autonomous-ai/spaceship/README.md

# spaceship

Design files for Spaceship, the next version of FocusPod, the sound-insulated office pod from Autonomous ([autonomous.ai/focus-pod](https://www.autonomous.ai/focus-pod)). Inside the team it's called "Indoor Pod". Spaceship is a working name.

| Path | What's there |
|---|---|
| `docs/engineering-guideline.md` | The hardware team's engineering guideline for all versions (Vietnamese) |
| `sources/v1/` | v1 as received: STEP assembly, materials BOM, drawings |
| `v2/` | v2 work, starting from `v2/00-Control/v2-build-plan.pdf` |

Agents: start with [AGENTS.md](AGENTS.md).
