autonomous-ai/spaceship/tools/drawgen/README.md

# drawgen: part drawings from STEP, outside Fusion (D-112, D-113)

`drawgen` makes the manufacturing drawing of a simple part straight from that part's STEP on main: aluminium tube
cut parts and frames of them, and flat plates. It never opens Fusion or its queue.
Fusion keeps the general arrangement, the assemblies (the Air Engineer's `assembly.py` takes those on), the door,
the glass, the decor, and any part drawgen refuses. Bent sheet comes from drawgen when its team's entry marks it
`bent` (the Lead's ruling, 2026-11-01: Fusion the fallback).

## Run it

```
tools/drawgen/run.sh generate --sample          # the sample the PM reviewed first (#202), into v2/02-Drawings/<team>/
tools/drawgen/run.sh generate 211101 111101     # registered parts (each team's tools/drawgen/teams/<team>.py)
tools/drawgen/run.sh check v2/02-Drawings/wall/211101_P01_WALL-PANEL-FRAME-SIDE-LOWER-LH_DWG.pdf
tools/drawgen/run.sh stale                      # generated drawings whose STEP, parts list or register changed
```

`run.sh` makes drawgen's own Python environment on first use, in a per-user cache (`DRAWGEN_VENV` moves it):
OCC 7.8 through `cadquery-ocp` and PyMuPDF, pinned in `requirements.txt`. Nothing is installed system-wide.
Tests: `<venv>/bin/python tools/drawgen/tests/test_drawgen.py` (prints `N of N passed`).

## What it reads

- The part's STEP: its own file (`v2/03-Manufacturing/<team>/PN_REV_NAME_STEP.step`), or the team assembly STEP
  that holds it. Fusion writes cm and says so (D-13); OCC reads it in mm and every drawing checks one box against
  the repo's own reader (`tools/checks/stepfile.py`). A part file in its own system (BASE's tubes) is drawn where
  it sits in the pod: the placement comes from the team assembly STEP, checked hole for hole, and the sheet says
  so.
- The team parts list row: name, Vietnamese name, material, finish, process, tolerance, mass, cut list.
- The feature rationale registers (`v2/02-Drawings/<team>/FEATURE-RATIONALE*.md`, both layouts in use): each
  hole's register ID, function and mating parts, in the hole tables.
- Each team's entries in `teams/<team>.py` (D-139: every part drawing comes from drawgen; each team keeps its
  own entries): the choices a STEP can't give (datums, extra notes, the tolerance note). See `teams/README.md`.

## What a drawing has (guideline 3.2, 3.3, 6; D-113)

- Exact projections with hidden-line removal (OCC `HLRBRep_Algo`, never the polygonal one): lines stay lines and
  circles stay circles, written as Bezier quarter arcs on their true centre and radius. Hidden lines that would
  print on top of a visible line are left out (ISO 128 practice); the rest are dashed.
- First-angle layout: the view from above below the principal view, from below above it, from the left on its
  right, from the right on its left; a view too long to sit beside goes under the others as a lettered view with
  a reference arrow.
- A view of every drilled face. A face nothing shows (inside a frame bay) gets a section in front of it, unless
  its holes are the far-wall twins of holes a view shows: then the removed section through the pair shows them.
- Holes square to a face that no principal view looks at straight: a lettered view square to that face (ISO
  128-30, "VIEW D"), with an arrow in a view that shows the face edge on, its own origin and its own hole table.
  It keeps the principal view's up where it can. A through hole that leaves its part at an angle is drawn from
  the face it is square to.
- Blind holes: their depth (of the full diameter) and, when the model has it, the drill point's angle.
- Countersinks (D-143): a cone on a hole's axis at its open end, widening out of the material, is called out with
  its hole, `Ø5.5, CSK Ø10.4 x 90°` (the outer diameter at the face and the included angle); the hole is drilled
  from that face. A hole countersunk from both sides is refused for now. In bent sheet mode a countersink is called
  out the same way (the DXF cuts the bore), and any other cone is refused, never taken for a corner relief's end.
  The read-back finds each countersink in the STEP itself (a cone with two circles on a hole's axis, the smaller the
  hole's: its outer diameter, and its angle from the circles' radii and spacing) and checks the printed callout,
  both ways.
- Holes through two walls of one member: a removed section through their axis, hatched per ISO 128-50 (filled
  solid under 1.6 mm on paper), each wall's hole sized across its gap.
- One hole table per face: tags H01... on the views, `X (mm)` and `Y (mm)` from that view's origin (O1, O2...,
  the one 3D origin seen in each view), +X right and +Y up, size, depth, the register's feature and fits. The view
  titles give each view's mapping to the pod axes.
- Datums: WALL frames sit on a spigot hole and slot (R-J13), so A is the seat face, B the round hole, C the slot,
  and every hole position is from B (R-J6). Other parts name their datum faces in their team's entry.
- Mitred ends: the angle from square and the true length along each face, in a view that shows the cut in profile
  (edge on, the member's axis across the view); when no planned view does, the plan adds the one that does
  (FRONT's #320: 8 tubes whose only view saw their mitres face on). A cut no plain view shows in profile (a
  compound cut) is refused. A member turned about its own axis is drawn square to its faces.
- An open-ended slot (BASE's D-129 end plates): sized from the edge it opens on, in the view of its face: the
  mouth at the edge, the taper's length, the width, the round end's radius and its centre from the edge. The end
  of a long part gets its own lettered view at its own scale, with its origin at the member's bottom left corner.
- A notch through one wall at a member's end (BASE's stud-head notches): its width, its place across from the
  nearer side face and its length from the end, in the view that looks at that wall (enlarged in a detail when
  small). Notches alike at the two ends are sized once, and the detail says the other end is the same.
- A chamfer with equal legs between a square end and a side face, or along a tube's outer corner the whole length
  (CEILING's seam member): "1 x 45°" on a leader, in the view that shows its true angle (looking along its edge, or
  a removed section across its member), else where it shows as a band it faces (CEILING's back member's end bevel,
  seen from below). A view is planned for a bevel no other view shows. A welded end plate (a square face just inside an end) needs no size: the material line gives it.
- Frames: member balloons, the cut list from the parts list, stile positions, the D-115 joint note.
- Bent and folded sheet (an entry marked `bent`; the Lead's ruling, 2026-11-01): the folded part's views from its
  STEP; a section across each run of bends with each flange's outside length (windowed to one end of a long run, the
  other end the same); the flat pattern drawn from the team's DXF (CUT outline thick, BEND centre lines thin chain
  tagged B1..., MARK bend-zone edges thin) with its overall size; and a bend table: each bend line's place in the
  flat, its direction (UP: toward the viewer of the flat as drawn), angle, inside radius and bend allowance. The folds
  come from the model's own section; the DXF's bend lines must sit where the model's flanges put them at one K-factor
  (solved from the DXF's flat size, and stated); every model hole must sit on a DXF circle of its size where it
  unfolds to, and every DXF circle on a model hole, on one run of bends or two (a tray: across each run from its own
  flange, along it from the base both share). Where no hole pins which way up the DXF is drawn, every reading the
  bend lines allow must fold the same part, so the DXF must be symmetric that way, or the part is refused (Reviewer 6
  on #335). Cut-outs that aren't round holes (rectangles, sharp or with round corners, and slots, through one
  flange) are in the hole tables (centre X and Y, length x width along X or Y, corner radius) with their centre lines,
  and each one's edge, unfolded, must be the same shape as one of the DXF's, point for point both ways and counted
  (WALL's 511202: its power unit's 304 x 268 and the 80 x 11 corner slot); any other shape is refused. The folds are
  read from a section through the middle, or the nearest one clear of holes and cut-outs, and the profile section is
  cut there. A model that folds sharp takes its inside radius from the entry. Anything else is refused with the reason
  (INTERIOR's 811201: a hole the DXF cuts in a bend zone). A V-grooved and
  folded panel (ACP; its entry says `vgroove` with the groove) has no K-factor: its outer skin runs round each fold
  unstretched, so the flat develops along the outer face, each leg to its fold's outside arc plus the arc, the fold
  line at the arc's middle (the model's outside radius, WALL's 2 mm by the maker's guide). A V-groove fold the model
  leaves sharp is refused (the outer skin always bends round a radius, D-161), and an entry that states the outside
  radius has every fold checked against it; its folds table gives each fold's outside radius and the groove.
- Scale: the largest ISO scale at which the views fit beside the hole tables; for a long part the table column
  gets narrower (its text wraps more) before the scale drops, as long as the tables still end above the title block.
  Where the removed sections or the flat pattern would then run off the sheet, the next smaller scale.
- Labels: every line is drawn first (views, cutting planes, dimensions), then hole callouts, view titles, tags,
  origin names and datum symbols each go where they touch no line and no other text.
- Title block: UNITS: mm, the first-angle symbol, part number, name (English and Vietnamese), revision of the
  part's STEP (or of its parts list when it lives in an assembly STEP), DRAFT, material, finish, mass, scale,
  sheet; the tolerance note is the project's (joints register, parts lists), never a blanket ISO 2768. CREATED BY
  and the PDF's author are "Autonomous", never a person (the owner's rule; the read-back checks both). The PDF's
  Creator is `drawgen`, the program; its catalog key `/DrawgenData` lists every source with its
  hash, the views and the tagged features.

## What it refuses (the part stays with Fusion)

A cylinder that is neither a hole, a slot, a keyhole nor an open-ended slot (a bend, a fillet, a round), a cone
that isn't a blind hole's drill point (a countersink), any other curved face, holes on an angled face that the part
itself hides, a part that fits no ISO scale on its sheet. On a straight member, any flat face that is not its
profile, an end, a mitre or compound end cut, a slot's own sides, a notch, an even chamfer or a welded end plate's
inner face (a step, a pocket, a window in a wall, an uneven chamfer): drawgen would draw it without a size, so it
names the faces and refuses the part. A straight member whose section isn't a solid convex outline or a
rectangular tube (an angle, a channel, a custom extrusion, a tube with a corner cut that isn't an even 45° bevel of
5 or less): drawgen would size only its outside, so it refuses it as a profile (D-139 keeps a profile's dimensioned section with Fusion until the
profile reading lands). An extrusion's open section is judged as a profile, not as a fold. Parts that need no drawing (D-125 plain strips, D-128 felt and fill pieces on their DXFs) are listed in
their team's file with the reason, and `generate` says so instead of drawing them. It also never overwrites a PDF it didn't
make: a Fusion drawing stays.

## Checks

`readback.py` reads a drawing back against its STEP (and a bent part's DXF), independently of how it was drawn: every hole the repo's own
STEP reader finds is in a table, each row's X and Y equal the hole's projected centre within 0.05 mm, each tagged
hole is drawn as a true circle at its place within 0.05 mm; every end cut of every member (a flat face at an
angle to the member's axis, 6 mm or more across the way it slopes) is found in the STEP by that reader, and its
angle from square must be printed by the cut in some drawn view; each open slot's round end, notch and chamfer is found
in the STEP by that reader and the sizes printed for it match what it measures there within 0.05 mm (a notch said
to be the same as the drawn one measures the same); the text has what the mechanical check reads, the
Creator is drawgen, and no text touches another text or a part outline and no line runs through a text (read from
the PDF's own text and paths); for a bent part, every bend row is on one of the DXF's BEND lines (read again, without
OCC), each run's bend lines sit where its outside flange lengths, angles, inside radius and the printed K-factor put
them within 0.05 mm, its flat is as long as the DXF's, every STEP hole unfolds (by the sheet's record of how each
flange unfolds, each flange checked against a face of the STEP) onto a DXF circle of its size within 0.05 mm and
every DXF circle onto a STEP hole; every cut-out of the STEP (found from its own faces through the sheet that close
into a void) unfolds onto one of the DXF's cut shapes point for point both ways, with its table row's centre and
size as the STEP has them; and the flat's size, the K-factor and every bend tag are printed. `generate` runs it on every drawing it writes. The mechanical check's drawing rule (C05) and
the release checklist count the drawings by their file names, like any other drawing.
