autonomous-ai/spaceship/tools/checks/README.md

# Mechanical checks

Checks that catch mechanical issues in the v2 design before manufacturing. They run on main after every merge; each finding goes into the register (`v2/04-Checks/findings.md`) with an owner group and a status, and is posted to that group with the file and the fix. **Severe findings block the owner's merge until they're fixed** (PM rule).

```sh
python3 tools/checks/run_checks.py                         # check this checkout, print findings
python3 tools/checks/run_checks.py --root <tree> --rev <sha> --update   # check a tree, update the register
python3 -m pytest tools/checks/tests -q                    # offline tests
python3 tools/checks/register.py set F-004 ACCEPTED --note "D-60: ..."  # change a status by hand
```

Standard library only, plus PyMuPDF (or `pdftotext`) to read drawing PDFs. Nothing here edits another group's files. Exit code 1 when a severe finding is open in the run.

## After every merge to main

```sh
python3 tools/checks/run_checks.py --ref origin/main --update                        # offline checks, register
python3 tools/checks/run_fusion_checks.py --ref origin/main --model skeleton --update  # exact, through the lock
python3 tools/checks/run_fusion_checks.py --ref origin/main --update                   # the assembled design, once it exists
```

Each run checks exactly that revision in a clean export (deleted afterwards), updates `v2/04-Checks/findings.md`, and closes what it no longer finds, with the revision as evidence. New findings go to their owner groups with the file and the fix. Open PRs get the same runs on their head before they merge (`--ref origin/<branch>`, without `--update`).

## The checks

| Code | Check | How | Runs |
|---|---|---|---|
| C01 | Clash and minimum gaps | Offline: the pod's outer shell must be closed, checked exactly 1 mm inside the back, sides and roof: each body's box grows by just over half the decided 2.26 mm seam, so seams close and any wider opening is a finding. Each face is checked once all its parts are on main (a side face needs its two panels, its decor block and its side band; names match with spaces or the file names' hyphens); a strip no wider than the seam along a face's own edge is the seam to the next face's part, which that face reports if it's missing. Exact interference with an allow-list of intended contacts goes through Fusion (below). | offline and Fusion |
| C02 | Tolerance stack-ups | Gap rules between named bodies (`v2/04-Checks/config/gap-rules.csv`, the same file the Fusion check reads), and worst-case stacks per joint (`v2/04-Checks/stacks/`). RSS is shown for information only (guideline §6.3). A stack with a missing tolerance stays OPEN and is listed, not failed. | offline |
| C03 | Fastener and tool access | Every bolt reachable with the one hand tool from the side the assembly order uses: a tool envelope along each bolt axis must miss every part already in place at that step. | Fusion |
| C04 | Weight, doorway, pallet | Every shipping piece 20 kg or less except glass (D-03); the pod against the cap in `config/policy.csv` (460 kg, D-131, provisional until the wall sample's recount); passes a 914 × 2032 doorway (PLAN Target 2; the 810 mm door of REQ-ASM-06, PROPOSED, is a note); fits its pallet, 48 × 40 in or the standard long 48 × 96 in, at most 1679 mm tall above a 150 mm deck (REQ-SHP-01, REQ-SHP-03). Masses and the pod total from the layout study's newest decided list (`parts-decided-P04.csv`), plus only the owners' weight changes that list doesn't hold yet (`config/mass-adjustments.csv`, column `applies_to`); sizes for the doorway and pallets from the B1 list until a sized P04 list exists. | offline |
| C05 | Drawing completeness | Every part we make has a drawing, every assembly an assembly drawing, same revision as its CAD and STEP; units, material, finish and tolerances stated; holes tagged, in a hole table or called out, counted against the STEP's hole axes. D-89: a number listed in a tabulated drawing counts as drawn (the drawing says TABULATED and lists the numbers of its own family and kind; a note or an assembly drawing's parts list doesn't count); a plain knife-cut felt or fill rectangle needs no drawing when its row in a cut list or a parts list (any .csv under `v2/03-Manufacturing` or `v2/02-Drawings`; PM ruling 2026-11-01, read the same way as the release checklist) gives its part number, size, material and tolerance; other soft goods (foam, gaskets, seals, tape) need a DXF of their outline, or for a plain strip or rectangle the same row with the thickness too (D-89 part 3); a piece with pockets, notches or holes (in its STEP: hole axes, or more than a block's 6 faces; or named in its row) keeps its drawing. A reserved space (`config/reserved-spaces.csv`: a body that only holds space for a part another team designs later, like the air spaces 351402 to 351405 in FRONT's DR block, which AIR designs under its own numbers) gets no drawing finding, no seam rules and no parts-list row checks (no mass, not counted); it's listed open under its designer until it's designed. D-97: a missing drawing is severe whatever the screen state (a model that passes everything else still merges, D-91). D-125 (extends D-89): a plain straight-cut strip or sheet with no features needs no drawing when a parts-list row gives its material and grade (a grade on HOLD counts as stated; the part stays HOLD until it is named), thickness, width and length as in its STEP, finish, and a tolerance covering both cut sizes (one general tolerance such as ISO 2768-m or '±0.5 on cut sizes', or one for the length and one for the width; 'width as supplied' for a bought strip; the thickness takes the sheet's own tolerance), and names no hole, slot, notch, pocket or cut-out; its STEP must show one shape, a rectangular block (six flat faces in three square pairs, no holes, no bends) at most 25 mm and half its width thick. D-128 (extends D-89 part 3): a felt or fill piece cut from sheet or roll, with through-openings or edge notches only, needs no drawing when its DXF gives the full outline with every opening (the same number of closed shapes as the STEP's sheet face, the outline the STEP's size, only CUT and MARK layers, placed blocks only) and a parts-list row gives material, density or grade, thickness (the STEP's), tolerance and part number; a pocket or other depth feature keeps the drawing. D-113: a part tools/drawgen draws (its specs.py registry) keeps a missing drawing severe even under D-84's locked-screen mode. A part's holes come from its own STEP when it has one, so an older copy in an assembly can't add holes. The PM's drawing traps, read back from each drawing PDF (ELECTRICAL's `pdf_traps.py`): text under 2.5 mm capital height (title-block labels under 1.8) and a first-angle symbol without 4 corners are major; hidden lines (counted by view) and a dimension value printed twice are minor; a drawing that keeps hidden lines on purpose is listed in `config/hidden-lines-allow.csv` with its views and reason. D-93: ELECTRICAL's wiring diagram draws 710000. D-112: a part drawing made from STEP by `tools/drawgen` counts by the same name, revision and content rules; its PDF names drawgen in the Creator field, and a finding on it goes to the Drawing Generator, who fixes the generator and regenerates it. D-113, on generated drawings: where the part's STEP has holes through two walls of one body, the drawing labels a section (SECTION A-A, or A-A) or the opposite view (VIEW B, VIEW FROM); a part with bends stays in Fusion. A part's holes are counted over all its bodies (a frame's members), each shape once, so copies of one part under one number count once. D-89 part 4 (flat metal sheet and flat ACP only, D-99 and D-100: glass keeps its drawing): a flat part cut from sheet needs no drawing on its own DXF and a row whose process names laser, waterjet or router and no bend, fold, groove, lap, machining, drilling, tapping, welding or bonding, with material, thickness, finish and ISO 2768 (read exactly as the release checklist reads it, with its test cases); the DXF may hold lines only on the CUT and MARK layers (any other layer, such as BEND, a pocket, an engraving or a half-lap, keeps the drawing; block records on layer 0 are not lines); the check adds what only the files show: the STEP shows no bends, pockets, blind holes or countersinks, and the DXF holds every hole of the STEP. | offline |
| C06 | BOM completeness | Every parts-list row complete (number, English and Vietnamese name, material, quantity, mass, status, source); hardware names as the joints register gives them, in the CAD and the lists (D-99); what a decision cancelled is gone and what one added is there (`config/cancelled-items.csv`: D-131's cleats, D-132's floor parts and threshold; `config/required-items.csv`: D-132's base seal lip in BASE's folder), read from the teams' lists and the CAD's part names; the base keys 111211 to 111214 are the Joints Engineer's (D-95); numbers valid, unique and not reserved (D-28); bought items with maker and SKU or HOLD; every CAD product in a parts list and every made part in the CAD. D-120 (build plan rule 2, BP-04): every part is its own component with its own number, never a loose body; a component holding several bodies is a finding (major): copies of one part become one component placed several times, different pieces (a frame's members under D-115, a fill's bay pieces) each their own component, the part an assembly of them. Left out, as ruled: ELECTRICAL's route components (D-92), HOLD spaces, reserved spaces and ENVELOPE bodies (D-104). A part copied into another team's STEP must be the part its own STEP holds (the file named after its number): the same hole layout, whichever way the copy is turned (hole centres about their centroid, every quarter turn tried, hole sizes within 0.15 mm), and the same sizes (a round part's length at each outer radius both models have; a box part's three sides); a different layout is severe, different sizes major. | offline |
| C07 | Fastener schedule | Every screw, bolt, nut, washer and rivnut with size, length, grade, finish, torque, quantity, maker, SKU and CAD locations, written to `v2/04-Checks/fastener-schedule.csv`. Thread engagement and bottoming are measured along each bolt in Fusion. | offline + Fusion |
| C08 | Hole-to-hole alignment | Coaxial holes in different parts must share one nominal axis; the clearance budget for bolt plus tolerances is stack ST-03. Bolt patterns across STEP files: a joint hole (rivnut thread, M6 clearance or rivnut hole) whose partner file has joint holes on the same joint plane nearby, but none on its axis, is a pattern that doesn't match. A clearance hole and a rivnut in two parts of one file, on one axis (FRONT's DR access panel into DR's own back-ring rivnuts), are matched there and aren't paired with the next file's bolt line. | offline |
| C09 | Edge distance and sheet metal | Hole centre to free edge at least 2 hole diameters (under 1.5 is severe). D-135: every bay of a wall panel frame under the ACP skin (the frame's outline less its members, in its own plane) is 275 mm clear or less across its short span (WALL's span table: 274.8 mm gives 1.99 mm under a 100 N push; the limit is 2 mm). A free edge is where the part ends: read from the faces across each edge of the face the hole goes through, so it holds whichever way the part is turned in the pod. A tube's corner, a channel's wall, a bend or a chamfer on the way to the next wall is not a free edge; a sheet's edge, a tube's end and a flat bar's long edges are. Hole spacing at least 2 diameters; bend inner radius and hole-to-bend distance from `v2/04-Checks/config/sheet-rules.csv` (assumptions until the factory's coupons). An edge distance the PM accepted for one hole of one part is in `v2/04-Checks/config/edge-exceptions.csv` with its ruling, and holds only as ruled: at most the listed number of parallel edges under 2 diameters, each at least the listed distance (the BASE glide doubler: ends at 2 diameters, the two long sides 18 mm). | offline |
| C10 | Mixed metals | No bare steel against aluminium (contacts from the assembled CAD); fasteners must state a material and finish. | offline + Fusion contacts |
| C11 | Material grade and finish | Every part and bought item states a material grade and a finish. | offline |

## Inputs it looks for

- STEP files under `v2/03-Manufacturing/` (not `proof/`). `skeleton/` is checked as its own model. Other STEP files whose top product is an assembly (xx0000 to xx0999) and whose bodies all sit inside the pod box are combined into the assembled model in pod coordinates; every STEP also gets the per-part checks.
- Parts lists: CSV files under `v2/03-Manufacturing/`, `v2/04-BOM/`, `v2/02-Drawings/` or `v2/01-CAD-Native/` with a part-number column and a quantity column. Recognised headers: `part_number`, `name`, `name_vi`, `material`, `grade`, `finish`, `qty`, `mass_kg`, `status`, `source`, `rev`, `maker`, `sku`, `size`, `length_mm`, `torque_nm` (common variants work too). Fasteners need `size`, `length_mm`, `grade`, `finish`, `torque_nm`, `maker` and `sku`.
- Drawings: `PARTNO_REV_NAME_DWG.pdf` under `v2/02-Drawings/` (conventions §7).
- The part lists: `v2/05-Engineering/layout-study/out/parts-decided-P04.csv` (masses, the pod total) and `parts-option-B1-final-stack.csv` (sizes and pallets).

## The STEP reader

`stepfile.py` reads Fusion's AP214 STEP without a CAD kernel: the declared unit (Fusion writes cm, D-13), products and their use counts, every solid placed in the top assembly's coordinates, and per solid its planes, holes (cylinders with the material outside that add up to a full turn), bends (a concave and a convex coaxial cylinder one thickness apart) and box. Limits: boxes come from vertices; only planes and cylinders are classified; a faceted body's box hides gaps inside it. The Fusion check is exact where these limits matter.

## Fusion part (C01 exact, C02 true distances, C03, C07 engagement, C10 contacts)

```sh
python3 tools/checks/run_fusion_checks.py --model skeleton --rev <sha> --update   # skeleton STEP
python3 tools/checks/run_fusion_checks.py --rev <sha> --update                    # assembly STEPs in pod coordinates
python3 tools/checks/run_fusion_checks.py --from-json result.json --update         # convert a saved run, no Fusion
```

Fusion runs only through `tools/fusion/run_script.py`, which takes the machine-wide lock and waits its turn (PM rule: never call the Fusion MCP tools directly). `fusion/whole_pod_check.py` makes its own new document, imports the STEP files, and:

- intersects every pair of bodies whose boxes overlap; an overlap over 0.1 mm3 that isn't in `v2/04-Checks/config/clash-allow.csv` is a severe clash (D-104: a hardware stand-in, a bought number whose name carries ENVELOPE, may overlap the part it clamps in its own assembly file until the maker's model goes in) (guideline §10: a 1 mm3 threshold can hide small clashes, so the gap rules add minimum clearances);
- measures the gap rules as true minimum distances;
- walks each bolt or screw from its head to 30 mm past its tip: what surrounds the shank (clamped parts, the nut, rivnut or insert), what sits on the axis with no hole (a collision; past the tip, the tip clearance), engagement in the thread, at least one thread past a through nut, tip clearance at least 1 mm;
- sweeps the tool envelope (`v2/04-Checks/config/tools.csv`: the decided 5 mm hex key, ruling R-J2, the short arm on the bolt axis through the access hole, then the long arm and the hand turned 90 degrees toward the room through the fill pocket's open face) out from each bolt head; any body in place when the bolt is tightened (all but the lining cassettes, which go on last) that it hits blocks the tool;
- lists bodies that touch, for the mixed-metal check;

then writes JSON and closes its document without saving. Its findings carry the scope `<model>/fusion`, so an offline run never closes them and the reverse.

Live run, 2026-10-31, skeleton P03 on main c9ae2a4 (Fusion 2706.1.17, through the lock): 32 bodies; one clash, BAND-R x DR 14393.5 mm3, the same as the skeleton's own record (14394); seam and kick-strip gaps 0.0 mm and the linings 4.0 mm off the frames, as the offline check measures. No bolts are modelled yet, so C03 and C07 had nothing to walk.

## Findings

`register.py` keeps `v2/04-Checks/findings.json` and renders `findings.md`. A finding keeps its F-number for life. A run on main adds new findings, reopens ones that come back, and closes an automatic finding when the check that made it ran on that revision (and model) and no longer finds it, with the revision as evidence. Findings written by hand close by hand.
