autonomous-ai/spaceship/v2/00-Control/requirements.md

# Requirements: Spaceship (FocusPod v2)

| Doc code | Revision | Status | Date | Owner |
|---|---|---|---|---|
| V2-CTL-001 | P01 | DRAFT | 2026-10-31 | Control pack |

Everything the v2 prototype design must meet, each item with a number where one exists, a status and a source. Status values are defined in `conventions.md` §9. **DECIDED** means the PM has ruled; the ruling is in `decision-log.md` (D-nn). **PROPOSED** means our working answer until the PM rules on it. Open points link to `issue-register.csv` (ISS-nnn).

**Sources**

| Key | Document |
|---|---|
| PLAN | `v2/PLAN.md`, approved by the product owner on 2026-10-31 |
| BP | `v2/00-Control/v2-build-plan.pdf`, the v2 build plan from the indoor pod lead engineer (page or section given) |
| GL | `docs/engineering-guideline.md` (hardware engineering lead) |
| MS | `v2/research/market-study.md` |
| V1 | `sources/v1/` (STEP, BOM, drawings) |
| PO-1031 | Product owner's updates passed on by the Lead in the Swarm chat on 2026-10-31: the working name Spaceship; hooks for a later voice cockpit kit; reuse of Autonomous's in-house modules (the Desk Pro AI sensor hub, and Lamp electronics); a 12 V DC bus; cockpit hooks of 12 V 5 A; the default decor colour |
| DL | `v2/00-Control/decision-log.md`: the PM's decisions D-01…D-171 of 2026-10-31 and 2026-11-01. The current headline is D-27 with D-37, D-49 to D-53, D-59 to D-88 and D-131 to D-137: a 4+4 laminated front with no floor and no step at the door (D-132), walls and ceiling on one 84 mm stack on welded galvanized steel frames (D-131), US 120 V mains on UL-listed parts (D-133), 409.0 kg as shipped on the merged count (still aluminium frames and the floor; D-131 adds about 40 to 65 kg and D-132 takes off about 21, assumption), under a cap of 460 kg as shipped, provisional until the sample panel's recount (D-131) (live count with AIR's parts from CAD (PR #91) and D-130's intake boot and gaskets (PR #254), after FRONT's decor blocks (PR #105), WALL's B1 and B2 back panels and their cassettes (PR #205), D-121's and D-124's fan boxes (PR #199) and D-117's frame cleats (PR #195); D-116's thinner casings are withdrawn (D-121)), about 19.3 dB calculated (about 24 dB at best), and fresh air driven by CO2 and heat through an air column and soffit inside the pod: about 33 l/s for one person, 53 l/s for two and a 65 l/s boost, which also holds 4 K with the voice kit on its 40 W average (D-88), on one 24 V Class 2 feed (D-168). |
| HW | `v2/05-Engineering/acoustics-air/report.md`, merged in PR #11 (https://github.com/autonomous-ai/spaceship/pull/11, 39c5c3e): the wall and ceiling stack, the air design, the weight and the calculated sound |
| SEL | `v2/05-Engineering/hardware/selection.md`, merged in PR #11 (39c5c3e): the bought parts, their data, the HOLDs and the sample tests |
| SKL | `v2/01-CAD-Native/skeleton/BUILD-RECORD.md`: skeleton P04, merged in PR #24 (0cb764f; P03 in PRs #15 to #17), with the geometry measured from v1 and the PM's skeleton rulings |
| LAY | `v2/05-Engineering/layout-study/report.md`, merged in PR #10 (c6abf92): part weights, pallets and assembly |
| HW-26 | The air path recheck for D-60 in `acoustics-air/report.md` sections 7b to 7i and `calc.py`, merged in PRs #26 and #30 (fe5a787, d73ae2b), on skeleton P04: the sizes, noise and weight behind D-61 and D-62 |
| JNT | `v2/05-Engineering/joints/joints-register.md`, PR #23 (open): joints, fasteners, seam stacks and the hole rule (D-63 to D-65) |
| FRT | The FRONT door unit and fixed glass models, PRs #27 and #28 (open): masses, the edge gap and the channels (D-68) |
| GTM | The go-to-market research of 2026-10-31, kept out of this public repo; only its US-rules flags are used here (ISS-082 to ISS-084) |
| CALC | Calculations in section H of this file |

## A. Scope and the hard rule

| ID | Requirement | Target | Status | Source | How we prove it |
|---|---|---|---|---|---|
| REQ-SCP-01 | Indoor only: an air-conditioned room with a flat, level floor. No weather, UV, snow, wind or uneven ground. Size the structure for indoor loads: people leaning on it, shipping, and assembling it more than once. | indoor use only | confirmed | PLAN "Same look, lighter bones" | Load cases in the joint register |
| REQ-SCP-02 | v2 is designed for US use: US 120 V mains and US parts (D-133, D-134). Certification work (the UL 962 listing, fire test reports, the sprinkler and smoke strategy, emission certificates, glazing marks) comes later and is not prototype scope (D-134). Its old line, that the plan's Vietnamese 220 V parts were fine for the prototype, stays withdrawn (D-133, D-134). | US 120 V mains parts; no certification work on the prototype | DECIDED (D-14, D-133, D-134) | PLAN "Later, not in the v2 prototype"; DL D-14, D-133, D-134 | — |
| REQ-SCP-03 | The floor stays empty: no table and no loose furniture (D-06, ISS-006). The work wall carries a fixed 1000 mm ledge in 1.5 mm folded aluminium and a screen mount (D-70, D-85). | 0 loose furniture items | DECIDED (D-06, D-70, D-85) | PLAN "Removed"; DL D-06, D-70, D-85 | BOM |
| REQ-SCP-04 | The one-cable dock, room mic and agent status light are not built in. Hooks for a later voice cockpit kit are reserved (section F). | — | confirmed; DECIDED (hooks, D-11) | PLAN "Left out of v2"; PO-1031; DL D-11 | — |
| REQ-LOOK-01 | **The look stays exactly the same**: the faceted front, overall size, proportions, colours and glass layout. Every saving is invisible from outside. The decor blocks keep v1's depth, 205 mm as measured from v1's drawings and STEP (D-49). | same as v1 and the BP pictures | DECIDED (D-01, D-49); source (205 mm, SKL) | PLAN Goal; BP p1; AGENTS.md; DL D-01, D-49; SKL | v2 GA elevations laid over the v1 STEP outlines (X and Y match, `conventions.md` §4); renders compared with v1 and the result logged by the PM |
| REQ-LOOK-02 | Overall size W × D × H. H is measured from the room floor to the top of the roof skin (D-21). | 2500 × 1700 × 2400 mm | DECIDED (size D-01, datum D-21) | BP p1; PLAN Goal; DL D-01, D-21 | GA-001 |
| REQ-LOOK-03 | Colours: walls, roof **and decor blocks** in ACP Dark Yellow EV3038 (plan VT01, D-12); felt Dark Gray (plan VT03-PET, D-79); smoked gray glass as in v1, with the laminate's tint matched on the sample (D-27); the base band and the door's kick strip in the same dark finish (D-40): black anodised, matte, 20 µm (AA20, EN ISO 7599) (D-67), with the intake under the right block a flush black mesh in the band's outline (D-62). The soffit's underside, which shows through the top 68 to 114 mm of the glass for a standing viewer 1 to 2 m away, is in the top band's dark tone (D-61). The v1 CAD renders and the plan's pictures draw the decor black (ISS-031). | as stated | source (walls, felt); DECIDED (decor D-12, glass D-27, base band D-40, D-62, D-67; soffit D-61; felt D-79) | BP material list and section VI; V1 BOM DL/DR/DT, GL-01; DL D-12, D-27, D-40, D-61, D-62, D-67, D-79 | Colour codes on the drawings, physical samples |
| REQ-LOOK-04 | Front layout as in v1: one hinged door plus one fixed panel in the same plane. The door is a trapezoid, 1175.6 wide at the bottom and 892.9 at the top, 2011.1 tall, with a slanted leading edge. The fixed panel has 5 sides (box 1014.3 × 2017.1). Material: **4+4 laminate of toughened, heat-soaked panes (8.76 mm), frameless as in v1** (D-27, D-46). Acrylic is only an optional experiment on the factory sample (ISS-043). The fixed panel's free edge runs parallel to the door's edge at a 4 mm gap, in the skeleton too (D-74), with a 180° magnetic seal pair on the two edges and no closing load on the glass (D-83), and the fixed panel sits 11.5 mm deep in hidden, sealed U-channels in DR, DT and the base band (D-68), kept over U brackets, which leave gaps that need a sealant bead (D-138). | v1 outline | source (outline); DECIDED (material, D-27, D-46, D-82; edge gap, seal and channels, D-68, D-74, D-83, D-138) | V1 STEP "Door", "Wall Glass"; DL D-27, D-46, D-68, D-74, D-82, D-83, D-138; FRT | FRONT drawing checked against the v1 STEP; factory sample |
| REQ-LOOK-05 | Seams follow the build plan's intent: 2 sheets per side wall and 4 on the back, with crisp, aligned reveals. The faceted front and the overall form are what can't change (ISS-044). | 2 per side wall, 4 at the back | DECIDED (D-23) | DL D-23; BP II–IV | GA elevations |

## B. Priority 1: light

| ID | Requirement | Target | Status | Source | How we prove it |
|---|---|---|---|---|---|
| REQ-LGT-01 | Mass of the installed pod: everything that ships, without the packaging. The build is a 4+4 laminated front, both panes (D-27, D-82); walls and ceiling on the 84 mm stack (D-66) with welded galvanized steel frames of the same outside sections (D-131; the merged count still has 6063-T6 aluminium, D-79), 40 × 40 corner tubes (D-63) and the 24 kg/m³ fill by default (D-81); the 0.5 mm lining tray with 12 mm lips (D-37, D-69) on clips only, no rails (D-81); the air column and soffit inside the pod (D-60, D-61); and no floor (D-132; the merged count still has the 9 mm floor on its 3 mm foam, D-72, D-76). The layout study's live count is 422.8 kg as shipped: 2.8 kg over the cap and 12.8 kg over the target, with the adopted savings (clip-only fixing, the 24 kg/m³ fill and the 1.5 mm base band, the last two waiting on T02 and BASE's check) and allowances for the light shelf and the ledge (calculation, LAY, PR #42). The voice kit's 4.0 kg reserve sits outside the cap, because the kit ships later (426.8 kg with it; D-81, D-11). D-85 adopts five more savings: budgets for the light shelf and ledge, 1.0 mm inner studs in the wall panels, 2 studs in the back panels, a hollow kick strip, and poplar-core floor ply if BASE's tests pass. They bring it to 412.2 kg as shipped, 7.8 kg under the cap and 2.2 kg over the target, with the ceiling's cross members kept at 1.2 mm (calculation, LAY, PR #50). Re-run on the updated skeleton P04 with D-86's glide load blocks (+0.4 kg) and D-87's joined air pieces, it was 412.5 kg (calculation, LAY, PR #61); ELECTRICAL's P01 parts at 4.94 kg against their 3.05 kg allowance brought it to 415.4 kg (calculation, LAY, PR #66), and with the LED strip counted once it was 415.2 kg (calculation, LAY, PR #68); with BASE's sample and FRONT's fixed glass read from their merged parts lists (PRs #124, #126), it was 412.9 kg (PRs #124, #126); with the joints' made hardware and BASE's follow-ups read from their merged lists (PR #141), it was 413.4 kg; with WALL's four side panels and their cassettes read from their merged lists (PR #154), it was 412.7 kg; with CEILING's panels and cassettes (PR #158), 412.3 kg; with ELECTRICAL's and INTERIOR's parts read from their merged lists (PRs #161, #164), it was 412.6 kg; with a 2.4 kg allowance for D-115's frame cleats (PR #180), it was 415.0 kg; with D-116's fixings recount and 32 kg/m³ cartridge layers (PR #185), it was 411.4 kg; with the fan boxes' linings at 32 kg/m³ too (CEILING confirmed the grade, PR #188), it was 411.0 kg; with D-117's frame cleats at 1.2 kg with their glue in place of D-115's 2.4 kg allowance (PR #195), it was 409.8 kg; with D-121's and D-124's fan boxes, 3 mm casings with the linings only where they fit (PR #199), it was 408.9 kg; with WALL's B1 and B2 back panels and their cassettes from CAD (PR #205), it was 407.6 kg; with FRONT's decor blocks from CAD (DL 12.30, DT 7.84 and DR 18.32 kg, 3.4 kg over the study's estimates, less about 1.0 kg counted twice before, PR #105), it was 410.0 kg; with AIR's parts from CAD (PR #91) 408.5 kg; with D-130's intake boot and gaskets (+0.5 kg, PR #254), the live count is 409.0 kg as shipped: 11.0 kg under the cap and 1.0 kg under the target (calculation, LAY). D-116's 1.8 mm cartridge casings are withdrawn (D-121). The 3+3 fixed pane is ruled out (D-82). D-131's welded steel frames add about 40 to 65 kg and D-132's no floor takes off about 21 kg (assumption: the PM's estimates); the live count stays as merged until the sample panel's recount. The cap is 460 kg as shipped, provisional until that recount (D-131; it was 420, D-37); D-81's 410 kg target was set for the aluminium build. The wall sample settles it: a real cassette weighed with its clips and bond lines, and T02 confirming the lighter fill (D-54, ISS-080). PLAN.md's 300 kg is the light build without the sound package (ISS-063). | ≤ 460 kg as shipped (cap, provisional until the sample panel's recount, D-131; was 420); 409.0 kg as shipped (live count as merged, PR #254) | DECIDED (cap, D-131, provisional; reserve outside the cap and savings, D-81, D-85; 4+4 fixed pane, D-82); assumption (the PM's estimates: D-131's +40 to +65 kg, D-132's -21 kg); calculation (409.0 kg, LAY live count with the merged team lists, AIR's parts from CAD and D-130's boot and gaskets, PRs #91 and #254) | DL D-27, D-37, D-54, D-63, D-66, D-69, D-72, D-76, D-79, D-81, D-82, D-85, D-115, D-116, D-131, D-132; LAY (live count, PRs #42, #61, #66 and #68; savings, PR #50); DL D-86, D-87; PLAN Target 1 | The wall sample's weights and T02, the layout study's live count, the master BOM (`v2/04-BOM/`), then the prototype on a scale |
| REQ-LGT-02 | Every part weighs 20 kg or less, except the glass, that is, the two front panels (D-27). A "part" is each piece handled on its own during delivery and assembly (definition PROPOSED, ISS-047). | ≤ 20 kg each | DECIDED (number, D-03); PROPOSED (definition) | PLAN Target 1; DL D-03 | Weight per part in the master BOM |
| REQ-LGT-03 | Each front glass panel has a 2-person handling method in the assembly guide. In 4+4 laminated glass the door is about 43.3 kg and the fixed panel about 28.0 kg (C5, ISS-023); the FRONT models, with the door glass running 25 mm into the kick strip and the fixed panel 11.5 mm into its channels, give 43.9 and 28.6 kg (FRT). The door ships as one unit of about 50.2 kg, with its kick strip, drop seal, hinges and pull fitted in the factory (D-68), and two people carry it with 2 suction lifters (LAY). | method defined | assumption (method); calculation (mass, C5, LAY, FRT) | PLAN Target 1; V1 STEP; DL D-27, D-56, D-68; LAY; FRT | Assembly guide, timed trial |
| REQ-LGT-04 | Mass per m² of floor: 409.0 kg as shipped over 4.25 m² (live count, PR #254). v1 is about 113 kg/m² at 480 kg; rated pods this size run 99–136. | about 96 kg/m² | calculation (C6) | DL D-37, D-81, D-85; LAY; PLAN Target 1; MS | — |
| REQ-LGT-05 | v1 baseline, for comparison only: PLAN.md now gives about 480 kg from v1's BOM; the product page says 431 kg; the first market study said about 550 kg (ISS-030). | to confirm | source (conflict) | PLAN Target 1; MS | Reconciled v1 weight model, or a v1 on a scale |

## C. Priority 2: easy to assemble

| ID | Requirement | Target | Status | Source | How we prove it |
|---|---|---|---|---|---|
| REQ-ASM-01 | Two people assemble the pod in about 126 minutes, the honest target with film peeling inside the clock (D-87), and never more than 4 hours; about 1 hour stays the aim and 1 person-hour the stretch (PLAN scorecard). The guide's first count was about 168 minutes (PR #52); with D-87 it counts about 127 (PR #59). The clock starts with the pallets unwrapped on site and stops with the pod closed, powered and the fans running (start and stop PROPOSED). | about 126 min for 2 (≈ 4.2 person-hours), ≤ 4 h; aim 1 h; stretch 1 person-hour | confirmed (4 h limit, 1 h aim); DECIDED (126 min target, D-87); calculation (168 min, PR #52; 127 min with D-87, PR #59); PROPOSED (start and stop) | PLAN Target 2; DL D-87; the assembly guide (`v2/02-Drawings/30-Assembly-Instructions/`) | Step list with fastener count, then a timed trial on the prototype |
| REQ-ASM-02 | One bolt on site: M6 × 16 socket head to ISO 4762, captive, with an ISO 7093 washer under the head wherever it clamps on aluminium (D-63). | M6 × 16 only | confirmed (one M6 size); DECIDED (ISO 4762 M6 × 16, D-63) | PLAN Target 2; BP rule 6; DL D-63; JNT | Fastener list from the assembly sequence |
| REQ-ASM-03 | Captive M6 socket-head bolts join every seam and corner (they stay in their part and can't get lost), replacing D-08's tool-free seam clips (D-63), and one 5 mm hex key fits every one of them. Handling aids (suction lifters, spirit level, knife) don't count as tools (ISS-047, ISS-064). | 1 tool, a 5 mm hex key | DECIDED (captive bolts, D-08, D-63; one key, D-63); PROPOSED (definition) | PLAN Target 2; DL D-08, D-63; JNT | Tool list in the assembly guide |
| REQ-ASM-04 | Joints find their own place: every site joint has a locating feature (hook, pin, rebate or slot) that holds the part before the bolt goes in. No measuring on site. Panels locate on Ø8 × 8 spigots in a Ø8.5 hole or an 8.5 × 14 slot, and the Ø7.0 bolt holes sit within Ø0.4 of the spigot hole (D-64); the ceiling closes by assembly order (D-64, D-65). Every bolt pattern between teams comes from one skeleton rule; wall to band: end bolts 220 mm in, 4 evenly spaced, spigots 100 mm in from each end (D-75). | 100 % of site joints | confirmed; DECIDED (spigots, hole rule, closing order and bolt patterns, D-64, D-65, D-75) | PLAN Target 2; DL D-64, D-65, D-75; JNT | Joint register, timed trial |
| REQ-ASM-05 | No glue, no welding, no wet work and nothing to stick on site: the frames' welds are made in the factory (D-131), and the felt arrives pre-fitted (REQ-ASM-11). There is no floor foam any more (D-132; it arrived bonded under the floor panels, D-87). | none on site | confirmed (PLAN); DECIDED (pre-fitted felt, D-08; factory welds, D-131; no floor, D-132) | PLAN Target 2; DL D-08, D-87, D-131, D-132 | Assembly guide |
| REQ-ASM-06 | Every part fits through a doorway and into a normal lift. PLAN.md Target 2 says a 914 × 2032 mm (36 × 80 in) doorway; its scorecard says an 81 cm door. The check rule uses the narrower door (PROPOSED, ISS-048): sort the part's sizes a ≤ b ≤ c; it passes if a ≤ 810 and b ≤ 2032. | 810 × 2032 mm check | confirmed (PLAN); calculation (C1); PROPOSED (rule) | PLAN Target 2 and scorecard | Check against the part list |
| REQ-ASM-07 | No heavy lifting overhead: every roof part is light enough for two people to place from inside the pod. | ≤ 20 kg per roof part | source | MS "What we learned"; PLAN Target 1 | Assembly sequence |
| REQ-ASM-08 | Every part is labelled with its part number and position code. | 100 % of parts | source | MS "What we learned"; GL §4.2 | Labels in the packing plan |
| REQ-ASM-09 | Assembling it more than once doesn't wear out the joints: no lost fit after repeated take-down and rebuild. | ≥ 5 cycles | assumption (count) | PLAN "Same look, lighter bones" | Joint sample test |
| REQ-ASM-10 | Factory-made subassemblies: each wall and ceiling panel arrives as a complete outer panel (skin, frame, fill, gaskets, captive bolts or connectors, cable pass-throughs) plus its lining cassette (steel tray with the felt on it) as a separate part. Cassettes hang on captive mechanical clips with a rated load; ceiling cassettes also get a safety catch; hook-and-loop is only for lining up (D-47). Every cassette tray has 12 mm lips that hold the felt (D-69), and the cassettes hang on the clips alone, with no rails (D-81). The exhaust fan box arrives fitted in the soffit, the intake riser joined to the supply fan box, and the harness factory-tested (D-87). On site the parts are only joined. | 100 % of panels | DECIDED (D-08, D-47, D-69, D-81, D-87); source (cassette as a separate part, HW) | DL D-08, D-47, D-69, D-81, D-87; HW | Packing list, timed trial |
| REQ-ASM-11 | Pre-fitted felt: the PET felt (plan VT03-PET) is fitted on the lining cassette's face at the factory, not stuck on after assembly as the build plan says (BP-07). Felt and cassette edges at panel joints are detailed so the joint still seals (ISS-064). | 0 felt work on site | DECIDED (D-08) | DL D-08, D-17; BP rule 5 | Panel drawings |
| REQ-MOV-01 | Moving it inside the office: castors, or a quick unbolt of the light panels. | under study | source | PLAN scorecard "Moving it inside the office" | Layout study |

## D. Priority 3: easy to ship

| ID | Requirement | Target | Status | Source | How we prove it |
|---|---|---|---|---|---|
| REQ-SHP-01 | Ships on standard 48 × 40 in LTL pallets, loaded height (pallet included) about 6 ft or less. | 1219 × 1016 mm, ≤ 1829 mm | DECIDED (D-04); calculation (conversion, C1) | PLAN Target 3; DL D-04 | Pallet layout from the CAD |
| REQ-SHP-02 | Long parts (door, fixed panel, side decor blocks) go on **one** standard long pallet, such as 48 × 96 in. The decor blocks are not split. Never a custom size. | 1 long pallet, 1219 × 2438 mm | DECIDED (D-04); calculation (C1) | PLAN Target 3; DL D-04 | Pallet layout |
| REQ-SHP-03 | A panel standing upright on a 48 × 40 pallet can be about 1200 wide and 1700 tall: 1829 minus a pallet deck of about 150 mm leaves about 1680. | ≈ 1200 × 1680 mm | source (PLAN); assumption (deck 150 mm) | PLAN "Design for the pallet" | Measure the real pallet |
| REQ-SHP-04 | Every pallet has a layout with loaded height, weight and freight density in lb/ft³. The LTL class follows from density; state the density, don't guess the class. | per pallet | source | PLAN Milestone 1 | Layout study output |

## E. Guardrails and other requirements

### Fresh air (a full requirement)

| ID | Requirement | Target | Status | Source | How we prove it |
|---|---|---|---|---|---|
| REQ-AIR-01 | CO2 inside, 2 people, all day, door closed, at steady state, even in an office whose own air is at 600 ppm. | ≤ 800 ppm | DECIDED (D-43) | PLAN Target 4 (on main); DL D-43 | Calculation (C2), then a CO2 log on the prototype |
| REQ-AIR-02 | Fresh-air flow, set by CO2 and heat (D-44, D-50): never below 26 l/s while someone is inside. At the mixing effectiveness of 0.8, holding 800 ppm in a 600 ppm office takes about 33 l/s for one person and about 65 l/s for two (C2), so two people often run near the boost (D-52). 53 l/s is the normal flow for two (D-33). The boost reaches 65 l/s at 30 dB(A) or less (D-52): with D-130's sealed intake boot and gaskets, 25.2 dB(A) at 53 l/s and 29.6 dB(A) at 65 l/s, and held at 30 dB(A) or less the boost reaches 66.2 l/s (calculation, the air report, PR #254; the Air Engineer's first figures for D-130, 25.0 and 29.5 with 66.7 l/s; with DR as built and no boot, 33.3 and 37.8; the report's 25.1 and 29.6, PR #199, came before DR's cavity; D-61, D-62, D-121, D-124, D-130): 0.4 dB(A) under the limit, a risk until the fan sample measures it (ISS-090) and runs whenever 800 ppm or the 4 K limit can't be held (D-50). Two people put about 249 W into the air, so 53 l/s holds 3.9 K (calculation, PR #72); with the voice kit fitted on its 40 W average, 4 K takes 62 l/s at 28.5 dB(A), inside the boost (D-88, C4; PR #115). | ≥ 26 l/s while occupied; ≈ 33 l/s for one; 53 l/s for two; boost 65 l/s | DECIDED (D-33, D-44, D-50, D-52); calculation (C2, C3; HW; HW-26) | PLAN Target 4; DL D-33, D-43, D-44, D-50, D-52, D-61, D-62; HW; HW-26 | Fan curve against system pressure, then a flow check |
| REQ-AIR-03 | Fans start by themselves when someone is inside. CO2 and heat control the air (D-44, D-50): CO2 at 800 ppm or less, and the inside at most 4 K over the room, read by a temperature sensor at the supply fan inlet against the hub's sensor inside. The control boosts whenever it can't hold either limit, and people can also boost by hand (D-33). With the voice kit fitted, the boost holds 4 K at 30 dB(A) or less (D-88). The CO2 reading is shown inside. Control and readings come from Autonomous's in-house **Desk Pro AI sensor hub** (CO2, presence, air quality, sound level), see REQ-ELE-02. | self-starting, CO2- and heat-driven, boost by either or by hand, reading shown | DECIDED (D-09, D-33, D-44, D-50, D-88) | PLAN Target 4; DL D-09, D-33, D-44, D-50, D-88; PO-1031 | Control scheme, prototype check |
| REQ-AIR-04 | Fans are wired in, with no plug. The CO2 control overrides any user turn-down to hold 800 ppm and never goes below 26 l/s while someone is inside (D-44, ISS-038). The four fans run on the 12 V DC bus (D-51); none runs on mains. | wired in, on 12 V | DECIDED (D-10, D-44, D-51) | PLAN Target 4; DL D-10, D-44, D-51 | Wiring diagram |
| REQ-AIR-05 | Fan noise inside, through silenced vents, published: 26 dB(A) or less at 53 l/s and 30 dB(A) or less at the boost, which reaches 65 l/s (D-52). With D-130's sealed intake boot from the mesh to the riser's foot and gaskets on DR's inner and access panel edges and round each cartridge's inlet end, it calculates at 25.2 dB(A) at 53 l/s and 29.6 at 65 l/s, the boost held at 30 dB(A) or less reaching 66.2 l/s: 0.4 dB(A) under the limit, a risk until the fan sample measures it (calculation, the air report, PR #254; ISS-090); the Air Engineer's first figures for D-130 were 25.0 and 29.5 with 66.7 l/s. With DR as built and no boot it came to 33.3 and 37.8, and the cartridges' open slide-out gaps cost about 5 dB more; gaskets alone reach only 36.2 (D-130). On AIR's build before DR's cavity, the air report gave 25.1 and 29.6 with 66.3 l/s, and with 2 mm casings it would be 30.1 at 65 l/s and 64.8 l/s (PR #199). PR #115's 25.2 and 29.6, with 66.2 l/s, had lined every wall of the fan boxes, and gave about 15 dB(A) for one person at 33 l/s; the sized layout on skeleton P04 gave 25.3 and 29.7 (D-61, D-62). The calculation includes the fans' own casing sound; the fans' octave data is on HOLD for the fan-sample test (ISS-077). Measured at seated ear height in the middle of the pod with the door closed (point PROPOSED). | ≤ 26 dB(A) at 53 l/s; ≤ 30 dB(A) at 65 l/s | DECIDED (D-52, D-61, D-62); calculation (25.2 and 29.6 dB(A), boost 66.2 l/s, with D-130's boot and gaskets, the air report, PR #254, ISS-090); assumption (method) | DL D-52, D-61, D-62; the air report (PRs #115, #199); HW-26 §7d; PLAN Target 4 | Noise estimate, the fan-sample test, then a measurement on the prototype |
| REQ-AIR-06 | Low-heat lights, all on 24 V (D-168): a slim light shelf along the tops of the side and back walls, within 0.4 kg/m with its LED strip and brackets (D-85), lights the felt ceiling, and the scenes include a 'call' scene that lights the face evenly from the screen side; no front face light (D-70, replacing D-20). Total lighting power budget so the pod stays within 4 K of the room (D-50) at the 53 l/s normal flow (C4). | ≤ 30 W | DECIDED (lights, D-70, D-85, D-168; 4 K, D-50); PROPOSED (30 W budget, assumption) | DL D-50, D-70, D-85, D-168; PLAN Target 4; MS | Fitting data |
| REQ-AIR-07 | The air path runs inside the pod (D-60, as sized by D-61). Room air comes in through a flush black mesh in the base band piece under the right decor block DR, 80% free, 0.028 m², with a closing plate at Y −645 between that space and the pod (D-62); it rises through DR's sealed underside and a 1 mm steel intake riser to the supply fan pair high in DR, then runs down the 217 × 360 × 2105 mm felt-covered air column (on skeleton P04) in the front-right inside corner, through its cartridge, to a 100 mm kick grille at the column's foot. The exhaust enters a grille at the far end of the felt-covered soffit above the door head (360 mm deep, 220 mm tall, Z 2120 to 2340, 2120 mm headroom), runs along the soffit's cartridge to the exhaust fan box at its right end, and leaves through a roof slot just behind DR (Y −620 to −326). One cartridge part serves both paths: 173 × 314 × 1750 mm, two 80 mm passages between three 50 mm absorbent layers in a 2 mm aluminium casing, and it may split in two with a sealed slip joint (D-59). Four 12 V fans, two per path, on two balanced signals: one path in, one out (BP rule 7). The intake and the exhaust are about 2.3 m apart, at least 1 m (D-58). Everything is serviced from inside, the supply fans through DR's removable inner face (D-59). The CAD fit of the column, soffit, riser, fans and mesh band, and the recirculation check (the inlet within 0.5 K of the room at boost), are on HOLD (ISS-078). No roof box, and no air path in the top block DT. | 1 path in, 1 out, inside the pod; intake ≥ 1 m below the exhaust | DECIDED (D-58 to D-62); calculation (HW-26) | DL D-58 to D-62; HW-26 §7e; SEL; BP rule 7 | Air design; CAD fit and recirculation check (ISS-078) |

### Electrical and in-house modules

| ID | Requirement | Target | Status | Source | How we prove it |
|---|---|---|---|---|---|
| REQ-ELE-01 | A **12 V DC bus** feeds the fans and the sensors; the lights and the voice kit run on **24 V** Class 2 supplies (D-168). Mains, US 120 V, 60 Hz on the prototype too (D-133), goes **only to the user outlets** (the socket in plan VT07): tamper-resistant NEMA 5-15R sockets on UL-listed parts, a 120 V cord and inlet, and mains wiring sized for 15 A; Uten, the pick for Vietnam, is dropped. The DC supplies, 12 V and 24 V, have 100-240 V input and a UL Class 2 listing, so nothing on the DC side changes. In Vietnam the prototype is tested through a 220-to-110 V step-down transformer (D-133). The four fans run on 12 V (D-51), so D-29's mains-fan exception no longer applies. | 12 V DC (fans, hub) and 24 V DC (lights, kit); mains, US 120 V 60 Hz, to the outlets only | DECIDED (D-10, D-51, D-133, D-168) | DL D-10, D-51, D-133, D-168; PO-1031 | Wiring diagram, load table |
| REQ-ELE-02 | Reuse Autonomous's in-house modules. The **Desk Pro AI sensor hub** (CO2, presence, air quality, sound level) runs the air control and gives the readings. The **Lamp electronics** (mic array, speakers, computer) are the base of the later voice cockpit. Their supply, size, mounting and data details come from internal documents, still to collect (ISS-060). | 2 modules | DECIDED (reuse, D-09, D-11); unverified (module data) | DL D-09, D-11; PO-1031 | Module datasheets on file |
| REQ-ELE-03 | DC load budget, to size the DC supplies: voice cockpit 60 W at peak on its one 24 V feed (REQ-VCK-04, D-168; 40 W on average, D-88) + lights ≤ 30 W at 24 V (REQ-AIR-06, D-168) + four 12 V fans, about 30 W in all (D-51; the maker's power figure wasn't found, SEL) + sensor hub about 5 W, giving about 125 W. Three Class 2 supplies, 216 W in all (D-168): the kit's 96 W CLG-100-24, the lights' 60 W LPV-60-24, and a 60 W 12 V supply for the fans and the hub; D-136's 4th supply goes. | ≈ 125 W load; 3 supplies, 216 W (96 + 60 + 60) | calculation (C8); assumption (fan and hub watts) | DL D-10, D-11, D-51, D-88, D-136, D-168; SEL; PO-1031 | Load table with real fan and hub data (fan-sample test, ISS-077) |
| REQ-ELE-04 | The sensor hub reads the occupied zone: CO2 and temperature at breathing height, presence with a view of the seat, sound level inside. It sits in the air column's 180 × 180 zone, well above the supply grille and away from the exhaust grille (D-70). A second temperature sensor at the supply fan inlet reads the room for the 4 K limit (D-50); that it reads the room, not recirculated exhaust, is an assumption until the fan sample's check (D-58, ISS-078). | hub in the column zone; inlet sensor | DECIDED (hub in the column, D-70; inlet sensor, D-50); PROPOSED (sensor heights, assumption); assumption (the inlet reads the room, until ISS-078) | PO-1031; DL D-50, D-58, D-70 | Placement on the ELECTRICAL drawing, prototype readings, the recirculation check |
| REQ-ELE-05 | Design rule: cables in the cassette gap clip only to the cassette, never across the gap to the frame, so the floating lining stays floating. | 0 bridges | DECIDED (D-26) | DL D-26 | Wiring drawing, joint register |

### Build of the walls, ceiling, floor and door

| ID | Requirement | Target | Status | Source | How we prove it |
|---|---|---|---|---|---|
| REQ-BLD-01 | Wall build, from outside: the outer panel, 46 mm: ACP 3 mm on a 3 mm bond line of Sikaflex-252 (D-137; Sika's lab check on our tube is a HOLD, and the wall sample's T09 tests it) to a welded galvanized steel 20 × 40 box-tube frame with members about 300 mm apart (D-131, D-135), in the Joints Engineer's steel: certified yield 280 MPa or more (for example S280GD+Z to EN 10346 or SGC400 to JIS G3302), pre-galvanized with a Z100 coating (100 g/m² of zinc on both faces together, for indoor use), zinc-rich paint on the welds and no hot-dip after welding; 1.2 mm for the side panels' rails and front stiles (the PM's ruling), 1.0 mm for the other perimeters, the 40 × 40s and any member with a bolt, spigot, rivnut or stud, and 0.8 mm for the studs; each corner mitred with a 2 mm plate (J-FRAME-01) (it was aluminium with 1.2 mm perimeters and 1.0 mm inner studs, at 400 mm centres, and the back panels had 2 studs at 393, D-85); the ACP skin flexes 2 mm or less under a 100 N push at a bay's centre, edges taken as simply supported, which the 300 spacing gives for about +0.8 kg of steel per panel (D-135; calculation, WALL; the wall sample's T14); with 40 × 40 corner edge tubes (D-63) and 40 mm PET fill at 24 kg/m³ by default, which the wall sample's T02 confirms next to 32 kg/m³ (D-54, D-81). The frames' corners and T joints are welded in the factory, with no cleats (D-131, replacing D-79's 6063-T6 and D-117's cleats). Then a 4 mm gap and a floating lining cassette: a 0.5 mm galvanised steel tray with 34 mm returns and 12 mm lips that hold the felt, no ribs (D-69), hung on clips only, with no rails (D-81), a 25 mm air gap and 9 mm PET felt on its face (the tray stays 0.5 mm, D-37). 84 mm in all (D-66). The outer panel and the cassette ship as separate parts. The side walls are 1495 deep and start at the decor's back plate (D-49): in skeleton P04 the side panels are 1492.74 long and 1142.74 tall, and the back panels 1200.61 wide and 1118.61 tall, reaching the ceiling frame (D-66). Panels meet at 2.26 mm metal-stop seams, except the back wall's slotted centre seam, where a 5.5 mm closing gap leaves the frames 1198.99 wide under 1200.61 skins (D-64, D-65; skeleton PR #58). Rivnut torque is on HOLD until a spin-out test in the real tube (D-48, ISS-011). | 84 mm; skin flex ≤ 2 mm under 100 N at a bay's centre; about 12.6 kg/m² plus the lips with aluminium frames (steel's figure comes with the sample panel's recount, D-131) | DECIDED (D-16, D-17, D-37, D-48, D-49, D-54, D-63 to D-66, D-69, D-81, D-85, D-131, D-135, D-137); source (the Joints Engineer's check: the steel, its Z100 coating and its gauges); calculation (HW, aluminium frames; WALL, the 300 spacing) | DL D-16, D-17, D-37, D-48, D-49, D-54, D-55, D-63 to D-66, D-69, D-79, D-81, D-85, D-131, D-135, D-137; HW; SKL; JNT | Wall section on the WALL drawing; part weights; the wall sample's T14 |
| REQ-BLD-02 | Ceiling build: the wall stack, 84 mm (D-42, D-66): ACP 3 mm on a 3 mm bond line of Sikaflex-252 (D-137) to welded galvanized steel 20 × 40 box-tube frames with the same outside sections (D-131), in the Joints Engineer's steel: certified yield 280 MPa or more (for example S280GD+Z to EN 10346 or SGC400 to JIS G3302), pre-galvanized with a Z100 coating (100 g/m² of zinc on both faces together, for indoor use), zinc-rich paint on the welds and no hot-dip after welding; 1.0 mm for the perimeters, the 40 × 40s and any member with a bolt, spigot, rivnut or stud (cross member 1 too: it takes the soffit's hanger studs), and 0.8 mm for cross members 2 and 3; each corner mitred with a 2 mm plate (J-FRAME-01) (the cross members carry the cassette clips and safety catches, D-85; they were 20 × 40 × 1.2 aluminium 6063-T6, D-79), with 40 mm fill at 24 kg/m³ by default (D-54, D-81), plus the floating lining cassette (0.5 mm steel tray with 12 mm lips and 2 ribs, 25 mm air gap, 9 mm felt; D-69). The ceiling halves' frames span frame to frame between the side frames, 1200.61 wide each in skeleton P04 (D-55, D-66), and close by assembly order at a slotted centre seam (D-64, D-65). The soffit takes the front strip, so both ceiling cassettes stop at its back face and stay one part (D-69); the roof slot goes through the right outer ceiling panel only, so the two outer skins are two parts (D-61, D-69). The light and sensor cables run in the cassette's gap (D-41). Every part stays at 20 kg or less; the fill rides on its cassette if a panel would pass 20 kg (D-24). | 84 mm; 12.6 kg/m² with aluminium frames (steel's figure comes with the recount, D-131) | DECIDED (D-24, D-37, D-42, D-54, D-55, D-61, D-64 to D-66, D-69, D-81, D-85, D-131, D-137); source (the Joints Engineer's check: the steel, its Z100 coating and its gauges); calculation (HW, aluminium frames) | DL D-24, D-37, D-41, D-42, D-54, D-55, D-61, D-64 to D-66, D-69, D-79, D-81, D-85, D-131, D-137; HW; SKL | Ceiling section |
| REQ-BLD-03 | No plywood behind the ACP anywhere; plan VT02 is dropped. | no plywood | DECIDED (D-17) | DL D-17 | BOM |
| REQ-BLD-04 | No floor (D-132): people stand on the room floor, with no step at the door. The aluminium base band stays, 1.5 mm with a load block at each glide (D-86), and the base seal becomes a soft lip on the band's inner face that presses on the room floor across the glides' range, so v1's open shadow line under the band stays and the intake under DR stays clear (D-132). The two floor panels, their foam and the 13 mm threshold go (D-132, replacing the floor parts of D-72, D-76 and D-86). | no floor; no step | DECIDED (D-66, D-86, D-132) | DL D-18, D-66, D-72, D-76, D-85, D-86, D-132 | BASE drawing |
| REQ-BLD-05 | Door left-hinged, as in v1 (D-19), with the hinge pocket in the left decor block DL. The hinges must be rated for the 8.76 mm toughened, heat-soaked laminate, for the door unit of about 50.2 kg with a rating of at least 60 kg (D-68, replacing D-56's 47.5 kg) and for the 1176 mm width, and they hold the door at its closed position. There is no latch on the glass: the door keep is a 35 N magnetic catch in DT's underside at the top latch corner (D-83). The hardware is on HOLD until a rated set is named (ISS-002). D-30's dormakaba OFFICE 11.233 stays the candidate on HOLD, but its maker lists it for 8 and 10 mm toughened glass only (D-46, SEL). Häfele's 90° glass-to-wall hinges 926.88.090/091, which the owner's lead engineer suggested, are a second candidate for the factory's questions only: they are rated 35 to 45 kg a pair for doors up to about 915 mm wide, short of this door (D-138). | left-hinged; rated for the 8.76 mm laminate, ≥ 60 kg and 1176 mm; 35 N magnetic catch | DECIDED (D-19, D-46, D-56, D-68, D-83, D-138); source (OFFICE 11.233 listing, SEL; the Häfele hinges' rating, FRONT's check) | DL D-19, D-30, D-46, D-56, D-68, D-83, D-138; SEL; FRT | FRONT drawing; door sample |
| REQ-BLD-06 | Inside size: the 84 mm walls and ceiling (D-66) make it about 4 cm narrower and 2 cm shallower than v1 (2372 × 1480), and having no floor makes it about 9 cm taller than v1 (2223). Skeleton P04, updated in place in PR #58, gives 2332 between the side linings and 2304 from the 12 mm floor top to the ceiling cassette; with no floor (D-132) it is 12 mm taller, about 2316 from the room floor to the ceiling cassette (calculation: the cassette face at Z 2316). The air column and the soffit take the front-right corner and the strip above the door (D-60, D-61). | ≈ 2332 × 1457 × 2316 mm | calculation (SKL, PR #58, and D-132's 12 mm; depth: HW's 1460 less 3 mm) | SKL; HW; DL D-42, D-66, D-72, D-132; V1 BOM summary | GA-001 |
| REQ-BLD-07 | Felt: picked by its published absorption data down to 100 Hz, and the wall sample is measured down to 100 Hz (D-48). The factory's 9 mm PET felt is tried first if its data qualify; Autex Cube only if it falls short (D-31). Its emission certificate is on HOLD (ISS-075). | data and sample down to 100 Hz | DECIDED (D-31, D-48, D-56) | DL D-31, D-48, D-56; SEL | Wall sample result; certificate on file |
| REQ-BLD-08 | The door gets a hollow aluminium kick strip at the bottom, with the same outside as the solid one (D-85), black anodised like the base band (D-67), housing the drop seal. It fills the gap under the 2011 mm door and keeps v1's unbroken dark base band across the front (D-40). The door bottom sits at Z 105 (D-57), and the door glass runs 25 mm down into the strip (D-68). With no threshold, the door's drop seal closes on the room floor (D-132); the strip's running gap over the room floor follows FRONT's update (it kept 7 mm over the 13 mm threshold, Z 20 to 105, D-72, skeleton P04 since PR #58). | strip to Z 105; the drop seal on the room floor | DECIDED (D-40, D-57, D-66 to D-68, D-85, D-132); unverified (the gap over the room floor, pending FRONT's update) | DL D-40, D-57, D-66 to D-68, D-72, D-85, D-132; SKL; FRT | FRONT drawing, front elevation against v1 |

### Quiet (guardrail)

| ID | Requirement | Target | Status | Source | How we prove it |
|---|---|---|---|---|---|
| REQ-SND-01 | Speech level reduction D_S,A to ISO 23351-1. The decided build calculates at **about 19.3 dB (range 14.6–21.7)** with the only published data for a 9 mm felt, measured glued flat; about 24 dB is the best case if the felt on its 25 mm gap absorbs more (D-53). The wall sample, measured down to 100 Hz, decides, and no weight goes back in until it is measured (PLAN). For comparison, the calculation gives v1 about 15 dB as built, against its 30 dB claim (ISS-065). | ≈ 19.3 dB calculated (14.6–21.7); ≈ 24 dB best case | DECIDED (D-53); calculation (HW) | DL D-53; HW; PLAN Target 5; MS | Calculation, the wall sample down to 100 Hz, then the lab test with v1 in the same lab |
| REQ-SND-02 | Seals before mass: a gasket on every panel joint, a drop seal on the door, fill in the cavities, glass seated in sealed profiles, and a base seal: a soft lip on the band's inner face that presses on the room floor across the glides' range (D-132; it sat at the floor's edge, D-86). The joint gasket runs beside the washer line, never cut by a bolt or spigot (D-64), and the closing centre seams get a thicker gasket that seals over their range (D-65). | all 5 present | confirmed; DECIDED (gasket line, D-64, D-65; base seal, D-132) | PLAN "Quiet without the weight"; DL D-64, D-65, D-86, D-132 | Joint register, sound check |
| REQ-SND-03 | If the quiet target needs more mass, add only what it needs, show the kg per dB, and stay at or under the cap, 460 kg as shipped, provisional until the sample panel's recount (D-131; it was 420, D-37). No weight goes back in until the wall sample is measured (D-53). With D-85's savings the pod is 409.0 kg as shipped on the merged count (live count, PR #254; still aluminium frames and the floor), with the voice kit's reserve outside the cap, until the wall sample settles the fill and the felt (D-54, D-81, D-85). | ≤ 460 kg as shipped (provisional, D-131) | DECIDED (D-53, D-54, D-81, D-131) | DL D-35, D-37, D-53, D-54, D-81, D-131; PLAN Risk 3 | Sound check report; the wall sample's weights |

### Materials, later US rules, and doing it right

| ID | Requirement | Target | Status | Source | How we prove it |
|---|---|---|---|---|---|
| REQ-MAT-01 | Low-emission certified felt, boards and glue from the prototype on. The certificate type is chosen in the hardware selection; examples to check are CARB Phase 2 or TSCA Title VI for wood panels and GREENGUARD Gold for felt and adhesives. The factory felt's emission certificate is on HOLD (D-56, ISS-075). | certificate for each | confirmed (need); unverified (certificate names) | PLAN Target 6; MS; SEL | Supplier certificates |
| REQ-US-01 | Keep it possible: the roof can take a sprinkler head or open on an alarm (ISS-052). At about 45.7 sq ft (4.25 m², C1) the pod is over the usual 24 sq ft size below which pods go without sprinklers, so a US version needs a sprinkler strategy (HOLD, ISS-082). | zone reserved; strategy in the US rules phase | confirmed (zone); unverified (the exemption, ISS-082) | PLAN "Later"; GTM | Ceiling drawing; the code text in the US rules phase |
| REQ-US-02 | No step at the door (D-132): with no floor, people walk in on the room floor, so the US accessibility rule for thresholds (13 mm or less, with any part above 6 mm bevelled no steeper than 1:2) is met with no threshold at all; D-72's 13 mm threshold is gone. | no step | DECIDED (D-132) | DL D-18, D-72, D-132; PLAN "Later"; GTM | Door elevation |
| REQ-US-03 | Keep it possible: a wide door. The v1 door leaf is 1175.6 wide at the bottom; the clear width with the door open at 90° goes on the GA. | ≥ v1 | confirmed | PLAN "Later"; V1 STEP | GA-001 |
| REQ-US-04 | Keep it possible: a light door pull. The limit is set by the hardware selection; US rules (later) use about 22 N (5 lbf) for interior doors. | ≤ 22 N (to confirm) | confirmed (intent); unverified (number) | PLAN "Later" | Pull test on the prototype |
| REQ-US-05 | Keep it possible: UL 962 covers booths and pods with electrical parts, so the US product will likely need a UL 962 listing (HOLD, ISS-083), which comes later (D-134). The prototype already takes US 120 V, 60 Hz mains on UL-listed parts, with UL Class 2 supplies, 12 V and 24 V (D-133, D-168), so the listing path starts from US parts; the DC bus with mains only at the outlets (D-10) keeps the listed mains side small. | listing path known before the US version | unverified (scope and edition, ISS-083); decided (US mains parts, D-133) | GTM; DL D-10, D-14, D-133, D-134 | UL 962 check in the US rules phase |
| REQ-DOC-01 | Built to the guideline: native Fusion CAD with editable sketches and parameters; drawings in the order GA, then assemblies, then parts; one master BOM; joint and feature registers; a status on every number; a Reviewer runs the §13 checklist on every pull request. A model that passes every other check merges, whatever the screen state, and its missing drawings stay severe and open until drawn (D-91, D-97; this replaces D-84's major rating while the screen is locked). A part on a tabulated drawing (identical or mirrored shapes on one drawing that lists every number) counts as drawn, and a plain knife-cut felt or fill rectangle is drawn by its cut list when that gives its number, size, material and tolerance. Soft goods cut from sheet or roll (foam, gaskets, seals, tape) are drawn by a DXF of their outline or, as plain strips and rectangles, by a cut-list line with size, thickness, material, tolerance and number. A flat part cut from sheet (laser, waterjet or CNC router) with no bends and no machined features is drawn by its DXF, with the full outline and every hole, when its parts-list row gives material, thickness, finish, a general tolerance (ISO 2768-m) and any critical hole note, and its DXF draws only on the CUT and MARK layers (a line on any other layer, such as BEND, a pocket, an engraving or a half-lap, keeps the drawing); a flat ACP part counts too, and a routed-and-folded one keeps its drawing (D-100); folded, machined, welded or bonded parts and every assembly keep drawings (D-89). | all | confirmed; DECIDED (merge with drawings to follow, D-91, D-97; tabulated drawings and cut lists, D-89, D-99) | PLAN Target 7; GL §1, §9, §12; DL D-73, D-84, D-89, D-91, D-97, D-99 | Reviewer checklist |
| REQ-DOC-02 | Agents never order parts, contact suppliers or release anything for production. | — | confirmed | PLAN "How we build it"; AGENTS.md | — |
| REQ-DOC-03 | The repo is public: no supplier quotes, margins or personal data. | — | confirmed | AGENTS.md | Review |
| REQ-DOC-04 | Units in files: drawings and DXF in mm; STEP files may stay in cm when the file declares it. Check the unit and a known size after every import or export (ISS-066). | mm (drawings, DXF) | DECIDED (D-13) | DL D-13; GL §3.1 | Round-trip check in the CAD reports |

## F. Hooks for a later voice cockpit kit

The kit is **not** designed in v2. It will be built on the in-house Lamp electronics (mic array, speakers, computer), plus a screen and a status light. We only reserve what it needs, so it can be added later without cutting or rebuilding panels (ISS-051).

| ID | Requirement | Target | Status | Source | How we prove it |
|---|---|---|---|---|---|
| REQ-VCK-01 | Reserve hidden mounting points for the Lamp electronics (mic array, speakers, computer), a screen and a status light. They stay invisible from outside when no kit is fitted. | mounts for 5 items | DECIDED (D-11) | DL D-11; PO-1031 | WALL, CEILING and ELECTRICAL drawings |
| REQ-VCK-02 | Zones: the screen on the work wall, the right wall beside the air column, above its 1000 mm ledge, up to about 900 mm wide (D-70); the speakers and the computer behind a cover near it; the sensor hub in the air column's 180 × 180 zone (D-70); mic array and status light at the inside front edge of the ceiling or the soffit, facing the user. | as stated | DECIDED (screen wall and hub, D-70); PROPOSED (assumption: the other places and heights) | PO-1031; DL D-70 | Interfaces IF-15, IF-16 |
| REQ-VCK-03 | Cable path: a reserved route with a draw wire from the electrical zone in the back wall to each zone. It runs in the 25 mm gap inside the wall and ceiling lining cassettes, clipped to the cassettes only. Ceiling cables come in at the back-wall top corner and never cross the roof frame (D-41). Nothing is cut on site later. | 1 route per zone | DECIDED (path D-11, ceiling route D-41); PROPOSED (wall routes) | DL D-11, D-41; HW; PO-1031 | Route drawing |
| REQ-VCK-04 | Power: a reserved outlet for the kit with one fused 24 V Class 2 feed from its own Mean Well CLG-100-24 (96 W; 77 W at 80 %, D-168), in place of D-136's two 12 V feeds. The kit's peak stays 60 W and its average 40 W (D-88). It is counted in the load budget at its peak (REQ-ELE-03) and in the heat budget at its average: with the kit fitted, the fans boost to hold 4 K at 30 dB(A) or less: 62 l/s at 28.5 dB(A), inside the 65 l/s boost (C4, D-88; PR #115; the supply's loss goes into AIR's next run: one supply in place of D-136's two, about 4 W less, D-168). | 60 W peak on one 24 V Class 2 feed; ≤ 40 W average | DECIDED (D-11, D-88, D-168); calculation (C4) | DL D-11, D-88, D-136, D-168; PO-1031; AIR (PRs #66, #68, #72) | ELECTRICAL drawing, load and heat check |
| REQ-VCK-05 | Data: a reserved data link to the kit zone: Ethernet from the network socket (plan VT09), plus a spare data cable in the cable path. The cable type is set with the Lamp electronics. | 1 data link | DECIDED (link, D-11); PROPOSED (type) | DL D-11; PO-1031; BP VT09 | Route drawing |
| REQ-VCK-06 | The kit fixes with M6 into factory-fitted inserts on the lining cassette, never through the ACP skin: a hole through the outer leaf is a new sound leak (HW). | M6 | PROPOSED | PO-1031; PLAN Target 2; HW | Joint register |

## G. Every constraint in the v2 build plan

All lines come from `v2/00-Control/v2-build-plan.pdf`, translated. The last column says what v2 does with each. Changes are either DECIDED (`decision-log.md`) or PROPOSED, and every one is logged as an issue.

| ID | Build plan constraint | Value | Status | Source | v2 disposition |
|---|---|---|---|---|---|
| BP-01 | Overall size | 2500 W × 1700 D × 2400 H mm | source | BP p1 "Overral" | Kept (REQ-LOOK-02). The plan's own picture shows 2405 (ISS-013). |
| BP-02 | Goals: 1 light pod; 2 easy assembly by 2 people; 3 "cách ấm tốt", read as good sound insulation (ISS-008); 4 good ventilation; 5 easy to pack and ship | — | source | BP p1 "Goal" | Kept. Numbers come from PLAN (ISS-009). |
| BP-03 | Rule 1: build each part from 2D sketches | — | source | BP p1 Rule 1 | Kept (GL §4.4) |
| BP-04 | Rule 2: model parts as components, never as bare bodies | — | source | BP p1 Rule 2 | Kept |
| BP-05 | Rule 3: modelling order: floor frame, left wall, right wall, back wall, ceiling, decor frame (black), floor boards | — | source | BP p1 Rule 3 | Kept. With no floor (D-132) the first step is still BASE. |
| BP-06 | Rule 4: wall-to-wall joint, per the p2 section. Layers from outside: VT01 3, VT02 6, VT10 20, VT03 9 mm. The ceiling or back wall sits between the side walls with a 1 mm gap; the side walls' outer layers cover its edge; bolts join the frames. | 3 / 6 / 20 / 9 mm; 1 mm gap | source (picture dimensions) | BP p2 Rule 4 | Replaced by the final stack (REQ-BLD-01; D-16, D-17, D-66): ACP 3 on a 3 mm bond line, 20 × 40 aluminium with 40 mm PET, floating steel-and-felt cassette, 84 mm. Panels meet at a 2.26 mm metal-stop seam (D-64), not the plan's 1 mm gap; seals added (ISS-003); captive M6 × 16 socket-head bolts into rivnuts (D-63), with the torque on HOLD (ISS-011). |
| BP-07 | Rule 5: VT01 glued to VT02; VT02 screwed to the VT10 frame with steel screws; VT03 fixed with hook-and-loop last, after the pod is built | — | source | BP p2 Rule 5 | Changed: no plywood (D-17); the felt is pre-fitted on the lining cassette at the factory (D-08). ISS-015, ISS-016. |
| BP-08 | Rule 6: walls bolted to the floor frame with M6 | M6 | source | BP p2 Rule 6 | Changed: walls stand on the base band at the 2.26 mm stop and fix to it with captive M6 × 16 socket-head bolts into rivnuts in the band (D-63, D-64; thin floor DECIDED, D-05) |
| BP-09 | Rule 7: ventilation fans in the ceiling, one blowing in and one blowing out | 2 fans | source | BP p2 Rule 7 | Changed: four 12 V fans, two per path, inside the pod: the supply pair high in the right decor block and the exhaust pair at the soffit's right end (D-51, D-60, D-61); still one path in, one out (REQ-AIR-07) |
| BP-10 | Rule 8: VT07, VT08 and VT09 mounted on the back wall | — | source | BP p2 Rule 8 | Kept. VT08's role changes (ISS-038). |
| BP-11 | VT01: aluminium composite panel, Dark Yellow (EV3038) | 3 mm | source | BP p2 | Kept; spec gaps (ISS-035) |
| BP-12 | VT02: plywood | 6 mm | source | BP p2 | Dropped: no plywood behind the ACP (D-17) |
| BP-13 | VT03: polyester fibre acoustic panel, dark gray (seller link in the plan) | 9 mm | source | BP p2 | Kept: 9 mm felt on the lining cassette's face (D-17); spec gaps (ISS-035) |
| BP-14 | VT03 (second use of the code): steel box tube | 50 × 100 mm | source | BP p3 | Dropped: thin floor (D-05). Code clash ISS-007. |
| BP-15 | VT04: steel box tube | 30 × 60 mm | source | BP p3 | Dropped: thin floor (D-05) |
| BP-16 | VT05: steel plate | 3 mm | source | BP p3 | Use unknown (ISS-037) |
| BP-17 | VT06: ventilation fan Panasonic FV-15AUL1 (seller link in the plan) | — | source | BP p3 | Replaced by four 12 V fans (D-51), placed by D-60 and D-61: a mains fan clashes with the 12 V DC bus (REQ-ELE-01), and the FV-15AUL1's manual forbids ceiling mounting (SEL). The fans' octave test is on HOLD (ISS-077) |
| BP-18 | VT07: UTEN S300 one-way switch and 5-pin socket | — | source | BP p3 | The socket stays the only mains point inside (REQ-ELE-01), now a tamper-resistant NEMA 5-15R on UL-listed parts: Uten is dropped (D-133). What the switch switches is open (ISS-061). |
| BP-19 | VT08: UTEN S300 fan speed controller ("triết áp") | — | source | BP p3 | A mains knob can't drive 12 V DC fans; the sensor hub controls the fans and any manual trim is a 12 V input (ISS-038) |
| BP-20 | VT09: UTEN S300 single network socket | — | source | BP p3 | Kept as a network socket, which also feeds the voice cockpit data path (REQ-VCK-05); Uten is dropped (D-133), so it becomes a US part |
| BP-21 | VT10: steel box tube | 20 × 20 mm | source | BP p3 | Welded galvanized steel box tube again (D-131), with v2's outside sections: 20 × 40 for the walls and the ceiling (D-42, D-54), wall members about 300 apart (D-135), and 40 × 40 corner edge tubes (D-63); it was aluminium 6063-T6 (D-16, D-79, ISS-034). |
| BP-22 | VT11: bolt | M6 × 60 | source | BP p3 | Changed: M6 stays the one size, as an ISO 4762 M6 × 16 socket-head bolt, captive, with one 5 mm key (D-63, ISS-036) |
| BP-23 | VT12: leveling foot (seller link in the plan) | M10 | source | BP p3 | Dropped: thin floor (D-05) |
| BP-24 | Section I, floor frame: outer frame of 50×100 tube (VT03), 2 joists of 30×60 tube (VT04), outline per the top view, 6 M10 leveling feet (VT12) spaced evenly along the middle of the 50×100 tubes | 6 feet | source | BP p3 section I | Replaced by the thin floor (DECIDED, D-05) |
| BP-25 | Section II, left wall: build from outside VT01, VT02, VT10, VT03; split into 2 frames joined with M6×60; depth 1500, with the other 200 for the decor; its ACP covers the edges of the ceiling and back wall frames; only 2 ACP sheets show outside | 1500 + 200 | source | BP p4 section II | Kept: 2 sheets per side wall with aligned reveals (D-23). The 1500 and 200 are superseded: the side walls are 1495 deep and the decor blocks 205, as v1 measures (D-49). Depth chain on the GA (ISS-012); panel height (ISS-050). In skeleton P04 the side panels are 1492.74 long and 1142.74 tall (D-66). |
| BP-26 | Section III, right wall: same as the left wall; only 2 ACP sheets show outside | — | source | BP p4 section III | Kept, as BP-25 (D-23) |
| BP-27 | Section IV, back wall: same build; 4 frames joined with M6×60; 4 ACP sheets show outside | 4 frames | source | BP p4 section IV | Kept: 4 sheets on the back with aligned reveals (D-23); its frames span frame to frame between the side frames, 1200.61 per panel in skeleton P04, and its outer panels reach the ceiling frame (D-55, D-66); the centre seam is the closing seam (D-65) |
| BP-28 | Section V, ceiling: same build (the text says "back wall", ISS-032); 2 frames joined with M6×60; a fan on each half with a slot pattern below it | 2 frames | source | BP p4 section V | Changed: the wall stack on 20 × 40 welded galvanized steel frames, 84 mm (D-42, D-66, D-131), spanning frame to frame, 1200.61 per half (D-55, D-66); no fans in the ceiling halves: the exhaust runs through the soffit above the door to a roof slot in the right half, and the supply through the air column (D-60, D-61) |
| BP-29 | Section VI, decor frame: VT10 core frame inside, VT01 skin outside, the ACP grooved and folded to the faceted shape; 3 blocks (left, right, top), 200 deep, joined to the walls with V brackets and steel screws | 200 deep | source | BP p4–p5 section VI | Kept, except the depth: 205 mm as v1 measures, not 200 (D-49). The right block holds the intake riser and the supply fan pair, over the mesh band piece (D-61, D-62), and stands on the band at Z 110 (D-66). ISS-014, ISS-031, ISS-045, ISS-059. |
| BP-30 | Section VII, floor boards: 2 boards laid on the floor frame, screwed to its 2 joists | 2 boards | source | BP p5 section VII | Dropped: no floor (DECIDED, D-132), after the thin floor panels of D-05 and D-72 |

## H. Calculations

Each line names its inputs and their status. The layout study (`v2/05-Engineering/layout-study/`) and the sound and air check (`v2/05-Engineering/acoustics-air/`) replace these first estimates with their own scripts.

- **C1 Conversions (calculation).** 1 in = 25.4 mm exactly. 48 × 40 in = 1219.2 × 1016.0 mm. 48 × 96 in = 1219.2 × 2438.4 mm. 6 ft = 1828.8 mm. 36 × 80 in = 914.4 × 2032.0 mm. 4.25 m² = 45.7 sq ft (1 m² = 10.764 sq ft). Rounded to whole mm in the tables.
- **C2 CO2 at steady state (calculation).** Rise above the supply air: ΔC = n·G / (Q·ε). Inputs: n = 2 people; G = 0.0052 l/s of CO2 per seated adult (assumption, a typical value); supply air at 400 ppm, near outdoor level (assumption); mixing effectiveness ε = 1 (perfect mixing) or the PM's 0.8 (D-52). For CO2 ≤ 800 ppm, ΔC ≤ 400 ppm, so Q ≥ 2 × 0.0052 / 0.000400 = **26 l/s**. In a 600 ppm office (PLAN Target 4, D-43), ΔC ≤ 200 ppm, so Q ≥ 52 l/s with perfect mixing. That is why two people get 53 l/s. One person makes half the CO2, so 26 l/s holds 800 ppm for one person in a 600 ppm office with perfect mixing; that is the floor while someone is inside (D-44). At ε = 0.8 the same office needs 0.0052 / (0.000200 × 0.8) = **about 33 l/s** for one person and **65 l/s** for two, the boost (D-52); at the 26 l/s floor one person sits at about 850 ppm, so the CO2 control raises the flow (HW §7a). At the 53 l/s normal flow (D-33), ΔC = 0.0104 / 53 = 196 ppm, so CO2 ≈ **596 ppm** in a 400 ppm room, or **796 ppm** in a 600 ppm office (845 ppm at ε = 0.8). At the 65 l/s boost, ΔC = 160 ppm, so CO2 ≈ 760 ppm in a 600 ppm office (800 ppm at ε = 0.8). Office air is often above 400 ppm; the pod then sits higher by the same amount.
- **C3 Air change (calculation).** Inside about 2332 × 1457 × 2316 mm (REQ-BLD-06; no floor, D-132) = 7.87 m³, less about 0.35 m³ for the air column (217 × 360 × 2105) and the soffit (2332 × 360 × 220) (D-61), leaves 7.52 m³; v1 was 2372 × 1480 × 2223 mm = 7.80 m³ (V1 BOM summary). At the 53 l/s normal flow: 7.52 / 0.053 = 142 s, **about 2.4 minutes**. At the 65 l/s boost: 116 s, about 2 minutes.
- **C4 Heat (calculation).** Temperature rise ΔT = P / (ρ · c_p · Q), with ρ = 1.2 kg/m³ and c_p = 1005 J/(kg·K) (air at about 20 °C, source: standard values). Heat inputs, from the air report's model with ELECTRICAL's loads (PR #72, from ELECTRICAL's PR #64): 2 seated people at 75 W sensible each and 2 laptops at 30 W each (assumptions), the work scene's 22 W of lights (the shelf uplight dimmed and the down-light; the call light is off) and the supplies' losses 8.4 W (calculation, ELECTRICAL), the hub 3 W (assumption, ISS-060), and the two supply fans about 5.2 W at 53 l/s (cube law; the maker's figure is unverified), so P = 249 W (240 W before ELECTRICAL's loads; 257 W in PR #66 with the lights at full). At the 53 l/s normal flow: ΔT = 249 / (1.2 × 1005 × 0.053) = **3.9 K**, so 53 l/s holds D-50's 4 K limit; 4 K takes 51 l/s for two people and 29 l/s for one (the model, PR #72). One person at the 26 l/s floor reaches about 4.4 K and two people at 26 l/s about 7.8 K, one more reason they get 53 l/s (D-44). At the 65 l/s boost, two people sit at about 3.2 K. The voice kit at D-88's 40 W average with 8.2 W of supply loss gives 297 W at 53 l/s, 4.6 K; 4 K takes 62 l/s (28.5 dB(A) on AIR's build, PR #115), inside the 65 l/s boost, where the inside is 3.83 K over the room (PR #72). At its full 60 W the kit would have needed 69 l/s, over the boost (PR #66), hence D-88. So the flow above the CO2 minimum, and the boost, are what keep the pod cool, which matters because heat is the users' top complaint (MS).
- **C5 Glass mass (calculation).** Door area 2.080 m² and fixed glass area 1.344 m², from the v1 STEP outlines (polygon area). Glass density 2500 kg/m³ (assumption: typical soda-lime glass), so 25 kg/m² at 10 mm and 20 kg/m² at 8 mm. Door: 52.0 kg at 10 mm, **41.6 kg at 8 mm**. Fixed glass: 33.6 kg at 10 mm, **26.9 kg at 8 mm**. Both: 85.6 kg at 10 mm, 68.5 kg at 8 mm, so 8 mm saves 17.1 kg. The v1 BOM's rectangles (3.91 m²) overstate the area by 14 % (ISS-023). Decision D-27 makes the front 4+4 laminated glass (8.76 mm): 8 mm of glass at 20.0 kg/m² plus a 0.76 mm PVB interlayer at about 0.8 kg/m² (assumption: about 1070 kg/m³), so about 20.8 kg/m². That makes the door about **43.3 kg** and the fixed panel about **28.0 kg**. The FRONT models (FRT), with the door glass running 25 mm into the kick strip and the fixed glass 11.5 mm into its channels, give 43.9 kg and 28.6 kg, and the door unit about 50.2 kg (D-68).
- **C6 Mass per floor area (calculation).** Footprint 2.5 × 1.7 = 4.25 m². 409.0 / 4.25 = **96.2 kg/m²** as shipped, the live count with AIR's parts from CAD and D-130's boot and gaskets (PRs #91, #254); 408.5 kg gave 96.1 kg/m² (PR #91); 410.0 kg gave 96.5 kg/m² (PR #105); 407.6 kg gave 95.9 kg/m² (PR #205); 408.9 kg gave 96.2 kg/m² (PR #199); 409.8 kg gave 96.4 kg/m² (PR #195); 411.0 kg gave 96.7 kg/m² (PR #188); 411.4 kg gave 96.8 kg/m² (PR #185); 415.0 kg gave 97.6 kg/m² (PR #180); 412.6 kg gave 97.1 kg/m² (PRs #161, #164); 412.3 kg gave 97.0 kg/m² (PR #158); 412.7 kg gave 97.1 kg/m² (PR #154); 413.4 kg gave 97.3 kg/m² (PR #141); 412.9 kg gave 97.2 kg/m² (PRs #124, #126); 415.2 kg gave 97.7 kg/m² (PR #68); 412.5 kg before ELECTRICAL's parts gave 97.1 kg/m² (PR #61); D-85's first count, 412.2 kg, gave 97.0 kg/m²; the layout study's live count before them, 422.8 kg, gave 99.5 kg/m² (D-81); the P04 roll-up's 436.3 kg with the voice kit's reserve gave 102.7 kg/m². D-54's 427 kg gave 100.5 kg/m², and PR #11's 418 kg 98.4 kg/m². v1: 480 / 4.25 = 112.9 kg/m² (PLAN). The light build at 300 kg would be 70.6 kg/m².
- **C7 Step into the pod (calculation).** v1 floor top at Z(v1) = 115 mm (V1 STEP), plus 15 mm of feet, gives about 130 mm above the room floor. Thin floor (D-05): a 13 mm threshold, with the floor top at 12 mm (D-72). No floor (D-132): no step at all.
- **C8 DC load (calculation).** Voice cockpit 60 W at peak and 40 W on average (DECIDED, D-88), on one 24 V Class 2 feed from a 96 W CLG-100-24 (DECIDED, D-168): about 63 % at its peak, under the supply's 77 W at 80 %. Lights ≤ 30 W (REQ-AIR-06, assumption), at 24 V on a 60 W LPV-60-24 (D-168): 50 % or less. Four 12 V fans (D-51), about 30 W in all (assumption: the maker's power figure wasn't found, SEL; the fan-sample test sets it, ISS-077), and the sensor hub about 5 W (assumption until its datasheet arrives, ISS-060), on a 60 W 12 V supply: about 35 W (58 %). Total about 125 W on three Class 2 supplies, 216 W in all (D-168; D-136's 4th supply goes). Every load is also heat inside the pod (C4).
