autonomous-ai/spaceship/v2/00-Control/decision-log.md

# Decision log: Spaceship (FocusPod v2)

| Doc code | Revision | Status | Date | Owner |
|---|---|---|---|---|
| V2-CTL-008 | P01 | Live log | 2026-10-31 | The PM (the Swarm Lead) |

The PM makes product and design decisions and records each one here, with its reason (`AGENTS.md`). Nothing waits for outside approval. The guideline's engineering rules still apply, but this log replaces its approval steps. There are no human hardware leads on this project (D-32): issues close on the PM's logged decision plus evidence, and the factory's wall-and-door sample is the physical check.

A decision here is **DECIDED**. Everything else in the control pack marked PROPOSED is a working answer until the PM rules on it. To change a decision, add a new row that says which one it replaces; don't change an old row's decision. Its notes on other files' status, and factual slips in its reason, may be corrected.

**Current headline (D-27, D-37, D-49 to D-53, D-59 to D-88, D-131 to D-137):** a 4+4 laminated front of toughened, heat-soaked panes, frameless as in v1, with no floor and no step at the door, so the drop seal closes on the room floor (D-132); walls and ceiling on one 84 mm stack (D-66) on welded galvanized steel frames with the same outside sections (D-131), joined by captive ISO 4762 M6 × 16 bolts with one 5 mm key at 2.26 mm metal-stop seams (D-63 to D-65); the pod at 409.0 kg as shipped on the merged count, which still has the aluminium frames and the floor; D-131's steel frames add about 40 to 65 kg and D-132's no floor takes off about 21 (assumption: the PM's estimates), under a cap of 460 kg as shipped, provisional until the sample panel's recount (D-131; it was 420), with the voice kit's 4.0 kg reserve outside the cap (calculation, the layout study's live count with AIR's parts from CAD (PR #91) and D-130's intake boot and gaskets (PR #254), after FRONT's decor blocks (PR #105), WALL's B1 and B2 back panels and their cassettes (PR #205), D-121's and D-124's fan boxes (PR #199) and D-117's frame cleats (PR #195); D-116's thinner casings are withdrawn (D-121)); about 19.3 dB calculated (range 14.6–21.7, about 24 dB at best), with the wall sample deciding (D-53); fresh air driven by CO2 and heat, holding 800 ppm in a 600 ppm office and at most 4 K over the room, never below 26 l/s while someone is inside (D-50, D-52), through a felt-covered air column and soffit inside the pod: 25.2 dB(A) at 53 l/s and 29.6 at the 65 l/s boost, the boost reaching 66.2 l/s at 30 dB(A), with D-130's sealed intake boot and gaskets (calculation, the air report, PR #254; DR as built without them, 33.3 and 37.8): 0.4 dB(A) under the 30 dB(A) limit, a risk until the fan sample measures it (ISS-090); the voice kit on 40 W on average and 60 W at peak, on one 24 V Class 2 feed, with the fans boosting to hold 4 K at 30 dB(A) or less (D-88, D-168); designed for US use, with the mains side US 120 V, 60 Hz on UL-listed parts, 12 V for the fans and the hub and 24 V for the lights and the kit (D-168), and certification work later (D-10, D-133, D-134); decor blocks 205 mm deep and side walls 1495 deep, as v1 measures (D-49).

The control pack wrote the reasons from the PM's messages of 2026-10-31 and from the sources named. The PM can reword them.

| ID | Date | Decision | Reason | What it affects |
|---|---|---|---|---|
| D-01 | 2026-10-31 | **The look stays unchanged**: the faceted front, size, proportions, colours and glass layout. Every saving is invisible. | The faceted front is the team's iconic design and the product people know (PLAN.md Goal; `AGENTS.md`). | REQ-LOOK-01…05; every outside part; ISS-013, ISS-031, ISS-044 |
| D-02 | 2026-10-31 | **300 kg stays the goal. The build lands at about 380 kg with about 22–23 dB speech reduction (ISO 23351-1 Class C), the best value. 400 kg is the hard cap.** The 22–23 dB is calculated, and the factory sample decides the real figure. | The calculated lightest wall that still reaches about 22–23 dB comes out near 380 kg. Holding 300 kg would give up too much quiet, and the cap stops the trade from creeping. For scale, the calculation gives v1 about 15 dB as built. | REQ-LGT-01, REQ-SND-01, REQ-SND-03; WALL, CEILING, FRONT; ISS-009, ISS-042, ISS-063, ISS-065. Its numbers are replaced by D-27. PLAN.md was synced with it on main (ba0aefe). |
| D-03 | 2026-10-31 | **Every part weighs 20 kg or less, except the glass.** | One person can carry each piece through a normal door and up stairs, with no pallet jack (PLAN.md Target 1 and scorecard). | REQ-LGT-02; panel split; ISS-047 |
| D-04 | 2026-10-31 | **Ship on 48 × 40 in pallets plus one standard long pallet. The decor blocks are not split.** | Standard LTL pallets only. The long items (door, fixed panel, side decor blocks about 2300) ride one long pallet. Not splitting the decor keeps the faceted look free of extra seams and joints. | REQ-SHP-01, REQ-SHP-02; PACKAGING; ISS-057; layout study |
| D-05 | 2026-10-31 | **Thin floor**: panels about 2 cm thick on the room floor, walls fixed around them, base band kept as trim. Replaces the build plan's raised steel floor. | About 50 kg lighter. The step drops from about 13 cm to about 2 cm and there's about 10 cm more headroom. It still closes the bottom of the box for sound (PLAN.md; open-questions.md Q4). | BASE; BP-08, BP-24, BP-30; plan VT03-ST, VT04 and VT12 dropped; ISS-040, ISS-050, ISS-053, ISS-054 Its about 2 cm floor is replaced by D-72: 9 mm panels on a 3 mm mat, floor top at Z 12. |
| D-06 | 2026-10-31 | **No table.** The pod ships empty. | Customers furnish it however they like (PLAN.md). | INTERIOR; ISS-006 D-70 adds a ledge on the work wall; D-06 stands for the floor. |
| D-07 | 2026-10-31 | **Smoked acrylic front (door and fixed panel), with laminated glass as the fallback. The factory sample decides.** | The front is the heaviest single item and the weak spot for sound. Pick the most dB per kg. Acrylic is far lighter with the same smoked look; laminated glass is quieter if acrylic fails the sample. | FRONT 360000; REQ-LOOK-04; hinge rating; ISS-002, ISS-043 |
| D-08 | 2026-10-31 | **Tool-free connectors, captive bolts, factory-made subassemblies and pre-fitted felt.** | Two people in about an hour with one tool means almost nothing gets built on site. Captive bolts can't get lost. Felt fitted at the factory removes the slowest site step. | REQ-ASM-03, REQ-ASM-05, REQ-ASM-10, REQ-ASM-11; BP-07; LINING; ISS-015, ISS-047, ISS-064 Its tool-free seam clips are replaced by D-63's captive bolts at every seam and corner. |
| D-09 | 2026-10-31 | **Fresh air at 70 l/s**, with a CO2-driven fan that starts by itself, **25 dB(A) or less** inside, using the in-house Desk Pro AI sensor hub. | Heat and stale air are the users' top complaint. 70 l/s keeps CO2 near 550 ppm and the pod within about 3 K of the room. The in-house hub already measures CO2 and presence. Nobody publishes fan noise, so a quiet published figure is a first (PLAN.md scorecard). | REQ-AIR-01…07, REQ-ELE-02, REQ-ELE-04; AIR, ELECTRICAL; ISS-038, ISS-039, ISS-046 |
| D-10 | 2026-10-31 | **A 12 V DC bus feeds the fans, lights, sensors and voice kit. Mains goes to the user outlets only.** | Only low voltage runs through the panels and roof. A later 120 V US version changes only the supply, inlet and outlets. | REQ-ELE-01, REQ-ELE-03, REQ-AIR-04, REQ-AIR-06; plan VT06, VT07, VT08; ISS-039, ISS-061, ISS-062 D-133 brings the US 120 V, 60 Hz mains side forward to the prototype; the 12 V side doesn't change. |
| D-11 | 2026-10-31 | **Reserve hooks for the voice cockpit**, built later on the in-house Lamp electronics (mic array, speakers, computer), plus a screen and a status light: 12 V 5 A, data, mounts and a cable path. | Spaceship should feel like a cockpit you run by voice. The kit can bolt in later without a redesign (PLAN.md opening). | REQ-VCK-01…06; ELECTRICAL, WALL, CEILING, FRONT DT; IF-15, IF-16; ISS-051, ISS-060. D-136 replaces its 12 V 5 A with two separate 12 V Class 2 feeds capped at 48 W each. D-168 replaces those with one 24 V Class 2 feed. |
| D-12 | 2026-10-31 | **Decor in Dark Yellow** (ACP EV3038). | It matches the plan's material list (VT01) and v1's product photos. The black in the CAD renders and the plan's pictures isn't the product. | REQ-LOOK-03; FRONT decor; ISS-031 |
| D-13 | 2026-10-31 | **STEP files may stay in cm when the file declares it. Drawings and DXF are in mm.** | A STEP file carries its unit and readers convert it, while the shop works from drawings and DXF, which must be in mm (guideline §3.1). Check the unit and a known size after every import or export. | `conventions.md` §2; Phase 0 STEP export; ISS-066 (closed: `AGENTS.md` carries the exception since ba0aefe) |
| D-14 | 2026-10-31 | **US rules come later, but aren't designed out.** | The prototype focuses on structure. The roof, threshold, door width and door pull keep the US path open (PLAN.md). | REQ-SCP-02, REQ-US-01…04; ISS-052, ISS-053 D-72 brings the threshold rule forward. D-133 brings the US mains side forward too: US 120 V, 60 Hz on UL-listed parts. D-134 refines it: v2 is designed for US use (US 120 V mains and US parts, D-133), and certification work comes later. |
| D-15 | 2026-10-31 | **The working name is Spaceship.** Folder names don't change. | The pod looks like a spaceship, and inside it should feel like a cockpit (PLAN.md opening). | All new v2 text |
| D-16 | 2026-10-31 | **Aluminium frames, on the final stack**: 20 × 40 aluminium tube at 400 mm centres for the walls, 20 × 100 for the ceiling. The decor core frames are aluminium too, sized by the door-load check (ISS-045). | Aluminium is lighter than the plan's steel (PLAN.md: about 40 kg). The final stack is the quietest build inside the 400 kg cap: walls 81 mm at 13.1 kg/m², ceiling 141 mm at 17.4 kg/m², pod about 385 kg at 24.2 dB calculated (Hardware Engineer's sound and air check). | BP-21; plan VT10; WALL, CEILING, FRONT; REQ-BLD-01, REQ-BLD-02; ISS-034, ISS-041, ISS-045 Corner edge tubes are 40 × 40 (D-63). |
| D-17 | 2026-10-31 | **No plywood behind the ACP.** The sound mass goes in the floating steel-and-felt lining cassette: a 0.5 mm galvanised steel tray with 25 mm returns, a 25 mm air gap and 9 mm PET felt on its face. | The floating cassette gives more dB per kg than plywood bonded to the skin. It never touches the frame through a screw, and the steel is formaldehyde-free and fire class A1 (Hardware Engineer's sound and air check). | BP-07, BP-12; plan VT02 dropped; WALL, CEILING, LINING; REQ-BLD-01, REQ-BLD-03; ISS-015, ISS-016, ISS-042, ISS-058 |
| D-18 | 2026-10-31 | **Thin floor inside the aluminium base band, with a 20 mm threshold at the door.** | It keeps v1's base band look outside, and gives a low, fixed step at the door. | BASE; REQ-BLD-04, REQ-US-02; ISS-040, ISS-053 Its 20 mm threshold is replaced by D-72's 13 mm. |
| D-19 | 2026-10-31 | **The door is left-hinged, as in v1.** The hinge pocket sits in the left decor block (DL). | The fixed panel and the wide faceted right block sit on the right, so the hinges can only go on the left without changing the look (open-questions.md Q3). | FRONT 360000, DL; REQ-BLD-05; ISS-045, ISS-055 |
| D-20 | 2026-10-31 | **Lights: one dimmable, low-heat LED ceiling light plus a soft front face light for video calls, all on 12 V.** The Hardware Engineer picks the parts. | Heat is the users' top complaint and video calls need light on the face (market study). 12 V follows D-10. | ELECTRICAL, CEILING, FRONT DT; REQ-AIR-06; ISS-004, ISS-061 Replaced by D-70. |
| D-21 | 2026-10-31 | **Height datum: 2400 mm from the room floor to the top of the roof skin.** | The build plan's 2400, measured from a datum every file can use once the thin floor removes the feet. | REQ-LOOK-02; `conventions.md` section 4; GA-001; ISS-013 |
| D-22 | 2026-10-31 | **The part-number scheme in `conventions.md` section 6**: 6 digits, FF NNNN. | It keeps the shape of the team's existing numbers, and every assembly family has its own block. | All part numbers, the master BOM, file names |
| D-23 | 2026-10-31 | **Seams follow the build plan's intent: 2 sheets per side wall and 4 on the back, with crisp, aligned reveals.** The faceted front and the overall form are what can't change. | Seams on the plain walls are a detail; the iconic parts are the faceted front and the overall form. Aligned reveals make the seams look intended. | WALL; REQ-LOOK-05; ISS-044 |
| D-24 | 2026-10-31 | **The ceiling fill rides on its ceiling cassette**, so each ceiling half's outer panel stays at 20 kg or less. | Following the PM's ruling in the layout study. With the fill in it, a ceiling half's outer panel would weigh about 21 kg, over D-03's 20 kg rule (ISS-067). | CEILING, LINING; REQ-BLD-02, REQ-LGT-02; ISS-067 |
| D-25 | 2026-10-31 | **If the acrylic front fails its sample, the cap becomes 420 kg, for the laminated front only**, and the next round looks for weight offsets. The acrylic build stays at 400 kg or less. | The laminated fallback takes the pod to about 416 kg (ISS-068). A small, named exception is better than a thinner, louder ceiling. This changes D-02's cap for that case only. | REQ-LGT-01, REQ-SND-03; FRONT; ISS-068 |
| D-26 | 2026-10-31 | **Design rule: cables in the cassette gap clip only to the cassette, never across the gap to the frame.** | A cable fixed to both the cassette and the frame bridges the floating lining and leaks sound (ISS-069). | ELECTRICAL, LINING; REQ-ELE-05, REQ-VCK-03; IF-10; ISS-069 |
| D-27 | 2026-10-31 | **Front: 4+4 laminated glass, frameless as in v1. It replaces D-07's acrylic baseline; acrylic stays only as an optional experiment on the factory sample. The pod lands at about 400 kg and 23.8 dB (calculated range 21.3–26.3), on the 400 kg cap. These replace D-02's numbers (about 380 kg, 22–23 dB), and D-25's 420 kg exception is no longer needed.** To fit the glass under the cap, the ceiling moves to 40 mm frames (53 mm thick, 12.8 kg/m²) with separate silencer boxes, replacing D-16's 20 × 100 ceiling. Two conditions apply: the outside must not change, and every part stays at 20 kg or less. The Hardware Engineer says where the silencer boxes sit. | Acrylic needs an aluminium stile on its hinge edge, which adds an opaque band about 80 mm wide down the door and breaks the look rule (D-01). Laminated glass also removes the creep, scratch, fire-class and flatness risks. The thinner ceiling frees the weight for the glass (sound and air check in PR #11: quietest build under 400 kg with the laminated front). | REQ-LOOK-03, REQ-LOOK-04, REQ-LGT-01, REQ-LGT-03, REQ-LGT-04, REQ-SND-01, REQ-SND-03, REQ-BLD-02, REQ-BLD-06; FRONT 360000, CEILING, AIR; ISS-009, ISS-042, ISS-043, ISS-063, ISS-068, ISS-070, ISS-071. Replaces D-02's numbers, D-07, D-16's ceiling and D-25. |
| D-28 | 2026-10-31 | **Part-number bands apply to new v2 numbers only. Never reuse a number from the guideline's examples or the earlier V5 attempt: 110006, 110002, 120001, 211000, 210001, 210003, 210005, 350011, 830001, 830005.** The check script enforces the list. | The old numbers don't follow v2's bands (110006 and 350011 are parts, 830001 is a bought item), and reusing one would point to two different items (Reviewer finding). This changes D-22: v2 doesn't carry those old numbers over. | `conventions.md` section 6; master BOM; `check_control_pack.py` |
| D-29 | 2026-10-31 | **The fans sit inside the hollow front decor blocks**, with slots on the blocks' top faces (above eye level, like v1's roof grilles), lined channels and silencer boxes. No roof box; a back bulkhead is the fallback only. **Fan choice:** a 12 V EC fan if one gives 70 l/s at the channel pressure at 25 dB(A) or less; otherwise a mains EC duct fan (TD-350 class) with 0–10 V speed control from the sensor hub, on the outlet circuit. Performance beats the 12 V rule here (an exception to D-10). A fan can be serviced or swapped through its decor block. | It keeps the roof clean and the look unchanged, the decor blocks have the room, and fresh air at low noise comes first (ruled in the hardware group). | AIR, FRONT decor blocks, ELECTRICAL; BP-09; REQ-AIR-04, REQ-AIR-07, REQ-ELE-01, REQ-ELE-03; ISS-010, ISS-039, ISS-049. Fan choice and mains fallback replaced by D-51; D-58 moves the supply intake low, and the exhaust keeps the top slot. |
| D-30 | 2026-10-31 | **Door hinges: dormakaba OFFICE 11.233, with the 160 mm pocket inside the left decor block.** | Picked in the hardware selection for the door's weight (ruled in the hardware group). Its clamping range for 8.76 mm laminated glass goes on the factory's question list. | FRONT 360000, DL; REQ-BLD-05; ISS-002, ISS-045 |
| D-31 | 2026-10-31 | **Felt: test the factory's 9 mm PET felt in the wall sample first. Buy Autex Cube only if it falls short.** | Use what the factory has before buying in (ruled in the hardware group). | LINING; REQ-BLD-07; ISS-035 |
| D-32 | 2026-10-31 | **There are no human hardware leads on this project; the product owner confirmed it's all agents.** The PM decides and logs. The factory's wall-and-door sample is the physical check. Issues close on the PM's logged decision plus evidence, with nobody outside to wait on. | The calculation spread of about ±2.5 dB is exactly why the sample is built (ruled in the hardware group). | Every "who confirms" in `issue-register.csv`; `conventions.md` section 9; the v1 data questions |
| D-33 | 2026-10-31 | **Air: 53 l/s normal flow at 25 dB(A) or less inside (the published figure), and a 70 l/s boost at about 31 dB(A), started by the CO2 sensor or by hand. Splitter silencers sit inside the right and top decor blocks.** This replaces D-09's "70 l/s at 25 dB(A) or less". | 53 l/s holds the CO2 limit even in a 600 ppm office (about 796 ppm with 2 people, D-43), and the boost covers heat and crowded calls. The silencers fit inside the decor blocks without changing the outside. | REQ-AIR-02, REQ-AIR-03, REQ-AIR-05, REQ-AIR-07; AIR, FRONT DR and DT; ISS-070. PLAN.md carries these numbers since PR #13 (ISS-072, closed). Its 25 dB(A) is replaced by D-52 and its silencer place by D-51. |
| D-34 | 2026-10-31 | **Frames go to 20 × 40 × 1.2 aluminium and the PET fill to 25 kg/m³, if the rivnut grip and the fill's absorption check out. The pod is about 398–406 kg, carried as 400 ± 10 kg.** | It takes weight out of every panel while keeping the stack (sound and air check). The two conditions protect the M6 joints and the sound. | REQ-BLD-01, REQ-BLD-02, REQ-LGT-01; ISS-011, ISS-034. D-54: the frames stay 1.2 mm; the fill is 32 kg/m³ until the wall sample tests 25 kg/m³ next to it. D-79 names 6063-T6. The lighter grade is 24 kg/m³ (D-81). D-85: the wall panels' inner studs go to 1.0 mm; the perimeters and the ceiling's cross members stay 1.2 mm. |
| D-35 | 2026-10-31 | **The lining's inner steel tray goes to 0.4 mm.** It saves about 12.7 kg and puts the pod at about 403 kg, inside 400 ± 10 kg. If it costs more than 0.5 dB, it goes back to 0.5 mm with a 420 kg cap. | Weight comes off every lining cassette, and the revert rule protects the sound. | REQ-BLD-01, REQ-BLD-02, REQ-LGT-01, REQ-SND-03; LINING |
| D-36 | 2026-10-31 | **The silencers are separate parts that slide in through a felt-covered access panel inside the right and top decor blocks.** | They can be fitted and serviced from inside, and the outside doesn't change. | AIR, FRONT DR and DT; REQ-AIR-07; ISS-070. Replaced by D-51. |
| D-37 | 2026-10-31 | **The lining's inner steel tray stays at 0.5 mm, because 0.4 mm cost 1 dB.** Following D-35's rule, the cap is 420 kg; the pod is about 418 kg. | D-35 set the test: more than 0.5 dB lost means back to 0.5 mm with a 420 kg cap. The calculation showed 1 dB. | REQ-BLD-01, REQ-BLD-02, REQ-LGT-01, REQ-SND-03; LINING. Replaces D-35's 0.4 mm. Its 418 kg is replaced by D-54's estimate of about 427 kg; the 420 kg cap stands. D-131 raises the cap to 460 kg as shipped, provisional until the sample panel's recount. |
| D-38 | 2026-10-31 | **Splitter silencers: 37.5 mm linings in a cartridge 212 mm deep, holding 25 dB(A) or less at 53 l/s and about 31 dB(A) at 70 l/s.** | It meets D-33's noise figures inside the decor blocks. The absorption is interpolated, so the mock-up has to confirm it (ISS-073). | AIR, FRONT DR and DT; REQ-AIR-05, REQ-AIR-07; ISS-070, ISS-073. Replaced by D-51 and D-52. |
| D-39 | 2026-10-31 | **The decor block depth follows v1's geometry, 230–235 mm, not the build plan's 200 mm. The plan's 200 mm is superseded.** | It keeps the look exactly as v1 (D-01) and leaves room for the silencers. | FRONT DL, DR, DT; BP-25, BP-29; REQ-LOOK-01; `conventions.md` section 4 key planes; ISS-012. Replaced by D-49 (205 mm, measured from v1). |
| D-40 | 2026-10-31 | **The door gets an aluminium kick strip about 90 mm tall at the bottom, in the base band's dark finish, housing the drop seal, instead of taller glass.** | The thin floor leaves about 90 mm under the 2011 mm door. The kick strip fills it and keeps v1's unbroken dark base band across the front (D-01). | FRONT 360000; REQ-LOOK-03, REQ-BLD-08; the base band finish; ISS-003, ISS-022. 85 mm tall in the skeleton (D-57). Its finish is D-67's black anodising. |
| D-41 | 2026-10-31 | **Ceiling cables (light and sensors) run in the ceiling lining cassette's 25 mm gap, clipped to the cassette only (D-26). They come in at the back-wall top corner, and none cross the roof frame.** | It keeps the floating lining floating and needs no cable route through the roof frame. | ELECTRICAL, CEILING, LINING; REQ-VCK-03, REQ-ELE-05; IF-13; ISS-071 |
| D-42 | 2026-10-31 | **The ceiling uses the wall stack: 81 mm, with the floating cassette's 25 mm gap, at 12.6 kg/m² with D-34's frames and fill.** This replaces D-27's 53 mm ceiling now that the silencers sit in the decor blocks. With it, the current model gives 24.0 dB (21.5–26.5) at about 414 kg, or about 418 kg with Layout's clips. The inside is about 2301 mm tall, about 8 cm above v1's 2223, which corrects D-05's "about 10 cm". | It is the PM's decided build in the Hardware Engineer's report (PR #11), and it carries D-41's cable gap. | REQ-BLD-02, REQ-BLD-06, REQ-SND-01, REQ-LGT-01; CEILING; IF-13. Its 24.0 dB is replaced by D-53; its weight is replaced by D-54's estimate. Its 81 mm is replaced by D-66's 84 mm (the bond line counted). |
| D-43 | 2026-10-31 | **CO2 basis: 800 ppm or less with 2 people all day in an office whose own air is at 600 ppm.** So 53 l/s, the normal flow, is also the minimum while someone is inside. No manual control turns the fans below it, and the CO2 control overrides any turn-down to hold 800 ppm. | Offices often run well above outdoor air. Holding 800 ppm against 600 ppm room air needs about 52 l/s (calculation C2), which is why the normal flow is 53 l/s (D-33). The basis is in PLAN.md Target 4, merged by the PM in PR #13. | REQ-AIR-01, REQ-AIR-02, REQ-AIR-04; ISS-038 |
| D-44 | 2026-10-31 | **The CO2 sensor controls the air, against a design basis of 600 ppm office air. It holds 800 ppm or less and overrides any user turn-down. It never goes below 26 l/s while someone is inside, and it runs at boost whenever it can't hold 800.** One person stays quiet; two get the full 53 l/s. This replaces D-43's 53 l/s minimum; D-43's 600 ppm basis stands. | Most of the time a focus pod has one person in it. For one person, 26 l/s already holds 800 ppm in a 600 ppm office and is about 15 dB quieter. Two people need about 52 l/s (calculation C2). | REQ-AIR-02, REQ-AIR-03, REQ-AIR-04; C2; ISS-038, ISS-046. Heat added by D-50. |
| D-45 | 2026-10-31 | **Fan noise: 53 l/s at 25 dB(A) or less inside, and the boost at 30 dB(A) or less, aiming for 70 l/s.** This replaces the boost at about 31 dB(A) in D-33 and D-38. A 12 V fan is preferred if it meets both. | A ruling on PR #11; the numbers follow from the Hardware Engineer's fix. | REQ-AIR-02, REQ-AIR-05, REQ-AIR-07, REQ-ELE-01; ISS-039, ISS-073. Replaced by D-52. |
| D-46 | 2026-10-31 | **Door glass: 4+4 laminate of toughened, heat-soaked panes (8.76 mm). Hinges and lock must be rated for that glass, for 47.5 kg and for the 1176 mm width. The door hardware is on HOLD until a rated set is named.** This puts D-30's hinge choice on HOLD. | A ruling on PR #11: the hardware must be rated for the real glass and door, not assumed. | FRONT 360000; REQ-LOOK-04, REQ-BLD-05; ISS-002, ISS-045. The 47.5 kg is the whole door unit (D-56). Its 47.5 kg is replaced by D-68: a 50.2 kg door unit, with hardware rated for at least 60 kg. D-83 replaces the lock with a 35 N magnetic catch in DT. |
| D-47 | 2026-10-31 | **Lining cassettes hang on captive mechanical clips with a rated load. Ceiling cassettes also get a safety catch. Hook-and-loop is only for lining up.** | A ruling on PR #11: a cassette must stay put under load, and one over people's heads must not be able to drop. | LINING; REQ-ASM-10, REQ-ASM-11, BP-07; IF-10; ISS-015 |
| D-48 | 2026-10-31 | **The felt is picked by its published absorption data down to 100 Hz, and the wall sample is measured down to 100 Hz. Rivnut torque is on HOLD until a spin-out test in the real tube.** | A ruling on PR #11: low voices (125–250 Hz) limit a light pod, so the data must reach that low. A torque without a test in the real tube is a guess. | LINING, WALL; REQ-BLD-01, REQ-BLD-07; ISS-011, ISS-035 |
| D-49 | 2026-10-31 | **The decor blocks are 205 mm deep, as v1 measures: front face Y −850, back plate Y −645. The side walls are 1495 deep (Y −645 to +850): they start at the decor's back plate, meet it face to face and keep v1's side seam.** This replaces D-39's 230–235 mm; the build plan's 200 mm decor and 1500 mm wall stay superseded. | D-39 meant "as v1", and where v1's drawings and STEP disagree, the drawings win. v1's decor-frame drawing has core frames 191 mm deep (left) and 197 mm (right); with the ACP skin and back plate they make the shell in v1's STEP, front face Y −850 and back face Y −645: 205 mm (source). The 230–235 came from v1's BOM and doesn't match v1's geometry. v1's side wall is 1496 deep, Y −646 to 850 (source), so 1495 keeps its seam and removes skeleton P02's 5 mm overlap. PR #11's air design is sized to this section, 199 mm clear inside the two 3 mm faces. PM rulings on PR #16 (ruling 3) and PR #17 (pass C, ruling 1); skeleton P03 build record. | REQ-LOOK-01, BP-25, BP-29; FRONT DL, DR, DT; WALL; IF-07; `conventions.md` section 4 key planes; ISS-012, ISS-079; skeleton parameters `decor_d` 205 and `wall_depth` 1495. Replaces D-39. |
| D-50 | 2026-10-31 | **Heat drives the fans as well as CO2. The control holds the inside at most 4 K over the room, comparing a temperature sensor at the supply fan inlet with the one inside, and holds CO2 at 800 ppm or less against D-43's 600 ppm office air. It never goes below 26 l/s while someone is inside, and it runs at boost whenever it can't hold either limit.** This adds the 4 K limit to D-44; D-44's floor and override stand. | Heat is the users' top complaint (D-09). Staying within 4 K takes 27 l/s for one person, 48 l/s for two and 61 l/s for two with the voice-kit reserve (calculation, PR #11 report §7a), so the 26 l/s floor sits right at the heat limit, and CO2 alone could leave a warm pod running too slowly. The supply fan draws room air, so its inlet reads the room: an assumption until the fan sample shows the inlet within 0.5 K of the room at boost (D-58, ISS-078). PM ruling on PR #11. | REQ-AIR-02, REQ-AIR-03, REQ-AIR-06, REQ-ELE-04; C2, C4; AIR, ELECTRICAL; IF-14; ISS-038, ISS-046. Adds to D-44. |
| D-51 | 2026-10-31 | **Fans: four 12 V fans, two per path, in two boxed splitter cartridges side by side in the right decor block (DR). The supply grille sits low on DR's inner face and the exhaust grille high; the exhaust fans at the foot blow up a 150 mm steel riser to the slot on DR's top face, beside the supply slot. The fans run on the 12 V bus, driven by the sensor hub, so mains goes to the user outlets only.** This replaces the mains TD-500 fans of PR #11's earlier draft, D-29's fan choice and its mains fallback (the exception to D-10), D-33's and D-36's silencers in the right and top blocks, and D-38's 212 mm cartridge. D-29's fans in a decor block, with slots on its top face, stand. | The TD-500s (6 kg each) don't fit the 205 mm decor (D-49), and their casings radiate 44 dB(A), which put that design at 35.8 dB(A) at 53 l/s. D-10's 12 V check was argued at 42 Pa; the new paths need 12–17 Pa at 53 l/s with the riser, where a 12 V pair per path works. Four fans weigh about 1.2 kg against 12 kg for two TD-500s; the cartridges weigh 17.1 kg each with fill and the riser 9.6 kg, every part under 20 kg. The top block's face is too small for the flow. Each cartridge has two 40 mm passages between three 25 mm layers with published absorption data, in a 2 mm aluminium casing, 159 × 405 × 1800 mm, plus a 300 mm lined fan box (calculation and source, PR #11 report §7b and selection). PM rulings on PR #11 (12 V fans, exhaust high). | AIR, FRONT DR, ELECTRICAL; BP-09, BP-17, BP-28, BP-29; REQ-AIR-04, REQ-AIR-07, REQ-ELE-01, REQ-ELE-03; IF-11, IF-14; ISS-010, ISS-039, ISS-049, ISS-070, ISS-073. Replaces D-29's fan choice and mains fallback, D-33's and D-36's silencer place, and D-38. Its supply slot is replaced by D-58 and its service note by D-59. |
| D-52 | 2026-10-31 | **Fan noise inside: 26 dB(A) or less at 53 l/s (25.6 dB(A) calculated), and the boost at 30 dB(A) or less, which reaches 65 l/s (70 l/s would give 31.6 dB(A)).** This replaces D-45's 25 dB(A) at 53 l/s and its boost aim of 70 l/s. At the mixing effectiveness of 0.8 the PM set on PR #11, two people in a 600 ppm office need about 65 l/s to hold 800 ppm (845 ppm at 53 l/s), so two people often run near the boost; one person runs near 33 l/s. | The PM set 26 dB(A) when choosing exhaust high (D-51). The calculation includes the fans' own casing sound and the real 205 mm decor section (PR #11 report §7b). With 5.2 ml/s of CO2 per person (assumption) and 200 ppm of headroom, 0.0104 / (0.000200 × 0.8) = 65 l/s for two and 32.5 l/s for one (calculation C2; report §7a). | REQ-AIR-02, REQ-AIR-05; C2, C3, C4; AIR; ISS-046, ISS-073, ISS-077. Replaces D-45. |
| D-53 | 2026-10-31 | **Sound: the decided build calculates at about 19.3 dB (range 14.6–21.7) with the only published data for a 9 mm, 1.8 kg/m² felt, measured glued flat. About 24 dB is the best case, if the felt on its 25 mm gap absorbs as the earlier stand-in data suggest. The wall sample, measured down to 100 Hz, decides, and no weight goes back in until it's measured.** This replaces the 24.0 dB (21.5–26.5) in D-42 and the earlier headline. | D-48 asks for the felt's own published data, which replaces the Autex Cube 12 mm stand-in behind 24.0 dB. That data is for felt glued flat, which absorbs far less at 125–500 Hz than felt on a 25 mm gap, and nothing is published for a gap, so 19.3 is on the safe side. The low end also carries the 125–250 Hz risks: no finite-panel gain, and a 4 dB dip at each double wall's resonance. It's still quieter than v1 as built, about 15 dB (calculation, PR #11 report, results 3 and 4; PLAN.md since PR #18). | REQ-SND-01, REQ-SND-03, REQ-BLD-07; WALL, CEILING, LINING; ISS-063, ISS-065. Replaces D-42's 24.0 dB. |
| D-54 | 2026-10-31 | **Weight: the cap stays at 420 kg (D-37). The current estimate is about 427 kg, from the layout study's own parts list with the 32 kg/m³ fill and the fan cartridges, and it stays open against the cap (ISS-080). The wall sample settles it: weigh a real cassette with its clips, rails and bond lines, and test the 25 kg/m³ fill next to the 32 kg/m³; if the lighter fill matches on sound, the pod switches to it, saving 4.3 kg.** The frames stay 20 × 40 × 1.2, because the rivnut grip check passed, which settles D-34's frame condition; D-34's fill condition moves to the wall sample. | PR #11's 418 kg (calculation, report result 3) was added onto an older copy of the layout study's list; the study's own list, recounted by the Layout Engineer, comes to about 427 kg (calculation, not yet in a merged file). Only a real cassette shows what its clips, rails and bond lines weigh, and the 25 kg/m³ fill has no published absorption data, so the sample measures it (PR #11 report section 1; selection summary). PM ruling of 2026-10-31. | REQ-LGT-01, REQ-LGT-04, REQ-SND-03, REQ-BLD-01, REQ-BLD-02; C6; WALL, CEILING, LINING; ISS-034, ISS-063, ISS-080. Settles D-34's frame condition. Its 427 kg estimate is replaced by D-71's about 429 kg. D-81 makes 25 kg/m³ the default, with T02 confirming it. The lighter grade is 24 kg/m³, not 25 (D-81). |
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
