autonomous-ai/spaceship/v2/00-Control/release-checklist.md

# Release checklist: Spaceship (FocusPod v2)

| Doc code | Revision | Status | Date | Owner |
|---|---|---|---|---|
| V2-CTL-009 | P01 | DRAFT, written by `build_release_checklist.py` | 2026-11-01 | Control pack |

What stands between the design and a manufacturing release, part by part. Nothing here is released (guideline milestone 4, REQ-DOC-02). Re-run it whenever parts merge.
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
