autonomous-ai/spaceship/v2/01-CAD-Native/front/350001_P01_FRONT-DECOR-BLOCK-ASSY-DL-ISO_IMG.png

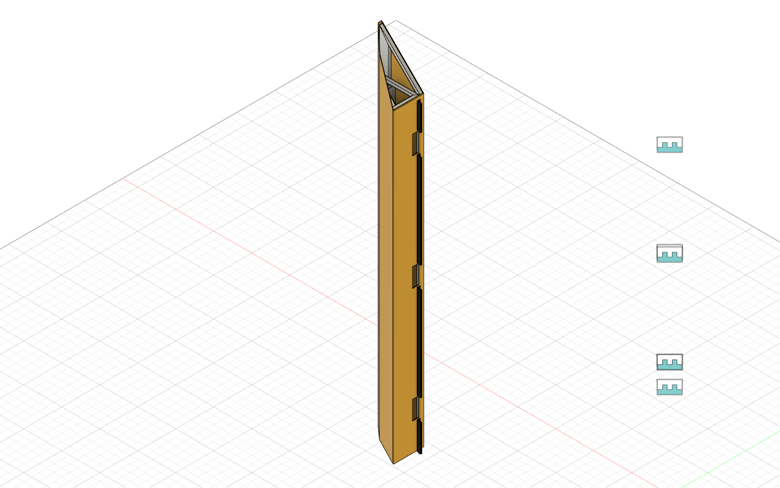
v2/01-CAD-Native/front/350001_P01_FRONT-DECOR-BLOCK-ASSY-DL-ISO_IMG.png
