autonomous-ai/spaceship/v2/01-CAD-Native/front/350002_P01_FRONT-DECOR-BLOCK-ASSY-DT-FRONT_IMG.png

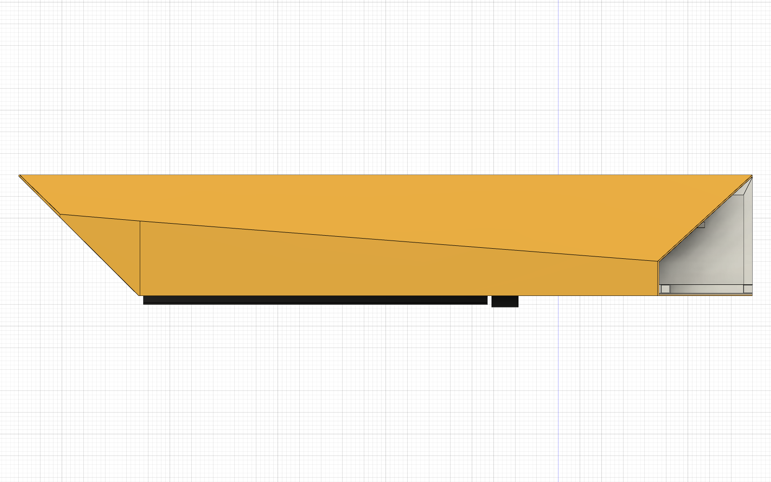
v2/01-CAD-Native/front/350002_P01_FRONT-DECOR-BLOCK-ASSY-DT-FRONT_IMG.png
