autonomous-ai/spaceship/v2/01-CAD-Native/front/350003_P01_FRONT-DECOR-BLOCK-ASSY-DR-FRONT_IMG.png

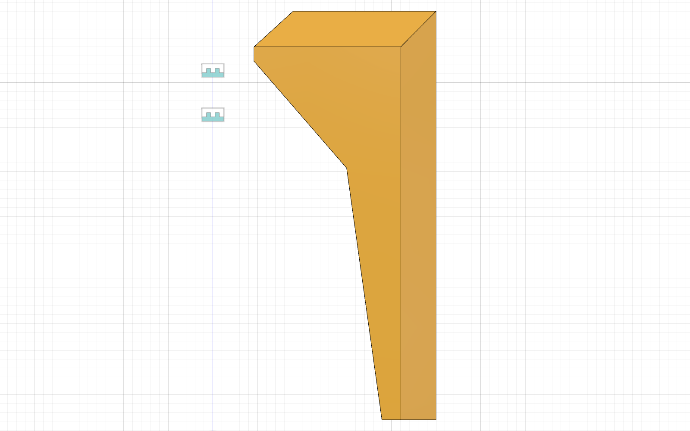
v2/01-CAD-Native/front/350003_P01_FRONT-DECOR-BLOCK-ASSY-DR-FRONT_IMG.png
