autonomous-ai/spaceship/v2/01-CAD-Native/front/360001_P01_FRONT-DOOR-UNIT-FRONT_IMG.png

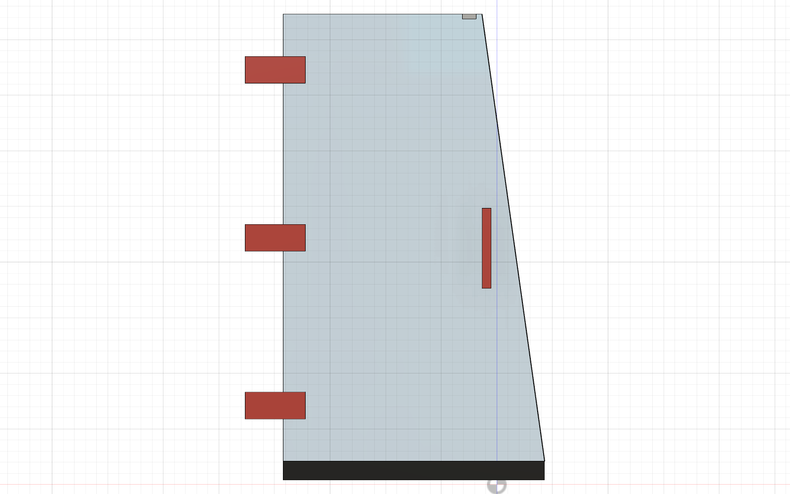
v2/01-CAD-Native/front/360001_P01_FRONT-DOOR-UNIT-FRONT_IMG.png
