autonomous-ai/spaceship/v2/01-CAD-Native/front/360002_P01_FRONT-FIXED-GLASS-UNIT-FRONT_IMG.png

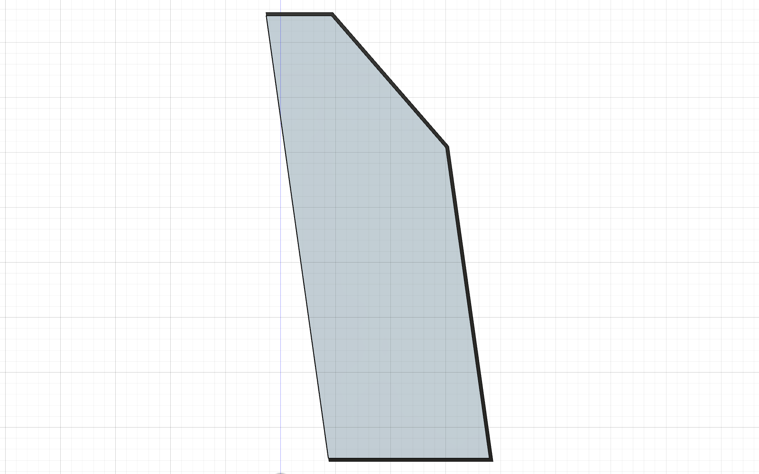
v2/01-CAD-Native/front/360002_P01_FRONT-FIXED-GLASS-UNIT-FRONT_IMG.png
