autonomous-ai/spaceship/v2/01-CAD-Native/skeleton/100000_P04_POD-SKELETON-BACK-TOP_IMG.png

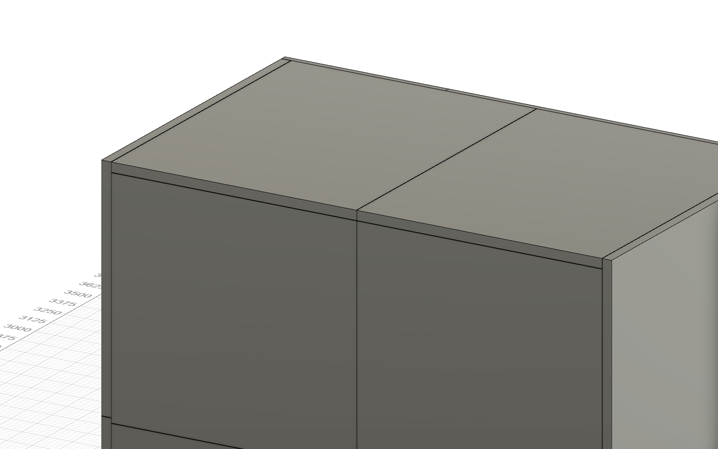
v2/01-CAD-Native/skeleton/100000_P04_POD-SKELETON-BACK-TOP_IMG.png
