autonomous-ai/spaceship/v2/02-Drawings/joints/111211_P01_BASE-CORNER-KEY-TABULATED_DWG-render.png

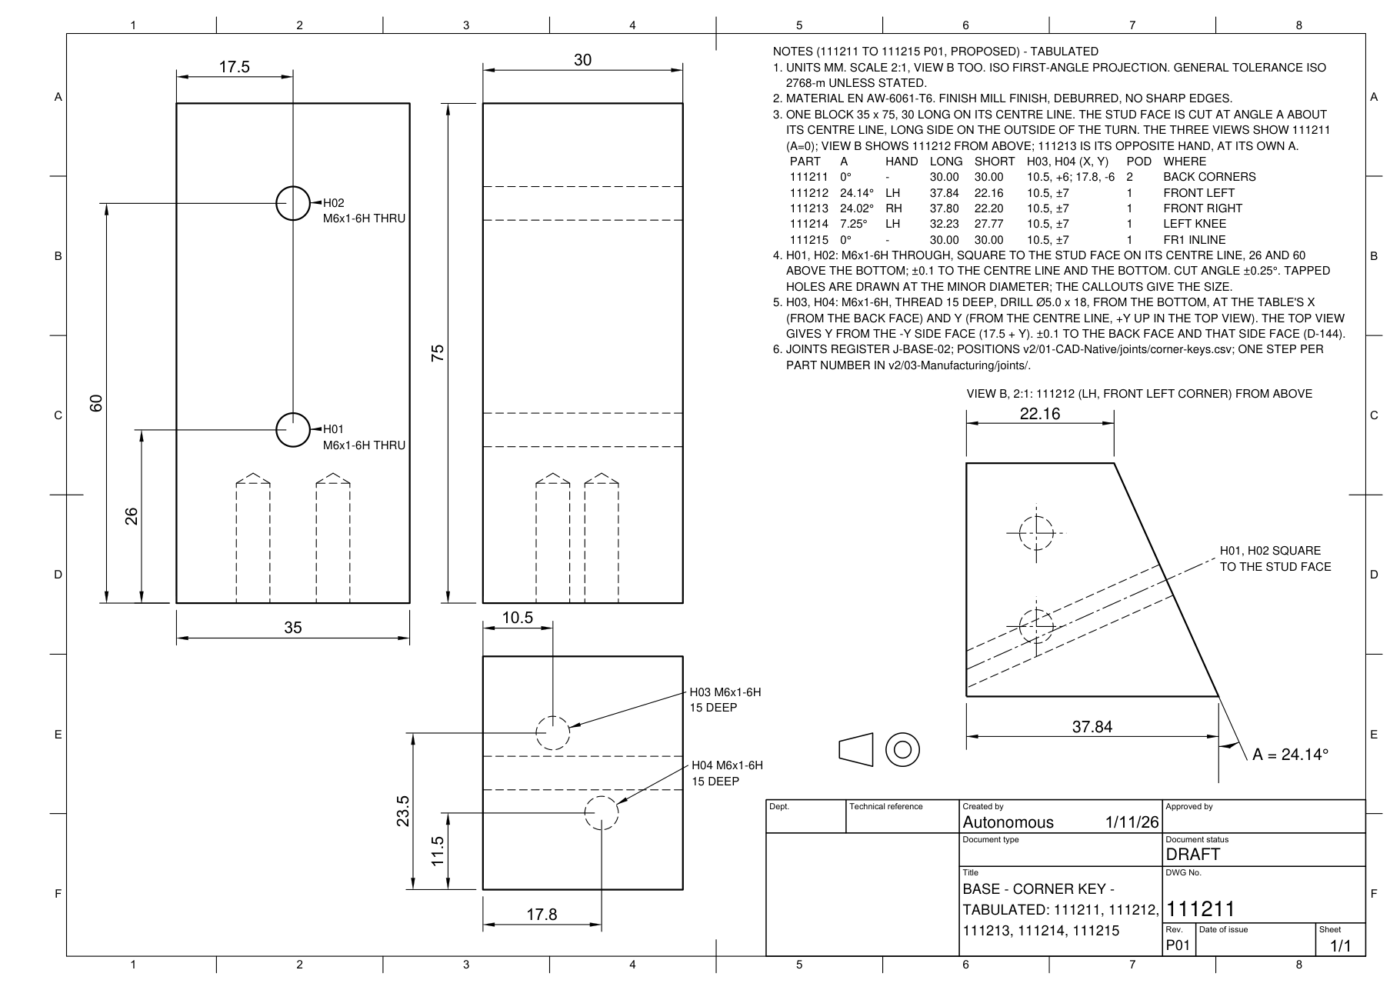
v2/02-Drawings/joints/111211_P01_BASE-CORNER-KEY-TABULATED_DWG-render.png
