autonomous-ai/spaceship/v2/02-Drawings/joints/831001_P01_HARDWARE-LOCATING-SPIGOT_DWG-render.png

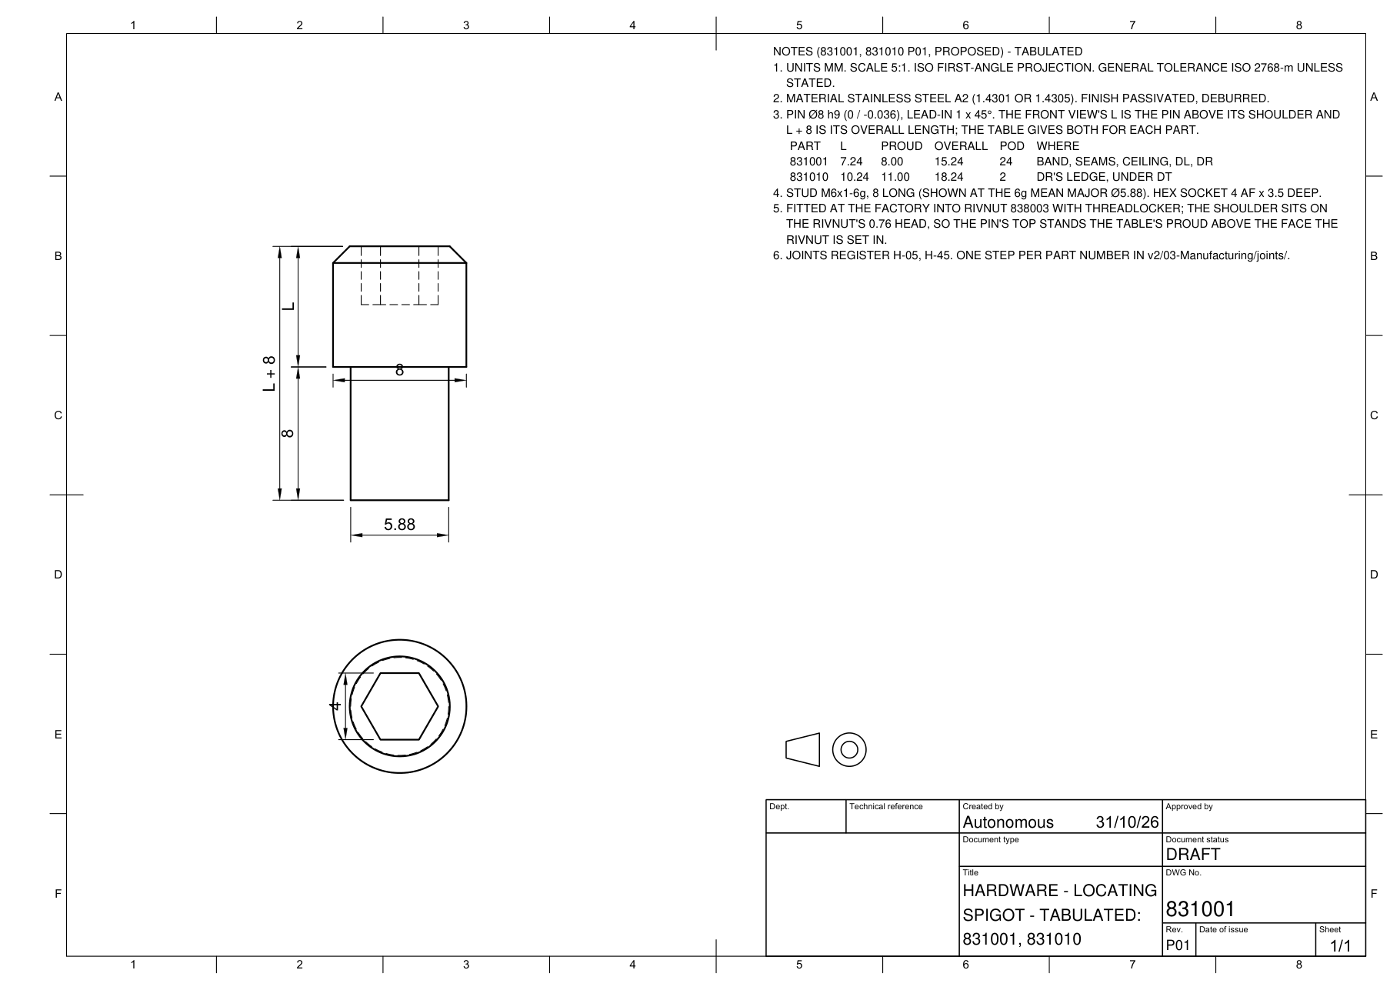
v2/02-Drawings/joints/831001_P01_HARDWARE-LOCATING-SPIGOT_DWG-render.png
