autonomous-ai/spaceship/v2/02-Drawings/proof/V2-SWL-00_P01_WALL-PANEL-ASSY-SIDE-LOWER-LH_DWG-render.png

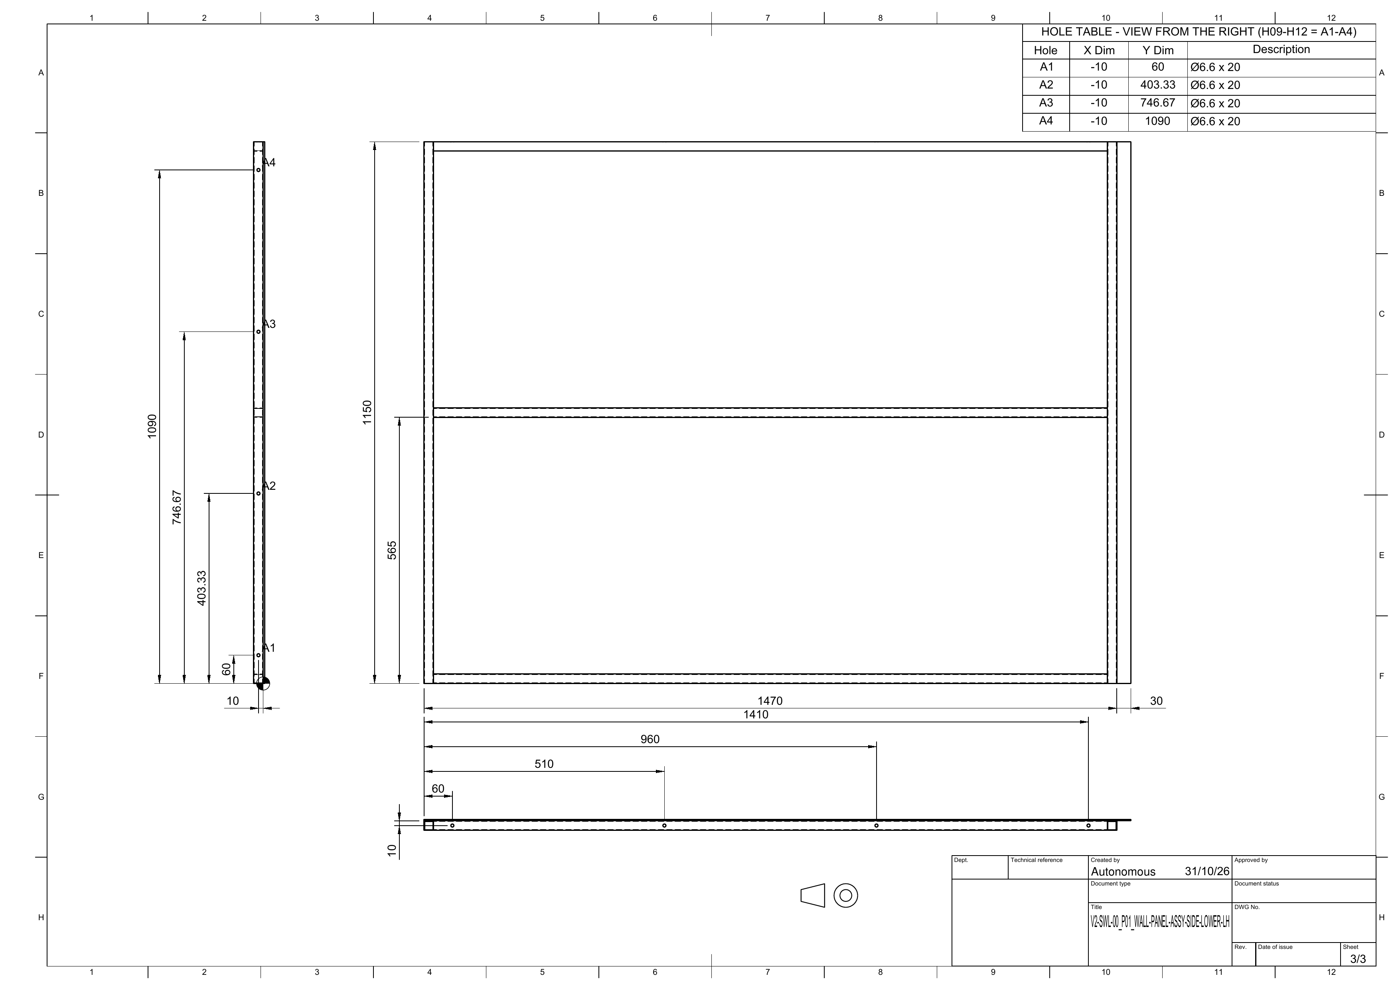
v2/02-Drawings/proof/V2-SWL-00_P01_WALL-PANEL-ASSY-SIDE-LOWER-LH_DWG-render.png
