autonomous-ai/spaceship/v2/04-BOM/BOM-CHECK.md

# Master BOM check: Spaceship (FocusPod v2)

| Doc code | Revision | Status | Date | Owner |
|---|---|---|---|---|
| V2-BOM-002 | P01 | DRAFT, written by `build_master_bom.py` | 2026-10-31 | Control pack |

Read from: this working tree.

**Result: OK.** 0 failure(s) on the five rules; 384 part lines (185 made, 199 bought, 151 on HOLD) and 52 sub-assembly lines from 20 parts list(s); 49 hardware items in the joints register (47 with a part number). Listed parts weigh 366.1 kg per pod (calculation: quantity x mass each; assemblies with no list count 0, so this is not the pod's weight).

## Files read

- `v2/03-Manufacturing/air/610000_P01_AIR-PARTS-LIST_BOM.csv` @ working tree
- `v2/03-Manufacturing/base/110000_P01_BASE_BOM.csv` @ working tree
- `v2/03-Manufacturing/ceiling/410000_P01_CEILING-PARTS-LIST_BOM.csv` @ working tree
- `v2/03-Manufacturing/ceiling/410000_P01_CEILING-TUBE-CUT-LIST_BOM.csv` @ working tree (skipped: a cut list (its rows are cut pieces of the parts in the parts lists))
- `v2/03-Manufacturing/electrical/710000_P01_ELECTRICAL-PARTS-LIST_BOM.csv` @ working tree
- `v2/03-Manufacturing/front/350001_P01_FRONT-DECOR-BLOCK-ASSY-DL_BOM.csv` @ working tree
- `v2/03-Manufacturing/front/350002_P01_FRONT-DECOR-BLOCK-ASSY-DT_BOM.csv` @ working tree
- `v2/03-Manufacturing/front/350003_P01_FRONT-DECOR-BLOCK-ASSY-DR_BOM.csv` @ working tree
- `v2/03-Manufacturing/front/351104_P01_FRONT-DECOR-FRAME-DL_BOM.csv` @ working tree
- `v2/03-Manufacturing/front/351204_P01_FRONT-DECOR-FRAME-DT_BOM.csv` @ working tree
- `v2/03-Manufacturing/front/351306_P01_FRONT-DECOR-FRAME-DR_BOM.csv` @ working tree
- `v2/03-Manufacturing/front/360001_P01_FRONT-DOOR-UNIT_BOM.csv` @ working tree
- `v2/03-Manufacturing/front/360002_P01_FRONT-FIXED-GLASS-UNIT_BOM.csv` @ working tree
- `v2/03-Manufacturing/interior/810000_P01_INTERIOR-PARTS-LIST_BOM.csv` @ working tree
- `v2/03-Manufacturing/wall/210101_P01_WALL-PANEL-ASSY-SIDE-LOWER-LH_BOM.csv` @ working tree
- `v2/03-Manufacturing/wall/210102_P01_WALL-PANEL-ASSY-SIDE-LOWER-RH_BOM.csv` @ working tree
- `v2/03-Manufacturing/wall/210103_P01_WALL-PANEL-ASSY-SIDE-UPPER-LH_BOM.csv` @ working tree
- `v2/03-Manufacturing/wall/210104_P01_WALL-PANEL-ASSY-SIDE-UPPER-RH_BOM.csv` @ working tree
- `v2/03-Manufacturing/wall/210201_P01_WALL-PANEL-ASSY-BACK-LOWER-B1_BOM.csv` @ working tree
- `v2/03-Manufacturing/wall/210202_P01_WALL-PANEL-ASSY-BACK-LOWER-B2_BOM.csv` @ working tree
- `v2/04-BOM/number-allocation.csv` @ working tree
- `v2/05-Engineering/joints/joints-register.md` @ working tree
- `v2/07-Packaging/910000_P01_PACKING-LIST_BOM.csv` @ working tree

## Failures

- none

## Missing or on HOLD, per team

**BASE**
- 118002 BASE - LEVELLING GLIDE - M10 - HOLD: HOLD (HOLD)
- 118003 BASE - TUBE END CAP - 100 X 40 - BLACK - HOLD: HOLD (HOLD)
- 838003: the list still names it 'HARDWARE - RIVET NUT - M6 - STEEL ZINC - SHEREX CAH2-610-4.2'; the joints register's H-03 now names it 'HARDWARE - RIVET NUT - M6 - STEEL ZINC - SHEREX CAL2-610-4.2', which the master BOM uses (D-99): change the list's name, and its material, finish and mass to match the register
- 838006: the list still names it 'HARDWARE - RIVET NUT - M10 - FOR THE LEVELLING GLIDE - HOLD'; the joints register's H-26 now names it 'HARDWARE - RIVET NUT - M10 - STEEL ZINC - SHEREX CAL2-1015-7.9', which the master BOM uses (D-99): change the list's name, and its material, finish and mass to match the register
- 838006 HARDWARE - RIVET NUT - M10 - STEEL ZINC - SHEREX CAL2-1015-7.9: HOLD (HOLD)
- 118001 BASE - BASE SEAL - LIP - ROOM FLOOR - HOLD: HOLD (HOLD)
- 118002 BASE - LEVELLING GLIDE - M10 - HOLD: HOLD (HOLD)
- 118003 BASE - TUBE END CAP - 100 X 40 - BLACK - HOLD: HOLD (HOLD)
- 838006 HARDWARE - RIVET NUT - M10 - STEEL ZINC - SHEREX CAL2-1015-7.9: HOLD (HOLD)
- 118001 BASE - BASE SEAL - LIP - ROOM FLOOR - HOLD: HOLD (HOLD)
- 118002 BASE - LEVELLING GLIDE - M10 - HOLD: HOLD (HOLD)
- 838006 HARDWARE - RIVET NUT - M10 - STEEL ZINC - SHEREX CAL2-1015-7.9: HOLD (HOLD)
- 118001 BASE - BASE SEAL - LIP - ROOM FLOOR - HOLD: HOLD (HOLD)
- 118002 BASE - LEVELLING GLIDE - M10 - HOLD: HOLD (HOLD)
- 118003 BASE - TUBE END CAP - 100 X 40 - BLACK - HOLD: HOLD (HOLD)
- 838006 HARDWARE - RIVET NUT - M10 - STEEL ZINC - SHEREX CAL2-1015-7.9: HOLD (HOLD)
- 838008 HARDWARE - RIVET NUT - M3 - COUNTERSUNK HEAD - HOLD: HOLD (HOLD)
- 118001 BASE - BASE SEAL - LIP - ROOM FLOOR - HOLD: HOLD (HOLD)

**WALL**
- 108002: the list still names it 'POD - ACP BOND SET - SIKATACK PANEL-50 WITH AKTIVATOR-205, PANEL PRIMER, FIXING TAPE'; the joints register's H-12 now names it 'POD - ACP BOND SET - SIKAFLEX-252 WITH AKTIVATOR-205, PRIMER-210, FIXING TAPE', which the master BOM uses (D-99): change the list's name, and its material, finish and mass to match the register
- 838003: the list still names it 'HARDWARE - RIVET NUT - M6 - SHEREX CAH3-610-4.2'; the joints register's H-03 now names it 'HARDWARE - RIVET NUT - M6 - STEEL ZINC - SHEREX CAL2-610-4.2', which the master BOM uses (D-99): change the list's name, and its material, finish and mass to match the register
- 838001 HARDWARE - SOCKET HEAD BOLT - M6 X 16 - ISO 4762 8.8 ZINC: HOLD (HOLD)
- 838004 HARDWARE - WASHER - M6 LARGE - ISO 7093-1 6.4 X 18 A2: HOLD (HOLD)
- 838005 HARDWARE - CAPTIVE RETAINER - M6 HEAD - GROMMET FOR 19 HOLE: HOLD (HOLD)
- 518001 LINING - CASSETTE CLIP: HOLD (HOLD)
- 848012 SEALS - CASSETTE EDGE SEAL - 10 X 2.0 TO 2.2 - VERY SOFT FOAM OR FIN: HOLD (HOLD)
- 838001 HARDWARE - SOCKET HEAD BOLT - M6 X 16 - ISO 4762 8.8 ZINC: HOLD (HOLD)
- 838004 HARDWARE - WASHER - M6 LARGE - ISO 7093-1 6.4 X 18 A2: HOLD (HOLD)
- 838005 HARDWARE - CAPTIVE RETAINER - M6 HEAD - GROMMET FOR 19 HOLE: HOLD (HOLD)
- 518001 LINING - CASSETTE CLIP: HOLD (HOLD)
- 848012 SEALS - CASSETTE EDGE SEAL - 10 X 2.0 TO 2.2 - VERY SOFT FOAM OR FIN: HOLD (HOLD)
- 838001 HARDWARE - SOCKET HEAD BOLT - M6 X 16 - ISO 4762 8.8 ZINC: HOLD (HOLD)
- 838004 HARDWARE - WASHER - M6 LARGE - ISO 7093-1 6.4 X 18 A2: HOLD (HOLD)
- 838005 HARDWARE - CAPTIVE RETAINER - M6 HEAD - GROMMET FOR 19 HOLE: HOLD (HOLD)
- 518001 LINING - CASSETTE CLIP: HOLD (HOLD)
- 838001 HARDWARE - SOCKET HEAD BOLT - M6 X 16 - ISO 4762 8.8 ZINC: HOLD (HOLD)
- 838004 HARDWARE - WASHER - M6 LARGE - ISO 7093-1 6.4 X 18 A2: HOLD (HOLD)
- 838005 HARDWARE - CAPTIVE RETAINER - M6 HEAD - GROMMET FOR 19 HOLE: HOLD (HOLD)
- 518001 LINING - CASSETTE CLIP: HOLD (HOLD)
- 838001 HARDWARE - SOCKET HEAD BOLT - M6 X 16 - ISO 4762 8.8 ZINC: HOLD (HOLD)
- 838004 HARDWARE - WASHER - M6 LARGE - ISO 7093-1 6.4 X 18 A2: HOLD (HOLD)
- 838005 HARDWARE - CAPTIVE RETAINER - M6 HEAD - GROMMET FOR 19 HOLE: HOLD (HOLD)
- 518001 LINING - CASSETTE CLIP: HOLD (HOLD)
- 848012 SEALS - CASSETTE EDGE SEAL - 10 X 2.0 TO 2.2 - VERY SOFT FOAM OR FIN: HOLD (HOLD)
- 838001 HARDWARE - SOCKET HEAD BOLT - M6 X 16 - ISO 4762 8.8 ZINC: HOLD (HOLD)
- 838002 HARDWARE - SOCKET HEAD BOLT - M6 X 25 - ISO 4762 8.8 ZINC: HOLD (HOLD)
- 838004 HARDWARE - WASHER - M6 LARGE - ISO 7093-1 6.4 X 18 A2: HOLD (HOLD)
- 838005 HARDWARE - CAPTIVE RETAINER - M6 HEAD - GROMMET FOR 19 HOLE: HOLD (HOLD)
- 848004 SEALS - CLOSING SEAM BULB SEAL - GAP 4 TO 7 - EPDM OR TPE: HOLD (HOLD)
- 518001 LINING - CASSETTE CLIP: HOLD (HOLD)
- 848012 SEALS - CASSETTE EDGE SEAL - 10 X 2.0 TO 2.2 - VERY SOFT FOAM OR FIN: HOLD (HOLD)

**FRONT**
- 351304 FRONT - DECOR INNER PANEL FELT - DR: HOLD (DRAFT; emission certificate HOLD)
- 848013 SEALS - ACCESS PANEL SEAL - 4.0 THICK - VERY SOFT FOAM PSA: HOLD (HOLD: product (HOLD-19))
- 361001 FRONT - DOOR LEAF - 4+4 LAMINATED: HOLD (DRAFT; product HOLD (ISS-074))
- 368001 FRONT - DROP SEAL - ATHMER SCHALL-EX GSA 1-1112: HOLD (source (product); bond to aluminium HOLD)
- 368101 FRONT - DOOR HINGE - HOLD: HOLD (HOLD (D-46, ISS-002))
- 368102 FRONT - DOOR STRIKE: HOLD (source (product); on the 8.76 laminate with a 1.2 mm shim: HOLD)
- 368006 FRONT - 180 MAGNETIC SEAL - HALF 2 OF 2 - HOLD: HOLD (HOLD: product for the 8.76 laminate and a 4 mm gap)
- 368103 FRONT - DOOR PULL PAIR - HOLD: HOLD (HOLD)
- 361003 FRONT - FIXED GLASS - 4+4 LAMINATED: HOLD (DRAFT; product HOLD (ISS-074))
- 368003 FRONT - 180 MAGNETIC SEAL - HALF 1 OF 2 - HOLD: HOLD (HOLD: product for the 8.76 laminate and a 4 mm gap)

**CEILING**
- 518001 LINING - CASSETTE CLIP: HOLD (HOLD)
- 518002: the list still names it 'LINING - CEILING SAFETY CATCH'; the joints register's H-11 now names it 'LINING - CEILING SAFETY CATCH - GRIPPLE LOOP NO.3', which the master BOM uses (D-99): change the list's name, and its material, finish and mass to match the register
- 518002 LINING - CEILING SAFETY CATCH - GRIPPLE LOOP NO.3: HOLD (HOLD)
- 838005 HARDWARE - CAPTIVE RETAINER - M6 HEAD - GROMMET FOR 19 HOLE: HOLD (HOLD)
- 838005 HARDWARE - CAPTIVE RETAINER - M6 HEAD - GROMMET FOR 19 HOLE: HOLD (HOLD)
- 848004 SEALS - CLOSING SEAM BULB SEAL - GAP 4 TO 7 - EPDM OR TPE: HOLD (HOLD)

**CEILING (builds AIR, D-80)**
- 618105 AIR - SOFFIT UNDERSIDE HINGE - HOLD: HOLD (HOLD)
- 618106 AIR - SOFFIT UNDERSIDE LATCH - HOLD: HOLD (HOLD)
- 618401 AIR - FAN - NOCTUA NF-A14 INDUSTRIALPPC-3000 PWM: HOLD (HOLD)
- 618401 AIR - FAN - NOCTUA NF-A14 INDUSTRIALPPC-3000 PWM: HOLD (HOLD)
- 618102 AIR - SUPPLY TRANSITION - HOLD: HOLD (HOLD)
- 618103 AIR - RISER TRANSITION - HOLD: HOLD (HOLD)
- 618402 AIR - FAN BOX PAD - SUPPLY - RUBBER 40 X 15 X 5 - HOLD: HOLD (HOLD)
- 618501 AIR - RISER BUFFER - RUBBER - M6 - HOLD: HOLD (HOLD)

**CEILING (builds INTERIOR, D-80)**
- 818101 INTERIOR - LEDGE BRACKET - HOLD: HOLD (HOLD)
- 818102 INTERIOR - SCREEN RAIL - HOLD: HOLD (HOLD)

**ELECTRICAL**
- 711001 ELECTRICAL - POWER UNIT - ENCLOSURE BODY: HOLD (DRAFT; HOLD features: the fixing to B2's frame (WALL, IF-12) and the earth stud hole (PEM data))
- 711002 ELECTRICAL - POWER UNIT - FRONT PLATE: HOLD (DRAFT; HOLD features: the GFCI receptacle's decorator opening and the two keystone openings, set by the picked parts' drawings (D-133))
- 718001 ELECTRICAL - 12 V SUPPLY - 60 W CLASS 2: HOLD (HOLD (bought part: no order, no supplier contact; guideline 4.3))
- 718081 ELECTRICAL - 24 V SUPPLY - 60 W CLASS 2: HOLD (HOLD (bought part: no order, no supplier contact; guideline 4.3))
- 718082 ELECTRICAL - 24 V SUPPLY - 96 W CLASS 2 - VOICE KIT: metal part with no finish (D-79: hidden tubes 6063-T6 mill finish plus the bond prep; visible aluminium black AA20, D-67)
- 718082 ELECTRICAL - 24 V SUPPLY - 96 W CLASS 2 - VOICE KIT: HOLD (HOLD (bought part: no order, no supplier contact; guideline 4.3))
- 718002 ELECTRICAL - LED CONTROLLER - 24 V PWM - DMX512 - ISOLATED INPUT: HOLD (HOLD (bought part: no order, no supplier contact; guideline 4.3))
- 718003 ELECTRICAL - CIRCUIT BREAKER - 1P 15 A C - UL 489: HOLD (HOLD (bought part: no order, no supplier contact; guideline 4.3))
- 718004 ELECTRICAL - APPLIANCE INLET - POWERCON TRUE1 TOP: HOLD (HOLD (bought part: no order, no supplier contact; guideline 4.3))
- 718005 ELECTRICAL - INLET SEALING CAP: HOLD (HOLD (bought part: no order, no supplier contact; guideline 4.3))
- 718006 ELECTRICAL - LAN FEED-THROUGH - ETHERCON: HOLD (HOLD (bought part: no order, no supplier contact; guideline 4.3))
- 718007 ELECTRICAL - RECEPTACLE - GFCI TR DUPLEX 15 A - NEMA 5-15R: HOLD (HOLD (bought part: no order, no supplier contact; guideline 4.3))
- 718010 ELECTRICAL - DIN RAIL - TS35 X 7.5 - 100 MM: HOLD (HOLD (bought part: no order, no supplier contact; guideline 4.3))
- 718011 ELECTRICAL - FUSE HOLDER - ATO BLADE - INLINE: HOLD (HOLD (bought part: no order, no supplier contact; guideline 4.3))
- 718012 ELECTRICAL - FUSE - ATO 5 A 32 V: HOLD (HOLD (bought part: no order, no supplier contact; guideline 4.3))
- 718013 ELECTRICAL - FUSE - ATO 5 A 32 V - LIGHTS: HOLD (HOLD (bought part: no order, no supplier contact; guideline 4.3))
- 718019 ELECTRICAL - SCREW - M4 X 8 - ISO 7045 A2 PAN HEAD: HOLD (HOLD (bought part: no order, no supplier contact; guideline 4.3))
- 718049 ELECTRICAL - SPACER - M4 X 2 MM - NYLON, BLACK: HOLD (HOLD (bought part: no order, no supplier contact; guideline 4.3))
- 718054 ELECTRICAL - SCREW - 6-32 X 1/2 - OVAL HEAD, BLACK: HOLD (HOLD (bought part: no order, no supplier contact; guideline 4.3))
- 718047 ELECTRICAL - CLINCH NUT - M4 - FOR 1.0 MM ALUMINIUM: HOLD (HOLD (bought part: no order, no supplier contact; guideline 4.3))
- 718014 ELECTRICAL - EARTH STUD - M5 SELF-CLINCHING: HOLD (HOLD (bought part: no order, no supplier contact; guideline 4.3))
- 718015 ELECTRICAL - BONDING WASHER - SERRATED M6 A2: HOLD (HOLD (bought part: no order, no supplier contact; guideline 4.3))
- 718016 ELECTRICAL - RING TERMINAL - INSULATED 16-14 AWG: HOLD (HOLD (bought part: no order, no supplier contact; guideline 4.3))
- 718017 ELECTRICAL - CONDUIT - FLEXIBLE NONMETALLIC 1/2 IN: HOLD (HOLD (bought part: no order, no supplier contact; guideline 4.3))
- 838001 HARDWARE - SOCKET HEAD BOLT - M6 X 16 - ISO 4762 8.8 ZINC: HOLD (HOLD (bought part: no order, no supplier contact; guideline 4.3))
- 838004 HARDWARE - WASHER - M6 LARGE - ISO 7093-1 6.4 X 18 A2: HOLD (HOLD (bought part: no order, no supplier contact; guideline 4.3))
- 838003: the list still names it 'HARDWARE - RIVET NUT - M6 - SHEREX CAH3-610-4.2'; the joints register's H-03 now names it 'HARDWARE - RIVET NUT - M6 - STEEL ZINC - SHEREX CAL2-610-4.2', which the master BOM uses (D-99): change the list's name, and its material, finish and mass to match the register
- 838003 HARDWARE - RIVET NUT - M6 - STEEL ZINC - SHEREX CAL2-610-4.2: HOLD (HOLD (bought part: no order, no supplier contact; guideline 4.3))
- 718020 ELECTRICAL - WIRE - UL 1015 14 AWG (BLACK, WHITE, GREEN): HOLD (HOLD (bought part: no order, no supplier contact; guideline 4.3))
- 718021 ELECTRICAL - WIRE - UL 1015 14 AWG (BLACK, WHITE): HOLD (HOLD (bought part: no order, no supplier contact; guideline 4.3))
- 718022 ELECTRICAL - WIRE - UL 1015 14 AWG GREEN: HOLD (HOLD (bought part: no order, no supplier contact; guideline 4.3))
- 718073 ELECTRICAL - CURRENT SENSE MODULE - 24 V 0-5 A: HOLD (HOLD (bought part: no order, no supplier contact; guideline 4.3))
- 718026 ELECTRICAL - CABLE - 4 X 20 AWG: HOLD (HOLD (bought part: no order, no supplier contact; guideline 4.3))
- 718027 ELECTRICAL - CABLE - 4 X 24 AWG SCREENED: HOLD (HOLD (bought part: no order, no supplier contact; guideline 4.3))
- 718051 ELECTRICAL - LED STRIP - 24 V 3.0 W/M - 3000 K - 8 MM: HOLD (HOLD (bought part: no order, no supplier contact; guideline 4.3))
- 718052 ELECTRICAL - CALL LIGHT PROFILE AND DIFFUSER - 0.9 M: HOLD (HOLD (bought part: no order, no supplier contact; guideline 4.3))
- 718044 ELECTRICAL - DRAW CORD - NYLON 3 MM: HOLD (HOLD (bought part: no order, no supplier contact; guideline 4.3))
- 718048 ELECTRICAL - SCREW - M4 X 12 - ISO 7045 A2 PAN HEAD, BLACK: HOLD (HOLD (bought part: no order, no supplier contact; guideline 4.3))
- 718060 ELECTRICAL - SENSOR HUB - DESK PRO AI (IN-HOUSE): HOLD (HOLD (in-house module: interface data ISS-060))
- 711005 ELECTRICAL - HUB ZONE COVER PLATE: HOLD (DRAFT; HOLD features: the hub window, button and knob holes (ISS-060) and the fixing holes (CEILING's column))
- 718061 ELECTRICAL - PUSH BUTTON - MOMENTARY - BOOST: HOLD (HOLD (bought part: no order, no supplier contact; guideline 4.3))
- 718062 ELECTRICAL - PUSH BUTTON - MOMENTARY - CALL: HOLD (HOLD (bought part: no order, no supplier contact; guideline 4.3))
- 718063 ELECTRICAL - LIGHT KNOB - POTENTIOMETER WITH KNOB: HOLD (HOLD (bought part: no order, no supplier contact; guideline 4.3))
- 718069 ELECTRICAL - PUSH BUTTON - MOMENTARY - SELF-TEST: HOLD (HOLD (bought part: no order, no supplier contact; guideline 4.3))
- 718064 ELECTRICAL - FUSE HOLDER - ATO BLADE - INLINE - COLUMN: HOLD (HOLD (bought part: no order, no supplier contact; guideline 4.3))
- 718065 ELECTRICAL - INLET TEMPERATURE SENSOR: HOLD (HOLD (bought part: no order, no supplier contact; guideline 4.3))
- 718066 ELECTRICAL - FUSE - ATO 2 A 32 V: HOLD (HOLD (bought part: no order, no supplier contact; guideline 4.3))
- 718067 ELECTRICAL - FUSE - ATO 1 A 32 V: HOLD (HOLD (bought part: no order, no supplier contact; guideline 4.3))
- 718068 ELECTRICAL - FAN Y-CABLE - 4-PIN PWM: HOLD (HOLD (bought part: no order, no supplier contact; guideline 4.3))
- 718070 ELECTRICAL - CORD CONNECTOR - POWERCON TRUE1 TOP: HOLD (HOLD (bought part: no order, no supplier contact; guideline 4.3))
- 718071 ELECTRICAL - CORD - SJT 14/3: HOLD (HOLD (bought part: no order, no supplier contact; guideline 4.3))
- 718072 ELECTRICAL - MAINS PLUG - NEMA 5-15P: HOLD (HOLD (bought part: no order, no supplier contact; guideline 4.3))
- 718023 ELECTRICAL - CABLE - 2 X 18 AWG - CLASS 2: HOLD (HOLD (bought part: no order, no supplier contact; guideline 4.3))
- 718024 ELECTRICAL - CABLE - 4 X 18 AWG - CLASS 2: HOLD (HOLD (bought part: no order, no supplier contact; guideline 4.3))
- 718055 ELECTRICAL - CABLE - 4 X 16 AWG - CLASS 2: HOLD (HOLD (bought part: no order, no supplier contact; guideline 4.3))
- 718029 ELECTRICAL - CABLE - 6 X 18 AWG - CLASS 2: HOLD (HOLD (bought part: no order, no supplier contact; guideline 4.3))
- 718025 ELECTRICAL - CABLE - 6 X 24 AWG SCREENED - CLASS 2: HOLD (HOLD (bought part: no order, no supplier contact; guideline 4.3))
- 718028 ELECTRICAL - CABLE - CAT6 U/UTP: HOLD (HOLD (bought part: no order, no supplier contact; guideline 4.3))
- 718030 ELECTRICAL - CONNECTOR - MINI-FIT JR RECEPTACLE 2 WAY V-0: HOLD (HOLD (bought part: no order, no supplier contact; guideline 4.3))
- 718031 ELECTRICAL - CONNECTOR - MINI-FIT JR PLUG 2 WAY V-0: HOLD (HOLD (bought part: no order, no supplier contact; guideline 4.3))
- 718045 ELECTRICAL - CONNECTOR - MINI-FIT JR RECEPTACLE 6 WAY V-0: HOLD (HOLD (bought part: no order, no supplier contact; guideline 4.3))
- 718046 ELECTRICAL - CONNECTOR - MINI-FIT JR PLUG 6 WAY V-0: HOLD (HOLD (bought part: no order, no supplier contact; guideline 4.3))
- 718032 ELECTRICAL - CONNECTOR - MINI-FIT JR RECEPTACLE 4 WAY V-0: HOLD (HOLD (bought part: no order, no supplier contact; guideline 4.3))
- 718033 ELECTRICAL - CONNECTOR - MINI-FIT JR PLUG 4 WAY V-0: HOLD (HOLD (bought part: no order, no supplier contact; guideline 4.3))
- 718034 ELECTRICAL - CONNECTOR - MINI-FIT JR RECEPTACLE 10 WAY V-0: HOLD (HOLD (bought part: no order, no supplier contact; guideline 4.3))
- 718035 ELECTRICAL - CONNECTOR - MINI-FIT JR PLUG 10 WAY V-0: HOLD (HOLD (bought part: no order, no supplier contact; guideline 4.3))
- 718036 ELECTRICAL - TERMINAL - MINI-FIT JR FEMALE 18-24 AWG TIN: HOLD (HOLD (bought part: no order, no supplier contact; guideline 4.3))
- 718037 ELECTRICAL - TERMINAL - MINI-FIT JR MALE 18-24 AWG TIN: HOLD (HOLD (bought part: no order, no supplier contact; guideline 4.3))
- 718038 ELECTRICAL - RJ45 PLUG - CAT6: HOLD (HOLD (bought part: no order, no supplier contact; guideline 4.3))
- 718039 ELECTRICAL - RJ45 INLINE COUPLER - CAT6: HOLD (HOLD (bought part: no order, no supplier contact; guideline 4.3))
- 718040 ELECTRICAL - RJ45 KEYSTONE JACK - CAT6 - WITH DUST CAP: HOLD (HOLD (bought part: no order, no supplier contact; guideline 4.3))
- 718056 ELECTRICAL - TERMINAL - MINI-FIT JR FEMALE 16 AWG TIN: HOLD (HOLD (bought part: no order, no supplier contact; guideline 4.3))
- 718057 ELECTRICAL - TERMINAL - MINI-FIT JR MALE 16 AWG TIN: HOLD (HOLD (bought part: no order, no supplier contact; guideline 4.3))
- 718041 ELECTRICAL - BUSHING - SHORTY 19.1 HOLE - NYLON: HOLD (HOLD (bought part: no order, no supplier contact; guideline 4.3))
- 718042 ELECTRICAL - EDGE PROTECTION STRIP - 0.5 MM SHEET: HOLD (HOLD (bought part: no order, no supplier contact; guideline 4.3))
- 718043 ELECTRICAL - CABLE CLIP - FOR 0.5 MM STEEL TRAY: HOLD (HOLD (bought part: no order, no supplier contact; guideline 4.3))
- 718050 ELECTRICAL - LED STRIP - 24 V 6.0 W/M - 3000 K - 8 MM: HOLD (HOLD (bought part: no order, no supplier contact; guideline 4.3))
- 718053 ELECTRICAL - LED STRIP FEED LEAD - LOOX5 8 MM: HOLD (HOLD (bought part: no order, no supplier contact; guideline 4.3))
- 718101 ELECTRICAL - LED PROFILE - LIGHT SHELF - SURFACE 23 X 12.5: HOLD (HOLD (bought part: no order, no supplier contact; guideline 4.3))
- 718102 ELECTRICAL - LED PROFILE COVER - SATIN - CLIP-IN: HOLD (HOLD (bought part: no order, no supplier contact; guideline 4.3))
- 718103 ELECTRICAL - LED PROFILE END CAP: HOLD (HOLD (bought part: no order, no supplier contact; guideline 4.3))
- 718104 ELECTRICAL - LED PROFILE MOUNTING CLIP: HOLD (HOLD (bought part: no order, no supplier contact; guideline 4.3))

**Packing and Assembly**
- no packaging items (family 91) listed yet; v2/07-Packaging/910000_P01_PACKING-LIST_BOM.csv names other teams' parts, which their own lists carry

**Joints register**
- H-50 HARDWARE - BLIND RIVET - CLOSED END - CLIP MALE - HOLD: no part number
- H-53 SEALS - DECOR SEAM TAPE - PRE-COMPRESSED FOAM - 8 X 1-4 - HOLD: no part number

## Reserved air spaces, not counted (D-105)

Rows typed reserved air space in another team's block: the part is AIR's and is counted once, in AIR's list.

- 350004 FRONT - AIR SUPPLY ASSY - DR in `v2/03-Manufacturing/front/350003_P01_FRONT-DECOR-BLOCK-ASSY-DR_BOM.csv` @ working tree
- 351402 FRONT - AIR INTAKE RISER - DR in `v2/03-Manufacturing/front/350003_P01_FRONT-DECOR-BLOCK-ASSY-DR_BOM.csv` @ working tree
- 351403 FRONT - AIR TRANSITION - LOWER - DR in `v2/03-Manufacturing/front/350003_P01_FRONT-DECOR-BLOCK-ASSY-DR_BOM.csv` @ working tree
- 351404 FRONT - SUPPLY FAN BOX - DR in `v2/03-Manufacturing/front/350003_P01_FRONT-DECOR-BLOCK-ASSY-DR_BOM.csv` @ working tree
- 351405 FRONT - AIR TRANSITION - UPPER - DR in `v2/03-Manufacturing/front/350003_P01_FRONT-DECOR-BLOCK-ASSY-DR_BOM.csv` @ working tree

## Numbers given out by the master BOM (D-120)

From `v2/04-BOM/number-allocation.csv`: 184 numbers, 85 not in a team's list yet, 76 in use, 23 cancelled. Each is for one part in its team's list; a team that finds two of them identical in form, fit and function uses the lower number for both and asks for the other to be cancelled. A cancelled number is never reused.

| Number | Name | Part of | Qty per pod | Status |
|---|---|---|---:|---|
| 412101 | CEILING - FRAME SIDE MEMBER - COMMON | 411101 411102 | 2 | in use |
| 412102 | CEILING - FRAME SEAM MEMBER - C1 | 411101 | 1 | in use |
| 412103 | CEILING - FRAME FRONT MEMBER - C1 | 411101 | 1 | in use |
| 412104 | CEILING - FRAME BACK MEMBER 40 X 40 - C1 | 411101 | 1 | in use |
| 412105 | CEILING - FRAME CROSS MEMBER 1 - COMMON | 411101 411102 | 2 | in use |
| 412001 | CEILING - FRAME CROSS MEMBER - PLAIN - COMMON | 411101 411102 | 4 | in use |
| 412201 | CEILING - FRAME SIDE MEMBER - C2 | 411102 | 1 | CANCELLED |
| 412202 | CEILING - FRAME SEAM MEMBER - C2 | 411102 | 1 | in use |
| 412203 | CEILING - FRAME FRONT MEMBER - C2 | 411102 | 1 | in use |
| 412204 | CEILING - FRAME BACK MEMBER 40 X 40 - C2 | 411102 | 1 | in use |
| 412205 | CEILING - FRAME CROSS MEMBER 1 - C2 | 411102 | 1 | CANCELLED |
| 212101 | WALL - FRAME RAIL BOTTOM - SIDE LOWER - LH | 211101 | 1 | ALLOCATED |
| 212102 | WALL - FRAME RAIL TOP - SIDE LOWER - LH | 211101 | 1 | ALLOCATED |
| 212103 | WALL - FRAME STILE FRONT - SIDE LOWER - LH | 211101 | 1 | ALLOCATED |
| 212104 | WALL - FRAME STILE BACK 40 X 40 - SIDE LOWER - LH | 211101 | 1 | ALLOCATED |
| 212105 | WALL - FRAME STILE MID - SIDE LOWER - LH | 211101 | 3 | ALLOCATED |
| 211511 | WALL - CAVITY FILL PIECE F01 344.9 X 1102.7 - SIDE LOWER - COMMON | 210101 210102 | 2 | CANCELLED |
| 211512 | WALL - CAVITY FILL PIECE F04 334.9 X 1102.7 - SIDE LOWER - COMMON | 210101 210102 | 2 | CANCELLED |
| 212201 | WALL - FRAME RAIL BOTTOM - SIDE LOWER - RH | 211102 | 1 | ALLOCATED |
| 212202 | WALL - FRAME RAIL TOP - SIDE LOWER - RH | 211102 | 1 | ALLOCATED |
| 212203 | WALL - FRAME STILE FRONT - SIDE LOWER - RH | 211102 | 1 | ALLOCATED |
| 212204 | WALL - FRAME STILE BACK 40 X 40 - SIDE LOWER - RH | 211102 | 1 | ALLOCATED |
| 212205 | WALL - FRAME STILE MID - SIDE LOWER - RH | 211102 | 3 | ALLOCATED |
| 211521 | WALL - CAVITY FILL PIECE 1102.7 X 344.9 - SIDE LOWER - RH | 210102 | 3 | CANCELLED |
| 211522 | WALL - CAVITY FILL PIECE 1102.7 X 334.9 - SIDE LOWER - RH | 210102 | 1 | CANCELLED |
| 212301 | WALL - FRAME RAIL BOTTOM - SIDE UPPER - LH | 211103 | 1 | ALLOCATED |
| 212302 | WALL - FRAME RAIL TOP 40 X 40 - SIDE UPPER - LH | 211103 | 1 | ALLOCATED |
| 212303 | WALL - FRAME STILE FRONT - SIDE UPPER - LH | 211103 | 1 | ALLOCATED |
| 212304 | WALL - FRAME STILE BACK 40 X 40 - SIDE UPPER - LH | 211103 | 1 | ALLOCATED |
| 212305 | WALL - FRAME STILE MID - SIDE UPPER - LH | 211103 | 3 | ALLOCATED |
| 211531 | WALL - CAVITY FILL PIECE F05 344.9 X 1082.7 - SIDE UPPER - COMMON | 210103 210104 | 2 | CANCELLED |
| 211532 | WALL - CAVITY FILL PIECE F08 334.9 X 1082.7 - SIDE UPPER - COMMON | 210103 210104 | 2 | CANCELLED |
| 212401 | WALL - FRAME RAIL BOTTOM - SIDE UPPER - RH | 211104 | 1 | ALLOCATED |
| 212402 | WALL - FRAME RAIL TOP 40 X 40 - SIDE UPPER - RH | 211104 | 1 | ALLOCATED |
| 212403 | WALL - FRAME STILE FRONT - SIDE UPPER - RH | 211104 | 1 | ALLOCATED |
| 212404 | WALL - FRAME STILE BACK 40 X 40 - SIDE UPPER - RH | 211104 | 1 | ALLOCATED |
| 212405 | WALL - FRAME STILE MID - SIDE UPPER - RH | 211104 | 3 | ALLOCATED |
| 211541 | WALL - CAVITY FILL PIECE 1082.7 X 344.9 - SIDE UPPER - RH | 210104 | 3 | CANCELLED |
| 211542 | WALL - CAVITY FILL PIECE 1082.7 X 334.9 - SIDE UPPER - RH | 210104 | 1 | CANCELLED |
| 212501 | WALL - FRAME RAIL BOTTOM - BACK LOWER - B1 | 211201 211203 | 2 | ALLOCATED |
| 212502 | WALL - FRAME RAIL TOP - BACK LOWER - B1 | 211201 | 1 | ALLOCATED |
| 212503 | WALL - FRAME STILE OUTER - BACK LOWER - B1 | 211201 211203 | 2 | ALLOCATED |
| 212504 | WALL - FRAME STILE CENTRE - BACK LOWER - B1 | 211201 211203 | 2 | ALLOCATED |
| 212505 | WALL - FRAME STILE MID - BACK LOWER - B1 | 211201 211203 | 4 | ALLOCATED |
| 211611 | WALL - CAVITY FILL PIECE F09 373 X 1078.6 - BACK LOWER - COMMON | 210201 210202 | 2 | CANCELLED |
| 212601 | WALL - FRAME RAIL BOTTOM - BACK LOWER - B2 | 211202 211204 | 2 | ALLOCATED |
| 212602 | WALL - FRAME RAIL TOP - BACK LOWER - B2 | 211202 | 1 | ALLOCATED |
| 212603 | WALL - FRAME STILE OUTER - BACK LOWER - B2 | 211202 211204 | 2 | ALLOCATED |
| 212604 | WALL - FRAME STILE CENTRE - BACK LOWER - B2 | 211202 211204 | 2 | ALLOCATED |
| 212605 | WALL - FRAME STILE MID - BACK LOWER - B2 | 211202 211204 | 4 | ALLOCATED |
| 211621 | WALL - CAVITY FILL PIECE F12 373 X 1078.6 - BACK LOWER - B2 | 210202 | 1 | CANCELLED |
| 211513 | WALL - CAVITY FILL PIECE F02 344.9 X 1102.7 - SIDE LOWER - COMMON | 210101 210102 | 2 | CANCELLED |
| 211514 | WALL - CAVITY FILL PIECE F03 344.9 X 1102.7 - SIDE LOWER - COMMON | 210101 210102 | 2 | CANCELLED |
| 211533 | WALL - CAVITY FILL PIECE F06 344.9 X 1082.7 - SIDE UPPER - COMMON | 210103 210104 | 2 | CANCELLED |
| 211534 | WALL - CAVITY FILL PIECE F07 344.9 X 1082.7 - SIDE UPPER - COMMON | 210103 210104 | 2 | CANCELLED |
| 211612 | WALL - CAVITY FILL PIECE F10 373 X 1078.6 - BACK LOWER - COMMON | 210201 210202 | 2 | CANCELLED |
| 211613 | WALL - CAVITY FILL PIECE F11 373 X 1078.6 - BACK LOWER - B1 | 210201 | 1 | CANCELLED |
| 211631 | WALL - CAVITY FILL PIECE F13 373 X 1078.6 - BACK UPPER - COMMON | 210203 210204 | 3 | CANCELLED |
| 211632 | WALL - CAVITY FILL PIECE F14 373 X 1078.6 - BACK UPPER - COMMON | 210203 210204 | 2 | CANCELLED |
| 211633 | WALL - CAVITY FILL PIECE F15 373 X 1078.6 - BACK UPPER - B3 | 210203 | 1 | CANCELLED |
| 718101 | ELECTRICAL - LED PROFILE - LIGHT SHELF - SURFACE 23 X 12.5 | 810201 | 1 | in use |
| 718102 | ELECTRICAL - LED PROFILE COVER - SATIN - CLIP-IN | 810201 | 1 | in use |
| 718103 | ELECTRICAL - LED PROFILE END CAP | 810201 | 2 | in use |
| 718104 | ELECTRICAL - LED PROFILE MOUNTING CLIP | 810201 |  | in use |
| 352301 | FRONT - DECOR FRAME DR - FRONT RING BOTTOM | 351306 | 1 | in use |
| 352302 | FRONT - DECOR FRAME DR - FRONT RING FACET SIDE | 351306 | 1 | in use |
| 352303 | FRONT - DECOR FRAME DR - FRONT RING TOP | 351306 | 1 | in use |
| 352304 | FRONT - DECOR FRAME DR - FRONT RING DT JOINT | 351306 | 1 | in use |
| 352305 | FRONT - DECOR FRAME DR - FRONT RING DIAGONAL | 351306 | 1 | in use |
| 352306 | FRONT - DECOR FRAME DR - FRONT RING GLASS EDGE | 351306 | 1 | in use |
| 352307 | FRONT - DECOR FRAME DR - BACK RING BOTTOM | 351306 | 1 | in use |
| 352308 | FRONT - DECOR FRAME DR - BACK RING BOLT LINE | 351306 | 1 | in use |
| 352309 | FRONT - DECOR FRAME DR - BACK RING TOP | 351306 | 1 | in use |
| 352310 | FRONT - DECOR FRAME DR - BACK RING DT JOINT | 351306 | 1 | in use |
| 352311 | FRONT - DECOR FRAME DR - BACK RING DT LEDGE | 351306 | 1 | in use |
| 352312 | FRONT - DECOR FRAME DR - BACK RING DIAGONAL | 351306 | 1 | in use |
| 352313 | FRONT - DECOR FRAME DR - BACK RING GLASS EDGE | 351306 | 1 | in use |
| 352314 | FRONT - DECOR FRAME DR - FRONT RING CROSS 724 | 351306 | 1 | in use |
| 352315 | FRONT - DECOR FRAME DR - FRONT RING FAN BOX SHELF | 351306 | 1 | in use |
| 352316 | FRONT - DECOR FRAME DR - BACK RING BAND | 351306 | 1 | in use |
| 352317 | FRONT - DECOR FRAME DR - FACET TUBE - 3 OFF | 351306 | 3 | in use |
| 352318 | FRONT - DECOR FRAME DR - FACET TUBE FAN BOX SHELF | 351306 | 1 | in use |
| 352319 | FRONT - DECOR FRAME DR - CHAMFER TUBE - 2 OFF | 351306 | 2 | in use |
| 352320 | FRONT - DECOR FRAME DR - DT JOINT TUBE SLANTED | 351306 | 1 | in use |
| 352321 | FRONT - DECOR FRAME DR - DT JOINT TUBE STRAIGHT | 351306 | 1 | CANCELLED |
| 352322 | FRONT - DECOR FRAME DR - FRONT RING CROSS OVER THE FAN BOX | 351306 | 1 | in use |
| 352201 | FRONT - DECOR FRAME DT - BACK RING BOTTOM | 351204 | 1 | in use |
| 352202 | FRONT - DECOR FRAME DT - BACK RING DR JOINT | 351204 | 1 | in use |
| 352203 | FRONT - DECOR FRAME DT - BACK RING TOP | 351204 | 1 | in use |
| 352204 | FRONT - DECOR FRAME DT - BACK RING SLOPE OVER DL | 351204 | 1 | in use |
| 352205 | FRONT - DECOR FRAME DT - BACK RING POST | 351204 | 1 | in use |
| 352206 | FRONT - DECOR FRAME DT - FRONT FACET TUBE | 351204 | 1 | in use |
| 352207 | FRONT - DECOR FRAME DT - CATCH AND STOP RAIL | 351204 | 1 | in use |
| 352208 | FRONT - DECOR FRAME DT - CHAMFER TUBE ALONG X | 351204 | 1 | in use |
| 352209 | FRONT - DECOR FRAME DT - UNDERSIDE CROSS TUBE LEFT | 351204 | 1 | in use |
| 352210 | FRONT - DECOR FRAME DT - UNDERSIDE CROSS TUBE OVER THE CATCH | 351204 | 1 | in use |
| 352211 | FRONT - DECOR FRAME DT - CHAMFER CROSS TUBE - 3 OFF | 351204 | 3 | in use |
| 352101 | FRONT - DECOR FRAME DL - BACK RING BOTTOM | 351104 | 1 | in use |
| 352102 | FRONT - DECOR FRAME DL - BACK RING DOOR SIDE | 351104 | 1 | in use |
| 352103 | FRONT - DECOR FRAME DL - BACK RING SLOPE UNDER DT | 351104 | 1 | in use |
| 352104 | FRONT - DECOR FRAME DL - BACK RING BOLT LINE | 351104 | 1 | in use |
| 352105 | FRONT - DECOR FRAME DL - RING DOOR SIDE - RINGS 1 TO 4 | 351104 | 4 | in use |
| 352106 | FRONT - DECOR FRAME DL - RING BACK - RINGS 1 TO 4 | 351104 | 4 | in use |
| 352107 | FRONT - DECOR FRAME DL - RING BOTTOM - OUTER FACET | 351104 | 1 | in use |
| 352108 | FRONT - DECOR FRAME DL - RING BOTTOM - FRONT FACET | 351104 | 1 | in use |
| 352109 | FRONT - DECOR FRAME DL - RING OUTER FACET - RINGS 2 TO 4 | 351104 | 3 | in use |
| 352110 | FRONT - DECOR FRAME DL - RING FRONT FACET - RINGS 2 TO 4 | 351104 | 3 | in use |
| 352111 | FRONT - DECOR FRAME DL - HINGE POST 1 | 351104 | 1 | in use |
| 352112 | FRONT - DECOR FRAME DL - DOOR-SIDE FRONT POST 1 | 351104 | 1 | in use |
| 352113 | FRONT - DECOR FRAME DL - HINGE POST 2 | 351104 | 1 | in use |
| 352114 | FRONT - DECOR FRAME DL - DOOR-SIDE FRONT POST 2 | 351104 | 1 | in use |
| 352115 | FRONT - DECOR FRAME DL - HINGE POST 3 | 351104 | 1 | in use |
| 352116 | FRONT - DECOR FRAME DL - DOOR-SIDE FRONT POST 3 | 351104 | 1 | in use |
| 351105 | FRONT - DOOR HINGE-SIDE STOP - DL - PIECE 1 | 350001 | 1 | in use |
| 351106 | FRONT - DOOR HINGE-SIDE STOP - DL - PIECE 2 AND 3 | 350001 | 2 | in use |
| 351107 | FRONT - DOOR HINGE-SIDE STOP - DL - PIECE 4 | 350001 | 1 | in use |
| 611403 | AIR - FAN BOX BULKHEAD - EXHAUST | 610402 | 1 | in use |
| 611404 | AIR - FAN BOX BULKHEAD - SUPPLY | 610401 | 1 | in use |
| 611405 | AIR - FAN BOX LINING - EXHAUST SIDE | 610402 | 2 | in use |
| 611406 | AIR - FAN BOX LINING - EXHAUST FAR END | 610402 | 1 | in use |
| 611407 | AIR - FAN BOX LINING - SUPPLY END | 610401 | 2 | in use |
| 611408 | AIR - FAN BOX LIP ANGLE - SUPPLY | 610401 | 1 | in use |
| 618402 | AIR - FAN BOX PAD - SUPPLY - RUBBER 40 X 15 X 5 - HOLD | 610401 | 2 | in use |
| 618501 | AIR - RISER BUFFER - RUBBER - M6 - HOLD | 610401 | 1 | in use |
| 611109 | AIR - COLUMN CORNER ANGLE - BACK | 610101 | 1 | in use |
| 611110 | AIR - COLUMN FILL - LEFT | 610101 | 1 | in use |
| 611111 | AIR - KICK GRILLE - LEFT | 610101 | 1 | in use |
| 611211 | AIR - SOFFIT FILL - FRONT | 610201 | 1 | in use |
| 611502 | AIR - INTAKE BOOT | 610401 | 1 | ALLOCATED |
| 611303 | AIR - CARTRIDGE INLET GASKET | 610301 | 2 | ALLOCATED |
| 212701 | WALL - FRAME RAIL TOP - BACK UPPER - B3 AND B4 | 211203 211204 | 2 | ALLOCATED |
| 351307 | FRONT - DECOR SEAM BAR - DR - REMOVABLE | 350003 | 1 | CANCELLED |
| 211515 | WALL - CAVITY FILL PIECE F01 240 X 1102.7 - SIDE LOWER - COMMON | 210101 210102 | 2 | ALLOCATED |
| 211516 | WALL - CAVITY FILL PIECE F02 230.9 X 1102.7 - SIDE LOWER - COMMON | 210101 210102 | 4 | ALLOCATED |
| 211517 | WALL - CAVITY FILL PIECE F03 205.5 X 1102.7 - SIDE LOWER - COMMON | 210101 210102 | 4 | ALLOCATED |
| 211518 | WALL - CAVITY FILL PIECE F04 214 X 1102.7 - SIDE LOWER - COMMON | 210101 210102 | 2 | ALLOCATED |
| 211535 | WALL - CAVITY FILL PIECE F05 240 X 1082.7 - SIDE UPPER - COMMON | 210103 210104 | 2 | ALLOCATED |
| 211536 | WALL - CAVITY FILL PIECE F06 230.9 X 1082.7 - SIDE UPPER - COMMON | 210103 210104 | 4 | ALLOCATED |
| 211537 | WALL - CAVITY FILL PIECE F07 205.5 X 1082.7 - SIDE UPPER - COMMON | 210103 210104 | 4 | ALLOCATED |
| 211538 | WALL - CAVITY FILL PIECE F08 214 X 1082.7 - SIDE UPPER - COMMON | 210103 210104 | 2 | ALLOCATED |
| 211614 | WALL - CAVITY FILL PIECE F09 274.7 X 1078.6 - BACK LOWER - B1 | 210201 | 1 | ALLOCATED |
| 211615 | WALL - CAVITY FILL PIECE F10 274.7 X 1078.6 - BACK LOWER - B1 | 210201 | 2 | ALLOCATED |
| 211616 | WALL - CAVITY FILL PIECE F11 274.7 X 1078.6 - BACK LOWER - B1 | 210201 | 1 | ALLOCATED |
| 211634 | WALL - CAVITY FILL PIECE F12 274.7 X 1078.6 - BACK UPPER - COMMON | 210203 210204 | 3 | ALLOCATED |
| 211635 | WALL - CAVITY FILL PIECE F13 274.7 X 1078.6 - BACK UPPER - COMMON | 210203 210204 | 4 | ALLOCATED |
| 211636 | WALL - CAVITY FILL PIECE F14 274.7 X 1078.6 - BACK UPPER - B3 | 210203 | 1 | ALLOCATED |
| 111215 | BASE - CORNER KEY - SQUARE - INLINE | 110000 | 1 | ALLOCATED |
| 111302 | BASE - SILL - FIXED GLASS - BENT PROFILE | 111301 | 1 | ALLOCATED |
| 111303 | BASE - SILL - FIXED GLASS - DOOR-END PLATE | 111301 | 1 | ALLOCATED |
| 111111 | BASE - TUBE END CAP - 97 X 37 X 2 - AL BLACK | 110101 110102 110106 | 3 | ALLOCATED |
| 111602 | BASE - LEVELLING GLIDE - M10 - D40 | 110101 110102 110103 110106 | 9 | ALLOCATED |
| 510203 | LINING - CASSETTE - BACK UPPER - B3 | 510000 | 1 | ALLOCATED |
| 510204 | LINING - CASSETTE - BACK UPPER - B4 | 510000 | 1 | ALLOCATED |
| 511203 | LINING - TRAY - BACK UPPER - B3 | 510203 | 1 | ALLOCATED |
| 511204 | LINING - TRAY - BACK UPPER - B4 | 510204 | 1 | ALLOCATED |
| 511403 | LINING - FELT - BACK UPPER - B3 | 510203 | 1 | ALLOCATED |
| 511404 | LINING - FELT - BACK UPPER - B4 | 510204 | 1 | ALLOCATED |
| 211701 | WALL - CASSETTE LEDGE - SIDE LOWER - COMMON | 210101 210102 | 2 | ALLOCATED |
| 211801 | WALL - CASSETTE LEDGE - BACK LOWER | 210201 210202 | 2 | ALLOCATED |
| 361004 | FRONT - DOOR STRIKE SHIM | 360001 | 1 | ALLOCATED |
| 412002 | CEILING - FRAME CLIP TAB | 411101 411102 | 12 | ALLOCATED |
| 513103 | LINING - CATCH EYE BRACKET - CEILING | 510301 | 4 | ALLOCATED |
| 611212 | AIR - SOFFIT UNDERSIDE HINGE - RIVETED PIN | 610201 | 4 | ALLOCATED |
| 611213 | AIR - SOFFIT CARTRIDGE STRAP | 610201 | 2 | ALLOCATED |
| 611214 | AIR - SOFFIT CARTRIDGE STRAP ANGLE | 610201 | 1 | ALLOCATED |
| 618403 | AIR - FAN BOX MOUNT - EXHAUST - HOLD | 610402 | 4 | ALLOCATED |
| 610403 | AIR - RISER TRANSITION | 610401 | 1 | ALLOCATED |
| 610404 | AIR - SUPPLY TRANSITION | 610401 | 1 | ALLOCATED |
| 611701 | AIR - RISER TRANSITION - LEFT WRAPPER | 610403 | 1 | ALLOCATED |
| 611702 | AIR - RISER TRANSITION - RIGHT WRAPPER | 610403 | 1 | ALLOCATED |
| 611703 | AIR - RISER TRANSITION - CHEEK | 610403 | 2 | ALLOCATED |
| 611801 | AIR - SUPPLY TRANSITION - SHELL | 610404 | 1 | ALLOCATED |
| 611802 | AIR - SUPPLY TRANSITION - FLOOR | 610404 | 1 | ALLOCATED |
| 611803 | AIR - SUPPLY TRANSITION - VANE - OVER THE BOX | 610404 | 3 | ALLOCATED |
| 611804 | AIR - SUPPLY TRANSITION - VANE - BESIDE THE BOX | 610404 | 2 | ALLOCATED |
| 611215 | AIR - SOFFIT LATCH BRACKET | 610201 | 4 | ALLOCATED |
| 611409 | AIR - FAN BOX MOUNT ANGLE | 610201 | 2 | ALLOCATED |
| 618107 | AIR - SOFFIT CARTRIDGE STRAP PAD - HOLD | 610201 | 2 | ALLOCATED |
| 611216 | AIR - SOFFIT FILL - RIGHT | 610201 | 1 | ALLOCATED |
| 611217 | AIR - SOFFIT FILL - OVER THE COLUMN | 610201 | 1 | ALLOCATED |
| 212606 | WALL - FRAME STUD BELOW THE POWER UNIT - BACK LOWER - B2 | 211202 | 1 | ALLOCATED |
| 212607 | WALL - FRAME STUB ABOVE THE POWER UNIT - BACK LOWER - B2 | 211202 | 1 | ALLOCATED |
| 212608 | WALL - FRAME CROSS MEMBER LOWER - BACK LOWER - B2 | 211202 | 1 | ALLOCATED |
| 212609 | WALL - FRAME CROSS MEMBER UPPER - BACK LOWER - B2 | 211202 | 1 | ALLOCATED |

## Rules

Fails: no part number; one number for two different items; no mass; a hardware item (any bought item except AIR 61, ELECTRICAL 71 and PACKAGING 91) with no joints-register row (D-63); a reserved old number (D-28); an allocated number that is badly formed, outside its band, allocated twice, used for a different item, or used after it was cancelled (D-120).
Listed as missing, without failing: no parts list yet, no quantity, make or buy not stated, a metal part with no finish (D-79, D-67), a made part with no process, a HOLD item, a register item with no part number.
