autonomous-ai/spaceship/v2/06-Samples/wall-door-sample/parts-list.md

# Parts list: materials and parts for the sample

| Doc code | Revision | Status | Date |
|---|---|---|---|
| V2-SMP-WD (proposed) | P01 | DRAFT | 2026-10-31 |

One row per material or part. Quantities are what the sample items need (gross, before the factory's cutting waste). The method behind each is in the row. Products are the ones the hardware selection picked (HW-SEL), with no prices and no supplier contact. Where nothing is picked, the row says HOLD and gives no part number. Part numbers for our own parts come from the master BOM in Milestone 2; none is assigned here (D-22, D-28).

The **Status** column gives the status of the numbers in that row (confirmed, source, calculation, assumption or unverified). **HOLD** points to [hold-list.md](hold-list.md).

## Wall panel S1 and cassettes S2, S3

| ID | Part · Vietnamese | For | Qty | Maker · product | Status | Source | HOLD |
|---|---|---|---|---|---|---|---|
| P01 | ACP 3 mm, Dark Yellow EV3038 · tấm ốp alu | S1 skin; S7 bond strips from the offcut | 1 sheet 1500 × 3000 (the skin is about 1495 × 1145 plus any return the skin drawing adds) | Nhôm Việt Dũng · Alcorest outdoor ACP, EV3038, 3 mm × 0.21 mm skins, PE core | source (product, sheet sizes); calculation (fit); confirmed (colour, D-12) | HW-SEL A1 | H16 |
| P02 | Galvanized steel tube 20 × 40 × 1.2, the side panels' rails and front stiles · thép hộp mạ kẽm 20 × 40 × 1.2 | S1 rails and front stile 4.2 m; S7 weld coupons 11.2 m | 15.4 m | Pre-galvanized structural steel tube, Z100, with a certified yield of 280 MPa or more (S280GD+Z to EN 10346, SGC400 to JIS G3302, or a grade with 3 tensile tests at 280 MPa or more), walls at least 95% of nominal, straight within 0.5 (joints register J-FRAME-01) | source (grade, zinc and walls: J-FRAME-01; 1.2 for the side panels' rails and front stiles, the PM's ruling there); calculation (S1: its 5.28 m perimeter less the 1.145 m back member, which is P02C; weld coupons: 7 corners of two 1.2 legs, 7 rails on a 40 × 40 and 7 T-joint rails, 400 mm each) | joints register J-FRAME-01; D-131 | H15 |
| P02F | Galvanized steel tube, DR's 0.8 mm panel-screw tube · thép hộp mạ kẽm 0.8 của khối phải | S7 T06 coupons in DR's tube 1.5 m | 1.5 m | As P02, in the section of DR's panel-screw members in FRONT's DR frame (a 20 mm face takes the rivnut) | calculation (5 × 0.3 m); source (a rivnut in 0.8 mm steel on DR's four panel-screw tubes, the PM's ruling in the joints register) | joints register H-34, J-FRAME-01; FRONT's cut list 351306 | H15 |
| P02C | Galvanized steel tube 40 × 40 × 1.0, S1's back member, the corner edge member · thép hộp mạ kẽm góc 40 × 40 × 1.0 | S1 back member 1.15 m; S7 weld coupons 11.2 m | 12.4 m | As P02 | confirmed (PM ruling: 40 × 40 corner edge tubes, joints register R-J3); source (1.0 for every 40 × 40, D-131, J-FRAME-01); calculation (S1's height, 1143; weld coupons: 14 legs under the 20 × 40 rails and 7 corners of two 40 × 40 legs, 400 mm each) | joints register 2.4, FR-06, J-FRAME-01 | H15 |
| P02A | Galvanized steel tube 20 × 40 × 1.0, the other perimeters and fixing members · thép hộp mạ kẽm 20 × 40 × 1.0 | S7 rivnut coupons 4.5 m and their wall squares 0.6 m, bond coupons 1.5 m and weld coupons 11.2 m; R2's perimeter and cross member 1, 6.7 m | 24.5 m | As P02 | source (1.0 for every other perimeter member and every member with a site joint, D-131, J-FRAME-01); calculation (15 × 0.3 m and 15 squares of 40 mm; 10 × 0.15 m; weld coupons: 7 corners of two 1.0 legs, 7 rails on a 40 × 40 and 7 T-joint rails, 400 mm each; R2: C1's 1207 × 1495 perimeter, 5.40 m, and one 1.207 m cross member) | joints register J-FRAME-01; D-131 | H15 |
| P02S | Galvanized steel tube 20 × 40 × 0.8, the studs · thép hộp mạ kẽm 20 × 40 × 0.8 (thanh đứng) | S1's 5 studs 5.8 m; S7 clip coupons 1.5 m, bond-coupon stubs 0.5 m and weld coupons 5.6 m; R2's cross members 2 and 3, 2.5 m | 15.9 m | As P02 | source (0.8 for the studs and the ceiling's cross members 2 and 3, D-131, J-FRAME-01); calculation (S1: 5 studs of 1.145 m, D-135; 10 × 0.15 m; 14 T-joint studs of 400 mm; R2: 2 × 1.207 m); assumption (5 stubs of 0.1 m) | joints register J-FRAME-01; D-131, D-135 | H15 |
| P03 | PET cavity fill 40 mm, 32 kg/m³ · bông PET | S1 bays 1.71 m²; S3 back strips 1.06 m² (PR #32); S5 fill behind the column's and soffit's faces 1.70 m² at 27–30 mm (27 at the column's left face on skeleton P04; D-60) | 2.77 m² at 40 mm and 1.70 m² at 27–30 mm | Pyrotek · Sorberpoly 2D polyester, 32 kg/m³ (40 mm is a custom thickness; 25 and 50 are standard) | confirmed (grade, D-54); source (product); calculation (S1 1495 × 1145; S3 PR #32's three strips, 1116.74 × 338.75, 338.75 and 274.75; S5 2 × (173 + 314) × 1750) | HW-SEL B and F2; LS; HW-AA section 7e | |
| P03L | PET cavity fill 40 mm, the lighter grade · bông PET loại nhẹ | S1 bays, for T02 | 1.71 m² at 40 mm | Pyrotek · Sorberpoly 2D, 24 kg/m³ (D-54 calls it 25; 24 is the grade Pyrotek lists) | source (grade); calculation (area) | HW-SEL B; D-54 | |
| P04 | Bond, ACP to galvanized steel · keo dán | S1; S7 bond coupons | per the bead and tape pattern (D10); the factory works the amount out from the maker's coverage data | Sika · Sikaflex-252, one-part polyurethane, after an abrasive pad and clean, Sika Aktivator-205 and Sika Primer-210 on both faces (D-137; Sika's pre-treatment chart, the bond spec's section 8), with SikaTack Panel Fixing Tape pieces as the 3 mm spacer (the bond spec's HOLD-B6) | source (product and route, D-137, the bond spec's section 8) | HW-SEL A9; D-137 | H12 |
| P05 | M6 rivet nut, steel, zinc plated · tán rút thép mạ kẽm (tán rive) | R1 base band, the base joint's nut side, 4; S7 rivnut coupons 15, and 5 in DR's tube; spares 5 | 29 | Sherex by PEM · CAH2-610-4.2, steel, zinc plated, grip 0.70–4.20, head Ø12.96 × 0.76 as the aluminium CAH3-610-4.2 it replaced (so the seams stay 2.26), hole 9.53 (+0.10), set with the maker's tool for it, through a stop washer (P07) | source (part: the joints register's H-03, re-specified to steel by D-131 and the Lead's review); unverified (the hole for the steel part, the joints register's HOLD-04); calculation (4 base bolts at the 220 mm rule, joints register J-BASE-01 and 2.9); assumption (coupon and spare counts) | HW-SEL A5; joints register H-03 and H-34 | H05 |
| P06 | M6 socket head bolt, ISO 4762 class 8.8, zinc · bulong M6 lục giác chìm | S1 base joint 4; T06 20 (5 of them in DR's tube); spares 6 | 30 × M6 × 16 | Standard part | confirmed (ISO 4762, PM ruling R-J2); calculation (length, joints register 2.2) | joints register H-01 | |
| P07 | Stop washer, aluminium, Ø10.5 × Ø20 × 1.5, clamped under each joint rivnut's head when the rivnut is set · long đen chặn | With each joint rivnut: R1 4; T06 coupons 15; spares 5 | 24 | Our part, punched from 1.5 mm 5000- or 6000-series aluminium sheet; number from the master BOM in Milestone 2 | calculation (the 2.26 mm seam gap = 1.5 + the rivnut's 0.76 head, joints register 2.8); assumption (±0.05) | joints register H-08 | |
| P25 | Washer under the bolt head, ISO 7093-1 large series, 6.4 × 18 × 1.6, A2 stainless · long đen to dưới đầu bulong | With each P06 30; and on the rivnut head as DR's panel stop on its 5 coupons, 5 | 35 | Standard part | confirmed (PM ruling: one under every socket head on aluminium, joints register R-J10); source (dimensions, ISO 7093-1 M6) | joints register H-09 | |
| P26 | Captive retainer for the M6 bolt: an elastomer grommet in the bolt's 19 mm access hole that grips the head · vòng giữ bulong | S1 base joint 4; spares 4 | 8 | None named | assumption (counts) | joints register H-02 | H13 |
| P27 | Zinc-rich paint, 2-component epoxy, for the weld touch-up · sơn giàu kẽm (sửa mối hàn) | S1's welds; S7's welded bond coupons | as the factory's procedure needs, about 40 µm dry | Not named: a 2-component zinc-rich epoxy as ISO 12944-5 defines it (joints register J-FRAME-01) | assumption (product and film, J-FRAME-01) | joints register J-FRAME-01; D-131 | |
| P28 | Mitre plates, 2.0 mm galvanized steel, as laser-cut blanks 40 across: 831007 (26.5 long, a 45° corner of two 20 × 40), 831008 (41.5 long, a 20 × 40 on a 40 × 40), 831009 (54.8 long, two 40 × 40) · tấm đệm góc vát thép 2.0 | S1: 2 of 831007 and 2 of 831008; S7 weld coupons: 14 of 831007, 14 of 831008 and 7 of 831009; spares 2 of each | 45 | Our parts: flat rectangles with square edges, laser-cut from 2.0 mm galvanized sheet of the frames' grade and shortened so their ends sit about 0.5 inside the frame's outer faces; the all-round weld fills the step and is ground flush (D-146; joints register H-40 to H-42, J-FRAME-01) | source (sizes, D-146 and the joints register's H-40 to H-42); calculation (S1's 2 front and 2 back corners; 7 coupons of each corner kind); assumption (spares) | joints register H-40 to H-42, J-FRAME-01; D-146 | |
| P08 | Galvanised steel sheet 0.5 mm · khay thép lót | S2 tray 1.79 m²; S3 tray blank 1.42 m² and 2 ribs 0.19 m²; S7 clip strips 0.15 m² | 3.55 m² | EN 10346 DX51D+Z, coating mass to confirm | source (material); calculation (S2: 1448 × 1145 face plus 25 mm returns; S3: PR #32's flat blank 1251.53 × 1136.52 and its 2 ribs, 0.370 kg each at 3.93 kg/m²; 10 strips of 300 × 50); unverified (supplier) | HW-SEL B; LS | |
| P09 | PET felt 9 mm, Dark Gray · tấm tiêu âm PET (plan VT03-PET) | S2 1.66 m²; S3 1.21 m² (PR #32's 1160 × 1045); S6 12 m²; R3 column and soffit faces 2.57 m² | 17.4 m² | The factory's 9 mm PET felt (D-31) | unverified (the felt's own data); calculation (faces); assumption (S6 at 12 m²) | HW-SEL A3; D-31; LS | H08 |
| P10 | Felt edge fixing to the tray returns · cố định mép tấm tiêu âm | S2, S3, R3 inner panel | per D05 and D06 | Not designed | assumption (the layout study allows 0.05 kg/m²) | LS felt_fix_kgm2 | H09 |
| P11 | Captive mechanical clip, rated · kẹp treo cassette | S2 4; S3 6; S7 10; spares 4 | 24 | None named. Candidate: Häfele KEKU EH suspension fitting (20 kg vertical, 8 kg horizontal per a distributor page; rating basis not stated) | source (counts per cassette); assumption (coupon and spare counts); unverified (candidate's rating) | HW-SEL A8; D-47; ISS-076 | H03 |
| P12 | Ceiling safety catch: steel wire lanyard with a rated working load, and its two end fixings · dây an toàn trần | S3 2; T08 spares 2 | 4 | None named | source (2 per ceiling cassette) | HW-SEL A8; D-47; ISS-076, ISS-079 | H04 |
| P13 | Hook-and-loop, only to line up · miếng dán Velcro | S2, S3 | per D05 and D06 | VELCRO® Brand PS14 hook 25 mm, or 3M Dual Lock SJ3560 | source (products; locating only, no load rating) | HW-SEL A8 | |
| P14 | Gasket 3.2 mm with PSA, 10–20 mm strip, round the cassette edges · gioăng mép cassette | S2 edge 5.19 m; S3 edge 4.42 m | 9.6 m | Rogers · PORON 4701-40 Soft, laminated with PSA by a converter | source (product); calculation (S2: 2 × (1448 + 1145); S3: 2 × (1163 + 1048), PR #32's tray outline) | HW-SEL D | H14 |
| P14J | Joint gasket 3.97 mm with PSA, 8 mm strip, beside the washer line on each joint's nut side · gioăng mối nối | R1's band top, the base joint's nut side, 1.49 m; S1's 40 × 40 back member face, the corner's nut side, 1.14 m | 2.64 m | Rogers · PORON 4701-40 Soft, laminated with PSA by a converter | source (product); calculation (1493 + 1143; squeezed 43% in the 2.26 mm gap, joints register 2.2 and FR-11) | joints register H-04 | H14 |

## Air sample S5

| ID | Part · Vietnamese | For | Qty | Maker · product | Status | Source | HOLD |
|---|---|---|---|---|---|---|---|
| P15 | 12 V fan · quạt thông gió 12 V | S5, two per path; 1 spare | 5 | Noctua · NF-A14 industrialPPC-3000 PWM, 12 V, 140 × 140 × 25 | source (product, size); assumption (0.3 kg each, weighed in T10) | HW-SEL F1; D-51, D-60 | H06 |
| P16 | Cartridge and fan box casings, aluminium sheet 2.0 mm · vỏ ống tiêu âm, hộp quạt | S5, 2 cartridges and 2 fan boxes | 4.7 m² | Alloy not set | source (2 mm, HW-SEL F2); calculation (per cartridge 2 × (173 + 314) × 1750 mm² plus end frames over 30% of each end, 1.74 m²; the fan boxes with the transition and roof sleeve 1.2 m²; HW-AA calc.py, PR #26); unverified (alloy) | HW-SEL F2; HW-AA calc.py | H07 |
| P17 | Cartridge and fan box linings, 50 mm, 32 kg/m³ · lớp tiêu âm ống | S5, three layers per cartridge plus the fan boxes | 2.8 m² at 50 mm | Pyrotek · Sorberpoly 2D, 50 mm (standard thickness), 32 kg/m³ | source (product, published ISO 354 data at 50 mm); calculation (2 × 3 × 169 × 1750 mm², plus 1.02 m² in the fan boxes) | HW-SEL B and F2; HW-AA calc.py | |
| P18 | Intake riser, galvanised steel sheet 1.0 mm · ống gió cấp đứng | S5 riser 139 × 155, widening to 250, 1740 long | 1.11 m² | Galvanised steel, grade as P08 | source (1 mm, HW-SEL F2); calculation (2 × (139 + 155) × 1340 + 2 × (250 + 155) × 400 mm²) | HW-SEL F2; HW-AA section 7e | H07 |
| P19 | Fan bulkhead and fan box parts · vách đỡ quạt | S5 | per D08 | Not designed | — | HW-SEL F1 | H07 |
| P20 | ACP 3 mm for the column's and soffit's faces · tấm ốp alu mặt trong | R3: the column's front and left faces and the soffit's underside and front face, 2.57 m² (D-60, skeleton P04) | 1 sheet 1500 × 3000 | As P01 | calculation (faces, HW-AA section 7e); source (sheet size) | HW-SEL A1; HW-AA section 7e | H07 |
| P21 | Heater for T05, adjustable, with a power reading · bộ gia nhiệt | R4 | 1, at least 320 W | Test equipment | calculation (314 W lifts 65 l/s by 4 K: 1.2 × 1005 × 0.065 × 4; air density and heat capacity as REQ C4) | T05; D-50; D-52 | |
| P22 | Bench 12 V supply and a PWM speed source for the fans · nguồn 12 V | S5 tests | 1 | Test equipment, set to the fan maker's PWM input | — | HW-SEL F3 (the sensor hub's PWM output is HOLD for the electrical scope) | |

## Door unit S4 (HOLD)

| ID | Part · Vietnamese | For | Qty | Maker · product | Status | Source | HOLD |
|---|---|---|---|---|---|---|---|
| P23 | Door unit parts · cửa kính và phụ kiện | S4 | 1 set | Glass: 4+4 grey laminate of toughened, heat-soaked panes, 8.76 mm, product not named. Hinges and lock: none rated for this door (dormakaba OFFICE 11.233 is listed for toughened 8/10 mm only; Häfele 926.88.090/091, a second candidate, is rated 35 to 45 kg a pair for doors up to about 915 mm wide, D-138). Drop seal: athmer Schall-Ex GSA 1-1112 black, cut from 1208 to 1176. Frame stop seal: athmer PS 1515 P Flex. Glass-to-glass seal: Bohle BO5281018, listed for 8–10 mm toughened glass (its fit on the 8.76 laminate is unverified). Pull: one of the HW-SEL C2 options, hole sizes on laminate not confirmed. Kick strip: aluminium, 85 mm tall, in the base band's dark finish. | source (seal products and ratings, HW-SEL C3, C4); confirmed (85 mm, D-57; glass build, D-46); unverified (180° seal on laminate) | HW-SEL C1 to C4; D-46; D-56; D-57; D-138 | H01, H02 |

## Rigs

| ID | Part · Vietnamese | For | Qty | Maker · product | Status | Source | HOLD |
|---|---|---|---|---|---|---|---|
| P24 | Base band piece, aluminium 100 × 40 × 2.0 · viền chân nhôm | R1 | 1.66 m (the side band piece's length) | Stock tube | calculation (LS B-BAND-SIDE 1660 = 1700 − 40); assumption (2.0 mm wall, LS t_al_base) | LS | H17 |
