autonomous-ai/spaceship/sources/v1/drawings/wood-parts.pdf

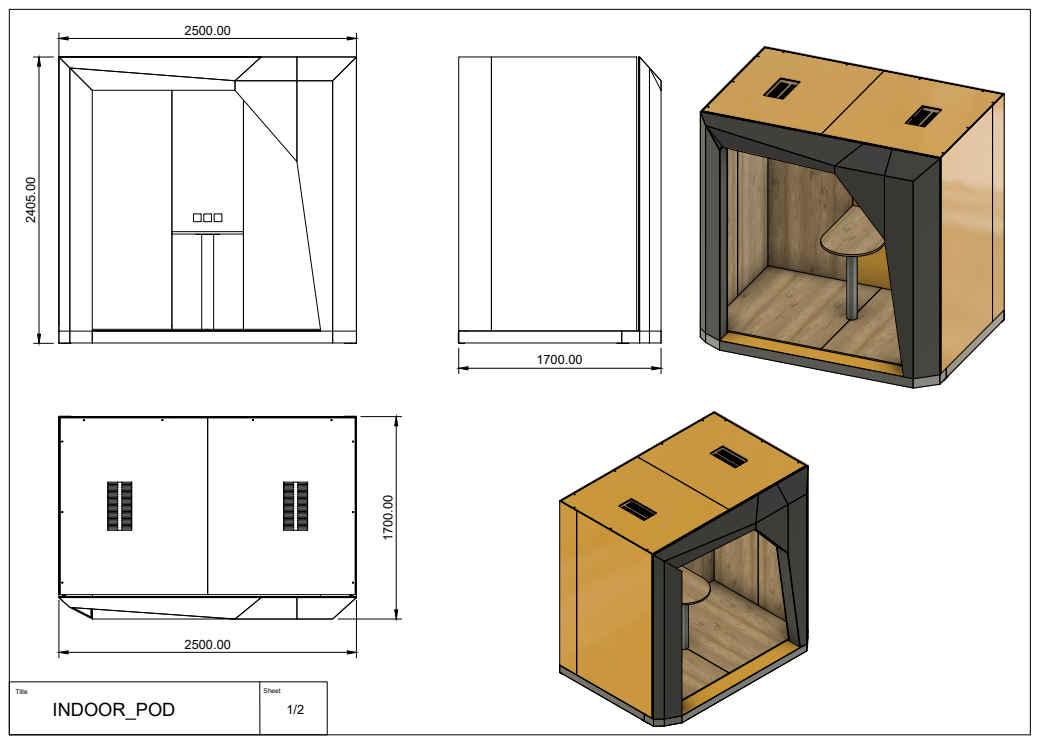
[picture p15: page 1]
Title; Sheet; INDOOR_POD

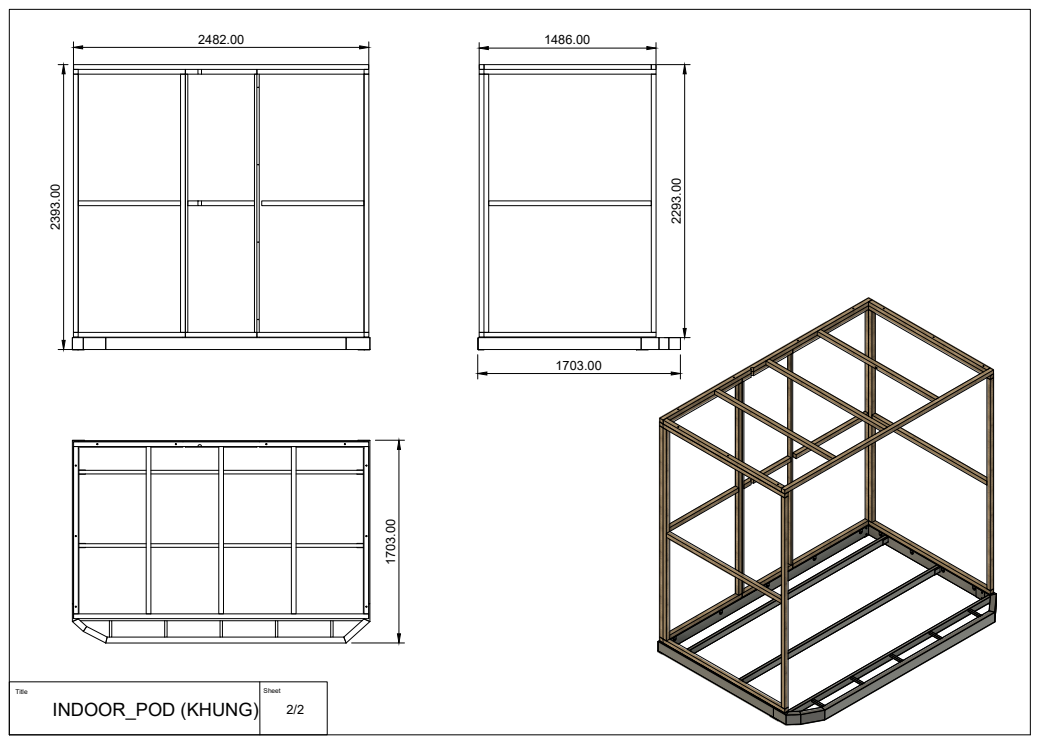
[picture p16: page 2]
Title; Sheet; INDOOR_POD (KHUNG)

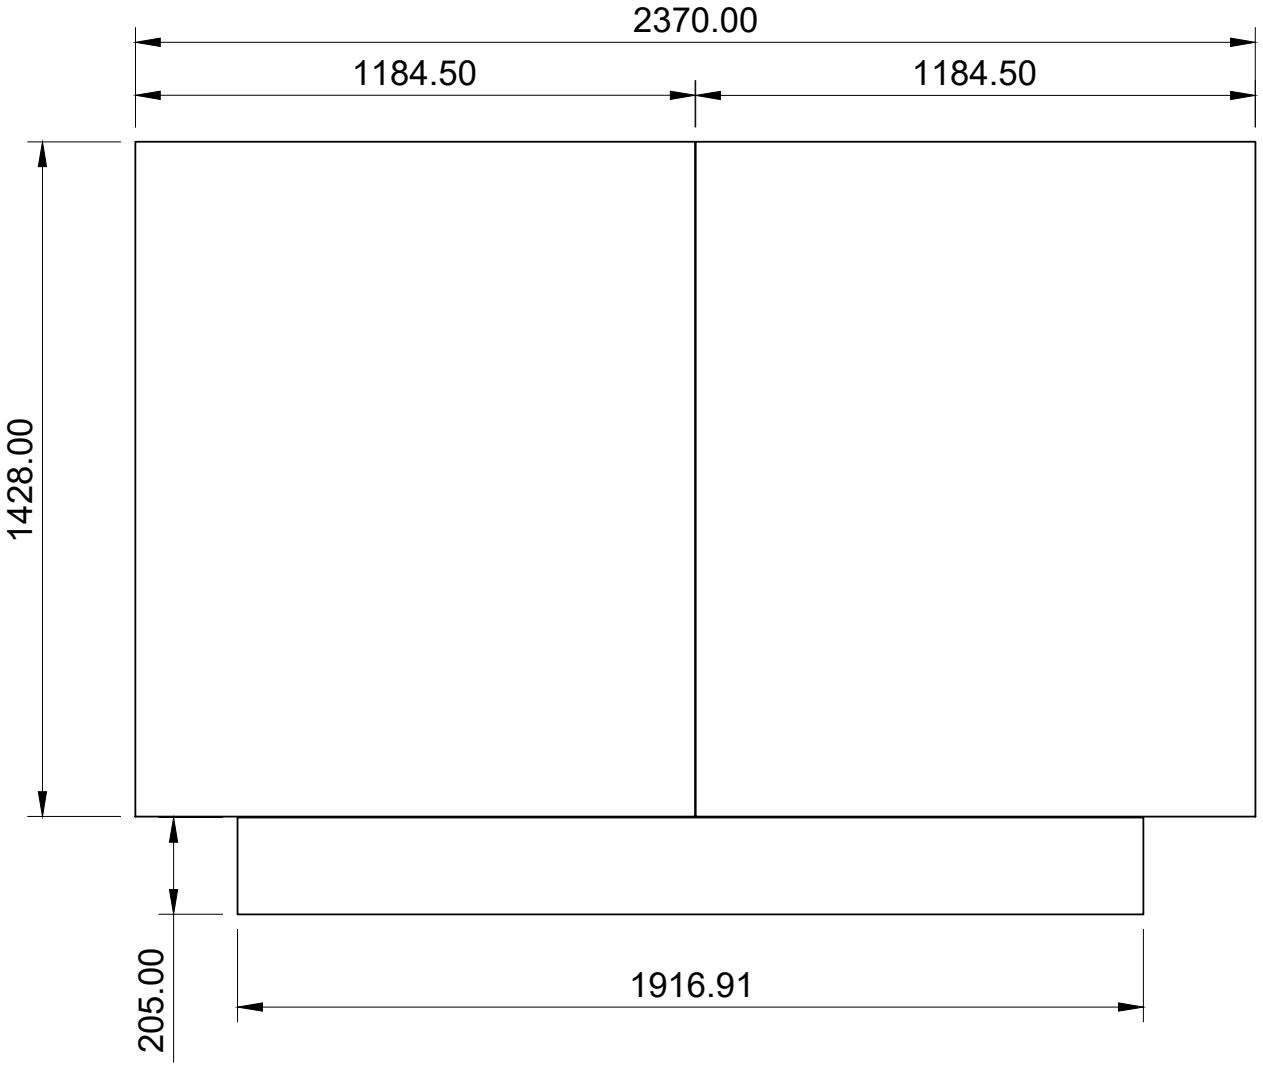
[picture p17: figure]

Title | Sheet
TẤM SÀN | 1/2

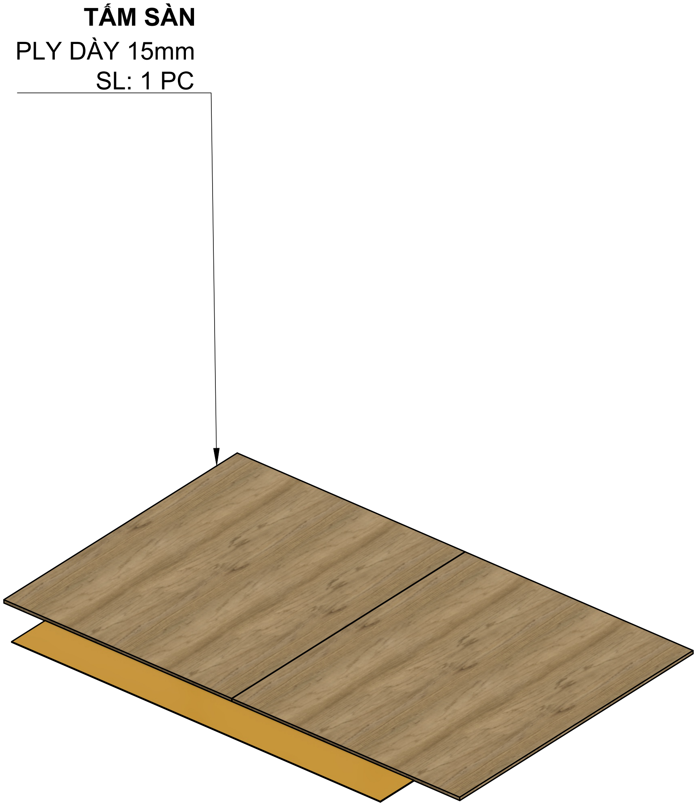
[picture p18: figure]
TẤM SÀN PLY DÀY 15mm SL: 1 PC

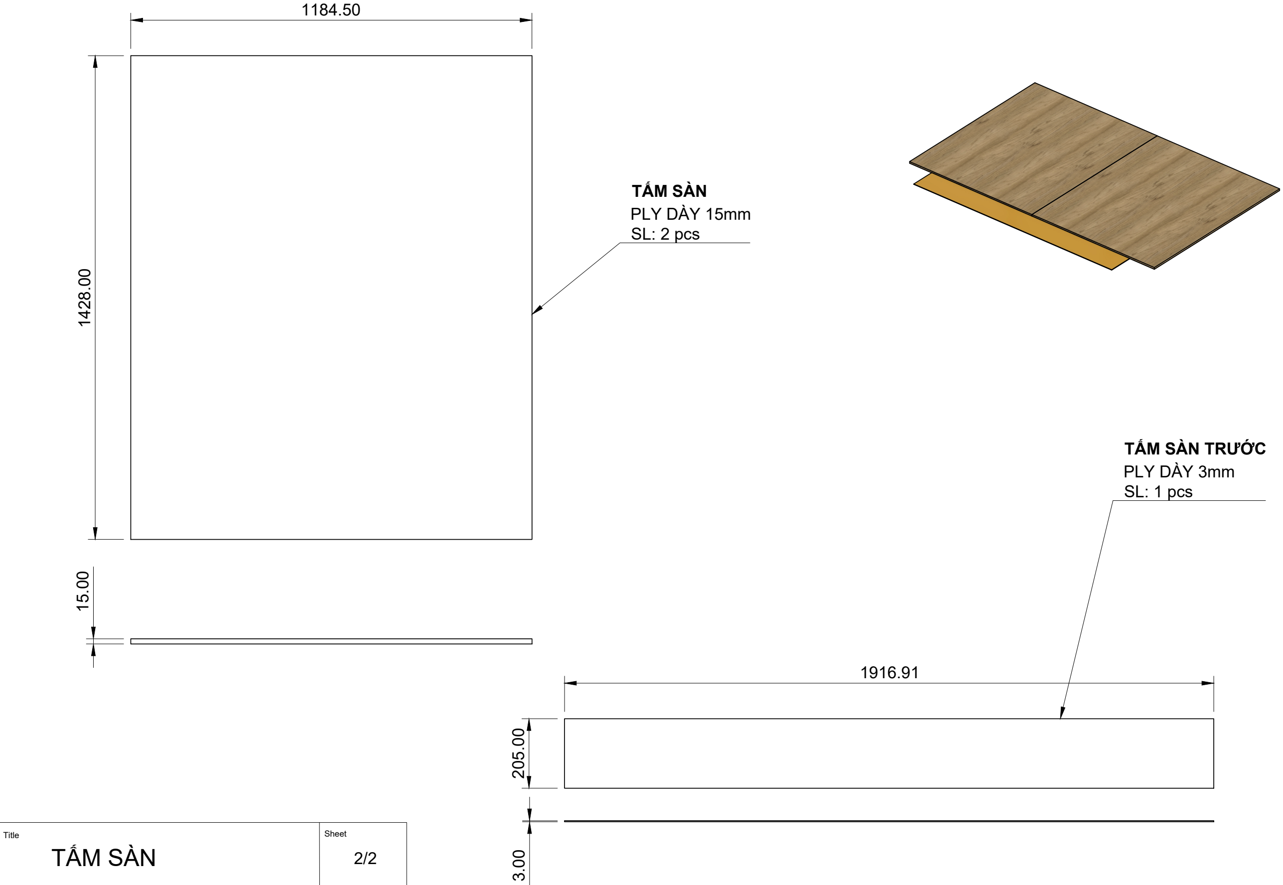
[picture p19: figure]
Title; Sheet; TẤM SÀN; TẤM SÀN PLY DÀY 15mm SL: 2 pcs 3.00; TẤM SÀN TRƯỚC PLY DÀY 3mm SL: 1 pcs

B

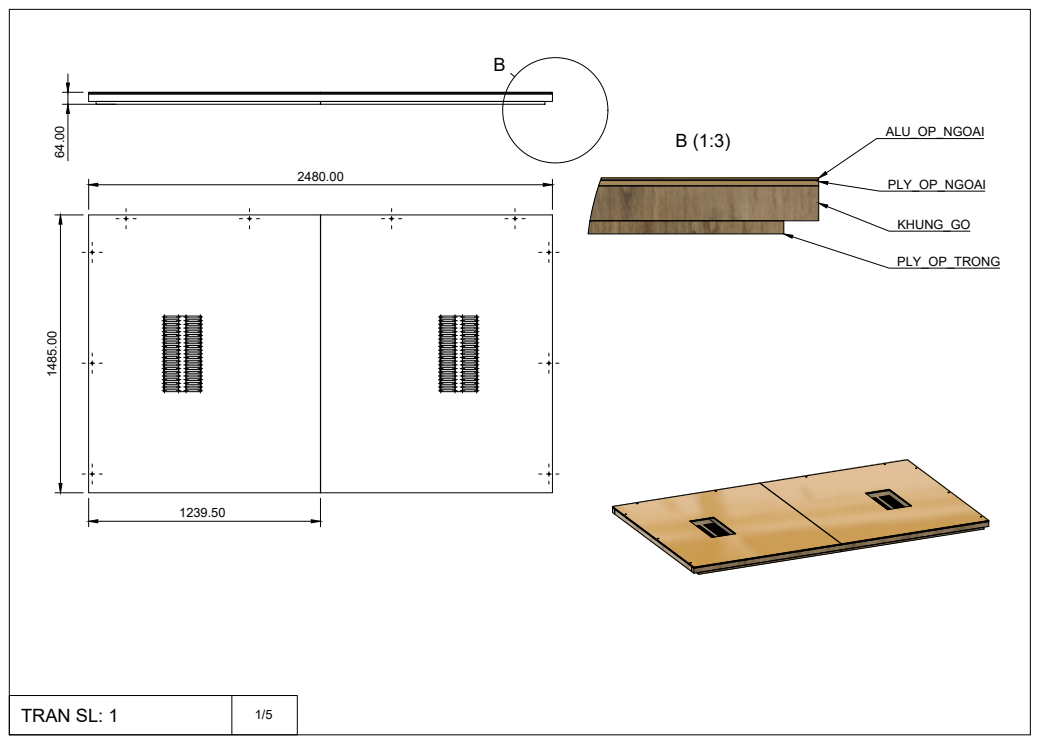
[picture p20: page 5]
TRAN SL: 1; ALU_OP_NGOAI; PLY_OP_NGOAI; KHUNG_GO; PLY_OP_TRONG ⁶⁴.00

202.00 404.00 540.50

# 1239.50 ¹⁴⁸⁵.00 20.00

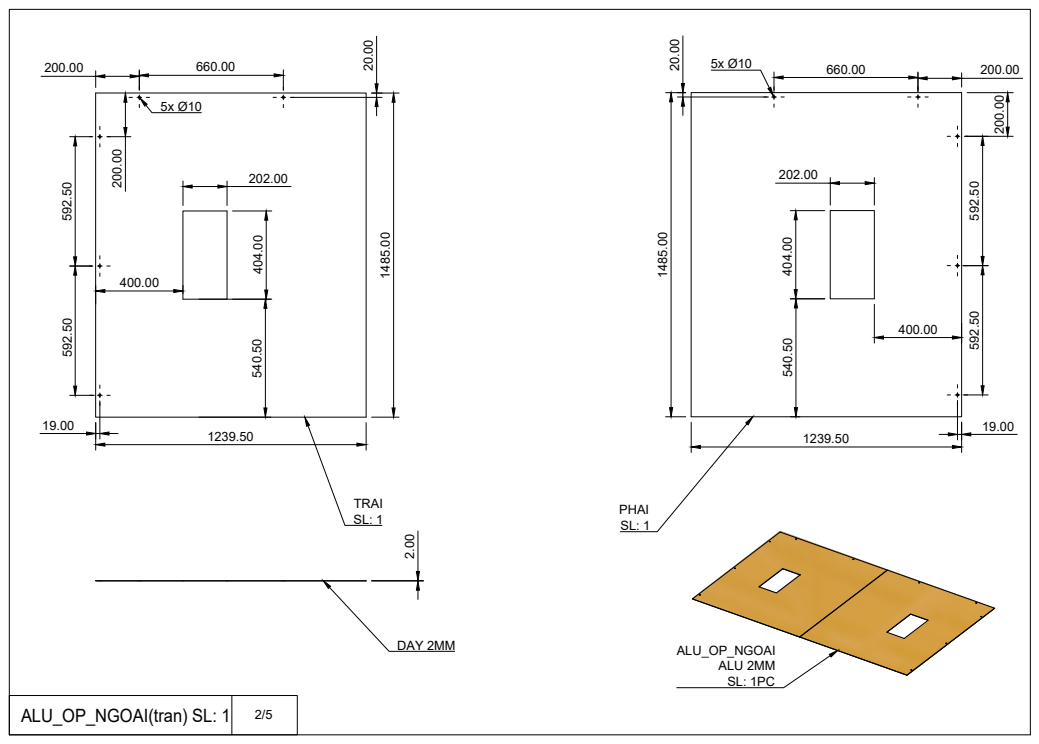
[picture p21: page 6]
ALU_OP_NGOAI(tran) SL: 1; ALU_OP_NGOAI ALU 2MM SL: 1PC; 400.00 ⁴⁰⁴.00; TRAI; PHAI; DAY 2MM

1239.50404.00
200.00200.00 592.50

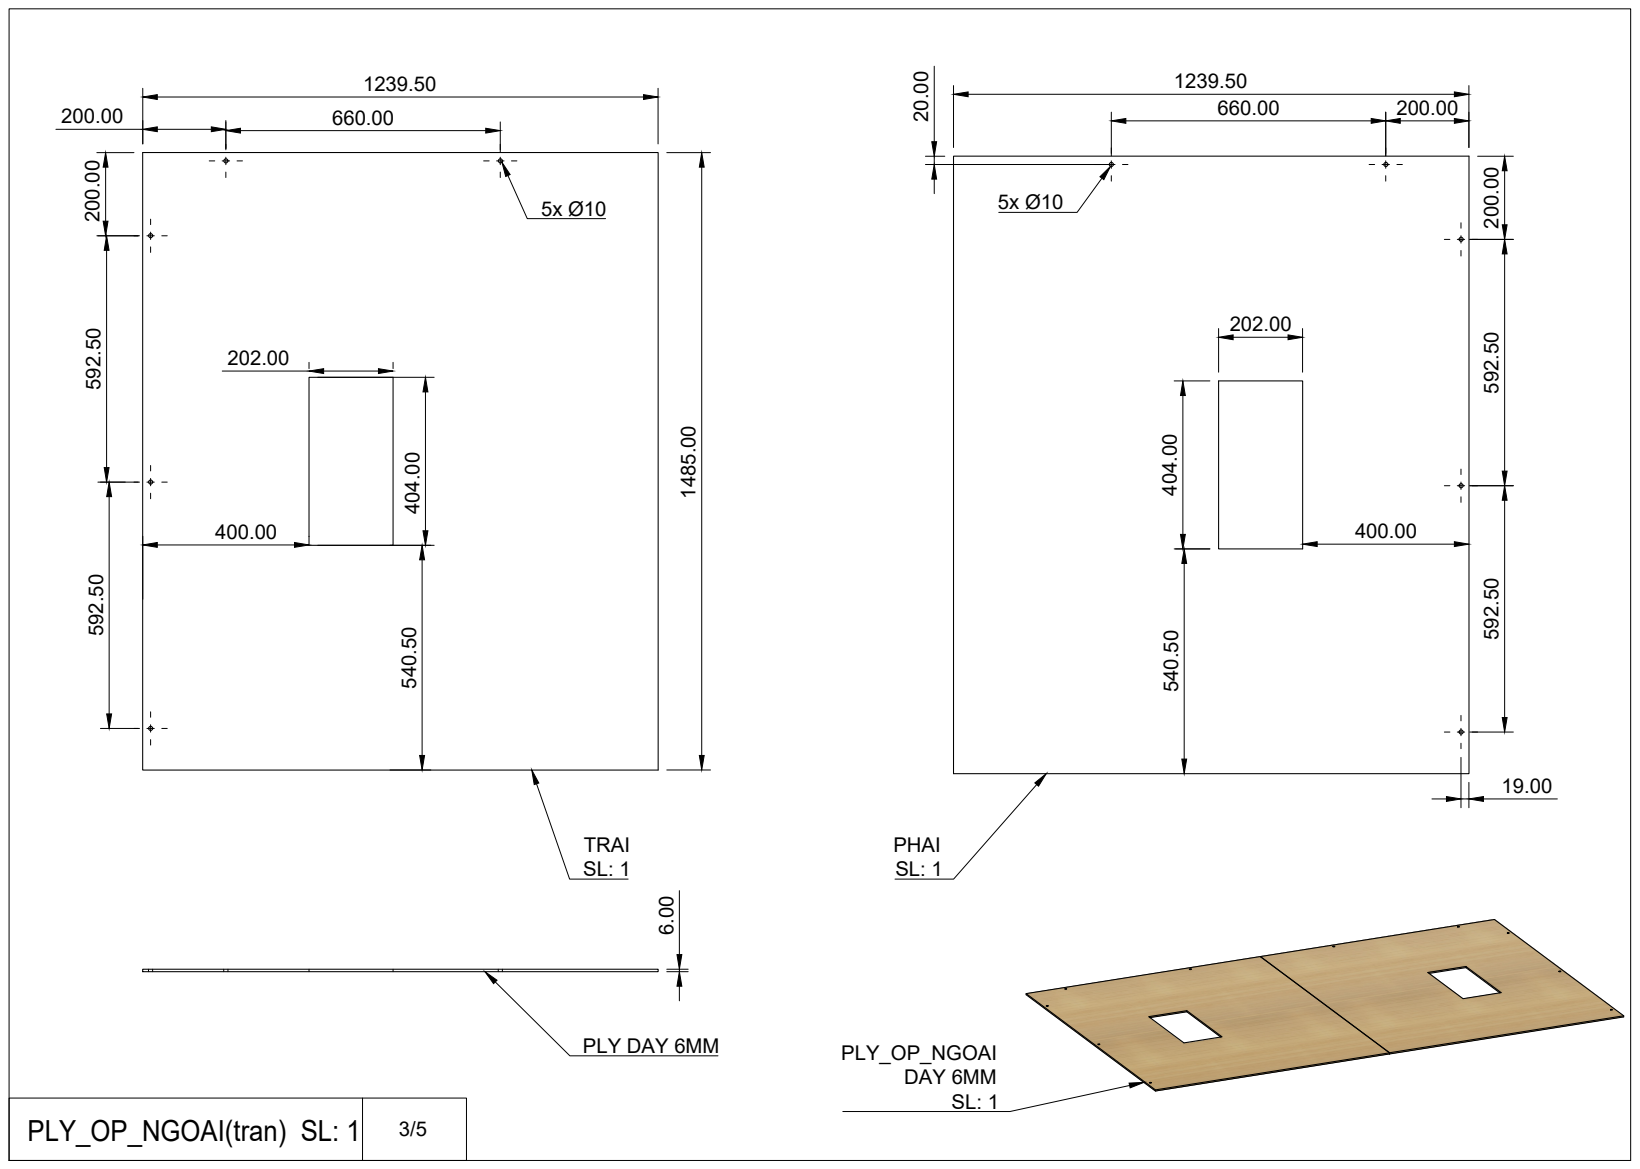
[picture p22: page 7]
PLY_OP_NGOAI(tran) SL: 1; PLY_OP_NGOAI DAY 6MM SL: 1; TRAI SL: 1; PHAI SL: 1 6.00; PLY DAY 6MM

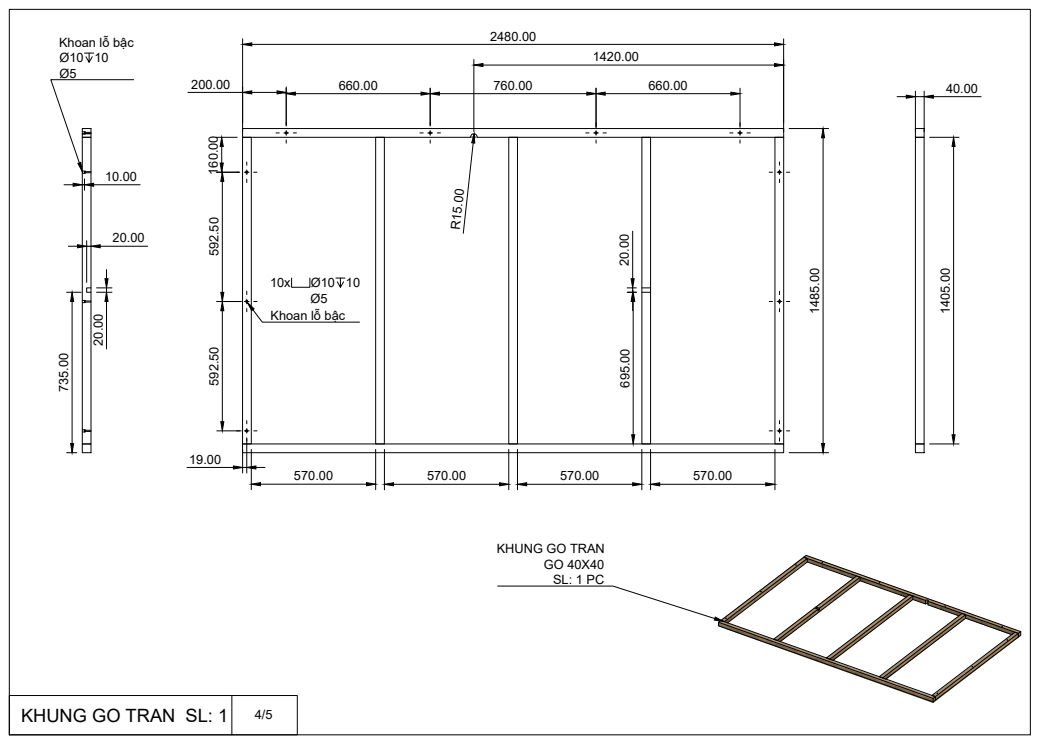
[picture p23: page 8]
KHUNG GO TRAN SL: 1; Khoan lỗ bậc Ø10 10 Ø5

Khoan lỗ bậc

KHUNG GO TRAN

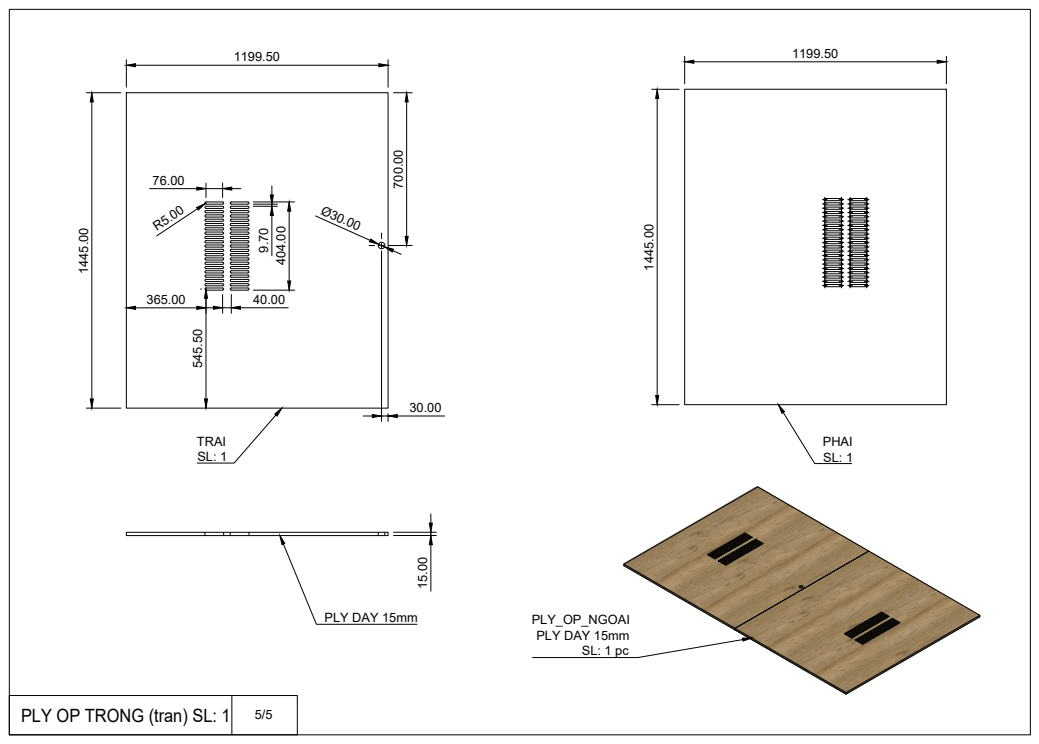
[picture p24: page 9]
PLY OP TRONG (tran) SL: 1; PLY DAY 15mm; TRAI SL: 1; PHAI SL: 1; PLY_OP_NGOAI PLY DAY 15mm SL: 1 pc

A (1:4) | A

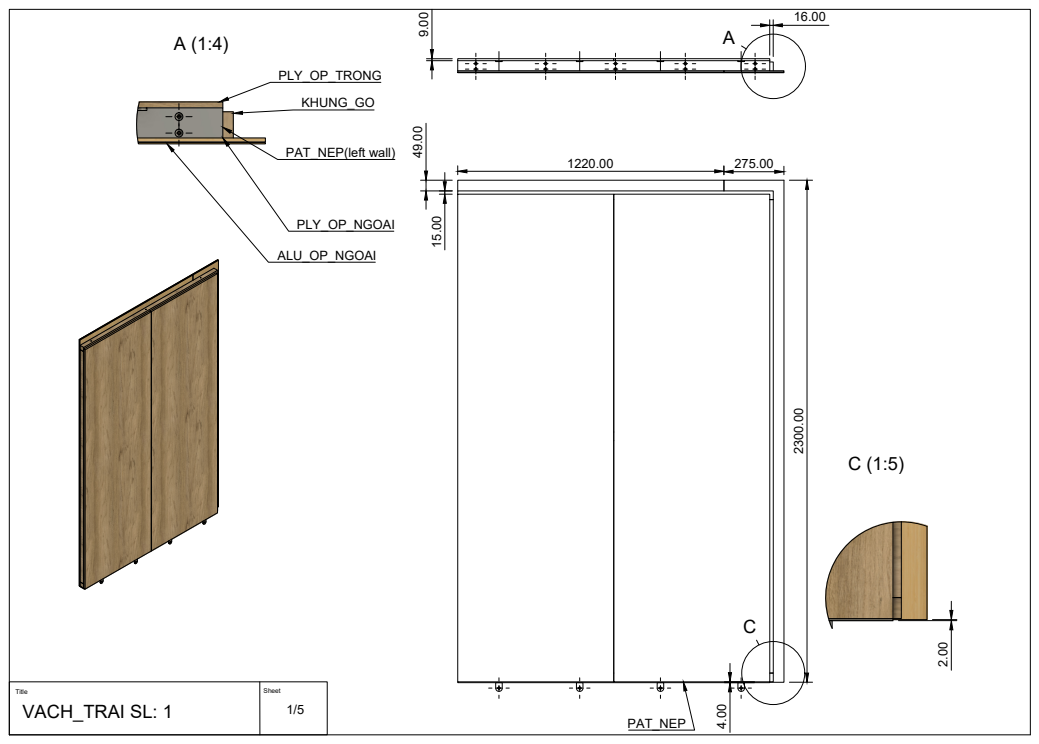
[picture p25: page 10]
Title; Sheet; VACH_TRAI SL: 1; PLY_OP_TRONG; KHUNG_GO; PAT_NEP(left wall); PLY_OP_NGOAI; ALU_OP_NGOAI; PAT_NEP

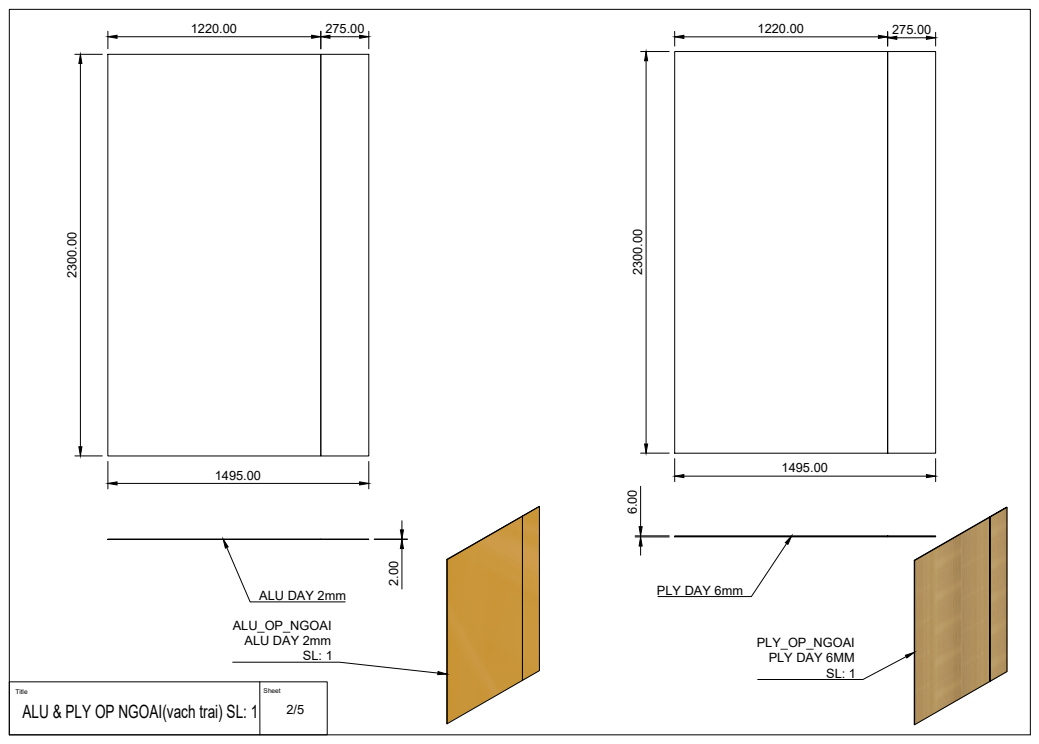
[picture p26: page 11]
Title; Sheet; ALU & PLY OP NGOAI(vach trai) SL: 1; ALU DAY 2mm; PLY DAY 6mm ⁶.00; ALU_OP_NGOAI ALU DAY 2mm SL: 1; PLY_OP_NGOAI PLY DAY 6MM SL: 1

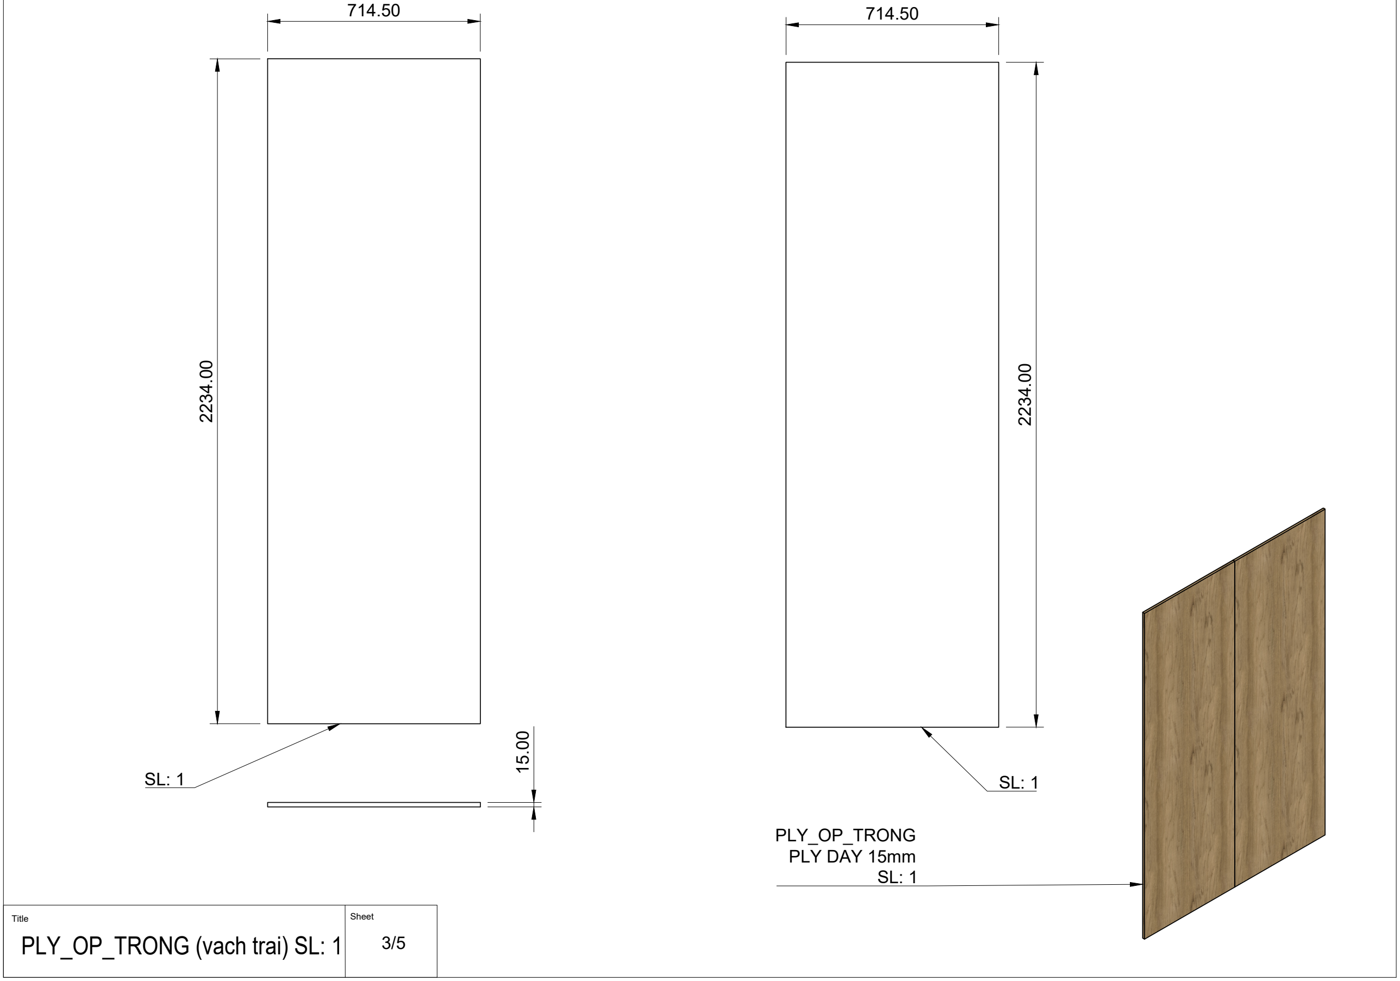
[picture p27: figure]
Title; Sheet; PLY_OP_TRONG (vach trai) SL: 1; PLY_OP_TRONG PLY DAY 15mm SL: 1

# 4x Ø5 ⁶⁵⁰.00 650.00 650.00 111.00 20.00

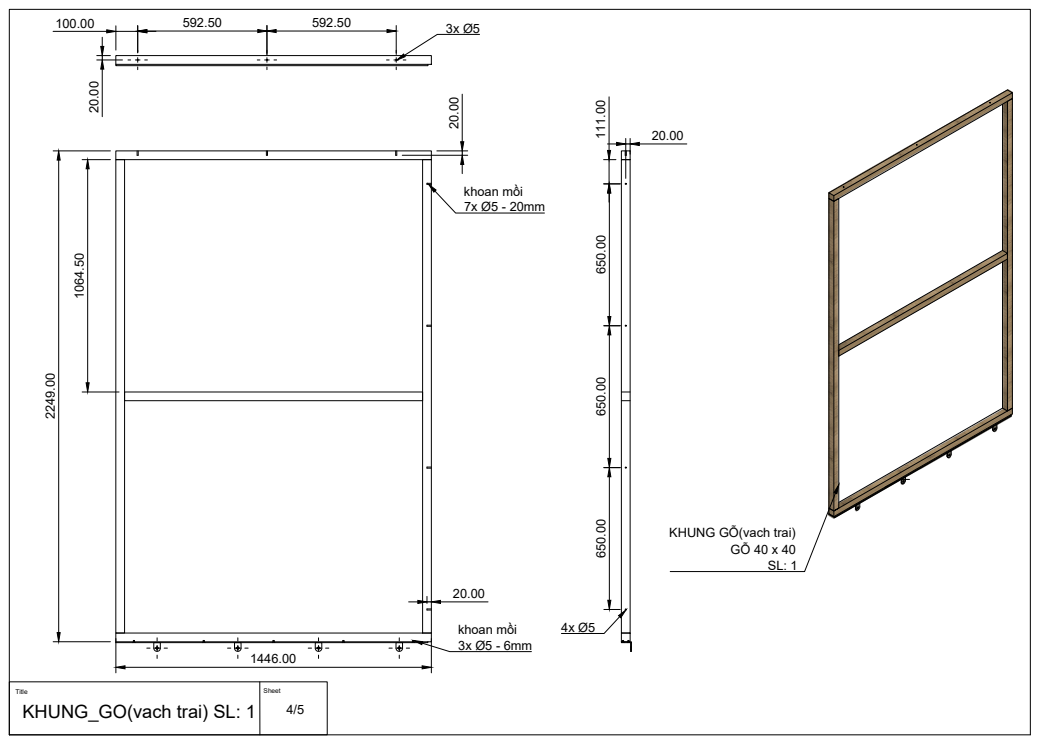
[picture p28: page 13]
Title; Sheet; KHUNG_GO(vach trai) SL: 1; 4/5 ¹⁰⁶⁴.50; 1446.00 ²²⁴⁹.00; khoan mồi 3x Ø5 - 6mm; khoan mồi 7x Ø5 - 20mm

KHUNG GỖ(vach trai)

B

B (1:2)

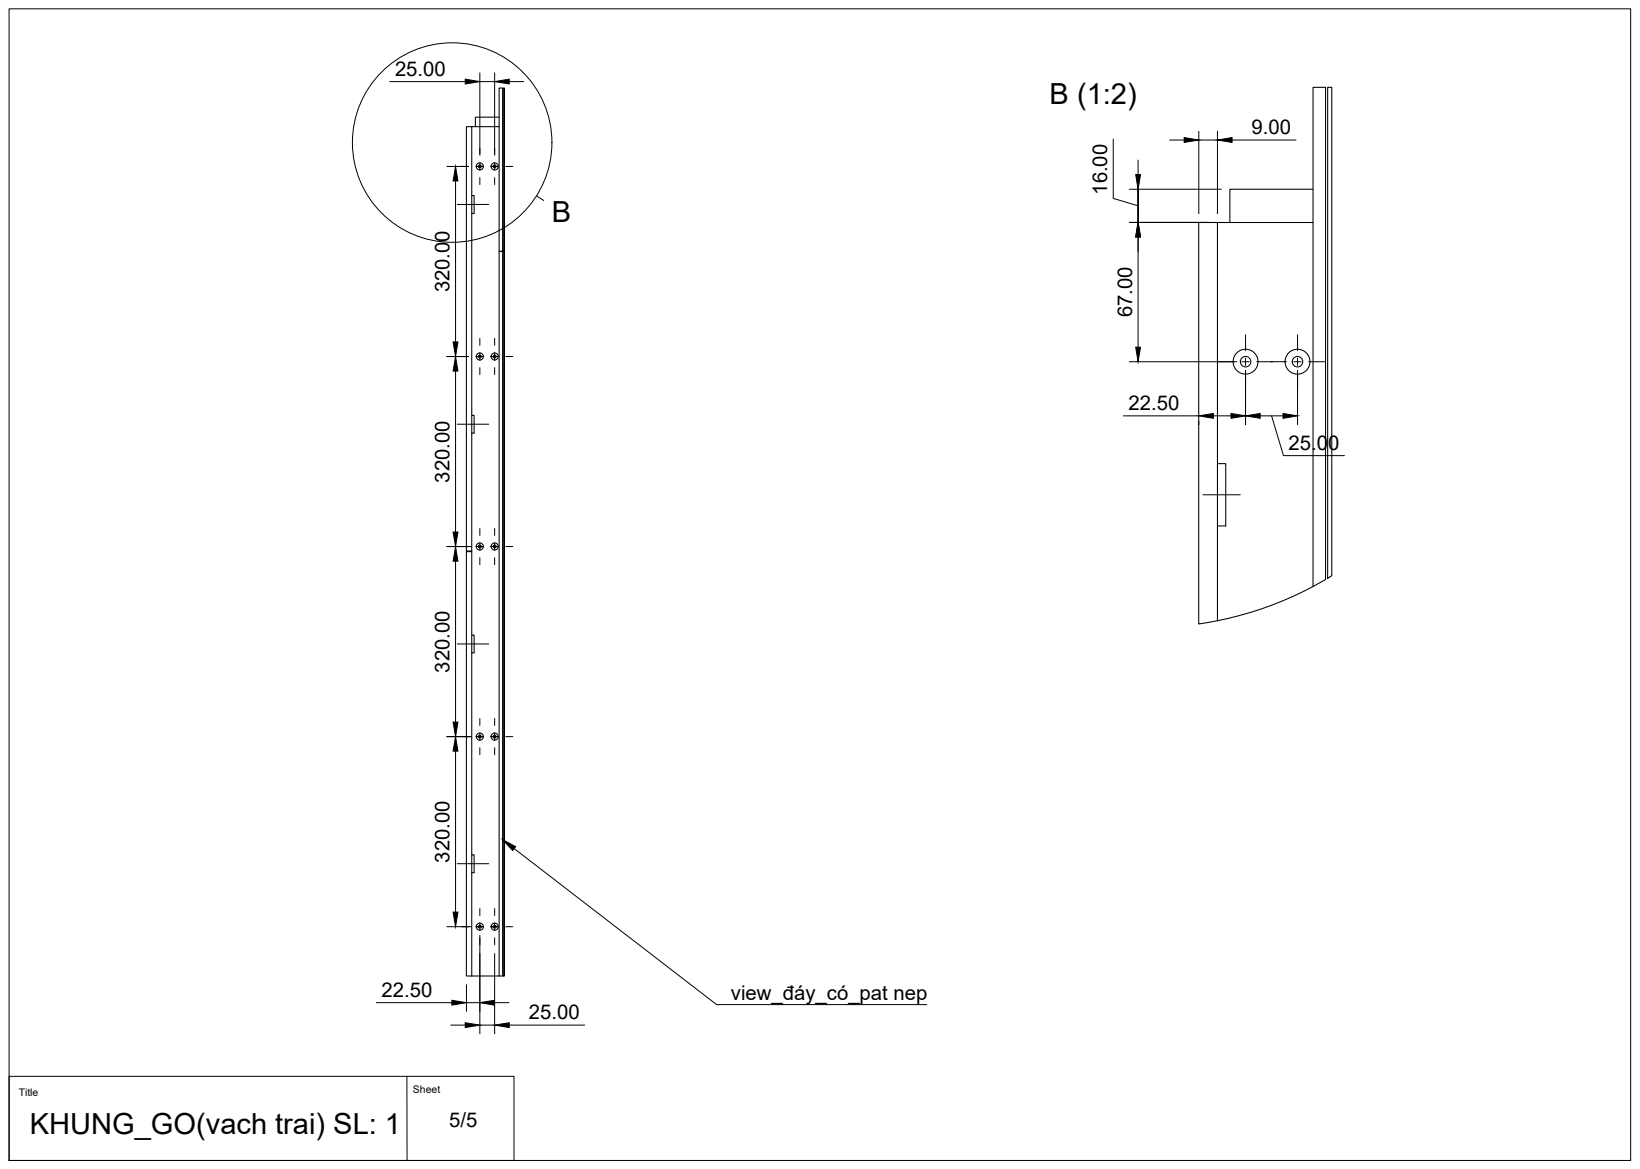
[picture p29: page 14]
Title; Sheet; KHUNG_GO(vach trai) SL: 1; view_đáy_có_pat nep ³²⁰.00 320.00 320.00 320.00

A

A (1:4)

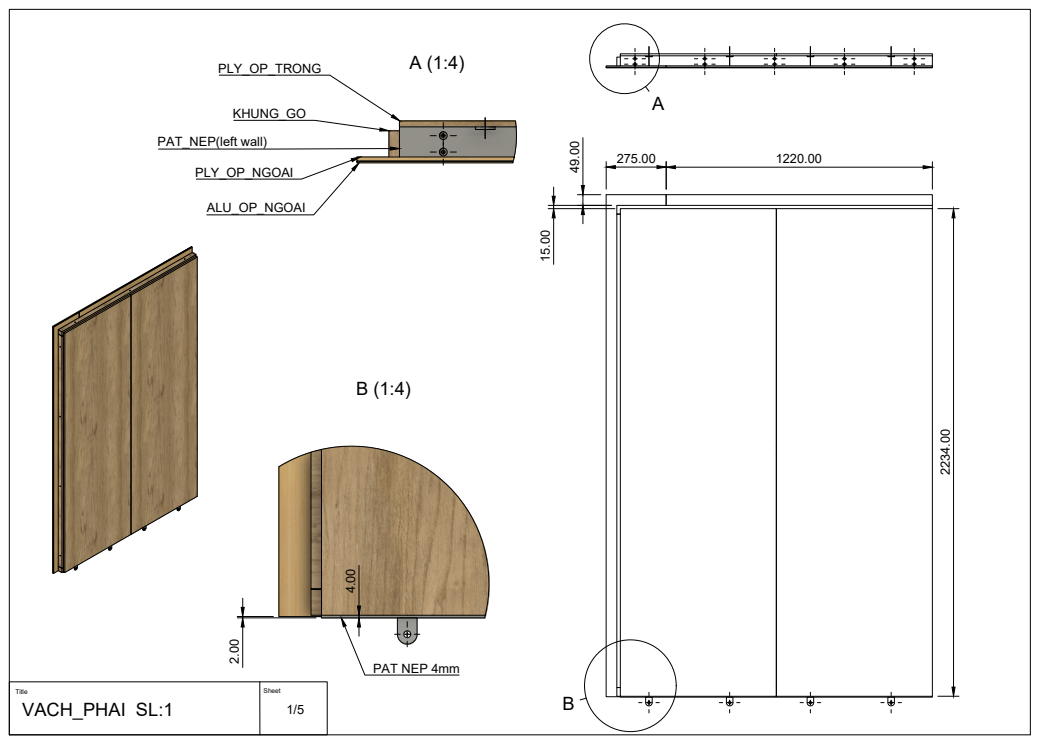
[picture p30: page 15]
Title; Sheet; VACH_PHAI SL:1; ALU_OP_NGOAI; PLY_OP_NGOAI; PAT_NEP(left wall); KHUNG_GO; PLY_OP_TRONG; PAT NEP 4mm ².00

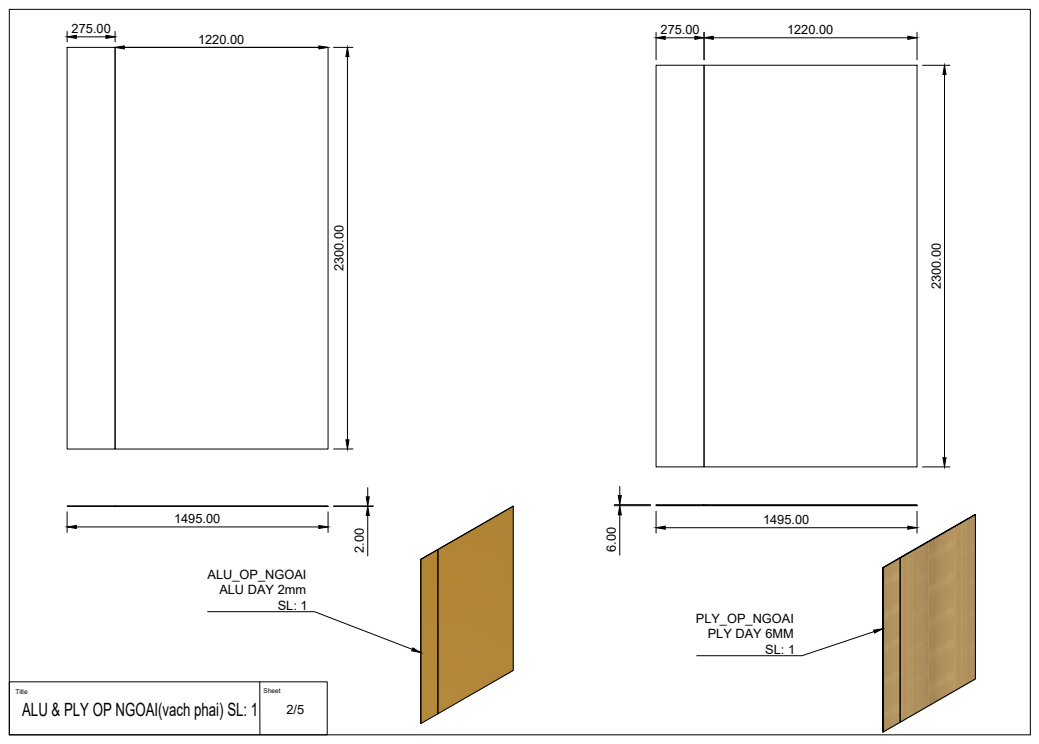
[picture p31: page 16]
Title; Sheet; ALU & PLY OP NGOAI(vach phai) SL: 1; ALU_OP_NGOAI ALU DAY 2mm SL: 1; PLY_OP_NGOAI PLY DAY 6MM SL: 1

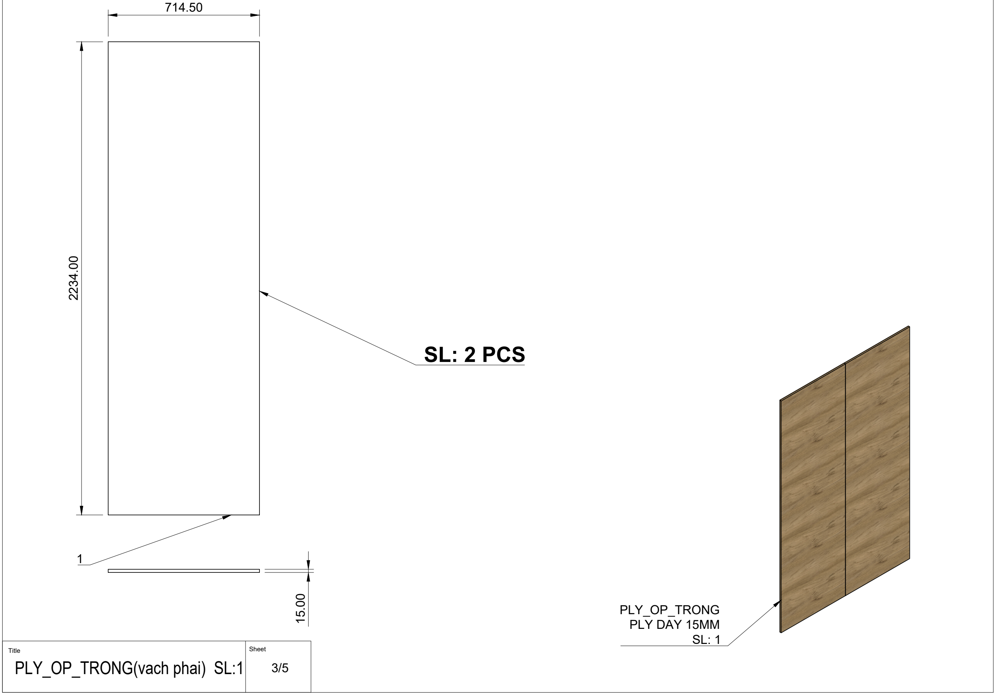
[picture p32: figure]
Title; Sheet; PLY_OP_TRONG(vach phai) SL:1; PLY_OP_TRONG; PLY DAY 15MM SL: 1; SL: 2 PCS

7x Ø5 650.00 650.00 650.00 111.00

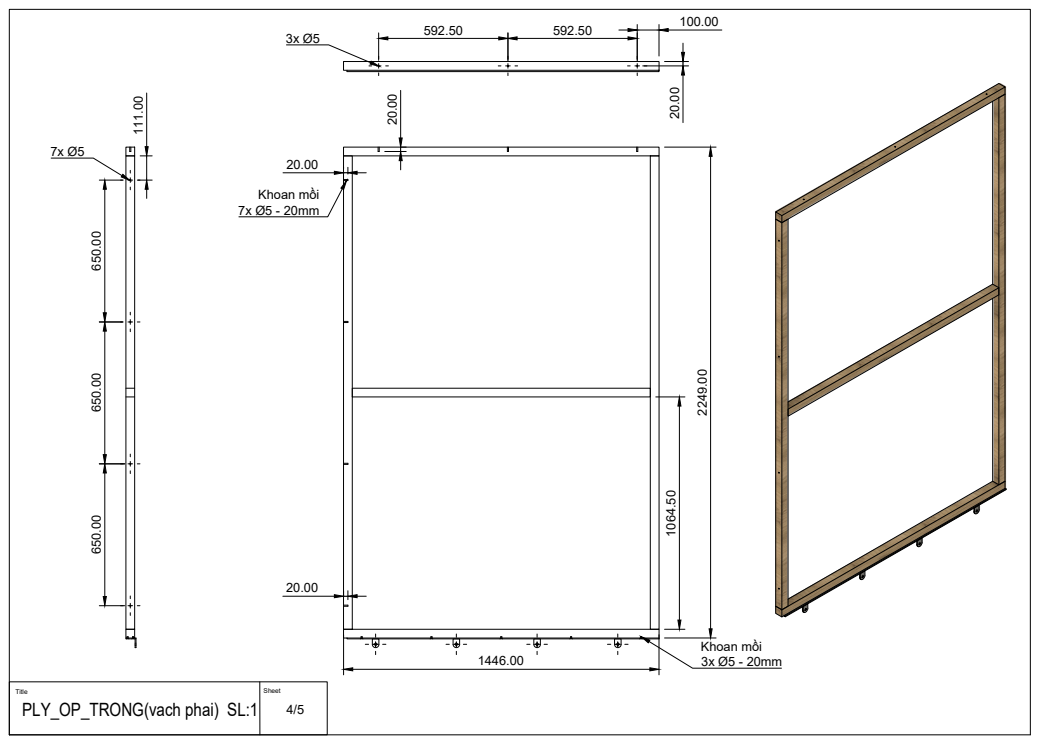
[picture p33: page 18]
Title; Sheet; PLY_OP_TRONG(vach phai) SL:1; Khoan mồi; Khoan mồi 3x Ø5 - 20mm

C

C (1:2)

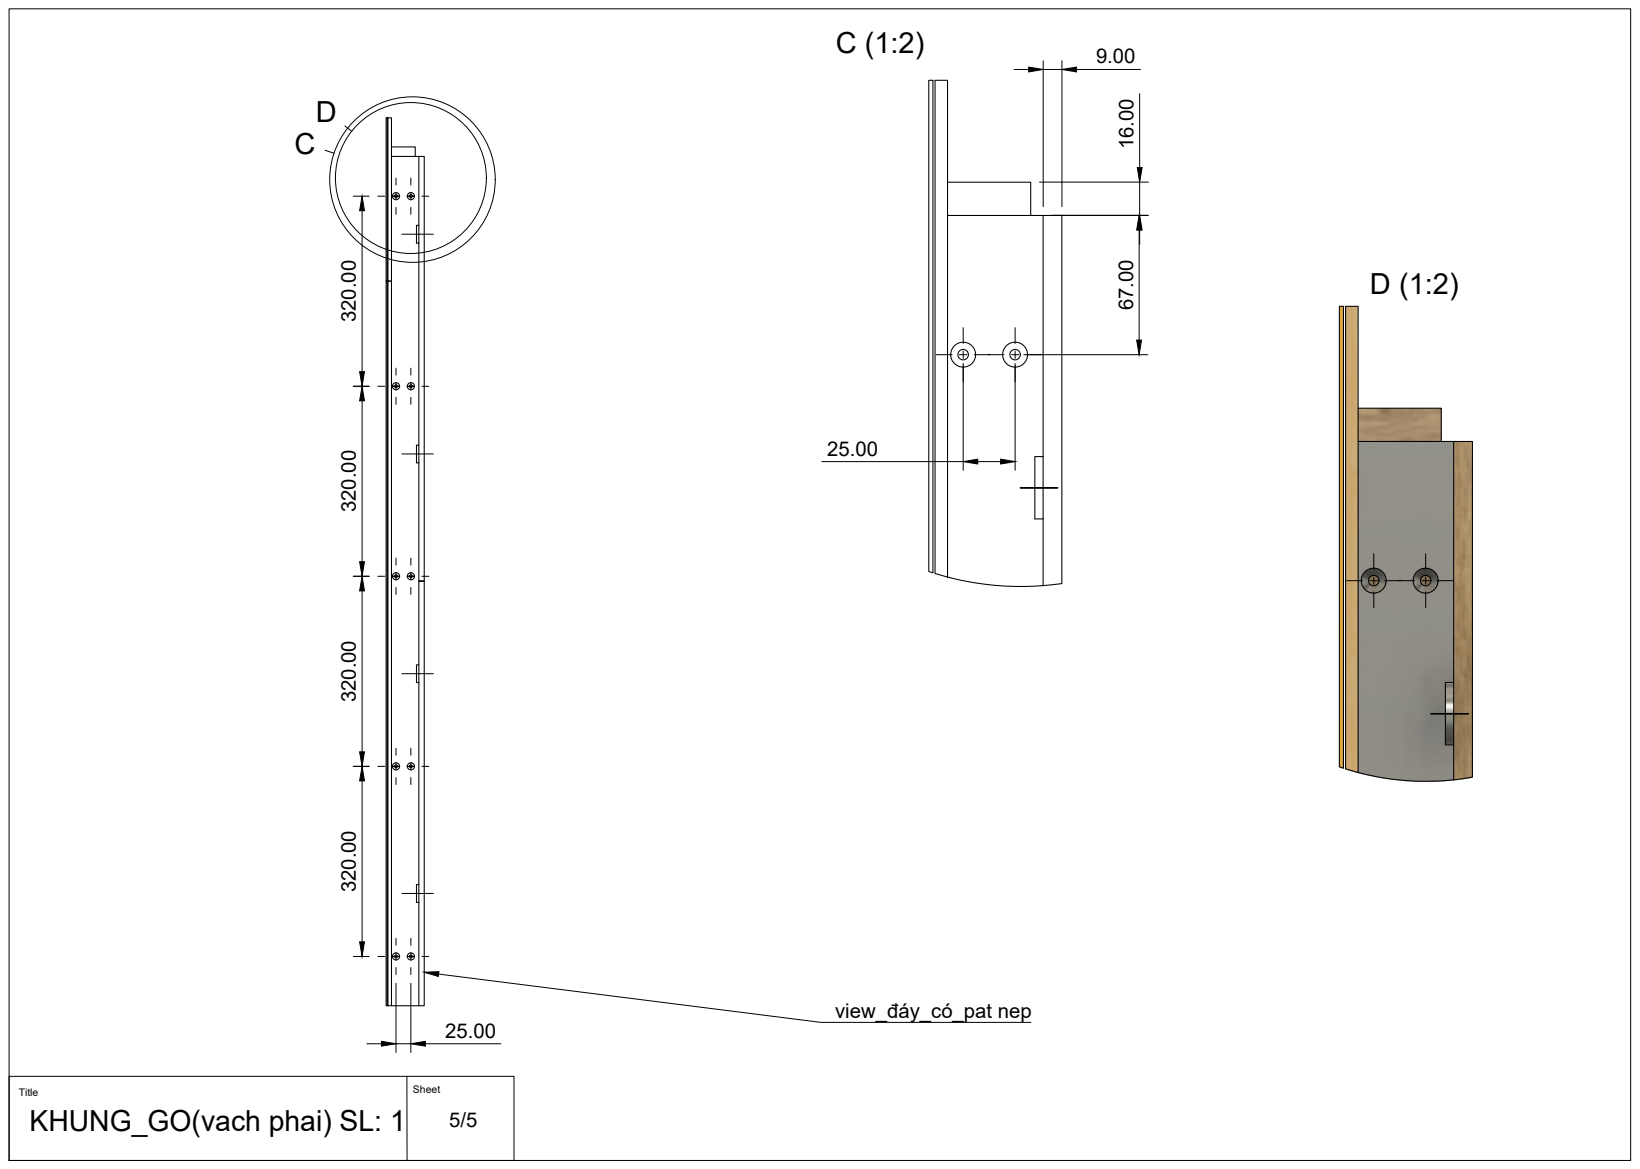
[picture p34: page 19]
Title; Sheet; KHUNG_GO(vach phai) SL: 1; view_đáy_có_pat nep ³²⁰.00 320.00 320.00 320.00

40.00 4.00

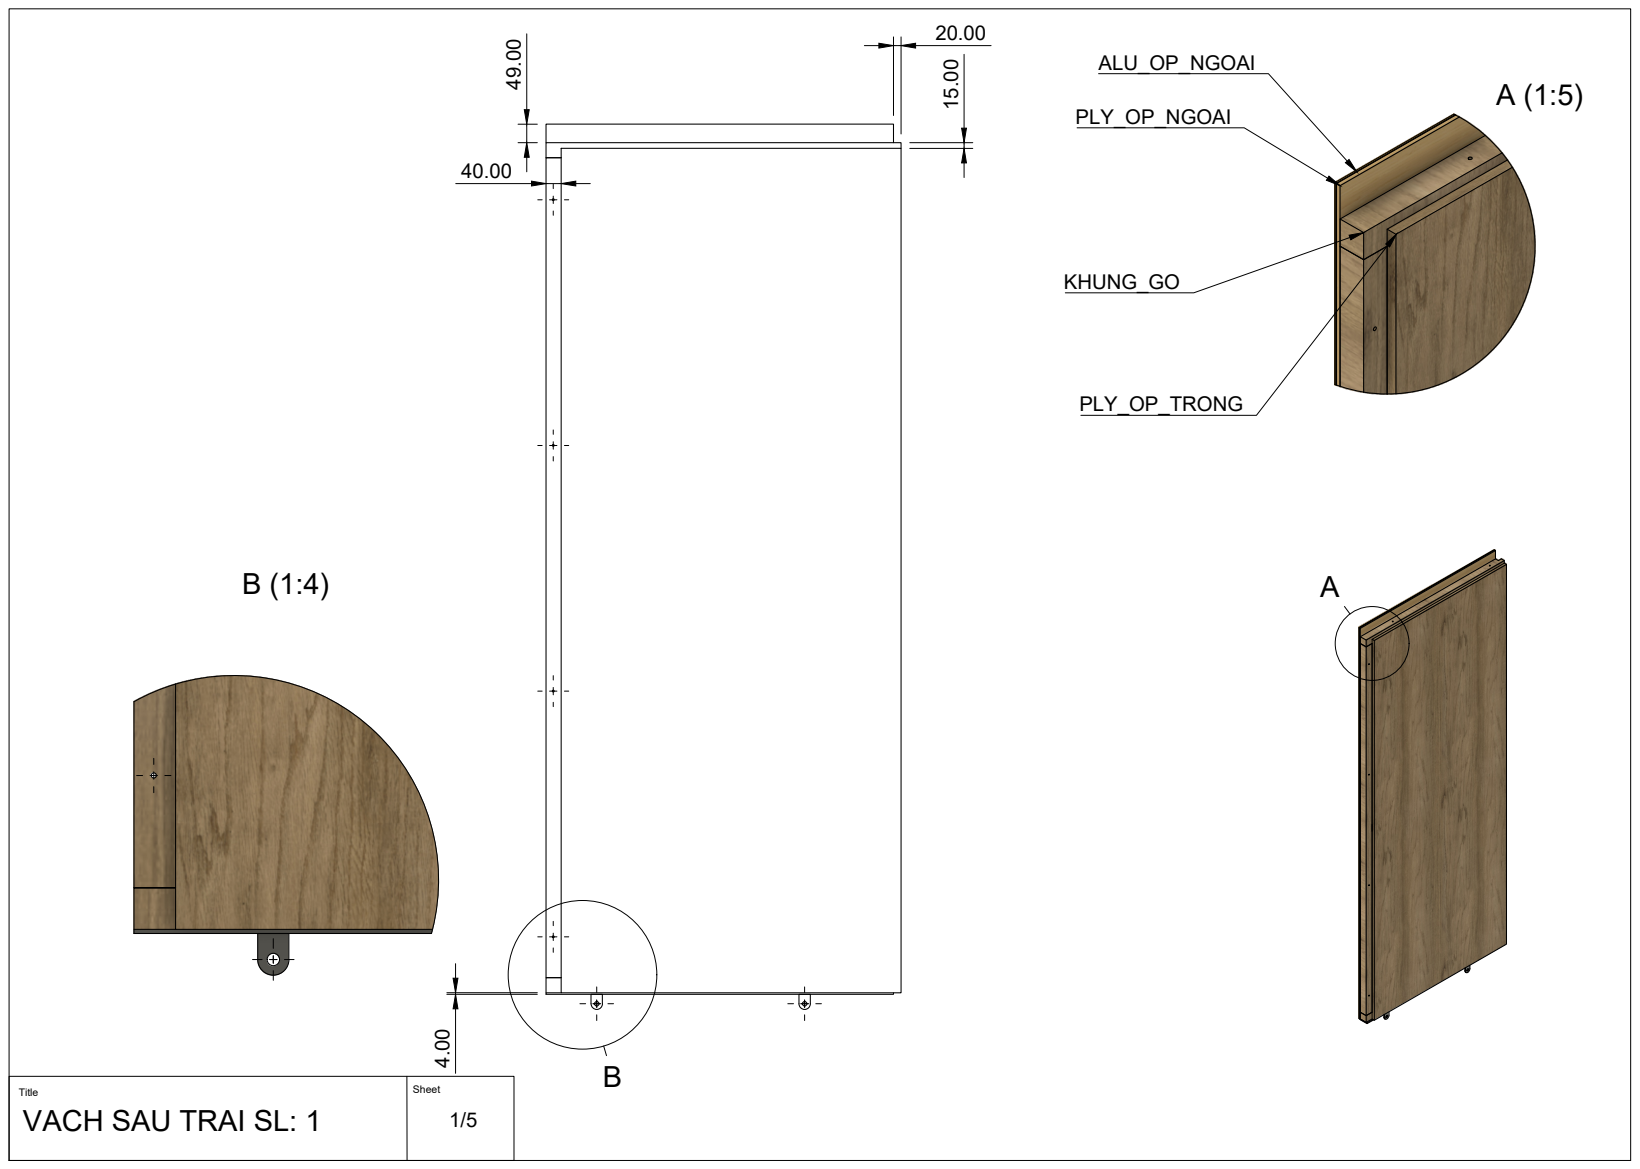
[picture p35: page 20]
Title; Sheet; VACH SAU TRAI SL: 1; A (1:5) PLY_OP_NGOAI; KHUNG_GO; PLY_OP_TRONG; ALU_OP_NGOAI

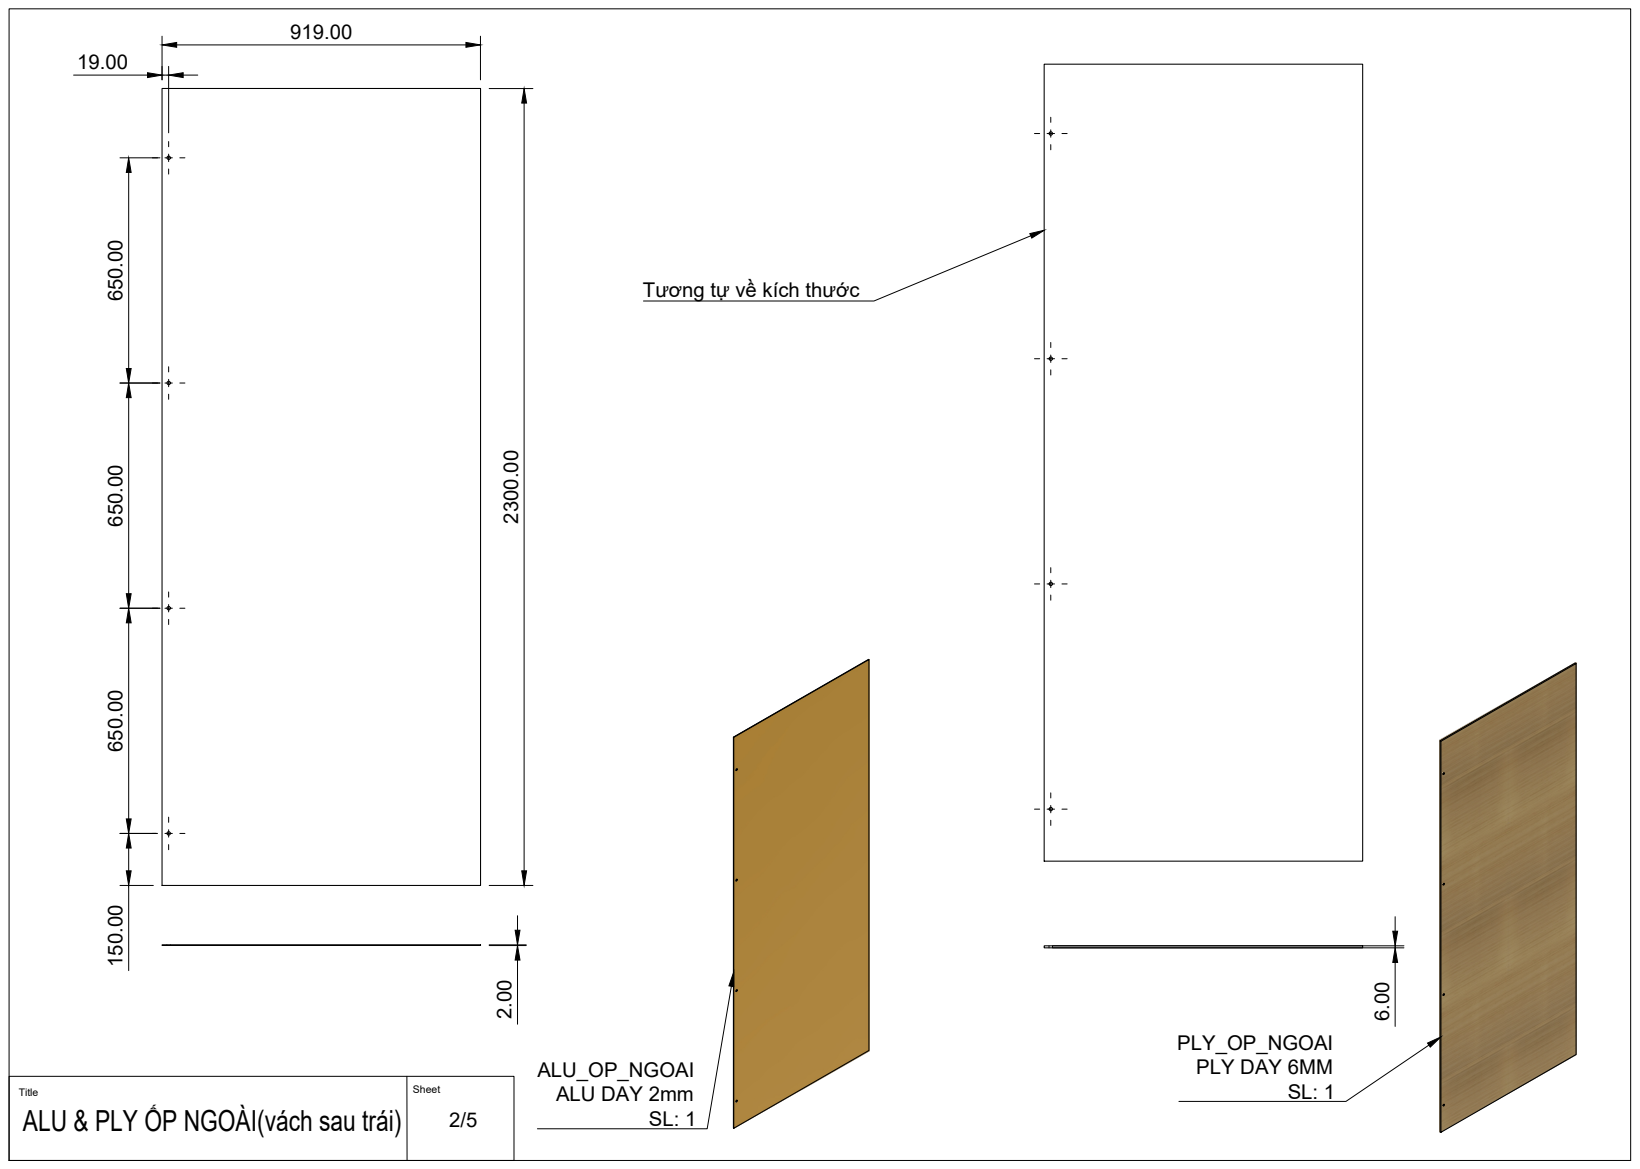
[picture p36: page 21]
Title; Sheet; ALU & PLY ỐP NGOÀI(vách sau trái); ALU_OP_NGOAI ALU DAY 2mm SL: 1; PLY_OP_NGOAI PLY DAY 6MM; SL: 1 ²³⁰⁰.00; Tương tự về kích thước 2.00

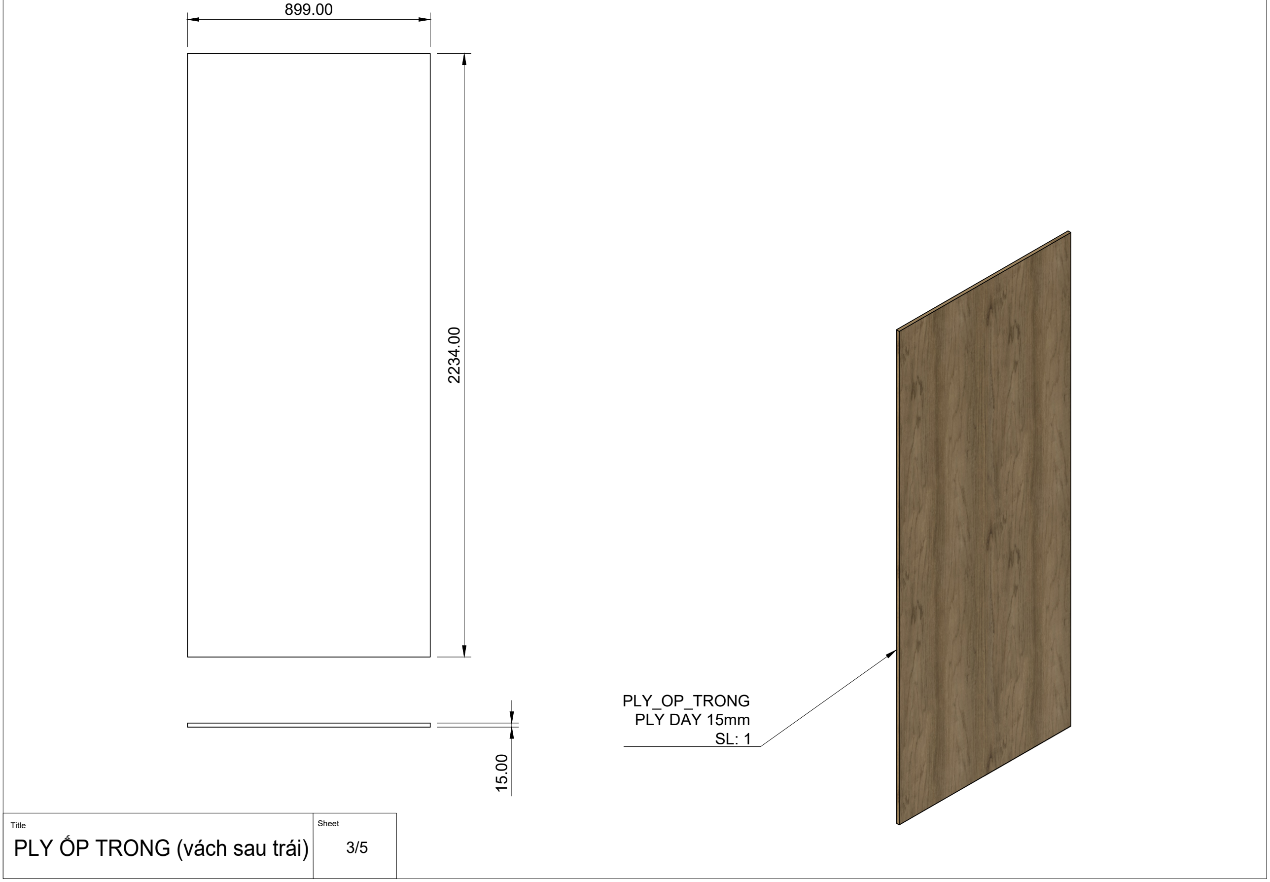
[picture p37: figure]
Title; Sheet; PLY_OP_TRONG PLY DAY 15mm SL: 1

PLY ỐP TRONG (vách sau trái) | 3/5 | 2234.00

20.00 20.00
200.00 | 660.00 21.00 | 20.00 | 1064.50

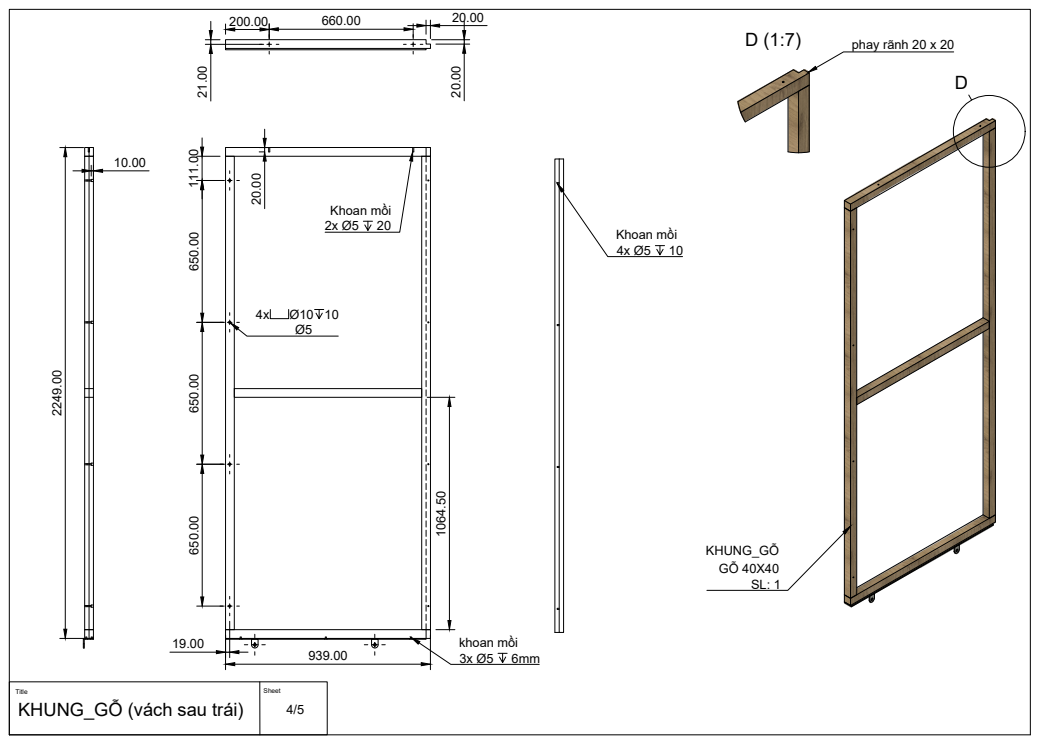
[picture p38: page 23]
Title; Sheet; KHUNG_GỖ (vách sau trái); KHUNG_GỖ GỖ 40X40 SL: 1; Khoan mồi; khoan mồi; phay rãnh 20 x 20 2249.00

C

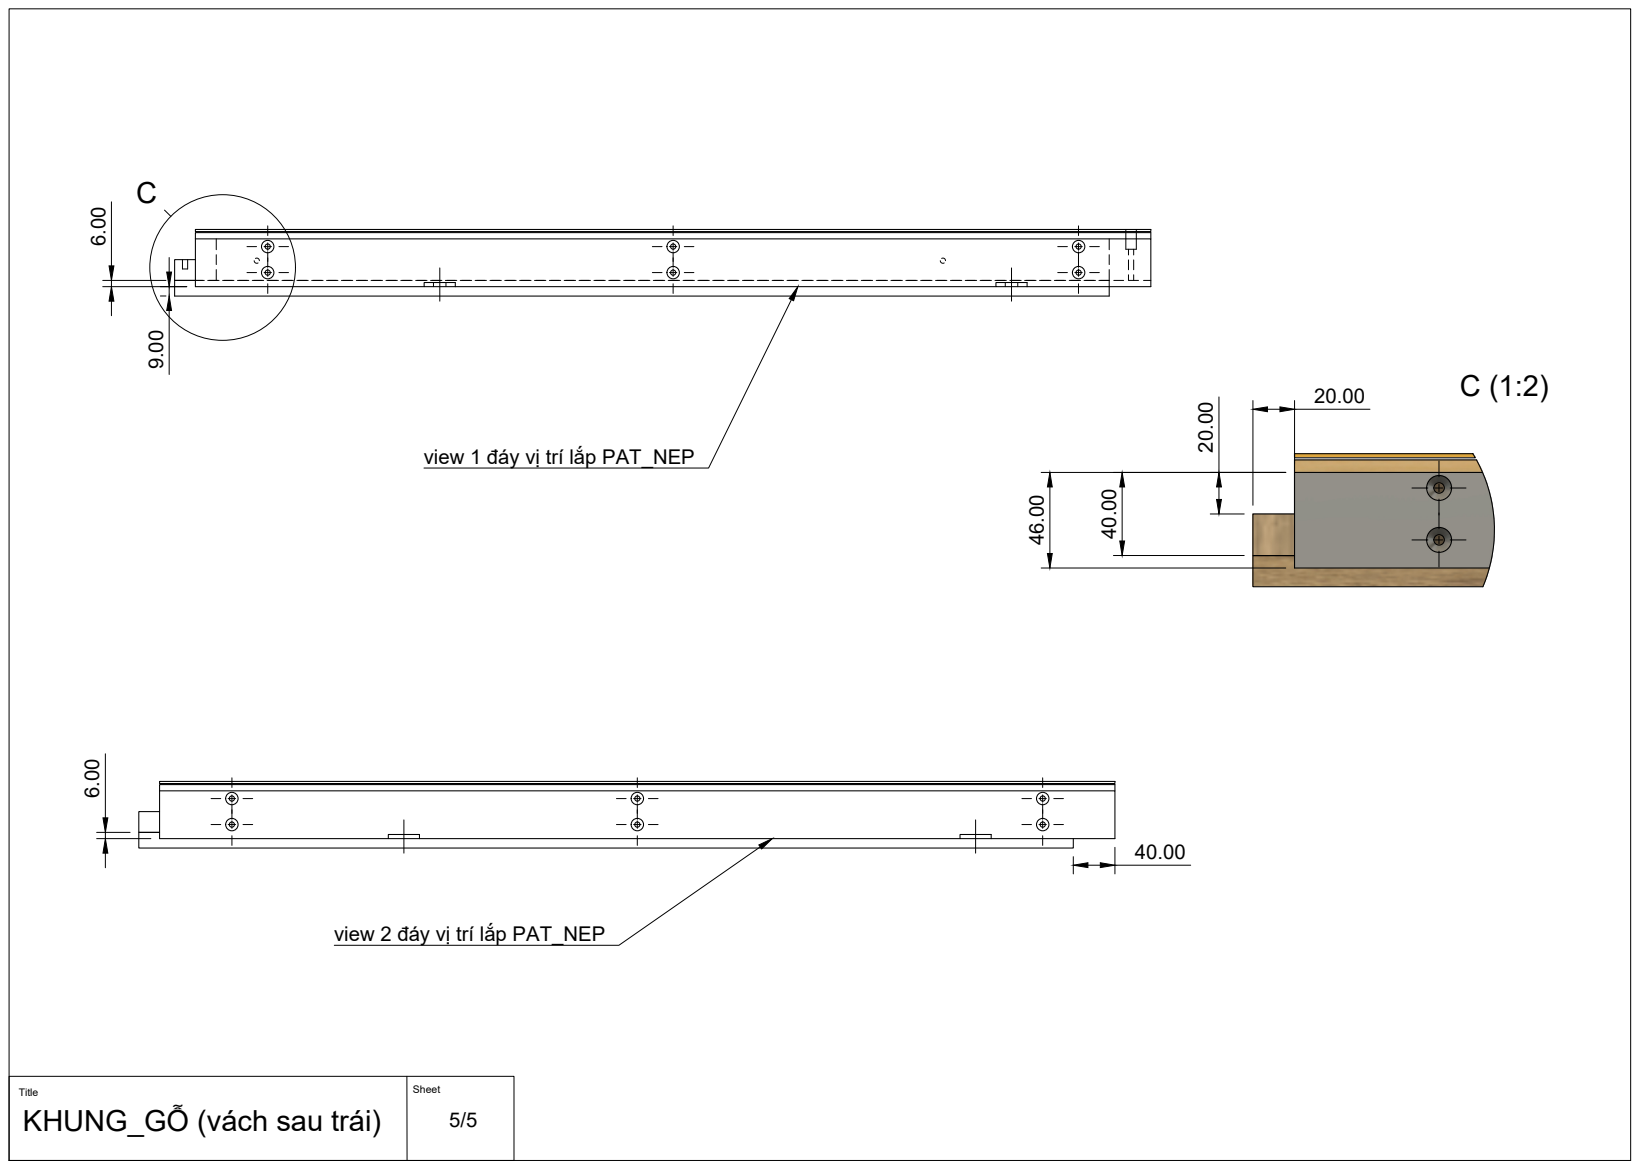
[picture p39: page 24]
Title; Sheet; KHUNG_GỖ (vách sau trái)

view 1 đáy vị trí lắp PAT_NEP

view 2 đáy vị trí lắp PAT_NEP

VACH SAU GIUA SL: 1 | 1/5 ⁴⁹.00 | 15.00
B

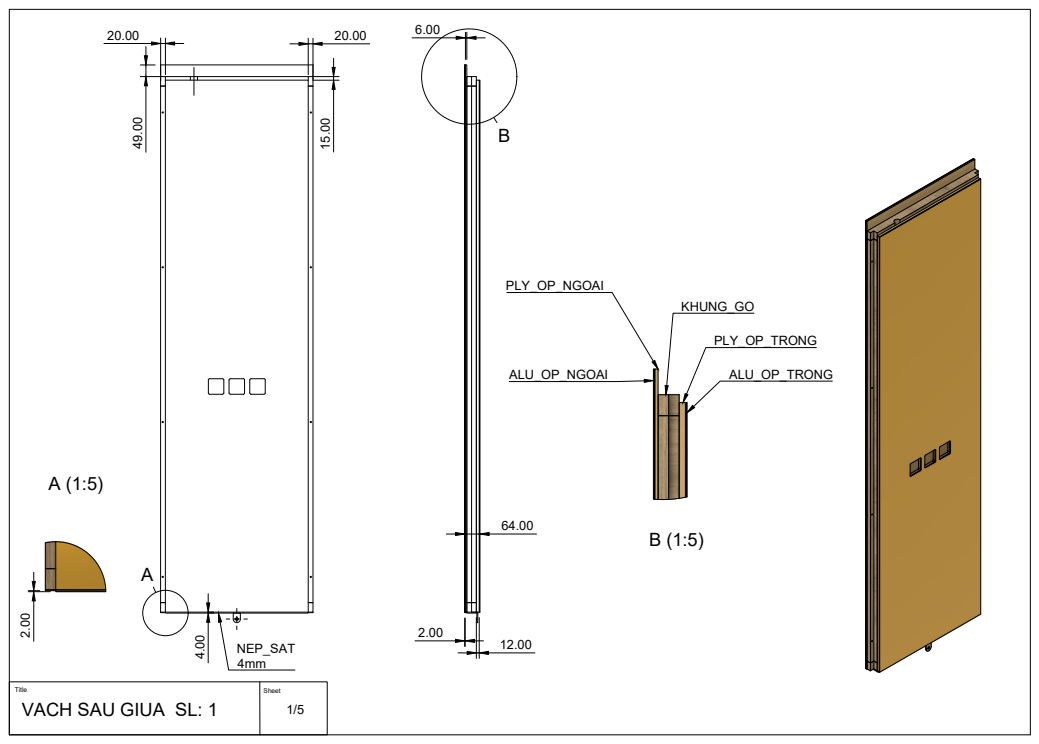
[picture p40: page 25]
Title; Sheet; NEP_SAT; PLY_OP_NGOAI; ALU_OP_NGOAI; KHUNG_GO; PLY_OP_TRONG; ALU_OP_TRONG

640.00 2300.00

# 8x Ø10 60.00 198.00 Ø27.00 Ø24.00

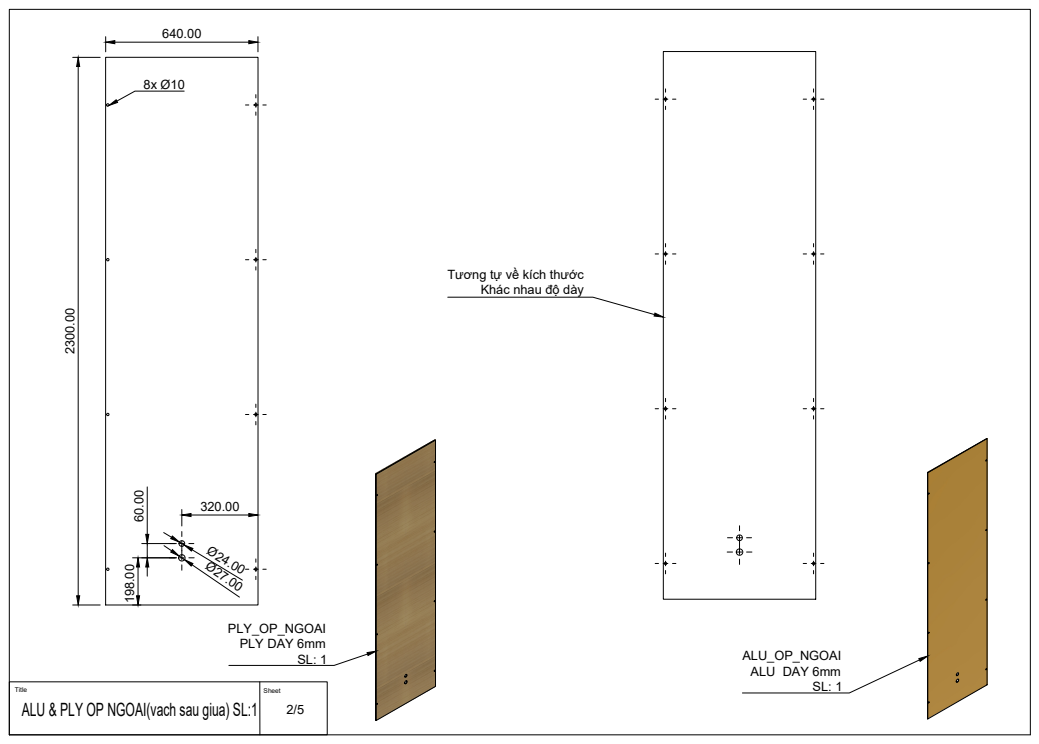
[picture p41: page 26]
Title; Sheet; ALU & PLY OP NGOAI(vach sau giua) SL:1; PLY_OP_NGOAI PLY DAY 6mm; ALU_OP_NGOAI; ALU DAY 6mm SL: 1

Tương tự về kích thước
Khác nhau độ dày

C

20.00 1064.50 2249.00

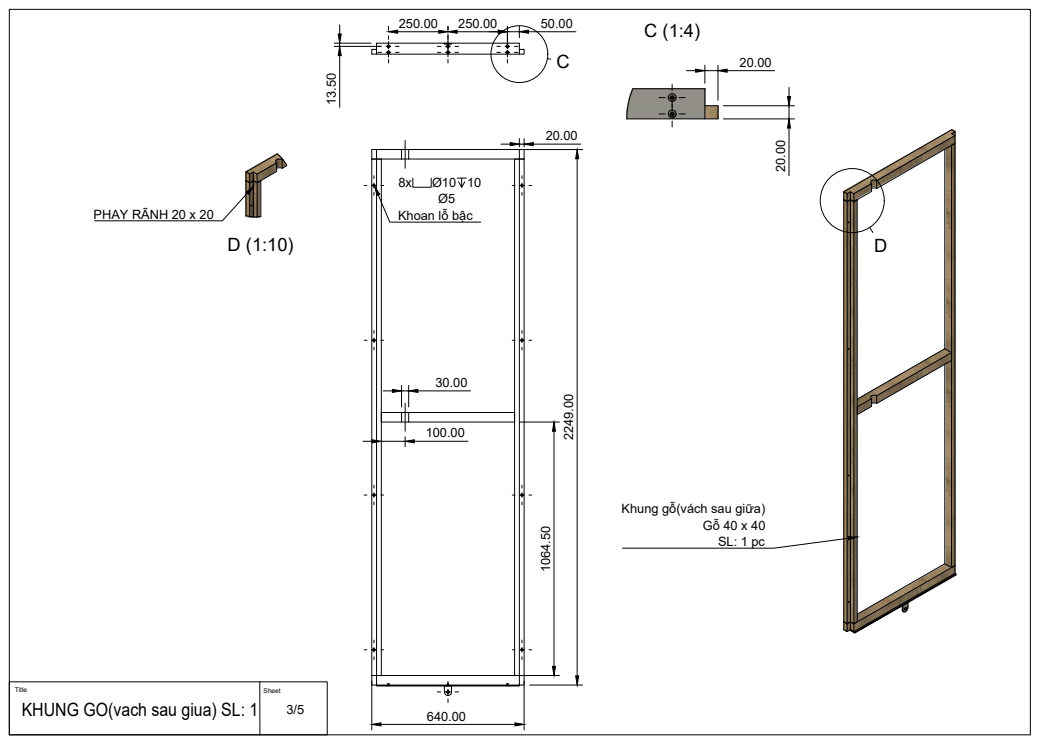
[picture p42: page 27]
Title; Sheet; KHUNG GO(vach sau giua) SL: 1; PHAY RÃNH 20 x 20

Khoan lỗ bậc

Khung gỗ(vách sau giữa)

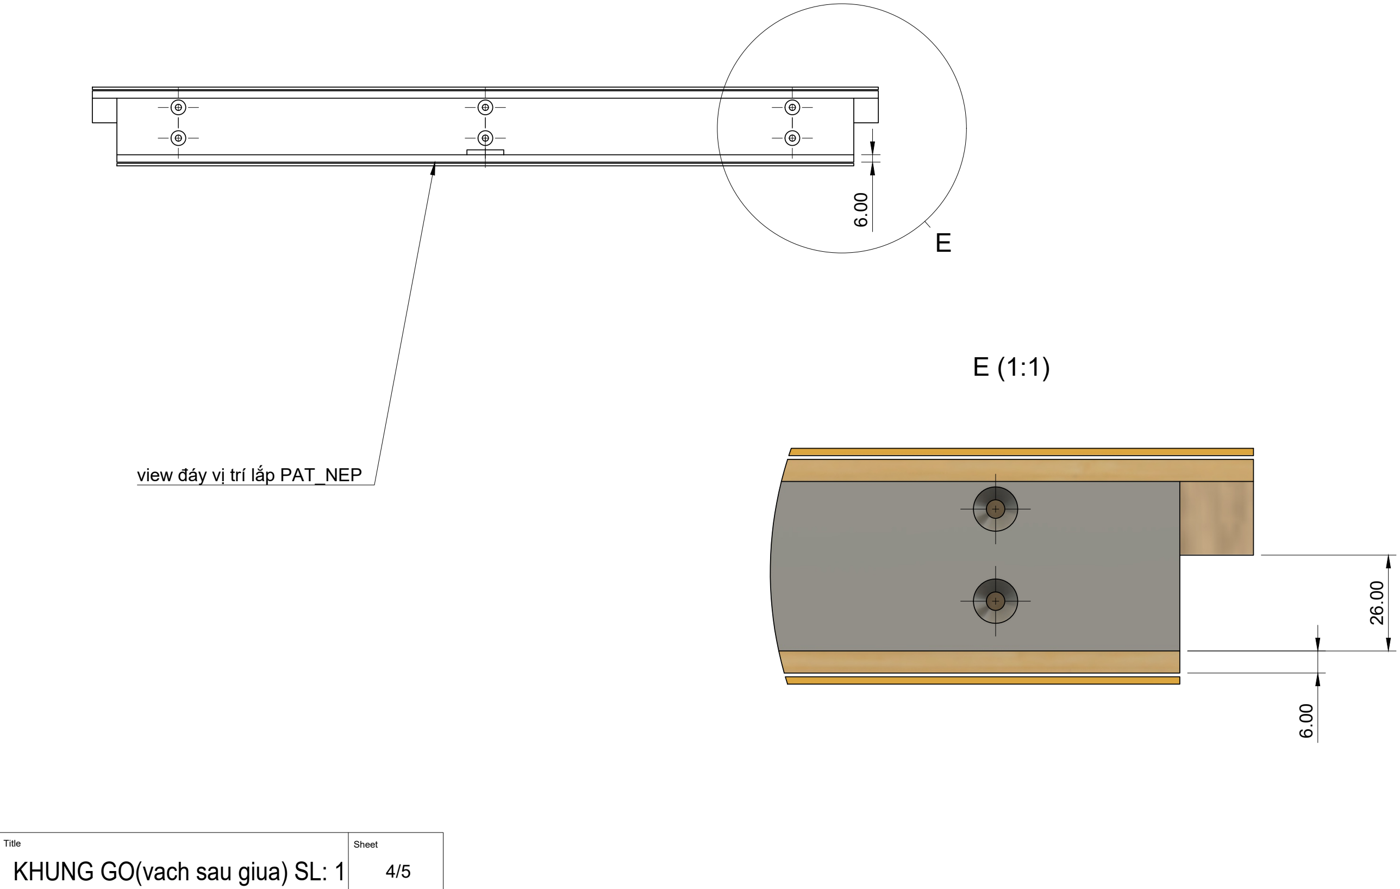
[picture p43: figure]
Title; Sheet; KHUNG GO(vach sau giua) SL: 1; view đáy vị trí lắp PAT_NEP
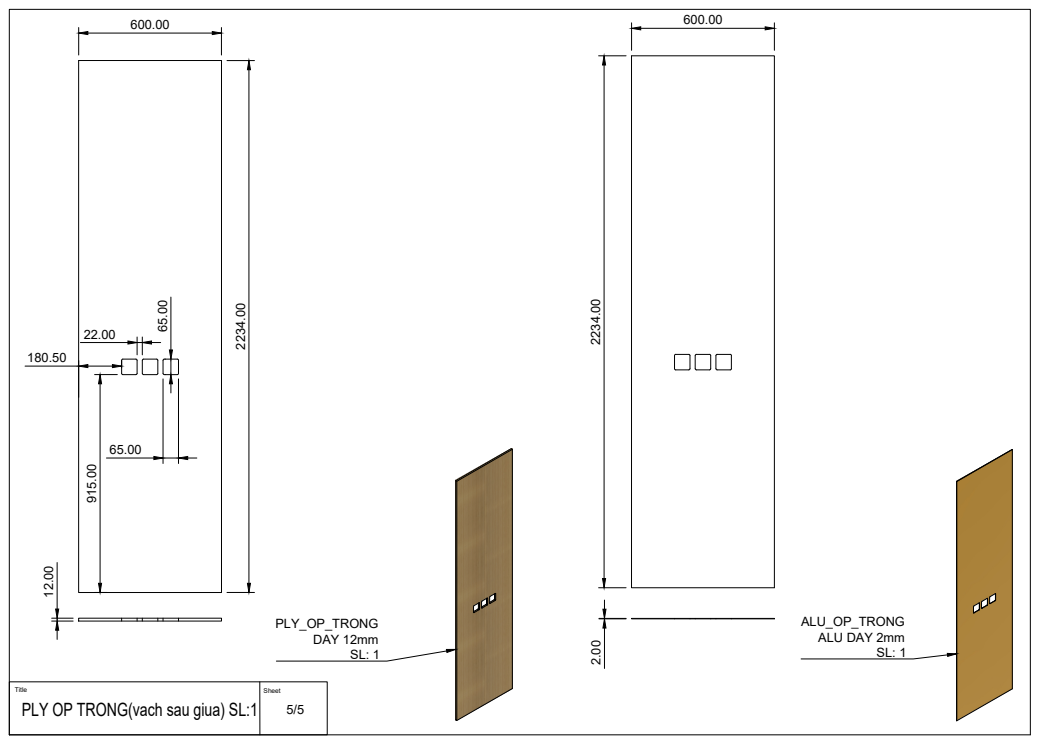
[picture p44: page 29]
Title; Sheet; PLY OP TRONG(vach sau giua) SL:1; 5/5 ²²³⁴.00; PLY_OP_TRONG DAY 12mm SL: 1; ALU_OP_TRONG ALU DAY 2mm SL: 1

VACH SAU PHAI SL: 1 | 1/5 | 15.00
A

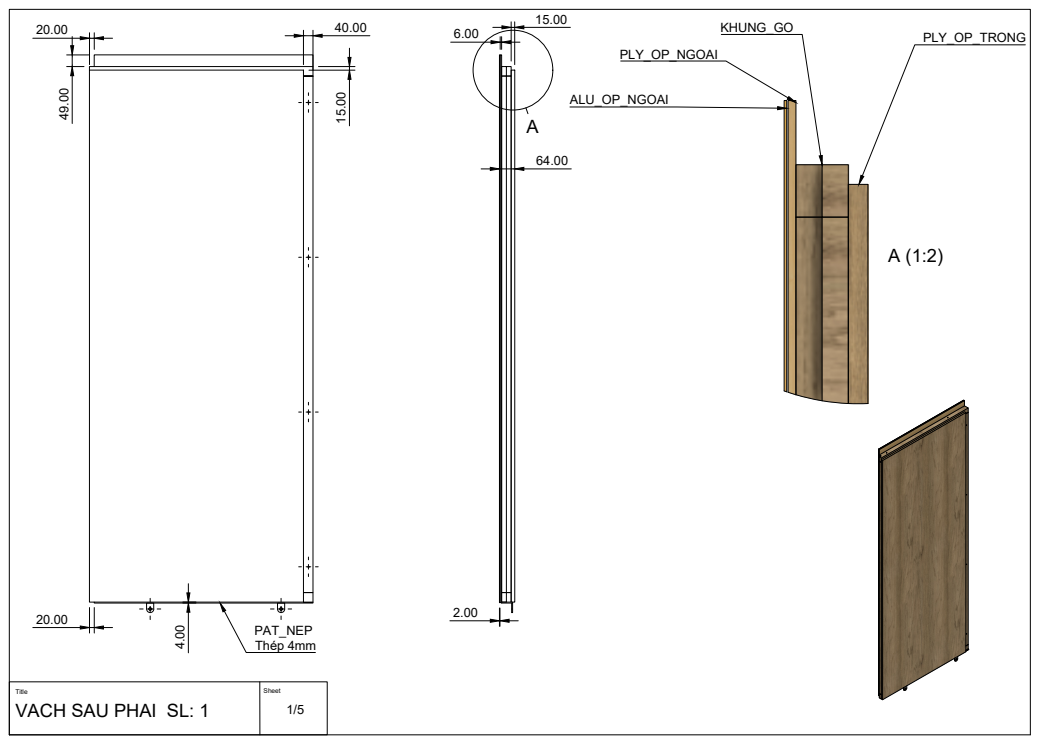
[picture p45: page 30]
Title; Sheet; PAT_NEP; Thép 4mm; ALU_OP_NGOAI; PLY_OP_NGOAI; KHUNG_GO; PLY_OP_TRONG

4x Ø10 200.00 650.00 650.00 650.00

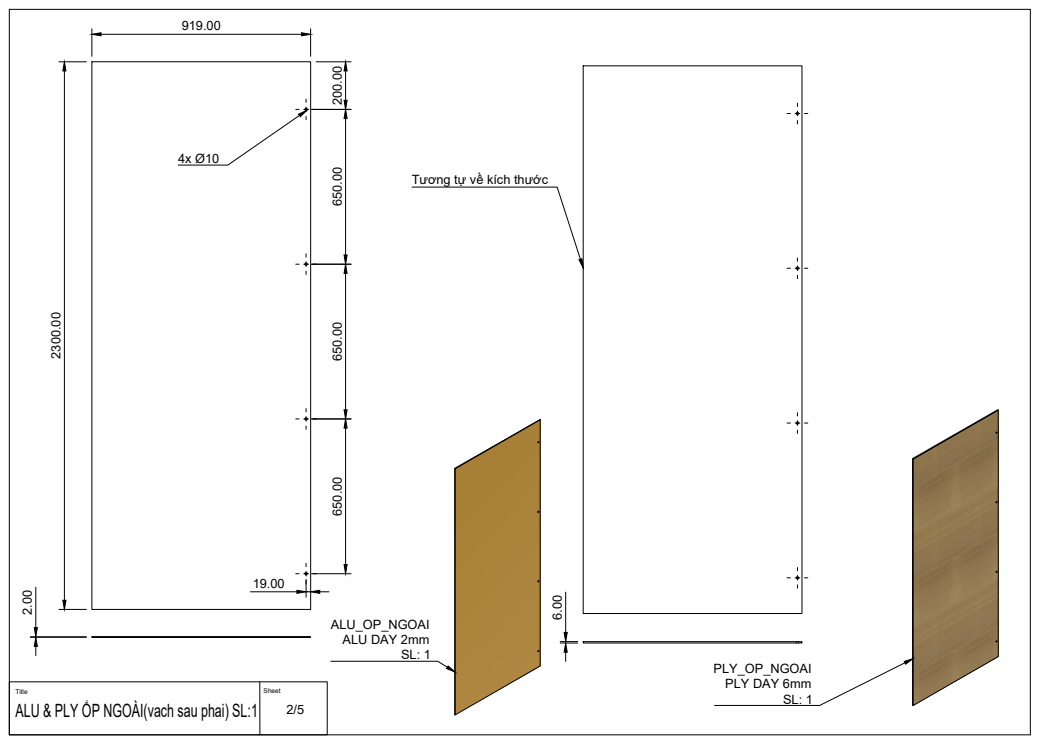
[picture p46: page 31]
Title; Sheet; ALU & PLY ỐP NGOÀI(vach sau phai) SL:1; ALU_OP_NGOAI ALU DAY 2mm; PLY_OP_NGOAI PLY DAY 6mm SL: 1

Tương tự về kích thước

20.00 20.00
2x Ø5 | 20 | 111.00 650.00 650.00 650.00

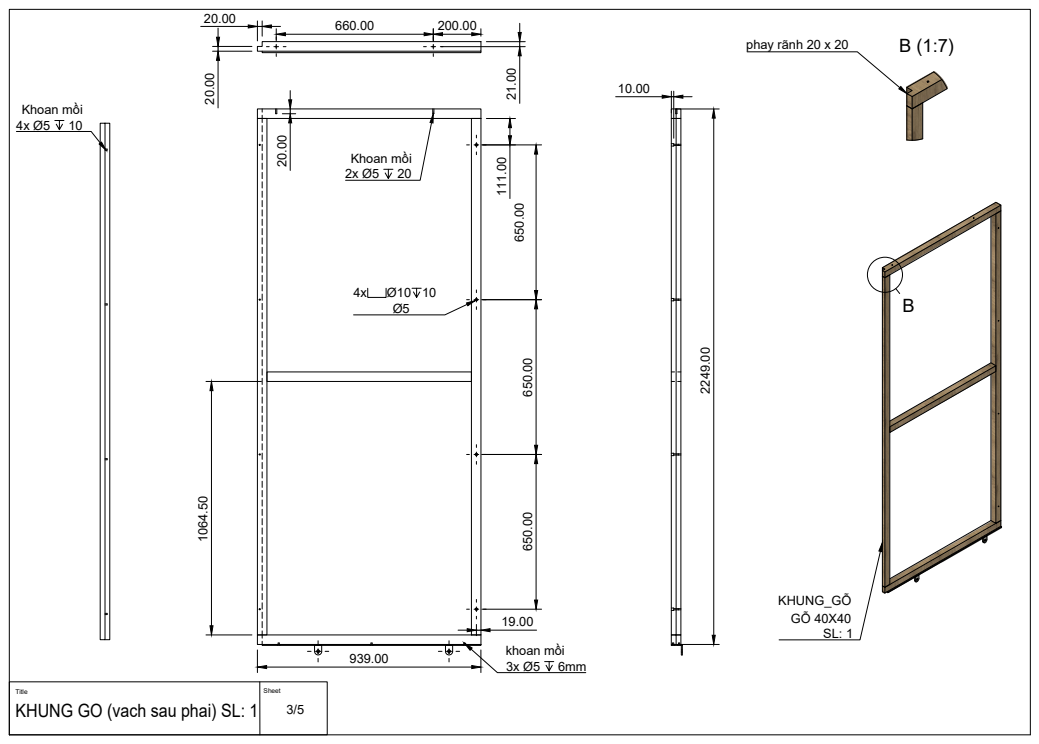
[picture p47: page 32]
Title; Sheet; KHUNG GO (vach sau phai) SL: 1; 3/5 ¹⁰⁶⁴.50; Khoan mồi; khoan mồi; KHUNG_GỖ GỖ 40X40 SL: 1; phay rãnh 20 x 20

C

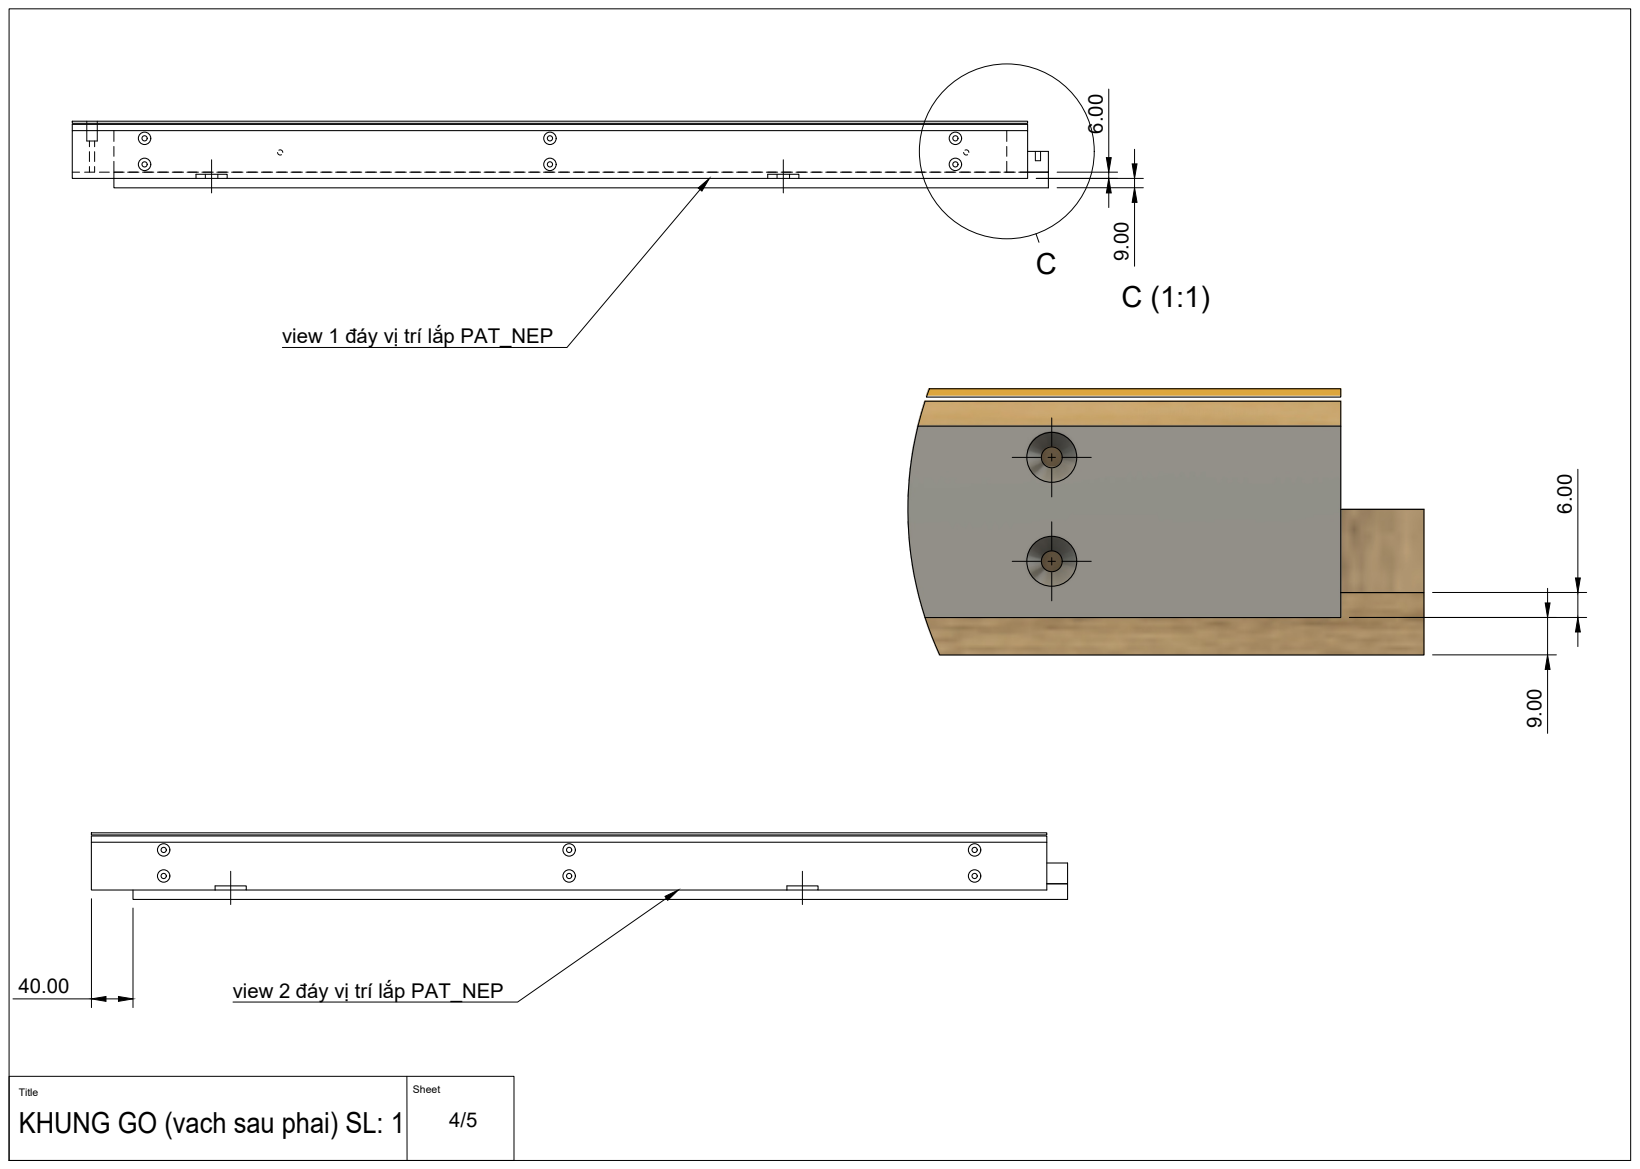
[picture p48: page 33]
Title; Sheet; KHUNG GO (vach sau phai) SL: 1; view 2 đáy vị trí lắp PAT_NEP

view 1 đáy vị trí lắp PAT_NEP

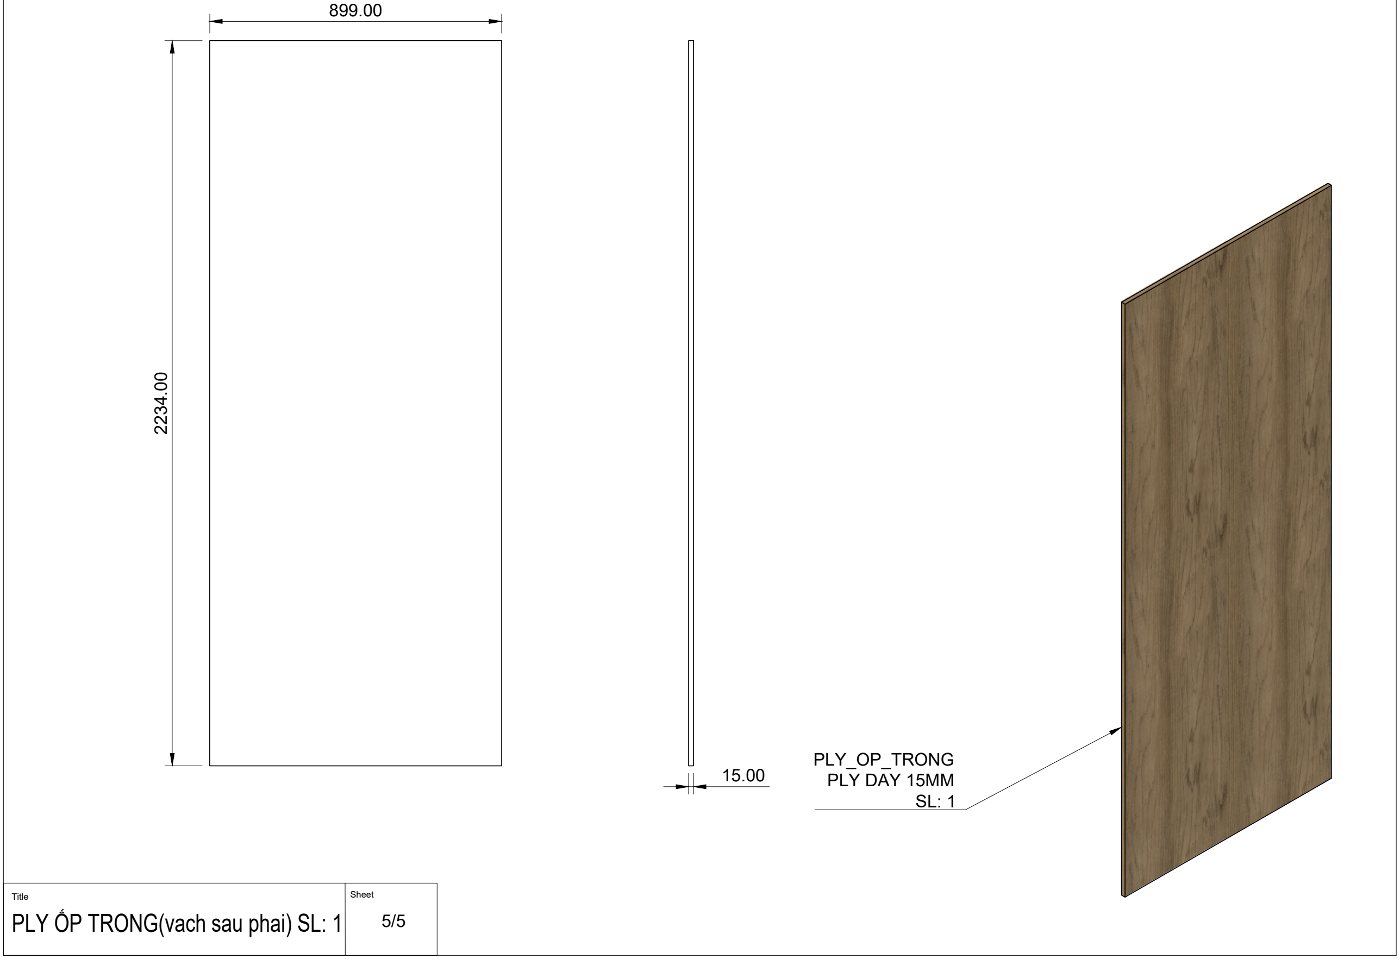
[picture p49: figure]
Title; Sheet; PLY ỐP TRONG(vach sau phai) SL: 1; PLY_OP_TRONG PLY DAY 15MM SL: 1
