autonomous-ai/spaceship/v2/04-BOM/100000_P01_POD-BOUGHT-PARTS_BOM.csv

part_number | name | qty_per_pod | qty_status | material | mass_total_kg | mass_status | hardware | register_id | product_status | team | source_file
108002 | POD - ACP BOND SET - SIKAFLEX-252 WITH AKTIVATOR-205, PRIMER-210, FIXING TAPE | 8 | calculation (sum of the parts lists) | Sikaflex-252 system (bond spec section 8, D-131) | 3.722 | calculation (qty x mass each) | yes | H-12 | DRAFT | CEILING, WALL | v2/03-Manufacturing/ceiling/410000_P01_CEILING-PARTS-LIST_BOM.csv @ working tree; v2/03-Manufacturing/wall/210101_P01_WALL-PANEL-ASSY-SIDE-LOWER-LH_BOM.csv @ working tree; v2/03-Manufacturing/wall/210102_P01_WALL-PANEL-ASSY-SIDE-LOWER-RH_BOM.csv @ working tree; v2/03-Manufacturing/wall/210103_P01_WALL-PANEL-ASSY-SIDE-UPPER-LH_BOM.csv @ working tree; v2/03-Manufacturing/wall/210104_P01_WALL-PANEL-ASSY-SIDE-UPPER-RH_BOM.csv @ working tree; v2/03-Manufacturing/wall/210201_P01_WALL-PANEL-ASSY-BACK-LOWER-B1_BOM.csv @ working tree; v2/03-Manufacturing/wall/210202_P01_WALL-PANEL-ASSY-BACK-LOWER-B2_BOM.csv @ working tree
118001 | BASE - BASE SEAL - LIP - ROOM FLOOR - HOLD | 6.129 | calculation (sum of the parts lists) | soft lip (sweep) seal, EPDM or TPE, black: a leg bonded to the band's inner face and a fin reaching seal_reach (21.5) below the band's bottom, so it presses on the room floor across the glides' range (product HOLD) | 0.49 | calculation (qty x mass each) | yes | H-06 | HOLD | BASE | v2/03-Manufacturing/base/110000_P01_BASE_BOM.csv @ working tree
118002 | BASE - LEVELLING GLIDE - M10 - HOLD | 9 | calculation (sum of the parts lists) | levelling glide, M10 stem with a 5 mm hex socket on top, about 36 mm pad, static rating 3.5 kN or more (PM ruling 2026-11-01: the worst glide carries about 1.7 kN with two people leaning on one wall); base 6.5 mm or taller, so that screwed fully home against the M10 rivnut's head it holds the band at 8.5 mm: a hard stop (product HOLD) | 1.35 | calculation (qty x mass each) | yes | H-25 | HOLD | BASE | v2/03-Manufacturing/base/110000_P01_BASE_BOM.csv @ working tree
118003 | BASE - TUBE END CAP - 100 X 40 - BLACK - HOLD | 3 | calculation (sum of the parts lists) | flat end cap for the 100 x 40 x 1.5 tube's bore, black, no deeper than 2 (D-129; PE assumed, product HOLD) | 0.02 | calculation (qty x mass each) | yes | H-27 | HOLD | BASE | v2/03-Manufacturing/base/110000_P01_BASE_BOM.csv @ working tree
368001 | FRONT - DROP SEAL - ATHMER SCHALL-EX GSA 1-1112 | 1 | calculation (sum of the parts lists) | athmer Schall-Ex GSA 1-1112, black RAL 9005 | 0.6 | calculation (qty x mass each) | yes | H-15 | HOLD | FRONT | v2/03-Manufacturing/front/360001_P01_FRONT-DOOR-UNIT_BOM.csv @ working tree
368002 | FRONT - GLAZING U-SEAL - BOHLE BO5201735 | 2 | calculation (sum of the parts lists) | Bohle BO5201735 silicone U-profile seal | 0.389 | calculation (qty x mass each) | yes | H-16 | source (product); fit on 8.76 laminate unverified | FRONT | v2/03-Manufacturing/front/360001_P01_FRONT-DOOR-UNIT_BOM.csv @ working tree; v2/03-Manufacturing/front/360002_P01_FRONT-FIXED-GLASS-UNIT_BOM.csv @ working tree
368003 | FRONT - 180 MAGNETIC SEAL - HALF 1 OF 2 - HOLD | 1 | calculation (sum of the parts lists) | magnetic 180 deg glass-to-glass seal, fixed pane half; product not named | 0.15 | calculation (qty x mass each) | yes | H-17 | HOLD | FRONT | v2/03-Manufacturing/front/360002_P01_FRONT-FIXED-GLASS-UNIT_BOM.csv @ working tree
368004 | FRONT - GLAZING U-PROFILE - BOHLE BO5201571 | 1 | calculation (sum of the parts lists) | Bohle BO5201571 aluminium U-profile 15 x 15 x 1.5 | 0.557 | calculation (qty x mass each) | yes | H-19 | source (product) | FRONT | v2/03-Manufacturing/front/360002_P01_FRONT-FIXED-GLASS-UNIT_BOM.csv @ working tree
368005 | FRONT - FRAME-STOP SEAL | 2 | calculation (sum of the parts lists) | athmer PS 1515 P Flex, PVC co-extrusion, self-adhesive | 0.12 | calculation (qty x mass each) | yes | H-20 | source (product) | FRONT | v2/03-Manufacturing/front/350001_P01_FRONT-DECOR-BLOCK-ASSY-DL_BOM.csv @ working tree; v2/03-Manufacturing/front/350002_P01_FRONT-DECOR-BLOCK-ASSY-DT_BOM.csv @ working tree
368006 | FRONT - 180 MAGNETIC SEAL - HALF 2 OF 2 - HOLD | 1 | calculation (sum of the parts lists) | magnetic 180 deg glass-to-glass seal, door half; product not named | 0.15 | calculation (qty x mass each) | yes | H-18 | HOLD | FRONT | v2/03-Manufacturing/front/360001_P01_FRONT-DOOR-UNIT_BOM.csv @ working tree
368007 | FRONT - DOOR CATCH - IN DT | 1 | calculation (sum of the parts lists) | Sugatsune HT-MSG62: silicone body, SUS304 bracket, neodymium magnet | 0.052 | calculation (qty x mass each) | yes | H-23 | source (product) | FRONT | v2/03-Manufacturing/front/350002_P01_FRONT-DECOR-BLOCK-ASSY-DT_BOM.csv @ working tree
368101 | FRONT - DOOR HINGE - HOLD | 3 | calculation (sum of the parts lists) | not named: rated for the 8.76 laminate, at least 60 kg and the 1176 mm width; holds the door at its closed position; two-part lift-off, the frame halves ship fitted in DL; hung on site with the 5 mm key (PM rulings) | 1.8 | calculation (qty x mass each) | yes | H-21 | HOLD | FRONT | v2/03-Manufacturing/front/360001_P01_FRONT-DOOR-UNIT_BOM.csv @ working tree
368102 | FRONT - DOOR STRIKE | 1 | calculation (sum of the parts lists) | stainless steel SUS430 strike with CR packing | 0.023 | calculation (qty x mass each) | yes | H-22 | HOLD | FRONT | v2/03-Manufacturing/front/360001_P01_FRONT-DOOR-UNIT_BOM.csv @ working tree
368103 | FRONT - DOOR PULL PAIR - HOLD | 1 | calculation (sum of the parts lists) | not named | 0.8 | calculation (qty x mass each) | yes | H-24 | HOLD | FRONT | v2/03-Manufacturing/front/360001_P01_FRONT-DOOR-UNIT_BOM.csv @ working tree
518001 | LINING - CASSETTE CLIP | 36 | calculation (sum of the parts lists) | HOLD envelope - no mass | 1.44 | calculation (qty x mass each) | yes | H-10 | HOLD | CEILING, WALL | v2/03-Manufacturing/ceiling/410000_P01_CEILING-PARTS-LIST_BOM.csv @ working tree; v2/03-Manufacturing/wall/210101_P01_WALL-PANEL-ASSY-SIDE-LOWER-LH_BOM.csv @ working tree; v2/03-Manufacturing/wall/210102_P01_WALL-PANEL-ASSY-SIDE-LOWER-RH_BOM.csv @ working tree; v2/03-Manufacturing/wall/210103_P01_WALL-PANEL-ASSY-SIDE-UPPER-LH_BOM.csv @ working tree; v2/03-Manufacturing/wall/210104_P01_WALL-PANEL-ASSY-SIDE-UPPER-RH_BOM.csv @ working tree; v2/03-Manufacturing/wall/210201_P01_WALL-PANEL-ASSY-BACK-LOWER-B1_BOM.csv @ working tree; v2/03-Manufacturing/wall/210202_P01_WALL-PANEL-ASSY-BACK-LOWER-B2_BOM.csv @ working tree
518002 | LINING - CEILING SAFETY CATCH - GRIPPLE LOOP NO.3 | 4 | calculation (sum of the parts lists) | HOLD envelope - no mass | 0.4 | calculation (qty x mass each) | yes | H-11 | HOLD | CEILING | v2/03-Manufacturing/ceiling/410000_P01_CEILING-PARTS-LIST_BOM.csv @ working tree
618102 | AIR - SUPPLY TRANSITION - HOLD | 1 | calculation (sum of the parts lists) | HOLD envelope - no mass | 2.07 | calculation (qty x mass each) | no (team-numbered family) |  | HOLD | CEILING (builds AIR, D-80) | v2/03-Manufacturing/air/610000_P01_AIR-PARTS-LIST_BOM.csv @ working tree
618103 | AIR - RISER TRANSITION - HOLD | 1 | calculation (sum of the parts lists) | HOLD envelope - no mass | 1.47 | calculation (qty x mass each) | no (team-numbered family) |  | HOLD | CEILING (builds AIR, D-80) | v2/03-Manufacturing/air/610000_P01_AIR-PARTS-LIST_BOM.csv @ working tree
618105 | AIR - SOFFIT UNDERSIDE HINGE - HOLD | 4 | calculation (sum of the parts lists) | HOLD envelope - no mass | 0.16 | calculation (qty x mass each) | no (team-numbered family) |  | HOLD | CEILING (builds AIR, D-80) | v2/03-Manufacturing/air/610000_P01_AIR-PARTS-LIST_BOM.csv @ working tree
618106 | AIR - SOFFIT UNDERSIDE LATCH - HOLD | 4 | calculation (sum of the parts lists) | HOLD envelope - no mass | 0.08 | calculation (qty x mass each) | no (team-numbered family) |  | HOLD | CEILING (builds AIR, D-80) | v2/03-Manufacturing/air/610000_P01_AIR-PARTS-LIST_BOM.csv @ working tree
618401 | AIR - FAN - NOCTUA NF-A14 INDUSTRIALPPC-3000 PWM | 4 | calculation (sum of the parts lists) | Fan envelope 0.3 kg (assumption) | 1.2 | calculation (qty x mass each) | no (team-numbered family) |  | HOLD | CEILING (builds AIR, D-80) | v2/03-Manufacturing/air/610000_P01_AIR-PARTS-LIST_BOM.csv @ working tree
618402 | AIR - FAN BOX PAD - SUPPLY - RUBBER 40 X 15 X 5 - HOLD | 2 | calculation (sum of the parts lists) | HOLD envelope - no mass | 0.008 | calculation (qty x mass each) | no (team-numbered family) |  | HOLD | CEILING (builds AIR, D-80) | v2/03-Manufacturing/air/610000_P01_AIR-PARTS-LIST_BOM.csv @ working tree
618501 | AIR - RISER BUFFER - RUBBER - M6 - HOLD | 1 | calculation (sum of the parts lists) | HOLD envelope - no mass | 0.012 | calculation (qty x mass each) | no (team-numbered family) |  | HOLD | CEILING (builds AIR, D-80) | v2/03-Manufacturing/air/610000_P01_AIR-PARTS-LIST_BOM.csv @ working tree
718001 | ELECTRICAL - 12 V SUPPLY - 60 W CLASS 2 | 1 | calculation (sum of the parts lists) | potted plastic case, IP67 | 0.4 | calculation (qty x mass each) | no (team-numbered family) |  | HOLD | ELECTRICAL | v2/03-Manufacturing/electrical/710000_P01_ELECTRICAL-PARTS-LIST_BOM.csv @ working tree
718002 | ELECTRICAL - LED CONTROLLER - 24 V PWM - DMX512 - ISOLATED INPUT | 1 | calculation (sum of the parts lists) |  | 0.1 | calculation (qty x mass each) | no (team-numbered family) |  | HOLD | ELECTRICAL | v2/03-Manufacturing/electrical/710000_P01_ELECTRICAL-PARTS-LIST_BOM.csv @ working tree
718003 | ELECTRICAL - CIRCUIT BREAKER - 1P 15 A C - UL 489 | 1 | calculation (sum of the parts lists) |  | 0.12 | calculation (qty x mass each) | no (team-numbered family) |  | HOLD | ELECTRICAL | v2/03-Manufacturing/electrical/710000_P01_ELECTRICAL-PARTS-LIST_BOM.csv @ working tree
718004 | ELECTRICAL - APPLIANCE INLET - POWERCON TRUE1 TOP | 1 | calculation (sum of the parts lists) |  | 0.05 | calculation (qty x mass each) | no (team-numbered family) |  | HOLD | ELECTRICAL | v2/03-Manufacturing/electrical/710000_P01_ELECTRICAL-PARTS-LIST_BOM.csv @ working tree
718005 | ELECTRICAL - INLET SEALING CAP | 1 | calculation (sum of the parts lists) |  | 0.01 | calculation (qty x mass each) | no (team-numbered family) |  | HOLD | ELECTRICAL | v2/03-Manufacturing/electrical/710000_P01_ELECTRICAL-PARTS-LIST_BOM.csv @ working tree
718006 | ELECTRICAL - LAN FEED-THROUGH - ETHERCON | 1 | calculation (sum of the parts lists) |  | 0.04 | calculation (qty x mass each) | no (team-numbered family) |  | HOLD | ELECTRICAL | v2/03-Manufacturing/electrical/710000_P01_ELECTRICAL-PARTS-LIST_BOM.csv @ working tree
718007 | ELECTRICAL - RECEPTACLE - GFCI TR DUPLEX 15 A - NEMA 5-15R | 1 | calculation (sum of the parts lists) |  | 0.25 | calculation (qty x mass each) | no (team-numbered family) |  | HOLD | ELECTRICAL | v2/03-Manufacturing/electrical/710000_P01_ELECTRICAL-PARTS-LIST_BOM.csv @ working tree
718010 | ELECTRICAL - DIN RAIL - TS35 X 7.5 - 100 MM | 1 | calculation (sum of the parts lists) | steel | 0.03 | calculation (qty x mass each) | no (team-numbered family) |  | HOLD | ELECTRICAL | v2/03-Manufacturing/electrical/710000_P01_ELECTRICAL-PARTS-LIST_BOM.csv @ working tree
718011 | ELECTRICAL - FUSE HOLDER - ATO BLADE - INLINE | 2 | calculation (sum of the parts lists) |  | 0.02 | calculation (qty x mass each) | no (team-numbered family) |  | HOLD | ELECTRICAL | v2/03-Manufacturing/electrical/710000_P01_ELECTRICAL-PARTS-LIST_BOM.csv @ working tree
718012 | ELECTRICAL - FUSE - ATO 5 A 32 V | 1 | calculation (sum of the parts lists) |  | 0.002 | calculation (qty x mass each) | no (team-numbered family) |  | HOLD | ELECTRICAL | v2/03-Manufacturing/electrical/710000_P01_ELECTRICAL-PARTS-LIST_BOM.csv @ working tree
718013 | ELECTRICAL - FUSE - ATO 5 A 32 V - LIGHTS | 1 | calculation (sum of the parts lists) |  | 0.002 | calculation (qty x mass each) | no (team-numbered family) |  | HOLD | ELECTRICAL | v2/03-Manufacturing/electrical/710000_P01_ELECTRICAL-PARTS-LIST_BOM.csv @ working tree
718014 | ELECTRICAL - EARTH STUD - M5 SELF-CLINCHING | 1 | calculation (sum of the parts lists) | aluminium | 0.005 | calculation (qty x mass each) | no (team-numbered family) |  | HOLD | ELECTRICAL | v2/03-Manufacturing/electrical/710000_P01_ELECTRICAL-PARTS-LIST_BOM.csv @ working tree
718015 | ELECTRICAL - BONDING WASHER - SERRATED M6 A2 | 1 | calculation (sum of the parts lists) | stainless A2 | 0.001 | calculation (qty x mass each) | no (team-numbered family) |  | HOLD | ELECTRICAL | v2/03-Manufacturing/electrical/710000_P01_ELECTRICAL-PARTS-LIST_BOM.csv @ working tree
718016 | ELECTRICAL - RING TERMINAL - INSULATED 16-14 AWG | 5 | calculation (sum of the parts lists) | tinned copper | 0.005 | calculation (qty x mass each) | no (team-numbered family) |  | HOLD | ELECTRICAL | v2/03-Manufacturing/electrical/710000_P01_ELECTRICAL-PARTS-LIST_BOM.csv @ working tree
718017 | ELECTRICAL - CONDUIT - FLEXIBLE NONMETALLIC 1/2 IN | 0.6 | calculation (sum of the parts lists) | PVC, UL 1660 liquidtight flexible nonmetallic (LFNC-B) | 0.048 | calculation (qty x mass each) | no (team-numbered family) |  | HOLD | ELECTRICAL | v2/03-Manufacturing/electrical/710000_P01_ELECTRICAL-PARTS-LIST_BOM.csv @ working tree
718019 | ELECTRICAL - SCREW - M4 X 8 - ISO 7045 A2 PAN HEAD | 4 | calculation (sum of the parts lists) | stainless steel | 0.006 | calculation (qty x mass each) | no (team-numbered family) |  | HOLD | ELECTRICAL | v2/03-Manufacturing/electrical/710000_P01_ELECTRICAL-PARTS-LIST_BOM.csv @ working tree
718020 | ELECTRICAL - WIRE - UL 1015 14 AWG (BLACK, WHITE, GREEN) | 2.76 | calculation (sum of the parts lists) |  | 0.069 | calculation (qty x mass each) | no (team-numbered family) |  | HOLD | ELECTRICAL | v2/03-Manufacturing/electrical/710000_P01_ELECTRICAL-PARTS-LIST_BOM.csv @ working tree
718021 | ELECTRICAL - WIRE - UL 1015 14 AWG (BLACK, WHITE) | 1.5 | calculation (sum of the parts lists) |  | 0.038 | calculation (qty x mass each) | no (team-numbered family) |  | HOLD | ELECTRICAL | v2/03-Manufacturing/electrical/710000_P01_ELECTRICAL-PARTS-LIST_BOM.csv @ working tree
718022 | ELECTRICAL - WIRE - UL 1015 14 AWG GREEN | 0.3 | calculation (sum of the parts lists) |  | 0.007 | calculation (qty x mass each) | no (team-numbered family) |  | HOLD | ELECTRICAL | v2/03-Manufacturing/electrical/710000_P01_ELECTRICAL-PARTS-LIST_BOM.csv @ working tree
718023 | ELECTRICAL - CABLE - 2 X 18 AWG - CLASS 2 | 3.16 | calculation (sum of the parts lists) |  | 0.079 | calculation (qty x mass each) | no (team-numbered family) |  | HOLD | ELECTRICAL | v2/03-Manufacturing/electrical/710000_P01_ELECTRICAL-PARTS-LIST_BOM.csv @ working tree
718024 | ELECTRICAL - CABLE - 4 X 18 AWG - CLASS 2 | 4.12 | calculation (sum of the parts lists) |  | 0.185 | calculation (qty x mass each) | no (team-numbered family) |  | HOLD | ELECTRICAL | v2/03-Manufacturing/electrical/710000_P01_ELECTRICAL-PARTS-LIST_BOM.csv @ working tree
718025 | ELECTRICAL - CABLE - 6 X 24 AWG SCREENED - CLASS 2 | 3.2 | calculation (sum of the parts lists) |  | 0.112 | calculation (qty x mass each) | no (team-numbered family) |  | HOLD | ELECTRICAL | v2/03-Manufacturing/electrical/710000_P01_ELECTRICAL-PARTS-LIST_BOM.csv @ working tree
718026 | ELECTRICAL - CABLE - 4 X 20 AWG | 2.81 | calculation (sum of the parts lists) |  | 0.098 | calculation (qty x mass each) | no (team-numbered family) |  | HOLD | ELECTRICAL | v2/03-Manufacturing/electrical/710000_P01_ELECTRICAL-PARTS-LIST_BOM.csv @ working tree
718027 | ELECTRICAL - CABLE - 4 X 24 AWG SCREENED | 1.75 | calculation (sum of the parts lists) |  | 0.052 | calculation (qty x mass each) | no (team-numbered family) |  | HOLD | ELECTRICAL | v2/03-Manufacturing/electrical/710000_P01_ELECTRICAL-PARTS-LIST_BOM.csv @ working tree
718028 | ELECTRICAL - CABLE - CAT6 U/UTP | 3.14 | calculation (sum of the parts lists) |  | 0.126 | calculation (qty x mass each) | no (team-numbered family) |  | HOLD | ELECTRICAL | v2/03-Manufacturing/electrical/710000_P01_ELECTRICAL-PARTS-LIST_BOM.csv @ working tree
718029 | ELECTRICAL - CABLE - 6 X 18 AWG - CLASS 2 | 2.23 | calculation (sum of the parts lists) |  | 0.145 | calculation (qty x mass each) | no (team-numbered family) |  | HOLD | ELECTRICAL | v2/03-Manufacturing/electrical/710000_P01_ELECTRICAL-PARTS-LIST_BOM.csv @ working tree
718030 | ELECTRICAL - CONNECTOR - MINI-FIT JR RECEPTACLE 2 WAY V-0 | 1 | calculation (sum of the parts lists) | nylon UL94 V-0 | 0.002 | calculation (qty x mass each) | no (team-numbered family) |  | HOLD | ELECTRICAL | v2/03-Manufacturing/electrical/710000_P01_ELECTRICAL-PARTS-LIST_BOM.csv @ working tree
718031 | ELECTRICAL - CONNECTOR - MINI-FIT JR PLUG 2 WAY V-0 | 1 | calculation (sum of the parts lists) | nylon UL94 V-0 | 0.002 | calculation (qty x mass each) | no (team-numbered family) |  | HOLD | ELECTRICAL | v2/03-Manufacturing/electrical/710000_P01_ELECTRICAL-PARTS-LIST_BOM.csv @ working tree
718032 | ELECTRICAL - CONNECTOR - MINI-FIT JR RECEPTACLE 4 WAY V-0 | 3 | calculation (sum of the parts lists) | nylon UL94 V-0 | 0.007 | calculation (qty x mass each) | no (team-numbered family) |  | HOLD | ELECTRICAL | v2/03-Manufacturing/electrical/710000_P01_ELECTRICAL-PARTS-LIST_BOM.csv @ working tree
718033 | ELECTRICAL - CONNECTOR - MINI-FIT JR PLUG 4 WAY V-0 | 3 | calculation (sum of the parts lists) | nylon UL94 V-0 | 0.007 | calculation (qty x mass each) | no (team-numbered family) |  | HOLD | ELECTRICAL | v2/03-Manufacturing/electrical/710000_P01_ELECTRICAL-PARTS-LIST_BOM.csv @ working tree
718034 | ELECTRICAL - CONNECTOR - MINI-FIT JR RECEPTACLE 10 WAY V-0 | 3 | calculation (sum of the parts lists) | nylon UL94 V-0 | 0.015 | calculation (qty x mass each) | no (team-numbered family) |  | HOLD | ELECTRICAL | v2/03-Manufacturing/electrical/710000_P01_ELECTRICAL-PARTS-LIST_BOM.csv @ working tree
718035 | ELECTRICAL - CONNECTOR - MINI-FIT JR PLUG 10 WAY V-0 | 3 | calculation (sum of the parts lists) | nylon UL94 V-0 | 0.015 | calculation (qty x mass each) | no (team-numbered family) |  | HOLD | ELECTRICAL | v2/03-Manufacturing/electrical/710000_P01_ELECTRICAL-PARTS-LIST_BOM.csv @ working tree
718036 | ELECTRICAL - TERMINAL - MINI-FIT JR FEMALE 18-24 AWG TIN | 50 | calculation (sum of the parts lists) | tin-plated brass | 0.015 | calculation (qty x mass each) | no (team-numbered family) |  | HOLD | ELECTRICAL | v2/03-Manufacturing/electrical/710000_P01_ELECTRICAL-PARTS-LIST_BOM.csv @ working tree
718037 | ELECTRICAL - TERMINAL - MINI-FIT JR MALE 18-24 AWG TIN | 50 | calculation (sum of the parts lists) | tin-plated brass | 0.015 | calculation (qty x mass each) | no (team-numbered family) |  | HOLD | ELECTRICAL | v2/03-Manufacturing/electrical/710000_P01_ELECTRICAL-PARTS-LIST_BOM.csv @ working tree
718038 | ELECTRICAL - RJ45 PLUG - CAT6 | 5 | calculation (sum of the parts lists) |  | 0.025 | calculation (qty x mass each) | no (team-numbered family) |  | HOLD | ELECTRICAL | v2/03-Manufacturing/electrical/710000_P01_ELECTRICAL-PARTS-LIST_BOM.csv @ working tree
718039 | ELECTRICAL - RJ45 INLINE COUPLER - CAT6 | 2 | calculation (sum of the parts lists) |  | 0.01 | calculation (qty x mass each) | no (team-numbered family) |  | HOLD | ELECTRICAL | v2/03-Manufacturing/electrical/710000_P01_ELECTRICAL-PARTS-LIST_BOM.csv @ working tree
718040 | ELECTRICAL - RJ45 KEYSTONE JACK - CAT6 - WITH DUST CAP | 3 | calculation (sum of the parts lists) |  | 0.015 | calculation (qty x mass each) | no (team-numbered family) |  | HOLD | ELECTRICAL | v2/03-Manufacturing/electrical/710000_P01_ELECTRICAL-PARTS-LIST_BOM.csv @ working tree
718041 | ELECTRICAL - BUSHING - SHORTY 19.1 HOLE - NYLON | 9 | calculation (sum of the parts lists) | nylon 6/6 UL94 V-2 | 0.009 | calculation (qty x mass each) | no (team-numbered family) |  | HOLD | ELECTRICAL | v2/03-Manufacturing/electrical/710000_P01_ELECTRICAL-PARTS-LIST_BOM.csv @ working tree
718042 | ELECTRICAL - EDGE PROTECTION STRIP - 0.5 MM SHEET | 0.2 | calculation (sum of the parts lists) | PVC or nylon | 0.004 | calculation (qty x mass each) | no (team-numbered family) |  | HOLD | ELECTRICAL | v2/03-Manufacturing/electrical/710000_P01_ELECTRICAL-PARTS-LIST_BOM.csv @ working tree
718043 | ELECTRICAL - CABLE CLIP - FOR 0.5 MM STEEL TRAY | 20 | calculation (sum of the parts lists) |  | 0.04 | calculation (qty x mass each) | no (team-numbered family) |  | HOLD | ELECTRICAL | v2/03-Manufacturing/electrical/710000_P01_ELECTRICAL-PARTS-LIST_BOM.csv @ working tree
718044 | ELECTRICAL - DRAW CORD - NYLON 3 MM | 3.55 | calculation (sum of the parts lists) | nylon | 0.021 | calculation (qty x mass each) | no (team-numbered family) |  | HOLD | ELECTRICAL | v2/03-Manufacturing/electrical/710000_P01_ELECTRICAL-PARTS-LIST_BOM.csv @ working tree
718045 | ELECTRICAL - CONNECTOR - MINI-FIT JR RECEPTACLE 6 WAY V-0 | 3 | calculation (sum of the parts lists) | nylon UL94 V-0 | 0.011 | calculation (qty x mass each) | no (team-numbered family) |  | HOLD | ELECTRICAL | v2/03-Manufacturing/electrical/710000_P01_ELECTRICAL-PARTS-LIST_BOM.csv @ working tree
718046 | ELECTRICAL - CONNECTOR - MINI-FIT JR PLUG 6 WAY V-0 | 3 | calculation (sum of the parts lists) | nylon UL94 V-0 | 0.011 | calculation (qty x mass each) | no (team-numbered family) |  | HOLD | ELECTRICAL | v2/03-Manufacturing/electrical/710000_P01_ELECTRICAL-PARTS-LIST_BOM.csv @ working tree
718047 | ELECTRICAL - CLINCH NUT - M4 - FOR 1.0 MM ALUMINIUM | 4 | calculation (sum of the parts lists) | aluminium | 0.003 | calculation (qty x mass each) | no (team-numbered family) |  | HOLD | ELECTRICAL | v2/03-Manufacturing/electrical/710000_P01_ELECTRICAL-PARTS-LIST_BOM.csv @ working tree
718048 | ELECTRICAL - SCREW - M4 X 12 - ISO 7045 A2 PAN HEAD, BLACK | 4 | calculation (sum of the parts lists) | stainless steel | 0.007 | calculation (qty x mass each) | no (team-numbered family) |  | HOLD | ELECTRICAL | v2/03-Manufacturing/electrical/710000_P01_ELECTRICAL-PARTS-LIST_BOM.csv @ working tree
718049 | ELECTRICAL - SPACER - M4 X 2 MM - NYLON, BLACK | 4 | calculation (sum of the parts lists) | nylon 6/6 | 0.001 | calculation (qty x mass each) | no (team-numbered family) |  | HOLD | ELECTRICAL | v2/03-Manufacturing/electrical/710000_P01_ELECTRICAL-PARTS-LIST_BOM.csv @ working tree
718050 | ELECTRICAL - LED STRIP - 24 V 6.0 W/M - 3000 K - 8 MM | 6.3 | calculation (sum of the parts lists) |  | 0.126 | calculation (qty x mass each) | no (team-numbered family) |  | HOLD | ELECTRICAL | v2/03-Manufacturing/electrical/710000_P01_ELECTRICAL-PARTS-LIST_BOM.csv @ working tree
718051 | ELECTRICAL - LED STRIP - 24 V 3.0 W/M - 3000 K - 8 MM | 0.9 | calculation (sum of the parts lists) |  | 0.018 | calculation (qty x mass each) | no (team-numbered family) |  | HOLD | ELECTRICAL | v2/03-Manufacturing/electrical/710000_P01_ELECTRICAL-PARTS-LIST_BOM.csv @ working tree
718052 | ELECTRICAL - CALL LIGHT PROFILE AND DIFFUSER - 0.9 M | 1 | calculation (sum of the parts lists) | aluminium + opal PMMA | 0.15 | calculation (qty x mass each) | no (team-numbered family) |  | HOLD | ELECTRICAL | v2/03-Manufacturing/electrical/710000_P01_ELECTRICAL-PARTS-LIST_BOM.csv @ working tree
718053 | ELECTRICAL - LED STRIP FEED LEAD - LOOX5 8 MM | 9 | calculation (sum of the parts lists) |  | 0.09 | calculation (qty x mass each) | no (team-numbered family) |  | HOLD | ELECTRICAL | v2/03-Manufacturing/electrical/710000_P01_ELECTRICAL-PARTS-LIST_BOM.csv @ working tree
718054 | ELECTRICAL - SCREW - 6-32 X 1/2 - OVAL HEAD, BLACK | 2 | calculation (sum of the parts lists) | steel | 0.002 | calculation (qty x mass each) | no (team-numbered family) |  | HOLD | ELECTRICAL | v2/03-Manufacturing/electrical/710000_P01_ELECTRICAL-PARTS-LIST_BOM.csv @ working tree
718055 | ELECTRICAL - CABLE - 4 X 16 AWG - CLASS 2 | 2.27 | calculation (sum of the parts lists) |  | 0.148 | calculation (qty x mass each) | no (team-numbered family) |  | HOLD | ELECTRICAL | v2/03-Manufacturing/electrical/710000_P01_ELECTRICAL-PARTS-LIST_BOM.csv @ working tree
718056 | ELECTRICAL - TERMINAL - MINI-FIT JR FEMALE 16 AWG TIN | 12 | calculation (sum of the parts lists) | tin-plated brass | 0.004 | calculation (qty x mass each) | no (team-numbered family) |  | HOLD | ELECTRICAL | v2/03-Manufacturing/electrical/710000_P01_ELECTRICAL-PARTS-LIST_BOM.csv @ working tree
718057 | ELECTRICAL - TERMINAL - MINI-FIT JR MALE 16 AWG TIN | 8 | calculation (sum of the parts lists) | tin-plated brass | 0.002 | calculation (qty x mass each) | no (team-numbered family) |  | HOLD | ELECTRICAL | v2/03-Manufacturing/electrical/710000_P01_ELECTRICAL-PARTS-LIST_BOM.csv @ working tree
718060 | ELECTRICAL - SENSOR HUB - DESK PRO AI (IN-HOUSE) | 1 | calculation (sum of the parts lists) |  | 0.15 | calculation (qty x mass each) | no (team-numbered family) |  | HOLD | ELECTRICAL | v2/03-Manufacturing/electrical/710000_P01_ELECTRICAL-PARTS-LIST_BOM.csv @ working tree
718061 | ELECTRICAL - PUSH BUTTON - MOMENTARY - BOOST | 1 | calculation (sum of the parts lists) |  | 0.01 | calculation (qty x mass each) | no (team-numbered family) |  | HOLD | ELECTRICAL | v2/03-Manufacturing/electrical/710000_P01_ELECTRICAL-PARTS-LIST_BOM.csv @ working tree
718062 | ELECTRICAL - PUSH BUTTON - MOMENTARY - CALL | 1 | calculation (sum of the parts lists) |  | 0.01 | calculation (qty x mass each) | no (team-numbered family) |  | HOLD | ELECTRICAL | v2/03-Manufacturing/electrical/710000_P01_ELECTRICAL-PARTS-LIST_BOM.csv @ working tree
718063 | ELECTRICAL - LIGHT KNOB - POTENTIOMETER WITH KNOB | 1 | calculation (sum of the parts lists) |  | 0.01 | calculation (qty x mass each) | no (team-numbered family) |  | HOLD | ELECTRICAL | v2/03-Manufacturing/electrical/710000_P01_ELECTRICAL-PARTS-LIST_BOM.csv @ working tree
718064 | ELECTRICAL - FUSE HOLDER - ATO BLADE - INLINE - COLUMN | 3 | calculation (sum of the parts lists) |  | 0.03 | calculation (qty x mass each) | no (team-numbered family) |  | HOLD | ELECTRICAL | v2/03-Manufacturing/electrical/710000_P01_ELECTRICAL-PARTS-LIST_BOM.csv @ working tree
718065 | ELECTRICAL - INLET TEMPERATURE SENSOR | 1 | calculation (sum of the parts lists) |  | 0.01 | calculation (qty x mass each) | no (team-numbered family) |  | HOLD | ELECTRICAL | v2/03-Manufacturing/electrical/710000_P01_ELECTRICAL-PARTS-LIST_BOM.csv @ working tree
718066 | ELECTRICAL - FUSE - ATO 2 A 32 V | 2 | calculation (sum of the parts lists) |  | 0.004 | calculation (qty x mass each) | no (team-numbered family) |  | HOLD | ELECTRICAL | v2/03-Manufacturing/electrical/710000_P01_ELECTRICAL-PARTS-LIST_BOM.csv @ working tree
718067 | ELECTRICAL - FUSE - ATO 1 A 32 V | 1 | calculation (sum of the parts lists) |  | 0.002 | calculation (qty x mass each) | no (team-numbered family) |  | HOLD | ELECTRICAL | v2/03-Manufacturing/electrical/710000_P01_ELECTRICAL-PARTS-LIST_BOM.csv @ working tree
718068 | ELECTRICAL - FAN Y-CABLE - 4-PIN PWM | 2 | calculation (sum of the parts lists) |  | 0.02 | calculation (qty x mass each) | no (team-numbered family) |  | HOLD | ELECTRICAL | v2/03-Manufacturing/electrical/710000_P01_ELECTRICAL-PARTS-LIST_BOM.csv @ working tree
718069 | ELECTRICAL - PUSH BUTTON - MOMENTARY - SELF-TEST | 1 | calculation (sum of the parts lists) |  | 0.01 | calculation (qty x mass each) | no (team-numbered family) |  | HOLD | ELECTRICAL | v2/03-Manufacturing/electrical/710000_P01_ELECTRICAL-PARTS-LIST_BOM.csv @ working tree
718070 | ELECTRICAL - CORD CONNECTOR - POWERCON TRUE1 TOP | 1 | calculation (sum of the parts lists) |  | 0.08 | calculation (qty x mass each) | no (team-numbered family) |  | HOLD | ELECTRICAL | v2/03-Manufacturing/electrical/710000_P01_ELECTRICAL-PARTS-LIST_BOM.csv @ working tree
718071 | ELECTRICAL - CORD - SJT 14/3 | 3 | calculation (sum of the parts lists) | PVC jacket, UL 62 type SJT, 300 V, 3 x 14 AWG | 0.39 | calculation (qty x mass each) | no (team-numbered family) |  | HOLD | ELECTRICAL | v2/03-Manufacturing/electrical/710000_P01_ELECTRICAL-PARTS-LIST_BOM.csv @ working tree
718072 | ELECTRICAL - MAINS PLUG - NEMA 5-15P | 1 | calculation (sum of the parts lists) |  | 0.06 | calculation (qty x mass each) | no (team-numbered family) |  | HOLD | ELECTRICAL | v2/03-Manufacturing/electrical/710000_P01_ELECTRICAL-PARTS-LIST_BOM.csv @ working tree
718073 | ELECTRICAL - CURRENT SENSE MODULE - 24 V 0-5 A | 1 | calculation (sum of the parts lists) |  | 0.01 | calculation (qty x mass each) | no (team-numbered family) |  | HOLD | ELECTRICAL | v2/03-Manufacturing/electrical/710000_P01_ELECTRICAL-PARTS-LIST_BOM.csv @ working tree
718081 | ELECTRICAL - 24 V SUPPLY - 60 W CLASS 2 | 1 | calculation (sum of the parts lists) | potted plastic case, IP67 | 0.4 | calculation (qty x mass each) | no (team-numbered family) |  | HOLD | ELECTRICAL | v2/03-Manufacturing/electrical/710000_P01_ELECTRICAL-PARTS-LIST_BOM.csv @ working tree
718082 | ELECTRICAL - 24 V SUPPLY - 96 W CLASS 2 - VOICE KIT | 1 | calculation (sum of the parts lists) | aluminium case, potted, IP67 | 1 | calculation (qty x mass each) | no (team-numbered family) |  | HOLD | ELECTRICAL | v2/03-Manufacturing/electrical/710000_P01_ELECTRICAL-PARTS-LIST_BOM.csv @ working tree
718101 | ELECTRICAL - LED PROFILE - LIGHT SHELF - SURFACE 23 X 12.5 | 1 | calculation (sum of the parts lists) | aluminium | 0.16 | calculation (qty x mass each) | no (team-numbered family) |  | HOLD | ELECTRICAL | v2/03-Manufacturing/electrical/710000_P01_ELECTRICAL-PARTS-LIST_BOM.csv @ working tree
718102 | ELECTRICAL - LED PROFILE COVER - SATIN - CLIP-IN | 1 | calculation (sum of the parts lists) | polycarbonate, satin (grade HOLD) | 0.04 | calculation (qty x mass each) | no (team-numbered family) |  | HOLD | ELECTRICAL | v2/03-Manufacturing/electrical/710000_P01_ELECTRICAL-PARTS-LIST_BOM.csv @ working tree
718103 | ELECTRICAL - LED PROFILE END CAP | 2 | calculation (sum of the parts lists) | plastic, as supplied | 0.004 | calculation (qty x mass each) | no (team-numbered family) |  | HOLD | ELECTRICAL | v2/03-Manufacturing/electrical/710000_P01_ELECTRICAL-PARTS-LIST_BOM.csv @ working tree
718104 | ELECTRICAL - LED PROFILE MOUNTING CLIP | 3 | calculation (sum of the parts lists) | steel, as supplied | 0.006 | calculation (qty x mass each) | no (team-numbered family) |  | HOLD | ELECTRICAL | v2/03-Manufacturing/electrical/710000_P01_ELECTRICAL-PARTS-LIST_BOM.csv @ working tree
818101 | INTERIOR - LEDGE BRACKET - HOLD | 2 | calculation (sum of the parts lists) | HOLD envelope - no mass | 0.2 | calculation (qty x mass each) | yes | H-32 | HOLD | CEILING (builds INTERIOR, D-80) | v2/03-Manufacturing/interior/810000_P01_INTERIOR-PARTS-LIST_BOM.csv @ working tree
818102 | INTERIOR - SCREEN RAIL - HOLD | 1 | calculation (sum of the parts lists) | HOLD envelope - no mass | 0.5 | calculation (qty x mass each) | yes | H-33 | HOLD | CEILING (builds INTERIOR, D-80) | v2/03-Manufacturing/interior/810000_P01_INTERIOR-PARTS-LIST_BOM.csv @ working tree
838001 | HARDWARE - SOCKET HEAD BOLT - M6 X 16 - ISO 4762 8.8 ZINC | 66 | calculation (sum of the parts lists) | steel, property class 8.8 (ISO 898-1) | 0.411 | calculation (qty x mass each) | yes | H-01 | HOLD | BASE, CEILING, CEILING (builds AIR, D-80), ELECTRICAL, WALL | v2/03-Manufacturing/air/610000_P01_AIR-PARTS-LIST_BOM.csv @ working tree; v2/03-Manufacturing/base/110000_P01_BASE_BOM.csv @ working tree; v2/03-Manufacturing/ceiling/410000_P01_CEILING-PARTS-LIST_BOM.csv @ working tree; v2/03-Manufacturing/electrical/710000_P01_ELECTRICAL-PARTS-LIST_BOM.csv @ working tree; v2/03-Manufacturing/wall/210101_P01_WALL-PANEL-ASSY-SIDE-LOWER-LH_BOM.csv @ working tree; v2/03-Manufacturing/wall/210102_P01_WALL-PANEL-ASSY-SIDE-LOWER-RH_BOM.csv @ working tree; v2/03-Manufacturing/wall/210103_P01_WALL-PANEL-ASSY-SIDE-UPPER-LH_BOM.csv @ working tree; v2/03-Manufacturing/wall/210104_P01_WALL-PANEL-ASSY-SIDE-UPPER-RH_BOM.csv @ working tree; v2/03-Manufacturing/wall/210201_P01_WALL-PANEL-ASSY-BACK-LOWER-B1_BOM.csv @ working tree; v2/03-Manufacturing/wall/210202_P01_WALL-PANEL-ASSY-BACK-LOWER-B2_BOM.csv @ working tree
838002 | HARDWARE - SOCKET HEAD BOLT - M6 X 25 - ISO 4762 8.8 ZINC | 9 | calculation (sum of the parts lists) | steel, property class 8.8 (ISO 898-1) | 0.072 | calculation (qty x mass each) | yes | H-01P | HOLD | CEILING, CEILING (builds AIR, D-80), WALL | v2/03-Manufacturing/air/610000_P01_AIR-PARTS-LIST_BOM.csv @ working tree; v2/03-Manufacturing/ceiling/410000_P01_CEILING-PARTS-LIST_BOM.csv @ working tree; v2/03-Manufacturing/wall/210202_P01_WALL-PANEL-ASSY-BACK-LOWER-B2_BOM.csv @ working tree
838003 | HARDWARE - RIVET NUT - M6 - STEEL ZINC - SHEREX CAL2-610-4.2 | 98 | calculation (sum of the parts lists) | steel 1008/1010 | 0.435 | calculation (qty x mass each) | yes | H-03 | HOLD | BASE, CEILING, CEILING (builds AIR, D-80), ELECTRICAL, WALL | v2/03-Manufacturing/air/610000_P01_AIR-PARTS-LIST_BOM.csv @ working tree; v2/03-Manufacturing/base/110000_P01_BASE_BOM.csv @ working tree; v2/03-Manufacturing/ceiling/410000_P01_CEILING-PARTS-LIST_BOM.csv @ working tree; v2/03-Manufacturing/electrical/710000_P01_ELECTRICAL-PARTS-LIST_BOM.csv @ working tree; v2/03-Manufacturing/wall/210101_P01_WALL-PANEL-ASSY-SIDE-LOWER-LH_BOM.csv @ working tree; v2/03-Manufacturing/wall/210102_P01_WALL-PANEL-ASSY-SIDE-LOWER-RH_BOM.csv @ working tree; v2/03-Manufacturing/wall/210103_P01_WALL-PANEL-ASSY-SIDE-UPPER-LH_BOM.csv @ working tree; v2/03-Manufacturing/wall/210104_P01_WALL-PANEL-ASSY-SIDE-UPPER-RH_BOM.csv @ working tree; v2/03-Manufacturing/wall/210201_P01_WALL-PANEL-ASSY-BACK-LOWER-B1_BOM.csv @ working tree; v2/03-Manufacturing/wall/210202_P01_WALL-PANEL-ASSY-BACK-LOWER-B2_BOM.csv @ working tree
838004 | HARDWARE - WASHER - M6 LARGE - ISO 7093-1 6.4 X 18 A2 | 65 | calculation (sum of the parts lists) | stainless steel A2 | 0.182 | calculation (qty x mass each) | yes | H-09 | HOLD | CEILING, CEILING (builds AIR, D-80), ELECTRICAL, WALL | v2/03-Manufacturing/air/610000_P01_AIR-PARTS-LIST_BOM.csv @ working tree; v2/03-Manufacturing/ceiling/410000_P01_CEILING-PARTS-LIST_BOM.csv @ working tree; v2/03-Manufacturing/electrical/710000_P01_ELECTRICAL-PARTS-LIST_BOM.csv @ working tree; v2/03-Manufacturing/wall/210101_P01_WALL-PANEL-ASSY-SIDE-LOWER-LH_BOM.csv @ working tree; v2/03-Manufacturing/wall/210102_P01_WALL-PANEL-ASSY-SIDE-LOWER-RH_BOM.csv @ working tree; v2/03-Manufacturing/wall/210103_P01_WALL-PANEL-ASSY-SIDE-UPPER-LH_BOM.csv @ working tree; v2/03-Manufacturing/wall/210104_P01_WALL-PANEL-ASSY-SIDE-UPPER-RH_BOM.csv @ working tree; v2/03-Manufacturing/wall/210201_P01_WALL-PANEL-ASSY-BACK-LOWER-B1_BOM.csv @ working tree; v2/03-Manufacturing/wall/210202_P01_WALL-PANEL-ASSY-BACK-LOWER-B2_BOM.csv @ working tree
838005 | HARDWARE - CAPTIVE RETAINER - M6 HEAD - GROMMET FOR 19 HOLE | 50 | calculation (sum of the parts lists) | elastomer (HOLD-02) | 0.05 | calculation (qty x mass each) | yes | H-02 | HOLD | CEILING, WALL | v2/03-Manufacturing/ceiling/410000_P01_CEILING-PARTS-LIST_BOM.csv @ working tree; v2/03-Manufacturing/wall/210101_P01_WALL-PANEL-ASSY-SIDE-LOWER-LH_BOM.csv @ working tree; v2/03-Manufacturing/wall/210102_P01_WALL-PANEL-ASSY-SIDE-LOWER-RH_BOM.csv @ working tree; v2/03-Manufacturing/wall/210103_P01_WALL-PANEL-ASSY-SIDE-UPPER-LH_BOM.csv @ working tree; v2/03-Manufacturing/wall/210104_P01_WALL-PANEL-ASSY-SIDE-UPPER-RH_BOM.csv @ working tree; v2/03-Manufacturing/wall/210201_P01_WALL-PANEL-ASSY-BACK-LOWER-B1_BOM.csv @ working tree; v2/03-Manufacturing/wall/210202_P01_WALL-PANEL-ASSY-BACK-LOWER-B2_BOM.csv @ working tree
838006 | HARDWARE - RIVET NUT - M10 - STEEL ZINC - SHEREX CAL2-1015-7.9 | 9 | calculation (sum of the parts lists) | aluminium or steel (HOLD) | 0.054 | calculation (qty x mass each) | yes | H-26 | HOLD | BASE | v2/03-Manufacturing/base/110000_P01_BASE_BOM.csv @ working tree
838007 | HARDWARE - COUNTERSUNK SCREW - M3 X 8 - ISO 10642 A2 | 4 | calculation (sum of the parts lists) | stainless steel A2-70 | 0.002 | calculation (qty x mass each) | yes | H-28 | DRAFT | BASE | v2/03-Manufacturing/base/110000_P01_BASE_BOM.csv @ working tree
838008 | HARDWARE - RIVET NUT - M3 - COUNTERSUNK HEAD - HOLD | 4 | calculation (sum of the parts lists) | aluminium or steel (HOLD) | 0.002 | calculation (qty x mass each) | yes | H-29 | HOLD | BASE | v2/03-Manufacturing/base/110000_P01_BASE_BOM.csv @ working tree
838010 | HARDWARE - FLANGED BUTTON HEAD SCREW - M6 X 12 - ISO 7380-2 A2 | 4 | calculation (sum of the parts lists) | stainless steel A2-70 (ISO 3506-1) | 0.022 | calculation (qty x mass each) | yes | H-31 | DRAFT | BASE | v2/03-Manufacturing/base/110000_P01_BASE_BOM.csv @ working tree
848001 | SEALS - JOINT GASKET - 8 X 3.97 - PORON 4701-40 PSA | 15.318 | calculation (sum of the parts lists) | PORON 4701-40 Soft polyurethane foam with PSA | 0.116 | calculation (qty x mass each) | yes | H-04 | DRAFT | CEILING, WALL | v2/03-Manufacturing/ceiling/410000_P01_CEILING-PARTS-LIST_BOM.csv @ working tree; v2/03-Manufacturing/wall/210101_P01_WALL-PANEL-ASSY-SIDE-LOWER-LH_BOM.csv @ working tree; v2/03-Manufacturing/wall/210102_P01_WALL-PANEL-ASSY-SIDE-LOWER-RH_BOM.csv @ working tree; v2/03-Manufacturing/wall/210103_P01_WALL-PANEL-ASSY-SIDE-UPPER-LH_BOM.csv @ working tree; v2/03-Manufacturing/wall/210104_P01_WALL-PANEL-ASSY-SIDE-UPPER-RH_BOM.csv @ working tree; v2/03-Manufacturing/wall/210201_P01_WALL-PANEL-ASSY-BACK-LOWER-B1_BOM.csv @ working tree; v2/03-Manufacturing/wall/210202_P01_WALL-PANEL-ASSY-BACK-LOWER-B2_BOM.csv @ working tree
848004 | SEALS - CLOSING SEAM BULB SEAL - GAP 4 TO 7 - EPDM OR TPE | 2.615 | calculation (sum of the parts lists) | EPDM or TPE hollow bulb (HOLD-12) | 0.127 | calculation (qty x mass each) | yes | H-04B | HOLD | CEILING, WALL | v2/03-Manufacturing/ceiling/410000_P01_CEILING-PARTS-LIST_BOM.csv @ working tree; v2/03-Manufacturing/wall/210202_P01_WALL-PANEL-ASSY-BACK-LOWER-B2_BOM.csv @ working tree
848011 | SEALS - HOOK AND LOOP - 25 MM - LOCATING ONLY | 1.2 | calculation (sum of the parts lists) | hook-and-loop or reclosable fastener tape, 25 mm, PSA | 0.036 | calculation (qty x mass each) | yes | H-13 | DRAFT | WALL | v2/03-Manufacturing/wall/210101_P01_WALL-PANEL-ASSY-SIDE-LOWER-LH_BOM.csv @ working tree; v2/03-Manufacturing/wall/210102_P01_WALL-PANEL-ASSY-SIDE-LOWER-RH_BOM.csv @ working tree; v2/03-Manufacturing/wall/210103_P01_WALL-PANEL-ASSY-SIDE-UPPER-LH_BOM.csv @ working tree; v2/03-Manufacturing/wall/210104_P01_WALL-PANEL-ASSY-SIDE-UPPER-RH_BOM.csv @ working tree; v2/03-Manufacturing/wall/210201_P01_WALL-PANEL-ASSY-BACK-LOWER-B1_BOM.csv @ working tree; v2/03-Manufacturing/wall/210202_P01_WALL-PANEL-ASSY-BACK-LOWER-B2_BOM.csv @ working tree
848012 | SEALS - CASSETTE EDGE SEAL - 10 X 2.0 TO 2.2 - VERY SOFT FOAM OR FIN | 6.34 | calculation (sum of the parts lists) | very soft PSA foam strip 10 x 2.0-2.2, or a fin (R-J18) | 0.013 | calculation (qty x mass each) | yes | H-14 | HOLD | WALL | v2/03-Manufacturing/wall/210101_P01_WALL-PANEL-ASSY-SIDE-LOWER-LH_BOM.csv @ working tree; v2/03-Manufacturing/wall/210102_P01_WALL-PANEL-ASSY-SIDE-LOWER-RH_BOM.csv @ working tree; v2/03-Manufacturing/wall/210201_P01_WALL-PANEL-ASSY-BACK-LOWER-B1_BOM.csv @ working tree; v2/03-Manufacturing/wall/210202_P01_WALL-PANEL-ASSY-BACK-LOWER-B2_BOM.csv @ working tree
848013 | SEALS - ACCESS PANEL SEAL - 4.0 THICK - VERY SOFT FOAM PSA | 1 | calculation (sum of the parts lists) | very soft foam strip with PSA, 4.0 thick, about 8 wide (product HOLD-19) | 0.02 | calculation (qty x mass each) | yes | H-34 | HOLD | FRONT | v2/03-Manufacturing/front/350003_P01_FRONT-DECOR-BLOCK-ASSY-DR_BOM.csv @ working tree
