autonomous-ai/spaceship/v2/07-Packaging/910000_P01_PACKING-LIST_BOM.csv

label | part_number | name | name_vi | position | pallet | place | fitted_in_step | kg | kg_status | mass_source | size_mm | size_source | glass | note
1-01 | 210201 | WALL - PANEL ASSY - BACK LOWER - B1 | Vách hậu - cụm tấm dưới trái | B1 | 1 | pallet 1, stack slot 1 from the open face | 3 | 8.641 | calculation (part CAD); fill provisional | roll-up: B1 to B4, back outer panels | 1200.61 x 1127 x 46 | WALL 210201 P01 STEP: 1200.6 x 1126.6 x 46, its locating spigots 8 mm out of the top edge | no
1-02 | 210202 | WALL - PANEL ASSY - BACK LOWER - B2 | Vách hậu - cụm tấm dưới phải | B2 | 1 | pallet 1, stack slot 2 from the open face | 3 | 12.114 | calculation (CAD); calculation (part CAD); fill provisional | roll-up: B1 to B4, back outer panels; roll-up: Switches and harness, power unit, cord set, hub zone and lights (ELECTRICAL) x 0.586788 | 1200.61 x 1127 x 88 | WALL 210202 P01 STEP with ELECTRICAL's power unit 710001 fitted (710000 P01 STEP): 1200.6 x 1126.6 x 87.5 | no | carries the power unit 710001, fitted, wired and tested at the factory: its mass from ELECTRICAL's parts list, as a share of ELECTRICAL's roll-up line; foam block over the unit's face in the stack
1-03 | 210101 | WALL - PANEL ASSY - SIDE LOWER - LH | Vách trái - cụm tấm dưới | L1 | 1 | pallet 1, stack slot 3 from the open face | 4 | 11.163 | calculation (CAD); fill provisional | roll-up: L1 and R1, lower side outer panels | 1492.74 x 1151 x 48.5 | WALL 210101 P01 STEP: 1492.7 x 1150.7 x 48.3, spigots 8 mm out of the top edge, rivnuts and stop washers 2.3 mm proud | no
1-04 | 210102 | WALL - PANEL ASSY - SIDE LOWER - RH | Vách phải - cụm tấm dưới | R1 | 1 | pallet 1, stack slot 4 from the open face | 4 | 11.163 | calculation (CAD); fill provisional | roll-up: L1 and R1, lower side outer panels | 1492.74 x 1151 x 48.5 | WALL 210102 P01 STEP, as L1 | no
1-05 | TBD (WALL) | WALL - PANEL ASSY - BACK UPPER - B3 | Vách hậu - cụm tấm trên trái | B3 | 1 | pallet 1, stack slot 5 from the open face | 5 | 8.641 | calculation (part CAD); fill provisional | roll-up: B1 to B4, back outer panels | 1200.61 x 1118.61 x 46 | skeleton P04 named values (100000_P04_POD-SKELETON-PARAMETERS.csv) | no
1-06 | TBD (WALL) | WALL - PANEL ASSY - BACK UPPER - B4 | Vách hậu - cụm tấm trên phải | B4 | 1 | pallet 1, stack slot 6 from the open face | 5 | 8.641 | calculation (part CAD); fill provisional | roll-up: B1 to B4, back outer panels | 1200.61 x 1118.61 x 46 | skeleton P04 named values (100000_P04_POD-SKELETON-PARAMETERS.csv) | no
1-07 | 210103 | WALL - PANEL ASSY - SIDE UPPER - LH | Vách trái - cụm tấm trên | L2 | 1 | pallet 1, stack slot 7 from the open face | 6 | 11.294 | calculation (CAD); fill provisional | roll-up: L2 and R2, upper side outer panels | 1492.74 x 1142.74 x 48.5 | WALL 210103 P01 STEP: 1492.7 x 1142.7 x 48.3, rivnuts and stop washers 2.3 mm proud | no
1-08 | 210104 | WALL - PANEL ASSY - SIDE UPPER - RH | Vách phải - cụm tấm trên | R2 | 1 | pallet 1, stack slot 8 from the open face | 6 | 11.294 | calculation (CAD); fill provisional | roll-up: L2 and R2, upper side outer panels | 1492.74 x 1142.74 x 48.5 | WALL 210104 P01 STEP, as L2 | no
1-09 | 410101 | CEILING - PANEL ASSY - C1 | Trần - tấm trái (cụm) | C1 | 1 | pallet 1, stack slot 9 from the open face | 7 | 14.618 | calculation (CAD) | roll-up: Ceiling outer panels C1 and C2, with their bond line | 1495 x 1200.61 x 46 | skeleton named values: wall_depth long, half_pw wide, outer_t | no
1-10 | 410102 | CEILING - PANEL ASSY - C2 | Trần - tấm phải (cụm) | C2 | 1 | pallet 1, stack slot 10 from the open face | 7 | 15.952 | calculation (CAD) | roll-up: Ceiling outer panels C1 and C2, with their bond line; roll-up: Roof slot grille 611602 and roof sleeve 611601, with C2 | 1495 x 1200.61 x 71 | CEILING 410000 P01 STEP with AIR's roof sleeve 611601 seated loose in its roof slot (22 mm below the frame), its top flange on the roof, and the grille 611602 over it (AIR 610000 P01 STEP, the AIR follow-up's sleeve flange): 71 thick | no | the roof sleeve and grille ride loose with C2 (#263), the grille's 4 bolts and washers (J-AIR-03) in a bag taped to the grille: the sleeve seated in C2's roof slot and taped, the grille taped flat over it; both come off at unpacking and go on after the soffit hangs (guide step 17)
1-11 | 510102 | LINING - CASSETTE - SIDE LOWER - RH | Cassette lót vách phải dưới (khay thép + tấm tiêu âm) | R1 | 1 | pallet 1, stack slot 11 from the open face | 14 | 10.341 | calculation (CAD) | roll-up: Wall cassette, side, lower, with 12 mm lips, no clip rails | 1445 x 1142.74 x 38 | WALL 510102 P01 STEP: tray 34 and the HOLD clip zones 4 mm on its back | no
1-12 | 510104 | LINING - CASSETTE - SIDE UPPER - RH | Cassette lót vách phải trên (khay thép + tấm tiêu âm) | R2 | 1 | pallet 1, stack slot 12 from the open face | 14 | 9.912 | calculation (CAD) | roll-up: Wall cassette, side, upper, with 12 mm lips, no clip rails | 1445 x 1092.74 x 38 | WALL 510104 P01 STEP: tray 34 and the HOLD clip zones 4 mm on its back | no
1-13 | 510101 | LINING - CASSETTE - SIDE LOWER - LH | Cassette lót vách trái dưới (khay thép + tấm tiêu âm) | L1 | 1 | pallet 1, stack slot 13 from the open face | 14 | 10.341 | calculation (CAD) | roll-up: Wall cassette, side, lower, with 12 mm lips, no clip rails | 1445 x 1142.74 x 38 | WALL 510101 P01 STEP: tray 34 and the HOLD clip zones 4 mm on its back | no
1-14 | 510103 | LINING - CASSETTE - SIDE UPPER - LH | Cassette lót vách trái trên (khay thép + tấm tiêu âm) | L2 | 1 | pallet 1, stack slot 14 from the open face | 14 | 9.912 | calculation (CAD) | roll-up: Wall cassette, side, upper, with 12 mm lips, no clip rails | 1445 x 1092.74 x 38 | WALL 510103 P01 STEP: tray 34 and the HOLD clip zones 4 mm on its back | no
1-15 | 510201 | LINING - CASSETTE - BACK LOWER - B1 | Cassette lót vách hậu dưới trái (khay thép + tấm tiêu âm) | B1 | 1 | pallet 1, stack slot 15 from the open face | 14 | 8.013 | calculation (CAD) | roll-up: Wall cassette, back, lower, with 12 mm lips, no clip rails | 1166 x 1118.61 x 38 | WALL 510201 P01 STEP: tray 34 and the HOLD clip zones 4 mm on its back | no
1-16 | 510202 | LINING - CASSETTE - BACK LOWER - B2 | Cassette lót vách hậu dưới phải (khay thép + tấm tiêu âm) | B2 | 1 | pallet 1, stack slot 16 from the open face | 14 | 8.013 | calculation (CAD) | roll-up: Wall cassette, back, lower, with 12 mm lips, no clip rails | 1166 x 1118.61 x 38 | WALL 510202 P01 STEP: tray 34 and the HOLD clip zones 4 mm on its back | no
1-17 | 510203 | LINING - CASSETTE - BACK UPPER - B3 | Cassette lót vách hậu trên trái (khay thép + tấm tiêu âm) | B3 | 1 | pallet 1, stack slot 17 from the open face | 14 | 8.399 | calculation; lips confirmed | roll-up: Wall cassette, back, upper, with 12 mm lips, no clip rails | 1166 x 1116.87 x 38 | skeleton P04; 38 thick as B1's cassette in CAD (no CAD of its own yet) | no
1-18 | 510204 | LINING - CASSETTE - BACK UPPER - B4 | Cassette lót vách hậu trên phải (khay thép + tấm tiêu âm) | B4 | 1 | pallet 1, stack slot 18 from the open face | 14 | 8.399 | calculation; lips confirmed | roll-up: Wall cassette, back, upper, with 12 mm lips, no clip rails | 1166 x 1116.87 x 38 | skeleton P04; 38 thick as B1's cassette in CAD (no CAD of its own yet) | no
2-01 | 360002 | FRONT - FIXED GLASS UNIT | Cụm vách kính cố định | - | 2 | pallet 2, tier 1, glass crate, layer 2 from the bottom | 9 | 28.743 | calculation (CAD); magnetic seal HOLD | roll-up: Fixed glass unit 360002: 4+4 pane, U-profile, U-seal and magnetic seal half x 0.973022 | 2034 x 1031 x 12 | FRONT 360002 P01 STEP: the pane with its 180 seal half, 2034 x 1027 x 12 (its U-channels and U-seals ship elsewhere) | yes | the pane with its 180 seal; its U-channels and seals ship fitted on the sill (PM ruling), in DR and in DT (D-68)
2-02 | 360001 | FRONT - DOOR UNIT | Cụm cửa kính | - | 2 | pallet 2, tier 1, glass crate, layer 1 from the bottom | 10 | 48.590 | calculation (CAD); hinges and pull HOLD | roll-up: Door unit 360001: 4+4 leaf, hollow kick strip, drop seal, hinges, strike, magnetic seal, pull | 2096 x 1177 x 149 | FRONT 360001 P01 STEP without its hinges: 2095.5 x 1177 x 148.8 (the magnetic seal half 2 mm past the glass, the pulls 70 a side); the hinge halves that sit in DL ship in DL (PM ruling) | yes
2-03 | 350003 | FRONT - DECOR BLOCK ASSY - DR | Khối trang trí phải (cụm) | DR | 2 | pallet 2, tier 2, lane 1030 mm, flat | 9 | 13.543 | calculation (CAD); calculation (CAD); magnetic seal HOLD | roll-up: Decor block - right; roll-up: Fixed glass unit 360002: 4+4 pane, U-profile, U-seal and magnetic seal half x 0.018405 | 2290 x 1020 x 206 | FRONT 350003 P01 STEP less its loose inner face panel and felt: 2290 x 1020 x 205.9, to the seal on the frame's back ring (Y -644.14); AIR's reserved spaces in it are empty when it ships | no | lies on its flat front face on a foam sheet, its open back up, nothing on it (PM, 2026-11-01); its inner face panel ships loose as 2-22 (D-130)
2-04 | 110103 | BASE - BAND ASSY - BACK | Viền chân nhôm - cạnh sau (cụm) | - | 2 | pallet 2, tier 2, lane 60 mm, on edge | 2 | 3.438 | assumption (CAD, HOLD); calculation (CAD); calculation (CAD); confirmed (1.5 mm); calculation (CAD); kg/m source | roll-up: Base band piece 100x40 - back, 1.5 mm wall; roll-up: Levelling glide (hex from above) x 3; roll-up: Glide load blocks: BASE's load block inside the band at each glide x 0.333333; roll-up: Base seal: BASE's soft lip along the band pieces' inner faces x 2.4 | 2420 x 118 x 50 | BASE 110000 P01 STEP (P02 batch 1, S54): the back band 110103, 2420 x 118 x 50: tube 40 with the soft lip 10 on its inner face, glides 10 below, spigots 8 above; no keys (D-129: the side bands carry them) | no | 3 glides fitted, each on its 5 mm load block inside the band (BASE CAD; D-86); the soft lip bonded along its inner face (D-132); welded end plates with open-bottom slots for the side bands' back-corner keys (D-129)
2-05 | 110101 | BASE - BAND ASSY - SIDE - LH | Viền chân nhôm - cạnh trái (cụm) | - | 2 | pallet 2, tier 2, lane 60 mm, on edge | 2 | 2.582 | assumption (CAD, HOLD); calculation (CAD); calculation (CAD); confirmed (1.5 mm); calculation (CAD); kg/m source | roll-up: Base band piece 100x40 - side LH, 1.5 mm wall; roll-up: Levelling glide (hex from above) x 2; roll-up: Glide load blocks: BASE's load block inside the band at each glide x 0.222222; roll-up: Corner key x 2; roll-up: Base seal: BASE's soft lip along the band pieces' inner faces x 1.462 | 1530 x 118 x 50 | BASE 110000 P01 STEP (P02 batch 1, S54): the side band 110101, 1520 x 118 x 50 with the lip, its back-corner key and that key's hook studs; planned 1530: about 2 mm more for the front-corner key's studs past the mitred front end (calculation from corner-keys.csv) and the rest spare (assumption) until BASE's CAD carries that key | no | 2 glides fitted, each on its load block inside the band (BASE CAD; D-86); the soft lip along its inner face (D-132); the back-corner key 111211 against its inner wall (D-129) and the front-corner key 111212 in its front end, both fitted at the factory (J-BASE-02; BASE's batch 1 lists the back key, corner-keys.csv puts the front key here too)
2-06 | 110102 | BASE - BAND ASSY - SIDE - RH | Viền chân nhôm - cạnh phải (cụm) | - | 2 | pallet 2, tier 2, lane 60 mm, on edge | 2 | 2.585 | assumption (CAD, HOLD); calculation (CAD); calculation (CAD); confirmed (1.5 mm); calculation (CAD); kg/m source | roll-up: Base band piece 100x40 - side RH, 1.5 mm wall; roll-up: Levelling glide (hex from above) x 2; roll-up: Glide load blocks: BASE's load block inside the band at each glide x 0.222222; roll-up: Corner key x 2; roll-up: Base seal: BASE's soft lip along the band pieces' inner faces x 1.464 | 1530 x 118 x 50 | BASE 110000 P01 STEP (P02 batch 1, S54): the side band 110102, 1522 x 118 x 50, as LH; planned 1530 for the same reason | no | 2 glides fitted, each on its load block inside the band (D-86); the soft lip along its inner face (D-132); the back-corner key 111211 against its inner wall (D-129) and the front-corner key 111213 in its front end, both fitted at the factory (J-BASE-02; BASE's batch 1 lists the back key, corner-keys.csv puts the front key here too)
2-07 | 110106 | BASE - BAND ASSY - FRONT - FIXED GLASS | Viền chân trước - dưới kính cố định (cụm) | - | 2 | pallet 2, tier 4, lane 150 mm, on edge | 2 | 2.496 | assumption (CAD, HOLD); calculation (CAD); calculation (CAD); confirmed (1.5 mm); calculation (CAD); kg/m source; calculation (CAD); magnetic seal HOLD | roll-up: Base band piece FR1 under the fixed glass, 1.5 mm wall, with its sill; roll-up: Levelling glide (hex from above) x 2; roll-up: Glide load blocks: BASE's load block inside the band at each glide x 0.222222; roll-up: Base seal: BASE's soft lip along the band pieces' inner faces x 0.803; roll-up: Fixed glass unit 360002: 4+4 pane, U-profile, U-seal and magnetic seal half x 0.00609411 | 747 x 161 x 110 | BASE 110000 P01 STEP (P02 batch 1, S54): FR1 110106 with its sill 111301, 746.54 x 160.5 x 110; the fixed glass's bottom U-channel (15 x 15, FRONT 368004) sits inside the sill's box | no | FR1 under the fixed glass, its sill with the glass's bottom U-channel and seal fitted at the factory with 4 M3 countersunk screws into the sill's rivnuts (PM ruling; J-FRONT-04); 2 glides on their load blocks (D-86); the soft lip along its inner face (D-132)
2-08 | 350001 | FRONT - DECOR BLOCK ASSY - DL | Khối trang trí trái (cụm) | DL | 2 | pallet 2, tier 3, lane 209 mm, on edge | 8 | 12.320 | calculation (CAD) | roll-up: Decor block - left | 2292 x 308 x 199 | FRONT 350001 P01 STEP: its hinge-side stops stand 30 mm past the skin | no | the hinge halves that sit in DL ship fitted in it (PM ruling); stands on its outer side, stops and seals up
2-09 | 610201 | AIR - SOFFIT | Hộp gió trần trên cửa (cụm) | - | 2 | pallet 2, tier 3, lane 369 mm, flat | 16 | 14.598 | assumption; calculation (CAD); calculation (CAD); hinges, latches and studs HOLD; fill provisional | roll-up: Soffit 610201: underside sections, front face, rails, end and door-side plates, fill, exhaust grille, hangers, hinges, latches; roll-up: Exhaust fan box 610402, in the soffit; roll-up: Four 12 V fans x 0.5 | 2322 x 359 x 233 | AIR 610000 P01 STEP: the soffit 610201 with its exhaust fan box and fans (the roof sleeve ships with C2, #263) | no | exhaust fan box 610402 with its 2 fans fitted inside the soffit's right end at the factory (D-87), the roof sleeve's gasket on its top; the exhaust cartridge ships on its own (2-18)
2-10 | 610101 | AIR - AIR COLUMN | Cột gió (cụm) | - | 2 | pallet 2, tier 3, lane 222 mm, on edge | 15 | 8.151 | calculation (CAD); fill provisional | roll-up: Air column 610101: felt-covered faces, corner angles, foot and plenum plates, fill, kick grille | 2120 x 359 x 212 | AIR 610000 P01 STEP: the column 610101 with its faces, angles, plates, fill and kick grille, without the supply cartridge; 2120 tall since D-132 (its foot at Z 0, no mat), 14 mm under the install sheet's 2134 elevator door (the Lead's OK, 2026-11-01) | no
2-11 | 350002 | FRONT - DECOR BLOCK ASSY - DT | Khối trang trí trên (cụm) | DT | 2 | pallet 2, tier 3, lane 316 mm, flat | 11 | 7.903 | calculation (CAD); calculation (CAD); magnetic seal HOLD | roll-up: Decor block - top; roll-up: Fixed glass unit 360002: 4+4 pane, U-profile, U-seal and magnetic seal half x 0.00247854 | 1699 x 306 x 203 | FRONT 350002 P01 STEP: the door's top stop and catch stand 26 mm below the skin | no
2-12 | TBD (ELECTRICAL) | ELECTRICAL - KIT - HARNESS, CORD SET, HUB ZONE, LIGHTS | Bộ điện: dây, dây nguồn, hub, đèn | - | 2 | pallet 2, tier 3, lane 316 mm, flat | 12 | 2.446 | calculation (CAD) | roll-up: Switches and harness, power unit, cord set, hub zone and lights (ELECTRICAL) x 0.413212 | 600 x 250 x 200 | carton (assumption) | no
2-13 | 810201 | INTERIOR - LIGHT SHELF ASSY | Kệ đèn hắt (cụm) | - | 2 | pallet 2, tier 4, lane 90 mm, flat | 19 | 1.569 | calculation (CAD) | roll-up: Light shelf along the side and back wall tops (its LED strip is in ELECTRICAL's line) | 2332 x 80 x 60 | bundle (assumption): INTERIOR's parts list 810201, the 2332 back shelf and the two 991 side shelves (60 x 40 sections) two high, the down channel and the diffuser inside them | no
2-14 | TBD (BASE) | BASE - SMALL PARTS CARTON | Thùng phụ kiện đế | - | 2 | pallet 2, tier 4, lane 150 mm, on edge | 2 | 1.139 | calculation (CAD); calculation; confirmed (1.5 mm) | roll-up: Base band piece 100x40 - front-l, 1.5 mm wall; roll-up: Base band piece 100x40 - front-r, the intake part, 1.5 mm wall; roll-up: Corner key x 2 | 600 x 400 x 150 | carton (assumption): the front-left band pieces FL1 (with its knee key 111214) and FL2, faceted, under DL; the mesh intake piece under DR with DR's support, the closing plate (D-62) and the intake support rail with its inline key 111215 (D-144) | no | the intake part: the rest of the study's front-r line after FR1, which is BASE's CAD now (S54), until BASE's batch 3; the keys are fitted at the factory in the ends that carry them (J-BASE-02)
2-15 | 810101 | INTERIOR - WORK WALL LEDGE ASSY | Bàn tựa vách làm việc (cụm) | - | 2 | pallet 2, tier 4, lane 150 mm, on edge | 22 | 1.895 | calculation (CAD); brackets and screen rail HOLD | roll-up: Work-wall ledge, 1000 mm, with the screen rail | 1000 x 250 x 120 | carton (assumption): INTERIOR's parts list, the 1000 x 250 ledge top 811101 with its 2 brackets 818101 (HOLD) and the screen rail 818102 (HOLD) | no | one carton with the screen rail 818102 (HOLD), as the roll-up's ledge line carries both
2-16 | 610401 | AIR - SUPPLY FAN BOX | Hộp quạt cấp (cụm) | - | 2 | pallet 2, tier 4, lane 526 mm, flat | 13 | 12.740 | assumption; calculation (CAD); foot, mesh and boot assumption; calculation (CAD); transitions HOLD at their sized masses | roll-up: Intake riser 611501, in the right block; ships loose, fitted on site; roll-up: Supply fan box 610401 with its two transitions, in the right block; ships loose, fitted on site; roll-up: Four 12 V fans x 0.5 | 2005 x 516 x 203 | AIR 610000 P01 STEP: the supply fan box 610401 joined with the intake riser 611501, both transitions and its 2 fans; the Air Engineer's next pass makes it 169 deep, plus D-130's intake boot under it | no | the intake riser joined to the supply fan box at the factory, one plug-in connector (D-87)
2-17 | 610301 | AIR - SPLITTER CARTRIDGE - COMMON | Ống tiêu âm (dùng chung cấp/thải) | - | 2 | pallet 2, tier 4, lane 183 mm, on edge | 15 | 10.548 | calculation (CAD) | roll-up: Supply cartridge, in the air column | 1750 x 314 x 173 | AIR 610000 P01 STEP: the cartridge 610301 as it sits in the column | no | the supply path's cartridge
2-18 | 610301 | AIR - SPLITTER CARTRIDGE - COMMON | Ống tiêu âm (dùng chung cấp/thải) | - | 2 | pallet 2, tier 4, lane 183 mm, on edge | 16 | 10.548 | calculation (CAD) | roll-up: Exhaust cartridge, in the soffit | 1750 x 314 x 173 | AIR 610000 P01 STEP: the same part, as it sits in the soffit | no | the exhaust path's cartridge
2-19 | 510301 | LINING - CASSETTE - CEILING - COMMON | Cassette trần (dùng chung trái/phải) | C1 | 2 | pallet 2, tier 5, lane 1058 mm, flat | 18 | 9.445 | calculation (CAD); fill provisional | roll-up: Ceiling cassettes, one part for both halves | 1163 x 1048 x 74 | CEILING 410000 P01 STEP: 1160 x 1045 x 74, the tray with its ribs, felt, fill bays, clips and catches; returns 1163 x 1048 (PR #32) | no
2-20 | 510301 | LINING - CASSETTE - CEILING - COMMON | Cassette trần (dùng chung trái/phải) | C2 | 2 | pallet 2, tier 5, lane 1058 mm, flat | 18 | 9.445 | calculation (CAD); fill provisional | roll-up: Ceiling cassettes, one part for both halves | 1163 x 1048 x 74 | as 2-19 | no
2-21 | 109000 | POD - INSTALLATION KIT (OPEN FIRST) | Bộ phụ kiện lắp (mở trước) | - | 2 | pallet 2, tier 5, lane 150 mm, flat | 1 | 3.550 | assumption | not in the roll-up: the 5 mm hex key 108001, spare bolts and washers, 2 clamp-on glass stays (step 9), setting packers 1 to 5 mm for 2 stacks up to 15 mm (step 10), this guide, the label map (assumption) | 900 x 150 x 80 | carton (assumption), long enough for the 2 collapsed glass stays | no
2-22 | 351305 | FRONT - DECOR INNER FACE PANEL - DR - REMOVABLE | Tấm mặt trong tháo được khối phải | DR | 2 | pallet 2, tier 6, lane 981 mm, flat | 13 | 8.101 | calculation (CAD) | roll-up: DR inner face panel 351305 with its felt 351304, ships loose, fitted on site after the air unit | 2042 x 971 x 12 | FRONT 350003 P01 STEP: the panel 2042 x 969.5 x 3 with its felt 351304 (9) glued on: 12 thick | no | ships loose (D-130): flat, felt face up and protected, nothing on it; its 21 M6 x 16 screws and washers bagged and labelled with it (their mass is in the fixings line); fitted after the air unit (step 13)
