autonomous-ai/spaceship/v2/03-Manufacturing/ceiling/410000_P01_CEILING-PARTS-LIST_BOM.csv

part_number | name | name_vi | kind | parent | qty_per_parent | qty_per_pod | material | finish | process | maker | sku | torque | size_mm | tolerance | mass_each_kg | mass_status | revision | status | source
410000 | CEILING | Trần | HS |  | 1 | 1 |  |  |  |  |  |  | 2403.48 x 1495.00 x 84 (X x Y x Z) |  | 49.380 | calculation (sum of its parts) | P01 | DRAFT | assembly tree; conventions s6
410101 | CEILING - PANEL ASSY - C1 | Trần - tấm trái (cụm) | HS | ceiling | 1 | 1 |  |  |  |  |  |  | 1200.61 x 1495.00 x 46 |  | 14.980 | calculation (sum of its parts) | P01 | DRAFT | assembly tree; conventions s6
410102 | CEILING - PANEL ASSY - C2 | Trần - tấm phải (cụm) | HS | ceiling | 1 | 1 |  |  |  |  |  |  | 1200.61 x 1495.00 x 46 |  | 14.630 | calculation (sum of its parts) | P01 | DRAFT | assembly tree; conventions s6
411101 | CEILING - PANEL FRAME - C1 | Trần trái - khung thép | HS | assy_c1 | 1 | 1 | Galvanized steel S280GD+Z or SGC400 (yield 280 MPa or more), Z100: the members below, welded | its members pre-galvanized Z100; every weld's burnt zone wire-brushed and coated with 2-component zinc-rich epoxy (J-FRAME-01); the bond prep on the skin face (D-137) | welded in a jig (D-131, J-FRAME-01): the corners with their mitre plates, then the T joints; no vent or drain holes; every joint hole made after welding, from the joint faces |  |  |  | 1198.99 x 1495.00 x 40 | welded in a jig (J-FRAME-01): diagonals equal within 1.5 and the skin-side faces within +/-0.5 of one plane, measured after welding (J-FRAME-01); outer size +/-0.5 (assumption); spigot to closing face +/-0.1 (ST-04) | 7.984 | calculation (sum of its parts) | P01 | DRAFT | D-16, D-34, D-55; D-131 and J-FRAME-01 (welded galvanized steel, the mitre plates, the gauges); D-117 (mitred corners), D-120 (member parts); PM rulings 2026-10-31 (3 cross members; frame 1198.99; bolt lines per the joints register); R-J3 40 x 40 back member; J-CEIL-01, J-CEIL-02
411102 | CEILING - PANEL FRAME - C2 | Trần phải - khung thép | HS | assy_c2 | 1 | 1 | Galvanized steel S280GD+Z or SGC400 (yield 280 MPa or more), Z100: the members below, welded | its members pre-galvanized Z100; every weld's burnt zone wire-brushed and coated with 2-component zinc-rich epoxy (J-FRAME-01); the bond prep on the skin face (D-137) | welded in a jig (D-131, J-FRAME-01): the corners with their mitre plates, then the T joints; no vent or drain holes; every joint hole made after welding, from the joint faces |  |  |  | 1198.99 x 1495.00 x 40 | welded in a jig (J-FRAME-01): diagonals equal within 1.5 and the skin-side faces within +/-0.5 of one plane, measured after welding (J-FRAME-01); outer size +/-0.5 (assumption); spigot to closing face +/-0.1 (ST-04) | 7.978 | calculation (sum of its parts) | P01 | DRAFT | D-16, D-34, D-55; D-131 and J-FRAME-01 (welded galvanized steel, the mitre plates, the gauges); D-117 (mitred corners), D-120 (member parts); PM rulings 2026-10-31 (3 cross members; frame 1198.99; bolt lines per the joints register); R-J3 40 x 40 back member; J-CEIL-01, J-CEIL-02
412101 | CEILING - FRAME SIDE MEMBER - COMMON | Trần - thanh cạnh của khung (dùng chung) | MP | frame_c1|frame_c2 | 1 | 2 | Galvanized steel S280GD+Z or SGC400 (yield 280 MPa or more), Z100 | pre-galvanized Z100; each weld's burnt zone wire-brushed and coated with 2-component zinc-rich epoxy (J-FRAME-01); the bond prep on the skin face (D-137) | tube cut to length (mitred ends where it meets the corners, cut back for the 2.0 mitre plate), welded into the frame; holes CNC or jig drilled after welding (+/-0.2 from the spigot hole, R-J6) |  |  |  | 20 x 40 x 1.0 tube, 1491.35 long at the outer face, front end mitred 45 deg, back end mitred 63.43 deg off square | cut length +/-0.5, mitre angles +/-0.25 deg (assumption); holes and slots +/-0.2 from the round spigot hole (R-J6) | 1.321 | calculation (Fusion, CAD geometry x density) | P01 | DRAFT | D-120 (number from the master BOM's allocation); D-117 (mitred corners); D-131 and J-FRAME-01 (galvanized steel 20 x 40 and 40 x 40 R-J3, 1.0 or 0.8 wall, cut back for the 2.0 mitre plates); joints register J-CEIL-01, J-CEIL-02
412102 | CEILING - FRAME SEAM MEMBER - C1 | Trần trái - thanh mối nối của khung | MP | frame_c1 | 1 | 1 | Galvanized steel S280GD+Z or SGC400 (yield 280 MPa or more), Z100 | pre-galvanized Z100; each weld's burnt zone wire-brushed and coated with 2-component zinc-rich epoxy (J-FRAME-01); the bond prep on the skin face (D-137) | tube cut to length (mitred ends where it meets the corners, cut back for the 2.0 mitre plate), welded into the frame; holes CNC or jig drilled after welding (+/-0.2 from the spigot hole, R-J6) |  |  |  | 20 x 40 x 1.0 tube, 1491.35 long at the outer face, front end mitred 45 deg, back end mitred 63.43 deg off square | cut length +/-0.5, mitre angles +/-0.25 deg (assumption); holes and slots +/-0.2 from the round spigot hole (R-J6) | 1.324 | calculation (Fusion, CAD geometry x density) | P01 | DRAFT | D-120 (number from the master BOM's allocation); D-117 (mitred corners); D-131 and J-FRAME-01 (galvanized steel 20 x 40 and 40 x 40 R-J3, 1.0 or 0.8 wall, cut back for the 2.0 mitre plates); joints register J-CEIL-01, J-CEIL-02
412103 | CEILING - FRAME FRONT MEMBER - C1 | Trần trái - thanh trước của khung | MP | frame_c1 | 1 | 1 | Galvanized steel S280GD+Z or SGC400 (yield 280 MPa or more), Z100 | pre-galvanized Z100; each weld's burnt zone wire-brushed and coated with 2-component zinc-rich epoxy (J-FRAME-01); the bond prep on the skin face (D-137) | tube cut to length (mitred ends where it meets the corners, cut back for the 2.0 mitre plate), welded into the frame; holes CNC or jig drilled after welding (+/-0.2 from the spigot hole, R-J6) |  |  |  | 20 x 40 x 1.0 tube, 1196.16 long at the outer face, both ends mitred 45 deg | cut length +/-0.5, mitre angles +/-0.25 deg (assumption); holes and slots +/-0.2 from the round spigot hole (R-J6) | 1.063 | calculation (Fusion, CAD geometry x density) | P01 | DRAFT | D-120 (number from the master BOM's allocation); D-117 (mitred corners); D-131 and J-FRAME-01 (galvanized steel 20 x 40 and 40 x 40 R-J3, 1.0 or 0.8 wall, cut back for the 2.0 mitre plates); joints register J-CEIL-01, J-CEIL-02
412104 | CEILING - FRAME BACK MEMBER 40 X 40 - C1 | Trần trái - thanh sau 40x40 của khung | MP | frame_c1 | 1 | 1 | Galvanized steel S280GD+Z or SGC400 (yield 280 MPa or more), Z100 | pre-galvanized Z100; each weld's burnt zone wire-brushed and coated with 2-component zinc-rich epoxy (J-FRAME-01); the bond prep on the skin face (D-137) | tube cut to length (mitred ends where it meets the corners, cut back for the 2.0 mitre plate), welded into the frame; holes CNC or jig drilled after welding (+/-0.2 from the spigot hole, R-J6) |  |  |  | 40 x 40 x 1.0 tube, 1196.75 long at the outer face, both ends mitred 26.57 deg off square | cut length +/-0.5, mitre angles +/-0.25 deg (assumption); holes and slots +/-0.2 from the round spigot hole (R-J6) | 1.437 | calculation (Fusion, CAD geometry x density) | P01 | DRAFT | D-120 (number from the master BOM's allocation); D-117 (mitred corners); D-131 and J-FRAME-01 (galvanized steel 20 x 40 and 40 x 40 R-J3, 1.0 or 0.8 wall, cut back for the 2.0 mitre plates); joints register J-CEIL-01, J-CEIL-02
412105 | CEILING - FRAME CROSS MEMBER 1 - COMMON | Trần - thanh ngang 1 của khung (dùng chung) | MP | frame_c1|frame_c2 | 1 | 2 | Galvanized steel S280GD+Z or SGC400 (yield 280 MPa or more), Z100 | pre-galvanized Z100; each weld's burnt zone wire-brushed and coated with 2-component zinc-rich epoxy (J-FRAME-01); the bond prep on the skin face (D-137) | tube cut to length (mitred ends where it meets the corners, cut back for the 2.0 mitre plate), welded into the frame; holes CNC or jig drilled after welding (+/-0.2 from the spigot hole, R-J6) |  |  |  | 20 x 40 x 1.0 tube, 1158.99 long at the outer face, square cut | cut length +/-0.5, mitre angles +/-0.25 deg (assumption); holes and slots +/-0.2 from the round spigot hole (R-J6) | 1.054 | calculation (Fusion, CAD geometry x density) | P01 | DRAFT | D-120 (number from the master BOM's allocation); D-117 (mitred corners); D-131 and J-FRAME-01 (galvanized steel 20 x 40 and 40 x 40 R-J3, 1.0 or 0.8 wall, cut back for the 2.0 mitre plates); joints register J-CEIL-01, J-CEIL-02
412202 | CEILING - FRAME SEAM MEMBER - C2 | Trần phải - thanh mối nối của khung | MP | frame_c2 | 1 | 1 | Galvanized steel S280GD+Z or SGC400 (yield 280 MPa or more), Z100 | pre-galvanized Z100; each weld's burnt zone wire-brushed and coated with 2-component zinc-rich epoxy (J-FRAME-01); the bond prep on the skin face (D-137) | tube cut to length (mitred ends where it meets the corners, cut back for the 2.0 mitre plate), welded into the frame; holes CNC or jig drilled after welding (+/-0.2 from the spigot hole, R-J6) |  |  |  | 20 x 40 x 1.0 tube, 1491.35 long at the outer face, front end mitred 45 deg, back end mitred 63.43 deg off square | cut length +/-0.5, mitre angles +/-0.25 deg (assumption); holes and slots +/-0.2 from the round spigot hole (R-J6) | 1.313 | calculation (Fusion, CAD geometry x density) | P01 | DRAFT | D-120 (number from the master BOM's allocation); D-117 (mitred corners); D-131 and J-FRAME-01 (galvanized steel 20 x 40 and 40 x 40 R-J3, 1.0 or 0.8 wall, cut back for the 2.0 mitre plates); joints register J-CEIL-01, J-CEIL-02
412203 | CEILING - FRAME FRONT MEMBER - C2 | Trần phải - thanh trước của khung | MP | frame_c2 | 1 | 1 | Galvanized steel S280GD+Z or SGC400 (yield 280 MPa or more), Z100 | pre-galvanized Z100; each weld's burnt zone wire-brushed and coated with 2-component zinc-rich epoxy (J-FRAME-01); the bond prep on the skin face (D-137) | tube cut to length (mitred ends where it meets the corners, cut back for the 2.0 mitre plate), welded into the frame; holes CNC or jig drilled after welding (+/-0.2 from the spigot hole, R-J6) |  |  |  | 20 x 40 x 1.0 tube, 1196.16 long at the outer face, both ends mitred 45 deg | cut length +/-0.5, mitre angles +/-0.25 deg (assumption); holes and slots +/-0.2 from the round spigot hole (R-J6) | 1.068 | calculation (Fusion, CAD geometry x density) | P01 | DRAFT | D-120 (number from the master BOM's allocation); D-117 (mitred corners); D-131 and J-FRAME-01 (galvanized steel 20 x 40 and 40 x 40 R-J3, 1.0 or 0.8 wall, cut back for the 2.0 mitre plates); joints register J-CEIL-01, J-CEIL-02
412204 | CEILING - FRAME BACK MEMBER 40 X 40 - C2 | Trần phải - thanh sau 40x40 của khung | MP | frame_c2 | 1 | 1 | Galvanized steel S280GD+Z or SGC400 (yield 280 MPa or more), Z100 | pre-galvanized Z100; each weld's burnt zone wire-brushed and coated with 2-component zinc-rich epoxy (J-FRAME-01); the bond prep on the skin face (D-137) | tube cut to length (mitred ends where it meets the corners, cut back for the 2.0 mitre plate), welded into the frame; holes CNC or jig drilled after welding (+/-0.2 from the spigot hole, R-J6) |  |  |  | 40 x 40 x 1.0 tube, 1196.75 long at the outer face, both ends mitred 26.57 deg off square | cut length +/-0.5, mitre angles +/-0.25 deg (assumption); holes and slots +/-0.2 from the round spigot hole (R-J6) | 1.437 | calculation (Fusion, CAD geometry x density) | P01 | DRAFT | D-120 (number from the master BOM's allocation); D-117 (mitred corners); D-131 and J-FRAME-01 (galvanized steel 20 x 40 and 40 x 40 R-J3, 1.0 or 0.8 wall, cut back for the 2.0 mitre plates); joints register J-CEIL-01, J-CEIL-02
412001 | CEILING - FRAME CROSS MEMBER - PLAIN - COMMON | Trần - thanh ngang trơn của khung (dùng chung) | MP | frame_c1|frame_c2 | 2 | 4 | Galvanized steel S280GD+Z or SGC400 (yield 280 MPa or more), Z100 | pre-galvanized Z100; each weld's burnt zone wire-brushed and coated with 2-component zinc-rich epoxy (J-FRAME-01); the bond prep on the skin face (D-137) | tube cut to length (mitred ends where it meets the corners, cut back for the 2.0 mitre plate), welded into the frame; holes CNC or jig drilled after welding (+/-0.2 from the spigot hole, R-J6) |  |  |  | 20 x 40 x 0.8 tube, 1158.99 long, square cut, no holes | cut length +/-0.5 (assumption) | 0.850 | calculation (Fusion, CAD geometry x density) | P01 | DRAFT | D-120 (number from the master BOM's allocation); D-117 (mitred corners); D-131 and J-FRAME-01 (galvanized steel 20 x 40 and 40 x 40 R-J3, 1.0 or 0.8 wall, cut back for the 2.0 mitre plates); joints register J-CEIL-01, J-CEIL-02
411301 | CEILING - SKIN - C1 | Trần trái - tấm ốp alu | MP | assy_c1 | 1 | 1 | ACP 3 mm EV3038, 3.5 kg/m2 | ACP EV3038 Dark Yellow (D-12) | CNC routed ACP |  |  |  | 1200.61 x 1495.00 x 3 | ISO 2768-m; no drawing (D-89 part 4): its DXF is the outline | 6.282 | calculation (Fusion, CAD geometry x density) | P01 | DRAFT | build plan VT01; D-12; D-42; skeleton half_pw 1200.61
411302 | CEILING - SKIN - C2 | Trần phải - tấm ốp alu (có khe thoát gió) | MP | assy_c2 | 1 | 1 | ACP 3 mm EV3038, 3.5 kg/m2 | ACP EV3038 Dark Yellow (D-12) | CNC routed ACP, roof slot and four Ø17 pass-through openings routed |  |  |  | 1200.61 x 1495.00 x 3, roof slot 285 x 294, 4 pass-through openings Ø17 under the roof sleeve's rivnuts | ISO 2768-m; roof slot from the closing-seam edge and the front edge +/-0.5 (critical: the roof sleeve, 1.0 smaller a side, passes through it, D-61, D-177); the 4 openings +/-0.2 from the slot (assumption); no drawing (D-89 part 4) | 5.986 | calculation (Fusion, CAD geometry x density) | P01 | DRAFT | build plan VT01; D-12; D-42; skeleton half_pw 1200.61; D-61 roof slot 285 x 294 (PM ruling 2026-10-31: two skins); D-177 (the sleeve rivnuts' clearance holes)
510301 | LINING - CASSETTE - CEILING - COMMON | Cassette trần (dùng chung trái/phải) | HS | ceiling | 2 | 2 |  |  |  |  |  |  | 1160 x 1045 x 34 (74 with the fill) | +/-1 assembled (assumption) | 9.885 | calculation (sum of its parts) | P01 | DRAFT | D-17, D-24, D-41, D-47; PM ruling 2026-10-31 (one part for both halves)
513101 | LINING - TRAY - CEILING | Khay thép cassette trần | MP | cassette | 1 | 2 | Galvanised steel DX51D+Z | galvanised (Z coating, grade to confirm) | sheet metal: laser cut, bent |  |  |  | 1160 x 1045 x 34, 0.5 sheet | cut +/-0.2, bent +/-0.5 (assumption) | 5.520 | calculation (Fusion, CAD geometry x density) | P01 | DRAFT | D-17, D-37; PM ruling 2026-10-31 (12 mm lip)
513102 | LINING - RIB - CEILING | Gân đỡ tấm tiêu âm trần | MP | cassette | 2 | 4 | Galvanised steel DX51D+Z | galvanised (Z coating, grade to confirm) | sheet metal: cut, bent |  |  |  | hat 44 x 24 x 1034.0 long, 0.5 sheet | length +/-1, bends +/-0.5 (assumption) | 0.364 | calculation (Fusion, CAD geometry x density) | P01 | DRAFT | PM ruling 2026-10-31 (2 ribs); rib joint HOLD
513201 | LINING - FELT - CEILING | Tấm tiêu âm PET 9 mm - trần | MP | cassette | 1 | 2 | PET felt 9 mm, 1.8 kg/m2 | Dark Gray (D-79) | CNC knife cut |  |  |  | 1157.0 x 1042.0 x 9 | knife cut +/-1 (assumption); two sprinkler zones marked, nothing cut | 2.170 | calculation (Fusion, CAD geometry x density) | P01 | DRAFT | D-17, D-31; felt fixing HOLD H09
513301 | LINING - FILL - CEILING - BAY A | Bông PET 40 mm - trần - ô A | MP | cassette | 1 | 2 | PET fill 24 kg/m3 (Sorberpoly 2D) |  | cut |  |  |  | 1110.5 x 363.5 x 40 | cut +/-2 (assumption); no drawing (D-128): 513301_P01_LINING-FILL-CEILING-BAY-A_DXF.dxf gives the full outline with every notch | 0.382 | calculation (Fusion, CAD geometry x density) | P01 | DRAFT | D-24, D-54; fixing HOLD H10
513302 | LINING - FILL - CEILING - BAY B | Bông PET 40 mm - trần - ô B | MP | cassette | 1 | 2 | PET fill 24 kg/m3 (Sorberpoly 2D) |  | cut |  |  |  | 1110.5 x 338.8 x 40 | cut +/-2 (assumption); no drawing (D-128): 513302_P01_LINING-FILL-CEILING-BAY-B_DXF.dxf gives the full outline with every notch | 0.358 | calculation (Fusion, CAD geometry x density) | P01 | DRAFT | D-24, D-54; fixing HOLD H10
513303 | LINING - FILL - CEILING - BAY C | Bông PET 40 mm - trần - ô C | MP | cassette | 1 | 2 | PET fill 24 kg/m3 (Sorberpoly 2D) |  | cut |  |  |  | 1110.5 x 271.8 x 40 | cut +/-2 (assumption); no drawing (D-128): 513303_P01_LINING-FILL-CEILING-BAY-C_DXF.dxf gives the full outline with every notch | 0.287 | calculation (Fusion, CAD geometry x density) | P01 | DRAFT | D-24, D-54; fixing HOLD H10
518001 | LINING - CASSETTE CLIP | Kẹp treo cassette | HOLD | cassette | 6 | 12 | HOLD envelope - no mass |  |  | HOLD-08 | HOLD-08: rated 4.9 kg pull-out each (ceiling, J-LIN-01), captive lock; latches when pushed home, so a ceiling cassette holds itself before its two catches go on (Packing's assembly review, PM ruling 2026-11-01) |  |  |  | 0.040 | assumption | P01 | HOLD | D-47, D-81; joints register H-10; HOLD-08, ISS-076; mass: joints register H-10 and PM ruling 2026-10-31: 0.040 kg each (D-81's working figure) until a named clip is weighed (HOLD-08)
518002 | LINING - CEILING SAFETY CATCH | Dây an toàn cassette trần | HOLD | cassette | 2 | 4 | HOLD envelope - no mass |  |  | HOLD-08 | HOLD-08: 48 kg working load per lanyard (T08) |  |  |  | 0.100 | assumption | P01 | HOLD | D-47; joints register H-11; HOLD-08, ISS-076; mass: PM ruling 2026-10-31 for the BOM check: 0.100 kg each until a named catch is weighed (joints register H-11, HOLD-08)
108002 | POD - ACP BOND SET - SIKAFLEX-252 WITH AKTIVATOR-205, PRIMER-210, FIXING TAPE | Bộ keo dán ACP | PI | assy_c1|assy_c2 | 1 | 2 | Sikaflex-252 system (bond spec section 8, D-131) |  |  | Sika | Sikaflex-252 system (bond spec V2-ENG-BND section 8): Sikaflex-252, Sika Aktivator-205 and Sika Primer-210 on both faces, SikaTack Panel Fixing Tape 3 x 12 |  |  |  | 0.503 | calculation | P01 | DRAFT | joints register H-12 (108002); bond spec section 8 (D-131): 0.28 kg/m2 x 1.795 m2 per ceiling outer panel
838001 | HARDWARE - SOCKET HEAD BOLT - M6 X 16 - ISO 4762 8.8 ZINC | Bulong lục giác chìm M6 × 16 | PI | assy_c1 | 4 | 4 | steel, property class 8.8 (ISO 898-1) | zinc plated |  | HOLD: any maker to ISO 4762, picked at the RFQ | ISO 4762 M6 x 16 - 8.8 - zinc plated | HOLD-01 (D-48): set by the PM from test T06 (half the lowest rivnut spin-out torque) |  |  | 0.0062 | calculation | P01 | DRAFT | joints register V2-ENG-JNT-01 2.1 (838001), 3.5 J-CEIL-01 / 3.6 J-CEIL-02; per piece; mass calculation: head 10 x 6 less the socket, shank 6 x 16 at 85% for the thread, steel 7850 kg/m3
838001 | HARDWARE - SOCKET HEAD BOLT - M6 X 16 - ISO 4762 8.8 ZINC | Bulong lục giác chìm M6 × 16 | PI | assy_c2 | 4 | 4 | steel, property class 8.8 (ISO 898-1) | zinc plated |  | HOLD: any maker to ISO 4762, picked at the RFQ | ISO 4762 M6 x 16 - 8.8 - zinc plated | HOLD-01 (D-48): set by the PM from test T06 (half the lowest rivnut spin-out torque) |  |  | 0.0062 | calculation | P01 | DRAFT | joints register V2-ENG-JNT-01 2.1 (838001), 3.5 J-CEIL-01 / 3.6 J-CEIL-02; per piece; mass calculation: head 10 x 6 less the socket, shank 6 x 16 at 85% for the thread, steel 7850 kg/m3
838002 | HARDWARE - SOCKET HEAD BOLT - M6 X 25 - ISO 4762 8.8 ZINC | Bulong lục giác chìm M6 × 25 (chốt mối nối khép) | PI | assy_c2 | 4 | 4 | steel, property class 8.8 (ISO 898-1) | zinc plated |  | HOLD: any maker to ISO 4762, picked at the RFQ | ISO 4762 M6 x 25 - 8.8 - zinc plated | snug only: a pin, not a clamp (joints register 2.10) |  |  | 0.0079 | calculation | P01 | DRAFT | joints register V2-ENG-JNT-01 2.1 (838002), 3.5 J-CEIL-01 / 3.6 J-CEIL-02; per piece; mass calculation: head 10 x 6 less the socket, shank 6 x 25 at 85% for the thread, steel 7850 kg/m3
838003 | HARDWARE - RIVET NUT - M6 - STEEL ZINC - SHEREX CAL2-610-4.2 | Tán rút M6 thép mạ kẽm | PI | assy_c1 | 8 | 8 | steel 1008/1010 | zinc plated, trivalent passivation |  | Sherex (PEM) | CAL2-610-4.2 | HOLD-01 (D-48): set by the PM from test T06 (half the lowest rivnut spin-out torque) |  |  | 0.0067 | calculation | P01 | DRAFT | joints register V2-ENG-JNT-01 2.1 (838003), 3.5 J-CEIL-01 / 3.6 J-CEIL-02; per piece; mass calculation: body 9.5 x 14.86 with an M6 bore and a 12.96 x 0.76 head (SHX2 sizes), steel 7850 kg/m3
838003 | HARDWARE - RIVET NUT - M6 - STEEL ZINC - SHEREX CAL2-610-4.2 | Tán rút M6 thép mạ kẽm | PI | assy_c2 | 10 | 10 | steel 1008/1010 | zinc plated, trivalent passivation |  | Sherex (PEM) | CAL2-610-4.2 | HOLD-01 (D-48): set by the PM from test T06 (half the lowest rivnut spin-out torque) |  |  | 0.0067 | calculation | P01 | DRAFT | joints register V2-ENG-JNT-01 2.1 (838003), 3.5 J-CEIL-01 / 3.6 J-CEIL-02; per piece; mass calculation: body 9.5 x 14.86 with an M6 bore and a 12.96 x 0.76 head (SHX2 sizes), steel 7850 kg/m3
838004 | HARDWARE - WASHER - M6 LARGE - ISO 7093-1 6.4 X 18 A2 | Long đen to M6 inox | PI | assy_c1 | 4 | 4 | stainless steel A2 | none (plain stainless) |  | HOLD: any maker to ISO 7093-1, picked at the RFQ | ISO 7093-1 - 6.4 x 18 x 1.6 - A2 |  |  |  | 0.0028 | calculation | P01 | DRAFT | joints register V2-ENG-JNT-01 2.1 (838004), 3.5 J-CEIL-01 / 3.6 J-CEIL-02; per piece; mass calculation: 6.4 x 18 x 1.6 (ISO 7093-1), 7900 kg/m3
838004 | HARDWARE - WASHER - M6 LARGE - ISO 7093-1 6.4 X 18 A2 | Long đen to M6 inox | PI | assy_c2 | 8 | 8 | stainless steel A2 | none (plain stainless) |  | HOLD: any maker to ISO 7093-1, picked at the RFQ | ISO 7093-1 - 6.4 x 18 x 1.6 - A2 |  |  |  | 0.0028 | calculation | P01 | DRAFT | joints register V2-ENG-JNT-01 2.1 (838004), 3.5 J-CEIL-01 / 3.6 J-CEIL-02; per piece; mass calculation: 6.4 x 18 x 1.6 (ISO 7093-1), 7900 kg/m3
838005 | HARDWARE - CAPTIVE RETAINER - M6 HEAD - GROMMET FOR 19 HOLE | Vòng giữ đầu bulong | HOLD | assy_c1 | 4 | 4 | elastomer (HOLD-02) | as supplied (elastomer) |  | HOLD-02 | HOLD-02 |  |  |  | 0.0010 | assumption | P01 | HOLD | joints register V2-ENG-JNT-01 2.1 (838005), 3.5 J-CEIL-01 / 3.6 J-CEIL-02; per piece; mass assumption: a small grommet; part not chosen (HOLD-02)
838005 | HARDWARE - CAPTIVE RETAINER - M6 HEAD - GROMMET FOR 19 HOLE | Vòng giữ đầu bulong | HOLD | assy_c2 | 4 | 4 | elastomer (HOLD-02) | as supplied (elastomer) |  | HOLD-02 | HOLD-02 |  |  |  | 0.0010 | assumption | P01 | HOLD | joints register V2-ENG-JNT-01 2.1 (838005), 3.5 J-CEIL-01 / 3.6 J-CEIL-02; per piece; mass assumption: a small grommet; part not chosen (HOLD-02)
831002 | HARDWARE - STOP WASHER - Ø10.5 X Ø20 X 1.5 - AL | Long đen chặn nhôm | MP | assy_c1 | 4 | 4 | aluminium sheet 1.5, 5000 or 6000 series | mill finish (punched) | punched (a part we make) | made (register H-08) |  |  |  |  | 0.0009 | calculation | P01 | DRAFT | joints register V2-ENG-JNT-01 2.1 (831002), 3.5 J-CEIL-01 / 3.6 J-CEIL-02; per piece; mass calculation: 10.5 x 20 x 1.5, 2700 kg/m3
831002 | HARDWARE - STOP WASHER - Ø10.5 X Ø20 X 1.5 - AL | Long đen chặn nhôm | MP | assy_c2 | 4 | 4 | aluminium sheet 1.5, 5000 or 6000 series | mill finish (punched) | punched (a part we make) | made (register H-08) |  |  |  |  | 0.0009 | calculation | P01 | DRAFT | joints register V2-ENG-JNT-01 2.1 (831002), 3.5 J-CEIL-01 / 3.6 J-CEIL-02; per piece; mass calculation: 10.5 x 20 x 1.5, 2700 kg/m3
831007 | HARDWARE - MITRE PLATE - 20 X 40 - 45 DEG - 2.0 STEEL | Tấm đệm góc vát 20 × 40 - 45° - thép 2.0 | MP | frame_c1 | 2 | 2 | galvanized steel 2.0, S280GD+Z or SGC400, Z100 (the frames' own steel) | welded in; zinc-rich touch-up with the frame's welds | laser cut from the frames' 2.0 galvanized steel, welded into the frame's corner (J-FRAME-01) | made (register H-40, J-FRAME-01) |  |  |  |  | 0.0166 | source | P01 | DRAFT | joints register H-40 (831007), J-FRAME-01 (D-131); the joints CAD README's placement; per piece; mass source: joints register H-40 (#308), 26.5 x 40 x 2.0 steel, 16.6 g
831007 | HARDWARE - MITRE PLATE - 20 X 40 - 45 DEG - 2.0 STEEL | Tấm đệm góc vát 20 × 40 - 45° - thép 2.0 | MP | frame_c2 | 2 | 2 | galvanized steel 2.0, S280GD+Z or SGC400, Z100 (the frames' own steel) | welded in; zinc-rich touch-up with the frame's welds | laser cut from the frames' 2.0 galvanized steel, welded into the frame's corner (J-FRAME-01) | made (register H-40, J-FRAME-01) |  |  |  |  | 0.0166 | source | P01 | DRAFT | joints register H-40 (831007), J-FRAME-01 (D-131); the joints CAD README's placement; per piece; mass source: joints register H-40 (#308), 26.5 x 40 x 2.0 steel, 16.6 g
831008 | HARDWARE - MITRE PLATE - 20 X 40 TO 40 X 40 - 2.0 STEEL | Tấm đệm góc vát 20 × 40 với 40 × 40 - thép 2.0 | MP | frame_c1 | 2 | 2 | galvanized steel 2.0, S280GD+Z or SGC400, Z100 (the frames' own steel) | welded in; zinc-rich touch-up with the frame's welds | laser cut from the frames' 2.0 galvanized steel, welded into the frame's corner (J-FRAME-01) | made (register H-41, J-FRAME-01) |  |  |  |  | 0.0261 | source | P01 | DRAFT | joints register H-41 (831008), J-FRAME-01 (D-131); the joints CAD README's placement; per piece; mass source: joints register H-41 (#308), 41.5 x 40 x 2.0 steel, 26.1 g
831008 | HARDWARE - MITRE PLATE - 20 X 40 TO 40 X 40 - 2.0 STEEL | Tấm đệm góc vát 20 × 40 với 40 × 40 - thép 2.0 | MP | frame_c2 | 2 | 2 | galvanized steel 2.0, S280GD+Z or SGC400, Z100 (the frames' own steel) | welded in; zinc-rich touch-up with the frame's welds | laser cut from the frames' 2.0 galvanized steel, welded into the frame's corner (J-FRAME-01) | made (register H-41, J-FRAME-01) |  |  |  |  | 0.0261 | source | P01 | DRAFT | joints register H-41 (831008), J-FRAME-01 (D-131); the joints CAD README's placement; per piece; mass source: joints register H-41 (#308), 41.5 x 40 x 2.0 steel, 26.1 g
848001 | SEALS - JOINT GASKET - 8 X 3.97 - PORON 4701-40 PSA | Gioăng mối nối 3.97 | PI | assy_c1 | 1.199 | 1.199 | PORON 4701-40 Soft polyurethane foam with PSA | none (foam, PSA liner one side) |  | Rogers (PORON), PSA laminated and slit by a converter (HOLD-05) | PORON 4701-40 Soft, 3.97 x 8 strip with PSA |  |  |  | 0.0076 | calculation | P01 | DRAFT | joints register V2-ENG-JNT-01 2.1 (848001), 3.5 J-CEIL-01 / 3.6 J-CEIL-02; per metre; mass calculation: per metre, 8 x 3.97 at 240 kg/m3 (assumption for the foam's density)
848001 | SEALS - JOINT GASKET - 8 X 3.97 - PORON 4701-40 PSA | Gioăng mối nối 3.97 | PI | assy_c2 | 1.199 | 1.199 | PORON 4701-40 Soft polyurethane foam with PSA | none (foam, PSA liner one side) |  | Rogers (PORON), PSA laminated and slit by a converter (HOLD-05) | PORON 4701-40 Soft, 3.97 x 8 strip with PSA |  |  |  | 0.0076 | calculation | P01 | DRAFT | joints register V2-ENG-JNT-01 2.1 (848001), 3.5 J-CEIL-01 / 3.6 J-CEIL-02; per metre; mass calculation: per metre, 8 x 3.97 at 240 kg/m3 (assumption for the foam's density)
848004 | SEALS - CLOSING SEAM BULB SEAL - GAP 4 TO 7 - EPDM OR TPE | Gioăng ống mối nối khép | HOLD | assy_c1 | 1.495 | 1.495 | EPDM or TPE hollow bulb (HOLD-12) | as supplied |  | HOLD-12 | HOLD-12: hollow bulb, working gap 4 to 7 |  |  |  | 0.0700 | assumption | P01 | HOLD | joints register V2-ENG-JNT-01 2.1 (848004), 3.5 J-CEIL-01 / 3.6 J-CEIL-02; per metre; mass assumption: per metre, a hollow EPDM bulb of about 60 mm2 at 1200 kg/m3; part HOLD-12
