autonomous-ai/spaceship/v2/03-Manufacturing/front/350001_P01_FRONT-DECOR-BLOCK-ASSY-DL_BOM.csv

part_number | name | name_vi | type | process | material | finish | qty | unit_mass_kg | mass_status | status | source | note | maker | sku
350001 | FRONT - DECOR BLOCK ASSY - DL | Khối trang trí trái (cụm) | assembly |  | - |  | 1 | 12.32 | calculation (sum of the rows below) | DRAFT | D-19, D-49, D-79; PM rulings 2026-10-31; this build | skin bonded to the welded tube frame 351104; ships with the hinges' frame halves fitted (packing plan)
351101 | FRONT - DECOR SKIN - DL | Tấm ốp alu khối trái | made: ACP panels, 45 deg mitred joints as v1, bonded to the frame | made: ACP panels, 45 deg mitred joints as v1, bonded to the frame | ACP 3 mm EV3038 Dark Yellow, PE core |  | 1 | 4.002 | calculation (CAD, 3.5 kg/m2: selection VT01) | DRAFT | D-12, D-49; skeleton DL shape | three hinge pockets (HOLD sizes); open at the bottom, where the frame's bottom ring stands on the band and takes its spigots (J-FRONT-02); one flat panel per outside face: 351101_P01_FRONT-DECOR-SKIN-DL_DXF.dxf; bond to the frame per the joints register's ACP bond spec (D-137): one 12 x 3 joint on every tube, the tubes 3 mm off the skin; in the corner between the door-side front posts and the front facet the bead fills a wedge 3 to 8.5 thick, about 78 ml per metre, twice the standard bead
351104 | FRONT - DECOR FRAME - DL | Khung trang trí trái (hàn) | weldment assembly: welded frame, 26 tubes as 16 parts (parts list 351104_P01_FRONT-DECOR-FRAME-DL_BOM.csv; cut list 351104_P01_FRONT-DECOR-FRAME-DL-TUBE-CUT-LIST.csv), TIG-welded |  | aluminium EN AW-6063-T6 tube 20 x 20 x 1.5 and 60 x 20 x 1.5 | mill finish (hidden, D-79) | 1 | 4.691 | calculation (sum of its parts list 351104_P01_FRONT-DECOR-FRAME-DL_BOM.csv) | DRAFT | v1 decor frame drawing (DL frame, 60 x 20 hinge members); D-79; joints register HOLD-10, ISS-045; D-120 (each tube its own part, #232) | 11.7 m of tube; welds per its weldment drawing; the door's load: hinges, hinge posts 352111, 352113 and 352115, rings, the bolt-line post 352104, back plate, bolts
351102 | FRONT - DECOR BACK PLATE - DL | Tấm hậu khối trái | made (laser-cut sheet, no drawing: D-89 part 4) | made (laser-cut sheet, no drawing: D-89 part 4) | aluminium EN AW-5754-H22 sheet 2.0 mm | mill finish (hidden, D-79); general tolerance ISO 2768-m | 1 | 3.149 | calculation (CAD, 2700 kg/m3) | DRAFT | joints register J-FRONT-01 (HOLD-10 answered: 2 mm aluminium) | DXF 351102_P01_FRONT-DECOR-BACK-PLATE-DL_DXF.dxf; 6 holes 9.53 +0.10/0 for the rivnuts 838003 (counted in the joints register) on X -1224, 3 per side panel (critical: on the wall's bolt line); blind-riveted to the frame (HOLD: rivet)
351105 | FRONT - DOOR HINGE-SIDE STOP - DL - PIECE 1 | Mặt trước - nẹp chặn cửa phía bản lề - khối trái - đoạn 1 | made (aluminium angle 30 x 20 x 2, cut to length; its flange bonded to DL's door-side face) | made (aluminium angle 30 x 20 x 2, cut to length; its flange bonded to DL's door-side face) | aluminium EN AW-6063-T6 | black anodised matte 20 um (AA20); general tolerance ISO 2768-m | 1 | 0.047 | calculation (CAD) | DRAFT | selection C3 (frame gap 2 to 6); number allocation (D-120, #232) | piece 1 of the hinge-side stop, between the hinges; bonded with structural tape (HOLD: product)
351106 | FRONT - DOOR HINGE-SIDE STOP - DL - PIECE 2 AND 3 | Mặt trước - nẹp chặn cửa phía bản lề - khối trái - đoạn 2 và 3 | made (aluminium angle 30 x 20 x 2, cut to length; its flange bonded to DL's door-side face) | made (aluminium angle 30 x 20 x 2, cut to length; its flange bonded to DL's door-side face) | aluminium EN AW-6063-T6 | black anodised matte 20 um (AA20); general tolerance ISO 2768-m | 2 | 0.159 | calculation (CAD) | DRAFT | selection C3 (frame gap 2 to 6); number allocation (D-120, #232) | pieces 2 and 3 of the hinge-side stop, between the hinges; bonded with structural tape (HOLD: product)
351107 | FRONT - DOOR HINGE-SIDE STOP - DL - PIECE 4 | Mặt trước - nẹp chặn cửa phía bản lề - khối trái - đoạn 4 | made (aluminium angle 30 x 20 x 2, cut to length; its flange bonded to DL's door-side face) | made (aluminium angle 30 x 20 x 2, cut to length; its flange bonded to DL's door-side face) | aluminium EN AW-6063-T6 | black anodised matte 20 um (AA20); general tolerance ISO 2768-m | 1 | 0.043 | calculation (CAD) | DRAFT | selection C3 (frame gap 2 to 6); number allocation (D-120, #232) | piece 4 of the hinge-side stop, between the hinges; bonded with structural tape (HOLD: product)
368005 | FRONT - FRAME-STOP SEAL | Gioăng chặn khung cửa | bought by length |  | athmer PS 1515 P Flex, PVC co-extrusion, self-adhesive |  | 1 | 0.07 | assumption | source (product) | hardware selection C3; joints register | hinge-side run 1580 mm in 4 pieces between the hinges, each its own component (the two middle pieces one length); DT's run in DT's list | athmer | PS 1515 P Flex
