autonomous-ai/spaceship/v2/03-Manufacturing/front/350003_P01_FRONT-DECOR-BLOCK-ASSY-DR_BOM.csv

part_number | name | name_vi | type | process | material | finish | qty | unit_mass_kg | mass_status | status | source | note | maker | sku
350003 | FRONT - DECOR BLOCK ASSY - DR | Khối trang trí phải (cụm) | assembly |  | - |  | 1 | 21.1 | calculation (sum of the rows below) | DRAFT | D-49, D-59, D-60, D-79, D-87; PM rulings 2026-10-31 and 2026-11-01; this build | skin bonded to the welded tube frame 351306; plates and panels on the frame
351301 | FRONT - DECOR SKIN - DR | Tấm ốp alu khối phải | made: ACP panels, 45 deg mitred joints as v1, bonded to the frame | made: ACP panels, 45 deg mitred joints as v1, bonded to the frame | ACP 3 mm EV3038 Dark Yellow, PE core |  | 1 | 6.917 | calculation (CAD, 3.5 kg/m2: selection VT01) | DRAFT | D-12, D-49; skeleton DR shape | one flat panel per outside face: 351301_P01_FRONT-DECOR-SKIN-DR_DXF.dxf; bond to the frame per the joints register's ACP bond spec (D-137): one 12 x 3 joint on every tube, the tubes 3 mm off the skin
351306 | FRONT - DECOR FRAME - DR | Khung trang trí phải (hàn) | weldment assembly: welded frame, 24 tubes as 21 parts (parts list 351306_P01_FRONT-DECOR-FRAME-DR_BOM.csv; cut list 351306_P01_FRONT-DECOR-FRAME-DR-TUBE-CUT-LIST.csv), TIG-welded |  | aluminium EN AW-6063-T6 tube: 20 x 20 x 1.0 (skin only), 40, 60 and 80 x 20 x 1.2 (rivnuts), 20 x 20 x 1.5 (fan box shelf) | mill finish (hidden, D-79) | 1 | 4.922 | calculation (sum of its parts list 351306_P01_FRONT-DECOR-FRAME-DR_BOM.csv) | DRAFT | v1 decor frame drawing (front and back frames); D-79; joints register HOLD-10; D-120 (each tube its own part, #232) | 15.1 m of tube; welds per its weldment drawing; rivnuts 838003 fitted in the factory: 21 for the inner face panel's screws, each with an 838004 stop washer on its head (D-130), and 2 for DT's spigots 831010 (in the bottom, bolt-line, band, ledge, diagonal and glass-edge tubes)
351302 | FRONT - DECOR BACK PLATE - DR | Tấm hậu khối phải | made (laser-cut sheet, no drawing: D-89 part 4) | made (laser-cut sheet, no drawing: D-89 part 4) | aluminium EN AW-5754-H22 sheet 1.5 mm | mill finish (hidden, D-79); general tolerance ISO 2768-m | 1 | 1.14 | calculation (CAD, 2700 kg/m3) | DRAFT | joints register J-FRONT-01 (1.0 to 2.7 at each bolt, HOLD-10); 1.5 mm by PM ruling 2026-11-01 (DR under 20 kg) | DXF 351302_P01_FRONT-DECOR-BACK-PLATE-DR_DXF.dxf; fixed: the strip on X +1224 with 6 holes 10.00 +0.10/0 for the rivnuts 838003 (critical: on the wall's bolt line), and the band behind the soffit; blind-riveted to the frame (HOLD: rivet)
351305 | FRONT - DECOR INNER FACE PANEL - DR - REMOVABLE | Tấm mặt trong tháo được khối phải | made (laser-cut sheet; its drawing gives the flatness, about 0.5 mm, D-130), removable | made (laser-cut sheet; its drawing gives the flatness, about 0.5 mm, D-130), removable | aluminium EN AW-5754-H22 sheet 3.0 mm | mill finish (hidden, D-79); general tolerance ISO 2768-m | 1 | 7.364 | calculation (CAD, 2700 kg/m3) | DRAFT | D-60 air table; D-87; D-130 (one panel, its stops and seal; the opening 200 x 215 to the column's edge); PM rulings 2026-11-01 (the column's hook studs, the panel carries the 10 kg column) | one removable inner face panel (D-130) over the opening the air unit goes in by: DXF 351305_P01_FRONT-DECOR-INNER-FACE-PANEL-DR-REMOVABLE_DXF.dxf; on stops 2.36 off the frame (an 838004 washer on each rivnut head), sealed all round by 848013, held by 21 M6 x 16 socket heads 838001 (ISO 4762, the one 5 mm key on site), each on a plain washer 838011 (ISO 7089 6.4 x 12, 200 HV zinc), about 400 apart into rivnuts 838003 in the frame's tube walls (Joints' counts); the heads stand 7.6 proud of its room face and AIR clears the ones it covers (its supply cartridge lifted 6, reliefs at the soffit); the glass-edge tube's lowest screw stands 10 left of the air column's edge; 2 holes 10.00 +0.10/0 at X 971, Z 1700 and 1850 for rivnuts 838003 with the column's 2 hook studs (J-AIR-02); its room-side face is AIR's named value dr_acc_face_y; ships loose with its screws and felt and goes on after the air unit; for service the column comes off, then the panel drops 40 and comes out under the soffit (PM rulings 2026-11-01)
351304 | FRONT - DECOR INNER PANEL FELT - DR | Nỉ tấm trong khối phải | made (laser-cut PET felt sheet, no drawing: D-128, its DXF matches its STEP), glued to 351305 at the factory | made (laser-cut PET felt sheet, no drawing: D-128, its DXF matches its STEP), glued to 351305 at the factory | PET felt 9 mm | Dark Gray (D-79); outline +/-2, general tolerance ISO 2768-m | 1 | 0.737 | calculation (CAD, 1.8 kg/m2) | DRAFT; emission certificate HOLD | D-31; hardware selection A3 | DXF 351304_P01_FRONT-DECOR-INNER-PANEL-FELT-DR_DXF.dxf; 10 closed holes 14 over the panel's screw heads under it, at least 3 of felt to its edge, each plugged with felt cut from the same sheet (PM rulings 2026-11-01: no bare socket heads on the room side)
848013 | SEALS - ACCESS PANEL SEAL - 4.0 THICK - VERY SOFT FOAM PSA | Gioăng tấm thăm - xốp rất mềm dày 4.0, keo dán sẵn | bought by length |  | very soft foam strip with PSA, 4.0 thick, about 8 wide (product HOLD-19) |  | 1 | 0.02 | assumption (soft foam, about 4 g/m) | HOLD: product (HOLD-19) | joints register H-34; D-130 | one loop on the frame's tubes round the inner face panel, 5.38 m along its screw line, squeezed from 4.0 to 2.36 on the panel's stops; cut round each of the 21 stop washers when fitted (Joints)
350004 | FRONT - AIR SUPPLY ASSY - DR | Cụm cấp gió khối phải | reserved air space |  | - |  | 1 |  | not counted: AIR's supply fan box assembly 610401 (AIR #91) | HOLD: reserved air space; AIR designs and lists the part (PM ruling 2026-11-01) | D-87; PM ruling 2026-11-01 | the space AIR's supply fan box assembly takes (riser, transitions, fan box and its two fans), its own pallet piece; it slides into DR through its inner face and stands on the frame's shelf tube F08; its fan box stands 25 back from the front skin, behind the cross tube F09 (PM ruling 2026-11-01, D-131), so its base reaches forward onto F08 (AIR's detail)
351402 | FRONT - AIR INTAKE RISER - DR | Ống gió đứng khối phải | reserved air space |  | - |  | 1 |  | not counted: AIR's intake riser 611501 (AIR #91) | HOLD: reserved air space; AIR designs and lists the part (PM ruling 2026-11-01) | D-60 air table; PM ruling 2026-11-01 | the space AIR's intake riser takes; its open foot stands 140 mm over the base opening
351403 | FRONT - AIR TRANSITION - LOWER - DR | Ống chuyển hướng dưới | reserved air space |  | - |  | 1 |  | not counted: AIR's riser transition 618103 (AIR #91) | HOLD: reserved air space; AIR designs and lists the part (PM ruling 2026-11-01) | D-60 air table; PM ruling 2026-11-01 | the space AIR's riser transition takes, riser top to fan box inlet
351404 | FRONT - SUPPLY FAN BOX - DR | Hộp quạt cấp | reserved air space |  | - |  | 1 |  | not counted: AIR's supply fan box 610401 (AIR #91) | HOLD: reserved air space; AIR designs and lists the part (PM ruling 2026-11-01) | D-60 air table; PM ruling 2026-11-01 | the space AIR's supply fan box takes, X 680 to 980 (PM ruling 2026-11-01: 6.3 to the back ring's diagonal, 17.3 to the fixed glass channel); its front 5 behind the cross tube F09 (Y -819 with the 3 mm bond line; PM rulings 2026-11-01, D-131)
351405 | FRONT - AIR TRANSITION - UPPER - DR | Ống chuyển hướng trên | reserved air space |  | - |  | 1 |  | not counted: AIR's supply transition 618102 (AIR #91) | HOLD: reserved air space; AIR designs and lists the part (PM ruling 2026-11-01) | D-60 air table; PM ruling 2026-11-01 | the space AIR's supply transition takes, fan box outlet to the access panel's opening
