autonomous-ai/spaceship/v2/03-Manufacturing/interior/810000_P01_INTERIOR-PARTS-LIST_BOM.csv

part_number | name | name_vi | kind | parent | qty_per_parent | qty_per_pod | material | finish | process | maker | sku | torque | size_mm | tolerance | mass_each_kg | mass_status | revision | status | source
810000 | INTERIOR | Nội thất | HS |  | 1 | 1 |  |  |  |  |  |  |  |  | 3.254 | calculation (sum of its parts) | P01 | DRAFT | D-70; assembly tree
810101 | INTERIOR - WORK WALL LEDGE ASSY | Bàn tựa vách làm việc (cụm) | HS | 810000 | 1 | 1 |  |  |  |  |  |  |  |  | 1.395 | calculation (sum of its parts) | P01 | DRAFT | D-70, D-85
811101 | INTERIOR - LEDGE - TOP | Mặt bàn tựa nhôm gấp 1.5 | MP | 810101 | 1 | 1 | Aluminium 5052-H32 sheet (alloy HOLD) | powder coat, charcoal to match the felt (RAL HOLD) | laser cut, brake bend (2 bends) |  |  |  | 1000.0 long, section 250.0 x 25.0, 1.5 sheet | cut +/-0.5, bent +/-0.5 (assumption) | 1.195 | calculation (Fusion, CAD geometry x density) | P01 | DRAFT | D-70: 1000 mm ledge; D-85: 1.5 mm folded aluminium
818101 | INTERIOR - LEDGE BRACKET - HOLD | Ke đỡ bàn tựa (chờ) | HOLD | 810101 | 2 | 2 | HOLD envelope - no mass |  |  | HOLD | HOLD: rated for a 225 N lean at the ledge's front edge x 3 |  |  |  | 0.100 | assumption: an aluminium concealed shelf bracket with its stand-offs, about 0.1 kg (D-85 budget: the ledge with 2 brackets 1.4 kg) | P01 | HOLD | on WALL's R1 stiles at Y 98.63 and 464.32, on stand-offs through R1-CASS (WALL interface)
810201 | INTERIOR - LIGHT SHELF ASSY | Kệ đèn hắt (cụm) | HS | 810000 | 1 | 1 |  |  |  |  |  |  |  |  | 1.359 | calculation (sum of its parts) | P01 | DRAFT | D-70, D-85 (0.4 kg/m with the strips)
811201 | INTERIOR - LIGHT SHELF - BACK | Kệ đèn - vách sau | MP | 810201 | 1 | 1 | Aluminium 5052-H32 sheet (alloy HOLD) | powder coat, charcoal (RAL HOLD) | laser cut, brake bend (2 bends), cable hole |  |  |  | 2332.0 long, section 60.0 x 40.0, 1.0 sheet | cut +/-0.5, bent +/-0.5 (assumption) | 0.735 | calculation (Fusion, CAD geometry x density) | P01 | DRAFT | D-70; feed hole at X 355 (ELECTRICAL)
811202 | INTERIOR - LIGHT SHELF - SIDE LH | Kệ đèn - vách trái | MP | 810201 | 1 | 1 | Aluminium 5052-H32 sheet (alloy HOLD) | powder coat, charcoal (RAL HOLD) | laser cut, brake bend (2 bends) |  |  |  | 991.0 long, section 60.0 x 40.0, 1.0 sheet | cut +/-0.5, bent +/-0.5 (assumption) | 0.312 | calculation (Fusion, CAD geometry x density) | P01 | DRAFT | D-70
811203 | INTERIOR - LIGHT SHELF - SIDE RH | Kệ đèn - vách phải | MP | 810201 | 1 | 1 | Aluminium 5052-H32 sheet (alloy HOLD) | powder coat, charcoal (RAL HOLD) | laser cut, brake bend (2 bends), cable hole |  |  |  | 991.0 long, section 60.0 x 40.0, 1.0 sheet | cut +/-0.5, bent +/-0.5 (assumption) | 0.312 | calculation (Fusion, CAD geometry x density) | P01 | DRAFT | D-70; call-light drop hole at Y -209.5 (ELECTRICAL)
818102 | INTERIOR - SCREEN RAIL - HOLD | Thanh treo màn hình (chờ) | HOLD | 810000 | 1 | 1 | HOLD envelope - no mass |  |  | HOLD | HOLD: VESA rail for a screen up to 900 wide, about 10 kg |  |  |  | 0.500 | assumption: a 900 aluminium VESA rail, about 0.5 kg | P01 | HOLD | D-70: a screen up to about 900 wide; on stand-offs to R2's stiles (WALL interface)
