autonomous-ai/spaceship/v2/03-Manufacturing/wall/210101_P01_WALL-PANEL-ASSY-SIDE-LOWER-LH_BOM.csv

level | part_number | name | name_vi | kind | material | finish | process | maker | sku | torque | qty | unit | cut_length_mm | size_mm | tolerance | mass_each_kg | mass_total_kg | mass_status | status | source | note
0 | 210101 | WALL - PANEL ASSY - SIDE LOWER - LH | Vách trái - cụm tấm dưới | HS | see the parts below |  |  |  |  |  | 1 | pc |  | 48.26 x 1492.74 x 1150.74 |  |  | 11.29 | calculation: the sum of the rows below (CAD bodies and hardware) | DRAFT | CAD 210101_P01_WALL-PANEL-ASSY-SIDE-LOWER-LH_CAD v9 | outer panel, bonded and hardware-fitted at the factory; the lining cassette is a separate part (D-17)
1 | 211101 | WALL - PANEL FRAME - SIDE LOWER - LH | Vách trái - khung dưới | MP | aluminium tube 6063-T6: perimeter 20 x 40 and 40 x 40 x 1.2, studs 20 x 40 x 1 (D-85) | mill finish with the bond prep (D-79) | saw cut square, CNC or jig drill (holes Ø0.4 from the spigot hole, R-J6), rivnuts and stop washers set at the factory, member joints: internal cleats per D-115 (crimped, structural adhesive; no welds) |  |  |  | 1 | pc |  | 40 x 1489.74 x 1142.74 | per its drawing | 3.105 | 3.105 | calculation: CAD at 2700 kg/m3 | DRAFT | CAD; tube confirmed (D-34, D-54, D-85; 40 x 40 R-J3) | member joints: internal cleats per D-115 (the Joints Engineer's register parts, placed when they land); rails full length
2 |  | RAIL - BOTTOM (cut length) | thanh nhôm | cut | aluminium tube 6063-T6 20 x 40 x 1.2 |  |  |  |  |  | 1 | pc | 1489.74 | 20 x 40 x 1.2 | length ±0.5, square ends (assumption, guideline 6.3) | 0.551 | 0.551 | calculation: CAD | DRAFT | CAD body length | square-cut ends; cut list of 211101
2 |  | RAIL - TOP (cut length) | thanh nhôm | cut | aluminium tube 6063-T6 20 x 40 x 1.2 |  |  |  |  |  | 1 | pc | 1489.74 | 20 x 40 x 1.2 | length ±0.5, square ends (assumption, guideline 6.3) | 0.555 | 0.555 | calculation: CAD | DRAFT | CAD body length | square-cut ends; cut list of 211101
2 |  | STILE - BACK (cut length) | thanh nhôm | cut | aluminium tube 6063-T6 40 x 40 x 1.2 |  |  |  |  |  | 1 | pc | 1102.74 | 40 x 40 x 1.2 | length ±0.5, square ends (assumption, guideline 6.3) | 0.554 | 0.554 | calculation: CAD | DRAFT | CAD body length | square-cut ends; cut list of 211101
2 |  | STILE - FRONT (cut length) | thanh nhôm | cut | aluminium tube 6063-T6 20 x 40 x 1.2 |  |  |  |  |  | 1 | pc | 1102.74 | 20 x 40 x 1.2 | length ±0.5, square ends (assumption, guideline 6.3) | 0.408 | 0.408 | calculation: CAD | DRAFT | CAD body length | square-cut ends; cut list of 211101
2 |  | STILE - MID (cut length) | thanh nhôm | cut | aluminium tube 6063-T6 20 x 40 x 1 |  |  |  |  |  | 3 | pc | 1102.74 | 20 x 40 x 1 | length ±0.5, square ends (assumption, guideline 6.3) | 0.345 | 1.036 | calculation: CAD | DRAFT | CAD body length | square-cut ends; cut list of 211101
1 | 211301 | WALL - SKIN - SIDE LOWER - LH | Vách trái - tấm ốp alu dưới | MP | ACP 3 mm Alcorest outdoor, PE-type core (HW-SEL A1) | PVDF coated EV3038 Dark Yellow (maker's coil coating; D-12) | CNC router: cut, V-groove and fold the back return (H16) |  |  |  | 1 | pc |  | 46 x 1492.74 x 1142.74 | per the tabulated skin drawing (D-89) | 6.142 | 6.142 | calculation: CAD at 3.5 kg/m2 (HW-SEL A1); real kg/m2 HOLD (H16) | DRAFT | CAD | blank and fold line in the skin DXF
1 | 211501 | WALL - CAVITY FILL - SIDE LOWER - LH | Vách trái - bông PET dưới | MP | PET fill 40 mm, 24 kg/m3, Pyrotek Sorberpoly 2D (HW-SEL B) |  | knife cut to the bays, 60 x 60 x 40 pockets left out beside each bolt this panel drives; sizes and pockets on the tabulated fill drawing (D-89) |  |  |  | 1 | set |  | 1 pieces 1102.7 x 334.9 x 40; 3 pieces 1102.7 x 344.9 x 40 | ±2 on length and width, thickness as supplied (assumption: knife-cut PET batt) | 1.426 | 1.426 | calculation: CAD at the design's fill density | DRAFT | CAD; 24 kg/m3 PM ruling 2026-10-31 (T02 confirms, else 32) | friction fit in the bays
1 | 108002 | POD - ACP BOND SET - SIKATACK PANEL-50 WITH AKTIVATOR-205, PANEL PRIMER, FIXING TAPE | Bộ keo dán ACP | PI | SikaTack Panel-50 (ETA 19/0511), Sika Aktivator-205, Sika Panel Primer, SikaTack Panel Fixing Tape |  |  | Sika | SikaTack Panel-50 system (bond spec V2-ENG-BND) |  | 1 | set |  |  |  | 0.49 | 0.49 | calculation: bond spec: about 8.7 m of 12 x 3 bead per side panel | DRAFT | joints register V2-ENG-JNT-01 table 2.1 (main, PR #47); bond spec V2-ENG-BND (PR #23) | one 12 x 3 joint on every member touching the skin; in-line tape HOLD-B2
1 | 838003 | HARDWARE - RIVET NUT - M6 - SHEREX CAH3-610-4.2 | Tán rút M6 | PI | aluminium 5056 | none (plain aluminium, as supplied) |  | Sherex (PEM) | CAH3-610-4.2 | HOLD-01 (D-48): set by the PM from test T06 (half the lowest rivnut spin-out torque) | 9 | pc |  |  |  | 0.0023 | 0.0207 | calculation: body Ø9.5 x 14.86 with an M6 bore and a Ø12.96 x 0.76 head (SHX sizes), 2640 kg/m3; the CAD body is the installed envelope | DRAFT | joints register V2-ENG-JNT-01 table 2.1 (main, PR #47) | 7 stopped joints; 2 spigot rivnuts; CAD bodies at every rivnut hole
1 | 831002 | HARDWARE - STOP WASHER - Ø10.5 X Ø20 X 1.5 - AL | Long đen chặn nhôm | MP | aluminium sheet 1.5, 5000 or 6000 series | mill finish (punched) |  | made (register H-08) |  |  | 7 | pc |  |  |  | 0.0009 | 0.0063 | calculation: CAD body: Ø10.5 x Ø20 x 1.5 (H-08), 2700 kg/m3 | DRAFT | joints register V2-ENG-JNT-01 table 2.1 (main, PR #47) | one under each stopped-joint rivnut's head; sets the 2.26 gap
1 | 831001 | HARDWARE - LOCATING SPIGOT - M6 X Ø8 - STAINLESS | Chốt định vị Ø8 | MP | stainless steel A2 (EN 1.4301) bar | bare stainless, as machined; threadlocker on the thread when fitted (H-05) |  | made (register H-05) |  |  | 2 | pc |  |  |  | 0.0051 | 0.0102 | calculation: CAD body: Ø8 pin to 8 proud of the face, M6 x 10 thread, 7900 kg/m3 (H-05 sizes PROPOSED) | DRAFT | joints register V2-ENG-JNT-01 table 2.1 (main, PR #47) | in the top rail's spigot rivnuts, locating the panel above
1 | 838001 | HARDWARE - SOCKET HEAD BOLT - M6 X 16 - ISO 4762 8.8 ZINC | Bulong lục giác chìm M6 × 16 | PI | steel, property class 8.8 (ISO 898-1) | zinc plated |  | HOLD: any maker to ISO 4762, picked at the RFQ | ISO 4762 M6 x 16 - 8.8 - zinc plated | HOLD-01 (D-48): set by the PM from test T06 (half the lowest rivnut spin-out torque) | 7 | pc |  |  |  | 0.0062 | 0.0434 | calculation: head Ø10 x 6 less the socket, shank Ø6 x 16 at 85% for the thread, 7850 kg/m3 | HOLD | joints register V2-ENG-JNT-01 table 2.1 (main, PR #47) | captive, driven from this panel: J-BASE-01 or J-WALL-01 (bottom rail), J-FRONT-01 (front stile)
1 | 838004 | HARDWARE - WASHER - M6 LARGE - ISO 7093-1 6.4 X 18 A2 | Long đen to M6 inox | PI | stainless steel A2 | none (plain stainless) |  | HOLD: any maker to ISO 7093-1, picked at the RFQ | ISO 7093-1 - 6.4 x 18 x 1.6 - A2 |  | 7 | pc |  |  |  | 0.0028 | 0.0196 | calculation: 6.4 x 18 x 1.6 (ISO 7093-1), 7900 kg/m3 | HOLD | joints register V2-ENG-JNT-01 table 2.1 (main, PR #47) | one under each bolt head (R-J10)
1 | 838005 | HARDWARE - CAPTIVE RETAINER - M6 HEAD - GROMMET FOR 19 HOLE | Vòng giữ đầu bulong | HOLD | elastomer (HOLD-02) | as supplied (elastomer) |  | HOLD-02 | HOLD-02 |  | 7 | pc |  |  |  | 0.001 | 0.007 | assumption: a small grommet; part not chosen (HOLD-02) | HOLD | joints register V2-ENG-JNT-01 table 2.1 (main, PR #47) | grommet in each Ø19 access hole, holding its bolt (HOLD-02); the pins need none
1 | 848001 | SEALS - JOINT GASKET - 8 X 3.97 - PORON 4701-40 PSA | Gioăng mối nối 3.97 | PI | PORON 4701-40 Soft polyurethane foam with PSA | none (foam, PSA liner one side) |  | Rogers (PORON), PSA laminated and slit by a converter (HOLD-05) | PORON 4701-40 Soft, 3.97 x 8 strip with PSA |  | 2.63 | m |  |  |  | 0.0076 | 0.02 | calculation: per metre: 8 x 3.97 at 240 kg/m3 (assumption for the foam's density) | DRAFT | joints register V2-ENG-JNT-01 table 2.1 (main, PR #47) | on this panel's nut-side faces: the top member (1489.74) and the back stile's room face (1142.74)
0 | 510101 | LINING - CASSETTE - SIDE LOWER - LH | Cassette lót vách trái dưới (khay thép + tấm tiêu âm) | BS | see the parts below |  |  |  |  |  | 1 | pc |  | 34 x 1445 x 1142.74 |  |  | 10.337 | calculation: CAD bodies of the made parts | DRAFT | CAD 510101_P01_LINING-CASSETTE-SIDE-LOWER-LH_CAD v6 | floating inner leaf; clips onto the panel frame from inside (D-17, D-47)
1 | 511101 | LINING - TRAY - SIDE LOWER - LH | Khay thép lót vách trái dưới | MP | galvanised steel sheet 0.5, EN 10346 DX51D+Z | hot-dip zinc (coating mass to confirm) | laser or punch blank, brake bend (sheet metal) |  |  |  | 1 | pc |  | 34 x 1445 x 1142.74 | per the tabulated tray drawing (D-89) | 7.3789 | 7.3789 | calculation: CAD at 7850 kg/m3 | DRAFT | CAD; 0.5 confirmed (D-37); lips PM ruling 2026-10-31 | 34 mm returns turned in as 12 mm lips that hold the felt; flat blank in the DXF
1 | 511301 | LINING - FELT - SIDE LOWER - LH | Tấm tiêu âm vách trái dưới | MP | PET felt 9 mm Dark Gray, the factory's felt (D-31; plan VT03-PET) |  | knife or die cut, a plain rectangle; no drawing (D-89) |  |  |  | 1 | pc |  | 9 x 1442 x 1139.74 | ±1 on length and width (assumption: die or knife cut) | 2.9583 | 2.9583 | calculation: CAD at 1.8 kg/m2 (Polyx Board 9 data, HW-SEL A3); the factory felt unverified | DRAFT | CAD | held by the tray's lips over the 24 mm air gap (settles H09)
1 | 518001 | LINING - CASSETTE CLIP | Kẹp treo cassette | HOLD | HOLD (H03, HOLD-08) |  |  | HOLD-08 | HOLD-08: rated 8.3 kg shear, 8.0 kg pull-out, captive lock |  | 4 | pc |  |  |  | 0.04 | 0.16 | assumption: about 40 g each (D-81's working figure, H-10) | HOLD | joints register V2-ENG-JNT-01 table 2.1 (main, PR #47) | zones reserved on the panel frame's first and last studs; 8.3 kg rated in shear each (register J-LIN-01)
1 | 848011 | SEALS - HOOK AND LOOP - 25 MM - LOCATING ONLY | Băng gai dính định vị cassette | PI | hook-and-loop or reclosable fastener tape, 25 mm, PSA |  |  | VELCRO Brand, or 3M (one to pick at the RFQ) | VELCRO PS14 hook 25 mm, or 3M Dual Lock SJ3560 25 mm (hardware selection V2-ENG-SEL) |  | 0.2 | m |  |  |  | 0.03 | 0.006 | assumption: per metre: about 30 g for a 25 mm tape | DRAFT | joints register V2-ENG-JNT-01 table 2.1 (main, PR #47) | 4 pads of 50 mm to line the cassette up (assumption); carries no load (D-47)
1 | 848012 | SEALS - CASSETTE EDGE SEAL - 10 X 2.0 TO 2.2 - VERY SOFT FOAM OR FIN | Gioăng mép cassette (rất mềm) | HOLD | very soft PSA foam strip 10 x 2.0-2.2, or a fin (R-J18) |  |  | HOLD-13 | HOLD-13: no more than about 2 kPa at 20% compression |  | 1.45 | m |  |  |  | 0.002 | 0.0029 | assumption: per metre: 10 x 2.1 at about 100 kg/m3 (assumption) | HOLD | joints register V2-ENG-JNT-01 table 2.1 (main, PR #47) | only touches across the 2.26 gap, no load (R-J18): the top edge against the upper cassette (1445)
