autonomous-ai/spaceship/v2/03-Manufacturing/front/360002_P01_FRONT-FIXED-GLASS-UNIT_BOM.csv

part_number | name | name_vi | type | process | material | finish | qty | unit_mass_kg | mass_status | status | source | note | maker | sku
360002 | FRONT - FIXED GLASS UNIT | Cụm vách kính cố định | assembly |  | - |  | 1 | 29.54 | calculation (sum of the rows below) | DRAFT | D-27, D-46; this build | bottom channel factory-fitted on BASE's sill; on site: pane, DR, DT (PM ruling 2026-11-01)
361003 | FRONT - FIXED GLASS - 4+4 LAMINATED | Tấm kính cố định 4+4 | made to drawing (glass supplier) | made to drawing (glass supplier) | 4+4 laminated glass of toughened, heat-soaked panes, 8.76, grey |  | 1 | 28.59 | calculation (CAD, 2376 kg/m3) | DRAFT; product HOLD (ISS-074) | D-27, D-46; skeleton outline (v1 STEP body 222) | visible outline = skeleton; +fg_bite on the 4 held edges; no holes
368004 | FRONT - GLAZING U-PROFILE - BOHLE BO5201571 | Thanh U nhôm kẹp kính | bought by length, 4 pieces mitred |  | Bohle BO5201571 aluminium U-profile 15 x 15 x 1.5 | as supplied by Bohle (hidden in the channels) | 1 | 0.557 | calculation (CAD, 2700 kg/m3) | source (product) | hardware selection C5 | outer lengths 745 / 1446 / 804 / 303 mm (bottom, right, diagonal, top); the bottom piece has 4 holes 3.4 at X 269.4, 484.3, 699.2, 905.0, countersunk 90 deg to 7 inside, for the screws 838007 (ISO 10642 M3 x 8 A2) into BASE's sill rivnuts 838008 (J-FRONT-04; the last at X 905, clear of FR1: PM ruling 2026-11-01) | Bohle | BO5201571
368002 | FRONT - GLAZING U-SEAL - BOHLE BO5201735 | Gioăng chữ U silicone | bought by length, 4 pieces |  | Bohle BO5201735 silicone U-profile seal |  | 1 | 0.241 | calculation (CAD, 1200 kg/m3 assumption) | source (product); fit on 8.76 laminate unverified | hardware selection C5 | about 3293 mm in all | Bohle | BO5201735
368003 | FRONT - 180 MAGNETIC SEAL - HALF 1 OF 2 - HOLD | Gioăng từ 180° (nửa 1) | bought, HOLD |  | magnetic 180 deg glass-to-glass seal, fixed pane half; product not named |  | 1 | 0.15 | assumption | HOLD: product for the 8.76 laminate and a 4 mm gap | PM ruling 2026-10-31 | length about 2030 mm on the pane's free edge; pairs with 368006 on the door
