autonomous-ai/spaceship/v2/03-Manufacturing/front/360001_P01_FRONT-DOOR-UNIT_BOM.csv

part_number | name | name_vi | type | process | material | finish | qty | unit_mass_kg | mass_status | status | source | note | maker | sku
360001 | FRONT - DOOR UNIT | Cụm cửa kính | assembly, fitted at the factory (D-56) |  | - |  | 1 | 48.59 | calculation (sum of the rows below) | DRAFT | D-46, D-56; this build | hangs as one unit on the HOLD hinges
361001 | FRONT - DOOR LEAF - 4+4 LAMINATED | Tấm kính cửa 4+4 | made to drawing (glass supplier) | made to drawing (glass supplier) | 4+4 laminated glass of toughened, heat-soaked panes, 8.76, grey |  | 1 | 43.854 | calculation (CAD, 2376 kg/m3) | DRAFT; product HOLD (ISS-074) | D-27, D-46; skeleton outline (v1 STEP) | no holes or cut-outs until the hinges, lock and pull are named
361002 | FRONT - DOOR KICK STRIP | Thanh chân cửa nhôm | made (extruded hollow profile, custom die; D-85) | made (extruded hollow profile, custom die; D-85) | aluminium EN AW-6063-T6 | black anodised matte 20 um (AA20, the base band's finish, D-67) | 1 | 1.218 | calculation (CAD, 2700 kg/m3) | DRAFT | D-40, D-57; PM rulings on the FRONT plan | cut length = kick_len; glass retention in the pocket HOLD (J-FRONT-02)
368001 | FRONT - DROP SEAL - ATHMER SCHALL-EX GSA 1-1112 | Ron chân cửa tự động | bought, cut to length |  | athmer Schall-Ex GSA 1-1112, black RAL 9005 |  | 1 | 0.6 | assumption (D-56) | source (product); bond to aluminium HOLD | hardware selection C4 | cut from 1208 to kick_len | athmer | Schall-Ex GSA 1-1112
368002 | FRONT - GLAZING U-SEAL - BOHLE BO5201735 | Gioăng chữ U silicone | bought by length |  | Bohle BO5201735 silicone U-profile seal |  | 1 | 0.148 | calculation (CAD, 1200 kg/m3 assumption) | source (product); fit on 8.76 laminate unverified | hardware selection C5 | length = kick_len | Bohle | BO5201735
368101 | FRONT - DOOR HINGE - HOLD | Bản lề cửa kính | bought, HOLD |  | not named: rated for the 8.76 laminate, at least 60 kg and the 1176 mm width; holds the door at its closed position; two-part lift-off, the frame halves ship fitted in DL; hung on site with the 5 mm key (PM rulings) |  | 3 | 0.6 | assumption (D-56) | HOLD (D-46, ISS-002) | hardware selection C1 | reserved space only
368102 | FRONT - DOOR STRIKE | Đế hít cửa | bought |  | stainless steel SUS430 strike with CR packing | as supplied | 1 | 0.023 | source (Sugatsune datasheet, 22.9 g) | source (product); on the 8.76 laminate with a 1.2 mm shim: HOLD | hardware selection C7; PM rulings 2026-10-31 | its catch 368007 sits in DT's underside; no latch on the glass | Sugatsune | HT-MSG62-U10
368006 | FRONT - 180 MAGNETIC SEAL - HALF 2 OF 2 - HOLD | Gioăng từ 180° (nửa 2) | bought, HOLD |  | magnetic 180 deg glass-to-glass seal, door half; product not named |  | 1 | 0.15 | assumption | HOLD: product for the 8.76 laminate and a 4 mm gap | PM ruling 2026-10-31 | pairs with 368003 on the fixed pane
368103 | FRONT - DOOR PULL PAIR - HOLD | Tay nắm cửa (cặp) | bought, HOLD |  | not named |  | 1 | 0.8 | assumption (D-56) | HOLD | hardware selection C2 | reserved space only
