autonomous-ai/spaceship/v2/05-Engineering/layout-study/out/parts-decided-P04.csv

group | item | qty | kg_each | kg_total | status | source | basis
WALL | L1 and R1, lower side outer panels | 2 | 11.163 | 22.33 | calculation (CAD); fill provisional | S34, CAD on main: WALL parts lists 210101 and 210102 P01: frames 3.105 and 3.105 (mid stiles at 1 mm), skins 6.142, fill 1.426 at 24 kg/m3, bond sets 0.49; their hardware stays in the fixings kit's line | CAD, main
WALL | L2 and R2, upper side outer panels | 2 | 11.294 | 22.59 | calculation (CAD); fill provisional | S34, CAD on main: WALL parts lists 210103 and 210104 P01: frames 3.262 and 3.262 (mid stiles at 1 mm), skins 6.142, fill 1.400 at 24 kg/m3, bond sets 0.49; their hardware stays in the fixings kit's line | CAD, main
WALL | B1 to B4, back outer panels | 4 | 8.641 | 34.56 | calculation (part CAD); fill provisional | part CAD on main: B1 and B2 from WALL parts lists 210201 and 210202 P01 (S50): frames 2.366 and 2.363 (mid stiles at 1 mm), skins 4.701 and 4.697, fill 1.135 and 1.032 at 24 kg/m3, bond sets 0.38: 8.58 and 8.47 kg; their hardware stays in the fixings kit's line. B3 and B4 stay this study's model at the P04 size (S33), 8.76 kg each: frame 1198.99 under the 1200.61 skin, fill 24 kg/m3; 2 inner studs at 393 mm centres, inside D-16 (D-85); inner studs at 1.0 mm (D-85) | CAD, main (part)
WALL | 40 x 40 corner edge tubes beyond the panels' own | 1 | 0.009 | 0.01 | calculation | D-63's 1.3 kg less the 40 x 40 members the panels' CAD carries: the four side panels' back stiles, L2 and R2's tops and the ceiling halves' back members (S34, S35, S39) | estimate
WALL | Bond over this study's 0.25 kg/m2, beyond the panels in CAD | 1 | 0.053 | 0.05 | calculation | D-71's 0.5 kg (PR #23) less the share of the panels whose CAD carries their bond: the four side panels, B1 and B2, and the ceiling halves (S34, S35, S39, S50) | estimate
LINING | Wall cassette, side, lower, with 12 mm lips, no clip rails | 2 | 10.341 | 20.68 | calculation (CAD) | S34, CAD on main: WALL parts lists 510101 and 510102 P01: trays 7.379 with their lips, felts 2.958 and 2.949, hook-and-loop and seals; their clips are in the named clips' line | CAD, main
LINING | Wall cassette, side, upper, with 12 mm lips, no clip rails | 2 | 9.912 | 19.82 | calculation (CAD) | S34, CAD on main: WALL parts lists 510103 and 510104 P01: trays 7.078 with their lips, felts 2.829 and 2.828, hook-and-loop and seals; their clips are in the named clips' line | CAD, main
LINING | Wall cassette, back, lower, with 12 mm lips, no clip rails | 2 | 8.013 | 16.03 | calculation (CAD) | S50, CAD on main: WALL parts lists 510201 and 510202 P01: trays 5.906 and 5.582 with their lips, felts 2.333 and 2.187, hook-and-loop and seals; their clips are in the named clips' line | CAD, main
LINING | Wall cassette, back, upper, with 12 mm lips, no clip rails | 2 | 8.399 | 16.80 | calculation; lips confirmed | this study's model at the P04 size (S33) without its 0.6 kg/m2 clip-and-rail allowance (clip-only, D-81), + 0.43 kg of lips (D-69) | estimate
CEILING | Ceiling outer panels C1 and C2, with their bond line | 2 | 14.618 | 29.24 | calculation (CAD) | S35, CAD on main: CEILING parts list 410000 P01: frames 7.984 and 7.978 (welded galvanized steel, 1.0 and 0.8 walls, the 40 x 40 back member and the mitre plates, D-131), skins 6.282 and 5.986, bond sets 0.503; the hardware and seals stay in the fixings kit's line | CAD, main
LINING | Ceiling cassettes, one part for both halves | 2 | 9.445 | 18.89 | calculation (CAD); fill provisional | S35, CAD on main: CEILING parts list 510301 P01: tray 5.520, 2 ribs, felt 2.170, fill bays 1.027 at 24 kg/m3; its clips and catches are in the named clips' line | CAD, main
LINING | Named clips and catches: 44 clips and 4 catch lanyards | 1 | 2.160 | 2.16 | assumption | allowance: about 40 g a clip and 100 g a lanyard until H03 and H04 name them (clip-only, D-81) | estimate
BASE | Base band piece 100x40 - back, 1.5 mm wall | 1 | 2.722 | 2.72 | calculation (CAD); confirmed (1.5 mm) | S54, CAD on main: BASE parts list 110103 P02 batch 1: the tube 111103 2.7044, and 3 x rivet nut 838006 0.0180; its glides, load blocks and lip are in their own lines, its rivnuts, spigots, stop washers and hook studs in the fixings kit's line (the joints register counts them) | CAD, main
BASE | Base band piece 100x40 - side LH, 1.5 mm wall | 1 | 1.702 | 1.70 | calculation (CAD); confirmed (1.5 mm) | S54, CAD on main: BASE parts list 110101 P02 batch 1: the tube 111101 1.6726, and 1 x tube end cap 118003, 2 x flanged button head screw 838010, 2 x rivet nut 838006 0.0296; its glides, load blocks and lip are in their own lines, its corner key in the corner key line, its rivnuts, spigots, stop washers and hook studs in the fixings kit's line (the joints register counts them) | CAD, main
BASE | Base band piece 100x40 - side RH, 1.5 mm wall | 1 | 1.705 | 1.70 | calculation (CAD); confirmed (1.5 mm) | S54, CAD on main: BASE parts list 110102 P02 batch 1: the tube 111102 1.6749, and 1 x tube end cap 118003, 2 x flanged button head screw 838010, 2 x rivet nut 838006 0.0296; its glides, load blocks and lip are in their own lines, its corner key in the corner key line, its rivnuts, spigots, stop washers and hook studs in the fixings kit's line (the joints register counts them) | CAD, main
BASE | Base band piece FR1 under the fixed glass, 1.5 mm wall, with its sill | 1 | 1.903 | 1.90 | calculation (CAD); confirmed (1.5 mm) | S54, CAD on main: BASE parts list 110106 P02 batch 1: the tube 111106 0.7851, and 1 x sill 111301, 1 x tube end cap 118003, 2 x rivet nut 838006, 4 x countersunk screw 838007, 4 x rivet nut 838008 1.1177; its glides, load blocks and lip are in their own lines, its rivnuts, spigots, stop washers and hook studs in the fixings kit's line (the joints register counts them) | CAD, main
BASE | Base band piece 100x40 - front-l, 1.5 mm wall | 1 | 0.333 | 0.33 | calculation; confirmed (1.5 mm) | this study's model, 1.5 mm wall (D-81; BASE's check passed, D-86); P03 length; BASE's batch 2 models the front-left pieces | estimate
BASE | Base band piece 100x40 - front-r, the intake part, 1.5 mm wall | 1 | 0.392 | 0.39 | calculation; confirmed (1.5 mm) | this study's model: its P03 front-right band, 1050 mm, less FR1's 696.54 mm, which is BASE's CAD now (S54); 1.5 mm wall (D-81; BASE's check passed, D-86); BASE's batch 3 models the intake piece | estimate
BASE | Corner key | 6 | 0.207 | 1.24 | calculation (CAD) | S45, CAD on main: the joints' made hardware list, the corner key family 111211 to 111215, 30 mm thick (2 square at the back corners, 1 square inline, front LH and RH, knee LH; D-144); BASE's batch 1 lists 2 of them, the back-corner keys in the side bands (D-129, S54), so this line keeps all 6 and the band lines none | CAD, main
BASE | Levelling glide (hex from above) | 9.0 | 0.150 | 1.35 | assumption (CAD, HOLD) | S54, CAD on main: BASE parts list 118002 P02 batch 1, a levelling glide on HOLD at each of its 9 glides (2 on the left side band, 2 on the right side band, 3 on the back band, 2 on FR1); this study had 8; the front-left pieces and the intake piece add theirs, if any, in batches 2 and 3 | CAD, main
BASE | Glide load blocks: BASE's load block inside the band at each glide | 1 | 0.221 | 0.22 | calculation (CAD) | S54, CAD on main: BASE parts list 111601 P02 batch 1, 9 x 0.0245 kg (BASE - GLIDE DOUBLER - COMMON: aluminium plate EN AW-6082 T6, 5 mm thick (PM ruling 2026-11-01) 54 x 36 x 5), one inside the band at each glide (D-86's load block); one line, as the packing plan shares it out by glide | CAD, main
FRONT | Decor block - left | 1 | 12.320 | 12.32 | calculation (CAD) | S51, CAD on main: FRONT parts list 350001 P01: skin 4.002, welded frame 4.691 (26 tubes), plates, stops and seals 3.627; the door's 3 hinges are in the door unit's line, the 2 mm back plate takes J-FRONT-01's rivnuts | CAD, main
FRONT | Decor block - right | 1 | 12.999 | 13.00 | calculation (CAD) | S51, CAD on main: FRONT parts list 350003 P01: skin 6.917, welded frame 4.922 (24 tubes), plates, stops and seals 1.160; AIR's riser, transitions and supply fan box are reserved air spaces in it with no mass, counted in AIR's lines (PM ruling 2026-11-01); the fixed glass's right and diagonal channels, fitted in it, are in the fixed glass unit's line; its loose parts (351305, 351304, 8.101 kg) have their own line | CAD, main
FRONT | DR inner face panel 351305 with its felt 351304, ships loose, fitted on site after the air unit | 1 | 8.101 | 8.10 | calculation (CAD) | S51, CAD on main: FRONT parts list 350003 P01: panel 7.364, felt 0.737 (D-130; PM ruling 2026-11-01: its own packing piece); its 21 M6 x 16 screws and washers are in the fixings line | CAD, main
FRONT | Decor block - top | 1 | 7.830 | 7.83 | calculation (CAD) | S51, CAD on main: FRONT parts list 350002 P01: skin 2.518, welded frame 2.747 (13 tubes), plates, stops and seals 2.565; with the door's magnetic catch 368007 and the top stop | CAD, main
FRONT | Door unit 360001: 4+4 leaf, hollow kick strip, drop seal, hinges, strike, magnetic seal, pull | 1 | 48.590 | 48.59 | calculation (CAD); hinges and pull HOLD | S36, CAD on main: FRONT parts list 360001 P01: leaf 43.854, kick strip 1.218 (hollow, D-85), drop seal, U-seal, 3 hinges, the strike and the magnetic seal half (D-83), the pull pair | CAD, main
FRONT | Fixed glass unit 360002: 4+4 pane, U-profile, U-seal and magnetic seal half | 1 | 29.540 | 29.54 | calculation (CAD); magnetic seal HOLD | S37, CAD on main: FRONT parts list 360002 P01: pane 28.590, U-profile, U-seal and one half of the magnetic seal (D-83) | CAD, main
AIR | Supply cartridge, in the air column | 1 | 10.548 | 10.55 | calculation (CAD) | S52, CAD on main: AIR parts list 610301 P01: casing 611301 9.129 (2.0 mm, D-121), 3 layers 611302 at 32 kg/m3 in the CAD (D-116: 32) | CAD, main
AIR | Exhaust cartridge, in the soffit | 1 | 10.548 | 10.55 | calculation (CAD) | S52, CAD on main: AIR parts list 610301 P01, the same part | CAD, main
AIR | Air column 610101: felt-covered faces, corner angles, foot and plenum plates, fill, kick grille | 1 | 8.151 | 8.15 | calculation (CAD); fill provisional | S52, CAD on main: AIR parts list 610101 P01 8.151, its fill 611104 at 24 kg/m3 (D-81; the CAD has 24); the hub zone 618101 is the in-house module's (no mass here) | CAD, main
AIR | Soffit 610201: underside sections, front face, rails, end and door-side plates, fill, exhaust grille, hangers, hinges, latches | 1 | 11.522 | 11.52 | calculation (CAD); hinges, latches and studs HOLD; fill provisional | S52, CAD on main: AIR parts list 610201 P01 14.639 less its exhaust fan box 3.076 (the next line but one) and its lock screws 0.041 (the joints register counts them in the fixings kit's line), its fill 611203 at 24 kg/m3 (D-81; the CAD has 24) | CAD, main
AIR | Supply fan box 610401 with its two transitions, in the right block; ships loose, fitted on site | 1 | 6.072 | 6.07 | calculation (CAD); transitions HOLD at their sized masses | S52, CAD on main: AIR parts list 610401 P01 11.747 less its intake riser 611501 5.068 (its own line), its fans 0.600 (their own line) and the riser buffer's rivnut 0.0067 (the fixings kit's line): casing 611402 2.181 (3 mm, D-124), bulkhead 611404 and linings 611407 (D-121), the lip 611408 on its pads 618402 and the riser buffer 618501 (its rest in DR), transitions 618102 2.07 and 618103 1.47 (HOLD, sized); goes into the right block through its removable inner face (D-59), so the block ships at 20 kg or less (D-03) | CAD, main
AIR | Exhaust fan box 610402, in the soffit | 1 | 2.476 | 2.48 | calculation (CAD) | S52, CAD on main: AIR parts list 610402 P01 3.076 less its fans 0.600 (their own line): casing 611401 1.982 (3 mm, D-124), the fans' sealed bulkhead 611403 and linings 611405, 611406 (D-121) | CAD, main
AIR | Intake riser 611501, in the right block; ships loose, fitted on site | 1 | 6.068 | 6.07 | calculation (CAD); foot, mesh and boot assumption | S52, CAD on main: AIR parts list 611501 P01 5.068 (1 mm galvanised steel, 139 x 150, D-130), 0.5 kg for its foot and the mesh band piece's extra over the band it replaces, and 0.5 kg for D-130's sealed intake boot and the cartridges' gaskets (the air report's assumptions); goes into the right block through its removable inner face (D-59), so the block ships at 20 kg or less (D-03) | CAD, main
AIR | Roof slot grille 611602 and roof sleeve 611601, with C2 | 1 | 1.334 | 1.33 | calculation (CAD) | S52, CAD on main: AIR parts list 611602 P01 0.350 and 611601 P01 0.984: the sleeve fills C2's roof slot, so it can't ride on the exhaust fan box while the soffit is lifted and slid onto its studs; it ships with the grille and C2 and drops in through the slot after the soffit hangs, onto a gasket on the fan box's top (the Air Engineer, 2026-11-01) | CAD, main
AIR | Four 12 V fans | 1 | 1.200 | 1.20 | assumption | S52: AIR parts list 618401 x 4, 0.3 kg each until the sample is weighed | estimate
BASE | Base seal: BASE's soft lip along the band pieces' inner faces | 6.129 | 0.080 | 0.49 | calculation (CAD); kg/m source | S54, CAD on main: BASE parts list 118001 P02 batch 1, 6.129 m (the left side band 1.462, the right side band 1.464, the back band 2.4, FR1 0.803) at the PM's 0.08 kg/m (D-132); none across the door, where the door's drop seal closes on the room floor; the front-left pieces and the intake piece add theirs in batches 2 and 3; the door edge seals are in FRONT's parts lists (PM ruling 2026-11-01) | CAD, main
BASE | Cable grommets: the sealed cable holes | 1 | 0.100 | 0.10 | source | S20 | estimate
ELECTRICAL | Switches and harness, power unit, cord set, hub zone and lights (ELECTRICAL) | 1 | 5.919 | 5.92 | calculation (CAD) | S43, CAD on main: ELECTRICAL parts list 710000 P01: the power unit in B2 3.47, the hub and controls zone 0.36, the cord set 0.53, the harnesses, cables and connectors, and the lights (6.30 m of shelf and down-light strip, the call light). The light shelf's strip is counted here only; the down-light profile parts listed under INTERIOR's shelf are in the shelf's line (S53) | CAD, main
INTERIOR | Light shelf along the side and back wall tops (its LED strip is in ELECTRICAL's line) | 1 | 1.569 | 1.57 | calculation (CAD) | S46, CAD on main: INTERIOR parts list 810201 P01: the back and side shelves, with ELECTRICAL's down-light profile, cover, end caps and clips 718101 to 718104 (0.210), listed under 810201 (S53); the LED strips are in ELECTRICAL's line | CAD, main
INTERIOR | Work-wall ledge, 1000 mm, with the screen rail | 1 | 1.895 | 1.90 | calculation (CAD); brackets and screen rail HOLD | S46, CAD on main: INTERIOR parts list 810101 P01, the ledge and its 2 brackets (1.395), and 818102, the screen rail on HOLD (0.50); one line, as the packing plan ships them together | CAD, main
WALL | M6 bolts, rivnuts, washers, retainers, joint gaskets and seals, spigots and stop washers, frame cleats | 1 | 3.137 | 3.14 | calculation (part CAD); cleats assumption | part CAD on main: the joints register's counts (S48: 98 M6 x 16 and 12 M6 x 25 bolts, 124 rivnuts, 92 washers, 76 retainers, 23 m of joint gasket, 3.73 m of closing-seam seal) at the parts lists' masses (1.76 kg, D-116); 26 spigots (24 of 831001, 2 of 831010) and 76 stop washers from the joints' made hardware list (0.18 kg, S45); and a 1.2 kg allowance for the internal frame cleats with their glue, 14.9 g corner cleats and 6.7 g T plugs (D-117, S49), until their models land | CAD, main (part)
LATER | Voice cockpit kit reserve, outside the 420 kg cap | 1 | 4.000 | 4.00 | assumption | the kit ships later as an add-on (D-11); the cap is for the pod as shipped (D-81) | estimate
