autonomous-ai/spaceship/v2/05-Engineering/layout-study/out/parts-option-A.csv

id | name | name_vi | assembly | size_mm | qty | kg_each | kg_total | ships_as | status | note
W-SIDE-LO | WALL - SIDE PANEL - LOWER | Vách hông - khung dưới | WALL | 1495 x 1145 x 38 | 2 | 17.94 | 35.89 | upright | calculation
W-SIDE-UP | WALL - SIDE PANEL - UPPER | Vách hông - khung trên | WALL | 1495 x 1145 x 38 | 2 | 17.94 | 35.89 | upright | calculation
W-BACK-LO | WALL - BACK PANEL - LOWER | Vách hậu - khung dưới | WALL | 1212 x 1126 x 38 | 2 | 14.94 | 29.88 | upright | calculation
W-BACK-UP | WALL - BACK PANEL - UPPER | Vách hậu - khung trên | WALL | 1212 x 1126 x 38 | 2 | 14.94 | 29.88 | upright | calculation
C-HALF | CEILING - HALF PANEL WITH FAN OPENING | Trần - nửa khung | CEILING | 1495 x 1212 x 38 | 2 | 18.87 | 37.74 | upright | calculation
L-FELT-SIDE | LINING - PET FELT - SIDE | Tấm tiêu âm PET - vách hông | LINING | 1457 x 1145 x 9 | 4 | 3.09 | 12.35 | upright | calculation
L-FELT-BACK | LINING - PET FELT - BACK | Tấm tiêu âm PET - vách hậu | LINING | 1212 x 1126 x 9 | 4 | 2.52 | 10.10 | upright | calculation
L-FELT-CEIL | LINING - PET FELT - CEILING | Tấm tiêu âm PET - trần | LINING | 1457 x 1212 x 9 | 2 | 3.27 | 6.53 | upright | calculation
B-RAIL-FL-01 | BASE - FRAME RAIL 50x100 - L2400 | Khung sàn - thép hộp 50x100 | BASE | 2400 x 100 x 50 | 1 | 11.00 | 11.00 | long | calculation | v1 outline; welded in v1, knock-down here
B-RAIL-FL-02 | BASE - FRAME RAIL 50x100 - L2020 | Khung sàn - thép hộp 50x100 | BASE | 2020 x 100 x 50 | 1 | 9.26 | 9.26 | long | calculation | v1 outline; welded in v1, knock-down here
B-RAIL-FL-03 | BASE - FRAME RAIL 50x100 - L1370 | Khung sàn - thép hộp 50x100 | BASE | 1370 x 100 x 50 | 2 | 6.28 | 12.56 | upright | calculation | v1 outline; welded in v1, knock-down here
B-RAIL-FL-04 | BASE - FRAME RAIL 50x100 - L269 | Khung sàn - thép hộp 50x100 | BASE | 269 x 100 x 50 | 1 | 1.23 | 1.23 | upright | calculation | v1 outline; welded in v1, knock-down here
B-RAIL-FL-05 | BASE - FRAME RAIL 50x100 - L212 | Khung sàn - thép hộp 50x100 | BASE | 212 x 100 x 50 | 1 | 0.97 | 0.97 | upright | calculation | v1 outline; welded in v1, knock-down here
B-RAIL-FL-06 | BASE - FRAME RAIL 50x100 - L150 | Khung sàn - thép hộp 50x100 | BASE | 150 x 100 x 50 | 2 | 0.69 | 1.38 | upright | calculation | v1 outline; welded in v1, knock-down here
B-RAIL-FL-07 | BASE - FRAME RAIL 50x100 - L123.5 | Khung sàn - thép hộp 50x100 | BASE | 124 x 100 x 50 | 1 | 0.57 | 0.57 | upright | calculation | v1 outline; welded in v1, knock-down here
B-RAIL-FL-08 | BASE - FRAME RAIL 50x100 - L76 | Khung sàn - thép hộp 50x100 | BASE | 100 x 76 x 50 | 4 | 0.35 | 1.39 | upright | calculation | v1 outline; welded in v1, knock-down here
B-JOIST | BASE - JOIST 30x60 - L2400 | Nan đỡ ván sàn - thép hộp 30x60 | BASE | 2400 x 60 x 30 | 2 | 4.60 | 9.20 | long | calculation
B-FOOT | BASE - LEVELLING FOOT M10 | Chân tăng đưa M10 | BASE | 80 x 60 x 60 | 6 | 0.25 | 1.50 | box | assumption
B-BRACKET | BASE - CORNER BRACKET | Pát góc khung sàn | BASE | 150 x 100 x 60 | 4 | 0.35 | 1.40 | box | assumption | bolted corners replace v1 welds
B-BOARD | BASE - FLOOR BOARD | Ván sàn | BASE | 1428 x 1184 x 15 | 2 | 15.22 | 30.45 | upright | calculation
B-THRESH | BASE - FRONT EDGE TRIM | Ốp mép sàn trước | BASE | 1917 x 204 x 3 | 1 | 1.37 | 1.37 | long | calculation
F-DL | FRONT - DECOR BLOCK - LEFT | Khung trang trí - khối trái | FRONT | 2290 x 278 x 205 | 1 | 14.73 | 14.73 | long | calculation
F-DR | FRONT - DECOR BLOCK - RIGHT | Khung trang trí - khối phải | FRONT | 2290 x 1016 x 205 | 1 | 26.51 | 26.51 | long | calculation
F-DT | FRONT - DECOR BLOCK - TOP | Khung trang trí - khối trên | FRONT | 1697 x 280 x 205 | 1 | 10.70 | 10.70 | long | calculation
F-GLASS-DOOR | FRONT - GLASS DOOR (10 mm tempered glass) | Cửa kính | FRONT | 2011 x 1176 x 10 | 1 | 52.00 | 52.00 | glass | calculation | weight from the finished shape in the STEP; exempt from the 20 kg rule
F-GLASS-FIXED | FRONT - FIXED GLASS (10 mm tempered glass) | Vách kính cố định | FRONT | 2139 x 724 x 10 | 1 | 33.60 | 33.60 | glass | calculation | weight from the finished shape in the STEP; exempt from the 20 kg rule
F-HW | FRONT - DOOR AND GLAZING HARDWARE KIT | Phụ kiện cửa và kính | FRONT | 600 x 400 x 150 | 1 | 2.60 | 2.60 | box | assumption | 3 hinges, pull
A-FAN | AIR - CEILING FAN (Panasonic FV-15AUL1 per plan) | Quạt thông gió | AIR | 300 x 300 x 200 | 2 | 1.50 | 3.00 | box | unverified
E-KIT | ELECTRICAL - SWITCHES, LIGHTS, HARNESS | Bộ điện: công tắc, đèn, dây | ELECTRICAL | 600 x 400 x 200 | 1 | 2.95 | 2.95 | box | assumption
I-TABLE | INTERIOR - TABLE (v1), FLAT-PACKED | Bàn | INTERIOR | 1000 x 600 x 120 | 1 | 11.99 | 11.99 | upright | calculation | v1 BOM table: top, leg and base packed flat; removed in the light build
K-FIX | KIT - M6 BOLTS, RIVNUTS | Bộ bu lông M6, gioăng | WALL | 400 x 300 x 150 | 1 | 1.61 | 1.61 | box | calculation | 134 M6 bolts
