autonomous-ai/spaceship/v2/05-Engineering/layout-study/out/parts-option-B2.csv

id | name | name_vi | assembly | size_mm | qty | kg_each | kg_total | ships_as | status | note
W-SIDE-LO | WALL - SIDE PANEL - LOWER WITH FELT | Vách hông - khung dưới | WALL | 1495 x 1145 x 47 | 2 | 12.46 | 24.93 | upright | calculation
W-SIDE-UP | WALL - SIDE PANEL - UPPER WITH FELT | Vách hông - khung trên | WALL | 1495 x 1145 x 47 | 2 | 12.46 | 24.93 | upright | calculation
W-BACK-LO | WALL - BACK PANEL - LOWER WITH FELT | Vách hậu - khung dưới | WALL | 1212 x 1126 x 47 | 2 | 10.27 | 20.54 | upright | calculation
W-BACK-UP | WALL - BACK PANEL - UPPER WITH FELT | Vách hậu - khung trên | WALL | 1212 x 1126 x 47 | 2 | 10.27 | 20.54 | upright | calculation
C-HALF | CEILING - HALF PANEL WITH FAN OPENING WITH FELT | Trần - nửa khung | CEILING | 1495 x 1212 x 47 | 2 | 13.16 | 26.32 | upright | calculation
L-STRIP | LINING - LOOSE FELT STRIPS OVER JOINTS | Dải tiêu âm che mối nối | LINING | 1500 x 300 x 60 | 1 | 6.55 | 6.55 | box | calculation | the rest of the felt is pre-fitted on the panels (weight counted in WALL and CEILING)
B-BAND-BACK | BASE - BASE BAND PIECE 100x40 - BACK (1/2) | Viền chân nhôm | BASE | 1210 x 100 x 40 | 2 | 1.88 | 3.75 | upright | calculation | split with a splice plate
B-BAND-SIDE | BASE - BASE BAND PIECE 100x40 - SIDE | Viền chân nhôm | BASE | 1660 x 100 x 40 | 2 | 2.44 | 4.88 | upright | calculation | stands upright on the 48x40
B-BAND-FRONT-L | BASE - BASE BAND PIECE 100x40 - FRONT-L | Viền chân nhôm | BASE | 300 x 100 x 40 | 1 | 0.44 | 0.44 | upright | calculation
B-BAND-FRONT-R | BASE - BASE BAND PIECE 100x40 - FRONT-R | Viền chân nhôm | BASE | 1050 x 100 x 40 | 1 | 1.54 | 1.54 | upright | calculation
B-KEY | BASE - CORNER KEY | Ke góc đế | BASE | 120 x 80 x 40 | 6 | 0.15 | 0.90 | box | assumption
B-GLIDE | BASE - LEVELLING GLIDE (hex from above) | Chân chỉnh cao | BASE | 50 x 50 x 40 | 8 | 0.15 | 1.20 | box | assumption
B-THRESH | BASE - DOOR THRESHOLD, LOW | Ngưỡng cửa thấp | BASE | 1176 x 60 x 20 | 1 | 1.20 | 1.20 | upright | assumption | about 20 mm high; replaces the 100 mm band across the door only
B-FLOOR | BASE - THIN FLOOR PANEL 15 mm | Tấm sàn mỏng | BASE | 1457 x 1212 x 15 | 2 | 16.42 | 32.85 | upright | calculation | 15 mm ply + 0.3 kg/m2 finish; lies on the room floor on a 3 mm seal mat
F-DL | FRONT - DECOR BLOCK - LEFT (half) | Khung trang trí - khối trái (nửa) | FRONT | 1145 x 278 x 205 | 2 | 5.29 | 10.58 | upright | calculation | split for 48x40; seam crosses the black faceted front (look risk)
F-DR | FRONT - DECOR BLOCK - RIGHT (half) | Khung trang trí - khối phải (nửa) | FRONT | 1145 x 1016 x 205 | 2 | 9.33 | 18.66 | upright | calculation | split for 48x40; seam crosses the black faceted front (look risk)
F-DT | FRONT - DECOR BLOCK - TOP (half) | Khung trang trí - khối trên (nửa) | FRONT | 848 x 280 x 205 | 2 | 3.81 | 7.62 | upright | calculation | split for 48x40; seam crosses the black faceted front (look risk)
F-GLASS-DOOR | FRONT - GLASS DOOR (8 mm tempered glass) | Cửa kính | FRONT | 2011 x 1176 x 8 | 1 | 41.60 | 41.60 | glass | calculation | weight from the finished shape in the STEP; exempt from the 20 kg rule
F-GLASS-FIXED | FRONT - FIXED GLASS (8 mm tempered glass) | Vách kính cố định | FRONT | 2139 x 724 x 8 | 1 | 26.88 | 26.88 | glass | calculation | weight from the finished shape in the STEP; exempt from the 20 kg rule
F-HW | FRONT - DOOR AND GLAZING HARDWARE KIT | Phụ kiện cửa và kính | FRONT | 600 x 400 x 150 | 1 | 5.78 | 5.78 | box | assumption | 3 hinges, pull, drop seal, sealed glazing profiles
A-FAN | AIR - CEILING FAN (Panasonic FV-15AUL1 per plan) | Quạt thông gió | AIR | 300 x 300 x 200 | 2 | 1.50 | 3.00 | box | unverified
A-SILENCER | AIR - SILENCED VENT BOX | Hộp tiêu âm cửa gió | AIR | 450 x 300 x 120 | 2 | 1.50 | 3.00 | box | assumption
E-KIT | ELECTRICAL - SWITCHES, LIGHTS, HARNESS | Bộ điện: công tắc, đèn, dây | ELECTRICAL | 600 x 400 x 200 | 1 | 3.05 | 3.05 | box | assumption
E-VOICE-RESERVE | ELECTRICAL - VOICE COCKPIT KIT RESERVE (later) | Dự phòng bộ voice cockpit | ELECTRICAL | 0 x 0 x 0 | 1 | 4.00 | 4.00 | none | assumption | weight held in the budget only; the kit ships later
K-FIX | KIT - M6 BOLTS, RIVNUTS, CAM CONNECTORS, JOINT GASKETS | Bộ bu lông M6, gioăng | WALL | 400 x 300 x 150 | 1 | 4.85 | 4.85 | box | calculation | 92 M6 bolts, 38 cam or clip connectors
