autonomous-ai/spaceship/v2/03-Manufacturing/base/110000_P01_BASE-TUBE-CUT-LIST_SPEC.csv

item | name | section | material | qty_per_pod | cut_length_outer_face_mm | cut_length_inner_face_mm | tolerance | front_or_first_end | back_or_second_end | finish | status | source
111101 | BASE - BAND TUBE - SIDE - LH | 100 x 40 x 1.5 | aluminium 6063-T6 rectangular tube 100 x 40 x 1.5 (PM ruling; alloy: assumption) | 1 | 1520.00 | 1502.07 | length +0/-0.5, end angle +-0.25 deg (assumption) | mitre to DL's outer facet band piece: 24.14 deg from square, long point on the outer face | square, flush with the back face: its key 111211 inside and the flat end cap 118003 (D-129) | black anodised, matte, 20 um (class AA20, EN ISO 7599) | calculation (CAD) | 110000_P01_BASE_CAD
111102 | BASE - BAND TUBE - SIDE - RH | 100 x 40 x 1.5 | aluminium 6063-T6 rectangular tube 100 x 40 x 1.5 (PM ruling; alloy: assumption) | 1 | 1522.00 | 1504.17 | length +0/-0.5, end angle +-0.25 deg (assumption) | mitre to the intake's facet piece: 24.02 deg from square, long point on the outer face | square, flush with the back face: its key 111211 inside and the flat end cap 118003 (D-129) | black anodised, matte, 20 um (class AA20, EN ISO 7599) | calculation (CAD) | 110000_P01_BASE_CAD
111103 | BASE - BAND TUBE - BACK | 100 x 40 x 1.5 | aluminium 6063-T6 rectangular tube 100 x 40 x 1.5 with 2 welded 1.5 mm end plates (alloy: assumption) | 1 | 2417.00 | 2417.00 | length +0/-0.5, end angle +-0.25 deg (assumption) | square at its left end, closed by a welded 1.5 end plate (100 x 40) with its open slot (D-129) | the same at its right end; 2420.0 over both plates | black anodised, matte, 20 um (class AA20, EN ISO 7599) | calculation (CAD) | 110000_P01_BASE_CAD
111106 | BASE - BAND TUBE - FRONT - FIXED GLASS | 100 x 40 x 1.5 | aluminium 6063-T6 rectangular tube 100 x 40 x 1.5 with a welded 1.5 mm end plate (alloy: assumption) | 1 | 695.04 | 695.04 | length +0/-0.5, end angle +-0.25 deg (assumption) | square at the door opening, closed by the flat end cap 118003 (in view, D-132) | square, closed by a welded 1.5 end plate (100 x 40) with 2 keyholes at X 915.0; 696.5 over the plate | black anodised, matte, 20 um (class AA20, EN ISO 7599) | calculation (CAD) | 110000_P01_BASE_CAD
