autonomous-ai/spaceship/v2/05-Engineering/electrical/710000_P01_ELECTRICAL-LOAD-TABLE_CALC.csv

id | load | supply | fuse | qty | w_each_max | w_total_max | w_each_typical | w_total_typical | volts | a_total_max | w_status | source | note
LD01 | Supply fan pair (2 x Noctua NF-A14 industrialPPC-3000 PWM), high in DR | PS3 | F3a 2 A | 2 | 6.6 | 13.2 | 2.6 | 5.2 | 12 | 1.1 | unverified (max: maker figure read from retailer copies); calculation (typical, cube law at 73 % speed) | selection F1; air report §7d | PWM 1 from the hub; the fans run at full speed if the PWM line opens (fail-safe)
LD02 | Exhaust fan pair (2 x the same fan), soffit right end | PS3 | F3b 2 A | 2 | 6.6 | 13.2 | 1.81 | 3.63 | 12 | 1.1 | unverified (max); calculation (typical, 65 % speed) | selection F1; air report §7d | PWM 2 from the hub (two signals, balanced flow, D-61)
LD03 | Desk Pro AI sensor hub (in-house), air column zone | PS3 | F3c 1 A | 1 | 5 | 5 | 3 | 3 | 12 | 0.417 | assumption (ISS-060: in-house data still to collect) | REQ-ELE-03, C8 | 12 V input assumed; if the hub takes 5 V, a 12-to-5 V converter sits in the hub zone (HOLD H-ELE-08)
LD04 | Call light, 900 mm bar of Häfele's 24 V 3.0 W/m strip (LED 3142, the 2165's twin: about 155 lm/W) | PS2 | light controller CH3 | 1 | 2.7 | 2.7 | 0 | 0 | 24 | 0.113 | calculation (0.9 m x 3.0 W/m, maker data) | REQ-AIR-06, D-70, D-168; Häfele America Lighting 2026 p. 40 | about 420 lm; on in the call scene, when the hub trims the down-light to stay inside the 22 W
LD05 | Uplight on the light shelf, 4.40 m of Häfele's 24 V 6.0 W/m strip (LED 3145, the 2168's twin: 970 lm/m at 3000 K, 162 lm/W) | PS2 | light controller CH1 | 1 | 26.4 | 26.4 | 10.6 | 10.6 | 24 | 1.1 | calculation (whole 50 mm sections of each shelf run x 6.0 W/m; maker data) | REQ-AIR-06, D-70, D-168; Häfele America Lighting 2026 p. 41 | 26.4 W and 4268 lm at full; in the work scene the hub runs it at 10.6 W, about 1714 lm
LD08 | Down-light under the right-wall shelf, 2 rows x 0.95 m of the 24 V 6.0 W/m strip side by side in the shelf's LED profile 718101 behind its satin cover, aimed at the ledge | PS2 | light controller CH2 | 1 | 11.4 | 11.4 | 11.4 | 11.4 | 24 | 0.475 | calculation (2 x 0.95 m x 6.0 W/m; maker data) | PM ruling 2026-11-01 (down-light, about 22 W in all, about 300 lx on the ledge); Häfele 25L1-18 | about 1840 lm; about 325 lx on the ledge at full with no cover, about 279 to 292 lx through the satin cover at 86 to 90 % (D-127; calculation, Lambertian strip 1.2 m above it, no reflections)
LD06 | Voice cockpit hook: one 24 V Class 2 feed, 60 W peak | PS1 | F1 5 A | 1 | 60 | 60 | 0 | 0 | 24 | 2.5 | DECIDED (D-11, D-88 peak; D-168: one 24 V feed) | REQ-VCK-04; D-88; D-168 | the kit's 60 W peak (40 W average, D-88) on its one 24 V feed, capped at 76.8 W (80 % of PS1); kit not fitted in v2, so 0 W typical
LD07 | Supply fan inlet temperature sensor | PS3 | via the hub | 1 | 0.05 | 0.05 | 0.05 | 0.05 | 12 | 0.004 | assumption | REQ-ELE-04, D-50 | powered from the hub's sensor port
