autonomous-ai/spaceship/v2/01-CAD-Native/skeleton/100000_P04_POD-SKELETON-PARAMETERS.csv

parameter | value | unit | expression | status | source
pod_w | 2500 | mm | 2500 mm | decided | D-01; conventions s4 (X = +-1250)
pod_d | 1700 | mm | 1700 mm | decided | D-01; conventions s4 (Y = +-850)
pod_h | 2400 | mm | 2400 mm | decided | D-21 (room floor to roof skin top)
glide_h | 10 | mm | 10 mm | assumption | layout study inputs.py glide_h
band_h | 100 | mm | 100 mm | source | layout study B1 list B-BAND 100x40; inputs.py base_h
band_t | 40 | mm | 40 mm | source | layout study B1 list B-BAND 100x40
skin_t | 3 | mm | 3 mm | decided | ACP skin, walls and ceiling (D-16; PM ruling 2026-10-31 on outer_t)
bond_t | 3 | mm | 3 mm | decided | bond line between the ACP and the frame (PM ruling 2026-10-31 on outer_t)
frame_t | 40 | mm | 40 mm | decided | aluminium frame tube depth, walls and ceiling (PM ruling 2026-10-31 on outer_t)
outer_t | 46 | mm | skin_t + bond_t + frame_t | decided | PM ruling 2026-10-31: ACP 3 + bond line 3 + frame 40, walls and ceiling (was 43)
cav_gap | 4 | mm | 4 mm | decided | D-16, D-42: the gap between the outer panel and the lining cassette in the wall and ceiling stack
cass_t | 34 | mm | 34 mm | source | layout study B1 final list L-CASS 34 (tray + 25 gap + felt 9)
stack_t | 84 | mm | outer_t + cav_gap + cass_t | calculation | D-16, D-42 stack, walls and ceiling: outer panel + cavity gap + cassette (PM ruling 2026-10-31 on outer_t)
wall_depth | 1495 | mm | 1495 mm | decided | PM ruling pass C: side walls start at the decor back plate (Y -645), as v1 (1496)
lin_gap | 4 | mm | 4 mm | assumption | PM ruling pass C: gap above the upper side linings so they stay floating (= the 4 mm stack gap)
seam_gap | 2.26 | mm | 2.26 mm | decided | PM ruling 2026-10-31 (Mechanical Checker F-001, F-005): the Joints Engineer's 2.26 mm at all nine site seam types, set by a metal stop (1.5 stop washer + 0.76 rivnut head; joints register section 2.8)
mat_t | 0 | mm | 0 mm | decided | D-132 (PM ruling 2026-11-01): no floor, so no floor mat (was 3, D-72)
floor_t | 0 | mm | 0 mm | decided | D-132 (PM ruling 2026-11-01): no floor; people stand on the room floor (was 9)
thresh_h | 0 | mm | 0 mm | decided | D-132 (PM ruling 2026-11-01): no threshold, no step at the door; the door's drop seal closes on the room floor (was 13)
decor_d | 205 | mm | 205 mm | source | v1 geometry per the PM ruling on D-39 (as v1; the drawings win): v1 decor-frame drawing frames 191 (left) and 197 (right) deep plus ACP and back plate = the v1 STEP shell, Y -850 to -645 = 205. D-39 and the B1 list say 230-235 (v1 BOM); see BUILD-RECORD-P02
dl_w | 278 | mm | 278 mm | source | B1 list F-DL 278 (v1 BOM DL)
dr_w | 1016 | mm | 1016 mm | source | B1 list F-DR 1016 (v1 STEP solid 78)
dt_w | 1697 | mm | 1697 mm | source | B1 list F-DT 1697 (v1 BOM DT)
dt_h | 280 | mm | 280 mm | source | B1 list F-DT 280
door_w | 1176 | mm | 1176 mm | decided | D-46
door_h | 2011 | mm | 2011 mm | source | B1 list F-GLASS-DOOR 2011; v1 STEP solid 238
glass_t | 8.76 | mm | 8.76 mm | decided | D-46 (4+4 laminate)
glass_y | 699 | mm | 699 mm | source | v1 STEP solid 238 centre Y = -699 (layout study data)
kick_d | 20 | mm | 20 mm | assumption | kick strip envelope depth (D-40 gives the height only)
kick_gap | 7 | mm | 7 mm | source | FRONT door unit: 7 mm running gap under the kick strip for the drop seal (Mechanical Checker F-002 on P03); since D-132 the PM puts the kick strip's bottom on the band's bottom line, glide_h, so the skeleton's kick envelope no longer uses it
fr_dz | 17 | mm | 17 mm | calculation | v1 front top 2417 (v2 frame) - pod_h 2400
door_xl | 289 | mm | 289 mm | source | V1-FRONT-FACETS: door left edge X -961 = -1250 + 289
door_xbr | 1464 | mm | 1464 mm | source | V1-FRONT-FACETS: door bottom-right X 214
door_xtr | 1182 | mm | 1182 mm | source | V1-FRONT-FACETS: door top-right X -68
door_zb | 105 | mm | 122 mm - fr_dz | source | V1-FRONT-FACETS: door bottom Z 122
door_zt | 2116 | mm | 2133 mm - fr_dz | source | V1-FRONT-FACETS: door top Z 2133
glass_gap | 4 | mm | 4 mm | decided | PM ruling 2026-10-31 on Mechanical Checker F-014: the fixed glass's free edge runs parallel to the door's slanted edge, 4.0 mm away (FRONT's glass in PR #28 is the reference)
fix_xbr | 302 | mm | 302 mm | source | V1-FRONT-FACETS: fixed glass bottom-right X 948 = 1250 - 302
fix_xk | 501 | mm | 501 mm | source | V1-FRONT-FACETS: fixed glass knee X 749 = 1250 - 501
fix_zk | 1521 | mm | 1538 mm - fr_dz | source | V1-FRONT-FACETS: fixed glass knee Z 1538
fix_xtr | 1480 | mm | 1480 mm | source | V1-FRONT-FACETS: fixed glass top-right X 230 = -1250 + 1480
fix_zb | 102 | mm | 119 mm - fr_dz | source | V1-FRONT-FACETS: fixed glass bottom Z 119
fix_zt | 2119 | mm | 2136 mm - fr_dz | source | V1-FRONT-FACETS: fixed glass top Z 2136
dt_zb | 2120 | mm | 2137 mm - fr_dz | source | V1-FRONT-FACETS: DT and DR edge above the glass Z 2137
ch_zlo | 2200 | mm | 2217 mm - fr_dz | source | V1-FRONT-FACETS: top chamfer front edge Z 2217 at Y -848
ch_yb | 672 | mm | 672 mm | source | V1-FRONT-FACETS: top chamfer back edge Y -672
dl_x2 | 92 | mm | 92 mm | source | V1-FRONT-FACETS: DL facet knee X -1158 = -1250 + 92
dl_y2 | 752 | mm | 752 mm | source | V1-FRONT-FACETS: DL facet knee Y -752
dl_x3 | 271 | mm | 271 mm | source | V1-FRONT-FACETS: DL front corner X -979
dl_y3 | 844 | mm | 844 mm | source | V1-FRONT-FACETS: DL front corner Y -844
dl_y1 | 670 | mm | 670 mm | source | V1-FRONT-FACETS: DL outer facet start Y -670
dl_zo | 2397 | mm | 2414 mm - fr_dz | source | V1-FRONT-FACETS: DL top at the outer corner Z 2414
dt_x2 | 281 | mm | 281 mm | source | V1-FRONT-FACETS: DT lower facet left X -969 = -1250 + 281
dt_y2 | 767 | mm | 767 mm | source | V1-FRONT-FACETS: DT lower facet left Y -767
dt_y3 | 753 | mm | 753 mm | source | V1-FRONT-FACETS: DT lower facet outer Y -753 at X -1154
dr_xc | 198 | mm | 198 mm | source | V1-FRONT-FACETS: DR corner facet front X 1052 = 1250 - 198
dt_xr | 1699 | mm | 1699 mm | source | V1-FRONT-FACETS: DT/DR joint at the top, X 449 = -1250 + 1699 (PM ruling pass C)
dr_yc | 672 | mm | 672 mm | source | V1-FRONT-FACETS: DR corner facet back Y -672
fix_xbl | 1468.46 | mm | door_xbr + (door_zb - fix_zb) * (door_xbr - door_xtr) / (door_zt - door_zb) + glass_gap * sqrt((door_xbr - door_xtr) * (door_xbr - door_xtr) + (door_zt - door_zb) * (door_zt - door_zb)) / (door_zt - door_zb) | calculation | F-014: fixed glass bottom-left, on the line glass_gap from the door's slanted edge (was v1's 1468)
fix_xtl | 1185.618 | mm | door_xbr + (door_zb - fix_zt) * (door_xbr - door_xtr) / (door_zt - door_zb) + glass_gap * sqrt((door_xbr - door_xtr) * (door_xbr - door_xtr) + (door_zt - door_zb) * (door_zt - door_zb)) / (door_zt - door_zb) | calculation | F-014: fixed glass top-left, on the same line (was v1's 1184)
floor_top | 0 | mm | mat_t + floor_t | calculation | the floor top: Z 0, the room floor itself (D-132: no floor; was Z 12)
wall_z0 | 110 | mm | glide_h + band_h | calculation | base band top: glides + band
panel_z0 | 112.26 | mm | wall_z0 + seam_gap | calculation | walls stand one seam_gap above the band top (joints register 2.8, IF-01)
wall_h | 2290 | mm | pod_h - wall_z0 | calculation | 2290 = layout study v2_model wall_h
side_h | 1142.74 | mm | (wall_h - 2 * seam_gap) / 2 | calculation | D-23: 2 sheets per side wall; the gap on the band and the horizontal seam (joints register 2.8)
side_l | 1492.74 | mm | wall_depth - seam_gap | calculation | side panel length along Y: the seam_gap at the decor's back plate (joints register 2.8, IF-07)
back_oh | 2239.48 | mm | pod_h - outer_t - seam_gap - panel_z0 | calculation | PM ruling 2026-10-31 (pass D, F-004): the back outer frames run up to the ceiling frame (pod_h - outer_t), less the seam_gap under it, closing the slot at the back top edge
back_ph | 1118.61 | mm | (back_oh - seam_gap) / 2 | calculation | D-23: 4 sheets on the back, two equal rows with one seam_gap between them (joints register 2.8); the lower back linings match the lower row, as on the side walls
half_pw | 1200.61 | mm | (pod_w - 2 * outer_t - 3 * seam_gap) / 2 | calculation | SKIN width of each back and ceiling panel: two skins and three seam_gap seams between the side frames (F-001, joints register 2.8)
close_gap | 5.5 | mm | 5.5 mm | decided | PM ruling 2026-10-31 (joints register, F-011/F-012): frame gap at the closing seams B1-B2, B3-B4 and C1-C2, which have no hard stop (slotted holes, thicker gasket)
half_fw | 1198.99 | mm | (pod_w - 2 * outer_t - 2 * seam_gap - close_gap) / 2 | calculation | FRAME width of each back and ceiling panel: the skins overhang their frames by half_pw - half_fw at the closing seam (PM ruling 2026-10-31)
inner_w | 2332 | mm | pod_w - 2 * stack_t | calculation | inside width between the side linings
bolt_edge_inset | 220 | mm | 220 mm | decided | PM ruling 2026-10-31: on every bolted edge the end bolts sit this far in from each panel end (the FRAME end, where the bolts go), the rest evenly spaced
spigot_inset | 100 | mm | 100 mm | decided | PM ruling 2026-10-31: locating spigots this far in from each panel end (round hole at one end, slot at the other)
base_bolt_edge | 220 | mm | bolt_edge_inset | decided | J-BASE-01 wall to band: the edge rule (kept by this name for parts already linked)
n_base_bolt | 4 | - | 4 | decided | PM ruling 2026-10-31, J-BASE-01: bolts per panel along the band, evenly spaced
base_spigot_inset | 100 | mm | spigot_inset | decided | J-BASE-01: the spigot rule (kept by this name for parts already linked)
base_side_y0 | -642.74 | mm | pod_d / 2 - wall_depth + seam_gap | calculation | J-BASE-01: side bolt lines start at the side panel's front end (first bolt base_bolt_edge further on)
side_base_pitch | 350.913 | mm | (side_l - 2 * base_bolt_edge) / (n_base_bolt - 1) | calculation | J-BASE-01 bolt pitch along a side panel
base_back_x0 | 1201.74 | mm | pod_w / 2 - outer_t - seam_gap | calculation | J-BASE-01: back bolt lines start at each back FRAME's outer end, X -/+ this (first bolt base_bolt_edge further in)
back_base_pitch | 252.997 | mm | (half_fw - 2 * base_bolt_edge) / (n_base_bolt - 1) | decided | PM ruling 2026-10-31 (Reviewer 5 P2 on #58): J-BASE-01 pitch along a back panel, measured on the FRAME (half_fw), where the bolts go; 'panel end' means the frame end
ceil_bolt_z | 2374 | mm | pod_h - outer_t + frame_t / 2 | decided | PM ruling 2026-10-31, J-CEIL-01 wall to ceiling: the bolt line on the ceiling frame's centre (Z 2374)
n_ceil_side_bolt | 4 | - | 4 | decided | PM ruling 2026-10-31, J-CEIL-01: bolts along each side wall top
n_ceil_back_bolt | 4 | - | 4 | decided | PM ruling 2026-10-31, J-CEIL-01: bolts along each back panel top, like the base (pitch about 253, every edge 350 or less; joints register: 82 bolts in all)
ceil_side_y0 | -645 | mm | pod_d / 2 - wall_depth | decided | PM ruling 2026-10-31 (joints register): J-CEIL-01 side bolt lines start at Y -645, measured along the ceiling (first bolt bolt_edge_inset further on)
ceil_side_pitch | 351.667 | mm | (wall_depth - 2 * bolt_edge_inset) / (n_ceil_side_bolt - 1) | decided | PM ruling 2026-10-31 (joints register): J-CEIL-01 pitch along a side wall top, over the ceiling's length (was over the side panel's)
ceil_back_x0 | 1201.74 | mm | pod_w / 2 - outer_t - seam_gap | decided | PM ruling 2026-10-31 (joints register): J-CEIL-01 back bolt lines start at each back frame's outer end, X -/+ this
ceil_back_pitch | 252.997 | mm | (half_fw - 2 * bolt_edge_inset) / (n_ceil_back_bolt - 1) | decided | PM ruling 2026-10-31 (joints register): J-CEIL-01 pitch along a back panel top, on the frame (half_fw)
