autonomous-ai/spaceship/v2/04-Checks/stacks/contributors.csv

stack_id | name | sign | nominal_mm | plus_mm | minus_mm | status | source
ST-01 | Door bottom height (glass bottom) | 1 | 105 |  |  | source | skeleton P03 door_zb (v1 front lowered 17 mm); hinge height adjustment HOLD until the hinges are named (D-46)
ST-01 | Kick strip height below the glass | -1 | 78 |  |  | source | skeleton P04 (main 0cb764f): KICK from Z 27 (threshold + 7 mm floor gap; PM ruling on the FRONT plan) to door_zb 105
ST-01 | Threshold height | -1 | 20 |  |  | confirmed | D-18; extrusion tolerance to come from the BASE drawing
ST-01 | Floor height under the threshold | 1 | 0 |  |  | assumption | room floor datum Z 0; flatness from the install sheet (IF-17) still to set
ST-03 | Clearance hole radius at its smallest | 1 | 3.5 | 0 | 0 | confirmed | D-64 and D-75: Ø7.0 clearance holes at every site joint; a +0.1/0 hole tolerance loses nothing at the small end
ST-03 | M6 bolt major radius at its largest | -1 | 2.987 | 0 | 0 | source | ISO 965-1 6g: major diameter max 5.974 mm
ST-03 | Clearance hole position (radial) | -1 | 0 | 0.2 | 0 | confirmed | F-009 ruling: position Ø0.4 (±0.2) from the spigot hole by CNC or a drill jig
ST-03 | Rivnut hole position (radial) | -1 | 0 | 0.2 | 0 | confirmed | F-009 ruling: position Ø0.4 (±0.2) from the spigot hole by CNC or a drill jig
ST-03 | Rivnut float in its hole (radial) | -1 | 0 | 0.065 | 0 | calculation | Sherex CAH3-610-4.2: hole 9.53 +0.10 less body 9.50 max over 2 (joints register PR #23 H-03); spigot play is not a contributor: the panel shifts to the bolts within it
ST-02 | Space between the side frames | 1 | 2408 |  |  | calculation | pod_w 2500 - 2 x outer_t 46 (skeleton P04 on main 0cb764f); its tolerance from the BASE band corners and the WALL drawings
ST-02 | Back panel B1 frame width | -1 | 1198.99 |  |  | source | joints register R-J16 (main 9881d71): (2408 - 2 x 2.26 - 5.5) / 2; the skin stays 1200.61; cut tolerance from the WALL drawing
ST-02 | Back panel B2 frame width | -1 | 1198.99 |  |  | source | joints register R-J16 (main 9881d71); cut tolerance from the WALL drawing
ST-02 | Stop at the left back corner | -1 | 2.26 | 0.13 | 0.13 | source | joints register 2.2 and 2.8 (PR #23): stop washer 1.5 ±0.05 (assumption) + rivnut head 0.76 ±0.08 (Sherex)
ST-02 | Stop at the right back corner | -1 | 2.26 | 0.13 | 0.13 | source | joints register 2.2 and 2.8 (PR #23): stop washer 1.5 ±0.05 (assumption) + rivnut head 0.76 ±0.08 (Sherex)
ST-02A | Space between the side frames (taken as perfect) | 1 | 2408 | 0 | 0 | assumption | best case: shows the stops alone
ST-02A | Back panel frames B1 + B2 (taken as perfect) | -1 | 2397.98 | 0 | 0 | assumption | best case: 2 x 1198.99 (joints register R-J16)
ST-02A | Stop at the left back corner | -1 | 2.26 | 0.13 | 0.13 | source | joints register 2.2 and 2.8 (PR #23): stop washer 1.5 ±0.05 (assumption) + rivnut head 0.76 ±0.08 (Sherex)
ST-02A | Stop at the right back corner | -1 | 2.26 | 0.13 | 0.13 | source | joints register 2.2 and 2.8 (PR #23): stop washer 1.5 ±0.05 (assumption) + rivnut head 0.76 ±0.08 (Sherex)
ST-04 | Space between the upper side panels' top members | 1 | 2408 |  |  | calculation | skeleton P04 (main 0cb764f); tolerance from the WALL drawings
ST-04 | Ceiling half C1 frame width | -1 | 1198.99 |  |  | source | joints register R-J16 (main 9881d71); cut tolerance from the CEILING drawing
ST-04 | Ceiling half C2 frame width | -1 | 1198.99 |  |  | source | joints register R-J16 (main 9881d71); cut tolerance from the CEILING drawing
ST-04 | Stop at the left side edge | -1 | 2.26 | 0.13 | 0.13 | source | joints register 2.2 and 2.8 (PR #23): stop washer 1.5 ±0.05 (assumption) + rivnut head 0.76 ±0.08 (Sherex)
ST-04 | Stop at the right side edge | -1 | 2.26 | 0.13 | 0.13 | source | joints register 2.2 and 2.8 (PR #23): stop washer 1.5 ±0.05 (assumption) + rivnut head 0.76 ±0.08 (Sherex)
ST-04A | Space between the top members (taken as perfect) | 1 | 2408 | 0 | 0 | assumption | best case: shows the stops alone
ST-04A | Ceiling half frames C1 + C2 (taken as perfect) | -1 | 2397.98 | 0 | 0 | assumption | best case: 2 x 1198.99 (joints register R-J16)
ST-04A | Stop at the left side edge | -1 | 2.26 | 0.13 | 0.13 | source | joints register 2.2 and 2.8 (PR #23): stop washer 1.5 ±0.05 (assumption) + rivnut head 0.76 ±0.08 (Sherex)
ST-04A | Stop at the right side edge | -1 | 2.26 | 0.13 | 0.13 | source | joints register 2.2 and 2.8 (PR #23): stop washer 1.5 ±0.05 (assumption) + rivnut head 0.76 ±0.08 (Sherex)
