autonomous-ai/spaceship/sources/v1/indoor-pod-v3-assembly.step

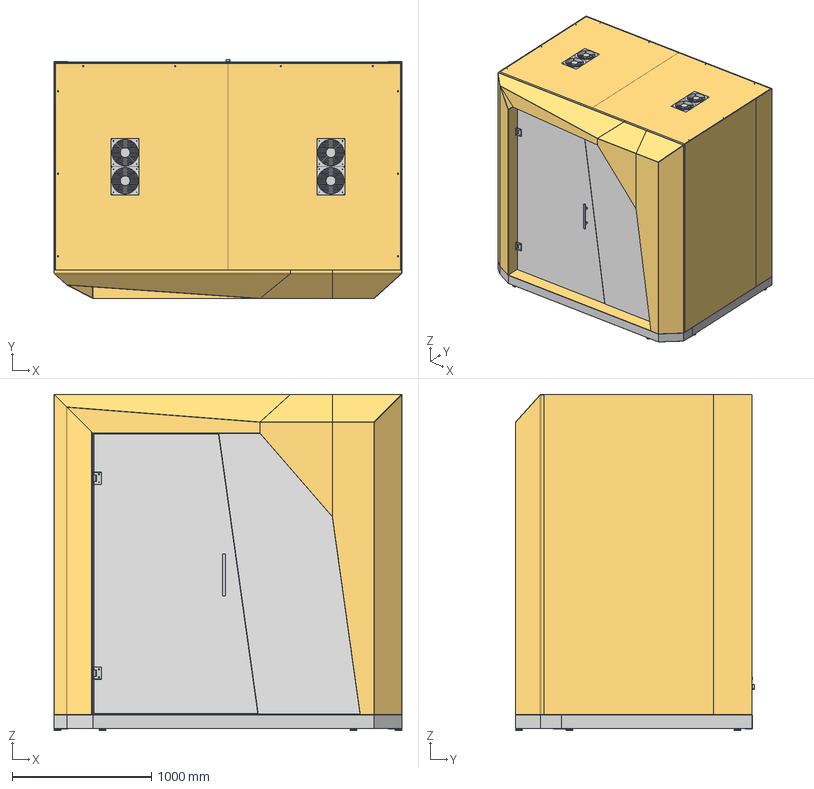
[picture p50: CAD file, 2026-10-31]
sources/v1/indoor-pod-v3-assembly.step
2500.0 x 1718.1 x 2417.0 mm
