autonomous-ai/spaceship/v2/03-Manufacturing/proof/V2-SWL-00_P01_WALL-PANEL-ASSY-SIDE-LOWER-LH_STEP.step

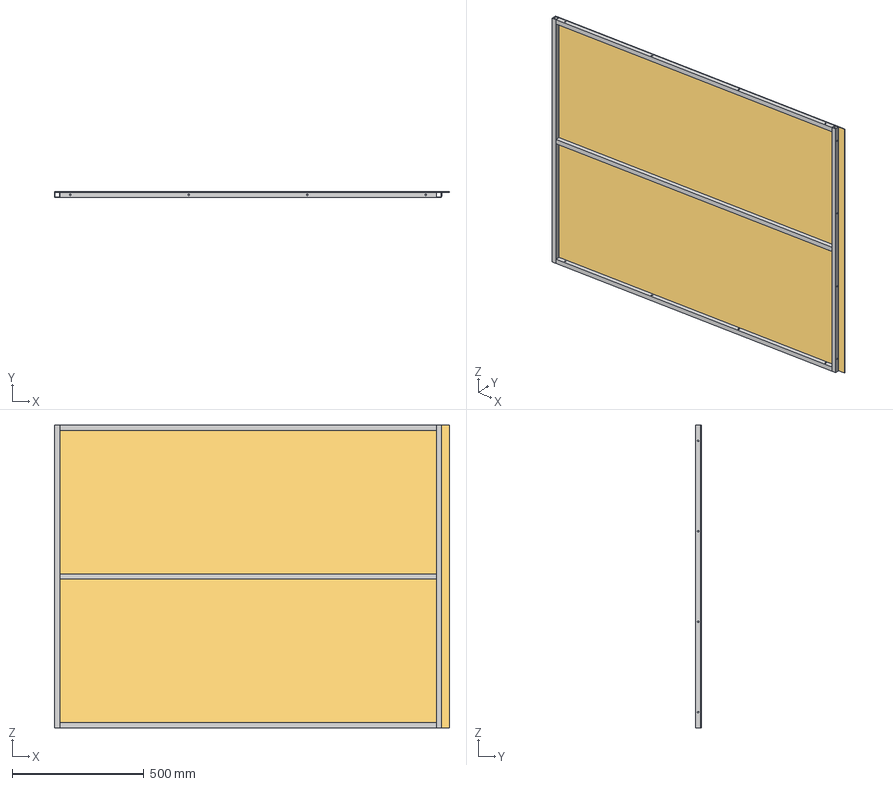
[picture p51: CAD file, 2026-10-31]
v2/03-Manufacturing/proof/V2-SWL-00_P01_WALL-PANEL-ASSY-SIDE-LOWER-LH_STEP.step
1500.0 x 23.0 x 1150.0 mm
V2-SWL-11
V2-SWL-12
V2-SWL-13
V2-SWL-14
V2-SWL-15
V2-SWL-20
