autonomous-ai/spaceship/tools/checks/tests/fixtures/skeleton-P03.step

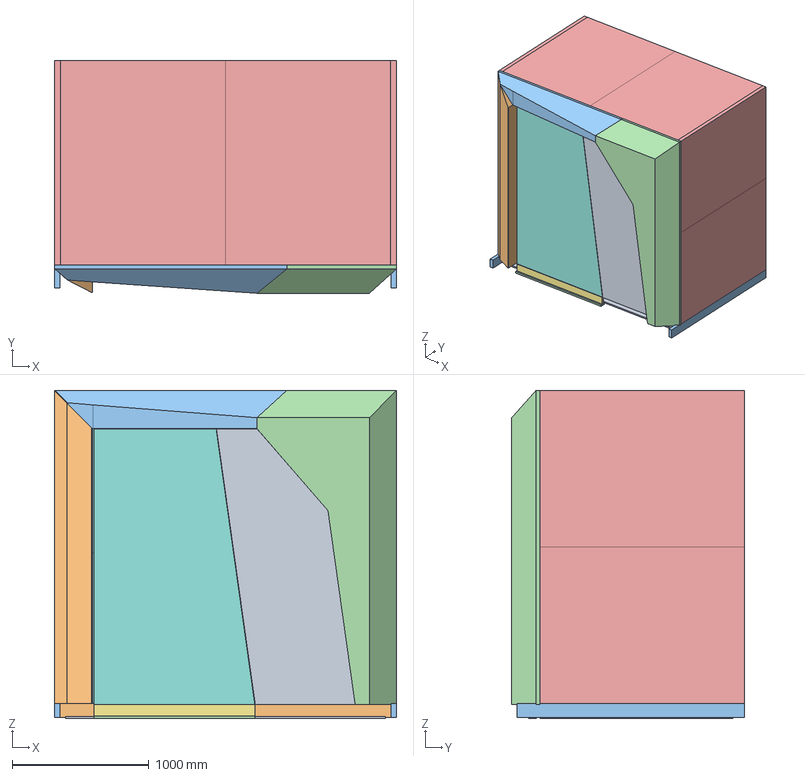
[picture p52: CAD file, 2026-10-31]
tools/checks/tests/fixtures/skeleton-P03.step
2500.0 x 1700.0 x 2400.0 mm
