autonomous-ai/spaceship/v2/03-Manufacturing/front/350001_P01_FRONT-DECOR-BLOCK-ASSY-DL_STEP.step

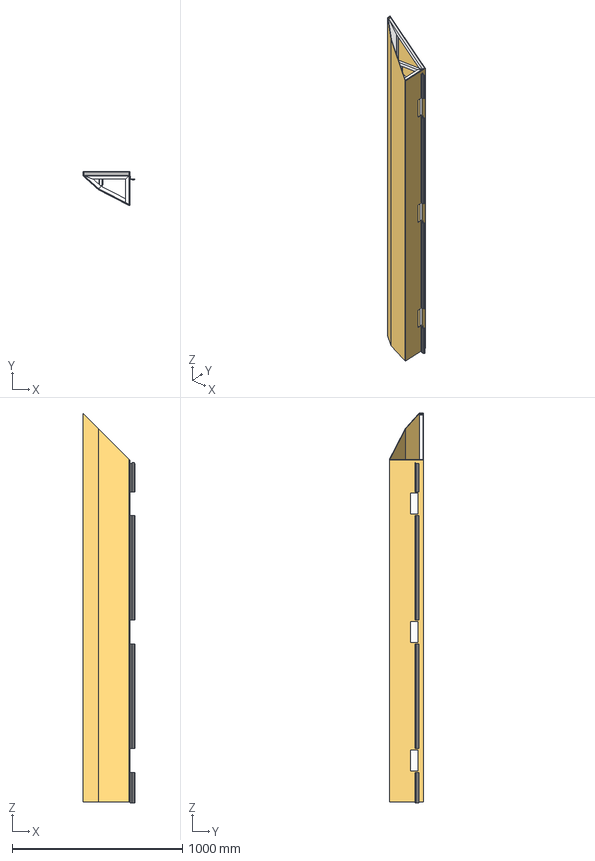
[picture p53: CAD file, 2026-11-02]
v2/03-Manufacturing/front/350001_P01_FRONT-DECOR-BLOCK-ASSY-DL_STEP.step
308.0 x 199.0 x 2292.0 mm
