autonomous-ai/spaceship/v2/03-Manufacturing/front/350002_P01_FRONT-DECOR-BLOCK-ASSY-DT_STEP.step

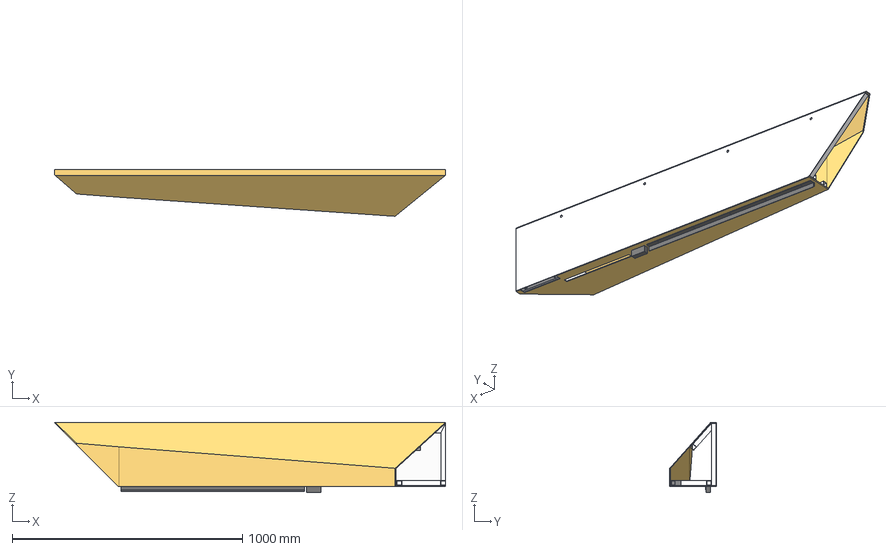
[picture p54: CAD file, 2026-11-02]
v2/03-Manufacturing/front/350002_P01_FRONT-DECOR-BLOCK-ASSY-DT_STEP.step
1699.0 x 202.7 x 306.0 mm
