autonomous-ai/spaceship/v2/03-Manufacturing/front/350003_P01_FRONT-DECOR-BLOCK-ASSY-DR_STEP.step

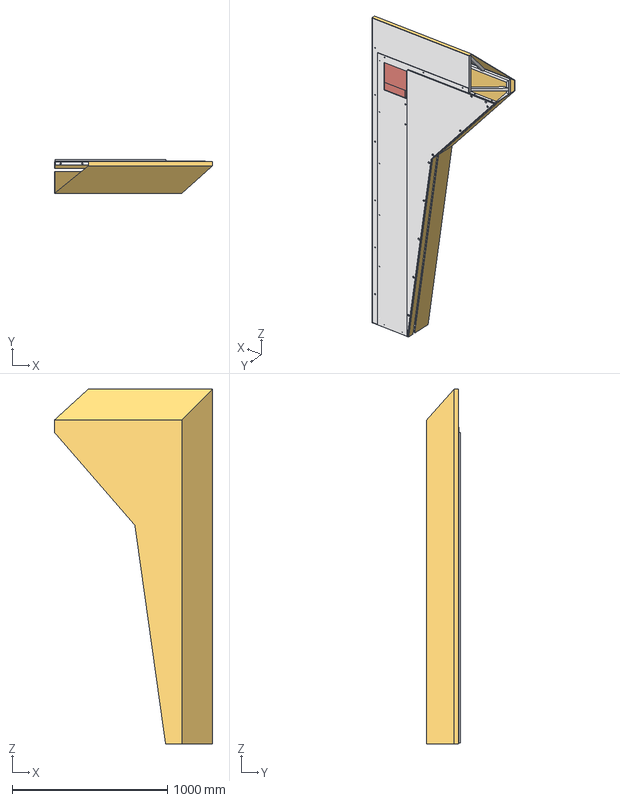
[picture p55: CAD file, 2026-11-02]
v2/03-Manufacturing/front/350003_P01_FRONT-DECOR-BLOCK-ASSY-DR_STEP.step
1020.0 x 217.9 x 2290.0 mm
