autonomous-ai/spaceship/v2/03-Manufacturing/wall/210201_P01_WALL-PANEL-ASSY-BACK-LOWER-B1_STEP.step

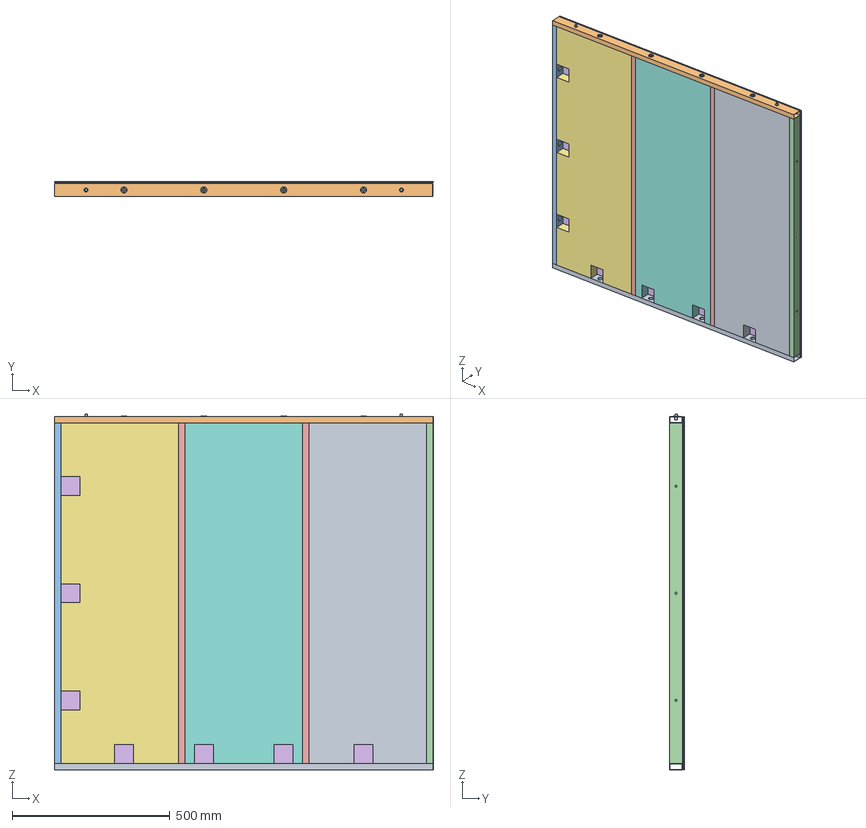
[picture p57: CAD file, 2026-11-01]
v2/03-Manufacturing/wall/210201_P01_WALL-PANEL-ASSY-BACK-LOWER-B1_STEP.step
1200.6 x 46.0 x 1126.6 mm
