autonomous-ai/spaceship/v2/03-Manufacturing/wall/210104_P01_WALL-PANEL-ASSY-SIDE-UPPER-RH_STEP.step

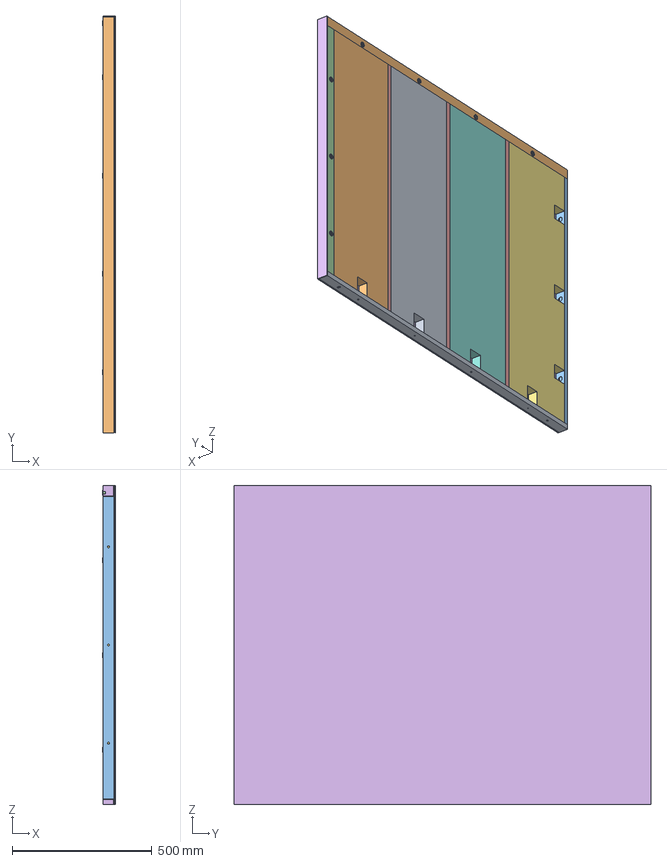
[picture p58: CAD file, 2026-10-31]
v2/03-Manufacturing/wall/210104_P01_WALL-PANEL-ASSY-SIDE-UPPER-RH_STEP.step
48.3 x 1492.7 x 1142.7 mm
