autonomous-ai/spaceship/v2/03-Manufacturing/wall/210102_P01_WALL-PANEL-ASSY-SIDE-LOWER-RH_STEP.step

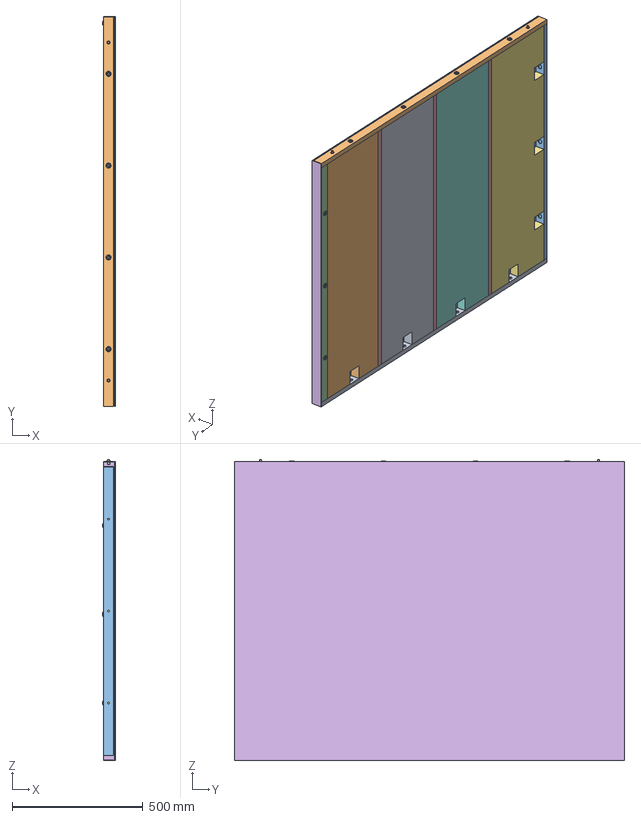
[picture p59: CAD file, 2026-10-31]
v2/03-Manufacturing/wall/210102_P01_WALL-PANEL-ASSY-SIDE-LOWER-RH_STEP.step
48.3 x 1492.7 x 1150.7 mm
