autonomous-ai/spaceship/tools/checks/tests/fixtures/bolt-joints.step

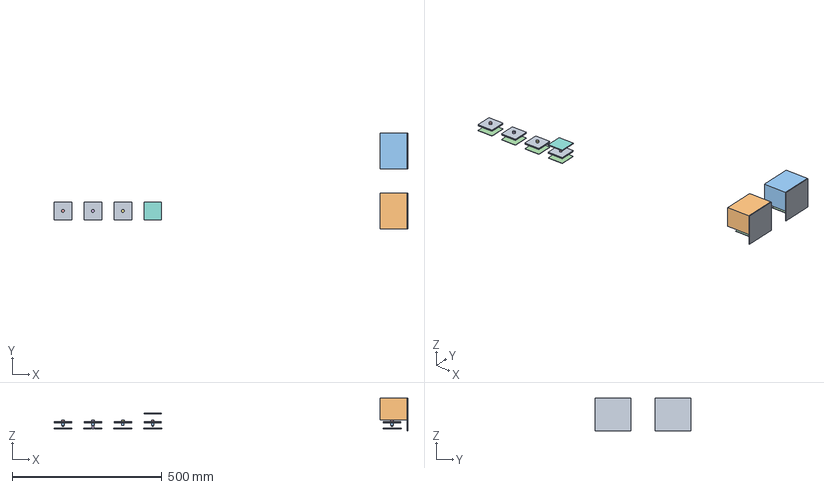
[picture p60: CAD file, 2026-10-31]
tools/checks/tests/fixtures/bolt-joints.step
1183.0 x 320.0 x 110.0 mm
