autonomous-ai/spaceship/v2/03-Manufacturing/air/611703_P01_AIR-RISER-TRANSITION-CHEEK_STEP.step

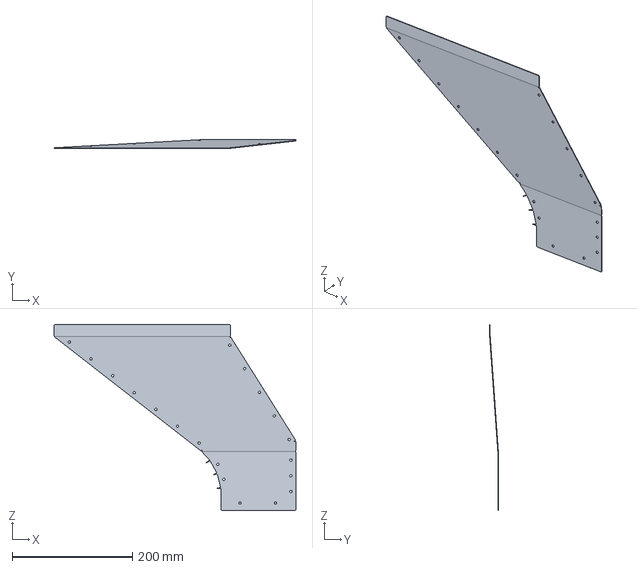
[picture p61: CAD file, 2026-11-02]
v2/03-Manufacturing/air/611703_P01_AIR-RISER-TRANSITION-CHEEK_STEP.step
402.0 x 14.5 x 309.0 mm
