autonomous-ai/spaceship/v2/03-Manufacturing/base/111101_P01_BASE-BAND-TUBE-SIDE-LH_STEP.step

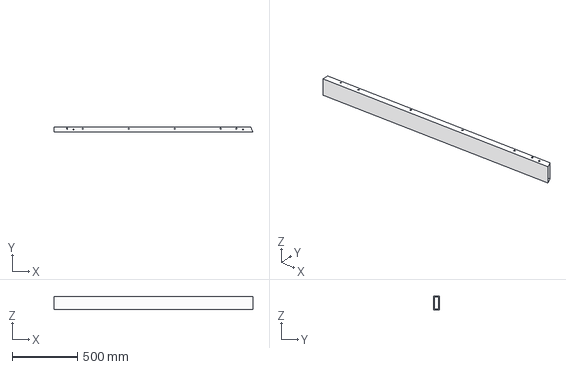
[picture p62: CAD file, 2026-11-01]
v2/03-Manufacturing/base/111101_P01_BASE-BAND-TUBE-SIDE-LH_STEP.step
1520.0 x 40.0 x 100.0 mm
