autonomous-ai/spaceship/v2/03-Manufacturing/ceiling/513102_P01_LINING-RIB-CEILING_DXF.dxf

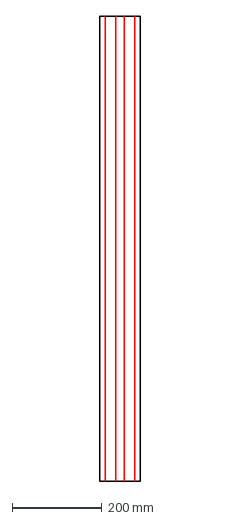
[picture p63: CAD file, 2026-11-02]
v2/03-Manufacturing/ceiling/513102_P01_LINING-RIB-CEILING_DXF.dxf
89.5 x 1034.0 mm
