autonomous-ai/spaceship/v2/03-Manufacturing/electrical/711001_P01_ELECTRICAL-POWER-UNIT-ENCLOSURE-BODY_DXF.dxf

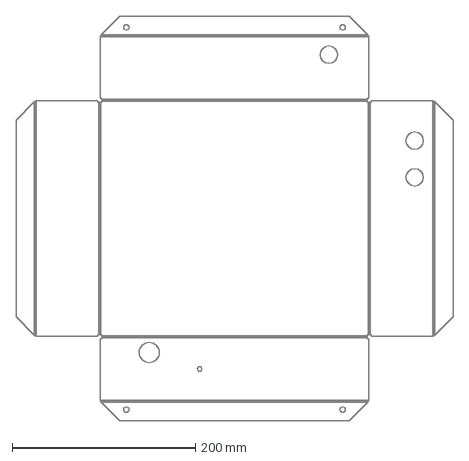
[picture p64: CAD file, 2026-11-01]
v2/03-Manufacturing/electrical/711001_P01_ELECTRICAL-POWER-UNIT-ENCLOSURE-BODY_DXF.dxf
477.0 x 441.0 mm
