autonomous-ai/spaceship/v2/03-Manufacturing/front/351304_P01_FRONT-DECOR-INNER-PANEL-FELT-DR_DXF.dxf

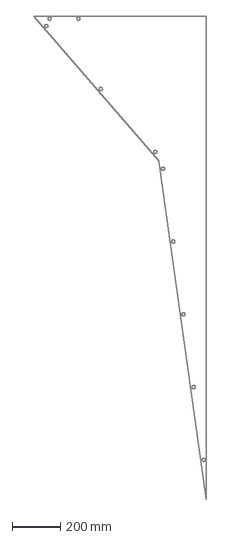
[picture p65: CAD file, 2026-11-02]
v2/03-Manufacturing/front/351304_P01_FRONT-DECOR-INNER-PANEL-FELT-DR_DXF.dxf
715.0 x 2003.5 mm
