autonomous-ai/spaceship/(list of files, cad)

Other CAD files:
v2/03-Manufacturing/wall/210103_P01_WALL-PANEL-ASSY-SIDE-UPPER-LH_STEP.step
v2/03-Manufacturing/wall/210101_P01_WALL-PANEL-ASSY-SIDE-LOWER-LH_STEP.step
v2/01-CAD-Native/air/610000_P01_AIR_CAD.f3d
v2/01-CAD-Native/base/110000_P01_BASE_CAD.f3d
v2/01-CAD-Native/base/111101_P01_BASE-BAND-TUBE-SIDE-LH_CAD.f3d
v2/01-CAD-Native/base/111102_P01_BASE-BAND-TUBE-SIDE-RH_CAD.f3d
v2/01-CAD-Native/base/111103_P01_BASE-BAND-TUBE-BACK_CAD.f3d
v2/01-CAD-Native/base/111106_P01_BASE-BAND-TUBE-FRONT-FIXED-GLASS_CAD.f3d
v2/01-CAD-Native/base/111301_P01_BASE-SILL-FIXED-GLASS_CAD.f3d
v2/01-CAD-Native/base/111601_P01_BASE-GLIDE-DOUBLER-COMMON_CAD.f3d
v2/01-CAD-Native/ceiling/410000_P01_CEILING_CAD.f3d
v2/01-CAD-Native/electrical/710000_P01_ELECTRICAL_CAD.f3d
v2/01-CAD-Native/electrical/711001_P01_ELECTRICAL-POWER-UNIT-ENCLOSURE-BODY_CAD.f3d
v2/01-CAD-Native/electrical/711002_P01_ELECTRICAL-POWER-UNIT-FRONT-PLATE_CAD.f3d
v2/01-CAD-Native/electrical/711005_P01_ELECTRICAL-HUB-ZONE-COVER-PLATE_CAD.f3d
v2/01-CAD-Native/front/350001_P01_FRONT-DECOR-BLOCK-ASSY-DL_CAD.f3d
v2/01-CAD-Native/front/350002_P01_FRONT-DECOR-BLOCK-ASSY-DT_CAD.f3d
v2/01-CAD-Native/front/350003_P01_FRONT-DECOR-BLOCK-ASSY-DR_CAD.f3d
v2/01-CAD-Native/front/360001_P01_FRONT-DOOR-UNIT_CAD.f3d
v2/01-CAD-Native/front/360002_P01_FRONT-FIXED-GLASS-UNIT_CAD.f3d
v2/01-CAD-Native/interior/810000_P01_INTERIOR_CAD.f3d
v2/01-CAD-Native/joints/111211_P01_BASE-CORNER-KEY-TABULATED_CAD.f3d
v2/01-CAD-Native/joints/831001_P01_HARDWARE-LOCATING-SPIGOT_CAD.f3d
v2/01-CAD-Native/joints/831002_P01_HARDWARE-STOP-WASHER_CAD.f3d
v2/01-CAD-Native/joints/831007_P01_HARDWARE-MITRE-PLATE-TABULATED_CAD.f3d
v2/01-CAD-Native/proof/V2-SWL-00_P01_WALL-PANEL-ASSY-SIDE-LOWER-LH_CAD.f3d
v2/01-CAD-Native/skeleton/100000_P04_POD-SKELETON_CAD.f3d
v2/01-CAD-Native/wall/210101_P01_WALL-PANEL-ASSY-SIDE-LOWER-LH_CAD.f3d
v2/01-CAD-Native/wall/210102_P01_WALL-PANEL-ASSY-SIDE-LOWER-RH_CAD.f3d
v2/01-CAD-Native/wall/210103_P01_WALL-PANEL-ASSY-SIDE-UPPER-LH_CAD.f3d
v2/01-CAD-Native/wall/210104_P01_WALL-PANEL-ASSY-SIDE-UPPER-RH_CAD.f3d
v2/01-CAD-Native/wall/210201_P01_WALL-PANEL-ASSY-BACK-LOWER-B1_CAD.f3d
v2/01-CAD-Native/wall/210202_P01_WALL-PANEL-ASSY-BACK-LOWER-B2_CAD.f3d
v2/01-CAD-Native/wall/211101_P01_WALL-PANEL-FRAME-SIDE-LOWER-LH_CAD.f3d
v2/01-CAD-Native/wall/211102_P01_WALL-PANEL-FRAME-SIDE-LOWER-RH_CAD.f3d
v2/01-CAD-Native/wall/211103_P01_WALL-PANEL-FRAME-SIDE-UPPER-LH_CAD.f3d
v2/01-CAD-Native/wall/211104_P01_WALL-PANEL-FRAME-SIDE-UPPER-RH_CAD.f3d
v2/01-CAD-Native/wall/211201_P01_WALL-PANEL-FRAME-BACK-LOWER-B1_CAD.f3d
v2/01-CAD-Native/wall/211301_P01_WALL-SKIN-SIDE-LOWER-LH_CAD.f3d
v2/01-CAD-Native/wall/211401_P01_WALL-SKIN-BACK-LOWER-B1_CAD.f3d
v2/01-CAD-Native/wall/211501_P01_WALL-CAVITY-FILL-SIDE-LOWER-LH_CAD.f3d
v2/01-CAD-Native/wall/211601_P01_WALL-CAVITY-FILL-BACK-LOWER-B1_CAD.f3d
v2/01-CAD-Native/wall/510101_P01_LINING-CASSETTE-SIDE-LOWER-LH_CAD.f3d
v2/01-CAD-Native/wall/510102_P01_LINING-CASSETTE-SIDE-LOWER-RH_CAD.f3d
v2/01-CAD-Native/wall/510103_P01_LINING-CASSETTE-SIDE-UPPER-LH_CAD.f3d
v2/01-CAD-Native/wall/510104_P01_LINING-CASSETTE-SIDE-UPPER-RH_CAD.f3d
v2/01-CAD-Native/wall/510201_P01_LINING-CASSETTE-BACK-LOWER-B1_CAD.f3d
v2/01-CAD-Native/wall/510202_P01_LINING-CASSETTE-BACK-LOWER-B2_CAD.f3d
v2/01-CAD-Native/wall/511101_P01_LINING-TRAY-SIDE-LOWER-LH_CAD.f3d
v2/01-CAD-Native/wall/511201_P01_LINING-TRAY-BACK-LOWER-B1_CAD.f3d
v2/03-Manufacturing/air/610000_P01_AIR_STEP.step
v2/03-Manufacturing/air/610403_P01_AIR-RISER-TRANSITION_STEP.step
v2/03-Manufacturing/air/610404_P01_AIR-SUPPLY-TRANSITION_STEP.step
v2/03-Manufacturing/air/611101_P01_AIR-COLUMN-FACE-FRONT_DXF.dxf
v2/03-Manufacturing/air/611102_P01_AIR-COLUMN-FACE-LEFT_DXF.dxf
v2/03-Manufacturing/air/611105_P01_AIR-KICK-GRILLE-FRONT_DXF.dxf
v2/03-Manufacturing/air/611106_P01_AIR-COLUMN-FOOT-PLATE_DXF.dxf
v2/03-Manufacturing/air/611107_P01_AIR-COLUMN-PLENUM-SIDE-PLATE-LOW_DXF.dxf
v2/03-Manufacturing/air/611108_P01_AIR-COLUMN-PLENUM-SIDE-PLATE-HIGH_DXF.dxf
v2/03-Manufacturing/air/611111_P01_AIR-KICK-GRILLE-LEFT_DXF.dxf
v2/03-Manufacturing/air/611201_P01_AIR-SOFFIT-UNDERSIDE-LEFT-HINGED_DXF.dxf
v2/03-Manufacturing/air/611202_P01_AIR-SOFFIT-FACE-FRONT_DXF.dxf
v2/03-Manufacturing/air/611204_P01_AIR-EXHAUST-GRILLE_DXF.dxf
v2/03-Manufacturing/air/611205_P01_AIR-SOFFIT-TOP-RAIL-DOOR-SIDE_DXF.dxf
v2/03-Manufacturing/air/611206_P01_AIR-SOFFIT-END-PLATE-LEFT_DXF.dxf
v2/03-Manufacturing/air/611207_P01_AIR-SOFFIT-UNDERSIDE-RIGHT-HINGED_DXF.dxf
v2/03-Manufacturing/air/611208_P01_AIR-SOFFIT-UNDERSIDE-FIXED-OVER-THE-COLUMN_DXF.dxf
v2/03-Manufacturing/air/611209_P01_AIR-SOFFIT-TOP-RAIL-ROOM-SIDE_DXF.dxf
v2/03-Manufacturing/air/611210_P01_AIR-SOFFIT-DOOR-SIDE-PLATE_DXF.dxf
v2/03-Manufacturing/air/611403_P01_AIR-FAN-BOX-BULKHEAD-EXHAUST_DXF.dxf
v2/03-Manufacturing/air/611404_P01_AIR-FAN-BOX-BULKHEAD-SUPPLY_DXF.dxf
v2/03-Manufacturing/air/611602_P01_AIR-ROOF-GRILLE_DXF.dxf
v2/03-Manufacturing/air/611701_P01_AIR-RISER-TRANSITION-LEFT-WRAPPER_DXF.dxf
v2/03-Manufacturing/air/611701_P01_AIR-RISER-TRANSITION-LEFT-WRAPPER_STEP.step
v2/03-Manufacturing/air/611702_P01_AIR-RISER-TRANSITION-RIGHT-WRAPPER_DXF.dxf
v2/03-Manufacturing/air/611702_P01_AIR-RISER-TRANSITION-RIGHT-WRAPPER_STEP.step
v2/03-Manufacturing/air/611703_P01_AIR-RISER-TRANSITION-CHEEK_DXF.dxf
v2/03-Manufacturing/air/611801_P01_AIR-SUPPLY-TRANSITION-SHELL_DXF.dxf
v2/03-Manufacturing/air/611801_P01_AIR-SUPPLY-TRANSITION-SHELL_STEP.step
v2/03-Manufacturing/air/611802_P01_AIR-SUPPLY-TRANSITION-FLOOR_DXF.dxf
v2/03-Manufacturing/air/611802_P01_AIR-SUPPLY-TRANSITION-FLOOR_STEP.step
v2/03-Manufacturing/air/611803_P01_AIR-SUPPLY-TRANSITION-VANE-OVER-THE-BOX_DXF.dxf
v2/03-Manufacturing/air/611803_P01_AIR-SUPPLY-TRANSITION-VANE-OVER-THE-BOX_STEP.step
v2/03-Manufacturing/air/611804_P01_AIR-SUPPLY-TRANSITION-VANE-BESIDE-THE-BOX_DXF.dxf
v2/03-Manufacturing/air/611804_P01_AIR-SUPPLY-TRANSITION-VANE-BESIDE-THE-BOX_STEP.step
v2/03-Manufacturing/base/110000_P01_BASE_STEP.step
v2/03-Manufacturing/base/111102_P01_BASE-BAND-TUBE-SIDE-RH_STEP.step
v2/03-Manufacturing/base/111103_P01_BASE-BAND-TUBE-BACK_STEP.step
v2/03-Manufacturing/base/111106_P01_BASE-BAND-TUBE-FRONT-FIXED-GLASS_STEP.step
v2/03-Manufacturing/base/111301_P01_BASE-SILL-FIXED-GLASS_DXF.dxf
v2/03-Manufacturing/base/111301_P01_BASE-SILL-FIXED-GLASS_STEP.step
v2/03-Manufacturing/base/111401_P01_BASE-FLOOR-PANEL-F1_DXF.dxf
v2/03-Manufacturing/base/111501_P01_BASE-FLOOR-MAT-F1-CLOSED-CELL-3-MM-FOAM_DXF.dxf
v2/03-Manufacturing/base/111601_P01_BASE-GLIDE-DOUBLER-COMMON_DXF.dxf
v2/03-Manufacturing/base/111601_P01_BASE-GLIDE-DOUBLER-COMMON_STEP.step
v2/03-Manufacturing/ceiling/410000_P01_CEILING_STEP.step
v2/03-Manufacturing/ceiling/411301_P01_CEILING-SKIN-C1_DXF.dxf
v2/03-Manufacturing/ceiling/411302_P01_CEILING-SKIN-C2_DXF.dxf
v2/03-Manufacturing/ceiling/513101_P01_LINING-TRAY-CEILING_DXF.dxf
v2/03-Manufacturing/ceiling/513201_P01_LINING-FELT-CEILING_DXF.dxf
v2/03-Manufacturing/ceiling/513301_P01_LINING-FILL-CEILING-BAY-A_DXF.dxf
v2/03-Manufacturing/ceiling/513302_P01_LINING-FILL-CEILING-BAY-B_DXF.dxf
v2/03-Manufacturing/ceiling/513303_P01_LINING-FILL-CEILING-BAY-C_DXF.dxf
v2/03-Manufacturing/electrical/710000_P01_ELECTRICAL_STEP.step
v2/03-Manufacturing/electrical/711001_P01_ELECTRICAL-POWER-UNIT-ENCLOSURE-BODY_STEP.step
v2/03-Manufacturing/electrical/711002_P01_ELECTRICAL-POWER-UNIT-FRONT-PLATE_DXF.dxf
v2/03-Manufacturing/electrical/711002_P01_ELECTRICAL-POWER-UNIT-FRONT-PLATE_STEP.step
v2/03-Manufacturing/electrical/711005_P01_ELECTRICAL-HUB-ZONE-COVER-PLATE_DXF.dxf
v2/03-Manufacturing/electrical/711005_P01_ELECTRICAL-HUB-ZONE-COVER-PLATE_STEP.step
v2/03-Manufacturing/front/351101_P01_FRONT-DECOR-SKIN-DL_DXF.dxf
v2/03-Manufacturing/front/351102_P01_FRONT-DECOR-BACK-PLATE-DL_DXF.dxf
v2/03-Manufacturing/front/351201_P01_FRONT-DECOR-SKIN-DT_DXF.dxf
v2/03-Manufacturing/front/351202_P01_FRONT-DECOR-BACK-PLATE-DT_DXF.dxf
v2/03-Manufacturing/front/351301_P01_FRONT-DECOR-SKIN-DR_DXF.dxf
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
