autonomous-ai/spaceship/v2/02-Drawings/30-Assembly-Instructions/100000_P04_POD-INSTALL-SHEET_INS.md

<!-- 100000_P04_POD-INSTALL-SHEET_INS.md is generated by v2/07-Packaging/pack.py from v2/07-Packaging/templates/install-sheet.md. Edit the template or the script, never the generated file. -->
# Install sheet: what the room needs for Spaceship (FocusPod v2)

| Doc code | Part number | Revision | Status | Date | Owner |
|---|---|---|---|---|---|
| V2-INS-002 (PROPOSED) | 100000 POD · Pod hoàn chỉnh | P04 | DRAFT, first issue | 2026-11-01 | Packing and Assembly Engineer |

The site's half of interface IF-17 (POD to room: floor, power, the air's clear space, later the sprinkler). It goes to whoever prepares the room, before the pallets arrive. Every number carries its status; the open items at the end say who settles the rest. The assembly guide's section 1 points here.

## Result

1. **Clear height: at least 2550 mm** from the floor to anything above the pod (ceiling, lights, sprinklers, ducts). The pod is 2400 mm tall (D-21); the roof work in guide step 17 needs 150 mm above its roof (assumption). The air's own need above the roof slot is still to be set (ISS-049).
2. **Floor: flat and level enough that the high and low points under the pod's 9 glides lie within 6.5 mm of each other** (calculation: the glides run from 8.5 mm, the lowest setting the PM allows, to 15 mm, ISS-054's working range). The pod has no floor of its own (D-132): people stand on the room floor, so it should also be a finished, hard floor.
3. **Power: one 120 V, 60 Hz wall outlet (NEMA 5-15, 15 A)** within reach of the pod's cord (D-133). The pod draws 132 W at most on its 12 V side (ELECTRICAL's load table, the voice kit's 60 W hook included), so an ordinary outlet will do. In Vietnam the prototype runs through a 220-to-110 V step-down transformer (D-133).
4. **Air: keep clear above the roof slot and in front of the intake under DR.** The pod breathes out through a slot in its roof near the front right corner and in through the mesh in the base band under the right decor block (D-61, D-62). AIR sets the minimum gaps (ISS-049); until then keep at least the 150 mm above the roof that assembly needs, and nothing standing against the base band under DR.
5. **Getting it in:** every door on the way at least 810 × 2032 mm (REQ-ASM-06). **An elevator needs a door at least 1070 mm wide (a 48 in door; a 42 in one is 3 mm short with DR in its wrap) and 2134 mm (84 in) tall, and a car at least 2032 × 1295 mm inside and 2286 mm (90 in) tall** (calculation, check K15): DR goes in with its 1030 mm face across the door and leans up into the car, and the long parts lean in the same way. A typical passenger car with a 914 mm (36 in) door can't take DR (2-03, 2300 × 1030 × 216 mm as carried): use a freight or service elevator, or the stairs, for that. Open the glass crate at the building's entrance; each pane goes in upright on its suction lifters.

## 1. Delivery

| Pallet | Deck | Loaded height | Gross |
|---|---|---|---|
| 1 | 48 × 40 in (1219 × 1016 mm) | 1,641 mm | 217 kg |
| 2 | 96 × 48 in (2438 × 1219 mm) | 1,595 mm | 327 kg |

- A pallet jack and a route for a 2438 mm long pallet to the room, or unpacking at the door: every piece passes an 810 mm wide, 2032 mm high doorway (REQ-ASM-06). The longest piece is BASE - BAND ASSY - BACK (2-04), 2420 mm, so corridors need room to turn it.
- An elevator: a door at least 1070 × 2134 mm and a car at least 2032 × 1295 mm inside and 2286 mm tall, or a freight elevator (check K15: each piece as carried, in its wrap, leaned into the car with its lower end sliding on the floor; the panes out of the crate on their lifters). A typical passenger car with a 914 mm door can't take DR (2-03, 2300 × 1030 × 216 mm as carried).
- The pallets' wood is heat-treated and ISPM 15 stamped (the packing plan), so they clear US ports.
- The glass travels in a crate at the bottom of pallet 2: the door unit 48.6 kg and the fixed glass 28.7 kg, each moved by two people with two suction lifters. Every other piece is 20 kg or less (D-03).
- Both pallets are marked DO NOT STACK.

## 2. The room

| Need | Value | Status and source |
|---|---|---|
| Clear height, floor to the lowest thing above the pod | 2550 mm or more | calculation: the pod's 2400 (D-21) + 150 for the roof sleeve and the grille's 4 bolts (step 17, J-AIR-03; assumption) |
| Height DT and the ceiling halves need as they go on | 2420 mm | calculation: lifted 20 mm over their 8 mm spigots (assumption; J-FRONT-03, J-CEIL-01) |
| Footprint | 2500 × 1700 mm | decided (D-01) |
| Clear round the footprint while it goes together | 1 m a side, so about 4500 × 3700 mm | assumption: the parts set down at their places in step 1, and the step stools |
| Floor: high and low points under the 9 glides | within 6.5 mm | calculation: glides 8.5 (PM ruling on F-018) to 15 mm (ISS-054, PROPOSED) |
| Floor finish | hard and finished: it is the pod's floor (D-132) | decided |
| Wall outlet | 120 V, 60 Hz, NEMA 5-15, 15 A, within reach of the pod's cord | decided (D-133); the cord's length and the inlet's place come from ELECTRICAL |
| Power the pod draws | 132 W at most at 12 V | calculation (ELECTRICAL's load table) |
| Roof slot, the exhaust out | X 832 to 1172, Y -635 to -253 (AIR 610000 P01 STEP, the roof sleeve) | calculation (CAD) |
| Clear space above the roof slot | AIR to set; 150 mm meanwhile | open (ISS-049) |
| Intake, the mesh in the base band under DR | keep clear in front; AIR to set the gap | open (ISS-049) |

## 3. Open items

| ID | What | Owner | Status |
|---|---|---|---|
| IS-01 | The air's minimum clear space above the roof slot and in front of the intake (ISS-049). | AIR (Hardware Engineer, air) | open |
| IS-02 | The floor tolerance to design for, against a floor standard, and the glides' real range once the product is named (ISS-054; glide HOLD). | BASE | PROPOSED |
| IS-03 | The cord's length and the inlet's place for the 120 V side (D-133), so the outlet's distance can be written here. | ELECTRICAL | open |
| IS-04 | The roof work's 150 mm and the spigot lift's 20 mm are this sheet's assumptions until the prototype is built (REQ-ASM-01's timed trial). | Packing | assumption |
| IS-05 | A sprinkler or alarm opening in the roof comes later with the US certification work (ISS-052, D-134). | CEILING | later |
