autonomous-ai/spaceship/v2/02-Drawings/00-General-Assembly/DRAWING-RECORD.md

# General assembly: drawing record

GA sheet 1, the whole pod 100000, comes from the drawing generator (D-158, D-171): `100000_<rev>_POD-SPACESHIP_DWG.pdf`, drawn by `tools/drawgen/pod_assembly.py` from every team STEP, the master BOM, the skeleton STEP and the weight roll-up, with sections A-A, B-B and C-C (PR #377, merged 2026-11-01). It is drawn again at checkpoints (PM ruling 2026-11-01): after FRONT's #313 and AIR's #378 merge, then just before release.

## Superseded Fusion files (D-141: renamed, never deleted)

The Fusion GA drawings and section designs from before D-171 are not used. They were renamed in Fusion (Default Project / FocusPod v2) on 2026-11-01, in one held queue session, 17:28 to 17:30 UTC. Each rename was checked in the folder listing afterwards. PR #366, which held their sheets, was closed as superseded by D-171.

| Was | Version | Now |
|---|---|---|
| `100000_P04_POD-GENERAL-ASSEMBLY-R2_DWG` | 1 (saved empty, never drawn) | `100000_P04_POD-GENERAL-ASSEMBLY-R2_DWG_SUPERSEDED-2026-11-01` |
| `100000_P04_POD-SECTION-AA_DWG` | 2 | `100000_P04_POD-SECTION-AA_DWG_SUPERSEDED-2026-11-01` |
| `100000_P04_POD-SECTION-BB-R2_DWG` | 2 | `100000_P04_POD-SECTION-BB-R2_DWG_SUPERSEDED-2026-11-01` |
| `100000_P04_POD-SECTION-AA_CAD` | 4 | `100000_P04_POD-SECTION-AA_CAD_SUPERSEDED-2026-11-01` |
| `100000_P04_POD-SECTION-BB_CAD` | 3 | `100000_P04_POD-SECTION-BB_CAD_SUPERSEDED-2026-11-01` |

Renamed earlier the same day (D-141), before the GA moved to the generator: `100000_P04_POD-GENERAL-ASSEMBLY_DWG` (version 3) to `..._SUPERSEDED-2026-11-01`, and `100000_P04_POD-SECTION-BB_DWG` (version 2) to `..._SUPERSEDED-2026-11-01`.
