autonomous-ai/spaceship/v2/01-CAD-Native/front/BUILD-RECORD.md

# Build record: FRONT

## 360001 FRONT - DOOR UNIT, P01 (DRAFT)

Rebuilt 2026-10-31 21:17 UTC in one lock hold (the cloud copy is the version this run saved) with the glass rebuild and the four part-only designs: the hardware's CAD names are the joints register's (D-99), and the strike is named FRONT - DOOR STRIKE - ENVELOPE, a stand-in for the product (D-104), so its expected overlap with the leaf is no clash (F-103). Same geometry and results as the run below: clash pairs 4, all expected; leaf 43.854 kg, unit 48.59 kg; STEP re-read 0.000 mm; edit test PASS (31 anchors). The parts list is in the process and finish columns, same values.

Run 2026-10-31 18:5x UTC on Mac 1, Fusion 2706.1.17, through the shared lock, one run per design (PM fair-share rule): build, save, export, pictures and the edit test in one run, on skeleton P04 updated in place (v4, #94):

```sh
python3 tools/fusion/run_script.py v2/01-CAD-Native/front/door_unit.py --doc 360001_P01_FRONT-DOOR-UNIT_CAD \
    --arg step=all --arg "desc=P01 on skeleton v4 (#94): pull height on the floor mat" \
    --arg "edits=pod_w=2600 mm;fr_dz=12 mm;door_xbr=1474 mm" --close
python3 tools/fusion/step_check.py v2/03-Manufacturing/front/360001_P01_FRONT-DOOR-UNIT_STEP.step \
    --expect=-1132,-773.38,20,216.0196,-624.62,2115.5
```

Cloud copy: Default Project / FocusPod v2 / `360001_P01_FRONT-DOOR-UNIT_CAD`, the version this run saved (the exports come from it).

### Result

- skeleton parameters: `100000_P04_POD-SKELETON-PARAMETERS.csv` (P04 v4), 89 loaded
- bodies 11, timeline 36 items, unhealthy 0, loose sketches 0, parameters 152
- clash pairs 4, all listed (the HOLD hinge spaces and the strike wrap the glass where the hardware clamps it): H1, H2, H3 with the leaf, 105,120 mm³ each; the strike with the leaf, 11,949 mm³
- unit box X -1132 to 216.02, Y -773.38 to -624.62, Z 20 to 2115.5 (it includes the HOLD spaces)
- STEP: length unit cm, declared in the file (D-13); `step_check.py` box MATCH against the box computed from the parameters (largest difference 0.0000 mm); re-read in Fusion, box equal to the model's (0.000 mm)
- f3d 245,735 bytes; STEP 121,456 bytes; no names in the exports (f3d entries, STEP, CSV, DXF, pictures scanned)
- edit test PASS (`EDIT-TEST-RECORD.md`)
- pictures checked by eye: `360001_P01_FRONT-DOOR-UNIT-FRONT_IMG.png` (front, from outside), `...-ISO_IMG.png`: leaf, black kick strip, three hinge spaces on the hinge edge, the strike at the top latch corner, the pull spaces, the seal half along the latch edge
- parts list: after the run, its bought rows were re-written under the joints register's names with maker and SKU columns (the door script now does this itself); every other field is the run's, checked field by field

DXF: leaf (front view, X from the hinge edge, Y from the leaf's bottom) (0, 0), (1175, 0), (1175, 25), (893.28, 2034), (0, 2034); kick strip section 20 × 85 with the 12 × 27 pocket over the 12 × 55 cavity and its two 2 mm chambers (D-85).

| Body | Size X × Y × Z (mm) | Box (mm) |
|---|---|---|
| DOOR LEAF GLASS 4+4 | 1175 × 8.76 × 2034 | -961, -703.38, 80 → 214, -694.62, 2114 |
| KICK STRIP (hollow, D-85) | 1175 × 20 × 85 | -961, -709, 20 → 214, -689, 105 |
| GLAZING U-SEAL | 1175 × 12 × 27 | -961, -705, 78 → 214, -693, 105 |
| DROP SEAL ENVELOPE | 1175 × 11.6 × 40 | -961, -704.6, 20 → 214, -693, 60 |
| HOLD HINGE SPACE H1, H2, H3 | 271 × 40 × 120 each | X -1132 → -861; Z centres 355, 1109.5, 1864 |
| CATCH STRIKE HT-MSG62-U10 | 62 × 14.1 × 23.5 | -154.72, -706.05, 2092 → -92.72, -691.95, 2115.5 |
| 180 MAGNETIC SEAL - DOOR HALF | 283.74 × 11.76 × 2009 | -67.72, -704.88, 105 → 216.02, -693.12, 2114 |
| HOLD PULL SPACE, outside and pod side | 40 × 70 × 360 each | X -65.02 → -25.02, Z 879 → 1239 |

### Mass (calculation)

| Item | kg | Status |
|---|---|---|
| 361001 leaf, 8.76 mm × 2376 kg/m³ | 43.85 | calculation (CAD); laminate density from 8 mm glass at 2500 and 0.76 mm PVB at 1070 kg/m³ |
| 361002 kick strip, hollow (D-85) | 1.22 | calculation (CAD, 2700 kg/m³) |
| 368002 U-seal | 0.15 | calculation (CAD, 1200 kg/m³ assumption) |
| 368001 drop seal | 0.60 | assumption (D-56) |
| 368101 hinges, 3 × 0.6 | 1.80 | assumption (D-56) |
| 368102 strike | 0.02 | source (Sugatsune datasheet, 22.9 g) |
| 368006 magnetic seal, the door's half | 0.15 | assumption, HOLD product |
| 368103 pull pair | 0.80 | assumption (D-56) |
| **Door unit** | **48.59** | calculation |

The hinge set's rating stays at least 60 kg (PM ruling 2026-10-31: the unit plus a margin).

### Interfaces to other assemblies

| With | What | Status |
|---|---|---|
| BASE (threshold) | The drop seal closes on the threshold top (`thresh_h`, Z 13); the strip's bottom runs 7 above it (Z 20) | decided gap; threshold detail is BASE's |
| BASE (band at the hinge side) | The drop seal's release button sits at the strip's hinge end (X -961) and needs a strike on the jamb below DL | HOLD: athmer's button drawing; position for BASE |
| BASE (sill under the fixed glass) | The strip's latch end is square at X 214, about 4 mm from the fixed glass's bottom channel | BASE's sill ends clear of it |
| DL | The hinge spaces reach 160 mm into DL's pockets (to X -1132), at the three heights; the hinges' frame halves ship fitted in DL | HOLD H01 |
| DT | The strike faces DT's 35 N magnetic catch across the 6 mm gap; the top stop and seal are DT's | decided (PM ruling) |
| Fixed glass unit | The magnetic seal pair: 368006 on this leaf, 368003 on the pane | HOLD product |

## 360002 FRONT - FIXED GLASS UNIT, P01 (DRAFT)

Rebuilt 2026-10-31 21:18 UTC in the same lock hold: the magnetic seal half's CAD name is the joints register's, FRONT - 180 MAGNETIC SEAL - HALF 1 OF 2 - HOLD (D-99). Same geometry and results as the run below: clash pairs 0; gap to the door 4.00 mm square to the edge; unit 29.54 kg; STEP re-read 0.000 mm; edit test PASS (16 anchors). Parts list in the process and finish columns, same values.

Run 2026-10-31 18:3x UTC on Mac 1, Fusion 2706.1.17, through the shared lock, one run per design (PM fair-share rule): build, save, export, pictures and the edit test in one run, on skeleton P04 updated in place (v4, #94):

```sh
python3 tools/fusion/run_script.py v2/01-CAD-Native/front/fixed_glass.py --doc 360002_P01_FRONT-FIXED-GLASS-UNIT_CAD \
    --arg step=all --arg "desc=P01: bottom channel screw holes to BASE's sill (PM ruling 2026-11-01)" \
    --arg "edits=pod_w=2600 mm;fr_dz=12 mm;fix_xk=511 mm;door_xtr=1192 mm" --close
python3 tools/fusion/step_check.py v2/03-Manufacturing/front/360002_P01_FRONT-FIXED-GLASS-UNIT_STEP.step \
    --expect=-66.6252,-706.5,95,964.1285,-691.5,2135
```

Cloud copy: Default Project / FocusPod v2 / `360002_P01_FRONT-FIXED-GLASS-UNIT_CAD`, the version this run saved (the exports come from it).

### Result

- skeleton parameters: `100000_P04_POD-SKELETON-PARAMETERS.csv` (P04, v4); bodies 4, timeline 18 items, unhealthy 0, loose sketches 0, parameters 119
- clash pairs 0
- gap from the door's latch edge to the pane's free edge: 4.00 mm square to the edge at the band top, mid-height and the door top (4.04 mm horizontally)
- STEP: length unit cm, declared in the file (D-13); `step_check.py` box MATCH against the box computed from the parameters (largest difference 0.0000 mm); re-read in Fusion, box equal to the model's (0.000 mm)
- f3d 202,381 bytes; STEP 91,936 bytes; no names in the exports (f3d entries, STEP, CSV, DXF, pictures scanned)
- edit test PASS (`EDIT-TEST-RECORD.md`); pictures checked by eye: `360002_P01_FRONT-FIXED-GLASS-UNIT-FRONT_IMG.png` (front, from outside), `...-ISO_IMG.png`: the channel shows on the four held edges, none on the free edge

The U-profile's box is X -66.63 to 964.13, Y -706.5 to -691.5 (15 on the glass plane), Z 95 to 2135. Pane corners in its DXF (X from its leftmost point, Y from its bottom): (285.09, 0), (1026.24, 0), (826.05, 1427.46), (301.39, 2033), (0, 2033). U-profile cut lengths, base / mouth: bottom 744.7 / 729.5, right 1446.5 / 1424.8, diagonal 803.8 / 792.6, top 303.5 / 294.5; mitres 41.0°, 73.5°, 65.5°. Bottom piece: 4 holes 3.4, countersunk 90° to 7 inside, at X 269.4, 484.3, 699.2 (50 from the left end, 214.9 apart) and 905.0 (59.1 from the right end, clear of BASE's FR1 joint at X 915; PM ruling 2026-11-01, BASE's last sill rivnut moved with it).

### Mass (calculation)

| Item | kg |
|---|---|
| 361003 pane, 8.76 mm at 2376 kg/m³ | 28.59 |
| 368004 U-profile, 4 pieces | 0.56 |
| 368002 U-seal | 0.24 |
| 368003 magnetic seal, the pane's half (assumption, HOLD product) | 0.15 |
| **Fixed glass unit** | **29.54** |

### Interfaces to other assemblies

| With | What |
|---|---|
| BASE | The bottom channel sits on BASE's sill seat (top Z 95), screwed down with 4 ISO 10642 M3 × 8 A2 into flush-head M3 rivnuts in the seat, at the factory; it ships on the sill (PM rulings 2026-11-01). The pane's 28.6 kg bears on it. |
| DR | The right and diagonal channels sit inside DR behind the 17 mm slot in its inner-edge skin; no DR frame tube crosses the channel's Y range. |
| DT | The top channel sits inside DT behind the 17 mm slot in its underside; DT's catch rail stands 3.5 behind it. |
| Door unit | The free edge runs 4 mm from the door's latch edge; the magnetic seal pair (368003 here, 368006 on the door) closes it. |

Fit order (PM ruling 2026-11-01): the bottom channel comes factory-fitted on BASE's sill; on site the pane drops into it, then DR slides in from the right onto the pane's right edges, then DT is lowered onto its top edge.

## 350003 FRONT - DECOR BLOCK ASSY - DR, P01 stage 2 (DRAFT)

Run 2026-10-31 20:2x UTC on Mac 1, Fusion 2706, through the shared lock, one run per design (build, save, export, pictures and the edit test), on skeleton P04 v4:

```sh
python3 tools/fusion/run_script.py v2/01-CAD-Native/front/dr_block.py --doc 350003_P01_FRONT-DECOR-BLOCK-ASSY-DR_CAD \
    --arg step=all --arg "desc=P01 stage 2: every frame tube shelled" \
    --arg "edits=decor_d=215 mm;fix_xk=511 mm;fix_zk=1531 mm" --close
python3 tools/fusion/step_check.py v2/03-Manufacturing/front/350003_P01_FRONT-DECOR-BLOCK-ASSY-DR_STEP.step
```

### Result

- bodies 38, timeline 146 items, unhealthy 0, loose sketches 0, parameters 181; clash pairs 0 (frame against skin, plates, panels, air parts and the glass channel)
- frame 351306: 26 tubes of 20 × 20 × 1.5 (80 × 20 at the bolt line, 40 and 60 × 20 at the bottom and the band), every tube shelled with its ends open (0 failed), 5.72 kg, 15.05 m of tube (cut list `351306_P01_FRONT-DECOR-FRAME-DR-TUBE-CUT-LIST.csv`)
- air intake past the frame: base opening 0.0422 m² gross, 0.0129 m² under the frame's bottom tubes, 0.0293 m² free (rule: 0.028 or more, PM ruling)
- flat parts (D-89 part 4, DXF 1:1 in mm, layer CUT): back plate 351302 798.0 × 2284.0 with 6 holes; access panel 351305 255.4 × 2042.0 with 12 holes (7.0 for M6, and the column's two hook studs at X 971, Z 1700 and 1850); inner panel 351303 715.0 × 2038.5
- felt 351304: same outline as the inner panel (stepped and slanted), so it keeps a drawing (D-89); its DXF is for the cutter
- STEP: length unit cm, declared in the file (D-13); box X 230 to 1250, Y -850 to -635, Z 110 to 2400 (`step_check.py`), equal to the model's when re-read in Fusion (0.000 mm)
- f3d 820,702 bytes; STEP 566,889 bytes; no names in the exports (f3d entries, STEP, CSV, DXF, picture metadata scanned)
- edit test PASS (`EDIT-TEST-RECORD.md`); pictures checked by eye: `350003_P01_FRONT-DECOR-BLOCK-ASSY-DR-FRONT_IMG.png`, `...-ISO_IMG.png`

### Mass (calculation)

| Item | kg |
|---|---|
| 351301 skin, ACP 3 mm at 1300 kg/m³ | 7.71 |
| 351306 frame, 26 tubes shelled, 2700 kg/m³ | 5.72 |
| 351302 back plate | 1.51 |
| 351305 access panel | 3.87 |
| 351303 inner panel | 1.67 |
| 351304 felt, 1.8 kg/m² | 0.77 |
| 350004 and 351402 to 351405: reserved air spaces where AIR's supply fan box assembly 610401 goes (its riser, transitions, fan box and two fans: AIR's parts and mass, not counted here, PM rulings 2026-11-01) | 0 |
| **DR block** | **21.25** |

The build's parts list said 33.92 kg with the air parts in it; after the PM rulings of 2026-11-01 (every air part, the supply fans included, is an AIR number in AIR's tree, so nothing is counted twice) the air rows were re-written as reserved air spaces with no mass and the fans' row dropped, from the script's own rows (same CAD). The next DR build writes the same list, names those spaces RESERVED AIR SPACE in the CAD and has no fan bodies. At 21.25 kg DR is over the 20 kg piece limit (D-03): the weight saving is proposed in the decor drawings' pull request.

### Interfaces to other assemblies

| With | What |
|---|---|
| BASE | Stands on the band top (Z 110); the riser's open foot sits 140 mm over the base air opening. |
| Fixed glass | The right and diagonal channels sit behind the 17 mm slot in DR's inner-edge skin; no frame tube crosses the channel. |
| Air column | Hooks onto 2 studs on the access panel (X 971, Z 1700 and 1850, rivnut 838003), pushed back and dropped 10 mm onto BASE's floor spigots; the access panel is screwed to the frame to carry about 10 kg (PM ruling). |
| DT | Meets DT at X 449 under the top; joint HOLD (joints register). |

## 350002 FRONT - DECOR BLOCK ASSY - DT, P01 stage 2 (DRAFT)

Run 2026-10-31 20:2x UTC on Mac 1, Fusion 2706, through the shared lock, one run per design, on skeleton P04 v4:

```sh
python3 tools/fusion/run_script.py v2/01-CAD-Native/front/dt_block.py --doc 350002_P01_FRONT-DECOR-BLOCK-ASSY-DT_CAD \
    --arg step=all --arg "desc=P01 stage 2: welded tube frame 351204 (13 tubes); back plate corner on the slope" \
    --arg "edits=decor_d=215 mm;dt_xr=1690 mm;dl_w=283 mm" --close
python3 tools/fusion/step_check.py v2/03-Manufacturing/front/350002_P01_FRONT-DECOR-BLOCK-ASSY-DT_STEP.step
```

### Result

- bodies 18, timeline 62 items, unhealthy 0, loose sketches 0, parameters 148; clash pairs 0
- frame 351204: 13 tubes of 20 × 20 × 1.5, every tube shelled (0 failed), 2.51 kg, 8.52 m of tube (cut list `351204_P01_FRONT-DECOR-FRAME-DT-TUBE-CUT-LIST.csv`); its rail F02 carries the catch 368007 and the top stop 351203
- back plate 351202 (D-89 part 4): 1694.75 × 274.0, no holes; its corner sits on the slope so it clears the skin
- STEP: length unit cm, declared in the file (D-13); box X -1250 to 449, Y -850 to -645, Z 2094 to 2400 (`step_check.py`), equal to the model's when re-read in Fusion (0.000 mm)
- f3d 364,297 bytes; STEP 243,290 bytes; no names in the exports
- edit test PASS (`EDIT-TEST-RECORD.md`); pictures checked by eye: `350002_P01_FRONT-DECOR-BLOCK-ASSY-DT-FRONT_IMG.png`, `...-ISO_IMG.png`

### Mass (calculation)

| Item | kg |
|---|---|
| 351201 skin, ACP 3 mm at 1300 kg/m³ | 2.85 |
| 351204 frame, 13 tubes shelled | 2.51 |
| 351202 back plate | 1.66 |
| 351203 door top stop | 0.08 |
| 368005 frame-stop seal, top run 796 mm (assumption) | 0.05 |
| 368007 door catch (datasheet) | 0.05 |
| **DT block** | **7.20** |

### Interfaces to other assemblies

| With | What |
|---|---|
| Door unit | The top stop 351203 and the seal 368005 stop the leaf; the catch 368007 holds its strike 368102 (35 N). |
| Fixed glass | The top channel sits behind the 17 mm slot in DT's underside; the catch rail stands 3.5 behind it. |
| DR, DL, ceiling | Joints HOLD (joints register); DT goes on last, after the door hangs (fit order: glass, DR, DT). |

## 350001 FRONT - DECOR BLOCK ASSY - DL, P01 stage 2 (DRAFT)

Run 2026-10-31 21:1x UTC on Mac 1, Fusion 2706, through the shared lock, one run per design, on skeleton P04 v4:

```sh
python3 tools/fusion/run_script.py v2/01-CAD-Native/front/dl_block.py --doc 350001_P01_FRONT-DECOR-BLOCK-ASSY-DL_CAD \
    --arg step=all --arg "desc=P01 stage 2: welded tube frame 351104 (hinge post, bolt-line post, rings)" \
    --arg "edits=decor_d=215 mm;dl_w=283 mm;dl_y3=848 mm" --close
python3 tools/fusion/step_check.py v2/03-Manufacturing/front/350001_P01_FRONT-DECOR-BLOCK-ASSY-DL_STEP.step
```

### Result

- bodies 36, timeline 116 items, unhealthy 0, loose sketches 0, parameters 150; clash pairs 0
- frame 351104: 26 tubes of 20 × 20 × 1.5 with the 60 × 20 hinge post and bolt-line post, every tube shelled (0 failed), 4.67 kg, 11.76 m of tube (cut list `351104_P01_FRONT-DECOR-FRAME-DL-TUBE-CUT-LIST.csv`); the bolt-line post has 6 holes 14 round the J-FRONT-01 rivnut tails
- back plate 351102 (D-89 part 4): 272.0 × 2281.0, 6 holes 9.53 for the J-FRONT-01 rivnuts
- STEP: length unit cm, declared in the file (D-13); box X -1250 to -946, Y -844 to -645, Z 105 to 2397 (`step_check.py`), equal to the model's when re-read in Fusion (0.000 mm)
- f3d 591,773 bytes; STEP 457,704 bytes; no names in the exports
- edit test PASS (`EDIT-TEST-RECORD.md`); pictures checked by eye: `350001_P01_FRONT-DECOR-BLOCK-ASSY-DL-FRONT_IMG.png`, `...-ISO_IMG.png`

### Mass (calculation)

| Item | kg |
|---|---|
| 351101 skin, ACP 3 mm at 3.9 kg/m² (this build; 3.5 kg/m², the selected sheet's, from the next build) | 4.59 |
| 351104 frame, 26 tubes shelled | 4.67 |
| 351102 back plate, 2 mm aluminium | 3.15 |
| 351103 hinge-side stop, 4 lengths | 0.22 |
| 368005 frame-stop seal, hinge-side run 1589 mm (assumption) | 0.07 |
| **DL block** | **12.70** |

### Interfaces to other assemblies

| With | What |
|---|---|
| Door unit | The hinges' frame halves screw into the hinge post behind the three pockets (holes when the hinge is named, HOLD H01); the stop 351103 and the seal 368005 close the hinge side. |
| WALL | J-FRONT-01: 6 bolts from the left wall into rivnuts in the back plate on X -1224. |
| BASE, DT | J-FRONT-02 and J-FRONT-03 spigots: built into the blocks on the drawings branch (PM ruling 2026-11-01). |

## 350001 DL, 350002 DT, 350003 DR: final builds for #105 (2026-11-01, supersede the stage-2 runs above)

Rebuilt from their scripts through the shared lock, each in one run (build, save, export, pictures, edit test), with the PM rulings of 2026-11-01 applied: every air part is AIR's (DR keeps reserved air spaces only); DR under 19 kg as shipped (tube walls 1.0 / 1.2 / 1.5 by role, back plate 1.5 mm, two redundant tubes dropped, ACP at the selected sheet's 3.5 kg/m²); J-FRONT-02 and 03 (spigot holes and slots, DT's 2 mm aluminium back plate 2.26 off the ceiling with 4 rivnuts at Z 2374, DT's spigots on DR's ledge); the door stops as standard angles; the hinge-top corner butting instead of crossing; DT's underside notched and DL open at the bottom instead of skin holes near an edge (C09).

| Block | Bodies | Clashes | Frame | Unit mass (calculation) | STEP box (re-read in Fusion: 0.000 mm) | Edit test |
|---|---|---|---|---|---|---|
| DR 350003 | 34 | 0 | 24 tubes, 4.16 kg | 18.32 kg; 18.87 shipped with its right and diagonal glass channels | X 230 to 1250, Y −850 to −634.5, Z 110 to 2400 | PASS, 28 anchors |
| DT 350002 | 18 | 0 | 13 tubes, 2.76 kg | 7.84 kg | X −1250 to 449, Y −850 to −647.26, Z 2094 to 2400 | PASS, 17 anchors |
| DL 350001 | 36 | 0 | 26 tubes, 4.67 kg | 12.30 kg | X −1250 to −942, Y −844 to −645, Z 105 to 2397 | PASS, 15 anchors |

- DR's base: 0.0424 m² gross, 0.0128 m² under the frame's bottom tubes, 0.0296 m² free (0.028 or more: PM ruling).
- The FRONT combined check (door unit, fixed glass unit, DR, DT, DL imported together): 0 overlaps between sub-assemblies; gaps as ruled (door leaf to the fixed pane 4.00, leaf top to DT 6.00, seals 0 on the leaf, DR's slot 1.00 each side of the channel).
- Pictures checked by eye; no names in any export (f3d entries, STEP, CSV, DXF, picture metadata).
- D-120's five findings stay open on these builds (Lead, 2026-11-01): the three frames 351104, 351204 and 351306, DL's stop 351103 and its seal pieces 368005 are components holding several bodies. Control allocated the member numbers in #232 (DL 352101 to 352116, DT 352201 to 352211, DR 352301 to 352321; the stop's pieces 351105 to 351107, 351103 cancelled once it is split); the rebuild follows on the decor drawings branch.
- Run commands: `tools/fusion/run_script.py <late loader> --arg target=v2/01-CAD-Native/front/dX_block.py --doc 35000N_P01_FRONT-DECOR-BLOCK-ASSY-DX_CAD --arg step=all --arg edits=... --close`, the edits as in `EDIT-TEST-RECORD.md`.

## 350002 DT and 350001 DL: D-120 rebuilds (2026-11-01, supersede the #105 rows above for these two blocks)

Each frame is a weldment assembly that keeps its number, each tube its own component with Control's member number (#232); a repeat is a copy of the first tube's component, placed by a rigid joint at its shift (expressions of the parameters), proved corner for corner in every build (the COPIES line). DL's hinge-side stop 351103 is split into its pieces 351105 to 351107 (351103 cancelled) and its frame-stop seal 368005 into one component per piece. Built through the shared lock with the late-bound loader: DT on 2026-11-01 05:54 UTC (the sample), its lists re-exported at 06:17 UTC in the format below; DL at 06:18 UTC.

| Block | Bodies | Clashes | Frame | Copies | Unit mass (calculation) | STEP box (re-read in Fusion: 0.000 mm) | Edit test |
|---|---|---|---|---|---|---|---|
| DT 350002 | 18 | 0 | 13 tubes as 11 parts, 2.76 kg | 352211 three times (C01, C02, C03 at X +555.28, +984.82) | 7.84 kg | X −1250 to 449, Y −850 to −647.24, Z 2094 to 2400 | PASS, 17 anchors |
| DL 350001 | 36 | 0 | 26 tubes as 16 parts, 4.67 kg | 352105 and 352106 four times, 352109 and 352110 three times (the rings at Z +612.25, +754.5, +1366.75, +1988.75); the stop's 351106 and the seal's middle piece twice (Z +754.5) | 12.29 kg | X −1250 to −942, Y −844 to −645, Z 105 to 2397 | PASS, 15 anchors |

- Every component holds one body (the STEPs read back with `stepfile`: DT 16 components and 18 solids, DL 24 and 36; each part number placed as its parts list says). Fusion's STEP writes the three 368005 seal pieces' product ids as 368005, 368005_1 and 368005_2 (one bought part, three cut lengths); the parts list carries one 368005 row, bought by length.
- Parts lists (D-120): the block's list keeps the frame as one row, its mass the sum of its tubes, typed as a weldment assembly; the tubes are listed in the frame's own list (`351204_P01_FRONT-DECOR-FRAME-DT_BOM.csv`, `351104_P01_FRONT-DECOR-FRAME-DL_BOM.csv`), each part once with its copies as its quantity, so the master BOM counts each tube once and the roll-up reads the block as before. The cut lists key each tube by its member and its part number (column `member_part`).
- Mechanical checks on this tree: no C06 or C11 finding on DL's or DT's parts (the D-120 multi-body findings on 351104, 351204, 351103 and 368005 are gone); C05 lists their drawings as still to make. Master BOM: no part without a number or a mass, no duplicate number. Roll-up and packing rerun: DL 12.29 kg (12.30 before: the members' summed masses), the pod unchanged to 0.01 kg.
- The FRONT combined check (door, fixed glass, DR, DT, DL): 0 overlaps between sub-assemblies, the gaps as ruled.
- No names in any export (f3d entries read through zstd, STEP, CSV, DXF).

## 350003 DR: D-120, D-130 and D-131 spans rebuild (2026-11-01, supersedes the #105 row above for DR)

The same method as DT and DL above: the frame 351306 a weldment assembly that keeps its number, each tube its own component with Control's member number (#232; F09 352322 from #287), repeats as copies placed by rigid joints at their shifts. With it D-130 (PM rulings 2026-11-01) and D-131's skin span fix.

| Block | Bodies | Clashes | Frame | Copies | Unit mass (calculation) | STEP box (re-read in Fusion: 0.000 mm) | Edit test |
|---|---|---|---|---|---|---|---|
| DR 350003 | 35 | 0 | 25 tubes as 22 parts, 4.95 kg | 352317 three times (C01, C04, C05 at Z +1820, +2068.86); 352319 twice (C06, C08 at X +541.85) | 21.09 kg in its list; 13.01 kg as it ships (its inner face panel and felt, 8.08 kg, ship loose as packing piece 2-23) | X 229.98 to 1250.02, Y −850.02 to −632.12, Z 109.97 to 2400.02 | PASS, 31 anchors |

- **D-130:** one removable inner face panel 351305, 3 mm 5754-H22, 7.341 kg (the CAD and the offline area agree), on 838004 stop washers 2.36 off the frame, built from AIR's named value `dr_acc_face_y` (Y −641.14). The day's first build failed its edit test here: the panel used its own copy of the formula, and the named value, used by no feature, stayed at its old value in the edited copy (−641.14 against the panel's −631.13); built from the named value, both move together. 21 M6 × 16 socket heads on plain 12 mm washers (PM ruling: one 5 mm key on site); the seal 848013 on the screw line. The felt 351304 (0.737 kg) has 10 closed 14 mm holes with at least 3 mm of felt to its edge; the build refuses a hole that breaks out (the first layout's 22 mm holes broke out by 1 mm) or a washer that reaches the air column's left face, so B07's lowest screw sits at X 939, Z 259.8, and B08's screw by the bolt-line tube stands 19.56 from the band tube's end (C09: it was 18.9).
- **Service path:** clear of every other part in DR; the panel drops 40 (its top at Z 2115, 5 under the soffit's underside) and comes out with its back face 0.86 in front of the closing plate's line.
- **D-131 skin spans:** the front ring's cross tube F09 (Z 1904.4 to 1924.4) holds the front face's top bays to 1.62 and 1.72 mm under 100 N (5.01 without it; `SKIN-SPANS.md`, rerun on this build's STEP); AIR's fan box space 25 back from the skin (Y −822).
- **STEP tree** (read with `stepfile`): 31 components and 35 solids; each tube part placed as the frame's list says; the only component with two bodies is the reserved air space 351405 (a HOLD space, which D-120 exempts).
- **DXFs:** the panel 970.47 × 2042, 23 holes; the felt 715.03 × 2003.53, 10 holes; the back plate 798 × 2284, 6 holes; the skin 28 panels; the cut list 25 tubes, 15.12 m.
- **Mechanical checks on this tree:** no C06 for DR; C09: the panel's 10 felt-side screw holes sit 10.0 from its edge (1.43 diameters), accepted by the PM's edge exception (2026-11-01, the calculation in `v2/04-Checks/config/edge-exceptions.csv`); C05: drawings to make (D-139); C11: the D-131 steel switch waits for WALL's L1 sample review.
- **The FRONT combined check** (door, fixed glass, DR, DT, DL): 0 overlaps between sub-assemblies, the gaps as ruled.
- **No person's name in any export** (f3d entries read through zstd, STEP, CSV, DXF). The f3d files carry Fusion's own machine paths, as every f3d made on this Mac does.
- **Roll-up and packing** (the Lead's go-ahead, 2026-11-01): DR's line is the block as it ships, and the loose panel and felt have their own line and packing piece 2-23; the guide fits them in step 14, right after the riser.

## 350001 DL, 350002 DT, 350003 DR: the 3 mm bond line (2026-11-01, supersedes the rows above for all three)

The frames had been modelled right on their skins. D-137's joint is at least 12 wide × 3 thick, and the skeleton's `bond_t` is 3, so every tube that bonds to a skin now stands 3 mm off it (`dl_fo`, `dt_fo`, `dr_fo` = skin + bond line; PM ruling 2026-11-01). The skins and the look don't move. Faces with no skin keep their offsets: the open bottoms, the slopes where DT's and DL's skin edges meet (D-152), DR's DT joint and ledge, and the back planes.

| Block | Bodies | Clashes | Frame | Copies | Unit mass (calculation) | STEP box (re-read in Fusion: 0.000 mm) | Edit test |
|---|---|---|---|---|---|---|---|
| DL 350001 | 36 | 0 | 26 tubes as 16 parts, 4.69 kg; cut list 11.68 m | 352105 and 352106 four times, 352109 and 352110 three times (Z +612.25, +754.5, +1366.75, +1988.75); the stop's 351106 and the seal's middle piece twice | 12.32 kg | X −1250.01 to −941.98, Y −844.01 to −644.98, Z 104.98 to 2397.01 | PASS, 16 anchors |
| DT 350002 | 18 | 0 | 13 tubes as 11 parts, 2.75 kg; cut list 8.47 m | 352211 three times (C01, C02, C03 at X +555.28, +988.52) | 7.83 kg | X −1250.01 to 449.03, Y −850.01 to −647.24, Z 2093.98 to 2400.01 | PASS, 17 anchors |
| DR 350003 | 34 | 0 | 24 tubes as 21 parts, 4.92 kg; cut list 15.06 m | 352317 three times (C01, C04, C05 at Z +1820, +2067.72); 352319 twice (C06, C08 at X +540.7) | 21.10 kg in its list | X 229.98 to 1250.02, Y −850.02 to −632.12, Z 109.97 to 2400.02 | PASS, 31 anchors |

- **The bond line, read from the STEPs:** every tube face that faces a skin sits 3.0 off it (DL 21 faces, DT 14, DR 27). The only faces at 0 are three of DR's back-ring faces, flush with the 3 mm cut edge of its bottom skin: edge-on, not bonds.
- **DL:** the door-side front posts are plain 20 × 20 tubes on the door-side skin's bond line, set back so their inner front corner is on the front facet's bond face (PM ruling 2026-11-01). The build's bead check (`post_bead`) prints the corner joint: 3.00 thick at the post's corner, 8.49 at 12 mm, on 12.0 of the tube and 13.5 of the skin, 77.5 mm² (ml per metre). The posts now start on the bottom ring; they had started 3 mm above it. The door-side ring tubes end on the front facet's bond face, because the 7 mm front face has no width left at the tubes' depth (−0.45). The first DL build kept the old five-point outline: it folded over itself there, built, and went unhealthy in the edit test.
- **DT:** the chamfer cross tubes' back end is flat on the back ring's top tube's face (48.24° to the tube's own square, within 0.1° of vertical), with no 0.05 mm step to the top's bond face. The first DT build had that step; it passed, and was rebuilt without it.
- **DR:** the first build's edit test failed on 4 frame anchors still written on the skin, which have been corrected. AIR's riser space moved 3 mm right to X 959 to 1098 (5.9 to B07, CEILING's move). The supply fan box space stands 3 mm further back (front Y −819, so F09 keeps its 5) and 7 mm right, at X 680 to 980 (PM ruling: 6.3 to B06, 8.1 to F05, 17.3 to the glass channel). The ledge tube's rivnuts carry DT's 11 mm spigots 831010 (D-157). The panel's opening into the air column is X 961 to 1146, Z 1895 to 2102 (PM ruling 2026-11-01, read back from the panel's DXF). Every rivnut hole for 838003 is Ø10.00 +0.10 (D-163), read from the STEP and the DXFs: 6 in the back plate, 2 in the panel for the column's hook studs, 23 in the frame tubes (21 under the panel's screws, 2 for DT's spigots).
- **`frame_preflight.py`** now catches both kinds of failure offline, at the nominal values and at each edit test's values: a folded or near-degenerate tube outline, and a frame anchor off its tube. It passes for all three blocks.
- **The FRONT combined check** (door, fixed glass, DR, DT, DL): 0 overlaps between sub-assemblies.
- **The tube cut lists (D-162: a member's row is its drawing).** Each row gives the section, material, cut length, both end angles from square (in degrees, and in words with each end named by where it points) and how the cuts lean, the quantity and the tolerance. `frame_lib.write_cut_list` writes them in the build and `frame_preflight.py --cut-lists` offline from the same frame data, with one rounding (half up, so DL's posts read 592.3 both ways); DR's offline list was byte-identical to its build's before the wording changed. Four members have two cuts at one end and keep their own sheets: 352207 (DT's catch and stop rail), 352317, 352318 and 352319 (DR's facet and chamfer tubes). The mechanical check's C05 end rule (#357), run on these STEPs, finds one plane at each end of every other member, 352105 and 352211 included. The end notes of DT's F01 and F02 and DR's C01 to C08 said 'square' where a cut is 4° or 42° to the tube (they meant 'flush against'); they now say where each end sits, in the code and in the lists the builds wrote.
