autonomous-ai/spaceship/v2/07-Packaging/templates/install-sheet.md

<!-- 100000_P04_POD-INSTALL-SHEET_INS.md is generated by v2/07-Packaging/pack.py from v2/07-Packaging/templates/install-sheet.md. Edit the template or the script, never the generated file. -->
# Install sheet: what the room needs for Spaceship (FocusPod v2)

| Doc code | Part number | Revision | Status | Date | Owner |
|---|---|---|---|---|---|
| V2-INS-002 (PROPOSED) | 100000 POD · Pod hoàn chỉnh | P04 | DRAFT, first issue | 2026-11-01 | Packing and Assembly Engineer |

The site's half of interface IF-17 (POD to room: floor, power, the air's clear space, later the sprinkler). It goes to whoever prepares the room, before the pallets arrive. Every number carries its status; the open items at the end say who settles the rest. The assembly guide's section 1 points here.

## Result

1. **Clear height: at least {{ROOM_H}} mm** from the floor to anything above the pod (ceiling, lights, sprinklers, ducts). The pod is {{POD_H}} mm tall (D-21); the roof work in guide step {{STEP_ROOF}} needs {{ROOF_WORK}} mm above its roof (assumption). The air's own need above the roof slot is still to be set (ISS-049).
2. **Floor: flat and level enough that the high and low points under the pod's {{N_GLIDES}} glides lie within {{FLOOR_PV}} mm of each other** (calculation: the glides run from {{GLIDE_MIN}} mm, the lowest setting the PM allows, to {{GLIDE_MAX}} mm, ISS-054's working range). The pod has no floor of its own (D-132): people stand on the room floor, so it should also be a finished, hard floor.
3. **Power: one 120 V, 60 Hz wall outlet (NEMA 5-15, 15 A)** within reach of the pod's cord (D-133). The pod draws {{LOAD_W}} W at most on its 12 V side (ELECTRICAL's load table, the voice kit's 60 W hook included), so an ordinary outlet will do. In Vietnam the prototype runs through a 220-to-110 V step-down transformer (D-133).
4. **Air: keep clear above the roof slot and in front of the intake under DR.** The pod breathes out through a slot in its roof near the front right corner and in through the mesh in the base band under the right decor block (D-61, D-62). AIR sets the minimum gaps (ISS-049); until then keep at least the {{ROOF_WORK}} mm above the roof that assembly needs, and nothing standing against the base band under DR.
5. **Getting it in:** every door on the way at least 810 × 2032 mm (REQ-ASM-06). **An elevator needs a door at least {{LIFT_DOOR_W}} mm wide (a 48 in door; a 42 in one is 3 mm short with DR in its wrap) and {{LIFT_DOOR_H}} mm ({{LIFT_DOOR_H_IN}} in) tall, and a car at least {{LIFT_CAR_W}} × {{LIFT_CAR_D}} mm inside and {{LIFT_CAR_H}} mm ({{LIFT_CAR_H_IN}} in) tall** (calculation, check K15): DR goes in with its {{DR_FACE}} mm face across the door and leans up into the car, and the long parts lean in the same way. A typical passenger car with a {{TYP_DOOR_W}} mm ({{TYP_DOOR_W_IN}} in) door can't take {{NOT_TYPICAL}}: use a freight or service elevator, or the stairs, for that. Open the glass crate at the building's entrance; each pane goes in upright on its suction lifters.

## 1. Delivery

| Pallet | Deck | Loaded height | Gross |
|---|---|---|---|
| 1 | 48 × 40 in (1219 × 1016 mm) | {{H1}} mm | {{G1}} kg |
| 2 | 96 × 48 in (2438 × 1219 mm) | {{H2}} mm | {{G2}} kg |

- A pallet jack and a route for a 2438 mm long pallet to the room, or unpacking at the door: every piece passes an 810 mm wide, 2032 mm high doorway (REQ-ASM-06). The longest piece is {{LONGEST}}, so corridors need room to turn it.
- An elevator: a door at least {{LIFT_DOOR_W}} × {{LIFT_DOOR_H}} mm and a car at least {{LIFT_CAR_W}} × {{LIFT_CAR_D}} mm inside and {{LIFT_CAR_H}} mm tall, or a freight elevator (check K15: each piece as carried, in its wrap, leaned into the car with its lower end sliding on the floor; the panes out of the crate on their lifters). A typical passenger car with a {{TYP_DOOR_W}} mm door can't take {{NOT_TYPICAL}}.
- The pallets' wood is heat-treated and ISPM 15 stamped (the packing plan), so they clear US ports.
- The glass travels in a crate at the bottom of pallet 2: the door unit {{DOOR_KG}} kg and the fixed glass {{FIX_KG}} kg, each moved by two people with two suction lifters. Every other piece is 20 kg or less (D-03).
- Both pallets are marked DO NOT STACK.

## 2. The room

| Need | Value | Status and source |
|---|---|---|
| Clear height, floor to the lowest thing above the pod | {{ROOM_H}} mm or more | calculation: the pod's {{POD_H}} (D-21) + {{ROOF_WORK}} for the roof sleeve and the grille's 4 bolts (step {{STEP_ROOF}}, J-AIR-03; assumption) |
| Height DT and the ceiling halves need as they go on | {{H_SPIGOTS}} mm | calculation: lifted {{SPIGOT_LIFT}} mm over their 8 mm spigots (assumption; J-FRONT-03, J-CEIL-01) |
| Footprint | {{POD_W}} × {{POD_D}} mm | decided (D-01) |
| Clear round the footprint while it goes together | {{LAY_OUT}} m a side, so about {{LAY_W}} × {{LAY_D}} mm | assumption: the parts set down at their places in step 1, and the step stools |
| Floor: high and low points under the {{N_GLIDES}} glides | within {{FLOOR_PV}} mm | calculation: glides {{GLIDE_MIN}} (PM ruling on F-018) to {{GLIDE_MAX}} mm (ISS-054, PROPOSED) |
| Floor finish | hard and finished: it is the pod's floor (D-132) | decided |
| Wall outlet | 120 V, 60 Hz, NEMA 5-15, 15 A, within reach of the pod's cord | decided (D-133); the cord's length and the inlet's place come from ELECTRICAL |
| Power the pod draws | {{LOAD_W}} W at most at 12 V | calculation (ELECTRICAL's load table) |
| Roof slot, the exhaust out | {{SLOT}} | calculation (CAD) |
| Clear space above the roof slot | AIR to set; {{ROOF_WORK}} mm meanwhile | open (ISS-049) |
| Intake, the mesh in the base band under DR | keep clear in front; AIR to set the gap | open (ISS-049) |

## 3. Open items

| ID | What | Owner | Status |
|---|---|---|---|
| IS-01 | The air's minimum clear space above the roof slot and in front of the intake (ISS-049). | AIR (Hardware Engineer, air) | open |
| IS-02 | The floor tolerance to design for, against a floor standard, and the glides' real range once the product is named (ISS-054; glide HOLD). | BASE | PROPOSED |
| IS-03 | The cord's length and the inlet's place for the 120 V side (D-133), so the outlet's distance can be written here. | ELECTRICAL | open |
| IS-04 | The roof work's {{ROOF_WORK}} mm and the spigot lift's {{SPIGOT_LIFT}} mm are this sheet's assumptions until the prototype is built (REQ-ASM-01's timed trial). | Packing | assumption |
| IS-05 | A sprinkler or alarm opening in the roof comes later with the US certification work (ISS-052, D-134). | CEILING | later |
