autonomous-ai/spaceship/v2/01-CAD-Native/wall/BUILD-RECORD.md

# Build record: WALL designs

Generated by `make_records.py` from the CAD reports that `post_wall_doc.py` writes in Fusion (2706.1, Mac 1) after each build. Every design derives skeleton P04 (`100000_P04_POD-SKELETON_CAD`); its exported .f3d carries the skeleton's values with the derive link broken for the export only, so it opens on its own (README, Fusion traps). STEP length unit: cm, declared in the file (D-13).

| Design | Cloud version | Components | Bodies | Holes | Mass of made parts (kg) | Files |
|---|---|---|---|---|---|---|
| 210101_P01_WALL-PANEL-ASSY-SIDE-LOWER-LH_CAD | v9 | 211101, 211301, 211501, 831001, 831002, 838003 | 30 | 71 | 10.702 | `210101_P01_WALL-PANEL-ASSY-SIDE-LOWER-LH_CAD.f3d`, `210101_P01_WALL-PANEL-ASSY-SIDE-LOWER-LH_STEP.step` |
| 210102_P01_WALL-PANEL-ASSY-SIDE-LOWER-RH_CAD | v2 | 211102, 211302, 211502, 831001, 831002, 838003 | 30 | 71 | 10.702 | `210102_P01_WALL-PANEL-ASSY-SIDE-LOWER-RH_CAD.f3d`, `210102_P01_WALL-PANEL-ASSY-SIDE-LOWER-RH_STEP.step` |
| 210103_P01_WALL-PANEL-ASSY-SIDE-UPPER-LH_CAD | v3 | 211103, 211303, 211503, 831002, 838003 | 26 | 59 | 10.820 | `210103_P01_WALL-PANEL-ASSY-SIDE-UPPER-LH_CAD.f3d`, `210103_P01_WALL-PANEL-ASSY-SIDE-UPPER-LH_STEP.step` |
| 210104_P01_WALL-PANEL-ASSY-SIDE-UPPER-RH_CAD | v2 | 211104, 211304, 211504, 831002, 838003 | 26 | 59 | 10.820 | `210104_P01_WALL-PANEL-ASSY-SIDE-UPPER-RH_CAD.f3d`, `210104_P01_WALL-PANEL-ASSY-SIDE-UPPER-RH_STEP.step` |
| 210201_P01_WALL-PANEL-ASSY-BACK-LOWER-B1_CAD | v3 | 211201, 211401, 211601, 831001, 831002, 838003 | 22 | 56 | 8.223 | `210201_P01_WALL-PANEL-ASSY-BACK-LOWER-B1_CAD.f3d`, `210201_P01_WALL-PANEL-ASSY-BACK-LOWER-B1_STEP.step` |
| 210202_P01_WALL-PANEL-ASSY-BACK-LOWER-B2_CAD | v2 | 211202, 211402, 211602, 831001, 831002, 838003 | 25 | 70 | 8.119 | `210202_P01_WALL-PANEL-ASSY-BACK-LOWER-B2_CAD.f3d`, `210202_P01_WALL-PANEL-ASSY-BACK-LOWER-B2_STEP.step` |
| 211101_P01_WALL-PANEL-FRAME-SIDE-LOWER-LH_CAD | v5 | 211101 | 7 | 26 | 3.105 | `211101_P01_WALL-PANEL-FRAME-SIDE-LOWER-LH_CAD.f3d`, `211101_P01_WALL-PANEL-FRAME-SIDE-LOWER-LH_STEP.step` |
| 211102_P01_WALL-PANEL-FRAME-SIDE-LOWER-RH_CAD | v3 | 211102 | 7 | 26 | 3.105 | `211102_P01_WALL-PANEL-FRAME-SIDE-LOWER-RH_CAD.f3d`, `211102_P01_WALL-PANEL-FRAME-SIDE-LOWER-RH_STEP.step` |
| 211103_P01_WALL-PANEL-FRAME-SIDE-UPPER-LH_CAD | v3 | 211103 | 7 | 24 | 3.262 | `211103_P01_WALL-PANEL-FRAME-SIDE-UPPER-LH_CAD.f3d`, `211103_P01_WALL-PANEL-FRAME-SIDE-UPPER-LH_STEP.step` |
| 211104_P01_WALL-PANEL-FRAME-SIDE-UPPER-RH_CAD | v2 | 211104 | 7 | 24 | 3.262 | `211104_P01_WALL-PANEL-FRAME-SIDE-UPPER-RH_CAD.f3d`, `211104_P01_WALL-PANEL-FRAME-SIDE-UPPER-RH_STEP.step` |
| 211201_P01_WALL-PANEL-FRAME-BACK-LOWER-B1_CAD | v3 | 211201 | 6 | 26 | 2.366 | `211201_P01_WALL-PANEL-FRAME-BACK-LOWER-B1_CAD.f3d`, `211201_P01_WALL-PANEL-FRAME-BACK-LOWER-B1_STEP.step` |
| 211301_P01_WALL-SKIN-SIDE-LOWER-LH_CAD | v3 | 211301 | 1 | 0 | 6.142 | `211301_P01_WALL-SKIN-SIDE-LOWER-LH_CAD.f3d`, `211301_P01_WALL-SKIN-SIDE-LOWER-LH_STEP.step` |
| 211401_P01_WALL-SKIN-BACK-LOWER-B1_CAD | v2 | 211401 | 1 | 0 | 4.701 | `211401_P01_WALL-SKIN-BACK-LOWER-B1_CAD.f3d`, `211401_P01_WALL-SKIN-BACK-LOWER-B1_STEP.step` |
| 211501_P01_WALL-CAVITY-FILL-SIDE-LOWER-LH_CAD | v2 | 211501 | 4 | 0 | 1.426 | `211501_P01_WALL-CAVITY-FILL-SIDE-LOWER-LH_CAD.f3d`, `211501_P01_WALL-CAVITY-FILL-SIDE-LOWER-LH_STEP.step` |
| 211601_P01_WALL-CAVITY-FILL-BACK-LOWER-B1_CAD | v2 | 211601 | 3 | 0 | 1.135 | `211601_P01_WALL-CAVITY-FILL-BACK-LOWER-B1_CAD.f3d`, `211601_P01_WALL-CAVITY-FILL-BACK-LOWER-B1_STEP.step` |
| 510101_P01_LINING-CASSETTE-SIDE-LOWER-LH_CAD | v6 | 511101, 511301, NO-PN-HOLD-H03 | 6 | 16 | 10.337 | `510101_P01_LINING-CASSETTE-SIDE-LOWER-LH_CAD.f3d`, `510101_P01_LINING-CASSETTE-SIDE-LOWER-LH_STEP.step` |
| 510102_P01_LINING-CASSETTE-SIDE-LOWER-RH_CAD | v4 | 511102, 511302, NO-PN-HOLD-H03 | 6 | 18 | 10.328 | `510102_P01_LINING-CASSETTE-SIDE-LOWER-RH_CAD.f3d`, `510102_P01_LINING-CASSETTE-SIDE-LOWER-RH_STEP.step` |
| 510103_P01_LINING-CASSETTE-SIDE-UPPER-LH_CAD | v3 | 511103, 511303, NO-PN-HOLD-H03 | 6 | 16 | 9.906 | `510103_P01_LINING-CASSETTE-SIDE-UPPER-LH_CAD.f3d`, `510103_P01_LINING-CASSETTE-SIDE-UPPER-LH_STEP.step` |
| 510104_P01_LINING-CASSETTE-SIDE-UPPER-RH_CAD | v2 | 511104, 511304, NO-PN-HOLD-H03 | 6 | 18 | 9.906 | `510104_P01_LINING-CASSETTE-SIDE-UPPER-RH_CAD.f3d`, `510104_P01_LINING-CASSETTE-SIDE-UPPER-RH_STEP.step` |
| 510201_P01_LINING-CASSETTE-BACK-LOWER-B1_CAD | v3 | 511201, 511401, NO-PN-HOLD-H03 | 6 | 16 | 8.239 | `510201_P01_LINING-CASSETTE-BACK-LOWER-B1_CAD.f3d`, `510201_P01_LINING-CASSETTE-BACK-LOWER-B1_STEP.step` |
| 510202_P01_LINING-CASSETTE-BACK-LOWER-B2_CAD | v2 | 511202, 511402, NO-PN-HOLD-H03 | 6 | 17 | 7.768 | `510202_P01_LINING-CASSETTE-BACK-LOWER-B2_CAD.f3d`, `510202_P01_LINING-CASSETTE-BACK-LOWER-B2_STEP.step` |
| 511101_P01_LINING-TRAY-SIDE-LOWER-LH_CAD | v2 | 511101 | 1 | 16 | 7.379 | `511101_P01_LINING-TRAY-SIDE-LOWER-LH_CAD.f3d`, `511101_P01_LINING-TRAY-SIDE-LOWER-LH_STEP.step` |
| 511201_P01_LINING-TRAY-BACK-LOWER-B1_CAD | v2 | 511201 | 1 | 16 | 5.906 | `511201_P01_LINING-TRAY-BACK-LOWER-B1_CAD.f3d`, `511201_P01_LINING-TRAY-BACK-LOWER-B1_STEP.step` |

Masses per component (kg, CAD, at the densities in each design's material names):

- 211501 WALL - CAVITY FILL - SIDE LOWER - LH: 1.426 (4 bodies)
- 831001 HARDWARE - LOCATING SPIGOT - M6 X Ø8 - STAINLESS: 0.010 (2 bodies)
- 838003 HARDWARE - RIVET NUT - M6 - SHEREX CAH3-610-4.2: 0.013 (9 bodies)
- 831002 HARDWARE - STOP WASHER - Ø10.5 X Ø20 X 1.5 - AL: 0.006 (7 bodies)
- 211101 WALL - PANEL FRAME - SIDE LOWER - LH: 3.105 (7 bodies)
- 211301 WALL - SKIN - SIDE LOWER - LH: 6.142 (1 bodies)
- 211102 WALL - PANEL FRAME - SIDE LOWER - RH: 3.105 (7 bodies)
- 831002 HARDWARE - STOP WASHER - Ø10.5 X Ø20 X 1.5 - AL: 0.006 (7 bodies)
- 838003 HARDWARE - RIVET NUT - M6 - SHEREX CAH3-610-4.2: 0.013 (9 bodies)
- 211502 WALL - CAVITY FILL - SIDE LOWER - RH: 1.426 (4 bodies)
- 831001 HARDWARE - LOCATING SPIGOT - M6 X Ø8 - STAINLESS: 0.010 (2 bodies)
- 211302 WALL - SKIN - SIDE LOWER - RH: 6.142 (1 bodies)
- 211103 WALL - PANEL FRAME - SIDE UPPER - LH: 3.262 (7 bodies)
- 211503 WALL - CAVITY FILL - SIDE UPPER - LH: 1.400 (4 bodies)
- 211303 WALL - SKIN - SIDE UPPER - LH: 6.142 (1 bodies)
- 831002 HARDWARE - STOP WASHER - Ø10.5 X Ø20 X 1.5 - AL: 0.006 (7 bodies)
- 838003 HARDWARE - RIVET NUT - M6 - SHEREX CAH3-610-4.2: 0.010 (7 bodies)
- 838003 HARDWARE - RIVET NUT - M6 - SHEREX CAH3-610-4.2: 0.010 (7 bodies)
- 211104 WALL - PANEL FRAME - SIDE UPPER - RH: 3.262 (7 bodies)
- 831002 HARDWARE - STOP WASHER - Ø10.5 X Ø20 X 1.5 - AL: 0.006 (7 bodies)
- 211304 WALL - SKIN - SIDE UPPER - RH: 6.142 (1 bodies)
- 211504 WALL - CAVITY FILL - SIDE UPPER - RH: 1.400 (4 bodies)
- 211601 WALL - CAVITY FILL - BACK LOWER - B1: 1.135 (3 bodies)
- 831002 HARDWARE - STOP WASHER - Ø10.5 X Ø20 X 1.5 - AL: 0.004 (4 bodies)
- 831001 HARDWARE - LOCATING SPIGOT - M6 X Ø8 - STAINLESS: 0.010 (2 bodies)
- 211201 WALL - PANEL FRAME - BACK LOWER - B1: 2.366 (6 bodies)
- 211401 WALL - SKIN - BACK LOWER - B1: 4.701 (1 bodies)
- 838003 HARDWARE - RIVET NUT - M6 - SHEREX CAH3-610-4.2: 0.008 (6 bodies)
- 211602 WALL - CAVITY FILL - BACK LOWER - B2: 1.032 (3 bodies)
- 831002 HARDWARE - STOP WASHER - Ø10.5 X Ø20 X 1.5 - AL: 0.004 (4 bodies)
- 838003 HARDWARE - RIVET NUT - M6 - SHEREX CAH3-610-4.2: 0.013 (9 bodies)
- 831001 HARDWARE - LOCATING SPIGOT - M6 X Ø8 - STAINLESS: 0.010 (2 bodies)
- 211202 WALL - PANEL FRAME - BACK LOWER - B2: 2.363 (6 bodies)
- 211402 WALL - SKIN - BACK LOWER - B2: 4.697 (1 bodies)
- 211101 WALL - PANEL FRAME - SIDE LOWER - LH: 3.105 (7 bodies)
- 211102 WALL - PANEL FRAME - SIDE LOWER - RH: 3.105 (7 bodies)
- 211103 WALL - PANEL FRAME - SIDE UPPER - LH: 3.262 (7 bodies)
- 211104 WALL - PANEL FRAME - SIDE UPPER - RH: 3.262 (7 bodies)
- 211201 WALL - PANEL FRAME - BACK LOWER - B1: 2.366 (6 bodies)
- 211301 WALL - SKIN - SIDE LOWER - LH: 6.142 (1 bodies)
- 211401 WALL - SKIN - BACK LOWER - B1: 4.701 (1 bodies)
- 211501 WALL - CAVITY FILL - SIDE LOWER - LH: 1.426 (4 bodies)
- 211601 WALL - CAVITY FILL - BACK LOWER - B1: 1.135 (3 bodies)
- 511101 LINING - TRAY - SIDE LOWER - LH: 7.379 (1 bodies)
- NO-PN-HOLD-H03 HOLD - CASSETTE CLIP ZONES (H03, NO PART NAMED): 0.000 (4 bodies)
- 511301 LINING - FELT - SIDE LOWER - LH: 2.958 (1 bodies)
- 511102 LINING - TRAY - SIDE LOWER - RH: 7.379 (1 bodies)
- NO-PN-HOLD-H03 HOLD - CASSETTE CLIP ZONES (H03, NO PART NAMED): 0.000 (4 bodies)
- 511302 LINING - FELT - SIDE LOWER - RH: 2.949 (1 bodies)
- 511303 LINING - FELT - SIDE UPPER - LH: 2.829 (1 bodies)
- 511103 LINING - TRAY - SIDE UPPER - LH: 7.078 (1 bodies)
- NO-PN-HOLD-H03 HOLD - CASSETTE CLIP ZONES (H03, NO PART NAMED): 0.000 (4 bodies)
- 511104 LINING - TRAY - SIDE UPPER - RH: 7.078 (1 bodies)
- 511304 LINING - FELT - SIDE UPPER - RH: 2.828 (1 bodies)
- NO-PN-HOLD-H03 HOLD - CASSETTE CLIP ZONES (H03, NO PART NAMED): 0.000 (4 bodies)
- 511401 LINING - FELT - BACK LOWER - B1: 2.333 (1 bodies)
- 511201 LINING - TRAY - BACK LOWER - B1: 5.906 (1 bodies)
- NO-PN-HOLD-H03 HOLD - CASSETTE CLIP ZONES (H03, NO PART NAMED): 0.000 (4 bodies)
- 511402 LINING - FELT - BACK LOWER - B2: 2.187 (1 bodies)
- NO-PN-HOLD-H03 HOLD - CASSETTE CLIP ZONES (H03, NO PART NAMED): 0.000 (4 bodies)
- 511202 LINING - TRAY - BACK LOWER - B2: 5.582 (1 bodies)
- 511101 LINING - TRAY - SIDE LOWER - LH: 7.379 (1 bodies)
- 511201 LINING - TRAY - BACK LOWER - B1: 5.906 (1 bodies)
