autonomous-ai/spaceship/v2/02-Drawings/00-General-Assembly/100000_P04_POD-SPACESHIP_DWG.pdf

A

A

B B

C C

2500

2403 1700

0

2400

2403

INSIDE 2333
INSIDE 1461.1

ROOM FLOOR

CLEAR 2316.5

ROOM FLOOR

DOOR CLEAR 2094

DOOR CLEAR 1032.5

L1

L2

R1

R2

C1 | C2
B1 | B2
B3 | B4

## FRONT VIEW 1:20

X = +X, Y = +Z (pod axes); looking toward +Y

## VIEW FROM ABOVE 1:20

X = +X, Y = +Y (pod axes); looking down (toward -Z)

## VIEW FROM THE LEFT 1:20

X = -Y, Y = +Z (pod axes); looking toward +X

## VIEW FROM THE RIGHT 1:20

X = +Y, Y = +Z (pod axes); looking toward -X

## SECTION A-A 1:20

X = -Y, Y = +Z (pod axes); looking toward +X

## SECTION B-B 1:20

X = +X, Y = +Z (pod axes); looking toward +Y

## SECTION C-C 1:20

X = +X, Y = +Y (pod axes); looking down (toward -Z)

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
## PARTS LIST: 100000 POD - SPACESHIP

ITEM

PART
NUMBER
NAME | QTY | MATERIAL | FINISH
1 | 110000 | BASE | 1 | - | -
2 | 210000 | WALL | 1 | - | -
3 | 350000 | FRONT - DECOR | 1 | - | -
4 | 360000 | FRONT - DOOR AND GLAZING | 1 | - | -
5 | 410000 | CEILING | 1 | - | -
6 | 510000 | LINING | 1 | - | -
7 | 610000 | AIR | 1 | - | -
8 | 710000 | ELECTRICAL | 1 | - | -
9 | 810000 | INTERIOR | 1 | - | -

PROJECT
Spaceship (FocusPod v2)

STATUS

### DRAFT

DATE
2026-11-02

SHEET
1/1

TITLE

## POD - SPACESHIP

Pod hoàn chỉnh

PART NUMBER
100000

REV
P04

DRAWING NUMBER (FILE)
100000_P04_POD-SPACESHIP_DWG

MATERIAL
MATERIAL: see the parts list

FINISH
FINISH: see the parts list

SCALE
1:20

SIZE
A1

UNITS
UNITS: mm

MASS
405.1 kg (calculation)

CREATED BY
Autonomous

APPROVED
not released

TOLERANCES
TOLERANCE: see the notes; not ISO 2768

PROJECTION
ISO first angle (ISO 5456-2)

## NOTES

1. Parts, quantities, materials and finishes as the parts list 100000_P01_POD-MASTER_BOM.csv (its rows under 100000), word for word; each part's own drawing holds its sizes and tolerances.
2. Views in first angle (ISO 5456-2); each view title gives its X and Y in pod axes (guideline 3.3). Visible outlines only, as an assembly drawing shows them.
3. Interface sizes (ordinates, true mm from the STEP): FRONT VIEW: heights from the room floor (Z 0, under the glides): the roof skin's top 2400 (D-21) and the overall top 2403, AIR's roof grille 611602 on the roof sleeve's 1 mm flange (PM ruling 2026-11-01: the room's ceiling must clear the overall height).
4. Pod axes (conventions section 4): origin on the room floor at the pod's centre; +X right seen from outside facing the door, +Y back, +Z up; the front is the door side.
5. No floor and no threshold (D-132): people stand on the room floor, and the base stands on its glides (glide_h 10, skeleton P04).
6. Walls and ceiling are 84 deep: ACP 3, bond 3 (D-137), steel frame 40 (D-131), gap 4, lining cassette 34 (skeleton P04, stack_t). Seams 2.26 at a metal stop; the closing seams B1-B2, B3-B4 and C1-C2 have a 5.5 frame gap (joints register 2.8).
7. Still to come (WALL): the back upper panels B3 and B4 and their cassettes 510203 and 510204 are not modelled yet, so the back wall's upper half is empty in the views and sections; this sheet is drawn again when they are (PM ruling 2026-11-01).
8. Sections cut the teams' parts as modelled: A-A at X -373.5 (the door's middle), seen from the left; B-B at Y 0 (mid depth), seen from the front; C-C at Z 1000 (through the door and the fixed glass), seen from above. Each assembly's own sheets give its build-ups, fixings and sizes.
9. Inside sizes, measured on the teams' STEPs (calculation): width 2333 between the side linings at Z 1000 (C-C); depth 1461.1 from the closed door's inner face to the back lining at X -373.5 (C-C); clear height 2316.5 from the room floor to the ceiling cassettes' underside (B-B).
10. Door clear opening with the door open 90° outward (calculation on FRONT's STEPs): width 1156.6 at Z 115, 1032.5 at Z 1000 (C-C), 879.8 at Z 2089, from DL's hinge-side stop (351105, 351106, 351107) to the fixed glass's door edge (the opening narrows upward with the door's slanted edge); height 2094 under the door catch 368007 in DT (A-A). The hinge isn't named yet (HOLD H01): the leaf is turned about a pivot taken at X -966.5, Y -709 (D-154's limit), the hinges' HOLD spaces left out (assumption); the open leaf stays clear of these sizes.
11. Position codes (guideline 5.1), on the skeleton P04's panels: L1, L2 on the view from the left; R1, R2 on the view from the right; C1, C2 on the view from above; B1, B2, B3, B4 on section B-B. B3 and B4 aren't modelled yet (WALL); the pod has two ceiling halves, so there is no C3.
12. MASS 405.1 kg (calculation): the weight roll-up on skeleton P04 (v2/05-Engineering/layout-study/weight-rollup.md, its 'Pod as shipped' row): every part on the pod as it stands in the room, the parts that ship loose included; packaging not in it, nor the voice kit's reserve (D-11).
13. TOLERANCE: the overall sizes are for reference; each part's drawing holds its own tolerances. Not ISO 2768.

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
A | A
B | B
C | C
D | D
E | E
F | F
G | G
H | H
J | J
K | K
L | L
M | M
