autonomous-ai/spaceship/sources/v1/drawings/floor-frame-assembly.pdf

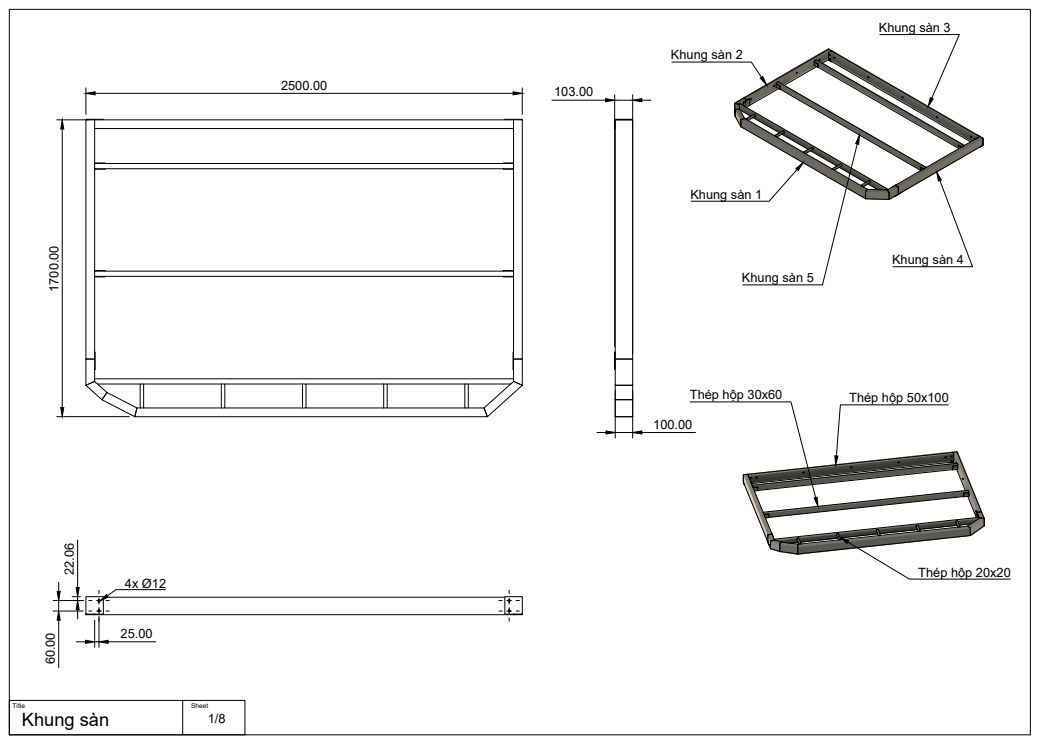
[picture p90: page 1]
Khung sàn 1; Khung sàn 4; Khung sàn 2; Khung sàn 5; Khung sàn 3; Thép hộp 30x60; Thép hộp 50x100; Thép hộp 20x20; Title; Sheet; Khung sàn

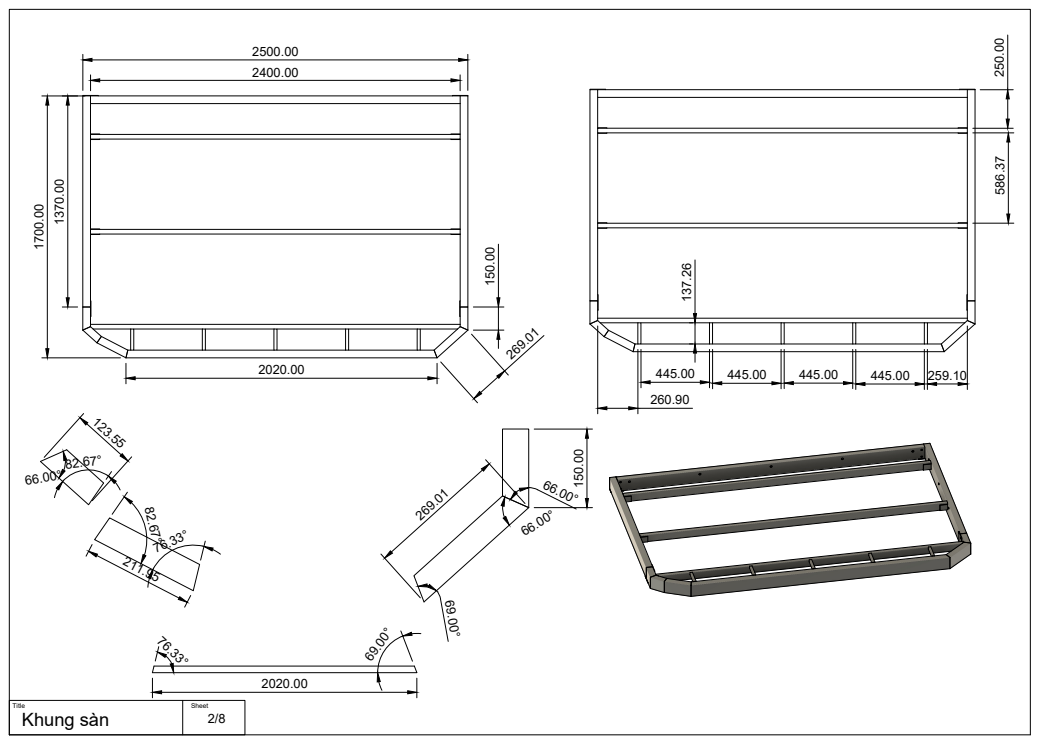
[picture p91: page 2]
Khung sàn; 137.26 269.01 ¹⁷⁰⁰.00

B

B-B (1:8) 30.00

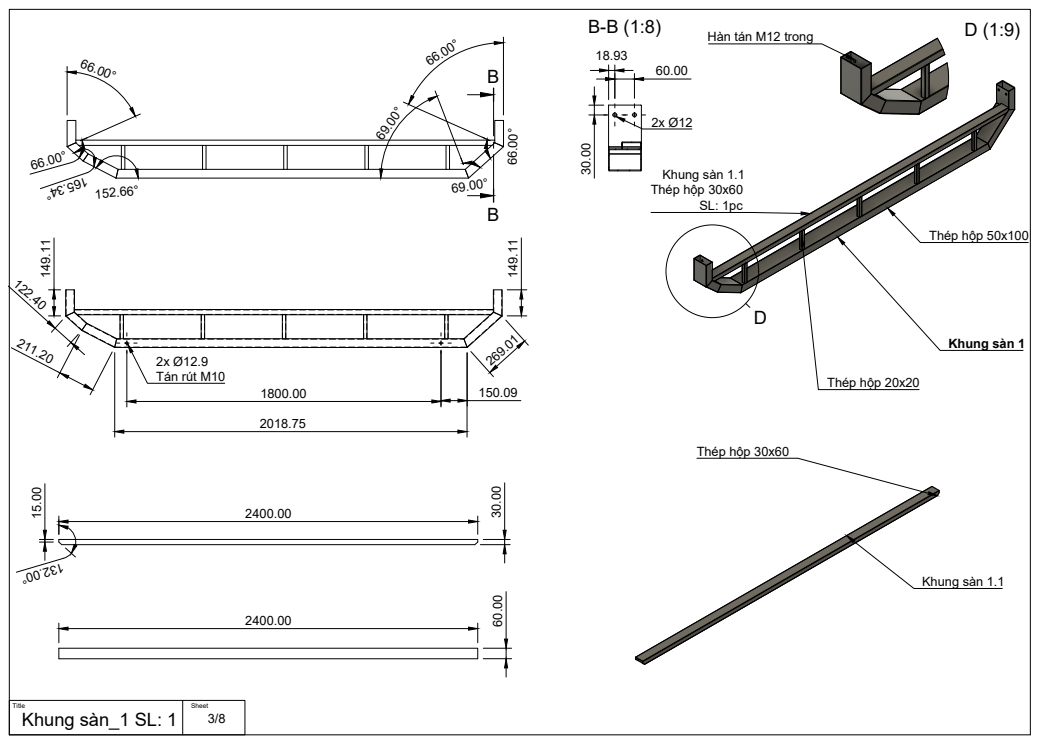
[picture p92: page 3]
Khung sàn_1 SL: 1; 2x Ø12.9 Tán rút M10; Khung sàn 1; Khung sàn 1.1; Thép hộp 20x20; Thép hộp 50x100; Thép hộp 30x60; Khung sàn 1.1 Thép hộp 30x60 SL: 1pc

D (1:9) Hàn tán M12 trong

50.00 247.00

G

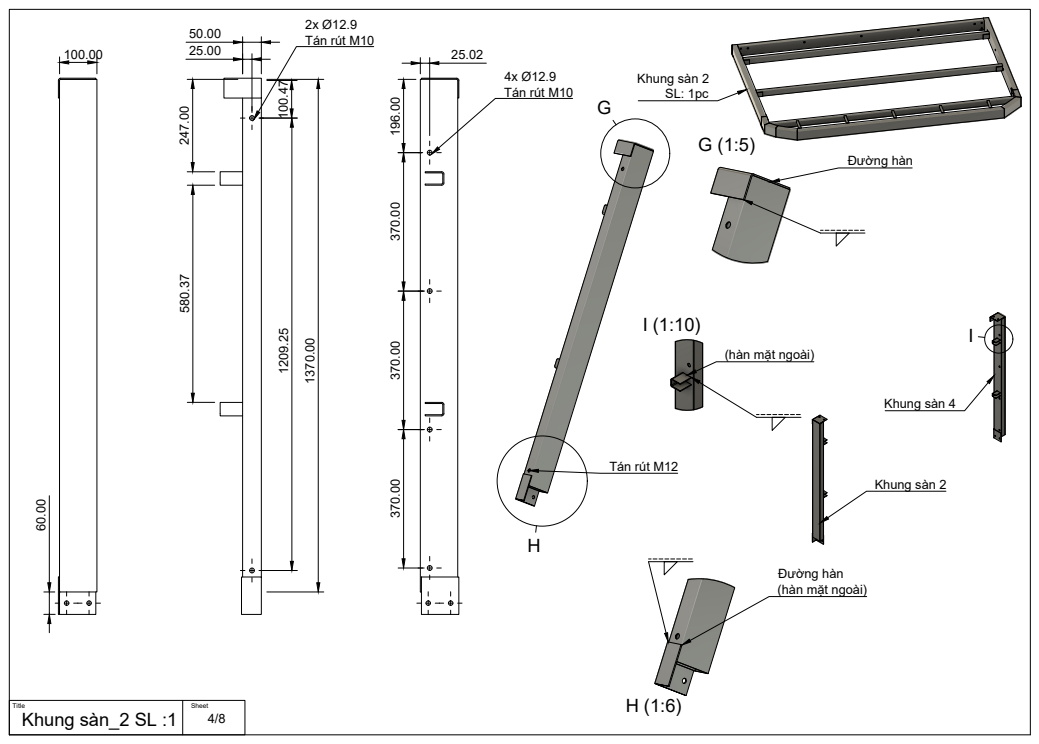
[picture p93: page 4]
Khung sàn_2 SL :1; Khung sàn 2; Khung sàn 4; Khung sàn 2 SL: 1pc; Tán rút M12; 4x Ø12.9 Tán rút M10 196.00; Đường hàn; 2x Ø12.9 Tán rút M10

(hàn mặt ngoài)

Đường hàn

Khung sàn_4 SL: 1 | 5/8 | 196.00 370.00
25.02 | 97.00 1170.00

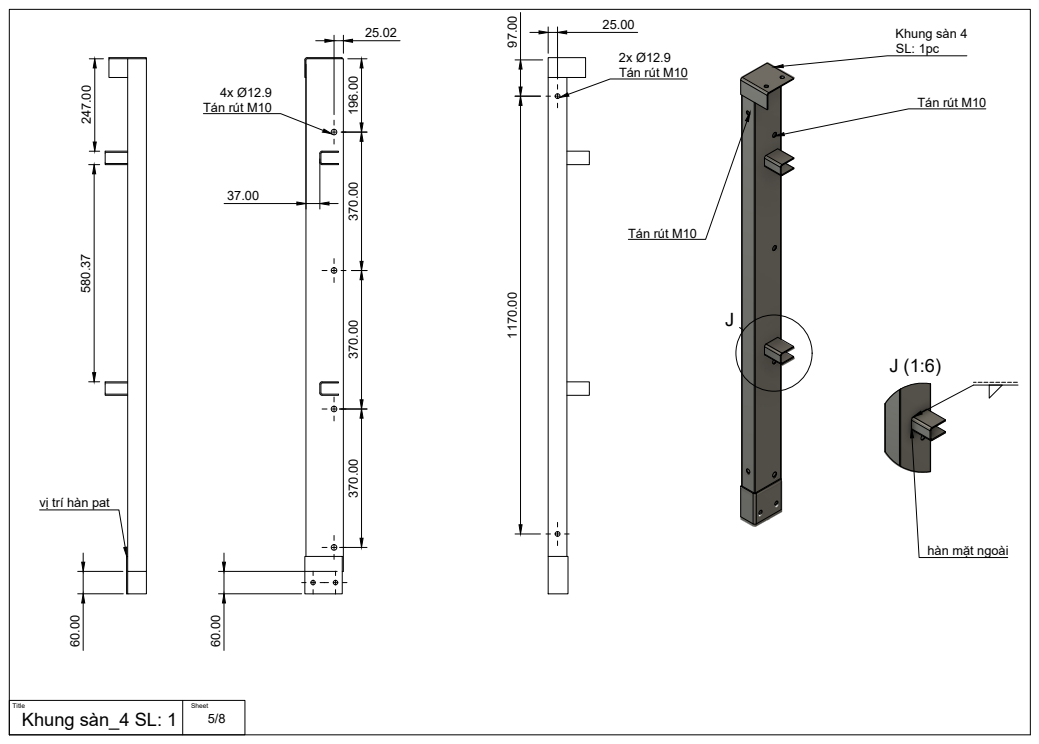
[picture p94: page 5]
Tán rút M10 247.00; 2x Ø12.9 Tán rút M10; Khung sàn 4; Tán rút M10; Tán rút M10 60.00; vị trí hàn pat

hàn mặt ngoài ³⁷⁰.00 370.00 580.37

E (1:5)

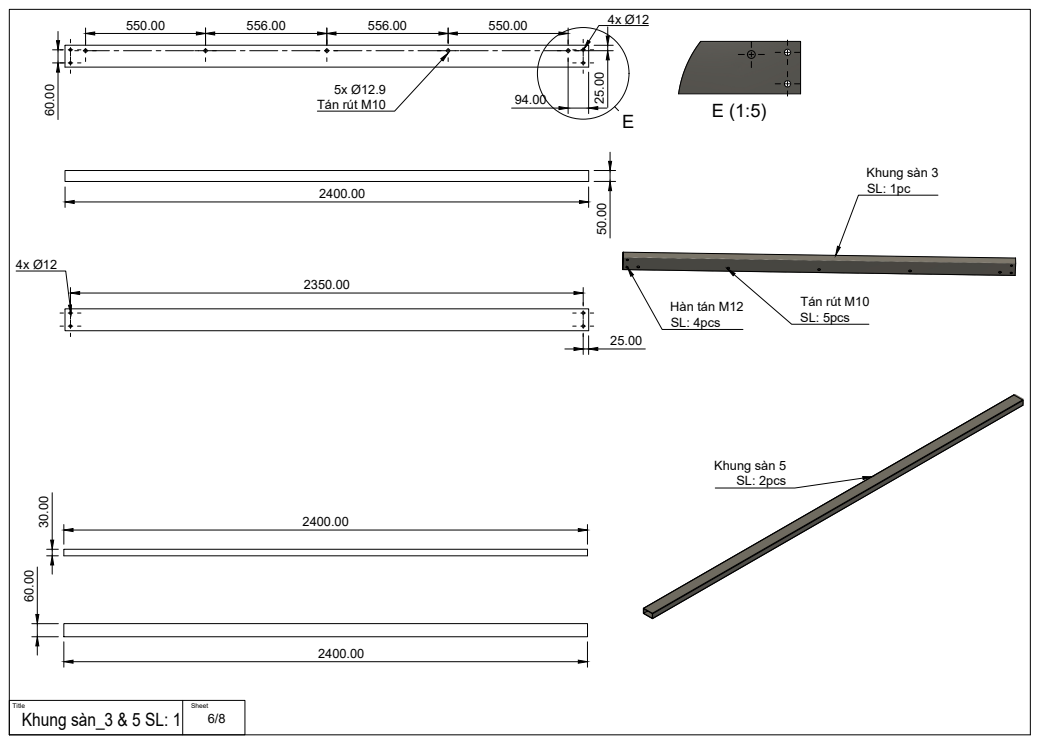
[picture p95: page 6]
Khung sàn_3 & 5 SL: 1; Khung sàn 5 SL: 2pcs; 5x Ø12.9 Tán rút M10; Tán rút M10 SL: 5pcs; Hàn tán M12 SL: 4pcs; Khung sàn 3 SL: 1pc

Pat_L | 7/8 | 30.00
2x Ø12 60.00 | 17.94

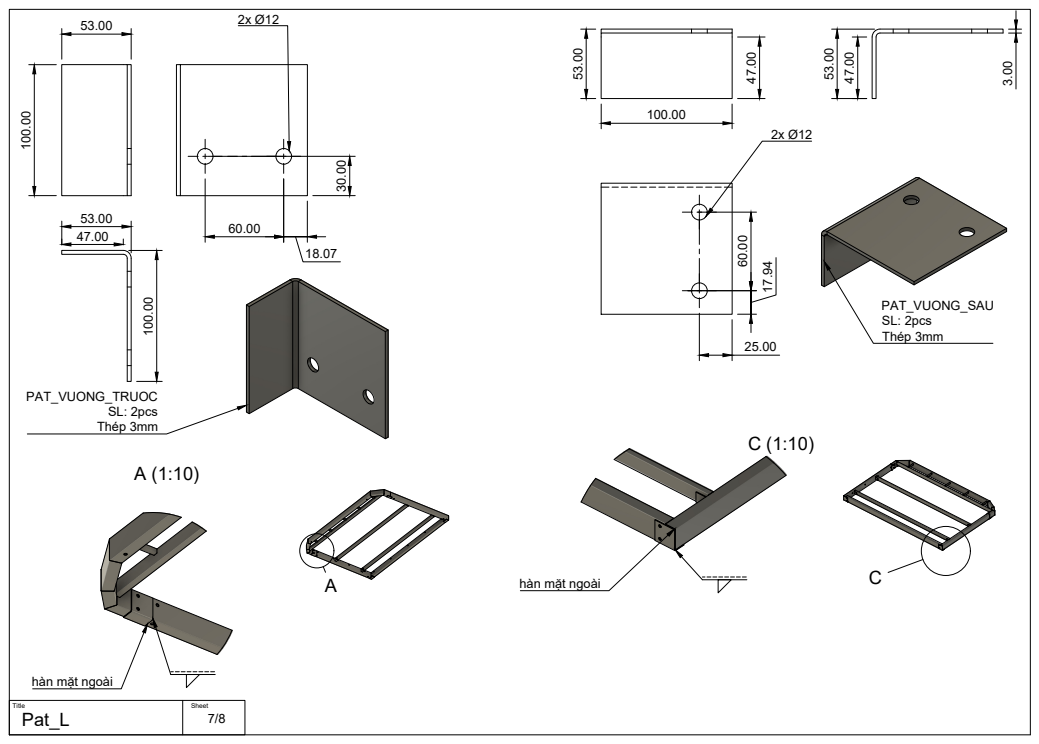
[picture p96: page 7]
PAT_VUONG_TRUOC SL: 2pcs Thép 3mm; PAT_VUONG_SAU SL: 2pcs Thép 3mm

hàn mặt ngoài

Pat_U SL: 4 | 8/8 | 24.00

60.00 36.00 50.00

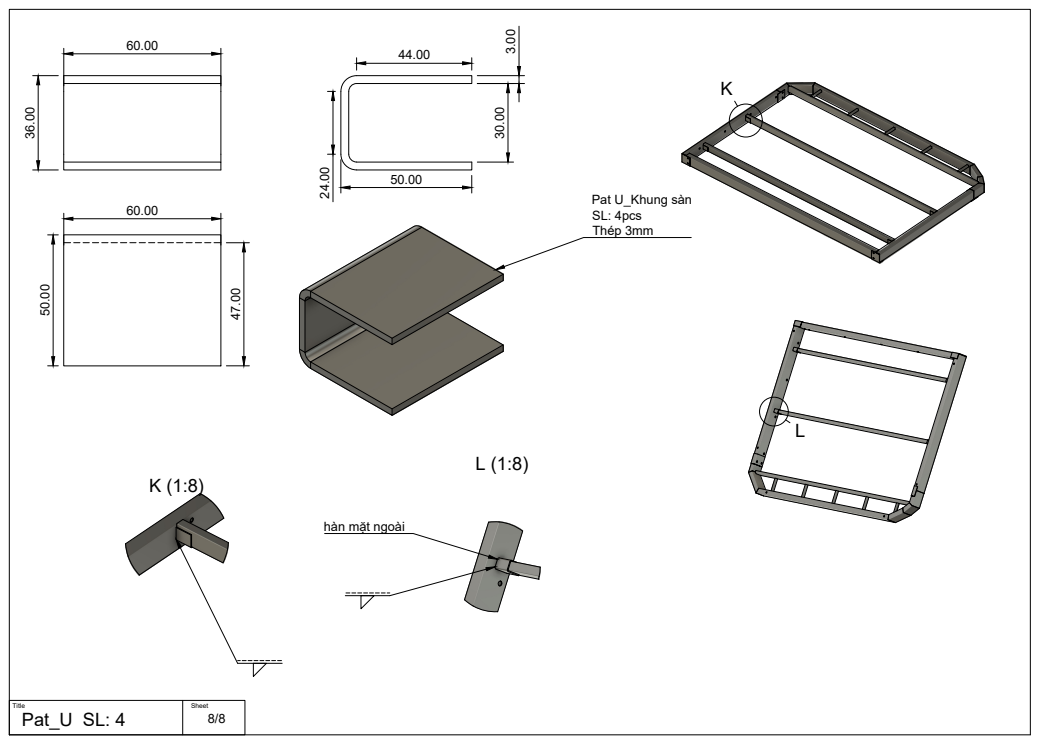
[picture p97: page 8]
Pat U_Khung sàn SL: 4pcs; Thép 3mm ³.00

hàn mặt ngoài

# 53.00 ¹⁰⁰.00 100.00

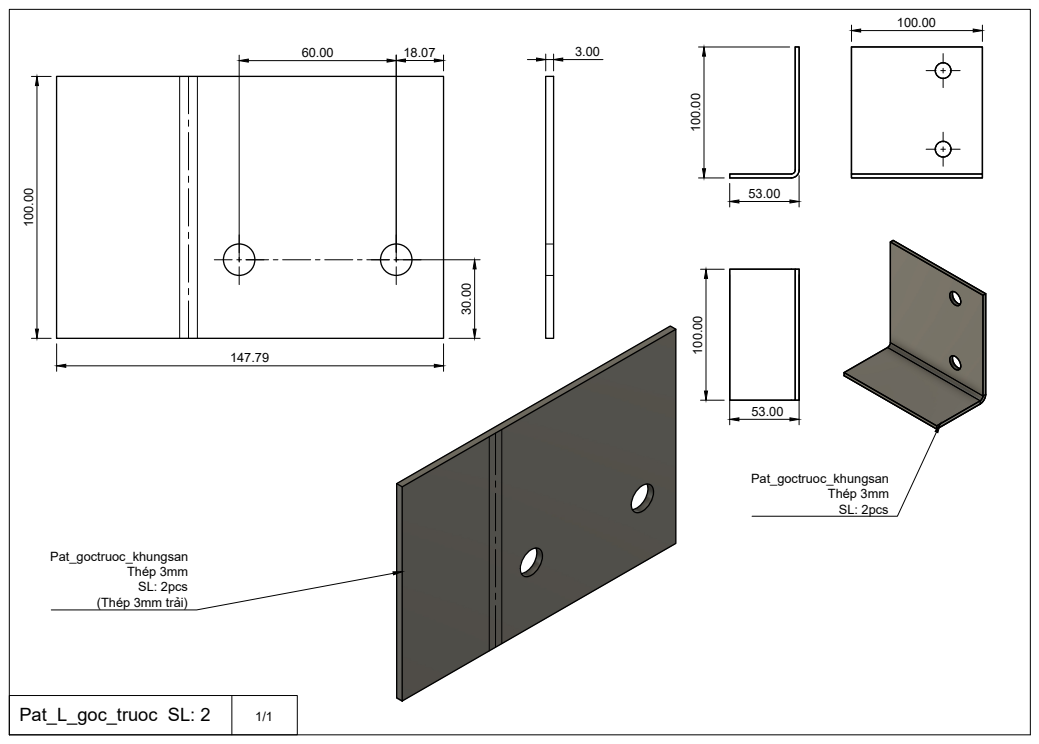
[picture p98: page 9]
Pat_L_goc_truoc SL: 2; Pat_goctruoc_khungsan Thép 3mm SL: 2pcs; Pat_goctruoc_khungsan Thép 3mm SL: 2pcs (Thép 3mm trải)

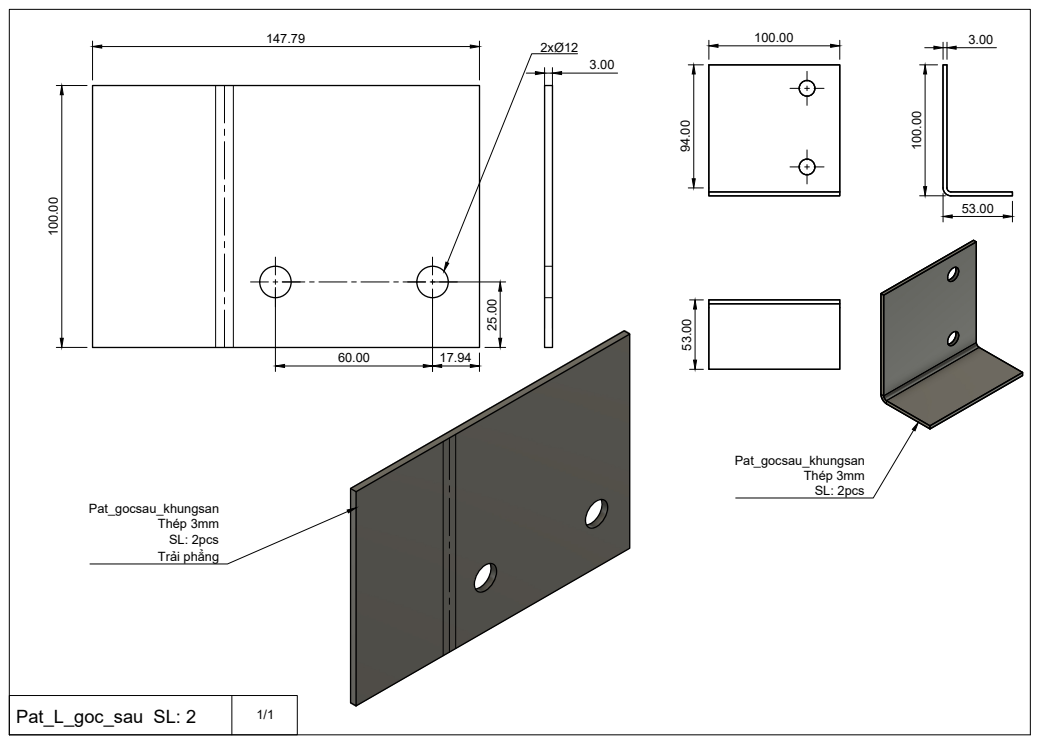
[picture p99: page 10]
Pat_L_goc_sau SL: 2; Pat_gocsau_khungsan Thép 3mm SL: 2pcs; Pat_gocsau_khungsan Thép 3mm SL: 2pcs Trải phẳng

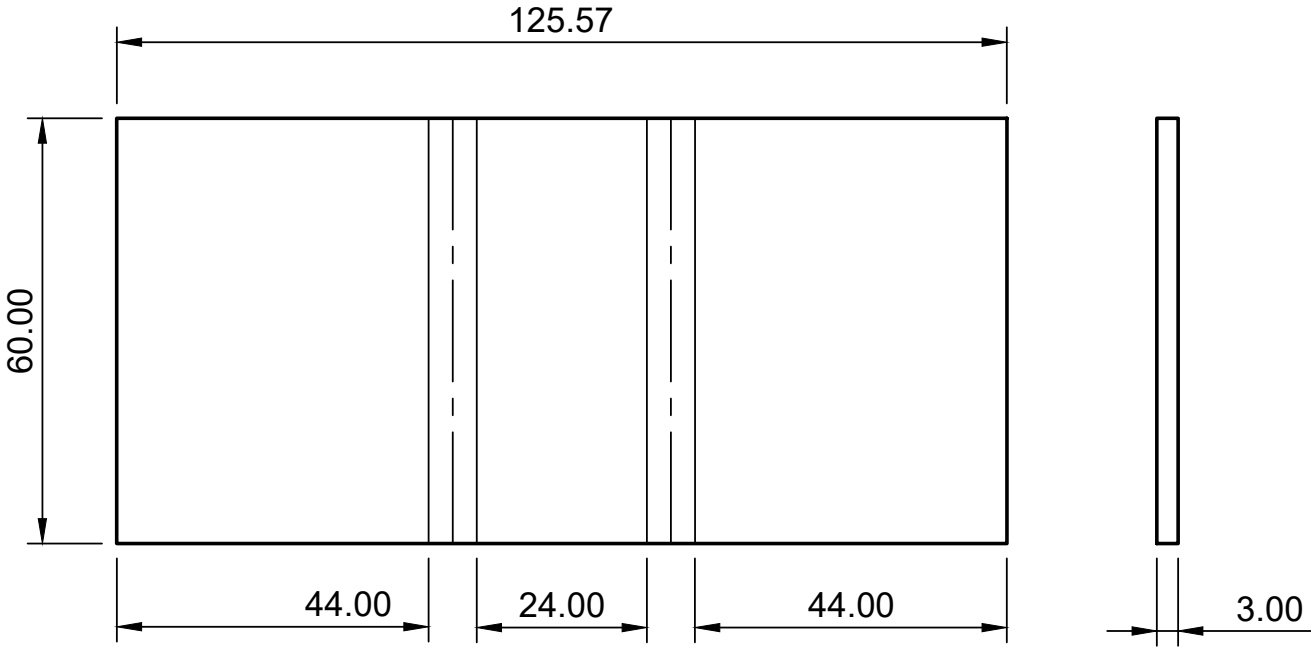
[picture p100: figure]
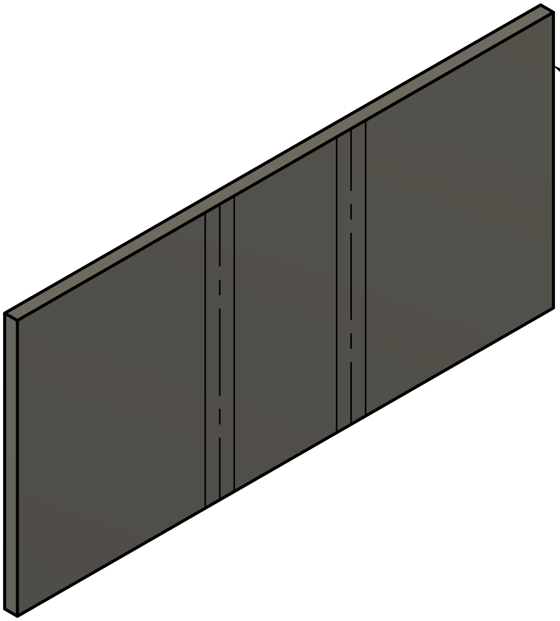
[picture p101: figure]

PAT_U SL: 4 | 1/1

30.00 50.00
60.00

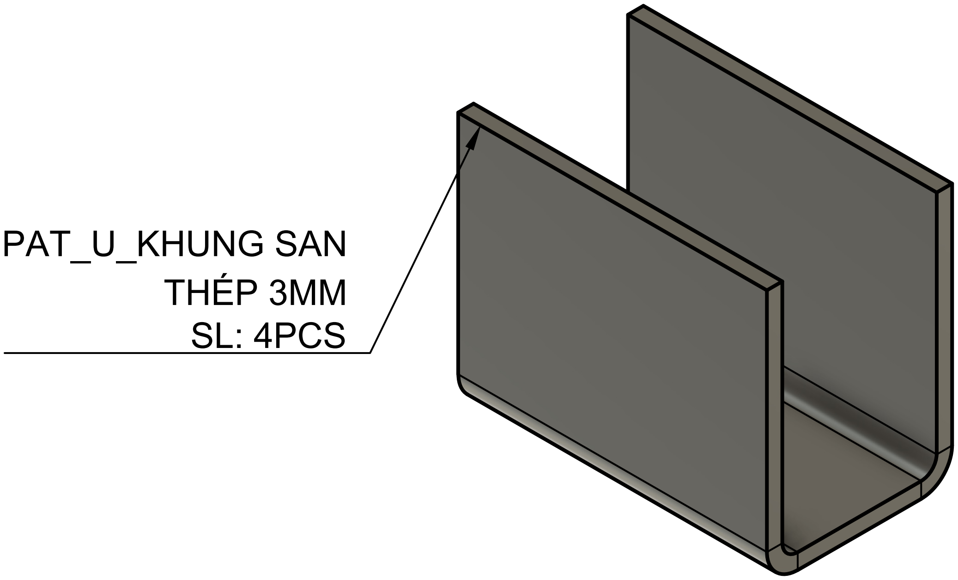
[picture p102: figure]
PAT_U_KHUNG SAN THÉP 3MM SL: 4PCS

PAT_U_KHUNG SAN
THÉP 3MM TRẢI

Pat_vach_trai SL: 1 | 1/2 | 67.00 | 320.00

# khoan lã lỗ 1430.00

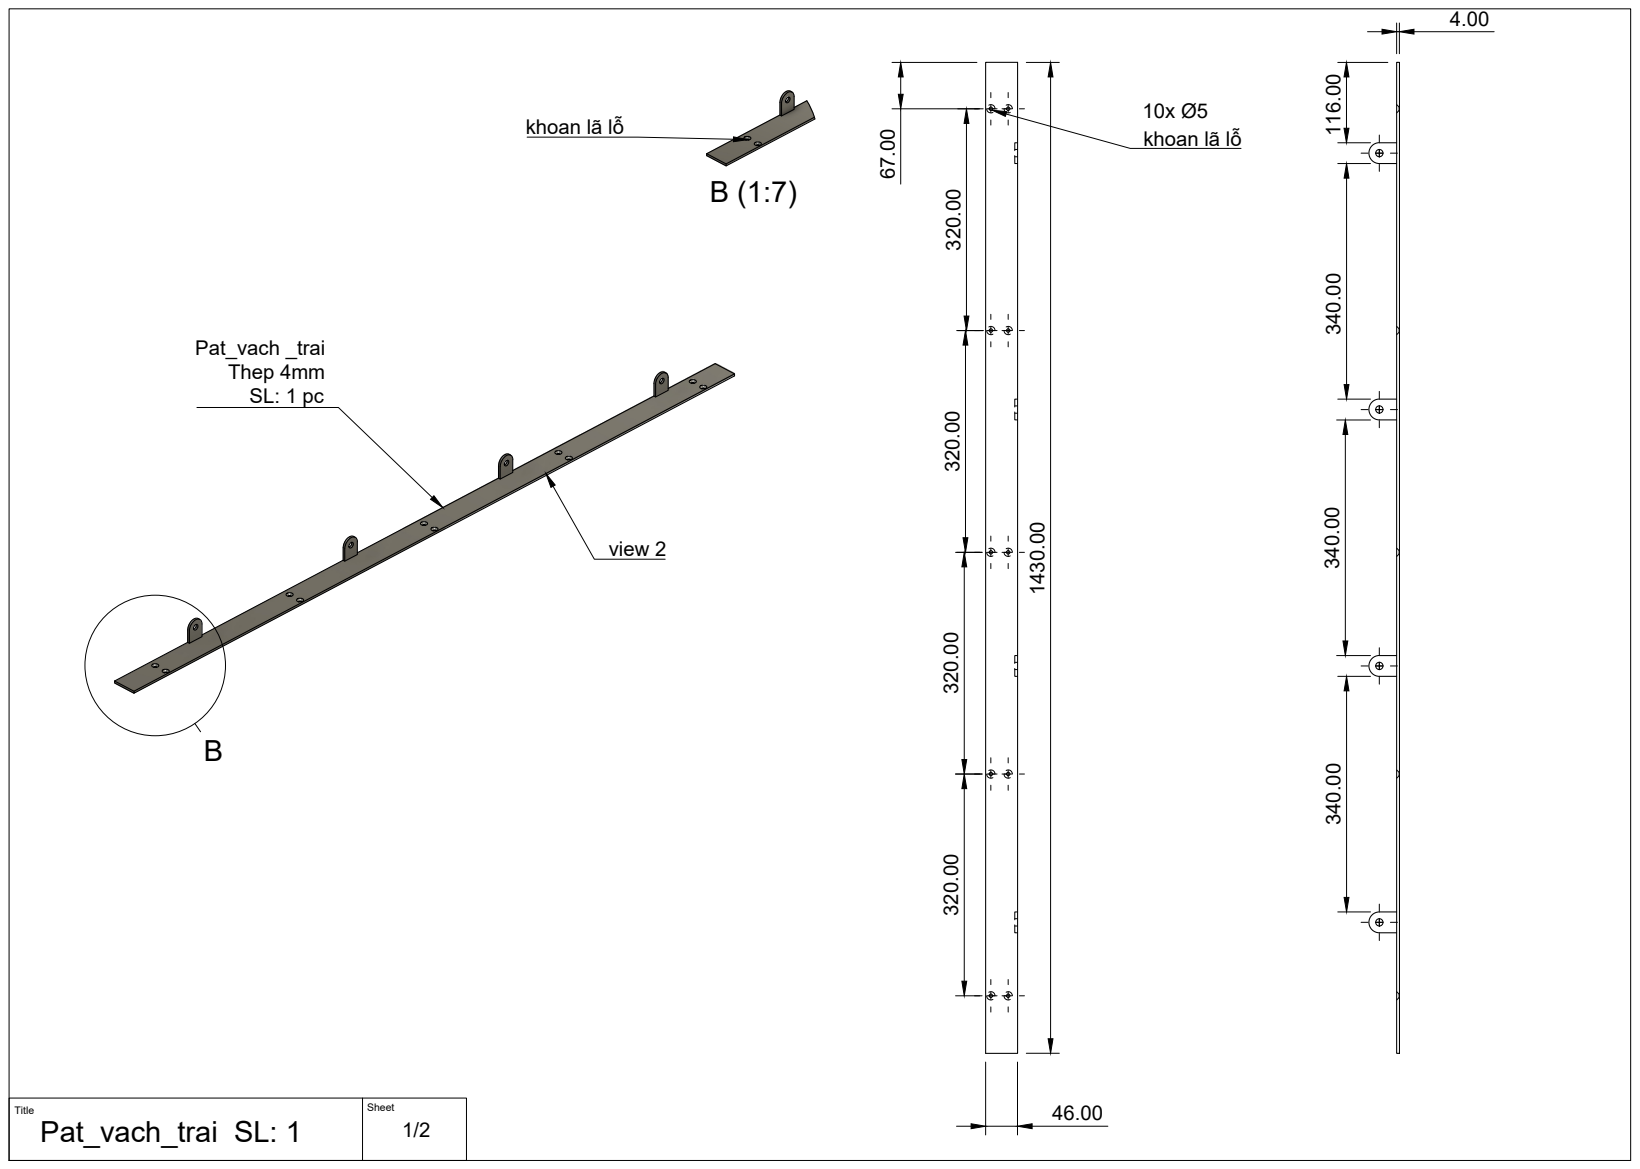
[picture p103: page 12]
view 2; Pat_vach _trai Thep 4mm

khoan lã lỗ

Pat_nho (dung chung) SL: 13 | 2/2 | 25.02
4.00⁴⁰.02

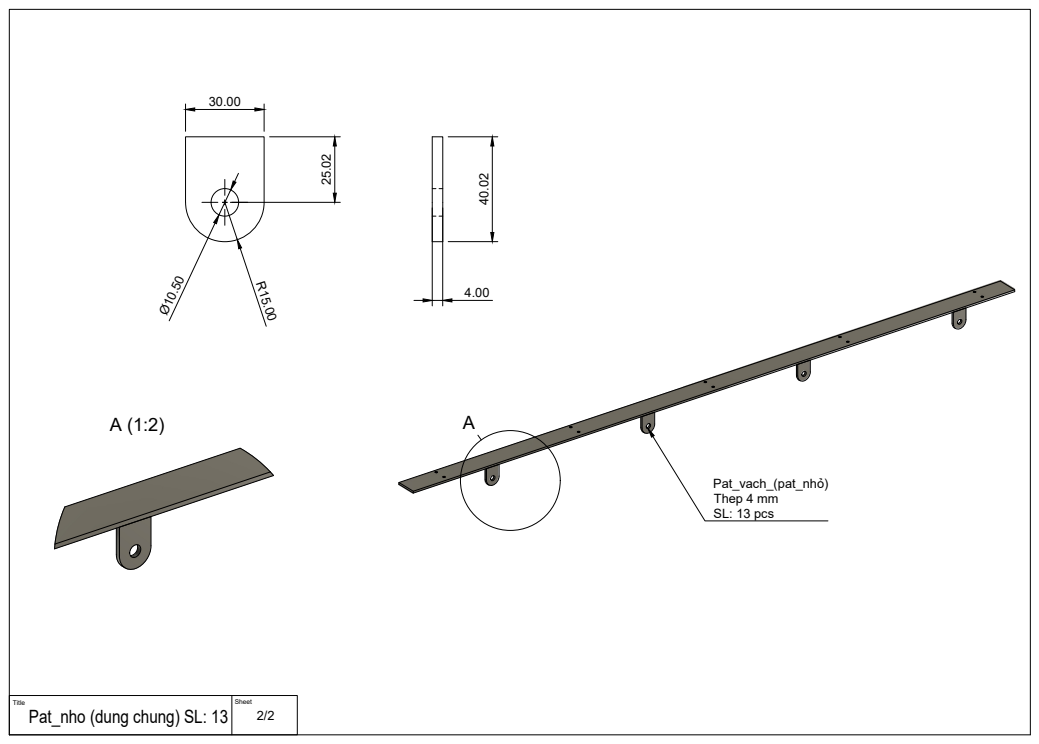
[picture p104: page 13]
Pat_vach_(pat_nhỏ) Thep 4 mm SL: 13 pcs

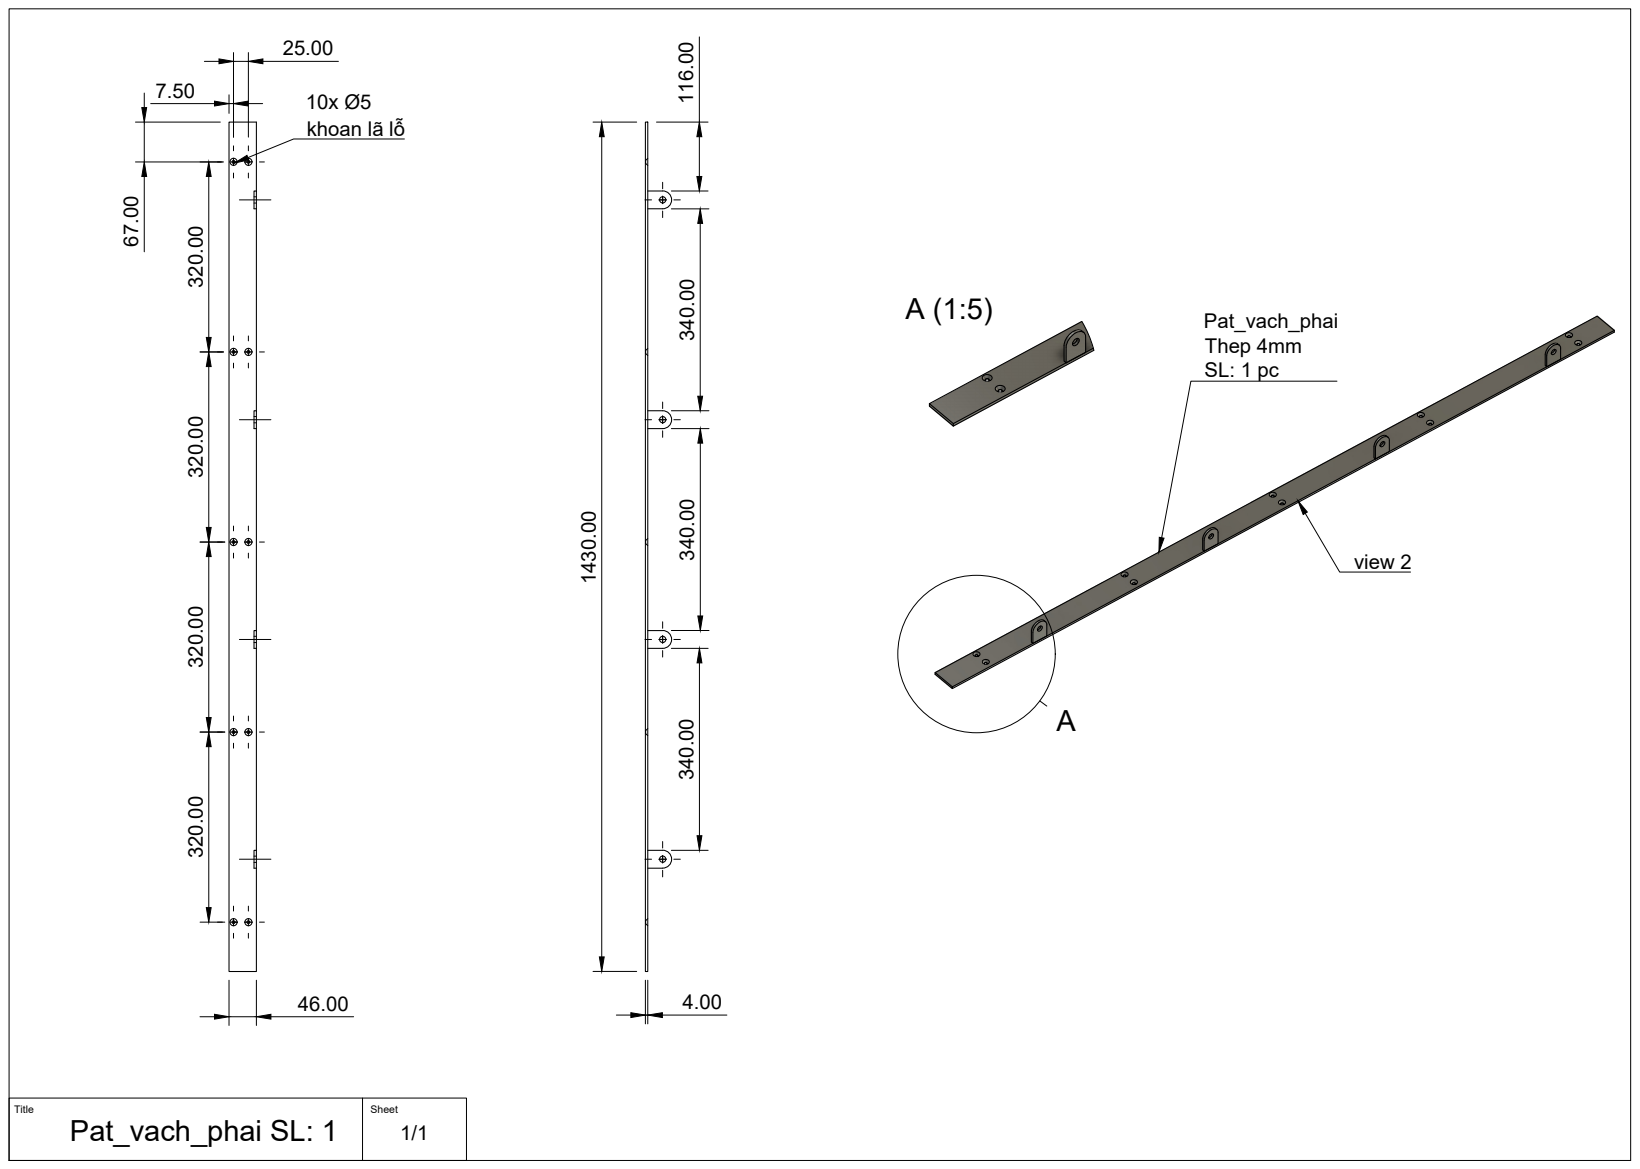
[picture p105: page 14]
Pat_vach_phai SL: 1; khoan lã lỗ 67.00; A A (1:5) ¹¹⁶.00 320.00 320.00 320.00; view 2 ³⁴⁰.00 340.00 340.00; Pat_vach_phai Thep 4mm SL: 1 pc

A (1:5)

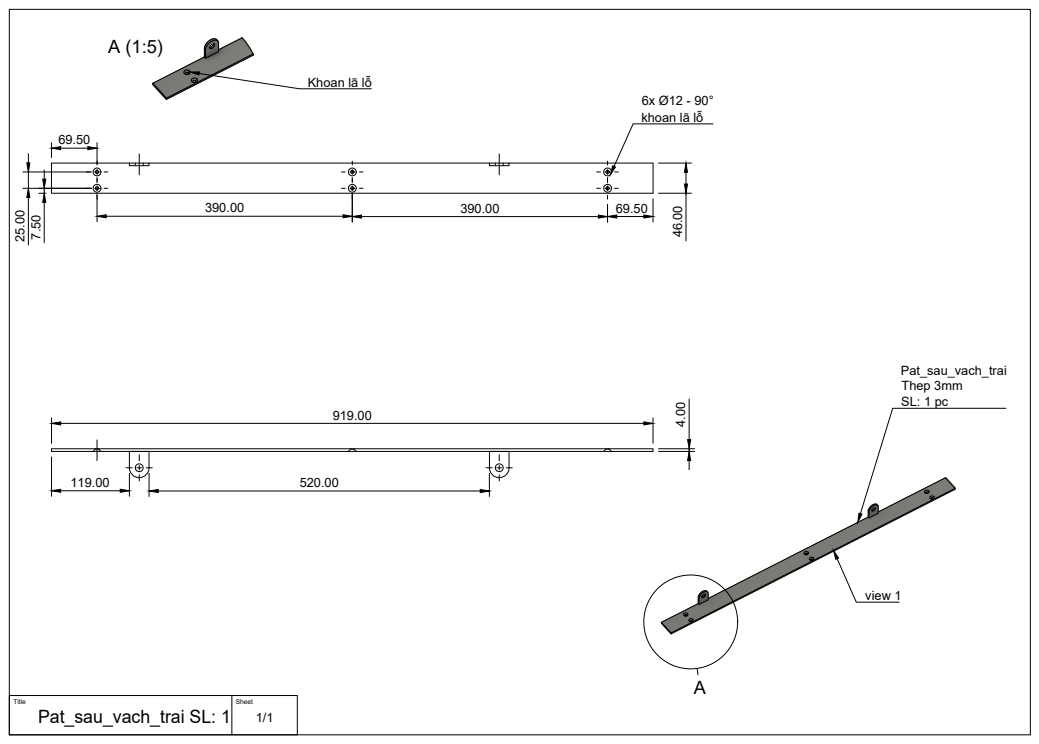
[picture p106: page 15]
Pat_sau_vach_trai SL: 1; Pat_sau_vach_trai Thep 3mm SL: 1 pc; view 1 ²⁵.00

Khoan lã lỗ

6x Ø12 - 90° khoan lã lỗ 46.00

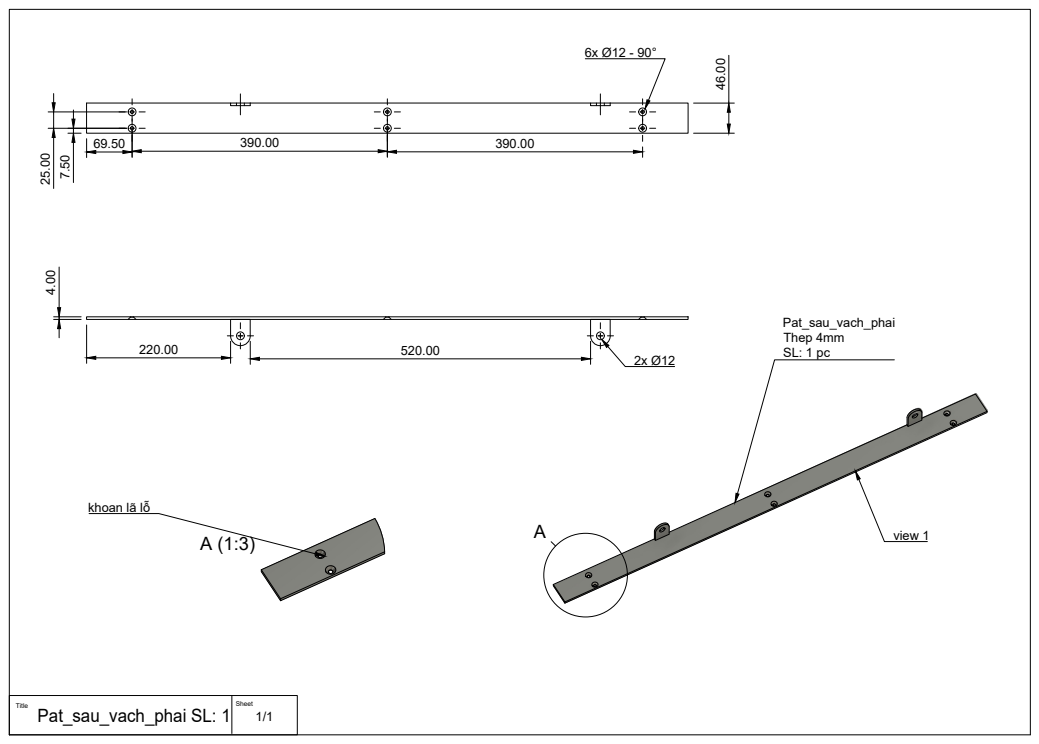
[picture p107: page 16]
Pat_sau_vach_phai SL: 1; view 1; Pat_sau_vach_phai Thep 4mm

khoan lã lỗ

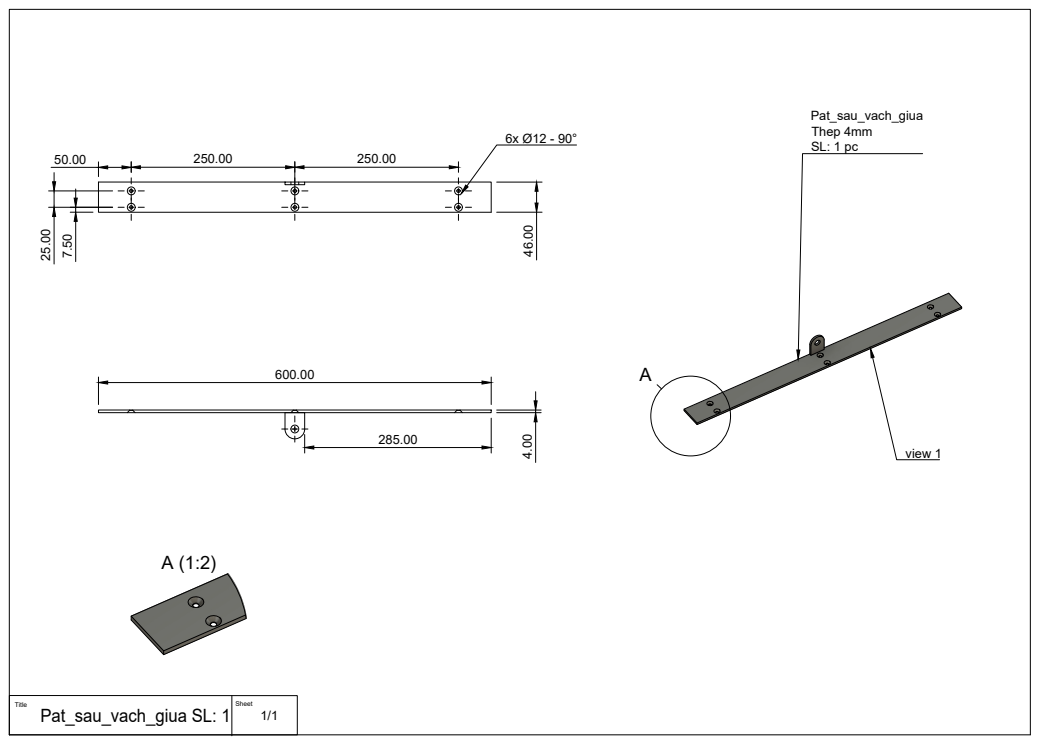
[picture p108: page 17]
Pat_sau_vach_giua SL: 1; view 1; Pat_sau_vach_giua Thep 4mm SL: 1 pc
