autonomous-ai/spaceship/v2/03-Manufacturing/wall/FILL-PIECES.md

# WALL cavity-fill pieces (D-120, D-123)

Generated by `make_fill_pieces.py` from the build scripts' formulas (bays between the frame members, 60 x 60 pockets beside every bolt the panel drives, B2's ELECTRICAL cut-outs). Sizes in mm, 40 thick, u along the wall from the bay's low corner (side walls: from the front; back walls: from the lower X), v up from the bay's bottom. Bays that one piece fits, as made or turned over, share a form: one number per form, for the master BOM to allocate.

28 bays in the 8 positions, 15 distinct forms.

| Form | Size w x h | Pockets (u, v ranges) | Bays it fills | Number |
|---|---|---|---|---|
| F01 | 344.9 x 1102.7 | u 0-60, v 170-230; u 0-60, v 521.4-581.4; u 0-60, v 872.7-932.7; u 170-230, v 0-60 | L1 bay 1, R1 bay 1 | to allocate |
| F02 | 344.9 x 1102.7 | u 156-216, v 0-60 | L1 bay 2, R1 bay 2 | to allocate |
| F03 | 344.9 x 1102.7 | u 142-202, v 0-60 | L1 bay 3, R1 bay 3 | to allocate |
| F04 | 334.9 x 1102.7 | u 127.9-187.9, v 0-60 | L1 bay 4, R1 bay 4 | to allocate |
| F05 | 344.9 x 1082.7 | u 0-60, v 170-230; u 0-60, v 521.4-581.4; u 0-60, v 872.7-932.7; u 170-230, v 0-60 | L2 bay 1, R2 bay 1 | to allocate |
| F06 | 344.9 x 1082.7 | u 156-216, v 0-60 | L2 bay 2, R2 bay 2 | to allocate |
| F07 | 344.9 x 1082.7 | u 142-202, v 0-60 | L2 bay 3, R2 bay 3 | to allocate |
| F08 | 334.9 x 1082.7 | u 127.9-187.9, v 0-60 | L2 bay 4, R2 bay 4 | to allocate |
| F09 | 373 x 1078.6 | u 0-60, v 170-230; u 0-60, v 509.3-569.3; u 0-60, v 848.6-908.6; u 170-230, v 0-60 | B1 bay 1, B2 bay 3 | to allocate |
| F10 | 373 x 1078.6 | u 30-90, v 0-60; u 283-343, v 0-60 | B1 bay 2, B2 bay 2 | to allocate |
| F11 | 373 x 1078.6 | u 143-203, v 0-60 | B1 bay 3 | to allocate |
| F12 | 373 x 1078.6 | u 0-60, v 170-230; u 0-60, v 509.3-569.3; u 0-60, v 848.6-908.6; u 68.2-373, v 733.7-1001.7; u 85.2-137.2, v 168.7-254.7; u 117.2-137.2, v 168.7-733.7; u 170-230, v 0-60 (ELECTRICAL cut-outs (power unit, sleeve, inlet and LAN)) | B2 bay 1 | to allocate |
| F13 | 373 x 1078.6 | u 0-60, v 170-230; u 0-60, v 509.3-569.3; u 0-60, v 848.6-908.6; u 170-230, v 0-60; u 170-230, v 1018.6-1078.6 | B3 bay 1, B4 bay 1, B4 bay 3 | to allocate |
| F14 | 373 x 1078.6 | u 30-90, v 0-60; u 30-90, v 1018.6-1078.6; u 283-343, v 0-60; u 283-343, v 1018.6-1078.6 | B3 bay 2, B4 bay 2 | to allocate |
| F15 | 373 x 1078.6 | u 143-203, v 0-60; u 143-203, v 1018.6-1078.6 | B3 bay 3 | to allocate |
