autonomous-ai/spaceship/v2/02-Drawings/electrical/710000_P01_ELECTRICAL-WIRING-DIAGRAM-SHEET3_IMG.png

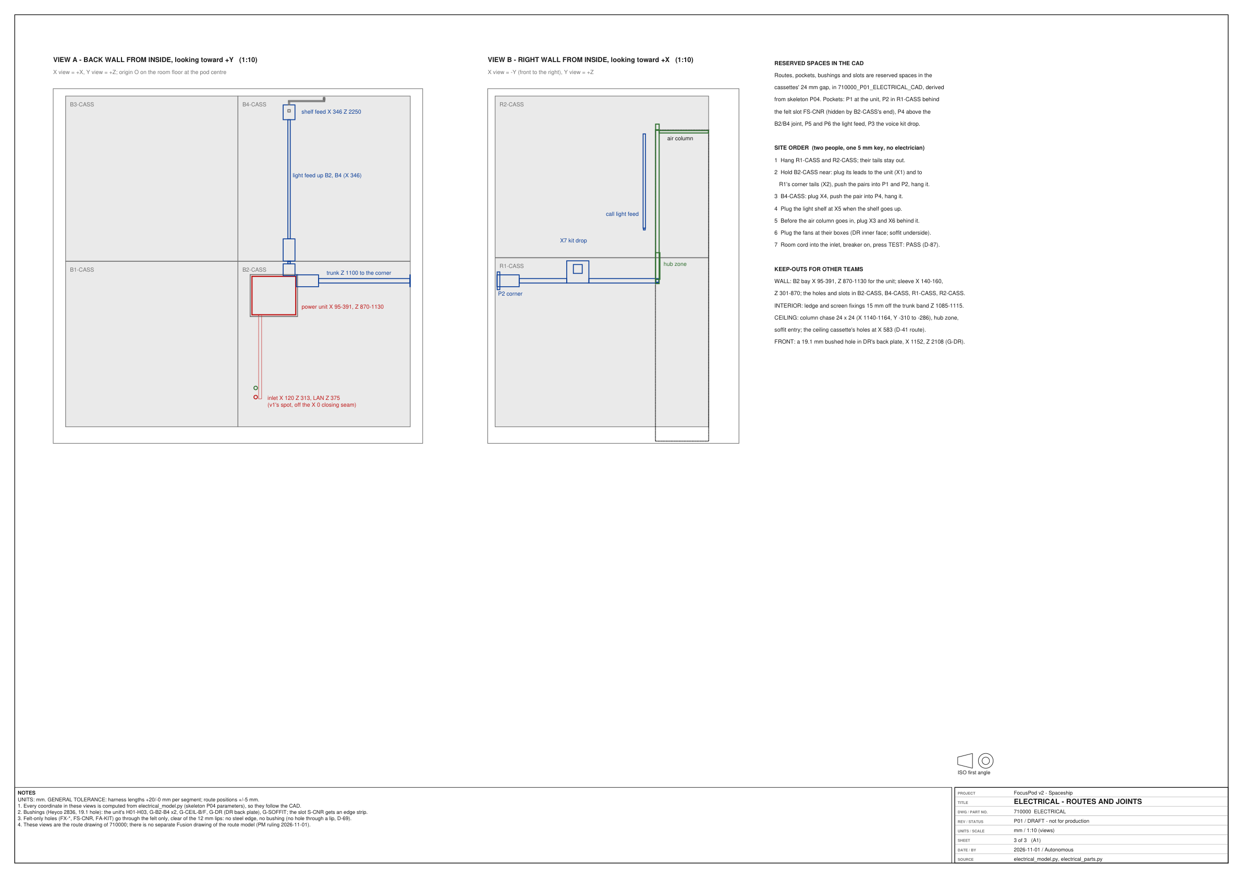
v2/02-Drawings/electrical/710000_P01_ELECTRICAL-WIRING-DIAGRAM-SHEET3_IMG.png
