autonomous-ai/spaceship/v2/06-Verification/fai-plan.md

# First-article inspection plan: Spaceship (FocusPod v2)

| Doc code | Revision | Status | Date | Owner |
|---|---|---|---|---|
| V2-VER-001 | P01 | DRAFT: a plan, no result yet | 2026-11-01 | Control pack |

What to inspect on the first article of each made part and assembly, the functional checks on the first pod, and the test that accepts each bought part. Guideline §10: an FAI line traces to a drawing characteristic (part and revision, characteristic ID, nominal, limits, unit, datum, method and gauge, result, conclusion, evidence). This is the plan: every result is empty and every line is **PLANNED**, not passed.

- **IDs.** Each characteristic gets an ID here (K-J01 and so on). When the part's drawing exists, its balloon carries the same ID, and the drawing's own tolerance governs.
- **Limits.** A limit is written only where a source sets it, with its status. Where none does, the line says "set on the drawing", because §10 forbids inventing numbers to fill a table.
- **Applies to.** Part numbers or number patterns in backticks (x is any digit). The release checklist (`v2/00-Control/release-checklist.md`) reads them to list each part's characteristics and each bought part's test.
- **Units.** mm, kg and N unless a line says otherwise.
- **Sample.** One of each part number, the first article, unless a line says otherwise; a joint or seam check covers every one on the first pod (assumption: first-article practice, which the guideline doesn't size; a drawing or the PM may raise it).
- **Pending.** A limit that waits on the part's drawing says "pending: set on the drawing", with HOLD and the reason in its status. It is never filled with a number the sources don't give.

## A. Site joints and frames

| ID | Applies to | Characteristic | Nominal | Limits | Datum | Method and gauge | Sample | Source and status | Result | Conclusion | Evidence |
|---|---|---|---|---|---|---|---|---|---|---|---|
| K-J01 | `2111xx` `2112xx` `4111xx` `1111xx` `11120x` | Bolt clearance hole diameter | Ø7.0 | pending: set on the drawing (HOLD) | — | pin gauges, go and no-go | 1 of each number (the first article) | DECIDED (D-64, joints register R-J6) |  | PLANNED |  |
| K-J02 | `2111xx` `2112xx` `4111xx` `1111xx` `11120x` | Bolt hole position from the spigot hole | 0 | Ø0.4 (±0.2) | the spigot hole | CMM, or the drill jig's check fixture | 1 of each number (the first article) | DECIDED (D-64, R-J6); calculation (stack ST-03: 0.05 to spare) |  | PLANNED |  |
| K-J03 | `2111xx` `2112xx` `4111xx` | Spigot hole and slot; the decor blocks' pin slots | Ø8.5; slot 8.5 × 14, the side panels' back-end slots 8.5 × 16 (D-167); DL's pin slots 8.5 × 12 along Z in L1's front member (D-169) | the side panels' back-end slots ±4 along the slot (D-167); the rest pending: set on the drawing (HOLD) | — | pin gauge Ø8.5; slot gauge | 1 of each number (the first article) | DECIDED (D-64, D-167, D-169) |  | PLANNED |  |
| K-J04 | `2111xx` `2112xx` `4111xx` `1111xx` | Rivnut hole | Ø9.53 | +0.10 / 0 | — | pin gauges | 1 of each number (the first article) | source (maker's data, joints register H-03) |  | PLANNED |  |
| K-J05 | `2111xx` `2112xx` `4111xx` `1111xx` | Frame flatness at the joint faces: each seam face flat within 0.5; the welded frames (D-131) also with their skin-side faces within ±0.5 of one plane, lying free, and diagonals equal within 1.5, checked after welding and before the holes | 0 | 0.5 flatness over each seam face; ±0.5; diagonals within 1.5 | the joint face | flat table, straightedge and feeler gauge; tape for the diagonals | 1 of each number (the first article); the factory checks every frame | DECIDED (seam faces flat within 0.5, the Lead's review of D-131); proposed (the skin-side plane and the diagonals, the joints register's J-FRAME-01) |  | PLANNED |  |
| K-J06 | `2111xx` `2112xx` `4111xx` | Tube wall through the zinc (D-131, J-FRAME-01): 1.2 for the side panels' rails and front stiles; 1.0 for every other perimeter member, every 40 × 40 and every member with a site joint (the ceiling's cross member 1 too); 0.8 for the studs and the ceiling's cross members 2 and 3 | 1.2 / 1.0 / 0.8 | 95% of nominal or more: 1.14 / 0.95 / 0.76 | — | micrometer on every wall of 3 tubes a lot | 1 of each number (the first article); 3 tubes a lot | DECIDED (D-131's gauges, set by the Joints Engineer's check; 1.2 for the side panels, the PM's ruling); source (the 95% rule, the joints register's J-FRAME-01) |  | PLANNED |  |
| K-J07 | `831001` | Locating spigot diameter and stand | Ø8; 8 proud | pending: set on the drawing (HOLD) | the rivnut face | micrometer; height gauge | 1 of each number (the first article) | PROPOSED sizes (joints register H-05, assumption) |  | PLANNED |  |
| K-J08 | `831002` | Stop washer thickness | 1.5 | ±0.05 | — | micrometer | 1 of each number (the first article) | PROPOSED part; assumption tolerance (joints register H-08) |  | PLANNED |  |
| K-J09 | `210xxx` `410xxx` | Seam gap at a stopped seam, assembled | 2.26 | 2.13–2.39 | — | feeler gauges | every stopped seam on the first pod | DECIDED (D-64); calculation (joints register stack: washer 1.5 + rivnut head 0.76); J-T3 accepts 2.26 ±0.15 |  | PLANNED |  |
| K-J10 | `210xxx` `410xxx` | Closing gap at B1–B2, B3–B4 and C1–C2, assembled | 5.5 | ±0.3 (5.2–5.8) | — | feeler or taper gauge | the three closing seams on the first pod | DECIDED (D-65); calculation (stacks ST-02 and ST-04) |  | PLANNED |  |
| K-J11 | `210xxx` `410xxx` | Gasket squeeze at a stopped seam: the 848001 strip, 4.78 free (D-167) | 53% | 44–60% at the stops; at least 37% between bolts | — | micrometer on the free strip, then the seam gap | every stopped seam on the first pod | DECIDED (D-167); calculation (joints register: stop 2.13–2.39, the strip's ±10% from its maker; the Joints Engineer's rerun at 4.78) |  | PLANNED |  |
| K-J12 | `210xxx` `410xxx` | Fit-up force per edge, sliding past a seal by hand, overhead included | — | ≤ 150 | — | push-pull force gauge on the panel edge | every panel edge on the first pod | DECIDED (joints register R-J17); test J-T5 |  | PLANNED |  |
| K-J13 | `210xxx` `410xxx` `110xxx` | Bolt thread past the rivnut's far end (838001, 838002) | 2.28 | ≥ 1.9 | — | depth gauge on a coupon | the T06 coupons (10, an assumption in the test plan) | calculation (joints register; bolt length tolerance js15, unverified) |  | PLANNED |  |
| K-J14 | `210xxx` `410xxx` `110xxx` | A head washer (838004) under every bolt head | 1 per bolt | — | — | visual count | every bolt on the first pod | DECIDED (D-63, R-J10) |  | PLANNED |  |
| K-J15 | `210xxx` `410xxx` | Outside faces flush across a seam | 0 | within 0.5 | — | straightedge and feeler gauge | every seam on the first pod | assumption (joints register tests J-T3, J-T5) |  | PLANNED |  |
| K-J16 | `2111xx` `2112xx` `4111xx` | Hidden frame tubes, welded galvanized steel box tube with the same outside sections (D-131): certified yield 280 MPa or more (for example S280GD+Z to EN 10346 or SGC400 to JIS G3302, or any grade with 3 tensile tests from the lot's flat walls, ISO 6892-1), pre-galvanized with a Z100 coating (100 g/m² of zinc on both faces together, for indoor use), zinc-rich paint on the welds and no hot-dip after welding; the gauges and walls as K-J06 (the Joints Engineer's check; they were 6063-T6 aluminium, D-79) | 1.2 / 1.0 / 0.8 | yield ≥ 280 MPa by the mill certificate or 3 tensile tests; the coating Z100 or more, as certified | — | the mill certificate (yield and coating) or 3 tensile tests (ISO 6892-1); visual of the weld paint | 1 of each number (the first article) | DECIDED (D-131); source (the Joints Engineer's check) |  | PLANNED |  |
| K-J17 | `2111xx` `2112xx` `4111xx` | Frame member joints, welded (D-131, J-FRAME-01): each corner mitred with a 2.0 mm plate welded into the mitre (831007 to 831009), the members cut back so the outside sizes stay (1.41 off each member at a 45° corner; 2.24 off the rail and 1.12 off the 40 × 40 at a mixed corner); every corner and T joint welded all round, continuously, in a jig; no hot-dip and no vent holes; every joint hole and rivnut made after welding; the burnt zinc touched up with zinc-rich paint. It replaces D-117's cleats | a 2.0 plate in every mitre; welds all round | no corner without its plate; no gap or open tube end; the holes after welding as K-J05 and the joint datums | the joint face | visual and a plate count on every joint; the welding procedure proved by the sample's T16 (J-T7) first | every joint on the first pod | DECIDED (D-131: welded corners and T joints); proposed (the plates, the welding, the touch-up and the holes after welding, the joints register's J-FRAME-01; T16 proves the welding first, the register's HOLD-22) |  | PLANNED |  |
| K-J18 | `2121xx` `2122xx` `2123xx` `2124xx` `2125xx` `2126xx` `2127xx` `3521xx` `3522xx` `3523xx` `4120xx` `4121xx` `4122xx` | D-120 frame members, each tube of a welded frame by its own number: its cut length and both end-cut angles, as its row in its frame's list or cut list gives them | the row's length and its two end cuts | cut length ±0.5; each end-cut angle ±0.25° | the member's own end | tape; protractor or the saw's angle check | 1 of each number (the first article) | DECIDED (D-120: one number a member); assumption (±0.5 as K-P07's cut length and ±0.25° as the corner keys' cut angle, J-BASE-02, until the frame drawings set them) |  | PLANNED |  |
| K-J19 | `838003` `212205` | Rivnut pull-out: 838003 (Sherex CAL2-610-4.2) set in a real 0.8 stile, as R1's middle stiles take INTERIOR's ledge brackets, pulled straight out of the tube wall | 0.95 kN | ≥ | — | pull test on coupons of the 0.8 stile tube, each rivnut set with the production tool | 5 coupons (assumption) | DECIDED (the PM's ruling of 2026-11-01 in CEILING's group: a bracket's top fixing pulls about 0.95 kN with the factor 3, calculation); Sherex publishes no pull-out for the CAL2, so it is also on the RFQ list; another maker's average for the same type in 0.76 steel is 2.3 kN (source, AVK's catalogue) |  | PLANNED |  |
| K-J20 | `211701` `211801` `838012` | The cassette ledge's closed-end countersunk rivets (838012) sit flush in the 1.5 upright's machined countersinks and clear the cassette tray's back | flush; 0.40 clear at the worst case | no head proud of the upright's face; never touching the tray | the upright's face | straightedge and feeler gauge over each head; trial fit of the lower cassette, feeler at the rivet line | every ledge rivet on the first pod | DECIDED (D-166, D-170); calculation (WALL Engineer: 0.40 at the full worst case, 1.4 on a root-sum-square) |  | PLANNED |  |

## B. Outer panels and skins

| ID | Applies to | Characteristic | Nominal | Limits | Datum | Method and gauge | Sample | Source and status | Result | Conclusion | Evidence |
|---|---|---|---|---|---|---|---|---|---|---|---|
| K-P01 | `210xxx` | Outer panel size: side panels 1492.74 × 1142.74; back panels 1200.61 × 1118.61, frames 1198.99 wide at the closing seams | as stated; 46 thick | pending: set on the drawing (HOLD) | the panel's spigot hole | steel tape and caliper; height gauge for the thickness | every one on the first pod | calculation (skeleton P04, PRs #24 and #58; D-66) |  | PLANNED |  |
| K-P02 | `410xxx` | Ceiling half size | 1200.61 × 1495 × 46 | pending: set on the drawing (HOLD) | the spigot hole | steel tape and caliper | every one on the first pod | calculation (skeleton P04; D-66) |  | PLANNED |  |
| K-P03 | `2113xx` `2114xx` `4113xx` | ACP skin bonded flat: a 3 mm bond line of Sikaflex-252, each face first given an abrasive pad and clean, Sika Aktivator-205 and Sika Primer-210 (D-137; the bond spec's section 8), and the skin's flatness | 3 | 3 ±0.5 (the bond spec's section 4); flatness set with the bond spec | — | straightedge and feeler; the pre-treatment record; the bond spec's T09 coupons | 1 of each number (the first article) | DECIDED (D-66, D-137); source (bond spec, sample test T09) |  | PLANNED |  |
| K-P04 | `2113xx` `2114xx` `4113xx` | Skin colour Dark Yellow EV3038 | EV3038 | match the approved sample | — | visual, against the sample, under daylight | 1 of each number (the first article) | DECIDED (D-12) |  | PLANNED |  |
| K-P05 | `2115xx` `2116xx` `5133xx` | Cavity fill density | 24 kg/m³ | the maker's data | — | weigh a cut piece and measure it | 1 cut piece from the first batch | DECIDED (D-81); the wall sample's T02 confirms it |  | PLANNED |  |
| K-P06 | `411302` | Roof slot in skin C2 for AIR's roof sleeve (D-61), routed | 285 × 294 | position from the closing-seam edge and the front edge ±0.5 (row, critical: the roof sleeve passes through it); other sizes ISO 2768-m (row) | the closing-seam edge and the front edge | tape and caliper from both edges; trial fit of the roof sleeve 611601 once AIR's part exists | 1 of each number (the first article) | source (CEILING's parts list, PR #32); DECIDED (D-61); no drawing (D-89 part 4): its DXF is the outline |  | PLANNED |  |
| K-P07 | `411101` `411102` | D-131: welded galvanized steel box tube with the same outside sections, in the Joints Engineer's steel and gauges (K-J16); until the team re-lists: Ceiling frames C1 and C2: 6063-T6 tubes cut to length, 1198.99 × 1495 × 40 | 1198.99 × 1495 × 40 | cut length ±0.5; the spigot hole to the closing face ±0.1 (stack ST-04); the holes from the round spigot hole as K-J02 (row) | the round spigot hole | tape; caliper; CMM or the drill jig's check fixture | 1 of each number (the first article) | source (CEILING's parts list, PR #32; joints register R-J6, ST-04); member joints by cleats (D-115, K-J17) |  | PLANNED |  |
| K-P08 | `2113xx` `2114xx` | The first V-grooved fold of each batch (D-161): a test fold on the batch's own sheet, before the batch runs, confirming the blank length (the fold's 2 mm outside radius) and the core left on the outer skin | the blank as the skin's DXF; core left 0.1 to 0.5 | the folded legs to the skin's DXF (±0.5, assumption); core left 0.1 to 0.5 on the outer skin (source: the panel maker's guide No. 01/2021/HDTC-VD, groove A); no crack in the face | the fold line | caliper and steel rule on the test fold; a section through the groove; visual of the face | the first fold of each batch | DECIDED (D-161); source (the panel maker's guide, groove A) |  | PLANNED |  |

## C. Lining cassettes

| ID | Applies to | Characteristic | Nominal | Limits | Datum | Method and gauge | Sample | Source and status | Result | Conclusion | Evidence |
|---|---|---|---|---|---|---|---|---|---|---|---|
| K-L01 | `5111xx` `5112xx` `5131xx` | Tray: 0.5 mm galvanised steel, 34 mm returns, 12 mm lips | 0.5; 34; 12 | sheet to its standard (unverified); returns and lips set on the drawing | — | micrometer; caliper | 1 of each number (the first article) | DECIDED (D-37, D-69) |  | PLANNED |  |
| K-L02 | `5111xx` `5112xx` `5131xx` | Inside bend radius and flat-pattern size | from the CAD flat pattern | pending: set on the drawing (HOLD) | — | radius gauge; tape on the flat blank | 1 of each number (the first article) | source (the team's sheet-metal model; CEILING's flat pattern matches its bend calculation to 0.01, PR #32) |  | PLANNED |  |
| K-L03 | `510xxx` | Cassette size: wall cassettes per skeleton P04; ceiling cassette 1160 × 1045 | as stated; 34 thick | pending: set on the drawing (HOLD) | — | steel tape and caliper | 1 of each number (the first article) | calculation (skeleton P04; D-77) |  | PLANNED |  |
| K-L04 | `5113xx` `5114xx` `5132xx` | Felt: 9 mm, 1.8 kg/m², Dark Gray | 9; 1.8 | the maker's data | — | caliper; scale on a cut piece; colour against the sample | 1 of each number (the first article) | DECIDED (D-17, D-79); unverified (felt data, ISS-075) |  | PLANNED |  |
| K-L05 | `510xxx` | Clips and catches hold (518001, 518002): each wall clip 8.3 kg in shear, each ceiling clip 8.0 kg in pull-out, each catch lanyard 48 kg | as stated | ≥ | — | pull test T07; drop test T08 | T07: 5 of each clip; T08: 3 drops (test plan, assumptions) | calculation (test plan T07, T08; safety factor 3 an assumption, ISS-076); clip and catch products HOLD-08; D-170 puts a wall cassette's weight on its ledge, so T07's wall-clip shear case is the test plan's to revise; the ceiling clip is Fastmount's PC-SF1 with PC-SVMX, 15 kg pull-out (the PM's ruling of 2026-11-01) |  | PLANNED |  |
| K-L06 | `513101` | Ceiling cassette tray: 0.5 mm galvanised steel, 1160 × 1045 × 34 with 12 mm lips; two Ø19.1 cable holes for ELECTRICAL's bushings in the front and back returns, centre 12.5 below datum A | 1160 × 1045 × 34; Ø19.1 | cut ±0.2, bent ±0.5 (row, assumption) | datum A | tape; caliper; pin gauge Ø19.1 | 1 of each number (the first article) | source (CEILING's parts list and drawing notes, PR #32; D-17, D-37; PM ruling 2026-11-01 for the holes); assumption tolerances |  | PLANNED |  |
| K-L07 | `513102` | Ceiling rib: 0.5 mm galvanised hat section 44 × 24, 1034 long, 2 per cassette | 44 × 24 × 1034 | length ±1, bends ±0.5 (row, assumption) | — | tape; caliper | 1 of each number (the first article) | source (CEILING's parts list, PR #32); rib joint HOLD |  | PLANNED |  |
| K-L08 | `513201` | Ceiling felt: 1157 × 1042 × 9, CNC knife cut; the two sprinkler zones marked, nothing cut | 1157 × 1042 × 9 | ±1 (row, assumption) | the tray's edge | tape; caliper; visual for the marks | 1 of each number (the first article) | source (CEILING's parts list, PR #32; D-17, D-31); felt fixing HOLD (H09) |  | PLANNED |  |
| K-L09 | `513301` `513302` `513303` | Ceiling fill bays A, B and C: 1110.5 long, 363.5, 338.8 and 271.8 wide, 40 thick; notches per the tabulated drawing | as stated | ±2 (row, assumption) | — | tape | 1 of each number (the first article) | source (CEILING's parts list, PR #32; D-24, D-54); density as K-P05, 24 kg/m³ (D-81), where the list still says 25 (ISS-088); fixing HOLD (H10) |  | PLANNED |  |
| K-L10 | `510301` | Ceiling cassette assembled, one part for both halves | 1160 × 1045 × 34, 74 with the fill | ±1 assembled (row, assumption) | — | tape; caliper | 1 of each number (the first article) | source (CEILING's parts list, PR #32; PM ruling 2026-10-31) |  | PLANNED |  |
| K-L11 | `510301` `518001` | One person takes a ceiling cassette down, a clip at a time, on its PC-SF1 and PC-SVMX clips with the catches fitted, and puts it back | one person | pass | — | trial by one person | the sample, then each ceiling cassette on the first pod | DECIDED (the PM's ruling of 2026-11-01 in CEILING's group: with no surface-mount male near 10 kg, the clip is the 15 kg PC-SVMX and the sample checks a one-person removal; D-47) |  | PLANNED |  |

## D. Front

| ID | Applies to | Characteristic | Nominal | Limits | Datum | Method and gauge | Sample | Source and status | Result | Conclusion | Evidence |
|---|---|---|---|---|---|---|---|---|---|---|---|
| K-F01 | `361001` `361003` | Glass: 4+4 laminate of toughened, heat-soaked panes | 8.76 | the glass standard (supplier) | — | micrometer; the toughening and heat-soak certificates | 1 of each number (the first article) | DECIDED (D-46, D-82); product HOLD (ISS-074) |  | PLANNED |  |
| K-F02 | `361001` `361003` | Glass outline against its DXF | the DXF | pending: set on the drawing (HOLD) | the bottom edge | full-size template or tape against the DXF | 1 of each number (the first article) | source (v1 STEP outline via skeleton P04) |  | PLANNED |  |
| K-F03 | `360002` | Fixed glass free edge to the door: gap, parallel | 4.0 | pending: set on the drawing (HOLD) | the door's edge | feeler gauges at the top, middle and bottom | every one on the first pod | DECIDED (D-68, D-74); PR #28 measured 4.00 in CAD |  | PLANNED |  |
| K-F04 | `360002` | Glass depth in its hidden U-channels | 11.5 | pending: set on the drawing (HOLD) | — | depth gauge before glazing | every one on the first pod | DECIDED (D-68) |  | PLANNED |  |
| K-F05 | `361002` | Kick strip running gap: the drop seal closes on the room floor (D-132); it was 7 over the 13 mm threshold (D-72) | per FRONT's update | pending FRONT's update (HOLD) | the room floor | feeler gauges | 1 of each number (the first article) | DECIDED (D-68, D-72); limits from the mechanical check's gap rule (`v2/04-Checks/config/gap-rules.csv`); D-132 removes the threshold |  | PLANNED |  |
| K-F06 | `361002` `110xxx` `1111xx` `711002` `711005` | Black anodised, matte (the kick strip, every base band piece, and ELECTRICAL's front plate and hub cover) | ≥ 20 µm | class AA20 (EN ISO 7599) | — | eddy-current coating thickness gauge; visual against the sample | every anodised piece of the first pod | DECIDED (D-67, D-79) |  | PLANNED |  |
| K-F07 | `360001` | Door unit mass, as hung | 49.1 | weigh; the hardware is rated ≥ 60 kg | — | scale | every one on the first pod | calculation (CAD, with the hollow kick strip, D-85; the layout study's live count, PR #61); DECIDED rating (D-68) |  | PLANNED |  |
| K-F08 | `360001` | Door keep: the magnetic catch in DT holds the door | 35 N | ≥ | — | push-pull gauge at the latch corner | every one on the first pod | DECIDED (D-83); product to be named |  | PLANNED |  |

## D1. Decor block DL (FRONT, PR #105)

| ID | Applies to | Characteristic | Nominal | Limits | Datum | Method and gauge | Sample | Source and status | Result | Conclusion | Evidence |
|---|---|---|---|---|---|---|---|---|---|---|---|
| K-D18 | `350001` | DL assembled: outer shape to skeleton P04, 205 mm deep as v1 (D-49); left-hinged door side (D-19); stands on its 2 spigots on the band; ships with the hinges' frame halves fitted | 205 deep; about 12.7 kg | shape pending: set on the drawing (HOLD); mass ≤ 20 (D-03) | the 2 spigot holes | tape and caliper; trial fit on the spigots; scale | 1 of each number (the first article) | DECIDED (D-03, D-19, D-49); source (FRONT's parts list, PR #105; joints register J-FRONT-02) |  | PLANNED |  |
| K-D19 | `351101` | DL skin: flat ACP 3 mm panels, 45° mitred joints as v1, bonded to the frame, with three hinge pockets; colour Dark Yellow EV3038 | 3; EV3038 | outline per its DXF; mitres and the hinge pockets pending: set on the drawing (HOLD: the pocket sizes wait on the hinge product) | the frame | template against the DXF; visual against the approved sample; the bond spec's T09 coupons | 1 of each number (the first article) | DECIDED (D-12, D-49); source (FRONT's parts list, PR #105); hinge HOLD (D-46) |  | PLANNED |  |
| K-D20 | `351104` | D-131: welded galvanized steel box tube with the same outside sections, in the Joints Engineer's steel and gauges (K-J16); until the team re-lists: DL frame: 26 welded 6063-T6 tubes, 20 × 20 × 1.5 and the 60 × 20 × 1.5 hinge members, 11.8 m in all, per its cut list; it carries the door's load (the hinges, hinge post H1 to H3, the bolt-line post B04 with 6 holes Ø14 for the J-FRONT-01 rivnut tails); mill finish (D-79) | lengths per the cut list; Ø14 | lengths, mitres and hole positions pending: set on the frame drawing (HOLD) | the hinge post | tape; protractor; wall micrometer; pin gauge Ø14 | 1 of each number (the first article) | calculation (FRONT's cut list); DECIDED finish (D-79); source (joints register HOLD-10; ISS-045) |  | PLANNED |  |
| K-D21 | `351102` | DL back plate: 5754-H22 sheet 2.0, laser cut; 6 holes Ø9.53 for the rivnuts on X −1224, 3 per side | 2.0; Ø9.53 | Ø9.53 +0.10/0 (row); its row gives no finish or general tolerance yet (HOLD: FRONT to add them if it claims D-89 part 4) | the wall's bolt line | pin gauges; CMM or the drill fixture | 1 of each number (the first article) | source (FRONT's parts list, PR #105; joints register J-FRONT-01) |  | PLANNED |  |
| K-D22 | `351103` | Door hinge-side stop: 6063-T6 aluminium angle in 4 lengths between the hinges, screwed through DL's door-side skin into the frame's door-side tubes | frame gap 2 to 6 | the gap 2 to 6 (hardware selection C3) | the door's hinge edge | feeler gauge; caliper | 1 of each number (the first article) | source (FRONT's parts list, PR #105; hardware selection C3) |  | PLANNED |  |

## D2. Decor block DR (FRONT, PR #105)

| ID | Applies to | Characteristic | Nominal | Limits | Datum | Method and gauge | Sample | Source and status | Result | Conclusion | Evidence |
|---|---|---|---|---|---|---|---|---|---|---|---|
| K-D01 | `350003` | DR assembled: outer shape to skeleton P04, 205 mm deep as v1 (D-49); stands on its 2 spigots on its support, held by the J-FRONT-01 bolts | 205 deep; skeleton P04 shape | pending: set on the drawing (HOLD) | the 2 spigot holes | tape and caliper; trial fit on the spigots | 1 of each number (the first article) | DECIDED (D-49; joints register J-FRONT-02); drawing pending |  | PLANNED |  |
| K-D02 | `350003` `350004` | Mass as each ships: DR with its fitted glass channels and without the air supply assembly; the air supply assembly joined (D-87) | DR 18.87 as shipped with its channels (CAD: 18.32 kg plus its right and diagonal glass channels, FRONT, PR #105); air supply assembly about 14.9 | DR ≤ 19.0 (D-108); each piece ≤ 20 (D-03) | — | scale | 1 of each number (the first article) | DECIDED (D-03, D-87, D-106, D-108); calculation (DR from CAD, FRONT's build record, PR #105; 14.9 kg, the air table, D-60); ISS-087 closed on the CAD mass |  | PLANNED |  |
| K-D03 | `351301` | DR skin: flat ACP 3 mm panels, 45° mitred joints as v1, bonded to the frame; colour Dark Yellow EV3038 | 3; EV3038 | outline per its DXF; mitres pending: set on the drawing (HOLD) | the frame | template against the DXF; visual against the approved sample; the bond spec's T09 coupons | 1 of each number (the first article) | DECIDED (D-12, D-49); source (FRONT's parts list, PR #105) |  | PLANNED |  |
| K-D04 | `351306` | D-131: welded galvanized steel box tube with the same outside sections, in the Joints Engineer's steel and gauges (K-J16); until the team re-lists: DR frame: 24 welded 6063-T6 tubes per its cut list, walls by role (D-106, the D-85 rule): the 18 skin-only tubes 1.0, the 4 that carry rivnuts 1.2, the 2 fan-box shelf tubes 1.5; mill finish (D-79) | walls 1.0 / 1.2 / 1.5; lengths per the cut list | lengths and mitre angles pending: set on the frame drawing (HOLD) | the frame's bolt-line tube | tape; protractor; wall micrometer | 1 of each number (the first article) | calculation (lengths from the parameters, FRONT's cut list); DECIDED walls (D-106) and finish (D-79) |  | PLANNED |  |
| K-D05 | `351306` | DR frame holes: 10 rivnuts for the access panel bolts; 6 holes Ø14 in the bolt-line tube for the J-FRONT-01 rivnut tails | rivnut holes Ø9.53; Ø14 | Ø9.53 +0.10/0 (maker's data); Ø14 and positions pending: set on the drawing (HOLD) | the bolt-line tube | pin gauges; position on a check fixture | 1 of each number (the first article) | source (FRONT's parts list; joints register H-03) |  | PLANNED |  |
| K-D06 | `351302` | DR back plate: 5754-H22 sheet 1.5 (D-106, was 2.0; inside the rivnut grip), mill finish, laser cut; 6 holes Ø9.53 for the rivnuts on the X +1224 strip, on the wall's bolt line (critical) | 1.5; Ø9.53 | Ø9.53 +0.10/0 (row, critical); other sizes ISO 2768-m (row); the critical holes' position: HOLD (the row gives no position limit yet) | the wall's bolt line | pin gauges; CMM or the drill fixture for the 6 critical holes | 1 of each number (the first article) | source (FRONT's parts list; J-FRONT-01); no drawing (D-89 part 4); rivet HOLD |  | PLANNED |  |
| K-D07 | `351305` | DR access panel, becoming DR's one removable inner face panel (D-130's notes: its characteristics follow FRONT's list once it changes): 5754-H22 sheet 3.0, mill finish; opening 203 × 215; 10 bolt holes Ø6.6; 2 holes Ø9.53 at X 971, Z 1700 and 1850 for the column's hook studs | 3.0; 203 × 215; Ø6.6; Ø9.53 | Ø9.53 +0.10/0 (row); other sizes ISO 2768-m (row) | the panel's bolt holes | pin gauges; tape; trial fit of the 10 M6 × 16 bolts | 1 of each number (the first article) | source (FRONT's parts list; the air table, D-60; PM ruling 2026-11-01); gasket tape HOLD |  | PLANNED |  |
| K-D08 | `351303` | DR inner panel: ACP 3 mm, CNC routed; lifts off for the fan box; held by 4 clips | 3 | outline ISO 2768-m (row) | — | template against the DXF; trial lift-off | 1 of each number (the first article) | source (FRONT's parts list; D-59, D-60); clip HOLD; cancelled by the one-panel change (D-130's notes): the line goes when FRONT's list drops 351303 |  | PLANNED |  |
| K-D09 | `351304` | DR inner panel felt: PET 9 mm, Dark Gray, laser cut, glued at the factory to 351305, DR's one removable inner face panel (D-130's notes; it was glued to 351303) | 9 | outline ±2 (row) | 351305's edge | tape; caliper; check the bond; the emission certificate | 1 of each number (the first article) | source (FRONT's parts list; D-31, D-79); certificate HOLD |  | PLANNED |  |
| K-D10 | `350004` | Air supply assembly: ships joined, slides into DR through its inner face, plug-in connectors; stands on the frame's shelf tubes | as stated | slides in by hand; fixing HOLD (air detail) | the shelf tubes | trial fit; visual | 1 of each number (the first article) | DECIDED (D-60, D-87); source (FRONT's parts list) |  | PLANNED |  |

## D3. Decor block DT (FRONT, PR #105)

| ID | Applies to | Characteristic | Nominal | Limits | Datum | Method and gauge | Sample | Source and status | Result | Conclusion | Evidence |
|---|---|---|---|---|---|---|---|---|---|---|---|
| K-D13 | `350002` | DT assembled: outer shape to skeleton P04, 205 mm deep as v1 (D-49); goes on after the door hangs; sits on a spigot on DL and on DR and takes 4 bolts from the ceiling's front tubes at the 220 mm rule | 205 deep; about 7.2 kg | shape pending: set on the drawing (HOLD); mass ≤ 20 (D-03) | the spigots on DL and DR | tape and caliper; trial fit; scale | 1 of each number (the first article) | DECIDED (D-03, D-49); source (FRONT's parts list, PR #105; joints register J-FRONT-03, which FRONT's list still marks HOLD) |  | PLANNED |  |
| K-D14 | `351201` | DT skin: flat ACP 3 mm panels, 45° mitred joints as v1, bonded to the frame; colour Dark Yellow EV3038 | 3; EV3038 | outline per its DXF; mitres pending: set on the drawing (HOLD) | the frame | template against the DXF; visual against the approved sample; the bond spec's T09 coupons | 1 of each number (the first article) | DECIDED (D-12, D-49); source (FRONT's parts list, PR #105) |  | PLANNED |  |
| K-D15 | `351204` | D-131: welded galvanized steel box tube with the same outside sections, in the Joints Engineer's steel and gauges (K-J16); until the team re-lists: DT frame: 13 welded 6063-T6 tubes 20 × 20 × 1.5, 8.5 m in all, lengths per its cut list; mill finish (D-79; FRONT's row doesn't state it); its rail F02 carries the catch 368007 and the top stop 351203 | lengths per the cut list | lengths and mitre angles pending: set on the frame drawing (HOLD) | the rail F02 | tape; protractor; wall micrometer | 1 of each number (the first article) | calculation (lengths, FRONT's cut list); DECIDED finish (D-79) |  | PLANNED |  |
| K-D16 | `351202` | DT back plate: ACP 3 mm, CNC routed, bonded to the frame; the soffit sits behind it (D-60) | 3 | pending: set on its drawing, with the bond area and surface prep (HOLD); its row's tolerance and finish to come from FRONT | the frame | template against the DXF; the bond spec's T09 coupons | 1 of each number (the first article) | source (FRONT's parts list, PR #105); it keeps its drawing: a bonded part shows its bond area and surface prep there (D-89; PM, 2026-11-01) |  | PLANNED |  |
| K-D17 | `351203` | Door top stop: 6063-T6 aluminium angle cut to length, screwed up through DT's underside into the rail F02 | frame gap 2 to 6 | the gap 2 to 6 (hardware selection C3) | the door's top edge | feeler gauge; caliper | 1 of each number (the first article) | source (FRONT's parts list, PR #105; hardware selection C3) |  | PLANNED |  |

## E. Base

| ID | Applies to | Characteristic | Nominal | Limits | Datum | Method and gauge | Sample | Source and status | Result | Conclusion | Evidence |
|---|---|---|---|---|---|---|---|---|---|---|---|
| K-B01 | `110xxx` `1111xx` | Base band wall 1.5, with an aluminium load block at each glide | 1.5 | the profile standard (unverified) | — | caliper; check each block is in | 1 of each number (the first article) | DECIDED (D-86) |  | PLANNED |  |
| K-B02 | `1114xx` | Floor panel: 9 mm poplar-core ply with a hard face; plan size per skeleton P04, X 0 to ±1210 and Y −645 to 810 (1210 × 1455), plus its half-lap | 9; 1210 × 1455 | pending: set on the drawing (HOLD) | the band's inner face | caliper; steel tape | 1 of each number (the first article) | DECIDED (D-72, D-85, D-86); calculation (skeleton P04); cancelled by D-132 (no floor): the line goes when BASE's list drops the part |  | PLANNED |  |
| K-B03 | `1114xx` | Panel edge and half-lap seam under 1000 N on the foam | — | ≤ 1 deflection | the room floor | dial gauge under a 1000 N load; castor rolled over the edge | the first F1 and F2, at the half-lap and one free edge | assumption until tested (D-76); calculation about 0.6 (D-86); cancelled by D-132 (no floor): the line goes when BASE's list drops the part |  | PLANNED |  |
| K-B04 | `1115xx` | Floor foam: 3 mm firm closed-cell, about 200 kg/m³, bonded under the panel at the factory | 3 | the maker's data | — | caliper; check the bond | 1 of each number (the first article) | DECIDED (D-76, D-87); product HOLD (ISS-085); cancelled by D-132 (no floor): the line goes when BASE's list drops the part |  | PLANNED |  |
| K-B05 | `110000` | Door threshold (in the BASE assembly until the profile has its own number): 13 high, a 6 mm upright, then a 1:2 bevel | 13; 6; 1:2 | pending: set on the drawing (HOLD) | the room floor | height gauge; angle gauge | every one on the first pod | DECIDED (D-72); cancelled by D-132 (no floor): the line goes when BASE's list drops the part |  | PLANNED |  |
| K-B06 | `110000` | Intake mesh band piece under the right decor block (in the BASE assembly until it has its own number): free area | 0.028 m² | ≥ | — | measure the open area | every one on the first pod | DECIDED (D-62) |  | PLANNED |  |
| K-B07 | `110000` | Base seal (118001): a soft lip on the band's inner face that presses on the room floor across the glides' range (D-132; it sat at the floor's edge, D-86) | presses on the room floor | sealed | — | feeler gauge; light test | every one on the first pod | DECIDED (D-132); its lip and squeeze from BASE's list (HOLD) |  | PLANNED |  |
| K-B08 | `11121x` | Corner and inline keys 111211 to 111214: one machined 6061-T6 block, mill finish, hidden, fixed in a band piece's open end at the factory (at the two back corners in the side bands 111101 and 111102; the back band 111103 has one open slot in each end cap that takes the studs as the band is lowered, with the band on its glides, not the studs; details in J-BASE-02, D-129); 30 mm (D-103, was 25) × 35 × 75; its fixing holes keep 2 diameters from its ends; each key's hook studs take the next piece | 30 × 35 × 75 | pending: set on the Joints Engineer's tabulated drawing (HOLD) | the band's bottom wall | caliper; trial fit in a band end | 1 of each number (the first article) | DECIDED (D-87 hook-in keys, D-95 one source, D-102 and D-103 hole distances); source (BASE's row and the joints register J-BASE-02, 25 × 35 × 75 before D-103) |  | PLANNED |  |
| K-B10 | `1111xx` | Band holes for the key screws: 2 diameters from the band piece's cut end | 14.9 to 19.5 from the cut ends | pending: set on the drawing (HOLD) | the cut end | caliper | 1 of each number (the first article) | DECIDED (D-102, D-103) |  | PLANNED |  |
| K-B11 | `111103` | Back band: one open slot in each end cap that takes the studs as the band is lowered, with the band on its glides, not the studs; details in J-BASE-02 (D-129): per end cap one 6.5 slot open at the bottom edge, widening to 12 over its bottom 6, running up past both studs to 2 above the upper stud (Z 73.5), with a 1 × 45° bevel on the cap's bottom edge, side-band side, and a 12 × 9 notch in the bottom wall at each end for the stud heads; it ships at 2420 long, 2430 wrapped, on the 2438 mm (96 in) deck | slot 6.5, mouth 12 over 6, its closed end 2 above the upper stud (Z 73.5); notch 12 × 9; 2420 long | pending: set on the drawing (HOLD) | the band's bottom wall | caliper on each slot; steel tape; trial fit: both side bands on their glides, then lower the back band between them | 1 of each number (the first article) | DECIDED (D-129, with the PM's addition from Joints); source (the slot and notch, J-BASE-02, PR #246); calculation (2420 and 2430 mm, the PM's ruling) |  | PLANNED |  |
| K-B09 | `111601` | Glide doubler: 5754-H22 sheet 3 mm, mill finish, laser or waterjet cut, 52 × 36 with one Ø13 hole centred for the glide's M10 rivnut; inside the band on its bottom face, clamped by that rivnut | 52 × 36 × 3; Ø13 | Ø13 +0.10/0 (critical; HOLD with the nut); centred ±0.2; other sizes ISO 2768-m (BASE's row) | the doubler's long edges | pin gauges; caliper on the hole's position | 1 of each number (the first article) | source (BASE's parts list, PR #55); its edge distance under the PM's exception of 2026-11-01 (the mechanical check's edge exceptions); the 3 mm thickness an assumption; no drawing (D-89 part 4) |  | PLANNED |  |

## F. Air, electrical and interior

| ID | Applies to | Characteristic | Nominal | Limits | Datum | Method and gauge | Sample | Source and status | Result | Conclusion | Evidence |
|---|---|---|---|---|---|---|---|---|---|---|---|
| K-A01 | `61xxxx` | Cartridge: 173 × 314 × 1750, two 80 mm passages between three 50 mm layers | as stated | pending: set on the drawing (HOLD) | — | steel tape and caliper | 1 of each number (the first article) | calculation (D-61, the air report) |  | PLANNED |  |
| K-A02 | `61xxxx` `81xxxx` | Air column 217 × 360 × 2105 and soffit 2332 × 360 × 220 | as stated | pending: set on the drawing (HOLD) | the pod's inside corner | steel tape | 1 of each number (the first article) | calculation (D-61, the air report, skeleton P04) |  | PLANNED |  |
| K-A03 | `61xxxx` | Each shipped air piece ≤ 20 kg: the soffit with its fan box about 13.9, the riser with the supply fan box about 14.9 | ≤ 20 | — | — | scale | 1 of each number (the first article) | DECIDED (D-03, D-87); calculation |  | PLANNED |  |
| K-A04 | `611501` | AIR's intake riser, in DR's supply-box space: galvanised steel DX51D+Z duct; its open foot 140 mm over the base opening | 140 | pending: set on the drawing (HOLD) | the base opening | caliper; tape | 1 of each number (the first article) | source (AIR's parts list, PR #91; the air table, D-60); AIR's part, placed in DR's reserved air space (D-105) |  | PLANNED |  |
| K-A05 | `610401` | AIR's supply fan box: 3 mm aluminium casing (D-124), with its 50 mm lining only where it fits (D-121), joined to the riser and shipped as its own pallet piece; 12 mm from the fixed glass channel; its intake sealed (D-130): a boot from the mesh, through DR's base, up to the riser's foot, and gaskets on DR's inner and access panel edges and round each cartridge's inlet end | 3; 50; 12; ≤ 20 kg as it ships; boot and gaskets sealed | pending: set on the drawing (HOLD); lining and bulkhead HOLD (air detail); boot and gaskets HOLD (CEILING's AIR follow-up) | the glass channel | caliper; feeler gauge; scale; light test on the boot and each gasket line | 1 of each number (the first article) | source (AIR's parts list, PR #91; the air table, D-60); DECIDED (D-03, D-87, D-105, D-121, D-124, D-130) |  | PLANNED |  |
| K-A06 | `611212` | Soffit underside hinge, our riveted pin hinge: each hinged section swings to its stop past DT's and DR's backs, nothing of the hinge shows when closed, and each hinge takes 50 N | 95°; 50 N | stop 90 to 100° (the PM's range); ≥ 50 N a hinge | the section's door edge | protractor on the open section; weights or a spring scale at the hinge line; a look from the seat with the section closed | every hinge on the first pod | DECIDED (the PM's rulings of 2026-11-01 in the Sourcing group: our own riveted pin hinge, a 95° stop and at least 50 N each, 5:1; the felt's light touch in the first 35° is fine) |  | PLANNED |  |
| K-A07 | `618106` | Soffit underside latch (Southco E4-10-201-10): each latch holds its closed section | 25 N | ≥ | — | push-pull gauge at each latch, the section closed | the sample, then every latch on the first pod | DECIDED (the PM's ruling of 2026-11-01 in the Sourcing group: E4-10-201-10 on a small riveted bracket on the fixed front face, the keeper bonded to the ACP as Southco's sheet says) |  | PLANNED |  |
| K-E01 | `71xxxx` | Harness tested at the factory; the hub's self-test passes | pass | — | — | the factory test record; the self-test log | 1 of each number (the first article) | DECIDED (D-87) |  | PLANNED |  |
| K-E02 | `711001` | Power unit enclosure body: 5052-H32 1.0 mm, laser cut and folded into a tray with 25 mm side flanges and 22 mm front lips; two Ø19.1 lead exits, a Ø19.1 light feed exit, a Ø25 sleeve entry, 4 M4 clinch nut holes in the lips; mill finish (D-79) | 296 × 260 × 72; Ø19.1; Ø25 | ISO 2768-m (row), on drawing 711001 when it lands; the fixing to B2's frame and the earth stud hole HOLD | the front lips | tape; caliper; pin gauges | 1 of each number (the first article) | source (ELECTRICAL's parts list, PR #64); HOLD features (WALL's IF-12; the stud maker's data) |  | PLANNED |  |
| K-E03 | `711002` | Power unit front plate: 5052-H32 1.5 mm, laser cut flat, black anodised (as K-F06); 4 holes Ø4.5 on the body's M4 clinch nuts, 42 and 23 from the plate's edges; RCBO window 37 × 45; covers B2's cut felt edge by 8 all round and stands 2 off the felt on 4 spacers (718049) | 320 × 284; Ø4.5; 37 × 45 | the 4 holes true position Ø0.3 (critical); RCBO window +0.5/0; other sizes ISO 2768-m (row) | the plate's edges | CMM or a check fixture for the 4 holes; caliper; trial fit on the body | 1 of each number (the first article) | source (ELECTRICAL's parts list, PR #64); no drawing (D-89 part 4); the two 86-plate openings HOLD (H-ELE-04) |  | PLANNED |  |
| K-E04 | `711005` | Hub zone cover plate: 5052-H32 1.5 mm, laser cut flat, black anodised (as K-F06) | 180 × 180; 1.5 | ISO 2768-m (row) | the plate's edges | tape; caliper | 1 of each number (the first article) | source (ELECTRICAL's parts list, PR #64); no drawing (D-89 part 4); the hub window, button, knob and fixing holes HOLD (ISS-060; CEILING's column) |  | PLANNED |  |
| K-I01 | `81xxxx` | Light shelf within 0.4 kg/m, the right shelf within 0.41 kg/m with the bought profile until the product's real mass is known (D-126's notes); the 1000 mm ledge in 1.5 mm folded aluminium | 0.4 (the right shelf 0.41); 1.5 | pending: set on the drawing (HOLD) | — | scale; caliper | 1 of each number (the first article) | DECIDED (D-85; D-126's notes) |  | PLANNED |  |
| K-I02 | `811101` | Work wall ledge top: 5052-H32 sheet 1.5, laser cut and brake bent (2 bends), section 250 × 25; powder coat charcoal to match the felt | 1000 long; 250 × 25; 1.5 | cut ±0.5, bent ±0.5 (row, assumption) | — | tape; caliper; protractor | 1 of each number (the first article) | source (INTERIOR's parts list, PR #92; D-70, D-85); alloy and colour HOLD; its brackets HOLD (818101, on WALL's R1 stiles) |  | PLANNED |  |
| K-I03 | `811201` `811202` `811203` | Light shelf back and sides: 5052-H32 sheet 1.0, laser cut and brake bent (3 bends), section 60 × 40; the back 2332 long with ELECTRICAL's feed hole at X 355; the sides 991 long, the right one with the call-light drop hole at Y −209.5; powder coat charcoal | 2332 / 991 long; 60 × 40; 1.0 | cut ±0.5, bent ±0.5 (row, assumption) | — | tape; caliper; protractor | 1 of each number (the first article) | source (INTERIOR's parts list, PR #92; D-70; ELECTRICAL's holes); alloy and colour HOLD |  | PLANNED |  |
| K-I04 | `811204` | Light shelf down channel, right: 5052-H32 sheet 1.0, 4 bends, section 30 × 12; carries ELECTRICAL's two 8 mm down-light strips over the ledge | 991 long; 30 × 12 | cut ±0.5, bent ±0.5 (row, assumption) | — | tape; caliper | 1 of each number (the first article) | source (INTERIOR's parts list, PR #92); cancelled by D-126 (a bought LED profile replaces the channel): the line goes when INTERIOR's list drops 811204 |  | PLANNED |  |
| K-I05 | `811205` | Light shelf diffuser, right: opal polycarbonate strip 28 × 1.5, cut to length | 991 long; 28 × 1.5 | cut length ±1 (row, assumption) | — | tape; caliper | 1 of each number (the first article) | source (INTERIOR's parts list, PR #92); grade HOLD (picked with ELECTRICAL's strips); cancelled by D-126 (the profile's clip-in diffuser replaces it): the line goes when INTERIOR's list drops 811205 |  | PLANNED |  |
| K-I06 | `718101` `718102` | Light on the ledge from the down-light through the satin cover, with the strips new, in the work scene: the down-light at full and the lights at 22 W in all (D-127) | ≥ 350 lx | ≥ 350 lx (D-127) | the ledge top | lux meter on the ledge top | the sample | DECIDED (D-127); calculation (350 to 364 lx with the cover passing at least 86 %, ELECTRICAL's options); the cover's product HOLD |  | PLANNED |  |
| K-I07 | `718101` `718102` `718103` `718104` | The light shelf's bought down-light (D-126, D-127): the 23 × 12.5 aluminium profile cut to 991, the length of the shelf's side, with its clip-in satin cover, an end cap at each end (one with the feed lead's hole) and its clips; it takes ELECTRICAL's two 8 mm strips side by side; neither end cap shows from below past the side; the cover unclips to change a strip | 991 long; 23 × 12.5 outside, 20 inside | length: HOLD (no tolerance listed yet; set with the product) | the shelf side's end | tape; caliper; visual from the seat | 1 of each number (the first article) | source (ELECTRICAL's parts list, PR #216; D-126's notes); product HOLD (D-127) |  | PLANNED |  |

## G. Functional checks on the first pod

| ID | Check | Pass mark | Method and gauge | Sample | Source and status | Result | Conclusion | Evidence |
|---|---|---|---|---|---|---|---|---|
| F-01 | The door swings outward to 90° and clears the soffit (door top Z 2116, soffit 4 mm above it) | no contact | swing the door; feeler at the top | the first pod | calculation (the air report); the mechanical check's swing sweep |  | PLANNED |  |
| F-02 | The door closes and stays shut: the 35 N catch, the drop seal on the room floor (D-132), the magnetic seal pair on the glass edge | closed, no gap | visual; light test from inside | the first pod | DECIDED (D-40, D-83) |  | PLANNED |  |
| F-03 | Every seam and seal: no light through any joint | no light | lamp inside, room dark | the first pod | confirmed (REQ-SND-02) |  | PLANNED |  |
| F-04 | Fans: 53 l/s at 26 dB(A) or less and the 65 l/s boost at 30 dB(A) or less, at seated ear height; with two people inside, 53 l/s holds the inside within 4 K of the room | as stated | flow hood; sound level meter; thermometers inside and in the room | the first pod | DECIDED (D-50, D-52); calculation (25.2 and 29.6 dB(A), the boost reaching 66.2 l/s, with D-130's sealed intake boot and gaskets, the air report, PR #254; DR as built without them 33.3 and 37.8; 0.4 under the limit, ISS-090; 249 W and 3.9 K at 53 l/s, PR #72); the fan sample's T04 |  | PLANNED |  |
| F-05 | Control: fans start on presence; CO2 and the 4 K limit drive the flow; boost by hand; with the voice kit fitted, the boost holds 4 K | as stated | logged readings over a session | the first pod | DECIDED (D-44, D-50, D-88) |  | PLANNED |  |
| F-06 | The hub's self-test button runs and passes | pass | press it; read the log | the first pod | DECIDED (D-87) |  | PLANNED |  |
| F-07 | Lights: the light shelf scenes, including a 'call' scene that lights the face from the screen side | as stated | visual | the first pod | DECIDED (D-70) |  | PLANNED |  |
| F-08 | Assembly: two people, one 5 mm key, every piece but the glass 20 kg or less | about 127 min; never over 4 h | timed trial with the guide | the first pod | DECIDED (D-03, D-63; 4 h, REQ-ASM-01); calculation (the guide, PR #59; D-87's target about 126) |  | PLANNED |  |
| F-09 | Mass as shipped | ≤ 460 kg (cap, provisional until the sample panel's recount, D-131); 409.0 calculated on the merged count | weigh every piece | the first pod | DECIDED cap (D-131, provisional; was 420, D-37); calculation (the layout study's live count, PR #254); assumption (the PM's estimates: D-131 about +40 to +65 kg, D-132 about -21 kg) |  | PLANNED |  |
| F-10 | Sound: speech level reduction to ISO 23351-1 | the measured figure; about 19 dB calculated | lab, after the wall sample's T01 from 100 Hz | the first pod | DECIDED (D-53); calculation |  | PLANNED |  |
| F-11 | Voice kit, once it exists: average draw over a session and peak on its one 24 V Class 2 feed (D-168); with it on, the inside within 4 K at 30 dB(A) or less | ≤ 40 W average; ≤ 60 W peak; ≤ 4 K | power logger on the feed; thermometers; sound level meter | the first pod | DECIDED (D-11, D-88, D-168); calculation (4 K takes 62 l/s at 28.7 dB(A), PR #72) |  | PLANNED |  |

## H. Bought parts: the test that accepts each

| Applies to | Part | Test | Source |
|---|---|---|---|
| `838001` | Socket head bolt M6 × 16 | T06, J-T1 | test plan T06 (the bolt sets the torque); joints register J-T1 |
| `838002` | Closing-seam pin bolt M6 × 25 | J-T1 | joints register J-T1 |
| `838003` | Rivnut M6 | T06, J-T1, K-J19 | test plan T06; joints register J-T1; the pull test in a real 0.8 stile (K-J19) |
| `838004` | Head washer 6.4 × 18 | T06 | test plan T06 |
| `838005` | Captive retainer | J-T2 | joints register J-T2 |
| `838010` | Flanged button head screw M6 × 12, the corner keys' fixing screws | J-T6 | joints register J-T6 (the hook-in corner key mock-up); they carry the joint's pull (D-102) |
| `838012` | The cassette ledge's closed-end countersunk rivet (D-166, D-170) | K-J20 | flush and clear of the tray on the first pod |
| `848001` | Joint gasket | J-T3 | joints register J-T3 |
| `848004` | Closing-seam seal | J-T3, J-T5 | joints register J-T3, J-T5 |
| `848012` | Cassette edge seal | F-03 | the light test |
| `118001` | Base seal | J-T4 | joints register J-T4 |
| `518001` | Cassette clip | T07, K-L11 | test plan T07; one person takes a ceiling cassette down (K-L11) |
| `518002` | Ceiling safety catch | T08 | test plan T08 |
| `108002` | ACP bond set | T09 | test plan T09 |
| `108001` | The 5 mm hex key | F-08 | the timed assembly |
| `368001` `368003` `368006` `368101` `368103` | Drop seal, magnetic seal halves, hinges, pull | T13 | test plan T13 (once the hinges and lock are named) |
| `368007` `368102` | Door catch and strike | F-02 | the door check |
| `368002` `368004` `368005` | Glazing U-seal, U-profile, frame-stop seal | F-03 | the light test |
| `618106` | Soffit underside latch | K-A07 | each latch holds 25 N |
| `618xxx` | AIR's bought parts (the fans) | T04 | test plan T04 |
| `71xxxx` | ELECTRICAL's parts | F-06 | the hub's self-test, with the harness tested at the factory (D-87) |
| `718101` `718102` `718103` `718104` | The light shelf's down-light profile, satin cover, end caps and clips (D-126, D-127) | F-07 | the lights check; the light on the ledge is K-I06, on the sample (D-127) |

A bought part with no line here has no test yet; the release checklist shows it as open.

## How this plan grows

- When a part's drawing lands, its characteristics move onto the drawing with these IDs, and new ones get the next free ID in their section.
- When a test or a first article is measured, the result, conclusion and evidence columns fill in (the measured value, the sample number, the gauge's calibration, the date and the file). Only then can a line say PASS.
- The release checklist re-reads this file to show which parts have characteristics and which bought parts have a test.
