autonomous-ai/spaceship/v2/04-Checks/results/latest.md

# Mechanical check run: 2767495 on 2026-11-01

Offline checks (`tools/checks/run_checks.py`) on revision `2767495`. The Fusion checks (exact clash, tool access, thread engagement) are recorded separately when they run.

**Findings in this run: 187** (69 severe, 116 major, 2 minor). Register numbers in brackets.

## What ran

| Check | Ran on this revision | Findings |
|---|---|---|
| C01 clash and minimum gaps (Fusion) | yes | 12 |
| C02 tolerance stack-ups | yes | 4 |
| C03 fastener and tool access | no inputs yet | 0 |
| C04 weight, doorway and pallet fit | yes | 0 |
| C05 drawing completeness | yes | 97 |
| C06 BOM completeness | yes | 35 |
| C07 fastener schedule and thread engagement | yes | 0 |
| C08 hole-to-hole alignment | yes | 1 |
| C09 edge distance, bend radius, hole-to-bend | yes | 12 |
| C10 mixed metals | yes | 0 |
| C11 material grade and finish | yes | 26 |

Inputs: {"bodies_skeleton": 31, "shell_faces_skeleton": ["back", "back-base", "left", "left-base", "right", "right-base", "top"], "bodies_assembly": 544, "shell_faces_assembly": ["back-base", "left", "left-base", "right", "right-base", "top"], "seal_line_cuts": 91, "seal_line_open_mm2": 47029.4, "parts_lists": ["v2/03-Manufacturing/air/610000_P01_AIR-PARTS-LIST_BOM.csv", "v2/03-Manufacturing/base/110000_P01_BASE_BOM.csv", "v2/03-Manufacturing/ceiling/410000_P01_CEILING-PARTS-LIST_BOM.csv", "v2/03-Manufacturing/electrical/710000_P01_ELECTRICAL-PARTS-LIST_BOM.csv", "v2/03-Manufacturing/front/350001_P01_FRONT-DECOR-BLOCK-ASSY-DL_BOM.csv", "v2/03-Manufacturing/front/350002_P01_FRONT-DECOR-BLOCK-ASSY-DT_BOM.csv", "v2/03-Manufacturing/front/350003_P01_FRONT-DECOR-BLOCK-ASSY-DR_BOM.csv", "v2/03-Manufacturing/front/360001_P01_FRONT-DOOR-UNIT_BOM.csv", "v2/03-Manufacturing/front/360002_P01_FRONT-FIXED-GLASS-UNIT_BOM.csv", "v2/03-Manufacturing/interior/810000_P01_INTERIOR-PARTS-LIST_BOM.csv", "v2/03-Manufacturing/joints/V2-MFG-JNT-01_P01_JOINTS-MADE-HARDWARE_SPEC.csv", "v2/03-Manufacturing/wall/210101_P01_WALL-PANEL-ASSY-SIDE-LOWER-LH_BOM.csv", "v2/03-Manufacturing/wall/210102_P01_WALL-PANEL-ASSY-SIDE-LOWER-RH_BOM.csv", "v2/03-Manufacturing/wall/210103_P01_WALL-PANEL-ASSY-SIDE-UPPER-LH_BOM.csv", "v2/03-Manufacturing/wall/210104_P01_WALL-PANEL-ASSY-SIDE-UPPER-RH_BOM.csv", "v2/03-Manufacturing/wall/210201_P01_WALL-PANEL-ASSY-BACK-LOWER-B1_BOM.csv", "v2/03-Manufacturing/wall/210202_P01_WALL-PANEL-ASSY-BACK-LOWER-B2_BOM.csv", "v2/04-BOM/100000_P01_POD-MASTER_BOM.csv"], "part_steps": ["v2/03-Manufacturing/air/610000_P01_AIR_STEP.step", "v2/03-Manufacturing/base/110000_P01_BASE_STEP.step", "v2/03-Manufacturing/base/111101_P01_BASE-BAND-TUBE-SIDE-LH_STEP.step", "v2/03-Manufacturing/base/111102_P01_BASE-BAND-TUBE-SIDE-RH_STEP.step", "v2/03-Manufacturing/base/111103_P01_BASE-BAND-TUBE-BACK_STEP.step", "v2/03-Manufacturing/base/111106_P01_BASE-BAND-TUBE-FRONT-FIXED-GLASS_STEP.step", "v2/03-Manufacturing/base/111301_P01_BASE-SILL-FIXED-GLASS_STEP.step", "v2/03-Manufacturing/base/111601_P01_BASE-GLIDE-DOUBLER-COMMON_STEP.step", "v2/03-Manufacturing/ceiling/410000_P01_CEILING_STEP.step", "v2/03-Manufacturing/electrical/710000_P01_ELECTRICAL_STEP.step", "v2/03-Manufacturing/electrical/711001_P01_ELECTRICAL-POWER-UNIT-ENCLOSURE-BODY_STEP.step", "v2/03-Manufacturing/electrical/711002_P01_ELECTRICAL-POWER-UNIT-FRONT-PLATE_STEP.step", "v2/03-Manufacturing/electrical/711005_P01_ELECTRICAL-HUB-ZONE-COVER-PLATE_STEP.step", "v2/03-Manufacturing/front/350001_P01_FRONT-DECOR-BLOCK-ASSY-DL_STEP.step", "v2/03-Manufacturing/front/350002_P01_FRONT-DECOR-BLOCK-ASSY-DT_STEP.step", "v2/03-Manufacturing/front/350003_P01_FRONT-DECOR-BLOCK-ASSY-DR_STEP.step", "v2/03-Manufacturing/front/360001_P01_FRONT-DOOR-UNIT_STEP.step", "v2/03-Manufacturing/front/360002_P01_FRONT-FIXED-GLASS-UNIT_STEP.step", "v2/03-Manufacturing/interior/810000_P01_INTERIOR_STEP.step", "v2/03-Manufacturing/joints/111211_P01_BASE-CORNER-KEY-SQUARE-COMMON_STEP.step", "v2/03-Manufacturing/joints/111212_P01_BASE-CORNER-KEY-FRONT-LH_STEP.step", "v2/03-Manufacturing/joints/111213_P01_BASE-CORNER-KEY-FRONT-RH_STEP.step", "v2/03-Manufacturing/joints/111214_P01_BASE-CORNER-KEY-KNEE-LH_STEP.step", "v2/03-Manufacturing/joints/831001_P01_HARDWARE-LOCATING-SPIGOT_STEP.step", "v2/03-Manufacturing/joints/831002_P01_HARDWARE-STOP-WASHER_STEP.step", "v2/03-Manufacturing/joints/831007_P01_HARDWARE-MITRE-PLATE-20X40-45DEG_STEP.step", "v2/03-Manufacturing/joints/831008_P01_HARDWARE-MITRE-PLATE-20X40-TO-40X40_STEP.step", "v2/03-Manufacturing/joints/831009_P01_HARDWARE-MITRE-PLATE-40X40-45DEG_STEP.step", "v2/03-Manufacturing/wall/210101_P01_WALL-PANEL-ASSY-SIDE-LOWER-LH_STEP.step", "v2/03-Manufacturing/wall/210102_P01_WALL-PANEL-ASSY-SIDE-LOWER-RH_STEP.step", "v2/03-Manufacturing/wall/210103_P01_WALL-PANEL-ASSY-SIDE-UPPER-LH_STEP.step", "v2/03-Manufacturing/wall/210104_P01_WALL-PANEL-ASSY-SIDE-UPPER-RH_STEP.step", "v2/03-Manufacturing/wall/210201_P01_WALL-PANEL-ASSY-BACK-LOWER-B1_STEP.step", "v2/03-Manufacturing/wall/210202_P01_WALL-PANEL-ASSY-BACK-LOWER-B2_STEP.step", "v2/03-Manufacturing/wall/211101_P01_WALL-PANEL-FRAME-SIDE-LOWER-LH_STEP.step", "v2/03-Manufacturing/wall/211102_P01_WALL-PANEL-FRAME-SIDE-LOWER-RH_STEP.step", "v2/03-Manufacturing/wall/211103_P01_WALL-PANEL-FRAME-SIDE-UPPER-LH_STEP.step", "v2/03-Manufacturing/wall/211104_P01_WALL-PANEL-FRAME-SIDE-UPPER-RH_STEP.step", "v2/03-Manufacturing/wall/211201_P01_WALL-PANEL-FRAME-BACK-LOWER-B1_STEP.step", "v2/03-Manufacturing/wall/211301_P01_WALL-SKIN-SIDE-LOWER-LH_STEP.step", "v2/03-Manufacturing/wall/211401_P01_WALL-SKIN-BACK-LOWER-B1_STEP.step", "v2/03-Manufacturing/wall/211501_P01_WALL-CAVITY-FILL-SIDE-LOWER-LH_STEP.step", "v2/03-Manufacturing/wall/211601_P01_WALL-CAVITY-FILL-BACK-LOWER-B1_STEP.step", "v2/03-Manufacturing/wall/510101_P01_LINING-CASSETTE-SIDE-LOWER-LH_STEP.step", "v2/03-Manufacturing/wall/510102_P01_LINING-CASSETTE-SIDE-LOWER-RH_STEP.step", "v2/03-Manufacturing/wall/510103_P01_LINING-CASSETTE-SIDE-UPPER-LH_STEP.step", "v2/03-Manufacturing/wall/510104_P01_LINING-CASSETTE-SIDE-UPPER-RH_STEP.step", "v2/03-Manufacturing/wall/510201_P01_LINING-CASSETTE-BACK-LOWER-B1_STEP.step", "v2/03-Manufacturing/wall/510202_P01_LINING-CASSETTE-BACK-LOWER-B2_STEP.step", "v2/03-Manufacturing/wall/511101_P01_LINING-TRAY-SIDE-LOWER-LH_STEP.step", "v2/03-Manufacturing/wall/511201_P01_LINING-TRAY-BACK-LOWER-B1_STEP.step"]}

## Findings

| Register | Severity | Check | Subject | Finding | Owner |
|---|---|---|---|---|---|
| F-354 | severe | C01 | floor seal line 118001 | The pod's floor seal line is open between 118001 BASE - BASE SEAL - LIP - ROOM FLOOR - HOLD (2) and 118001 BASE - BASE SEAL - LIP - ROOM FLOOR - HOLD (3): a gap 320.1 mm wide at X 1057.5, Y -727.1, from the floor to Z 10.0, open area 3201 mm² (calculation: width times height, summed over 4 cuts of the STEPs). Air passes between the room and the pod there. A gap this wide is a part not modelled yet, or missing. All openings on this run: 12, 47029 mm² in all. | BASE |
| F-355 | severe | C01 | floor seal line 111101 / 361002 | The pod's floor seal line is open between 111101 BASE - BAND TUBE - SIDE - LH and 361002 FRONT - DOOR KICK STRIP: a gap 238.7 to 251.7 mm wide at X -1085.5, Y -670.5, from the floor to Z 110.0, open area 27393 mm² (calculation: width times height, summed over 91 cuts of the STEPs). Air passes between the room and the pod there (other parts on its sides at some heights: 118001 BASE - BASE SEAL - LIP - ROOM FLOOR - HOLD, 351103 FRONT - DOOR HINGE-SIDE STOP - DL, 368001 FRONT - DROP SEAL - ATHMER SCHALL-EX GSA 1-1112). A gap this wide is a part not modelled yet, or missing. All openings on this run: 12, 47029 mm² in all. | BASE; FRONT |
| F-356 | severe | C01 | floor seal line 111301 / 361002 | The pod's floor seal line is open between 111301 BASE - SILL - FIXED GLASS and 361002 FRONT - DOOR KICK STRIP: a gap 2.0 to 4.5 mm wide at X 216.2, Y -704.4, from the floor to Z 110.0, open area 478 mm² (calculation: width times height, summed over 91 cuts of the STEPs). Air passes between the room and the pod there (other parts on its sides at some heights: 118001 BASE - BASE SEAL - LIP - ROOM FLOOR - HOLD (4), 368001 FRONT - DROP SEAL - ATHMER SCHALL-EX GSA 1-1112, 368002 FRONT - GLAZING U-SEAL - BOHLE BO5201735, 368004 FRONT - GLAZING U-PROFILE - BOHLE BO5201571, 368006 FRONT - 180 MAGNETIC SEAL - HALF 2 OF 2 - HOLD). All openings on this run: 12, 47029 mm² in all. | BASE; FRONT |
| F-357 | severe | C01 | floor seal line 111301 / 118001 | The pod's floor seal line is open between 118001 BASE - BASE SEAL - LIP - ROOM FLOOR - HOLD (2) and 111301 BASE - SILL - FIXED GLASS: a gap 237.6 mm wide at X 1082.5, Y -671.8, from Z 10.0 to Z 12.0, open area 475 mm² (calculation: width times height, summed over 3 cuts of the STEPs). Air passes between the room and the pod there. A gap this wide is a part not modelled yet, or missing. All openings on this run: 12, 47029 mm² in all. | BASE |
| F-358 | severe | C01 | floor seal line 111102 / 611107 | The pod's floor seal line is open between 111102 BASE - BAND TUBE - SIDE - RH and 611107 AIR - COLUMN PLENUM SIDE PLATE - LOW: a gap 39.0 to 49.0 mm wide at X 1185.5, Y -643.4, from Z 12.0 to Z 110.0, open area 4672 mm² (calculation: width times height, summed over 84 cuts of the STEPs). Air passes between the room and the pod there (other parts on its sides at some heights: 118001 BASE - BASE SEAL - LIP - ROOM FLOOR - HOLD (2), 611106 AIR - COLUMN FOOT PLATE). All openings on this run: 12, 47029 mm² in all. | BASE; CEILING |
| F-359 | severe | C01 | floor seal line 111301 / 611103 | The pod's floor seal line is open between 111301 BASE - SILL - FIXED GLASS and 611103 AIR - COLUMN CORNER ANGLE: a gap 46.0 mm wide at X 964.8, Y -666.5, from Z 12.0 to Z 24.0, open area 552 mm² (calculation: width times height, summed over 9 cuts of the STEPs). Air passes between the room and the pod there (other parts on its sides at some heights: 611106 AIR - COLUMN FOOT PLATE). All openings on this run: 12, 47029 mm² in all. | BASE; CEILING |
| F-360 | severe | C01 | floor seal line 611103 / 611107 | The pod's floor seal line is open between 611103 AIR - COLUMN CORNER ANGLE and 611107 AIR - COLUMN PLENUM SIDE PLATE - LOW: a gap 179.0 mm wide at X 1070.5, Y -643.4, from Z 14.0 to Z 24.0, open area 1790 mm² (calculation: width times height, summed over 8 cuts of the STEPs). Air passes between the room and the pod there. A gap this wide is a part not modelled yet, or missing. All openings on this run: 12, 47029 mm² in all. | CEILING |
| F-361 | severe | C01 | floor seal line 361002 at X 214 Y -707 Z 21 | The pod's floor seal line is open between 361002 FRONT - DOOR KICK STRIP and 361002 FRONT - DOOR KICK STRIP: a gap 2.0 mm wide at X 213.7, Y -707.0, from Z 21.0 to Z 25.0, open area 8 mm² (calculation: width times height, summed over 5 cuts of the STEPs). Air passes between the room and the pod there. All openings on this run: 12, 47029 mm² in all. | FRONT |
| F-362 | severe | C01 | floor seal line 361002 at X 214 Y -707 Z 102 | The pod's floor seal line is open between 361002 FRONT - DOOR KICK STRIP and 361002 FRONT - DOOR KICK STRIP: a gap 2.0 mm wide at X 213.7, Y -707.0, from Z 102.1 to Z 104.0, open area 4 mm² (calculation: width times height, summed over 2 cuts of the STEPs). Air passes between the room and the pod there. All openings on this run: 12, 47029 mm² in all. | FRONT |
| F-363 | severe | C01 | floor seal line 611103 / 611105 | The pod's floor seal line is open between 611103 AIR - COLUMN CORNER ANGLE and 611105 AIR - KICK GRILLE: a gap 10.0 mm wide at X 1160.8, Y -292.0, from Z 24.0 to Z 110.0, open area 860 mm² (calculation: width times height, summed over 75 cuts of the STEPs). Air passes between the room and the pod there. All openings on this run: 12, 47029 mm² in all. | CEILING |
| F-364 | severe | C01 | floor seal line 111301 / 611105 | The pod's floor seal line is open between 111301 BASE - SILL - FIXED GLASS and 611105 AIR - KICK GRILLE: a gap 90.5 to 92.5 mm wide at X 950.8, Y -645.2, from Z 24.0 to Z 105.0, open area 7350 mm² (calculation: width times height, summed over 72 cuts of the STEPs). Air passes between the room and the pod there (other parts on its sides at some heights: 368004 FRONT - GLAZING U-PROFILE - BOHLE BO5201571). A gap this wide is a part not modelled yet, or missing. All openings on this run: 12, 47029 mm² in all. | BASE; CEILING |
| F-365 | severe | C01 | floor seal line 611105 / 611501 | The pod's floor seal line is open between 611105 AIR - KICK GRILLE and 611501 AIR - INTAKE RISER: a gap 49.2 mm wide at X 953.0, Y -623.5, from Z 105.0 to Z 110.0, open area 246 mm² (calculation: width times height, summed over 3 cuts of the STEPs). Air passes between the room and the pod there. All openings on this run: 12, 47029 mm² in all. | CEILING |
| F-342 | severe | C02 | assembly KICK-OVER-FLOOR | KICK-OVER-FLOOR: KICK STRIP to ROOM FLOOR (Z 0) is 20.0 mm, needs 9.5 to 10.5 mm. Rule source: confirmed: D-151 (2026-11-01): the kick strip's bottom is the band's bottom line, glide_h (Z 10), over the room floor (D-132: no threshold, the drop seal closes on the floor); the 0.5 either way is the rule it replaces (KICK-OVER-THRESHOLD, D-68 and D-72; assumption); the assembly only, since the skeleton's thresh_h is no longer the kick strip's datum (D-151). Why: The door swings over the room floor: the kick strip runs on the band's bottom line so it clears the floor and the drop seal meets it | FRONT |
| F-343 | severe | C02 | assembly 351101 FRONT - DECOR SKIN - DL:1 | 351101 FRONT - DECOR SKIN - DL:1: 17 frame member face(s) facing it sit 0 mm off the skin; D-137's bond needs the skeleton's bond_t, 3.0 mm, between a bonded skin and its frame (the Lead, 2026-11-01). Members: 351104 FRONT - DECOR FRAME - DL:1 (B02 BACK RING DOOR SIDE 20 x 20 x 1.5) at 0; 351104 FRONT - DECOR FRAME - DL:1 (B04 BACK RING BOLT LINE 60 x 20 x 1.5) at 0; 351104 FRONT - DECOR FRAME - DL:1 (P1 DOOR-SIDE FRONT POST 1 20 x 20 x 1.5) at 0; 351104 FRONT - DECOR FRAME - DL:1 (P2 DOOR-SIDE FRONT POST 2 20 x 20 x 1.5) at 0; 351104 FRONT - DECOR FRAME - DL:1 (P3 DOOR-SIDE FRONT POST 3 20 x 20 x 1.5) at 0; 351104 FRONT - DECOR FRAME - DL:1 (R1D RING BOTTOM - DOOR SIDE 20 x 20 x 1.5) at 0 .... | FRONT |
| F-344 | severe | C02 | assembly 351201 FRONT - DECOR SKIN - DT:1 | 351201 FRONT - DECOR SKIN - DT:1: 11 frame member face(s) facing it sit 0 mm off the skin; D-137's bond needs the skeleton's bond_t, 3.0 mm, between a bonded skin and its frame (the Lead, 2026-11-01). Members: 351204 FRONT - DECOR FRAME - DT:1 (B01 BACK RING BOTTOM 20 x 20 x 1.5) at 0; 351204 FRONT - DECOR FRAME - DT:1 (B03 BACK RING TOP 20 x 20 x 1.5) at 0; 351204 FRONT - DECOR FRAME - DT:1 (C01 CHAMFER CROSS TUBE LEFT 20 x 20 x 1.5) at 0; 351204 FRONT - DECOR FRAME - DT:1 (C02 CHAMFER CROSS TUBE MIDDLE 20 x 20 x 1.5) at 0; 351204 FRONT - DECOR FRAME - DT:1 (C03 CHAMFER CROSS TUBE RIGHT 20 x 20 x 1.5) at 0; 351204 FRONT - DECOR FRAME - DT:1 (F01 FRONT FACET TUBE 20 x 20 x 1.5) at 0 .... | FRONT |
| F-345 | severe | C02 | assembly 351301 FRONT - DECOR SKIN - DR:1 | 351301 FRONT - DECOR SKIN - DR:1: 11 frame member face(s) facing it sit 0 mm off the skin; D-137's bond needs the skeleton's bond_t, 3.0 mm, between a bonded skin and its frame (the Lead, 2026-11-01). Members: 351306 FRONT - DECOR FRAME - DR:1 (B01 BACK RING BOTTOM 40 x 20 x 1.2) at 0; 351306 FRONT - DECOR FRAME - DR:1 (B02 BACK RING BOLT LINE 80 x 20 x 1.2) at 0; 351306 FRONT - DECOR FRAME - DR:1 (B07 BACK RING GLASS EDGE 20 x 20 x 1.0) at 0; 351306 FRONT - DECOR FRAME - DR:1 (F01 FRONT RING BOTTOM 20 x 20 x 1.0) at 0; 351306 FRONT - DECOR FRAME - DR:1 (F02 FRONT RING FACET SIDE 20 x 20 x 1.0) at 0; 351306 FRONT - DECOR FRAME - DR:1 (F03 FRONT RING TOP 20 x 20 x 1.0) at 0 .... | FRONT |
| F-043 | severe | C05 | 111101 | 111101 BASE - BAND TUBE - SIDE - LH has no drawing PDF (111101_REV_NAME_DWG.pdf under v2/02-Drawings) though its CAD is in v2/03-Manufacturing/base/111101_P01_BASE-BAND-TUBE-SIDE-LH_STEP.step. | BASE |
| F-352 | severe | C05 | 111102 | 111102 BASE - BAND TUBE - SIDE - RH has no drawing PDF (111102_REV_NAME_DWG.pdf under v2/02-Drawings) though its CAD is in v2/03-Manufacturing/base/111102_P01_BASE-BAND-TUBE-SIDE-RH_STEP.step. | BASE |
| F-045 | severe | C05 | 111211 | 111211 BASE - CORNER KEY - SQUARE - COMMON has no drawing PDF (111211_REV_NAME_DWG.pdf under v2/02-Drawings) though its CAD is in v2/03-Manufacturing/joints/111211_P01_BASE-CORNER-KEY-SQUARE-COMMON_STEP.step. | Joints Engineer |
| F-100 | severe | C05 | 111212 | 111212 BASE - CORNER KEY - FRONT - LH has no drawing PDF (111212_REV_NAME_DWG.pdf under v2/02-Drawings) though its CAD is in v2/03-Manufacturing/joints/111212_P01_BASE-CORNER-KEY-FRONT-LH_STEP.step. | Joints Engineer |
| F-101 | severe | C05 | 111213 | 111213 BASE - CORNER KEY - FRONT - RH has no drawing PDF (111213_REV_NAME_DWG.pdf under v2/02-Drawings) though its CAD is in v2/03-Manufacturing/joints/111213_P01_BASE-CORNER-KEY-FRONT-RH_STEP.step. | Joints Engineer |
| F-102 | severe | C05 | 111214 | 111214 BASE - CORNER KEY - KNEE - LH has no drawing PDF (111214_REV_NAME_DWG.pdf under v2/02-Drawings) though its CAD is in v2/03-Manufacturing/joints/111214_P01_BASE-CORNER-KEY-KNEE-LH_STEP.step. | Joints Engineer |
| F-341 | severe | C05 | 111215 | 111215 BASE - CORNER KEY - SQUARE - INLINE has no drawing PDF (111215_REV_NAME_DWG.pdf under v2/02-Drawings). | Joints Engineer |
| F-353 | severe | C05 | 111301 | 111301 BASE - SILL - FIXED GLASS has no drawing, and D-89 part 4 (flat sheet part on its DXF) doesn't apply: its DXF draws on BEND; only CUT and MARK pass, so it is folded; it isn't a sheet part (100.0 thick across 120.5); its row's process names bend, brake, weld. | BASE |
| F-020 | severe | C05 | 211101 | 211101 WALL - PANEL FRAME - SIDE LOWER - LH has no drawing PDF (211101_REV_NAME_DWG.pdf under v2/02-Drawings) though its CAD is in v2/03-Manufacturing/wall/211101_P01_WALL-PANEL-FRAME-SIDE-LOWER-LH_STEP.step. | WALL |
| F-109 | severe | C05 | 211102 | 211102 WALL - PANEL FRAME - SIDE LOWER - RH has no drawing PDF (211102_REV_NAME_DWG.pdf under v2/02-Drawings) though its CAD is in v2/03-Manufacturing/wall/211102_P01_WALL-PANEL-FRAME-SIDE-LOWER-RH_STEP.step. | WALL |
| F-110 | severe | C05 | 211103 | 211103 WALL - PANEL FRAME - SIDE UPPER - LH has no drawing PDF (211103_REV_NAME_DWG.pdf under v2/02-Drawings) though its CAD is in v2/03-Manufacturing/wall/211103_P01_WALL-PANEL-FRAME-SIDE-UPPER-LH_STEP.step. | WALL |
| F-111 | severe | C05 | 211104 | 211104 WALL - PANEL FRAME - SIDE UPPER - RH has no drawing PDF (211104_REV_NAME_DWG.pdf under v2/02-Drawings) though its CAD is in v2/03-Manufacturing/wall/211104_P01_WALL-PANEL-FRAME-SIDE-UPPER-RH_STEP.step. | WALL |
| F-179 | severe | C05 | 211201 | 211201 WALL - PANEL FRAME - BACK LOWER - B1 has no drawing PDF (211201_REV_NAME_DWG.pdf under v2/02-Drawings) though its CAD is in v2/03-Manufacturing/wall/211201_P01_WALL-PANEL-FRAME-BACK-LOWER-B1_STEP.step. | WALL |
| F-180 | severe | C05 | 211202 | 211202 WALL - PANEL FRAME - BACK LOWER - B2 has no drawing PDF (211202_REV_NAME_DWG.pdf under v2/02-Drawings). | WALL |
| F-021 | severe | C05 | 211301 | 211301 WALL - SKIN - SIDE LOWER - LH has no drawing, and D-89 part 4 (flat sheet part on its DXF) doesn't apply: its DXF draws on BEND; only CUT and MARK pass, so it is folded; it isn't a sheet part (46.0 thick across 1142.7); its row's process names fold, groove. | WALL |
| F-112 | severe | C05 | 211302 | 211302 WALL - SKIN - SIDE LOWER - RH has no drawing, and D-89 part 4 (flat sheet part on its DXF) doesn't apply: its DXF draws on BEND; only CUT and MARK pass, so it is folded; it isn't a sheet part (46.0 thick across 1142.7); its row's process names fold, groove. | WALL |
| F-113 | severe | C05 | 211303 | 211303 WALL - SKIN - SIDE UPPER - LH has no drawing, and D-89 part 4 (flat sheet part on its DXF) doesn't apply: its DXF draws on BEND; only CUT and MARK pass, so it is folded; it isn't a sheet part (46.0 thick across 1142.7); its row's process names fold, groove. | WALL |
| F-114 | severe | C05 | 211304 | 211304 WALL - SKIN - SIDE UPPER - RH has no drawing, and D-89 part 4 (flat sheet part on its DXF) doesn't apply: its DXF draws on BEND; only CUT and MARK pass, so it is folded; it isn't a sheet part (46.0 thick across 1142.7); its row's process names fold, groove. | WALL |
| F-199 | severe | C05 | 351101 | 351101 FRONT - DECOR SKIN - DL has no drawing, and D-89 part 4 (flat sheet part on its DXF) doesn't apply: it isn't a sheet part (180.2 thick across 2287.0); its row's process names bond. | FRONT |
| F-200 | severe | C05 | 351103 | 351103 FRONT - DOOR HINGE-SIDE STOP - DL has no drawing PDF (351103_REV_NAME_DWG.pdf under v2/02-Drawings). | FRONT |
| F-201 | severe | C05 | 351104 | 351104 FRONT - DECOR FRAME - DL has no drawing PDF (351104_REV_NAME_DWG.pdf under v2/02-Drawings). | FRONT |
| F-202 | severe | C05 | 351201 | 351201 FRONT - DECOR SKIN - DT has no drawing, and D-89 part 4 (flat sheet part on its DXF) doesn't apply: it isn't a sheet part (202.7 thick across 280.0); its row's process names bond. | FRONT |
| F-203 | severe | C05 | 351203 | 351203 FRONT - DOOR TOP STOP - DT has no drawing PDF (351203_REV_NAME_DWG.pdf under v2/02-Drawings). | FRONT |
| F-204 | severe | C05 | 351204 | 351204 FRONT - DECOR FRAME - DT has no drawing PDF (351204_REV_NAME_DWG.pdf under v2/02-Drawings). | FRONT |
| F-205 | severe | C05 | 351301 | 351301 FRONT - DECOR SKIN - DR has no drawing, and D-89 part 4 (flat sheet part on its DXF) doesn't apply: it isn't a sheet part (205.0 thick across 1020.0); its row's process names bond. | FRONT |
| F-206 | severe | C05 | 351306 | 351306 FRONT - DECOR FRAME - DR has no drawing PDF (351306_REV_NAME_DWG.pdf under v2/02-Drawings). | FRONT |
| F-030 | severe | C05 | 361001 | 361001 FRONT - DOOR LEAF - 4+4 LAMINATED has no drawing, and D-89 part 4 (flat sheet part on its DXF) doesn't apply: its row lacks metal or ACP sheet (D-99, D-100); a cut by laser, waterjet or router in its process; thickness; finish; an ISO 2768 general tolerance. | FRONT |
| F-031 | severe | C05 | 361002 | 361002 FRONT - DOOR KICK STRIP has no drawing, and D-89 part 4 (flat sheet part on its DXF) doesn't apply: its faces lie at 8 levels through the thickness (a pocket, a step or a rebate). | FRONT |
| F-097 | severe | C05 | 361003 | 361003 FRONT - FIXED GLASS - 4+4 LAMINATED has no drawing, and D-89 part 4 (flat sheet part on its DXF) doesn't apply: its row lacks metal or ACP sheet (D-99, D-100); a cut by laser, waterjet or router in its process; thickness; finish; an ISO 2768 general tolerance. | FRONT |
| F-141 | severe | C05 | 411101 | 411101 CEILING - PANEL FRAME - C1 has no drawing PDF (411101_REV_NAME_DWG.pdf under v2/02-Drawings). | CEILING |
| F-142 | severe | C05 | 411102 | 411102 CEILING - PANEL FRAME - C2 has no drawing PDF (411102_REV_NAME_DWG.pdf under v2/02-Drawings). | CEILING |
| F-024 | severe | C05 | 511101 | 511101 LINING - TRAY - SIDE LOWER - LH has no drawing, and D-89 part 4 (flat sheet part on its DXF) doesn't apply: its DXF draws on BEND; only CUT and MARK pass, so it is folded; it is folded (4 bends in its STEP); its row's process names bend, brake. | WALL |
| F-121 | severe | C05 | 511102 | 511102 LINING - TRAY - SIDE LOWER - RH has no drawing, and D-89 part 4 (flat sheet part on its DXF) doesn't apply: its DXF draws on BEND; only CUT and MARK pass, so it is folded; it is folded (4 bends in its STEP); its row's process names bend, brake. | WALL |
| F-122 | severe | C05 | 511103 | 511103 LINING - TRAY - SIDE UPPER - LH has no drawing, and D-89 part 4 (flat sheet part on its DXF) doesn't apply: its DXF draws on BEND; only CUT and MARK pass, so it is folded; it is folded (4 bends in its STEP); its row's process names bend, brake. | WALL |
| F-123 | severe | C05 | 511104 | 511104 LINING - TRAY - SIDE UPPER - RH has no drawing, and D-89 part 4 (flat sheet part on its DXF) doesn't apply: its DXF draws on BEND; only CUT and MARK pass, so it is folded; it is folded (4 bends in its STEP); its row's process names bend, brake. | WALL |
| F-185 | severe | C05 | 511201 | 511201 LINING - TRAY - BACK LOWER - B1 has no drawing, and D-89 part 4 (flat sheet part on its DXF) doesn't apply: its DXF draws on BEND; only CUT and MARK pass, so it is folded; it is folded (4 bends in its STEP); its row's process names bend, brake. | WALL |
| F-186 | severe | C05 | 511202 | 511202 LINING - TRAY - BACK LOWER - B2 has no drawing, and D-89 part 4 (flat sheet part on its DXF) doesn't apply: its DXF draws on BEND; only CUT and MARK pass, so it is folded; it is folded (4 bends in its STEP); its row's process names bend, brake. | WALL |
| F-144 | severe | C05 | 513101 | 513101 LINING - TRAY - CEILING has no drawing, and D-89 part 4 (flat sheet part on its DXF) doesn't apply: its DXF draws on BEND; only CUT and MARK pass, so it is folded; it is folded (4 bends in its STEP); its row's process names bent. | CEILING |
| F-145 | severe | C05 | 513102 | 513102 LINING - RIB - CEILING has no drawing, and D-89 part 4 (flat sheet part on its DXF) doesn't apply: its DXF draws on BEND; only CUT and MARK pass, so it is folded; it isn't a sheet part (24.0 thick across 44.0); its row's process names bent. | CEILING |
| F-260 | severe | C05 | 611103 | 611103 AIR - COLUMN CORNER ANGLE has no drawing PDF (611103_REV_NAME_DWG.pdf under v2/02-Drawings). | CEILING |
| F-262 | severe | C05 | 611105 | 611105 AIR - KICK GRILLE has no drawing PDF (611105_REV_NAME_DWG.pdf under v2/02-Drawings). | CEILING |
| F-263 | severe | C05 | 611301 | 611301 AIR - CARTRIDGE CASING has no drawing PDF (611301_REV_NAME_DWG.pdf under v2/02-Drawings). | CEILING |
| F-264 | severe | C05 | 611302 | 611302 AIR - CARTRIDGE LAYER 50 has no drawing PDF (611302_REV_NAME_DWG.pdf under v2/02-Drawings). | CEILING |
| F-265 | severe | C05 | 611401 | 611401 AIR - FAN BOX CASING - EXHAUST has no drawing PDF (611401_REV_NAME_DWG.pdf under v2/02-Drawings). | CEILING |
| F-266 | severe | C05 | 611402 | 611402 AIR - FAN BOX CASING - SUPPLY has no drawing PDF (611402_REV_NAME_DWG.pdf under v2/02-Drawings). | CEILING |
| F-267 | severe | C05 | 611501 | 611501 AIR - INTAKE RISER has no drawing PDF (611501_REV_NAME_DWG.pdf under v2/02-Drawings). | CEILING |
| F-268 | severe | C05 | 611601 | 611601 AIR - ROOF SLEEVE has no drawing PDF (611601_REV_NAME_DWG.pdf under v2/02-Drawings). | CEILING |
| F-153 | severe | C05 | 811101 | 811101 INTERIOR - LEDGE - TOP has no drawing, and D-89 part 4 (flat sheet part on its DXF) doesn't apply: its DXF draws on BEND; only CUT and MARK pass, so it is folded; its faces lie at 3 levels through the thickness (a pocket, a step or a rebate); its row's process names bend, brake. | CEILING |
| F-154 | severe | C05 | 811201 | 811201 INTERIOR - LIGHT SHELF - BACK has no drawing, and D-89 part 4 (flat sheet part on its DXF) doesn't apply: its DXF draws on BEND; only CUT and MARK pass, so it is folded; it isn't a sheet part (40.0 thick across 60.0); its row's process names bend, brake. | CEILING |
| F-155 | severe | C05 | 811202 | 811202 INTERIOR - LIGHT SHELF - SIDE LH has no drawing, and D-89 part 4 (flat sheet part on its DXF) doesn't apply: its DXF draws on BEND; only CUT and MARK pass, so it is folded; it isn't a sheet part (40.0 thick across 60.0); its row's process names bend, brake. | CEILING |
| F-156 | severe | C05 | 811203 | 811203 INTERIOR - LIGHT SHELF - SIDE RH has no drawing, and D-89 part 4 (flat sheet part on its DXF) doesn't apply: its DXF draws on BEND; only CUT and MARK pass, so it is folded; it isn't a sheet part (40.0 thick across 60.0); its row's process names bend, brake. | CEILING |
| F-244 | severe | C09 | 611205 SOFFIT RAIL DOOR hole Ø6.6 at X -950 Y -635 Z 2348 | Hole Ø6.60 in 611205 SOFFIT RAIL DOOR is 8.5 mm from the free edge (centre to edge), 1.29 diameters; the rule is at least 2 diameters (13.2 mm). Hole centre X -950 Y -635 Z 2348 in the part's own coordinates. | CEILING |
| F-245 | severe | C09 | 611205 SOFFIT RAIL DOOR hole Ø6.6 at X -1100 Y -635 Z 2348 | Hole Ø6.60 in 611205 SOFFIT RAIL DOOR is 8.5 mm from the free edge (centre to edge), 1.29 diameters; the rule is at least 2 diameters (13.2 mm). Hole centre X -1100 Y -635 Z 2348 in the part's own coordinates. | CEILING |
| F-039 | major | C05 | 110000 | 110000 BASE has no drawing PDF (110000_REV_NAME_DWG.pdf under v2/02-Drawings) though its CAD is in v2/03-Manufacturing/base/110000_P01_BASE_STEP.step. | BASE |
| F-350 | major | C05 | 110102 | 110102 BASE - BAND ASSY - SIDE - RH has no drawing PDF (110102_REV_NAME_DWG.pdf under v2/02-Drawings). | BASE |
| F-041 | major | C05 | 110103 | 110103 BASE - BAND ASSY - BACK has no drawing PDF (110103_REV_NAME_DWG.pdf under v2/02-Drawings). | BASE |
| F-351 | major | C05 | 110106 | 110106 BASE - BAND ASSY - FRONT - FIXED GLASS has no drawing PDF (110106_REV_NAME_DWG.pdf under v2/02-Drawings). | BASE |
| F-019 | major | C05 | 210101 | 210101 WALL - PANEL ASSY - SIDE LOWER - LH has no drawing PDF (210101_REV_NAME_DWG.pdf under v2/02-Drawings) though its CAD is in v2/03-Manufacturing/wall/210101_P01_WALL-PANEL-ASSY-SIDE-LOWER-LH_STEP.step. | WALL |
| F-106 | major | C05 | 210102 | 210102 WALL - PANEL ASSY - SIDE LOWER - RH has no drawing PDF (210102_REV_NAME_DWG.pdf under v2/02-Drawings) though its CAD is in v2/03-Manufacturing/wall/210102_P01_WALL-PANEL-ASSY-SIDE-LOWER-RH_STEP.step. | WALL |
| F-107 | major | C05 | 210103 | 210103 WALL - PANEL ASSY - SIDE UPPER - LH has no drawing PDF (210103_REV_NAME_DWG.pdf under v2/02-Drawings) though its CAD is in v2/03-Manufacturing/wall/210103_P01_WALL-PANEL-ASSY-SIDE-UPPER-LH_STEP.step. | WALL |
| F-108 | major | C05 | 210104 | 210104 WALL - PANEL ASSY - SIDE UPPER - RH has no drawing PDF (210104_REV_NAME_DWG.pdf under v2/02-Drawings) though its CAD is in v2/03-Manufacturing/wall/210104_P01_WALL-PANEL-ASSY-SIDE-UPPER-RH_STEP.step. | WALL |
| F-177 | major | C05 | 210201 | 210201 WALL - PANEL ASSY - BACK LOWER - B1 has no drawing PDF (210201_REV_NAME_DWG.pdf under v2/02-Drawings) though its CAD is in v2/03-Manufacturing/wall/210201_P01_WALL-PANEL-ASSY-BACK-LOWER-B1_STEP.step. | WALL |
| F-178 | major | C05 | 210202 | 210202 WALL - PANEL ASSY - BACK LOWER - B2 has no drawing PDF (210202_REV_NAME_DWG.pdf under v2/02-Drawings) though its CAD is in v2/03-Manufacturing/wall/210202_P01_WALL-PANEL-ASSY-BACK-LOWER-B2_STEP.step. | WALL |
| F-022 | major | C05 | 211501 | 211501 WALL - CAVITY FILL - SIDE LOWER - LH has no drawing, and D-89's cut-list route doesn't apply: its row names pockets, so it isn't a plain rectangle. | WALL |
| F-115 | major | C05 | 211502 | 211502 WALL - CAVITY FILL - SIDE LOWER - RH has no drawing, and D-89's cut-list route doesn't apply: its row names pockets, so it isn't a plain rectangle. | WALL |
| F-116 | major | C05 | 211503 | 211503 WALL - CAVITY FILL - SIDE UPPER - LH has no drawing, and D-89's cut-list route doesn't apply: its row names pockets, so it isn't a plain rectangle. | WALL |
| F-117 | major | C05 | 211504 | 211504 WALL - CAVITY FILL - SIDE UPPER - RH has no drawing, and D-89's cut-list route doesn't apply: its row names pockets, so it isn't a plain rectangle. | WALL |
| F-181 | major | C05 | 211601 | 211601 WALL - CAVITY FILL - BACK LOWER - B1 has no drawing, and D-89's cut-list route doesn't apply: its row names pockets, so it isn't a plain rectangle. | WALL |
| F-182 | major | C05 | 211602 | 211602 WALL - CAVITY FILL - BACK LOWER - B2 has no drawing, and D-89's cut-list route doesn't apply: its row names pockets, so it isn't a plain rectangle. | WALL |
| F-195 | major | C05 | 350001 | 350001 FRONT - DECOR BLOCK ASSY - DL has no drawing PDF (350001_REV_NAME_DWG.pdf under v2/02-Drawings) though its CAD is in v2/03-Manufacturing/front/350001_P01_FRONT-DECOR-BLOCK-ASSY-DL_STEP.step. | FRONT |
| F-196 | major | C05 | 350002 | 350002 FRONT - DECOR BLOCK ASSY - DT has no drawing PDF (350002_REV_NAME_DWG.pdf under v2/02-Drawings) though its CAD is in v2/03-Manufacturing/front/350002_P01_FRONT-DECOR-BLOCK-ASSY-DT_STEP.step. | FRONT |
| F-197 | major | C05 | 350003 | 350003 FRONT - DECOR BLOCK ASSY - DR has no drawing PDF (350003_REV_NAME_DWG.pdf under v2/02-Drawings) though its CAD is in v2/03-Manufacturing/front/350003_P01_FRONT-DECOR-BLOCK-ASSY-DR_STEP.step. | FRONT |
| F-198 | major | C05 | 350004 | 350004 FRONT - AIR SUPPLY ASSY - DR is a reserved space until AIR designs it (D-105): typed reserved air space in v2/03-Manufacturing/front/350003_P01_FRONT-DECOR-BLOCK-ASSY-DR_BOM.csv. | AIR |
| F-207 | major | C05 | 351402 | 351402 FRONT - AIR INTAKE RISER - DR is a reserved space until AIR designs it (Lead 2026-11-01 (every air part is an AIR number in AIR's tree)): the space in FRONT's DR block for AIR's intake riser (611501 in AIR's supply-box assembly): a reserved air space with no mass, no drawing and no BOM count. | AIR |
| F-208 | major | C05 | 351403 | 351403 FRONT - AIR TRANSITION - LOWER - DR is a reserved space until AIR designs it (Lead 2026-11-01 (every air part is an AIR number in AIR's tree)): the space in FRONT's DR block for the lower air transition, which AIR designs: a reserved air space with no mass, no drawing and no BOM count. | AIR |
| F-209 | major | C05 | 351404 | 351404 FRONT - SUPPLY FAN BOX - DR is a reserved space until AIR designs it (Lead 2026-11-01 (every air part is an AIR number in AIR's tree)): the space in FRONT's DR block for AIR's supply fan box (610401 in AIR's supply-box assembly): a reserved air space with no mass, no drawing and no BOM count. | AIR |
| F-210 | major | C05 | 351405 | 351405 FRONT - AIR TRANSITION - UPPER - DR is a reserved space until AIR designs it (Lead 2026-11-01 (every air part is an AIR number in AIR's tree)): the space in FRONT's DR block for the upper air transition, which AIR designs: a reserved air space with no mass, no drawing and no BOM count. | AIR |
| F-029 | major | C05 | 360001 | 360001 FRONT - DOOR UNIT has no drawing PDF (360001_REV_NAME_DWG.pdf under v2/02-Drawings) though its CAD is in v2/03-Manufacturing/front/360001_P01_FRONT-DOOR-UNIT_STEP.step. | FRONT |
| F-096 | major | C05 | 360002 | 360002 FRONT - FIXED GLASS UNIT has no drawing PDF (360002_REV_NAME_DWG.pdf under v2/02-Drawings) though its CAD is in v2/03-Manufacturing/front/360002_P01_FRONT-FIXED-GLASS-UNIT_STEP.step. | FRONT |
| F-339 | major | C05 | 368004 | 368004 FRONT - GLAZING U-PROFILE - BOHLE BO5201571 has no drawing PDF (368004_REV_NAME_DWG.pdf under v2/02-Drawings). D-143: a bought profile cut into mitred lengths with holes is a made part, with one table drawing (D-89), not a cut list alone; FRONT's 368004 is held until the generator reads profiles. | FRONT |
| F-138 | major | C05 | 410000 | 410000 CEILING has no drawing PDF (410000_REV_NAME_DWG.pdf under v2/02-Drawings) though its CAD is in v2/03-Manufacturing/ceiling/410000_P01_CEILING_STEP.step. | CEILING |
| F-140 | major | C05 | 410102 | 410102 CEILING - PANEL ASSY - C2 has no drawing PDF (410102_REV_NAME_DWG.pdf under v2/02-Drawings). | CEILING |
| F-023 | major | C05 | 510101 | 510101 LINING - CASSETTE - SIDE LOWER - LH has no drawing PDF (510101_REV_NAME_DWG.pdf under v2/02-Drawings) though its CAD is in v2/03-Manufacturing/wall/510101_P01_LINING-CASSETTE-SIDE-LOWER-LH_STEP.step. | WALL |
| F-118 | major | C05 | 510102 | 510102 LINING - CASSETTE - SIDE LOWER - RH has no drawing PDF (510102_REV_NAME_DWG.pdf under v2/02-Drawings) though its CAD is in v2/03-Manufacturing/wall/510102_P01_LINING-CASSETTE-SIDE-LOWER-RH_STEP.step. | WALL |
| F-119 | major | C05 | 510103 | 510103 LINING - CASSETTE - SIDE UPPER - LH has no drawing PDF (510103_REV_NAME_DWG.pdf under v2/02-Drawings) though its CAD is in v2/03-Manufacturing/wall/510103_P01_LINING-CASSETTE-SIDE-UPPER-LH_STEP.step. | WALL |
| F-120 | major | C05 | 510104 | 510104 LINING - CASSETTE - SIDE UPPER - RH has no drawing PDF (510104_REV_NAME_DWG.pdf under v2/02-Drawings) though its CAD is in v2/03-Manufacturing/wall/510104_P01_LINING-CASSETTE-SIDE-UPPER-RH_STEP.step. | WALL |
| F-183 | major | C05 | 510201 | 510201 LINING - CASSETTE - BACK LOWER - B1 has no drawing PDF (510201_REV_NAME_DWG.pdf under v2/02-Drawings) though its CAD is in v2/03-Manufacturing/wall/510201_P01_LINING-CASSETTE-BACK-LOWER-B1_STEP.step. | WALL |
| F-184 | major | C05 | 510202 | 510202 LINING - CASSETTE - BACK LOWER - B2 has no drawing PDF (510202_REV_NAME_DWG.pdf under v2/02-Drawings) though its CAD is in v2/03-Manufacturing/wall/510202_P01_LINING-CASSETTE-BACK-LOWER-B2_STEP.step. | WALL |
| F-143 | major | C05 | 510301 | 510301 LINING - CASSETTE - CEILING - COMMON has no drawing PDF (510301_REV_NAME_DWG.pdf under v2/02-Drawings). | CEILING |
| F-254 | major | C05 | 610000 | 610000 AIR has no drawing PDF (610000_REV_NAME_DWG.pdf under v2/02-Drawings) though its CAD is in v2/03-Manufacturing/air/610000_P01_AIR_STEP.step. | CEILING |
| F-256 | major | C05 | 610201 | 610201 AIR - SOFFIT has no drawing PDF (610201_REV_NAME_DWG.pdf under v2/02-Drawings). | CEILING |
| F-257 | major | C05 | 610301 | 610301 AIR - SPLITTER CARTRIDGE - COMMON has no drawing PDF (610301_REV_NAME_DWG.pdf under v2/02-Drawings). | CEILING |
| F-258 | major | C05 | 610401 | 610401 AIR - SUPPLY FAN BOX has no drawing PDF (610401_REV_NAME_DWG.pdf under v2/02-Drawings). | CEILING |
| F-259 | major | C05 | 610402 | 610402 AIR - EXHAUST FAN BOX has no drawing PDF (610402_REV_NAME_DWG.pdf under v2/02-Drawings). | CEILING |
| F-261 | major | C05 | 611104 | 611104 AIR - COLUMN FILL has no drawing, and D-89's cut-list route doesn't apply: it isn't a plain rectangle (a body in its STEP has 10 faces, a block has 6: pockets or notches). | CEILING |
| F-338 | major | C05 | 810000 | 810000 INTERIOR has no drawing PDF (810000_REV_NAME_DWG.pdf under v2/02-Drawings) though its CAD is in v2/03-Manufacturing/interior/810000_P01_INTERIOR_STEP.step. | CEILING |
| F-151 | major | C05 | 810101 | 810101 INTERIOR - WORK WALL LEDGE ASSY has no drawing PDF (810101_REV_NAME_DWG.pdf under v2/02-Drawings). | CEILING |
| F-152 | major | C05 | 810201 | 810201 INTERIOR - LIGHT SHELF ASSY has no drawing PDF (810201_REV_NAME_DWG.pdf under v2/02-Drawings). | CEILING |
| F-160 | major | C06 | 211101 | 211101 WALL - PANEL FRAME - SIDE LOWER - LH is one component holding 7 bodies of 5 different shapes (RAIL - BOTTOM, RAIL - TOP, STILE - BACK, STILE - FRONT, STILE - MID 1, STILE - MID 2, STILE - MID 3) in 210101_P01_WALL-PANEL-ASSY-SIDE-LOWER-LH_STEP.step (7 bodies); 211101_P01_WALL-PANEL-FRAME-SIDE-LOWER-LH_STEP.step (7 bodies). D-120 (build plan rule 2, BP-04): every part is its own component with its own number, never a loose body. | WALL |
| F-161 | major | C06 | 211102 | 211102 WALL - PANEL FRAME - SIDE LOWER - RH is one component holding 7 bodies of 5 different shapes (RAIL - BOTTOM, RAIL - TOP, STILE - BACK, STILE - FRONT, STILE - MID 1, STILE - MID 2, STILE - MID 3) in 210102_P01_WALL-PANEL-ASSY-SIDE-LOWER-RH_STEP.step (7 bodies); 211102_P01_WALL-PANEL-FRAME-SIDE-LOWER-RH_STEP.step (7 bodies). D-120 (build plan rule 2, BP-04): every part is its own component with its own number, never a loose body. | WALL |
| F-162 | major | C06 | 211103 | 211103 WALL - PANEL FRAME - SIDE UPPER - LH is one component holding 7 bodies of 5 different shapes (RAIL - BOTTOM, RAIL - TOP, STILE - BACK, STILE - FRONT, STILE - MID 1, STILE - MID 2, STILE - MID 3) in 210103_P01_WALL-PANEL-ASSY-SIDE-UPPER-LH_STEP.step (7 bodies); 211103_P01_WALL-PANEL-FRAME-SIDE-UPPER-LH_STEP.step (7 bodies). D-120 (build plan rule 2, BP-04): every part is its own component with its own number, never a loose body. | WALL |
| F-163 | major | C06 | 211104 | 211104 WALL - PANEL FRAME - SIDE UPPER - RH is one component holding 7 bodies of 5 different shapes (RAIL - BOTTOM, RAIL - TOP, STILE - BACK, STILE - FRONT, STILE - MID 1, STILE - MID 2, STILE - MID 3) in 210104_P01_WALL-PANEL-ASSY-SIDE-UPPER-RH_STEP.step (7 bodies); 211104_P01_WALL-PANEL-FRAME-SIDE-UPPER-RH_STEP.step (7 bodies). D-120 (build plan rule 2, BP-04): every part is its own component with its own number, never a loose body. | WALL |
| F-173 | major | C06 | 211201 | 211201 WALL - PANEL FRAME - BACK LOWER - B1 is one component holding 6 bodies of 5 different shapes (RAIL - BOTTOM, RAIL - TOP, STILE - CENTRE, STILE - MID 1, STILE - MID 2, STILE - OUTER) in 210201_P01_WALL-PANEL-ASSY-BACK-LOWER-B1_STEP.step (6 bodies); 211201_P01_WALL-PANEL-FRAME-BACK-LOWER-B1_STEP.step (6 bodies). D-120 (build plan rule 2, BP-04): every part is its own component with its own number, never a loose body. | WALL |
| F-174 | major | C06 | 211202 | 211202 WALL - PANEL FRAME - BACK LOWER - B2 is one component holding 6 bodies of 5 different shapes (RAIL - BOTTOM, RAIL - TOP, STILE - CENTRE, STILE - MID 1, STILE - MID 2, STILE - OUTER) in 210202_P01_WALL-PANEL-ASSY-BACK-LOWER-B2_STEP.step (6 bodies). D-120 (build plan rule 2, BP-04): every part is its own component with its own number, never a loose body. | WALL |
| F-164 | major | C06 | 211501 | 211501 WALL - CAVITY FILL - SIDE LOWER - LH is one component holding 4 bodies of 3 different shapes (FILL - BAY 1, FILL - BAY 2, FILL - BAY 3, FILL - BAY 4) in 210101_P01_WALL-PANEL-ASSY-SIDE-LOWER-LH_STEP.step (4 bodies); 211501_P01_WALL-CAVITY-FILL-SIDE-LOWER-LH_STEP.step (4 bodies). D-120 (build plan rule 2, BP-04): every part is its own component with its own number, never a loose body. | WALL |
| F-165 | major | C06 | 211502 | 211502 WALL - CAVITY FILL - SIDE LOWER - RH is one component holding 4 bodies of 3 different shapes (FILL - BAY 1, FILL - BAY 2, FILL - BAY 3, FILL - BAY 4) in 210102_P01_WALL-PANEL-ASSY-SIDE-LOWER-RH_STEP.step (4 bodies). D-120 (build plan rule 2, BP-04): every part is its own component with its own number, never a loose body. | WALL |
| F-166 | major | C06 | 211503 | 211503 WALL - CAVITY FILL - SIDE UPPER - LH is one component holding 4 bodies of 3 different shapes (FILL - BAY 1, FILL - BAY 2, FILL - BAY 3, FILL - BAY 4) in 210103_P01_WALL-PANEL-ASSY-SIDE-UPPER-LH_STEP.step (4 bodies). D-120 (build plan rule 2, BP-04): every part is its own component with its own number, never a loose body. | WALL |
| F-167 | major | C06 | 211504 | 211504 WALL - CAVITY FILL - SIDE UPPER - RH is one component holding 4 bodies of 3 different shapes (FILL - BAY 1, FILL - BAY 2, FILL - BAY 3, FILL - BAY 4) in 210104_P01_WALL-PANEL-ASSY-SIDE-UPPER-RH_STEP.step (4 bodies). D-120 (build plan rule 2, BP-04): every part is its own component with its own number, never a loose body. | WALL |
| F-175 | major | C06 | 211601 | 211601 WALL - CAVITY FILL - BACK LOWER - B1 is one component holding 3 bodies of 3 different shapes (FILL - BAY 1, FILL - BAY 2, FILL - BAY 3) in 210201_P01_WALL-PANEL-ASSY-BACK-LOWER-B1_STEP.step (3 bodies); 211601_P01_WALL-CAVITY-FILL-BACK-LOWER-B1_STEP.step (3 bodies). D-120 (build plan rule 2, BP-04): every part is its own component with its own number, never a loose body. | WALL |
| F-176 | major | C06 | 211602 | 211602 WALL - CAVITY FILL - BACK LOWER - B2 is one component holding 3 bodies of 3 different shapes (FILL - BAY 1, FILL - BAY 2, FILL - BAY 3) in 210202_P01_WALL-PANEL-ASSY-BACK-LOWER-B2_STEP.step (3 bodies). D-120 (build plan rule 2, BP-04): every part is its own component with its own number, never a loose body. | WALL |
| F-190 | major | C06 | 351103 | 351103 FRONT - DOOR HINGE-SIDE STOP - DL is one component holding 4 bodies of 3 different shapes (HINGE-SIDE STOP 1 (ANGLE, BONDED), HINGE-SIDE STOP 2 (ANGLE, BONDED), HINGE-SIDE STOP 3 (ANGLE, BONDED), HINGE-SIDE STOP 4 (ANGLE, BONDED)) in 350001_P01_FRONT-DECOR-BLOCK-ASSY-DL_STEP.step (4 bodies). D-120 (build plan rule 2, BP-04): every part is its own component with its own number, never a loose body. | FRONT |
| F-191 | major | C06 | 351104 | 351104 FRONT - DECOR FRAME - DL is one component holding 26 bodies of 16 different shapes (B01 BACK RING BOTTOM 20 x 20 x 1.5, B02 BACK RING DOOR SIDE 20 x 20 x 1.5, B03 BACK RING SLOPE UNDER DT 20 x 20 x 1.5, B04 BACK RING BOLT LINE 60 x 20 x 1.5, H1 HINGE POST 1 (HINGE H1) 60 x 20 x 1.5, H2 HINGE POST 2 (HINGE H2) 60 x 20 x 1.5, H3 HINGE POST 3 (HINGE H3) 60 x 20 x 1.5, P1 DOOR-SIDE FRO) in 350001_P01_FRONT-DECOR-BLOCK-ASSY-DL_STEP.step (26 bodies). D-120 (build plan rule 2, BP-04): every part is its own component with its own number, never a loose body. | FRONT |
| F-192 | major | C06 | 351204 | 351204 FRONT - DECOR FRAME - DT is one component holding 13 bodies of 11 different shapes (B01 BACK RING BOTTOM 20 x 20 x 1.5, B02 BACK RING DR JOINT 20 x 20 x 1.5, B03 BACK RING TOP 20 x 20 x 1.5, B04 BACK RING SLOPE OVER DL 20 x 20 x 1.5, B05 BACK RING POST 20 x 20 x 1.5, C01 CHAMFER CROSS TUBE LEFT 20 x 20 x 1.5, C02 CHAMFER CROSS TUBE MIDDLE 20 x 20 x 1.5, C03 CHAMFER CROSS TUBE RIGHT) in 350002_P01_FRONT-DECOR-BLOCK-ASSY-DT_STEP.step (13 bodies). D-120 (build plan rule 2, BP-04): every part is its own component with its own number, never a loose body. | FRONT |
| F-193 | major | C06 | 351306 | 351306 FRONT - DECOR FRAME - DR is one component holding 24 bodies of 21 different shapes (B01 BACK RING BOTTOM 40 x 20 x 1.2, B02 BACK RING BOLT LINE 80 x 20 x 1.2, B03 BACK RING TOP 20 x 20 x 1.0, B04 BACK RING DT JOINT 20 x 20 x 1.0, B05 BACK RING DT LEDGE 20 x 20 x 1.2, B06 BACK RING DIAGONAL 20 x 20 x 1.0, B07 BACK RING GLASS EDGE 20 x 20 x 1.0, B08 BACK RING BAND 60 x 20 x 1.2, C01 ) in 350003_P01_FRONT-DECOR-BLOCK-ASSY-DR_STEP.step (24 bodies). D-120 (build plan rule 2, BP-04): every part is its own component with its own number, never a loose body. | FRONT |
| F-194 | major | C06 | 368005 | 368005 FRONT - FRAME-STOP SEAL is one component holding 4 bodies of 3 different shapes (FRAME-STOP SEAL PS 1515 - HINGE SIDE 1, FRAME-STOP SEAL PS 1515 - HINGE SIDE 2, FRAME-STOP SEAL PS 1515 - HINGE SIDE 3, FRAME-STOP SEAL PS 1515 - HINGE SIDE 4) in 350001_P01_FRONT-DECOR-BLOCK-ASSY-DL_STEP.step (4 bodies). D-120 (build plan rule 2, BP-04): every part is its own component with its own number, never a loose body. | FRONT |
| F-168 | major | C06 | 411101 | 411101 CEILING - PANEL FRAME - C1 is one component holding 7 bodies of 6 different shapes (C1 BACK MEMBER 40X40, C1 CROSS MEMBER 1, C1 CROSS MEMBER 2, C1 CROSS MEMBER 3, C1 FRONT MEMBER, C1 SEAM MEMBER, C1 SIDE MEMBER) in 410000_P01_CEILING_STEP.step (7 bodies). D-120 (build plan rule 2, BP-04): every part is its own component with its own number, never a loose body. | CEILING |
| F-169 | major | C06 | 411102 | 411102 CEILING - PANEL FRAME - C2 is one component holding 7 bodies of 5 different shapes (C2 BACK MEMBER 40X40, C2 CROSS MEMBER 1, C2 CROSS MEMBER 2, C2 CROSS MEMBER 3, C2 FRONT MEMBER, C2 SEAM MEMBER, C2 SIDE MEMBER) in 410000_P01_CEILING_STEP.step (7 bodies). D-120 (build plan rule 2, BP-04): every part is its own component with its own number, never a loose body. | CEILING |
| F-246 | major | C06 | 610301 | 610301 AIR - SPLITTER CARTRIDGE - COMMON (SUPPLY) is one component holding 4 bodies of 2 different shapes (CARTRIDGE EXHAUST, CARTRIDGE SUPPLY, LAYER 1 EXHAUST, LAYER 1 SUPPLY, LAYER 2 EXHAUST, LAYER 2 SUPPLY, LAYER 3 EXHAUST, LAYER 3 SUPPLY) in 610000_P01_AIR_STEP.step (4 bodies); 610000_P01_AIR_STEP.step (4 bodies). D-120 (build plan rule 2, BP-04): every part is its own component with its own number, never a loose body. | CEILING |
| F-247 | major | C06 | 611103 | 611103 AIR - COLUMN CORNER ANGLE is one component holding 3 bodies of 2 different shapes (COLUMN ANGLE BL, COLUMN ANGLE FL, COLUMN ANGLE FR) in 610000_P01_AIR_STEP.step (3 bodies). D-120 (build plan rule 2, BP-04): every part is its own component with its own number, never a loose body. | CEILING |
| F-248 | major | C06 | 611104 | 611104 AIR - COLUMN FILL is one component holding 2 bodies of 2 different shapes (COLUMN FILL FRONT, COLUMN FILL LEFT) in 610000_P01_AIR_STEP.step (2 bodies). D-120 (build plan rule 2, BP-04): every part is its own component with its own number, never a loose body. | CEILING |
| F-249 | major | C06 | 611105 | 611105 AIR - KICK GRILLE is one component holding 2 bodies of 2 different shapes (KICK GRILLE FRONT, KICK GRILLE LEFT) in 610000_P01_AIR_STEP.step (2 bodies). D-120 (build plan rule 2, BP-04): every part is its own component with its own number, never a loose body. | CEILING |
| F-250 | major | C06 | 611203 | 611203 AIR - SOFFIT FILL is one component holding 2 bodies of 2 different shapes (SOFFIT FILL FRONT, SOFFIT FILL UNDER) in 610000_P01_AIR_STEP.step (2 bodies). D-120 (build plan rule 2, BP-04): every part is its own component with its own number, never a loose body. | CEILING |
| F-170 | major | C06 | 831001 | 831001 HARDWARE - LOCATING SPIGOT - M6 X Ø8 - STAINLESS is one component holding 2 bodies, all copies of one part, in 210101_P01_WALL-PANEL-ASSY-SIDE-LOWER-LH_STEP.step (2 bodies); 210102_P01_WALL-PANEL-ASSY-SIDE-LOWER-RH_STEP.step (2 bodies); 210201_P01_WALL-PANEL-ASSY-BACK-LOWER-B1_STEP.step (2 bodies); 210202_P01_WALL-PANEL-ASSY-BACK-LOWER-B2_STEP.step (2 bodies). D-120 (build plan rule 2, BP-04): every part is its own component, never a loose body; copies are one component placed several times. | WALL |
| F-171 | major | C06 | 831002 | 831002 HARDWARE - STOP WASHER - Ø10.5 X Ø20 X 1.5 - AL is one component holding 7 bodies, all copies of one part, in 210101_P01_WALL-PANEL-ASSY-SIDE-LOWER-LH_STEP.step (7 bodies); 210102_P01_WALL-PANEL-ASSY-SIDE-LOWER-RH_STEP.step (7 bodies); 210103_P01_WALL-PANEL-ASSY-SIDE-UPPER-LH_STEP.step (7 bodies); 210104_P01_WALL-PANEL-ASSY-SIDE-UPPER-RH_STEP.step (7 bodies); 210201_P01_WALL-PANEL-ASSY-BACK-LOWER-B1_STEP.step (4 bodies); 210202_P01_WALL-PANEL-ASSY-BACK-LOWER-B2_STEP.step (4 bodies). D-120 (build plan rule 2, BP-04): every part is its own component, never a loose body; copies are one component placed several times. | WALL |
| F-251 | major | C06 | 838002 | 838002 HARDWARE - SOCKET HEAD BOLT - M6 X 25 - ISO 4762 8.8 ZINC is one component holding 4 bodies of 2 different shapes (LOCK SCREW 1 HEAD, LOCK SCREW 1 SHANK, LOCK SCREW 2 HEAD, LOCK SCREW 2 SHANK) in 610000_P01_AIR_STEP.step (4 bodies). D-120 (build plan rule 2, BP-04): every part is its own component with its own number, never a loose body. | CEILING |
| F-172 | major | C06 | 838003 | 838003 HARDWARE - RIVET NUT - M6 - SHEREX CAH3-610-4.2 is one component holding 9 bodies, all copies of one part, in 210101_P01_WALL-PANEL-ASSY-SIDE-LOWER-LH_STEP.step (9 bodies); 210102_P01_WALL-PANEL-ASSY-SIDE-LOWER-RH_STEP.step (9 bodies); 210103_P01_WALL-PANEL-ASSY-SIDE-UPPER-LH_STEP.step (7 bodies); 210104_P01_WALL-PANEL-ASSY-SIDE-UPPER-RH_STEP.step (7 bodies); 210201_P01_WALL-PANEL-ASSY-BACK-LOWER-B1_STEP.step (6 bodies); 210202_P01_WALL-PANEL-ASSY-BACK-LOWER-B2_STEP.step (9 bodies). D-120 (build plan rule 2, BP-04): every part is its own component, never a loose body; copies are one component placed several times. | WALL |
| F-189 | major | C06 | 831001 | 831001's body in 210101_P01_WALL-PANEL-ASSY-SIDE-LOWER-LH_STEP.step, 210102_P01_WALL-PANEL-ASSY-SIDE-LOWER-RH_STEP.step, 210201_P01_WALL-PANEL-ASSY-BACK-LOWER-B1_STEP.step, 210202_P01_WALL-PANEL-ASSY-BACK-LOWER-B2_STEP.step isn't the part its own STEP 831001_P01_HARDWARE-LOCATING-SPIGOT_STEP.step holds: its sizes differ (own STEP: 0 holes, sizes ((2.94, 8.0), (4.0, 6.24)); the copy: 0 holes, sizes ((3.0, 10.0), (4.0, 7.24))), whichever way the copy is turned. The assembly's fits were set round the copy. | WALL; Joints Engineer |
| F-279 | major | C06 | 838003 | 838003 is named 'HARDWARE - RIVET NUT - M6 - SHEREX CAH3-610-4.2' in the CAD (210101_P01_WALL-PANEL-ASSY-SIDE-LOWER-LH_STEP.step, 210102_P01_WALL-PANEL-ASSY-SIDE-LOWER-RH_STEP.step, 210103_P01_WALL-PANEL-ASSY-SIDE-UPPER-LH_STEP.step, 210104_P01_WALL-PANEL-ASSY-SIDE-UPPER-RH_STEP.step, 210201_P01_WALL-PANEL-ASSY-BACK-LOWER-B1_STEP.step, 210202_P01_WALL-PANEL-ASSY-BACK-LOWER-B2_STEP.step) and the parts lists v2/03-Manufacturing/electrical/710000_P01_ELECTRICAL-PARTS-LIST_BOM.csv, v2/03-Manufacturing/wall/210101_P01_WALL-PANEL-ASSY-SIDE-LOWER-LH_BOM.csv, v2/03-Manufacturing/wall/210102_P01_WALL-PANEL-ASSY-SIDE-LOWER-RH_BOM.csv, v2/03-Manufacturing/wall/210103_P01_WALL-PANEL-ASSY-SIDE-UPPER-LH_BOM.csv, v2/03-Manufacturing/wall/210104_P01_WALL-PANEL-ASSY-SIDE-UPPER-RH_BOM.csv, v2/03-Manufacturing/wall/210201_P01_WALL-PANEL-ASSY-BACK-LOWER-B1_BOM.csv, v2/03-Manufacturing/wall/210202_P01_WALL-PANEL-ASSY-BACK-LOWER-B2_BOM.csv; the joints register names it 'HARDWARE - RIVET NUT - M6 - STEEL ZINC - SHEREX CAH2-610-4.2', and hardware names come from the register (D-99). The names differ in CAH3-610-4.2 (gone), CAH2-610-4.2 (new), STEEL (new), ZINC (new), so they name a different part. | ELECTRICAL; WALL |
| F-346 | major | C06 | 108002 | 108002 is named 'POD - ACP BOND SET - SIKATACK PANEL-50 WITH AKTIVATOR-205, PANEL PRIMER, FIXING TAPE' in the parts lists v2/03-Manufacturing/ceiling/410000_P01_CEILING-PARTS-LIST_BOM.csv, v2/03-Manufacturing/wall/210101_P01_WALL-PANEL-ASSY-SIDE-LOWER-LH_BOM.csv, v2/03-Manufacturing/wall/210102_P01_WALL-PANEL-ASSY-SIDE-LOWER-RH_BOM.csv, v2/03-Manufacturing/wall/210103_P01_WALL-PANEL-ASSY-SIDE-UPPER-LH_BOM.csv, v2/03-Manufacturing/wall/210104_P01_WALL-PANEL-ASSY-SIDE-UPPER-RH_BOM.csv, v2/03-Manufacturing/wall/210201_P01_WALL-PANEL-ASSY-BACK-LOWER-B1_BOM.csv, v2/03-Manufacturing/wall/210202_P01_WALL-PANEL-ASSY-BACK-LOWER-B2_BOM.csv; the joints register names it 'POD - ACP BOND SET - SIKAFLEX-252 WITH AKTIVATOR-205, PRIMER-210, FIXING TAPE', and hardware names come from the register (D-99). The names differ in PANEL-50 (gone), PRIMER-210 (new), SIKAFLEX-252 (new), so they name a different part. | CEILING; WALL |
| F-252 | major | C06 | 611301 | 611301 AIR - CARTRIDGE CASING is in v2/03-Manufacturing/air/610000_P01_AIR-PARTS-LIST_BOM.csv but in no STEP file in v2/03-Manufacturing. | CEILING |
| F-253 | major | C06 | 611302 | 611302 AIR - CARTRIDGE LAYER 50 is in v2/03-Manufacturing/air/610000_P01_AIR-PARTS-LIST_BOM.csv but in no STEP file in v2/03-Manufacturing. | CEILING |
| F-340 | major | C06 | 111215 | 111215 BASE - CORNER KEY - SQUARE - INLINE is in v2/03-Manufacturing/joints/V2-MFG-JNT-01_P01_JOINTS-MADE-HARDWARE_SPEC.csv but in no STEP file in v2/03-Manufacturing. | Joints Engineer |
| F-227 | major | C08 | assembly SOFFIT RAIL DOOR holes Ø6.60 | 610000_P01_AIR_CAD / 610201 AIR - SOFFIT:1 / 611205 AIR - SOFFIT TOP RAIL - DOOR SIDE:1 / SOFFIT RAIL DOOR has 2 hole(s) of Ø6.60 facing a rivnut (C1 FRONT MEMBER). An M6 clearance hole smaller than the ruled 7.0 mm: with a rivnut on the other side the bolt float drops to 0.31 mm and the joint may not go together (stack ST-03). Rule: confirmed: D-64 and D-75 (holes Ø7.0) with the F-009 ruling: position Ø0.4 (±0.2) from the spigot hole, by CNC or jig. | CEILING |
| F-273 | major | C09 | assembly 211101 SIDE LOWER - LH | 211101 SIDE LOWER - LH has 4 bay(s) wider than 275 mm clear under the ACP skin, the widest 344.9 mm: the skin would flex over 2 mm under a 100 N push at its centre (D-135; WALL's span table: 274.8 mm clear gives 1.99 mm). | WALL |
| F-274 | major | C09 | assembly 211102 SIDE LOWER - RH | 211102 SIDE LOWER - RH has 4 bay(s) wider than 275 mm clear under the ACP skin, the widest 344.9 mm: the skin would flex over 2 mm under a 100 N push at its centre (D-135; WALL's span table: 274.8 mm clear gives 1.99 mm). | WALL |
| F-275 | major | C09 | assembly 211103 SIDE UPPER - LH | 211103 SIDE UPPER - LH has 4 bay(s) wider than 275 mm clear under the ACP skin, the widest 344.9 mm: the skin would flex over 2 mm under a 100 N push at its centre (D-135; WALL's span table: 274.8 mm clear gives 1.99 mm). | WALL |
| F-276 | major | C09 | assembly 211104 SIDE UPPER - RH | 211104 SIDE UPPER - RH has 4 bay(s) wider than 275 mm clear under the ACP skin, the widest 344.9 mm: the skin would flex over 2 mm under a 100 N push at its centre (D-135; WALL's span table: 274.8 mm clear gives 1.99 mm). | WALL |
| F-277 | major | C09 | assembly 211201 BACK LOWER - B1 | 211201 BACK LOWER - B1 has 3 bay(s) wider than 275 mm clear under the ACP skin, the widest 373.0 mm: the skin would flex over 2 mm under a 100 N push at its centre (D-135; WALL's span table: 274.8 mm clear gives 1.99 mm). | WALL |
| F-278 | major | C09 | assembly 211202 BACK LOWER - B2 | 211202 BACK LOWER - B2 has 3 bay(s) wider than 275 mm clear under the ACP skin, the widest 373.0 mm: the skin would flex over 2 mm under a 100 N push at its centre (D-135; WALL's span table: 274.8 mm clear gives 1.99 mm). | WALL |
| F-347 | major | C09 | 111101 BASE - BAND TUBE - SIDE - LH - TUBE hole Ø7.0 at X -1231 Y 837 Z 11 | Hole Ø7.00 in 111101 BASE - BAND TUBE - SIDE - LH - TUBE is 13.0 mm from the free edge (centre to edge), 1.86 diameters; the rule is at least 2 diameters (14.0 mm). Hole centre X -1231 Y 837 Z 11 in the part's own coordinates. | BASE |
| F-348 | major | C09 | 111102 BASE - BAND TUBE - SIDE - RH - TUBE hole Ø7.0 at X 1231 Y 837 Z 11 | Hole Ø7.00 in 111102 BASE - BAND TUBE - SIDE - RH - TUBE is 13.0 mm from the free edge (centre to edge), 1.86 diameters; the rule is at least 2 diameters (14.0 mm). Hole centre X 1231 Y 837 Z 11 in the part's own coordinates. | BASE |
| F-349 | major | C09 | 111101 BASE - BAND TUBE - SIDE - LH - TUBE hole Ø7.0 at X 13 Y 19 Z 1 | Hole Ø7.00 in 111101 BASE - BAND TUBE - SIDE - LH - TUBE is 13.0 mm from the free edge (centre to edge), 1.86 diameters; the rule is at least 2 diameters (14.0 mm). Hole centre X 13 Y 19 Z 1 in the part's own coordinates. | BASE |
| F-348 | major | C09 | 111102 BASE - BAND TUBE - SIDE - RH - TUBE hole Ø7.0 at X 1231 Y 837 Z 11 | Hole Ø7.00 in 111102 BASE - BAND TUBE - SIDE - RH - TUBE is 13.0 mm from the free edge (centre to edge), 1.86 diameters; the rule is at least 2 diameters (14.0 mm). Hole centre X 1231 Y 837 Z 11 in the part's own coordinates. | BASE |
| F-312 | major | C11 | 211101 | 211101 WALL - PANEL FRAME - SIDE LOWER - LH: D-131 makes it welded galvanized steel (joints register J-FRAME-01: S280GD+Z or SGC400, Z100, 1.2/1.0/0.8 mm gauges, zinc-rich touch-up on the welds), but its row (210101_P01_WALL-PANEL-ASSY-SIDE-LOWER-LH_BOM.csv line 3) lacks galvanized steel (it reads 'aluminium tube 6063-T6: perimeter 20 x 40 and 40 x 40 x 1.2, studs 20 x 40 x 1 ('); its finish (210101_P01_WALL-PANEL-ASSY-SIDE-LOWER-LH_BOM.csv line 3) doesn't name the zinc ('mill finish with the bond prep (D-79)'); 5 member rows not in J-FRAME-01's steel: RAIL - BOTTOM (cut length) (210101_P01_WALL-PANEL-ASSY-SIDE-LOWER-LH_BOM.csv line 4): galvanized steel (it reads 'aluminium tube 6063-T6 20 x 40 x 1.2'), RAIL - TOP (cut length) (210101_P01_WALL-PANEL-ASSY-SIDE-LOWER-LH_BOM.csv line 5): galvanized steel (it reads 'aluminium tube 6063-T6 20 x 40 x 1.2'), STILE - BACK (cut length) (210101_P01_WALL-PANEL-ASSY-SIDE-LOWER-LH_BOM.csv line 6): galvanized steel (it reads 'aluminium tube 6063-T6 40 x 40 x 1.2'), STILE - FRONT (cut length) (210101_P01_WALL-PANEL-ASSY-SIDE-LOWER-LH_BOM.csv line 7): galvanized steel (it reads 'aluminium tube 6063-T6 20 x 40 x 1.2'), STILE - MID (cut length) (210101_P01_WALL-PANEL-ASSY-SIDE-LOWER-LH_BOM.csv line 8): galvanized steel (it reads 'aluminium tube 6063-T6 20 x 40 x 1'). | WALL |
| F-313 | major | C11 | 211102 | 211102 WALL - PANEL FRAME - SIDE LOWER - RH: D-131 makes it welded galvanized steel (joints register J-FRAME-01: S280GD+Z or SGC400, Z100, 1.2/1.0/0.8 mm gauges, zinc-rich touch-up on the welds), but its row (210102_P01_WALL-PANEL-ASSY-SIDE-LOWER-RH_BOM.csv line 3) lacks galvanized steel (it reads 'aluminium tube 6063-T6: perimeter 20 x 40 and 40 x 40 x 1.2, studs 20 x 40 x 1 ('); its finish (210102_P01_WALL-PANEL-ASSY-SIDE-LOWER-RH_BOM.csv line 3) doesn't name the zinc ('mill finish with the bond prep (D-79)'); 5 member rows not in J-FRAME-01's steel: RAIL - BOTTOM (cut length) (210102_P01_WALL-PANEL-ASSY-SIDE-LOWER-RH_BOM.csv line 4): galvanized steel (it reads 'aluminium tube 6063-T6 20 x 40 x 1.2'), RAIL - TOP (cut length) (210102_P01_WALL-PANEL-ASSY-SIDE-LOWER-RH_BOM.csv line 5): galvanized steel (it reads 'aluminium tube 6063-T6 20 x 40 x 1.2'), STILE - BACK (cut length) (210102_P01_WALL-PANEL-ASSY-SIDE-LOWER-RH_BOM.csv line 6): galvanized steel (it reads 'aluminium tube 6063-T6 40 x 40 x 1.2'), STILE - FRONT (cut length) (210102_P01_WALL-PANEL-ASSY-SIDE-LOWER-RH_BOM.csv line 7): galvanized steel (it reads 'aluminium tube 6063-T6 20 x 40 x 1.2'), STILE - MID (cut length) (210102_P01_WALL-PANEL-ASSY-SIDE-LOWER-RH_BOM.csv line 8): galvanized steel (it reads 'aluminium tube 6063-T6 20 x 40 x 1'). | WALL |
| F-314 | major | C11 | 211103 | 211103 WALL - PANEL FRAME - SIDE UPPER - LH: D-131 makes it welded galvanized steel (joints register J-FRAME-01: S280GD+Z or SGC400, Z100, 1.2/1.0/0.8 mm gauges, zinc-rich touch-up on the welds), but its row (210103_P01_WALL-PANEL-ASSY-SIDE-UPPER-LH_BOM.csv line 3) lacks galvanized steel (it reads 'aluminium tube 6063-T6: perimeter 20 x 40 and 40 x 40 x 1.2, studs 20 x 40 x 1 ('); its finish (210103_P01_WALL-PANEL-ASSY-SIDE-UPPER-LH_BOM.csv line 3) doesn't name the zinc ('mill finish with the bond prep (D-79)'); 5 member rows not in J-FRAME-01's steel: RAIL - BOTTOM (cut length) (210103_P01_WALL-PANEL-ASSY-SIDE-UPPER-LH_BOM.csv line 4): galvanized steel (it reads 'aluminium tube 6063-T6 20 x 40 x 1.2'), RAIL - TOP (cut length) (210103_P01_WALL-PANEL-ASSY-SIDE-UPPER-LH_BOM.csv line 5): galvanized steel (it reads 'aluminium tube 6063-T6 40 x 40 x 1.2'), STILE - BACK (cut length) (210103_P01_WALL-PANEL-ASSY-SIDE-UPPER-LH_BOM.csv line 6): galvanized steel (it reads 'aluminium tube 6063-T6 40 x 40 x 1.2'), STILE - FRONT (cut length) (210103_P01_WALL-PANEL-ASSY-SIDE-UPPER-LH_BOM.csv line 7): galvanized steel (it reads 'aluminium tube 6063-T6 20 x 40 x 1.2'), STILE - MID (cut length) (210103_P01_WALL-PANEL-ASSY-SIDE-UPPER-LH_BOM.csv line 8): galvanized steel (it reads 'aluminium tube 6063-T6 20 x 40 x 1'). | WALL |
| F-315 | major | C11 | 211104 | 211104 WALL - PANEL FRAME - SIDE UPPER - RH: D-131 makes it welded galvanized steel (joints register J-FRAME-01: S280GD+Z or SGC400, Z100, 1.2/1.0/0.8 mm gauges, zinc-rich touch-up on the welds), but its row (210104_P01_WALL-PANEL-ASSY-SIDE-UPPER-RH_BOM.csv line 3) lacks galvanized steel (it reads 'aluminium tube 6063-T6: perimeter 20 x 40 and 40 x 40 x 1.2, studs 20 x 40 x 1 ('); its finish (210104_P01_WALL-PANEL-ASSY-SIDE-UPPER-RH_BOM.csv line 3) doesn't name the zinc ('mill finish with the bond prep (D-79)'); 5 member rows not in J-FRAME-01's steel: RAIL - BOTTOM (cut length) (210104_P01_WALL-PANEL-ASSY-SIDE-UPPER-RH_BOM.csv line 4): galvanized steel (it reads 'aluminium tube 6063-T6 20 x 40 x 1.2'), RAIL - TOP (cut length) (210104_P01_WALL-PANEL-ASSY-SIDE-UPPER-RH_BOM.csv line 5): galvanized steel (it reads 'aluminium tube 6063-T6 40 x 40 x 1.2'), STILE - BACK (cut length) (210104_P01_WALL-PANEL-ASSY-SIDE-UPPER-RH_BOM.csv line 6): galvanized steel (it reads 'aluminium tube 6063-T6 40 x 40 x 1.2'), STILE - FRONT (cut length) (210104_P01_WALL-PANEL-ASSY-SIDE-UPPER-RH_BOM.csv line 7): galvanized steel (it reads 'aluminium tube 6063-T6 20 x 40 x 1.2'), STILE - MID (cut length) (210104_P01_WALL-PANEL-ASSY-SIDE-UPPER-RH_BOM.csv line 8): galvanized steel (it reads 'aluminium tube 6063-T6 20 x 40 x 1'). | WALL |
| F-316 | major | C11 | 211201 | 211201 WALL - PANEL FRAME - BACK LOWER - B1: D-131 makes it welded galvanized steel (joints register J-FRAME-01: S280GD+Z or SGC400, Z100, 1.2/1.0/0.8 mm gauges, zinc-rich touch-up on the welds), but its row (210201_P01_WALL-PANEL-ASSY-BACK-LOWER-B1_BOM.csv line 3) lacks galvanized steel (it reads 'aluminium tube 6063-T6: perimeter 20 x 40 x 1.2, studs 20 x 40 x 1 (D-85) mill f'); its finish (210201_P01_WALL-PANEL-ASSY-BACK-LOWER-B1_BOM.csv line 3) doesn't name the zinc ('mill finish with the bond prep (D-79)'); 5 member rows not in J-FRAME-01's steel: RAIL - BOTTOM (cut length) (210201_P01_WALL-PANEL-ASSY-BACK-LOWER-B1_BOM.csv line 4): galvanized steel (it reads 'aluminium tube 6063-T6 20 x 40 x 1.2'), RAIL - TOP (cut length) (210201_P01_WALL-PANEL-ASSY-BACK-LOWER-B1_BOM.csv line 5): galvanized steel (it reads 'aluminium tube 6063-T6 20 x 40 x 1.2'), STILE - CENTRE (cut length) (210201_P01_WALL-PANEL-ASSY-BACK-LOWER-B1_BOM.csv line 6): galvanized steel (it reads 'aluminium tube 6063-T6 20 x 40 x 1.2'), STILE - MID (cut length) (210201_P01_WALL-PANEL-ASSY-BACK-LOWER-B1_BOM.csv line 7): galvanized steel (it reads 'aluminium tube 6063-T6 20 x 40 x 1'), STILE - OUTER (cut length) (210201_P01_WALL-PANEL-ASSY-BACK-LOWER-B1_BOM.csv line 8): galvanized steel (it reads 'aluminium tube 6063-T6 20 x 40 x 1.2'). | WALL |
| F-317 | major | C11 | 211202 | 211202 WALL - PANEL FRAME - BACK LOWER - B2: D-131 makes it welded galvanized steel (joints register J-FRAME-01: S280GD+Z or SGC400, Z100, 1.2/1.0/0.8 mm gauges, zinc-rich touch-up on the welds), but its row (210202_P01_WALL-PANEL-ASSY-BACK-LOWER-B2_BOM.csv line 3) lacks galvanized steel (it reads 'aluminium tube 6063-T6: perimeter 20 x 40 x 1.2, studs 20 x 40 x 1 (D-85) mill f'); its finish (210202_P01_WALL-PANEL-ASSY-BACK-LOWER-B2_BOM.csv line 3) doesn't name the zinc ('mill finish with the bond prep (D-79)'); 5 member rows not in J-FRAME-01's steel: RAIL - BOTTOM (cut length) (210202_P01_WALL-PANEL-ASSY-BACK-LOWER-B2_BOM.csv line 4): galvanized steel (it reads 'aluminium tube 6063-T6 20 x 40 x 1.2'), RAIL - TOP (cut length) (210202_P01_WALL-PANEL-ASSY-BACK-LOWER-B2_BOM.csv line 5): galvanized steel (it reads 'aluminium tube 6063-T6 20 x 40 x 1.2'), STILE - CENTRE (cut length) (210202_P01_WALL-PANEL-ASSY-BACK-LOWER-B2_BOM.csv line 6): galvanized steel (it reads 'aluminium tube 6063-T6 20 x 40 x 1.2'), STILE - MID (cut length) (210202_P01_WALL-PANEL-ASSY-BACK-LOWER-B2_BOM.csv line 7): galvanized steel (it reads 'aluminium tube 6063-T6 20 x 40 x 1'), STILE - OUTER (cut length) (210202_P01_WALL-PANEL-ASSY-BACK-LOWER-B2_BOM.csv line 8): galvanized steel (it reads 'aluminium tube 6063-T6 20 x 40 x 1.2'). | WALL |
| F-318 | major | C11 | 411101 | 411101 CEILING - PANEL FRAME - C1: D-131 makes it welded galvanized steel (joints register J-FRAME-01: S280GD+Z or SGC400, Z100, 1.2/1.0/0.8 mm gauges, zinc-rich touch-up on the welds), but its row (410000_P01_CEILING-PARTS-LIST_BOM.csv line 5) lacks galvanized steel (it reads 'Aluminium 6063-T6, mill finish (D-79) mill finish with the bond prep (D-79)'); its finish (410000_P01_CEILING-PARTS-LIST_BOM.csv line 5) doesn't name the zinc ('mill finish with the bond prep (D-79)'); 7 member rows not in J-FRAME-01's steel: SIDE MEMBER SIDE (410000_P01_CEILING-TUBE-CUT-LIST_BOM.csv line 2): galvanized steel (it reads 'aluminium 20 x 40 x 1.2 (6063-T6; alloy ISS-034)'), SEAM MEMBER SEAM (410000_P01_CEILING-TUBE-CUT-LIST_BOM.csv line 3): galvanized steel (it reads 'aluminium 20 x 40 x 1.2 (6063-T6; alloy ISS-034)'), FRONT MEMBER FRONT (410000_P01_CEILING-TUBE-CUT-LIST_BOM.csv line 4): galvanized steel (it reads 'aluminium 20 x 40 x 1.2 (6063-T6; alloy ISS-034)'), BACK MEMBER 40X40 BACK (410000_P01_CEILING-TUBE-CUT-LIST_BOM.csv line 5): galvanized steel (it reads 'aluminium 40 x 40 x 1.2 (6063-T6; alloy ISS-034)'), CROSS MEMBER 1 X1 (410000_P01_CEILING-TUBE-CUT-LIST_BOM.csv line 6): galvanized steel (it reads 'aluminium 20 x 40 x 1.2 (6063-T6; alloy ISS-034)'), CROSS MEMBER 2 X2 (410000_P01_CEILING-TUBE-CUT-LIST_BOM.csv line 7): galvanized steel (it reads 'aluminium 20 x 40 x 1.2 (6063-T6; alloy ISS-034)'). | CEILING |
| F-319 | major | C11 | 411102 | 411102 CEILING - PANEL FRAME - C2: D-131 makes it welded galvanized steel (joints register J-FRAME-01: S280GD+Z or SGC400, Z100, 1.2/1.0/0.8 mm gauges, zinc-rich touch-up on the welds), but its row (410000_P01_CEILING-PARTS-LIST_BOM.csv line 6) lacks galvanized steel (it reads 'Aluminium 6063-T6, mill finish (D-79) mill finish with the bond prep (D-79)'); its finish (410000_P01_CEILING-PARTS-LIST_BOM.csv line 6) doesn't name the zinc ('mill finish with the bond prep (D-79)'); 7 member rows not in J-FRAME-01's steel: SIDE MEMBER SIDE (410000_P01_CEILING-TUBE-CUT-LIST_BOM.csv line 9): galvanized steel (it reads 'aluminium 20 x 40 x 1.2 (6063-T6; alloy ISS-034)'), SEAM MEMBER SEAM (410000_P01_CEILING-TUBE-CUT-LIST_BOM.csv line 10): galvanized steel (it reads 'aluminium 20 x 40 x 1.2 (6063-T6; alloy ISS-034)'), FRONT MEMBER FRONT (410000_P01_CEILING-TUBE-CUT-LIST_BOM.csv line 11): galvanized steel (it reads 'aluminium 20 x 40 x 1.2 (6063-T6; alloy ISS-034)'), BACK MEMBER 40X40 BACK (410000_P01_CEILING-TUBE-CUT-LIST_BOM.csv line 12): galvanized steel (it reads 'aluminium 40 x 40 x 1.2 (6063-T6; alloy ISS-034)'), CROSS MEMBER 1 X1 (410000_P01_CEILING-TUBE-CUT-LIST_BOM.csv line 13): galvanized steel (it reads 'aluminium 20 x 40 x 1.2 (6063-T6; alloy ISS-034)'), CROSS MEMBER 2 X2 (410000_P01_CEILING-TUBE-CUT-LIST_BOM.csv line 14): galvanized steel (it reads 'aluminium 20 x 40 x 1.2 (6063-T6; alloy ISS-034)'). | CEILING |
| F-320 | major | C11 | 351104 | 351104 FRONT - DECOR FRAME - DL: D-131 makes it welded galvanized steel box tube with the decor tubes as they are (FRONT's decor core DL; the gauges come from the Joints Engineer's check, which doesn't cover the decor cores yet), but its row (350001_P01_FRONT-DECOR-BLOCK-ASSY-DL_BOM.csv line 4) lacks galvanized steel (it reads 'aluminium EN AW-6063-T6 tube 20 x 20 x 1.5 and 60 x 20 x 1.5 mill finish (hidden'); 26 member rows not galvanized steel: BACK RING BOTTOM B01 (351104_P01_FRONT-DECOR-FRAME-DL-TUBE-CUT-LIST.csv line 2), BACK RING DOOR SIDE B02 (351104_P01_FRONT-DECOR-FRAME-DL-TUBE-CUT-LIST.csv line 3), BACK RING SLOPE UNDER DT B03 (351104_P01_FRONT-DECOR-FRAME-DL-TUBE-CUT-LIST.csv line 4), BACK RING BOLT LINE B04 (351104_P01_FRONT-DECOR-FRAME-DL-TUBE-CUT-LIST.csv line 5), RING BOTTOM - DOOR SIDE R1D (351104_P01_FRONT-DECOR-FRAME-DL-TUBE-CUT-LIST.csv line 6), RING BOTTOM - BACK R1K (351104_P01_FRONT-DECOR-FRAME-DL-TUBE-CUT-LIST.csv line 7). | FRONT |
| F-321 | major | C11 | 351204 | 351204 FRONT - DECOR FRAME - DT: D-131 makes it welded galvanized steel box tube with the decor tubes as they are (FRONT's decor core DT; the gauges come from the Joints Engineer's check, which doesn't cover the decor cores yet), but its row (350002_P01_FRONT-DECOR-BLOCK-ASSY-DT_BOM.csv line 4) lacks galvanized steel (it reads 'aluminium EN AW-6063-T6 tube 20 x 20 x 1.5 and 40 x 20 x 1.5 (the back ring's to'); 13 member rows not galvanized steel: BACK RING BOTTOM B01 (351204_P01_FRONT-DECOR-FRAME-DT-TUBE-CUT-LIST.csv line 2), BACK RING DR JOINT B02 (351204_P01_FRONT-DECOR-FRAME-DT-TUBE-CUT-LIST.csv line 3), BACK RING TOP B03 (351204_P01_FRONT-DECOR-FRAME-DT-TUBE-CUT-LIST.csv line 4), BACK RING SLOPE OVER DL B04 (351204_P01_FRONT-DECOR-FRAME-DT-TUBE-CUT-LIST.csv line 5), BACK RING POST B05 (351204_P01_FRONT-DECOR-FRAME-DT-TUBE-CUT-LIST.csv line 6), FRONT FACET TUBE F01 (351204_P01_FRONT-DECOR-FRAME-DT-TUBE-CUT-LIST.csv line 7). | FRONT |
| F-322 | major | C11 | 351306 | 351306 FRONT - DECOR FRAME - DR: D-131 makes it welded galvanized steel box tube with the decor tubes as they are (FRONT's decor core DR; the gauges come from the Joints Engineer's check, which doesn't cover the decor cores yet), but its row (350003_P01_FRONT-DECOR-BLOCK-ASSY-DR_BOM.csv line 4) lacks galvanized steel (it reads 'aluminium EN AW-6063-T6 tube: 20 x 20 x 1.0 (skin only), 40, 60 and 80 x 20 x 1.'); 24 member rows not galvanized steel: FRONT RING BOTTOM F01 (351306_P01_FRONT-DECOR-FRAME-DR-TUBE-CUT-LIST.csv line 2), FRONT RING FACET SIDE F02 (351306_P01_FRONT-DECOR-FRAME-DR-TUBE-CUT-LIST.csv line 3), FRONT RING TOP F03 (351306_P01_FRONT-DECOR-FRAME-DR-TUBE-CUT-LIST.csv line 4), FRONT RING DT JOINT F04 (351306_P01_FRONT-DECOR-FRAME-DR-TUBE-CUT-LIST.csv line 5), FRONT RING DIAGONAL F05 (351306_P01_FRONT-DECOR-FRAME-DR-TUBE-CUT-LIST.csv line 6), FRONT RING GLASS EDGE F06 (351306_P01_FRONT-DECOR-FRAME-DR-TUBE-CUT-LIST.csv line 7). | FRONT |
| F-228 | major | C11 | 611106 | 611106 AIR - COLUMN FOOT PLATE in v2/03-Manufacturing/air/610000_P01_AIR-PARTS-LIST_BOM.csv has no material grade (a named grade or alloy and temper, not just a family). Material given: 'Aluminium (alloy HOLD)'. | CEILING |
| F-229 | major | C11 | 611103 | 611103 AIR - COLUMN CORNER ANGLE in v2/03-Manufacturing/air/610000_P01_AIR-PARTS-LIST_BOM.csv has no material grade (a named grade or alloy and temper, not just a family). Material given: 'Aluminium (alloy HOLD)'. | CEILING |
| F-230 | major | C11 | 611107 | 611107 AIR - COLUMN PLENUM SIDE PLATE - LOW in v2/03-Manufacturing/air/610000_P01_AIR-PARTS-LIST_BOM.csv has no material grade (a named grade or alloy and temper, not just a family). Material given: 'Aluminium (alloy HOLD)'. | CEILING |
| F-231 | major | C11 | 611108 | 611108 AIR - COLUMN PLENUM SIDE PLATE - HIGH in v2/03-Manufacturing/air/610000_P01_AIR-PARTS-LIST_BOM.csv has no material grade (a named grade or alloy and temper, not just a family). Material given: 'Aluminium (alloy HOLD)'. | CEILING |
| F-232 | major | C11 | 611301 | 611301 AIR - CARTRIDGE CASING in v2/03-Manufacturing/air/610000_P01_AIR-PARTS-LIST_BOM.csv has no material grade (a named grade or alloy and temper, not just a family). Material given: 'Aluminium (alloy HOLD)'. | CEILING |
| F-233 | major | C11 | 611302 | 611302 AIR - CARTRIDGE LAYER 50 in v2/03-Manufacturing/air/610000_P01_AIR-PARTS-LIST_BOM.csv has no finish. Material given: 'Pyrotek Sorberpoly 2D 40 kg/m3'. | CEILING |
| F-234 | major | C11 | 611201 | 611201 AIR - SOFFIT UNDERSIDE - LEFT HINGED in v2/03-Manufacturing/air/610000_P01_AIR-PARTS-LIST_BOM.csv has no finish. Material given: 'ACP 3 + felt 9 face (5.3 kg/m2)'. | CEILING |
| F-235 | major | C11 | 611207 | 611207 AIR - SOFFIT UNDERSIDE - RIGHT HINGED in v2/03-Manufacturing/air/610000_P01_AIR-PARTS-LIST_BOM.csv has no finish. Material given: 'ACP 3 + felt 9 face (5.3 kg/m2)'. | CEILING |
| F-236 | major | C11 | 611208 | 611208 AIR - SOFFIT UNDERSIDE - FIXED OVER THE COLUMN in v2/03-Manufacturing/air/610000_P01_AIR-PARTS-LIST_BOM.csv has no finish. Material given: 'ACP 3 + felt 9 face (5.3 kg/m2)'. | CEILING |
| F-237 | major | C11 | 611205 | 611205 AIR - SOFFIT TOP RAIL - DOOR SIDE in v2/03-Manufacturing/air/610000_P01_AIR-PARTS-LIST_BOM.csv has no material grade (a named grade or alloy and temper, not just a family). Material given: 'Aluminium (alloy HOLD)'. | CEILING |
| F-238 | major | C11 | 611209 | 611209 AIR - SOFFIT TOP RAIL - ROOM SIDE in v2/03-Manufacturing/air/610000_P01_AIR-PARTS-LIST_BOM.csv has no material grade (a named grade or alloy and temper, not just a family). Material given: 'Aluminium (alloy HOLD)'. | CEILING |
| F-239 | major | C11 | 611206 | 611206 AIR - SOFFIT END PLATE - LEFT in v2/03-Manufacturing/air/610000_P01_AIR-PARTS-LIST_BOM.csv has no material grade (a named grade or alloy and temper, not just a family). Material given: 'Aluminium (alloy HOLD)'. | CEILING |
| F-240 | major | C11 | 611210 | 611210 AIR - SOFFIT DOOR-SIDE PLATE in v2/03-Manufacturing/air/610000_P01_AIR-PARTS-LIST_BOM.csv has no material grade (a named grade or alloy and temper, not just a family). Material given: 'Aluminium (alloy HOLD)'. | CEILING |
| F-241 | major | C11 | 611401 | 611401 AIR - FAN BOX CASING - EXHAUST in v2/03-Manufacturing/air/610000_P01_AIR-PARTS-LIST_BOM.csv has no material grade (a named grade or alloy and temper, not just a family). Material given: 'Aluminium (alloy HOLD)'. | CEILING |
| F-242 | major | C11 | 611402 | 611402 AIR - FAN BOX CASING - SUPPLY in v2/03-Manufacturing/air/610000_P01_AIR-PARTS-LIST_BOM.csv has no material grade (a named grade or alloy and temper, not just a family). Material given: 'Aluminium (alloy HOLD)'. | CEILING |
| F-226 | minor | C05 | 831001 | 831001 HARDWARE - LOCATING SPIGOT - M6 X Ø8 - STAINLESS drawing 831001_P01_HARDWARE-LOCATING-SPIGOT_DWG.pdf: Dimension value(s) printed more than once: 8. | Joints Engineer |
| F-243 | minor | C06 | 618101 | 618101 AIR - SENSOR HUB ZONE - HOLD in v2/03-Manufacturing/air/610000_P01_AIR-PARTS-LIST_BOM.csv is missing: mass. | CEILING |

## Tolerance stacks (C02)

| Stack | Joint | What | Needs | Nominal | Worst case | RSS (info) | State | Missing |
|---|---|---|---|---|---|---|---|---|
| ST-01 | IF-02 door to threshold | Running gap between the door's kick strip and the threshold | 3.0 to 10.0 | 7.00 | 7.00 to 7.00 | 7.00 to 7.00 | OPEN | Door bottom height (glass bottom); Kick strip height below the glass; Threshold height; Floor height under the threshold |
| ST-03 | IF-01 IF-03 IF-04 IF-05 M6 bolt into a rivnut through a clearance hole | Radial clearance left for an M6 bolt after both hole positions and the rivnut's float (fixed-fastener case; the panel shifts to the bolts within the spigot play) | >= 0.0 | 0.51 | 0.05 to 0.51 | 0.14 to 0.43 | PASS |  |
| ST-02 | IF-03 and IF-04 back wall across its width | Closing seam B1-B2 frame gap: the span less the two corner stops and the B1, B2 frames | 4.0 to 7.0 | 5.50 | 5.24 to 5.76 | 5.32 to 5.68 | OPEN | Space between the side frames; Back panel B1 frame width; Back panel B2 frame width |
| ST-02A | IF-03 and IF-04 back wall across its width: perfect frames | As ST-02 with the frames and the span taken as perfect, so only the two corner stops vary | 4.0 to 7.0 | 5.50 | 5.24 to 5.76 | 5.32 to 5.68 | PASS |  |
| ST-04 | IF-05 and IF-06 ceiling across its width | Closing seam C1-C2 frame gap: the span less the two side stops and the C1, C2 frames | 4.0 to 7.0 | 5.50 | 5.24 to 5.76 | 5.32 to 5.68 | OPEN | Space between the upper side panels' top members; Ceiling half C1 frame width; Ceiling half C2 frame width |
| ST-04A | IF-05 and IF-06 ceiling across its width: perfect frames | As ST-04 with the frames and the span taken as perfect, so only the two side stops vary | 4.0 to 7.0 | 5.50 | 5.24 to 5.76 | 5.32 to 5.68 | PASS |  |

## Shipping pieces (C04), from `v2/07-Packaging/910000_P01_PACKING-LIST_BOM.csv`

| Piece | kg | Size mm | Ships as | Status |
|---|---|---|---|---|
| 1-01 WALL - PANEL ASSY - BACK LOWER - B1 | 8.641 | 1200.61 x 1127 x 46 | upright | calculation (part CAD); fill provisional |
| 1-02 WALL - PANEL ASSY - BACK LOWER - B2 | 11.514 | 1200.61 x 1127 x 88 | upright | calculation (CAD); calculation (part CAD); fill provisional |
| 1-03 WALL - PANEL ASSY - SIDE LOWER - LH | 11.163 | 1492.74 x 1151 x 48.5 | upright | calculation (CAD); fill provisional |
| 1-04 WALL - PANEL ASSY - SIDE LOWER - RH | 11.163 | 1492.74 x 1151 x 48.5 | upright | calculation (CAD); fill provisional |
| 1-05 WALL - PANEL ASSY - BACK UPPER - B3 | 8.641 | 1200.61 x 1118.61 x 46 | upright | calculation (part CAD); fill provisional |
| 1-06 WALL - PANEL ASSY - BACK UPPER - B4 | 8.641 | 1200.61 x 1118.61 x 46 | upright | calculation (part CAD); fill provisional |
| 1-07 WALL - PANEL ASSY - SIDE UPPER - LH | 11.294 | 1492.74 x 1142.74 x 48.5 | upright | calculation (CAD); fill provisional |
| 1-08 WALL - PANEL ASSY - SIDE UPPER - RH | 11.294 | 1492.74 x 1142.74 x 48.5 | upright | calculation (CAD); fill provisional |
| 1-09 CEILING - PANEL ASSY - C1 | 10.047 | 1495 x 1200.61 x 46 | upright | calculation (CAD) |
| 1-10 CEILING - PANEL ASSY - C2 | 10.922 | 1495 x 1200.61 x 70 | upright | calculation (CAD) |
| 1-11 LINING - CASSETTE - SIDE LOWER - RH | 10.341 | 1445 x 1142.74 x 38 | upright | calculation (CAD) |
| 1-12 LINING - CASSETTE - SIDE UPPER - RH | 9.912 | 1445 x 1092.74 x 38 | upright | calculation (CAD) |
| 1-13 LINING - CASSETTE - SIDE LOWER - LH | 10.341 | 1445 x 1142.74 x 38 | upright | calculation (CAD) |
| 1-14 LINING - CASSETTE - SIDE UPPER - LH | 9.912 | 1445 x 1092.74 x 38 | upright | calculation (CAD) |
| 1-15 LINING - CASSETTE - BACK LOWER - B1 | 8.013 | 1166 x 1118.61 x 38 | upright | calculation (CAD) |
| 1-16 LINING - CASSETTE - BACK LOWER - B2 | 8.013 | 1166 x 1118.61 x 38 | upright | calculation (CAD) |
| 1-17 LINING - CASSETTE - BACK UPPER - B3 | 8.399 | 1166 x 1116.87 x 38 | upright | calculation; lips confirmed |
| 1-18 LINING - CASSETTE - BACK UPPER - B4 | 8.399 | 1166 x 1116.87 x 38 | upright | calculation; lips confirmed |
| 2-01 FRONT - FIXED GLASS UNIT | 28.743 | 2034 x 1031 x 12 | glass | calculation (CAD); magnetic seal HOLD |
| 2-02 FRONT - DOOR UNIT | 48.59 | 2096 x 1177 x 149 | glass | calculation (CAD); hinges and pull HOLD |
| 2-03 FRONT - DECOR BLOCK ASSY - DR | 18.864 | 2290 x 1020 x 216 | long | calculation (CAD); calculation (CAD); magnetic seal HOLD |
| 2-04 BASE - BAND ASSY - BACK | 3.438 | 2420 x 118 x 50 | long | assumption (CAD, HOLD); calculation (CAD); calculation (CAD); confirmed (1.5 mm); calculation (CAD); kg/m source |
| 2-05 BASE - BAND ASSY - SIDE - LH | 2.582 | 1530 x 118 x 50 | long | assumption (CAD, HOLD); calculation (CAD); calculation (CAD); confirmed (1.5 mm); calculation (CAD); kg/m source |
| 2-06 BASE - BAND ASSY - SIDE - RH | 2.585 | 1530 x 118 x 50 | long | assumption (CAD, HOLD); calculation (CAD); calculation (CAD); confirmed (1.5 mm); calculation (CAD); kg/m source |
| 2-07 BASE - BAND ASSY - FRONT - FIXED GLASS | 2.496 | 747 x 161 x 110 | long | assumption (CAD, HOLD); calculation (CAD); calculation (CAD); confirmed (1.5 mm); calculation (CAD); kg/m source; calculation (CAD); magnetic seal HOLD |
| 2-08 FRONT - DECOR BLOCK ASSY - DL | 12.3 | 2292 x 308 x 199 | long | calculation (CAD) |
| 2-09 AIR - SOFFIT | 14.756 | 2322 x 359 x 233 | long | assumption; calculation (CAD at 2 mm, scaled to D-124's 3 mm); calculation (CAD); hinges, latches and studs HOLD; fill provisional |
| 2-10 AIR - AIR COLUMN | 8.147 | 2108 x 359 x 212 | long | calculation (CAD); fill provisional |
| 2-11 FRONT - DECOR BLOCK ASSY - DT | 7.913 | 1699 x 306 x 203 | long | calculation (CAD); calculation (CAD); magnetic seal HOLD |
| 2-12 ELECTRICAL - KIT - HARNESS, CORD SET, HUB ZONE, LIGHTS | 2.41 | 600 x 250 x 200 | long | calculation (CAD) |
| 2-13 INTERIOR - LIGHT SHELF ASSY | 1.585 | 2332 x 80 x 60 | long | calculation (CAD) |
| 2-14 BASE - SMALL PARTS CARTON | 1.139 | 600 x 400 x 150 | long | calculation (CAD); calculation; confirmed (1.5 mm) |
| 2-15 INTERIOR - WORK WALL LEDGE ASSY | 1.903 | 1000 x 250 x 120 | long | calculation (CAD); brackets and screen rail HOLD |
| 2-16 AIR - SUPPLY FAN BOX | 13.45 | 2005 x 516 x 203 | long | assumption; calculation (CAD at 2 mm, scaled to D-124's 3 mm); transitions HOLD at their sized masses; calculation (CAD); foot, mesh and boot assumption |
| 2-17 AIR - SPLITTER CARTRIDGE - COMMON | 10.55 | 1750 x 314 x 173 | long | calculation (CAD) |
| 2-18 AIR - SPLITTER CARTRIDGE - COMMON | 10.55 | 1750 x 314 x 173 | long | calculation (CAD) |
| 2-19 LINING - CASSETTE - CEILING - COMMON | 9.455 | 1163 x 1048 x 74 | long | calculation (CAD); fill provisional |
| 2-20 LINING - CASSETTE - CEILING - COMMON | 9.455 | 1163 x 1048 x 74 | long | calculation (CAD); fill provisional |
| 2-21 POD - INSTALLATION KIT (OPEN FIRST) | 3.55 | 900 x 150 x 80 | long | assumption |

## Floor seal line (C01)

Horizontal cuts from the room floor to Z 110 (the skeleton's glide_h + band_h): 91 cuts, 0 sealed all round. Openings wider than 1 mm: 12, **47029 mm² open in all** (calculation: each gap's width times its height, summed over the cuts). Taken down to the floor: \bDROP SEAL\b, 20 mm (hardware selection C4: athmer Schall-Ex GSA 1-1112, travel 20 mm (athmer's data sheet, cited there)).

| Register | Between | At X, Y | Z | Width mm | Open mm² | Owner |
|---|---|---|---|---|---|---|
| F-355 | 111101 BASE - BAND TUBE - SIDE - LH / 361002 FRONT - DOOR KICK STRIP | -1085.5, -670.5 | 0.0 to 110.0 | 238.72 to 251.72 | 27393 | BASE; FRONT |
| F-364 | 111301 BASE - SILL - FIXED GLASS / 611105 AIR - KICK GRILLE | 950.8, -645.2 | 24.0 to 105.0 | 90.50 to 92.50 | 7350 | BASE; CEILING |
| F-358 | 111102 BASE - BAND TUBE - SIDE - RH / 611107 AIR - COLUMN PLENUM SIDE PLATE - LOW | 1185.5, -643.4 | 12.0 to 110.0 | 39.00 to 49.00 | 4672 | BASE; CEILING |
| F-354 | 118001 BASE - BASE SEAL - LIP - ROOM FLOOR - HOLD (2) / 118001 BASE - BASE SEAL - LIP - ROOM FLOOR - HOLD (3) | 1057.5, -727.1 | 0.0 to 10.0 | 320.14 to 320.14 | 3201 | BASE |
| F-360 | 611103 AIR - COLUMN CORNER ANGLE / 611107 AIR - COLUMN PLENUM SIDE PLATE - LOW | 1070.5, -643.4 | 14.0 to 24.0 | 179.00 to 179.00 | 1790 | CEILING |
| F-363 | 611103 AIR - COLUMN CORNER ANGLE / 611105 AIR - KICK GRILLE | 1160.8, -292.0 | 24.0 to 110.0 | 10.00 to 10.00 | 860 | CEILING |
| F-359 | 111301 BASE - SILL - FIXED GLASS / 611103 AIR - COLUMN CORNER ANGLE | 964.8, -666.5 | 12.0 to 24.0 | 46.00 to 46.00 | 552 | BASE; CEILING |
| F-356 | 111301 BASE - SILL - FIXED GLASS / 361002 FRONT - DOOR KICK STRIP | 216.2, -704.4 | 0.0 to 110.0 | 2.02 to 4.46 | 478 | BASE; FRONT |
| F-357 | 118001 BASE - BASE SEAL - LIP - ROOM FLOOR - HOLD (2) / 111301 BASE - SILL - FIXED GLASS | 1082.5, -671.8 | 10.0 to 12.0 | 237.64 to 237.64 | 475 | BASE |
| F-365 | 611105 AIR - KICK GRILLE / 611501 AIR - INTAKE RISER | 953.0, -623.5 | 105.0 to 110.0 | 49.16 to 49.16 | 246 | CEILING |
| F-361 | 361002 FRONT - DOOR KICK STRIP / 361002 FRONT - DOOR KICK STRIP | 213.7, -707.0 | 21.0 to 25.0 | 2.00 to 2.00 | 8 | FRONT |
| F-362 | 361002 FRONT - DOOR KICK STRIP / 361002 FRONT - DOOR KICK STRIP | 213.7, -707.0 | 102.1 to 104.0 | 2.00 to 2.00 | 4 | FRONT |

## Fastener schedule (C07)

148 fastener lines; full table in `v2/04-Checks/fastener-schedule.csv`.
