autonomous-ai/spaceship/v2/06-Samples/wall-door-sample/test-plan.md

# Test plan: what gets measured, by whom, and what passes

| Doc code | Revision | Status | Date |
|---|---|---|---|
| V2-SMP-WD (proposed) | P01 | DRAFT | 2026-10-31 |

Every test stays PLANNED until it has real data (guideline §10). A test on HOLD waits for the item in [hold-list.md](hold-list.md). Items S1 to S7 and rigs R1 to R4 are in [build-list.md](build-list.md).

Each pass or fail limit comes from a requirement or a decision. Where the plan had to choose a number with no source (a sample size, a hold time, a margin), the number is marked assumption, so the PM can change it before testing.

**PM ruling, 2026-10-31 (DECIDED):** the assumed limits are confirmed as written: the 0.5 dB switch rule (T02), torque at most half the lowest spin-out torque (T06), 2000 mm head clearance after a drop (T08), cohesive failure (the bond breaks inside the adhesive, not at a surface) as the bond pass (T09), and the sample sizes and hold times. T01 and T02 on the 1.71 m² panel are screening tests that compare fill and felt; bands at or below the lab's flanking limit are indicative only. The decision-grade sound result is the whole prototype pod tested to ISO 23351-1. T04, T05 and T12 follow D-60's air layout, the air column and the soffit inside the pod, built to the Air Engineer's sizes (HW-AA section 7e, PR #26).

## The tests

| ID | Test | On | Method | Who measures | Pass or fail limit | Ties to | Status |
|---|---|---|---|---|---|---|---|
| T01 | Wall sound transmission from 100 Hz · cách âm vách | S1 with S2 | Lab airborne sound insulation to ISO 10140-2: R in 1/3 octaves from 100 Hz (lower if the lab can), R_w to ISO 717-1. The panel, 1.71 m², is smaller than a standard wall opening, so the lab mounts it in a reduced opening in a high-insulation filler wall, or uses sound intensity (ISO 15186-1). It states the opening and its flanking limit in each band. | An acoustic lab accredited (ISO/IEC 17025) for the method. The factory delivers S1 and S2 and mounts them to the lab's instructions. The Hardware Engineer reruns the sound model. | **Pass:** the pod's D_S,A, rerun with the measured R in place of the model's wall R (16, 20, 32, 49, 65 and 64 dB at 125 to 4000 Hz, calculation), is at least 19.3 dB, the decided build's calculated value (D-53). The result is also stated against REQ-SND-01's 24 dB (Class C). Bands at the lab's flanking limit are reported as "at least". | REQ-SND-01, REQ-BLD-01, REQ-BLD-07; D-48, D-53 | PLANNED |
| T02 | The lighter fill next to the 32 kg/m³ · so sánh bông PET hai loại | S1 with S2; P03L | As T01, run twice on the same day in the same mounting. Run A has the 32 kg/m³ fill. For run B, take the cassette off and swap in the 24 kg/m³ grade from the inside (the fill sits in the outer frame's bays). Nothing else moves. | The T01 lab; the Hardware Engineer reruns the model | **Switch** to the lighter fill, saving about 4.9 kg (calculation for the 24 kg/m³ grade; D-54's 4.3 kg was for 25 kg/m³), if run B's D_S,A is no more than 0.5 dB below run A's. Otherwise the 32 kg/m³ stays. The 0.5 dB comes from the rule D-35 set for the tray, confirmed by the PM ruling above. | D-54; REQ-SND-03, REQ-LGT-01; ISS-080 | PLANNED |
| T03 | Felt absorption on its 25 mm gap · hệ số hút âm tấm tiêu âm | S6 | ISO 354 reverberation room, with the felt over a 25 mm air space as on the cassette face (the lab's closest standard mounting). α_s in 1/3 octaves from 100 Hz; α_p to ISO 11654. | An acoustic lab accredited for ISO 354; the Hardware Engineer reruns the model | **Pass:** the pod's D_S,A, rerun with the measured α_p, is at least 19.3 dB (D-53). For reference, the model uses Polyx Board 9 glued flat: 0.01, 0.06, 0.17, 0.42, 0.67 and 0.94 at 125 to 4000 Hz (calculation). Autex Cube 12 mm on a 25 mm gap, 0.05, 0.30, 0.60, 0.95, 0.95 and 0.85 (source), gives the best case of about 24 dB. **Fail:** buy a felt with published data from 100 Hz, such as Autex Cube (D-31). | REQ-BLD-07; D-31, D-48, D-53; ISS-075 | PLANNED |
| T04 | 12 V fan flow and octave noise in their cartridges · lưu lượng và tiếng ồn quạt | S5 in R3 | Flow against pressure to ISO 5801, or with a calibrated flow hood on each grille, at 26, 53 and 65 to 70 l/s. Octave sound power from 100 Hz on the pod side of R3: the column's and soffit's faces, the kick grille, the exhaust grille and breakout together, to ISO 3741 or ISO 3744. 1/3 octaves at 125 to 250 Hz to find tones. Fan speed and 12 V power at each point. | An air and acoustic test lab. The factory runs the fans on P22. The Hardware Engineer reruns the noise model. | **Pass:** (a) each path moves 53 l/s against its own pressure (calculation: about 18 Pa supply with the intake mesh and riser, 12 Pa exhaust; HW-AA section 7d), and the boost reaches at least 65 l/s. (b) The inside level, rerun with the measured spectra, tones included, is at most 26 dB(A) at 53 l/s and at most 30 dB(A) at boost (D-52; 25.3 and 29.7 dB(A) calculated for D-60). The 12 V power at 53 and 65 l/s is recorded for the supply sizing (REQ-ELE-03), not judged. | REQ-AIR-02, REQ-AIR-05 as D-52 sets it; D-51, D-52, D-60; ISS-077 | PLANNED |
| T05 | Recirculation at boost · khí thải quay lại cửa hút | S5 in R3, with R4 | Run both paths at boost. Set R4's heater so the exhaust leaves at room + 4 K, D-50's limit (about 314 W at 65 l/s, calculation). After 30 min at steady state (assumption), log the intake air, in the low intake's airstream, and the room, from a shielded sensor 2 m from the box at the intake's height (assumption). Log every 10 s for 10 min (assumption). Two placements: in the open room, and with the box's outer face 300 mm from a wall (assumption: a tight office corner). | Factory QC, with two calibrated sensors good to ±0.1 K or better (assumption), compared side by side in the same air before the run | **Pass:** in both placements the intake air stays within 0.5 K of the room (D-58). | D-58, D-50; REQ-AIR-01, REQ-AIR-02 | PLANNED |
| T06 | Rivnut spin-out torque in the real 1.0 mm galvanized tube · mô-men xoay tán rút | S7 rivnut coupons | Set each rivnut with the maker's tool, through a 1.5 mm stop washer (P07), in a 9.53 (+0.10) hole in a 40 mm face of the frames' own 20 × 40 × 1.0 galvanized steel tube (P02A; same lot, grade and zinc), as in the joint (joints register 2.2). Raise the torque slowly on an M6 × 16 ISO 4762 8.8 bolt (P06) with its ISO 7093 6.4 × 18 A2 washer (P25), clamping a 1.0 mm galvanized wall coupon with a 7.0 mm hole (a square cut from the same tube's 40 mm face), dry as assembled, until the nut turns, and record the peak: 10 coupons (assumption). Cut 2 open and check that the bulge and body clear the far wall, 18.0 mm inside (calculation: 20 − 2 × 1.0). Then run 5 tighten-and-loosen cycles at the proposed torque on 5 fresh coupons, checking the wall coupon under the head washer with a straightedge after each. Then 5 coupons in DR's 0.8 mm galvanized panel-screw tube (P02F; the PM's ruling in the joints register): the rivnut in a 20 mm face with no stop washer, a washer (P25) on its head as DR's panel stop, clamping a 3 mm aluminium coupon with a 7.0 hole (DR's panel stays aluminium, D-131); raise the torque to spin-out and record the peak (FRONT's DR panels; joints register H-34). D-131: the stack as the joints register's T06 row gives it (J-FRAME-01). | Factory QC, with a calibrated torque tool (record its serial and calibration date) | **Sets the torque** (D-48). Proposed tightening torque: at most half the lowest spin-out torque (confirmed by the PM ruling above). **Pass:** at that torque, no rivnut turns, loosens or strips in 5 cycles (REQ-ASM-09), the bulge clears the far wall, and the 1.0 mm wall under the head washer doesn't dish: a 0.1 mm feeler doesn't go under a straightedge laid across it (assumption; PM ruling on the head washer, joints register R-J10). DR's panel screws get the same rule from their own 5 coupons. | D-48, D-130, D-131; REQ-BLD-01, REQ-ASM-02, REQ-ASM-09; ISS-011; joints register J-BASE-01, J-FRAME-01 | PLANNED |
| T07 | Cassette clip pull-out · lực giữ kẹp treo cassette | S7 clip coupons, then S2 and S3 on R2 | Load each clip the way it works: wall clips in shear, as the cassette hangs, and ceiling clips in pull-out, straight down. Raise the load steadily to the limit, hold it for 1 min (assumption), then go on to failure; 5 of each (assumption). Then hold the limit load on the real S2 and S3 on R2. D-131: the clip mates sit on the 0.8 mm stud tube (P02S), the thinnest member a clip fixes to, and R2's members are the ceiling's galvanized tube: the perimeter and cross member 1 at 1.0 mm, 2 and 3 at 0.8 (joints register J-FRAME-01). | Factory QC, with a calibrated force gauge or test machine | **Pass** (D-47; safety factor 3 is an assumption, ISS-076): every wall clip holds at least 8.3 kg, 81.5 N, in shear (3 × 11.1 kg / 4; the layout study's cassette is heavier than ISS-076's 10.3 kg, so the larger is used). Every ceiling clip holds at least 8.0 kg, 78.5 N, in pull-out (3 × 16 kg / 6, ISS-076). No clip lets go or keeps a permanent set, and the clip's maker rating covers the same loads. After T10, the limits use the weighed masses. | D-47, D-131; REQ-ASM-10; ISS-076 | HOLD (H03) |
| T08 | Ceiling safety catch drop test · thử rơi dây an toàn trần | S3 on R2 | (a) Proof-load each lanyard, with its two end fixings, to 3 × the cassette mass: 48 kg, 471 N, for a 16 kg cassette (ISS-076), for 1 min (assumption). (b) Hang S3 on its clips and lanyards at ceiling height, release every clip at once, and let it fall through the lanyards' slack; 3 drops (assumption). Record the drop and the lowest point. D-131: R2's members are the ceiling's galvanized tube (the perimeter and cross member 1 at 1.0 mm, 2 and 3 at 0.8; joints register J-FRAME-01), so the catches' fixings go into the 0.8 mm middle member, as in the pod. | Factory QC | **Pass** (D-47): no lanyard, fixing or return fails; nothing falls free, whether cassette, felt or the fill on its back (D-24); after each drop the cassette's lowest point is at least 2000 mm above the room floor (confirmed by the PM ruling above; the inside is about 2316 mm tall from the room floor, REQ-BLD-06, D-132). | D-47, D-24, D-131, D-132; REQ-ASM-10, REQ-BLD-06; ISS-076 | HOLD (H04) |
| T09 | ACP-to-steel bond, and the skin's flatness · kiểm tra keo dán | S7 bond coupons; S1 last | Lap-shear coupons: Alcorest's back face as delivered, the face that gets bonded (the bond spec's HOLD-B4 asks what coating it carries), on the galvanized tube (P02A) in its real finish, half of them across a T joint whose weld is touched up with the zinc-rich paint (P27), with Sikaflex-252 after an abrasive pad, Sika Aktivator-205 and Sika Primer-210 on both faces (D-137; the bond spec's section 8) and the fixing tape laid out as the bond spec gives (tape pieces in line with the bead, finding B1), prepared, beaded and cured as the maker's data sheet says (the factory files its revision). Pull to failure: 5 as cured, and 5 after 7 days at 40 °C and 95 % RH (assumption: an ageing screen for indoor use). Record strength and failure mode. Before S1 leaves for T01, photograph its skin under raking light and record each bay's bow with a straightedge (LS-02; bays about 300 mm, D-135). After every other test on S1, cut its skin off and compare the bead coverage with the pattern (D10). Sika's own lab check of Sikaflex-252 on our tube is a HOLD (H12, D-137); this test checks the bond on it. | Factory QC with a calibrated test machine, or a materials lab | **Pass:** every coupon fails in the adhesive itself, not at the paint or the tube's face (confirmed by the PM ruling above), and S1's bead coverage matches the pattern. The strengths are recorded to set the design value; no catalogue figure is used for it (guideline §8.2). The flatness is recorded for the PM to judge against v1's look (D-01); no limit is set yet. | D-17, D-01, D-131, D-135, D-137; REQ-ASM-10; HW-SEL A9; GL §8.2 | PLANNED |
| T10 | Weight per m² · khối lượng trên m² | S1, S2, S3, S5 | Weigh every layer and part on a calibrated scale with 10 g resolution (assumption): the bare frame with its rivnuts, the skin, the panel before and after bonding (that difference is the bond), the fill, the tray, the felt, the clips and any rails, and the gasket. Then weigh the outer panel and the cassette as shipped. Divide by the face area, 1.712 m² for S1 (calculation: 1495 × 1145). Also weigh S3, both cartridges, the riser and one fan. | Factory QC | **Pass:** (a) every part is at most 20 kg (D-03). (b) The layout study, rerun with the measured layers, puts the pod at or under 420 kg (D-37, D-54); if it doesn't, the PM rules on trims (D-54). For reference, the study now gives 13.4 kg/m² for S1 with S2 (11.9 + 11.1 kg, calculation) and 426.7 kg for the pod. The sound check gives 12.6 kg/m². | D-54, D-03, D-37; REQ-LGT-01, REQ-LGT-02; ISS-080 | PLANNED |
| T11 | Timed assembly of the panel · thời gian lắp tấm | S1 with S2, on R1 | Two people with one 5 mm hex key, as on site: carry S1, set it on its locating features, fit the 4 base bolts, close the seam fixings, and clip S2 on (hook-and-loop only lines it up). Then take it all down. 5 cycles (REQ-ASM-09), each step timed from video. Cycle 1 uses fitters who haven't seen the panel (assumption: it shows a first install). | The factory's two fitters; QC reads the times off the video | **Pass:** (a) each step at or under the layout study's time for it: setting on its locating features 20 s, each captive bolt 18 s, each clip connector 10 s, the cassette 60 s (all assumptions in LS). (b) One tool only, no measuring, nothing glued or stuck on site (REQ-ASM-03, REQ-ASM-04, REQ-ASM-05). (c) No lost fit and no stripped thread after 5 cycles (REQ-ASM-09). Slower steps go into the layout study, and its 126 min is restated against REQ-ASM-01. | REQ-ASM-01, REQ-ASM-03, REQ-ASM-04, REQ-ASM-05, REQ-ASM-09, REQ-ASM-10 | PLANNED (plain bolts until H13 is released) |
| T12 | Cartridge service from inside · tháo lắp ống tiêu âm từ trong pod | S5 in R3, in a 2.3 m high space | Stand R3 in a space whose ceiling is at the pod's inside height, about 2316 mm from the room floor to the ceiling cassette's face (REQ-BLD-06; D-132: the pod has no floor, so R3 stands on the room floor). Two people lift off the column's front face, slide the supply cartridge out into the space and lay it down, then put it back and refit the face. Then they take down the soffit's underside, lower the exhaust cartridge out, and refit it. Then they take the supply fans out through the removable panel beside the column top, and the exhaust fans out of the soffit. The intake riser stays fixed. 3 times (assumption), timed, noting every contact with the ceiling. | The factory's two fitters | **Pass** (D-59, D-60): each cartridge and each fan pair come out and go back from the inside, with two people and the one hex key, without touching the 2.3 m ceiling. **If a full-length cartridge can't,** it splits into two sections with a sealed slip joint (D-59), and T04 is repeated on the split cartridge. | D-59, D-60; REQ-AIR-07 | PLANNED |
| T13 | Door unit · cửa | S4 | Once the hinges and lock are named: the rated hinge set and lock on the 8.76 mm laminate with the seals; door sag and swing cycles; seal compression and the drop seal's floor gap; the opening force; the door's sound with its seals. | Factory, and the T01 lab for sound | Limits come with the named hardware's ratings (D-46). The opening force is recorded against the later US aim of about 22 N (REQ-US-04). | D-46, D-56, D-57; REQ-BLD-05, REQ-BLD-08, REQ-US-04; ISS-002, ISS-074 | HOLD (H01, H02) |
| T14 | ACP flex under a push · độ võng tấm ACP khi đẩy | S1 | Push 100 N at the centre of a bay of S1's skin, square to the face, and read the skin's deflection at that point with a dial gauge set on the frame; the push pad and the bays tested as the factory proposes (assumption). | Factory QC | **Pass:** 2 mm or less at 100 N (D-135; edges taken as simply supported, members about 300 apart). | D-135, D-131; REQ-BLD-01 | PLANNED |
| T15 | Floor seal: the base lip and the door's drop seal · gioăng chân đế và gioăng cửa trên sàn | R1 fitted with the base lip; S4 | With no floor, the pod seals on the room's own floor, where floorless pods leak most. Set R1's base lip, across the glides' range, and S4's drop seal, at the door's closed position, on a hard floor and then on carpet tile; light test from the inside with the room dark, and note any gap. | Factory QC | **Pass:** no light past the lip or the drop seal on either floor (as F-03's light test). | D-132; REQ-SND-02; joints register J-T4 (taken by this test), HOLD-06 | PLANNED |
| T16 | Welded corners and T joints · thử mối hàn góc và chữ T | S7 weld coupons | The joints register's J-T7 (J-FRAME-01, D-131), in the production tube, welding process and 2 mm mitre plates (P28), before S1's frame is welded: 5 corner coupons of each kind the frames use (two 20 × 40 at 45° in 1.0 and in 1.2; a 20 × 40 rail on a 40 × 40, in 1.0 and in 1.2; two 40 × 40), legs 400 long, bent in plane to failure; 5 T coupons of each kind (a 0.8 stud on a 1.0 and on a 1.2 rail), bent and pulled to failure; 2 more of each kind sawn through the weld. | Factory QC with a calibrated test machine, or a materials lab | **Pass:** no corner cracks below the highest factored corner lift of the frames that use that kind, at the thinnest wall: 167 N·m for the 1.0 mm kinds (C1) and 206 N·m for the 1.2 mm kinds and the 40 × 40 pair (L1 and L2) (calculation, the joints register); every corner and T joint fails in the tube, not at the weld or the plate; the sawn welds run all round with no lack of fusion or bonding over more than 10% of the length (assumption). These results fix the factory's welding procedure (joints register HOLD-22). | D-131; REQ-BLD-01, REQ-BLD-02; joints register J-T7, J-FRAME-01, HOLD-22 | PLANNED |

## Order on S1 and S2

T10 runs during the build, while the parts are still separate. T11 runs next, at the factory. T09's flatness record is made before S1 ships to the lab, and then T01 and T02 run at the lab. T09's cut-open check comes last, because it destroys the skin bond.

## Rules for every result

- **What a PASS needs** (guideline §10; conventions §9): the method and standard, the conditions, the item and its drawing revision, the instrument with its serial and calibration date, the result, and who (by role) and when. Without all of them, the test stays NOT TESTED.
- **Photos** of every item and every set-up, filed with the result.
- **No names:** the repo is public, so results name roles and accredited labs by accreditation only, with no personal names and no quotes (REQ-DOC-03).
- **Labs:** the PM picks the labs. Agents don't contact labs or suppliers (REQ-DOC-02).
- **Feeding results back:** the Hardware Engineer reruns the sound and air model (T01 to T04). The Layout Engineer reruns the layout study (T10, T11). The PM logs each decision the results trigger: fill (T02), torque (T06), felt (T03), cartridge split (T12), weight trims (T10).
