autonomous-ai/spaceship/v2/00-Control/issue-register.csv

id | area | type | issue | evidence | action | action_by | who_confirms | close_condition | status | raised
ISS-001 | FRONT (door leaf, fixed glass) | gap | The build plan does not cover the glass door or the fixed glass. It has no glass item or VT code, and its renders show an open front. The look needs v1's glass layout. | Build plan p1-p5 (no glass anywhere); v1 BOM GL-01, GW-01; v1 STEP 'Door', 'Wall Glass'. | Define the v2 door leaf and fixed glass from the v1 outline (open-questions.md Q1). Pick thickness and type with the sound check. Glass drawings need the supplier's confirmation. | Hardware Engineer (selection, sound check); FRONT engineer (CAD) | PM | Glass type, thickness, outline and edge work fixed on a FRONT drawing, with the supplier questions listed; open-questions Q1 confirmed. | PROPOSED | 2026-10-31
ISS-002 | FRONT (hinges, handle, catch) | gap | The plan does not cover door hinges, the handle, or a catch or latch. v1 used 3 'shower hinges' and a 300 mm handle, with no part numbers. | Build plan (not there); v1 BOM MUA-09 (3 hinges), MUA-10 (300 mm handle); v1 STEP 'Shower Hinges' x3, 'Handle'. | HOLD (D-46, D-56, D-68, D-83): the hinges must be rated for 8.76 mm toughened, heat-soaked laminate, for at least 60 kg, since the door unit is about 50.2 kg in the FRONT model (D-68), and for the 1176 mm width, and they must hold the door at its closed position. There is no lock on the glass: the door keep is a 35 N magnetic catch in DT's underside at the top latch corner, with a 180-degree magnetic seal pair on the glass edges (D-83); name both products. Check the catch's pull against REQ-US-04 (about 22 N, US rules later; whether a holding device counts is unverified). D-30's dormakaba OFFICE 11.233 in a 160 mm pocket in DL stays the candidate, but its maker lists it for 8 and 10 mm toughened glass only (hardware selection). Still to select: the handle set, with SKU and fit data, before any CAD (guideline 4.3). | Hardware Engineer | PM | A rated hinge-and-lock set named in the hardware selection for that glass, at least 60 kg and 1176 mm, with SKU, glass thickness range and hole data, then fitted on the door sample; the PM logs it and lifts the HOLD. | OPEN | 2026-10-31
ISS-003 | WALL, FRONT, CEILING, BASE (seals) | gap | The plan has no seals: no gaskets at panel joints, no door perimeter or drop seal, no glazing gaskets, no base seal. v2 needs all of them. | Build plan (not there); PLAN.md 'Quiet without the weight'; build plan p2 joint section shows a 1 mm gap between the ceiling or back-wall frame and the side-wall frame with no seal. | Select seal profiles and the drop seal; the drop seal sits in the door's kick strip (D-40). Give each joint in the joint register its seal and compression range. The joint gasket runs beside the washer line on the 40 mm face, about 8 mm wide, so no bolt or spigot cuts it (D-64); the closing centre seams B1-B2 and C1-C2 get a thicker gasket over their slotted range (D-65). | Hardware Engineer (sound check) | PM | Every joint in the joint register names its seal (SKU, compressed size), and the sound check counts it. | OPEN | 2026-10-31
ISS-004 | ELECTRICAL (lights) | gap | The plan has no lights. The v1 BOM lists 2 square 170 x 170 ceiling lights; the v1 CAD has 1. PLAN.md wants a soft front light for video calls. Decided (D-20): one dimmable, low-heat LED ceiling light plus a soft front face light, all on 12 V. D-70 replaces that: a slim light shelf along the wall tops lights the felt ceiling, the face light is dropped, and a 'call' scene lights the face from the screen side. | Build plan (not there); v1 BOM MUA-03; v1 STEP 'Ceiling Light' x1; PLAN.md Milestone 1 item 2. | The Hardware Engineer picks the fittings (SKU, power, size, mounting) per D-70. | Hardware Engineer | PM (look of the light shelf) | Fittings selected (SKU, power, size, mounting) and placed on the wall drawings, with the light scenes. | DECIDED | 2026-10-31
ISS-005 | ELECTRICAL (wiring, power inlet) | gap | The plan has no wiring, cable route, power inlet or electrical protection. v1 had a power jack and LAN jack outside on the back center wall. The thin floor (D-05) removes the space under the floor. | Build plan (only VT07-VT09 on the back wall); v1 BOM MUA-07, MUA-08; v1 STEP 'Power Jack' at Y(v1) +845...+868 (sticks out 18 mm); PLAN.md 'the cable can run inside the back wall'. | Define a 220 V inlet (prototype), protection, harness and a cable route inside the back wall to the front decor blocks for the fans (D-29) and to the ceiling cassettes for the lights (D-41). Fans are hard-wired. | ELECTRICAL Engineer (D-80) | PM | Wiring diagram, route drawing and parts with SKU; no fan on a user socket. | OPEN | 2026-10-31
ISS-006 | INTERIOR (table) | decision | The plan's renders show a table and v1 had one (BOM 600 x 1000 x 820; the CAD table is 600 x 800 x 820). The product owner removed it: the pod ships empty. | PLAN.md 'Removed: the table'; v1 BOM TB-01...TB-03; v1 STEP 'Table' box 600 x 800 x 820. | None. No table holes or table loads in v2. | PM | PM | Decision recorded in PLAN.md, approved 2026-10-31. | CLOSED | 2026-10-31
ISS-007 | LINING, BASE (plan codes) | conflict | The plan uses code VT03 for two different materials: 'VT03: PET felt 9 mm, dark gray' and 'VT03: steel tube 50x100'. | Build plan p2 and p3 (material list). | Until the plan is corrected, write 'plan VT03-PET' and 'plan VT03-ST' (conventions.md section 6). Ask the indoor pod lead engineer to renumber one. | Control pack | PM | The PM logs the two codes as the v2 reading. | PROPOSED | 2026-10-31
ISS-008 | POD (plan goals) | typo | Plan goal 3 reads 'Cách ấm tốt' (keeps warm well). It is almost certainly 'Cách âm tốt' (good sound insulation): the pod is indoor-only and every other source talks about sound. | Build plan p1, Goal 3. | Read it as sound insulation (requirements.md BP-02). | Control pack | PM | The PM logs the reading. | PROPOSED | 2026-10-31
ISS-009 | POD (targets) | gap | The plan sets no weight target and no sound target. PLAN.md set 300 kg or less and 'at least as quiet as v1, aim 30 dB'. Decisions D-27, D-37, D-53 and D-54 now set a 420 kg cap, with the pod estimated at about 427 kg and open against it (ISS-080), and about 19.3 dB calculated (14.6-21.7, about 24 dB at best), replacing D-02's numbers (ISS-063). | Build plan goals 1 and 3 have no numbers; PLAN.md Targets 1 and 5; decision-log.md D-02, D-27. | Use the current numbers: D-27, D-37, D-53 and D-54 (requirements.md REQ-LGT-01, REQ-SND-01). | Control pack | PM | D-27 logged; the factory sample result recorded as evidence. | DECIDED | 2026-10-31
ISS-010 | FRONT, AIR (slot pattern) | undefined | The room-side openings are now a roof slot just behind the right decor block for the exhaust (Y -620 to -326, about 285 x 294, D-61) and the flush black mesh band piece under the right block for the intake (80% free, 0.028 m2, D-62); the grilles inside sit on the air column and the soffit (D-60). The slot pattern of the roof slot and the mesh pattern are undefined: size, pitch, free area, position, edge distance. They set airflow, noise and how the roof and band look. | Build plan V ('các khe pattern'); the plan's top view shows one slotted grille per ceiling half. | Size the free area from the air design (airflow, pressure drop, noise), then draw the pattern with a feature rationale. The mesh's 0.028 m2 free area is set (D-62); BASE designs the mesh band piece, CEILING the roof slot. | Air Engineer; BASE Engineer (mesh band); CEILING Engineer (roof slot) | PM (look) | Pattern drawn, with the free-area calculation, the noise check and a feature rationale entry. | OPEN | 2026-10-31
ISS-011 | WALL, CEILING (M6 joints in aluminium tube) | undefined | Nothing says what the M6 bolts thread into on the frame tube: the plan's 20x20 steel tube, now aluminium 20 x 40 x 1.2 for the walls and the ceiling (D-16, D-42, D-54). A nut inside a closed tube can't be reached. The bolts must also be captive (D-08), and the 1.2 mm wall needs a rivnut with that grip range; the picked rivnut's grip check passed in PR #11. Rivnut torque is on HOLD until a spin-out test in the real tube (D-48). Options were: a blind rivet nut in the tube, a through-bolt with an access hole and nut, a welded nut, a threaded block. | Build plan rule 4 and sections II-V ('bolt M6x60'); plan VT10 has no wall thickness. | HOLD (D-48, D-56): rivnut torque, until a spin-out test of the picked M6 rivnut (Sherex CAH3-610-4.2, grip 0.70-4.20 mm, which covers the 1.2 mm wall; hardware selection) in the real 20 x 40 x 1.2 tube, with its bulge clearance. Then fix each joint's anchor (guideline 8.1): hole size, edge distance, torque from the test, tool access, one tool for the whole pod. The bolt is ISO 4762 M6 x 16 with an ISO 7093 washer on aluminium, in 7.0 mm holes within 0.4 mm of the spigot hole (D-63, D-64). | Hardware Engineer | PM (key joint) | Spin-out test recorded and the torque set from it; joint register entries J-WALL-xx with SKU, stack section, grip, torque basis and test; the PM lifts the HOLD. | OPEN | 2026-10-31
ISS-012 | WALL, FRONT (depth chain) | conflict | Wall depth 1500 plus decor depth 200 equals 1700 exactly. That leaves no overlap or joint allowance between the side walls and the decor blocks, and it doesn't say whether the 1500 includes the back wall. In v1 the walls are 1496 deep and the decor blocks 220-225 deep, so they overlap by about 21 mm. Corrected on PR #16: v1's decor is 205 deep (Y -850 to -645), not 220-225. | Build plan II ('1500 ... 200 mm còn lại là của khung trang trí'); v1 STEP walls Y(v1) -646...+850, decor Y(v1) -850...-625. v1's decor-frame drawing (core frames 191 and 197 deep, plus the skin and back plate) and the decor shell in the v1 STEP give Y -850 to -645, 205 mm; the 230-235 came from the v1 BOM (skeleton BUILD-RECORD.md, PR #16). | Decided (D-49, replacing D-39): the decor blocks are 205 mm deep, as v1 measures (front face Y = -850, back plate Y = -645), and the side walls 1495 deep from Y = -645 to +850, so walls and decor meet face to face and keep v1's side seam. The plan's 1500 and 200 are superseded. Dimension the chain on the GA (back face Y = +850, wall front edge and decor back plate Y = -645, decor front Y = -850) with the joint detail. | Skeleton CAD (P03 has it); GA drawing | PM | Depth chain dimensioned on the GA with the joint detail; the PM logs it. | DECIDED | 2026-10-31
ISS-013 | POD (overall height) | conflict | The overall height is 2400 in the plan text, 2405 in the plan's own front view (the v1 drawing) and 2417 in the v1 BOM (with feet). v2 needs one value and a datum. Decided (D-21): 2400 from the room floor to the top of the roof skin. | Build plan p1 text '2400H' vs picture '2405.00'; v1 wood-parts p1 '2405.00'; v1 BOM summary '2500 x 1700 x 2417'. | Show 2400 above the room floor on GA-001 (conventions.md section 4). | Control pack; layout study | PM (look) | Height and datum confirmed and shown on GA-001. | DECIDED | 2026-10-31
ISS-014 | FRONT (decor to walls) | undefined | 'Pat V' (the V bracket) and the 'vít sắt' (steel screws) that join the 3 decor blocks to the walls are undefined: material, shape, holes, screw type. Site joints must be M6 (one bolt size). | Build plan VI ('3 khối liên kết với 3 vách bằng Pat V và vít sắt'). | Design the bracket around real fasteners; joint register J-FRONT-xx. | Hardware Engineer; FRONT engineer | PM (key joint) | Bracket drawing, joint register entry and fastener SKU. | OPEN | 2026-10-31
ISS-015 | LINING (felt fixing) | undefined | How the felt (plan VT03-PET) is held, and how the lining cassette hangs, are undefined. The plan says hook-and-loop (Velcro) stuck on after assembly; decision D-08 moves the felt to the factory, pre-fitted on each panel (ISS-064). D-17 puts the felt on the face of a floating 0.5 mm steel tray. Still open: how the felt holds on the steel at the factory, and the tool-free clips that hang the cassette on the frame without a screw (so it stays floating), with their pull-off strength. | Build plan rule 5 ('VT03 sẽ được dán bằng miếng dán Velcro'); Lead's rulings 2026-10-31. | Rule decided (D-47): captive mechanical clips with a rated load; ceiling cassettes also get a safety catch; hook-and-loop only for lining up. The clip and catch part is on HOLD (ISS-076). Fix the felt to the steel at the factory. D-69: the tray's 12 mm lips hold the felt, which settles the sample package's H09 for the walls; it stays open for the ceiling cassettes. | Hardware Engineer | PM | Clip and catch SKUs with rated loads (ISS-076), the felt fixing, and the felt's emission certificate (ISS-075); the PM logs them. | DECIDED | 2026-10-31
ISS-016 | WALL, CEILING (ACP to frame joint) | undefined | With no plywood (D-17), the ACP (plan VT01) fixes straight to the aluminium frame. That factory joint is undefined: structural tape, adhesive or rivets, with the skin flat and the seams in line (D-23). Guideline 8.2 needs a bond spec if it is bonded. No glue on site. | Build plan rule 5 ('VT01 được dán vào VT02 bằng keo'). | Write the bond spec: SKU and TDS revision, surface preparation, coverage, pressing, cure, coupon tests; low emission. | Hardware Engineer | PM | Bond spec with a coupon test plan (Milestone 2 sample). | OPEN | 2026-10-31
ISS-017 | v1 BASE (leveling feet) | conflict | The v1 BOM lists 6 leveling feet. The v1 CAD has 8 foot instances but only 6 positions: instances 3 and 6 sit in the same place, and so do 4 and 5. The CAD most likely has 2 duplicates and 6 real feet, which matches the BOM. | v1 BOM MUA-01 qty 6; v1 STEP 'Adjustable D50xM12' :1-:8 (the boxes of :3 and :6, and of :4 and :5, are identical to 0.1 mm). | None for v2: the thin floor (D-05) has no feet. Recorded for reference. | Control pack | PM | No v2 impact (D-05); the STEP check is the evidence. | CLOSED | 2026-10-31
ISS-018 | v1 BASE (floor boards) | conflict | v1 floor plywood: the BOM says 9 mm; the drawings and the CAD say 15 mm. Depth is 1429 in the BOM and CAD and 1428 on the drawing. | v1 BOM FLR-01 '9 mm'; wood-parts p3-p4 'PLY DÀY 15mm', 1428; v1 STEP 'Floor' bodies 15 mm thick, 1429 deep. | Use 15 mm (CAD and drawing agree) in the v1 weight baseline; tell the layout study. | Layout study | PM | The layout study's v1 weight model (PR #10) states the thickness it uses, and the PM logs the v1 baseline. | OPEN | 2026-10-31
ISS-019 | v1 ELECTRICAL (ceiling lights) | conflict | v1 ceiling lights: the BOM says 2 square 170 x 170 lights; the CAD has 1 'Ceiling Light', and its size can't be read from the STEP. | v1 BOM MUA-03 qty 2 and the summary sheet; v1 STEP 'Ceiling Light' x1. | None for v2: D-20 sets the v2 lights. Recorded for reference. | Control pack | PM | No v2 impact (D-20). | CLOSED | 2026-10-31
ISS-020 | v1 POD (height) | conflict | v1 height is 2405 on the drawing and 2417 in the BOM. The STEP explains it: roof top at Z(v1) = 2402, floor-frame brackets down to -3, feet bottoms at -15. So 2405 leaves out the feet and 2417 includes them at their modelled setting. Not a geometry error, but the v1 files never state the datum. | wood-parts p1 '2405.00'; v1 BOM summary 'Cao tính cả chân tăng chỉnh'; v1 STEP boxes (calculation). | v2 states its datum: the room floor (conventions.md section 4). See ISS-013. | Control pack | PM | Resolved for v2 by D-21 (2400 from the room floor). | CLOSED | 2026-10-31
ISS-021 | v1 WALL, CEILING (inner plywood) | conflict | v1 inner plywood ('ốp trong'): the BOM says 9 mm for the walls and ceiling; the drawings and CAD say 15 mm, and 12 mm on the back center wall. | v1 BOM LW-04, RW-04, BWL-05, BWC-04, BWR-05, CL-03 (9 mm); wood-parts p9, p12, p17, p22, p29, p34; v1 STEP wall bodies 15 mm, back center 12 mm. | Use the CAD and drawing values in the v1 weight baseline; flag it in the layout study. | Layout study | PM | The layout study's v1 weight model (PR #10) states the thickness it uses, and the PM logs the v1 baseline. | OPEN | 2026-10-31
ISS-022 | v1 BASE (front edge strip) | conflict | The v1 front floor edge strip (threshold trim, 1917 x 204 or 205) is yellow 3 mm aluminium in the BOM, but 3 mm plywood on the drawing label (the drawing's render shows it yellow). | v1 BOM FL-11; wood-parts p3-p4 'TẤM SÀN TRƯỚC PLY DÀY 3mm'; v1 STEP Body50 1916.9 x 204 x 3. | Decided (D-18, D-40): the v2 base band is aluminium in a dark finish, carried across the door by an 85 mm kick strip (D-40, D-57). Match the shade to v1's product photos. | Control pack | PM | The base band and kick strip finish shown on the drawings, matched to v1's photos. | DECIDED | 2026-10-31
ISS-023 | v1 FRONT (glass sizes and mass) | conflict | v1 glass sizes disagree. Door: the BOM gives a 2011 x 1175.6 rectangle, but the CAD door is a trapezoid (1175.6 wide at the bottom, 892.9 at the top, 2011.1 tall, slanted leading edge), area 2.080 m2 rather than 2.364. Fixed glass: BOM line 2138.5 x 723.7, summary sheet 1014 x 2017, CAD a 5-sided shape (box 1014.3 x 2017.1), area 1.344 m2. So the glass is lighter than the BOM suggests: at 8 mm the door is about 41.6 kg (not 47) and the fixed glass about 26.9 kg, at 2500 kg/m3. | v1 BOM GL-01, GW-01 and summary rows 13-14; v1 STEP 'Door' and 'Wall Glass' outline points (calculation, polygon area); glass density 2500 kg/m3 (assumption, typical soda-lime glass). | Use the CAD outline for v2 glass and the hinge rating. Pass the corrected masses to the layout study and the hardware selection. | Control pack, then Layout study and Hardware Engineer | PM | The FRONT drawing uses the v1 STEP outline, and the cut sizes go on the factory's question list. | OPEN | 2026-10-31
ISS-024 | v1 FRONT (hinges) | conflict | The v1 BOM lists 3 hinges. The CAD has 3 hinge instances but 2 of them sit in the same place (Z(v1) 353-443), so only 2 positions are modelled (the other is at Z(v1) 1753-1843). | v1 BOM MUA-09 qty 3; v1 STEP 'Shower Hinges' :1 and :2 have identical boxes, :3 is higher. | None for v2: D-30 sets the v2 hinges, and their count follows the rating. Recorded for reference. | Hardware Engineer | PM | No v2 impact (D-30). | CLOSED | 2026-10-31
ISS-025 | v1 POD (depth, floor frame) | conflict | v1 overall depth: the BOM header says 2500 x 1718 x 2417 and the summary says 2500 x 1700 x 2417 (the 18 mm is the rear power jack). Floor frame: 2500 x 1703 x 106 in the BOM and CAD, 2500 x 1700 x 103 on the floor-frame drawing. | v1 BOM 'BOM' sheet row 2 and summary sheet; floor-frame-assembly p1; v1 STEP 'Floor Frame (FL)' box. | v2 states the footprint without things that stick out; keep the power inlet inside 1700 or list it as a protrusion on the GA. | Control pack | PM | The v2 GA lists every protrusion beyond 2500 x 1700. | OPEN | 2026-10-31
ISS-026 | v1 BASE (floor-frame brackets) | conflict | The v1 BOM has only 2 bracket lines (FL-12 qty 1, FL-13 qty 4), but the floor-frame drawings detail many more: Pat_L front 2 and rear 2, Pat_U 4, Pat_L_goc_truoc 2, Pat_L_goc_sau 2, Pat_vach_trai 1, Pat_vach_phai 1, Pat_nho 13, Pat_sau_vach_trai 1, Pat_sau_vach_phai 1, Pat_sau_vach_giua 1, plus 4 mm PAT_NEP strips on the wall frames. | v1 BOM FL-12, FL-13; floor-frame-assembly p7-p17; wood-parts p10, p25, p30. | None for v2 (thin floor, D-05). Count them in the v1 weight baseline. | Layout study | PM | The layout study's v1 weight model counts the brackets. | OPEN | 2026-10-31
ISS-027 | v1 BASE (Pat_sau_vach_trai) | conflict | The bracket 'Pat_sau_vach_trai' is called 'Thep 3mm' but drawn 4.00 thick. Its mirror 'Pat_sau_vach_phai' is 'Thep 4mm'. | floor-frame-assembly p15 vs p16. | None for v2: the thin floor (D-05) drops these brackets. Recorded for reference. | PM | PM | No v2 impact (D-05). | CLOSED | 2026-10-31
ISS-028 | v1 WALL (back center skin) | conflict | The back center wall's outer skin is labelled 'ALU DAY 6mm' on the drawing. The BOM says 2 mm, and the CAD body is 2 mm. | wood-parts p26; v1 BOM BWC-06; v1 STEP 'Back Wall Center' Body166. | None for v2 (most likely a typo; v2 skins are ACP 3 mm). Recorded for reference. | PM | PM | No v2 impact (D-16, D-17). | CLOSED | 2026-10-31
ISS-029 | v1 FRONT (decor DR2) | conflict | The v1 CAD has a separate component 'Decor Right (DR2)' (1 body, about 520 x 205 x 879 at the top of the right block). The BOM has only DL, DR and DT. It may be BOM line DR-31 (a formed panel 520 wide). | v1 STEP occurrence 'Tấm Decor Right (DR2):1'; v1 BOM DR-31. | Confirm when the FRONT engineer rebuilds the decor from the v1 STEP. | FRONT engineer | PM | DR2 matched to a BOM line. | OPEN | 2026-10-31
ISS-030 | v1 POD (weight baseline) | conflict | v1 weight: the product page says 431 kg; the first market study said about 550 kg from the BOM; PLAN.md on main now says about 480 kg by its BOM. '300 kg is about half of v1' depends on which is right. | v2/research/market-study.md, FocusPod v1 row; PLAN.md Target 1. | The layout study recomputes v1 from the CAD and BOM with the ISS-018, ISS-021 and ISS-026 corrections; weigh a real v1 pod if one is at hand. | Layout study | PM | The PM logs the v1 baseline from the layout study's reconciled model (about 480 kg in PLAN.md). | OPEN | 2026-10-31
ISS-031 | FRONT (decor colour) | conflict | Decor colour. The plan's material list clads the decor frame in plan VT01 (ACP Dark Yellow EV3038), the v1 BOM says yellow 3 mm aluminium, and v1's product photos show it yellow. But the plan calls the decor frame black ('Khung trang trí (màu đen)'), and the v1 CAD renders and the plan's pictures draw it black. Decided: Dark Yellow (D-12). | Build plan p1 rule 3 and section VI; renders p1 and p5; v1 BOM DL-14...DT-23 ('Tấm nhôm 3 mm màu vàng'); v1 summary 'decor khung thép ốp nhôm vàng'; product photos and the ruling as reported by the Lead on 2026-10-31. | Draw the decor in Dark Yellow EV3038 (requirements.md REQ-LOOK-03). Check the base band colour the same way. | Control pack | PM | Decor colour decided (D-12); base band colour recorded in the decision log. | DECIDED | 2026-10-31
ISS-032 | CEILING (plan text) | typo | Plan section V (ceiling) says 'Cấu tạo của vách hậu' (back wall build). It means the ceiling build: VT01, VT02, VT10, VT03 from outside in. | Build plan section V. | Read it as the ceiling build. | Control pack | PM | The PM logs the reading. | PROPOSED | 2026-10-31
ISS-033 | POD (codes) | conflict | 'VT' means two things: the plan's material codes VT01-VT12, and the v1 BOM's screw and insert lines VT-01 (M8x60), VT-02 (M8x40), VT-03 (M8x20 insert). | Build plan material list; v1 BOM section 'VT - Vít & tán cấy bắt vách'. | Always prefix them: 'plan VT01', 'v1 VT-01' (conventions.md section 6). | Control pack | PM | The PM logs the convention. | PROPOSED | 2026-10-31
ISS-034 | BASE, WALL, CEILING, FRONT (tubes) | undefined | Since replaced for the frames: D-131 makes them welded galvanized steel, whose grade, zinc and walls the joints register's J-FRAME-01 sets (the sample's H15); the base band and DR's panel stay aluminium. Aluminium is decided (D-16): 20 x 40 x 1.2 at 400 mm for the walls and the ceiling (D-42); the rivnut grip check passed, so the 1.2 mm wall stands (D-54). Still incomplete: the alloy and temper, the finish and the tolerances. VT10 also carries the M6 joints (ISS-011). | Build plan material list. | Decided (D-79): the hidden frame tubes are 6063-T6, mill finish, with only the surface prep the ACP bond spec calls for; visible aluminium stays black anodised AA20 (D-67). Still to list: the profile standard and tolerances, and E for the joints register's checks (2.5). D-85: the wall panels' inner studs are 1.0 mm; the perimeter members (rivnuts) and the ceiling's cross members (cassette clips and catches) stay 1.2 mm. | Hardware Engineer | PM (main material) | The profile with its standard, wall thickness, 6063-T6 and the mill finish in the selection table; the joints register's 2.5 re-checked with its E. | DECIDED | 2026-10-31
ISS-035 | WALL, CEILING, FRONT, LINING (boards and felt) | undefined | The plan's board specs are incomplete. VT01 ACP 3 mm: no core type (PE or fire-rated), skin thickness or maker; only the colour EV3038. VT02 plywood is dropped (D-17). VT03-PET 9 mm: no density, emission certificate or fire rating; only a seller link. | Build plan material list and links. | Complete the specs with sources and low-emission certificates (REQ-MAT-01). Felt: picked by its published absorption data down to 100 Hz, with the wall sample measured down to 100 Hz (D-48); the factory's 9 mm PET is tried first (D-31). The factory felt's emission certificate is on HOLD (ISS-075). | Hardware Engineer | PM | Spec rows with source and certificate. | OPEN | 2026-10-31
ISS-036 | HARDWARE, BASE (bolts and feet) | undefined | Plan VT11 'Bolt M6x60' has no grade, finish, head or nut type; the picture shows a black hex bolt with washer and nut, which takes two spanners. Plan VT12 'Chân tăng đưa M10' has no load rating, and v1 used D50 M12 feet. | Build plan p3 (picture and links); v1 STEP 'Adjustable D50xM12' (25 mm radius, 6 mm thread radius). | Decided (D-63): ISO 4762 M6 x 16 socket-head bolts, captive, one 5 mm key, with ISO 7093 washers on aluminium; the joints register lists the SKUs and owns the fastener and hardware part numbers (PR #23). The feet are dropped with the thin floor (D-05). | Joints Engineer | PM | Fastener SKUs and the key listed in the joints register, merged; the PM logs it. | DECIDED | 2026-10-31
ISS-037 | POD (plan VT05) | undefined | Plan VT05 'Thép tấm 3 mm' (3 mm steel plate) is listed, but no step uses it. Probably brackets (V brackets or floor-frame plates). | Build plan material list. | Drop VT05 unless a v2 bracket needs 3 mm steel plate; assembly-tree.md maps it to brackets as an assumption. | Control pack | PM | The PM logs whether VT05 stays. | OPEN | 2026-10-31
ISS-038 | AIR, ELECTRICAL (fan control) | conflict | Plan VT08 is a mains fan speed knob ('triết áp', read as 'chiết áp'). It can't start the fans when someone walks in, can't give boost, can't stop people turning the fresh air off, and can't drive 12 V DC fans. v2 requires all of these (REQ-AIR-03, REQ-AIR-04, REQ-ELE-01). | Build plan VT08; PLAN.md Target 4. | Decided (D-09, D-44, D-50): the sensor hub's control drives the fans on CO2 and heat. It holds 800 ppm or less and the inside at most 4 K over the room (a sensor at the supply fan inlet against the one inside), overrides any user turn-down, never goes below 26 l/s while someone is inside, and boosts whenever it can't hold either limit. | Hardware Engineer (air) | PM | Control scheme with parts and wiring showing the CO2 and heat control and the 26 l/s floor; the prototype's CO2 and temperature logs show 800 ppm and 4 K held. | DECIDED | 2026-10-31
ISS-039 | AIR (fans) | undefined | Plan VT06 (Panasonic FV-15AUL1, a 15 cm wall-mounted fan; one blows in, one blows out) is a mains fan, but the 12 V DC bus feeds the fans (D-10). The sound and air check (PR #11) also found that its manual forbids ceiling mounting and it has no published fan curve. v1 used 4 fans (2 units of 2). | Build plan VT06 and seller link; v1 BOM MUA-02 (4 fans, 200 x 200 x 60). PR #11 report section 7b and hardware selection (Fans). | Decided (D-51, D-52): four 12 V fans (Noctua NF-A14 industrialPPC-3000 PWM), two per path, in the lined fan boxes of two cartridges in the right decor block, on the 12 V bus; 25.6 dB(A) calculated at 53 l/s against the 26 dB(A) limit, and the boost to 65 l/s at 30 dB(A). The fans' octave data is on HOLD for the fan-sample test (ISS-077). | Hardware Engineer (air) | PM | Choice recorded with its reason (D-51); the fan-sample test closes ISS-077. | DECIDED | 2026-10-31
ISS-040 | BASE (floor type) | change-proposal | DECIDED (D-05): a thin floor (about 20 mm of panels on the room floor, walls fixed around them, the outside base band kept as trim) replaces the plan's raised floor (50x100 and 30x60 steel frame, 6 M10 feet, 2 floor boards). Saves about 50 kg; the step at the door drops from about 13 cm to about 2 cm. The build details in open-questions.md Q4 are still PROPOSED. Since replaced: no floor (D-132). | Build plan sections I and VII, rule 6; PLAN.md 'Same look, lighter bones'; open-questions.md Q4. | Design the thin floor. The layout study shows its weight, step, sound, stiffness and assembly time against the plan's raised floor, for the record. D-72 sets the build: 9 mm plywood panels on a firm 3 mm closed-cell foam mat (D-76; product on HOLD, ISS-085), floor top at 12 mm, with a 13 mm threshold. | Layout study; BASE engineer | PM | Replaced by D-132 (no floor): nothing to draw; it closes when BASE's list drops the floor parts. | DECIDED | 2026-10-31
ISS-041 | WALL, CEILING, FRONT (frame material) | change-proposal | DECIDED (D-16): aluminium instead of steel for the frames (plan VT10): 20 x 40 at 400 mm for the walls; the ceiling later moved onto the same 20 x 40 x 1.2 frames (D-34, D-42); decor frames sized by the door-load check. Saves about 40 kg (PLAN.md). A main material change; the joints and the decor block that carries the door need checking (ISS-045). | Build plan VT10 'Thép hộp 20x20'; PLAN.md 'Same look, lighter bones'. | Go ahead marked PROPOSED; size frames for indoor loads, shipping and repeated assembly. | Layout study; Hardware Engineer | PM | Approval recorded, with the frame check. | DECIDED | 2026-10-31
ISS-042 | WALL, CEILING (plywood backer) | change-proposal | DECIDED (D-17): no plywood behind the ACP. The sound mass goes in a floating steel-and-felt lining cassette (0.5 mm steel tray, 25 mm air gap, 9 mm felt); the wall is 81 mm at 12.6 kg/m² with 20 x 40 x 1.2 frames and 32 kg/m³ fill (D-54). Changes the bond (ISS-016) and the felt fixing (ISS-015). | Build plan rule 5 and sections II-V; PLAN.md 'Skins'; Lead's rulings 2026-10-31. | The sound check picks the lightest wall that reaches the quiet target within the cap: about 19.3 dB calculated (about 24 dB at best), with the pod estimated at about 427 kg, open against the 420 kg cap (D-37, D-53, D-54). | Hardware Engineer (sound) | PM | Wall build chosen with its sound estimate; approval recorded. | DECIDED | 2026-10-31
ISS-043 | FRONT (door and fixed panel material) | change-proposal | DECIDED (D-27): 4+4 laminated glass, frameless as in v1, replaces D-07's acrylic baseline. Acrylic's hinge-edge stile added an opaque band about 80 mm wide down the door, which breaks the look rule (D-01). Acrylic stays only as an optional experiment on the factory sample. | v1 BOM GL-01, GW-01 (10 mm); PLAN.md 'Glass'; decision-log.md D-07, D-27; open-questions.md Q1. | Draw the front in 4+4 laminated glass; the door is about 43 kg for the hinge check (D-30). | Hardware Engineer | PM | Factory sample result recorded and the material confirmed in the decision log. | DECIDED | 2026-10-31
ISS-044 | WALL (visible seams) | conflict | The visible ACP seams change from v1. v1 side walls have one vertical seam 276 mm from the back corner (sheets 1220 + 276 wide); the plan splits each side wall into 2 frames one above the other (a horizontal seam at mid-height). The v1 back wall has 3 panels (939 + 640 + 939, two vertical seams); the plan has 4 frames (2 x 2, a cross of seams). The plan means this, but the look must stay the same. | v1 STEP 'Left Wall (LW)' skin bodies 1220 and 276 wide; v1 back wall 939 / 640 / 939; build plan II-IV and the p4 picture (red split line). | Decided (D-23): follow the build plan, 2 sheets per side wall and 4 on the back, with crisp, aligned reveals. Draw the reveals on the GA elevations. | Layout study | PM | Seam layout chosen and shown on the GA elevations. | DECIDED | 2026-10-31
ISS-045 | FRONT (door support, decor joints) | undefined | In v1 the door hangs on the left decor block (hinges at X about -972...-908, on DL). In v2 that block (160 mm hinge pocket in DL, D-19 and D-30), its aluminium frame (D-16) and its joint to the left wall must carry the door's weight and its turning moment. The plan also says the 3 decor blocks join '3 walls', but the top block meets the ceiling, not a wall. | v1 STEP boxes of 'Shower Hinges' and 'Decor Left (DL)'; build plan section VI. | Calculate the load path from the door (the door unit, about 50.2 kg, with hardware rated for at least 60 kg, D-68) through DL into the wall and floor; joint register J-FRONT-01. | Hardware Engineer; FRONT engineer | PM (key joint) | Calculation, joint entry and a planned sample test. | OPEN | 2026-10-31
ISS-046 | AIR (requirement numbers) | conflict | The market study's lessons table says CO2 at or under 1000 ppm and at least 20 l/s. PLAN.md and the task brief say at or under 800 ppm and at least 26 l/s. Decided (D-09, D-33, D-43, D-44, D-50, D-52): CO2- and heat-driven and self-starting, holding 800 ppm in a 600 ppm office and at most 4 K over the room; 26 l/s floor while someone is inside, about 33 l/s for one person, 53 l/s for two at 26 dB(A) or less, boost to 65 l/s at 30 dB(A). | v2/research/market-study.md, 'What we learned', fresh-air row; PLAN.md Target 4. | Use the D-33, D-43, D-44, D-50 and D-52 values (requirements.md REQ-AIR-01 to -05). The market study's owner may update its table. | Control pack | PM | Decided (D-09); the CO2 and noise check on the prototype is recorded. | DECIDED | 2026-10-31
ISS-047 | POD (definitions) | definition | 'One hand tool' and 'every part 20 kg or less' need exact meanings. PROPOSED: tool-free connectors wherever they hold the joint; otherwise captive M6 bolts, and one driver bit or key fits all of them (handling aids like suction lifters, a spirit level or a knife don't count). A part is each piece handled on its own during delivery and assembly. The glass or acrylic front is the stated exception and gets a 2-person handling method. | PLAN.md Targets 1 and 2; Lead's rulings 2026-10-31. | Use these meanings in requirements.md REQ-ASM-03 and REQ-LGT-02. D-63 settles the tool: one 5 mm hex key for every site bolt; the meaning of a part is still PROPOSED. | Control pack | PM | The PM logs the definitions. | PROPOSED | 2026-10-31
ISS-048 | PACKAGING (delivery path) | definition | 'Every part fits through a 914 x 2032 doorway' needs a check rule, and stairs, corridor turns and lifts aren't covered. PLAN.md on main also says pieces fit 'an 81 cm door and a normal elevator', which is narrower than 914. Since #274, PLAN.md carries the install sheet's rule instead: doors 810 × 2032 (REQ-ASM-06), and an elevator door at least 1070 × 2134 with a car at least 2032 × 1295 × 2286 inside, or a freight elevator or the stairs for DR (check K15). PROPOSED rule: sort a part's 3 sizes a <= b <= c; it passes if a <= 810 and b <= 2032, using the narrower 81 cm door (carried straight through, no allowance for hands or wrapping). | PLAN.md Target 2. | Apply the rule in the layout study and list the delivery-path assumptions. | Layout study | PM | The PM logs the rule. | PROPOSED | 2026-10-31
ISS-049 | AIR, POD (room interface) | undefined | The pod breathes out through a roof slot just behind the right decor block and in through the mesh band piece under it (D-61, D-62), so the room needs clear space above the pod's front-right corner and in front of the band under the right block. No minimum gap or other site need (power point, floor flatness, sprinklers) is stated. | Build plan rule 7; PLAN.md notes on US rules. | Set a minimum gap above the roof from the air design; write an install requirements sheet. | Hardware Engineer (air) | PM | Install requirements with numbers. | OPEN | 2026-10-31
ISS-050 | WALL, BASE, PACKAGING (panel height) | finding | With the thin floor (D-05) the walls stand on the room floor, so wall panels grow about 100 mm taller than v1's 2300 mm: they run from the floor to the roof, with the base band as trim. The panel split, part weights and pallet heights all change. Skeleton P04 stands the walls on the base band at Z 112.26 (D-66). | v1 STEP walls Z(v1) 102...2402; conventions.md section 4; PLAN.md pallet sizes (side frames about 1150 tall). | Skeleton P04 sets the panel sizes (D-66): side panels 1142.74 tall in two rows and back panels 1118.61; the layout study takes them (ISS-081). | Layout study | PM | Split option with real panel heights. | OPEN | 2026-10-31
ISS-051 | ELECTRICAL, WALL, CEILING (voice cockpit hooks) | scope | Decided (D-11): reserve hooks for a later voice cockpit kit built on the in-house Lamp electronics (mic array, speakers, computer), plus a screen and a status light. Hooks are 12 V 5 A power, data, mounts and a cable path. The kit itself is not designed. PLAN.md still lists 'room mic and agent status light' as left out of v2; the hooks don't add them. D-88: the kit's power budget is 40 W on average, 60 W at peak on the 12 V 5 A outlet; with it fitted, the fans boost to hold 4 K at 30 dB(A) or less. | Lead's message in the Swarm chat, 2026-10-31; PLAN.md 'Left out of v2'. | Requirements REQ-VCK-01...06; assembly tree interfaces IF-15 and IF-16; ELECTRICAL reserves a fused 12 V 5 A outlet, a data link and a cable route. | Control pack; ELECTRICAL engineer | PM | Hooks and reserved power shown on the ELECTRICAL and WALL drawings. | DECIDED | 2026-10-31
ISS-052 | CEILING (sprinkler provision) | undefined | The roof should later take a sprinkler head or open on alarm (US rules, later), but nothing says how: space, opening, a wire to a fire-alarm signal. | PLAN.md 'Later, not in the v2 prototype'. | Reserve a zone in the ceiling and a wiring point; no design yet. The sprinkler strategy itself is on HOLD for the US rules phase (ISS-082). | CEILING engineer | PM | Reserved zone shown on the ceiling drawing. | OPEN | 2026-10-31
ISS-053 | BASE, FRONT (threshold) | conflict | A thin floor of about 20 mm leaves a 20 mm step at the door. US accessibility rules (later) allow about 13 mm at a threshold, bevelled; more needs a ramp. | open-questions.md Q4; 2010 ADA Standards 404.2.5 and 303 (unverified: from memory, not checked against the text). | Decided (D-72, replacing D-18's 20 mm): a 13 mm aluminium profile with a 6 mm upright, a 1:2 bevel and a flat land for the drop seal, on a floor of 9 mm plywood over a 3 mm foam mat (D-76), top at 12 mm. FRONT moves the kick strip to keep its 7 mm gap; the ADA text is checked in the US rules phase (ISS-084). | BASE engineer | PM | Threshold detail drawn at 13 mm with the bevel; the PM logs it. Met (the PM, 2026-11-01): D-132 takes out the floor and the threshold, so there is no step at the door. | CLOSED | 2026-10-31
ISS-054 | BASE (room floor) | undefined | 'Flat, level floor' has no number, and leveling has to cope with real office floors. PROPOSED working value (assumption): the pod handles +/-5 mm over its footprint with the base seal and packers; worse floors need a leveling kit. | PLAN.md 'Same look, lighter bones'. | Confirm the floor tolerance to design for; check it against a floor-flatness standard (for example DIN 18202) before release. D-86 puts the base seal at the floor's edge against the band's inner face, sealing a fixed 4 mm gap; the glides still take the floor's 10 ± 5 mm under the band. | BASE engineer | PM | The PM logs the tolerance; the prototype tries the leveling method. | PROPOSED | 2026-10-31
ISS-055 | FRONT (door swing) | undefined | The v1 files don't show which way the door swings (the hinges sit evenly either side of the glass). The hinge side is decided (D-19, left); the swing direction is still PROPOSED: outward. | v1 STEP 'Shower Hinges' Y(v1) -724...-674 around the glass at -704...-694. | Confirm with the v1 owner; keep outward in v2 unless told otherwise (open-questions.md Q3). | Control pack | PM | The PM logs the swing direction. | PROPOSED | 2026-10-31
ISS-056 | v1 FRONT (inside handle) | finding | The v1 CAD models the 300 mm handle on the outside face only. There's no inside pull. | v1 STEP 'Handle' Y(v1) -744...-704 (outside the glass face at -704). | The v2 handle set has an inside grip (open-questions.md Q1). | Hardware Engineer | PM | Handle set selected. | OPEN | 2026-10-31
ISS-057 | PACKAGING (oversize items) | finding | Some items don't fit a 48 x 40 pallet: the glass door (2011 tall), the fixed glass (about 2017 tall; 2139 in the v1 BOM), the side decor blocks (about 2300) and the ceiling halves (about 1240 wide, 20 mm over 1219). They need a standard long pallet or a split. | PLAN.md 'Design for the pallet'; v1 STEP boxes. | Decided (D-04): 48 x 40 pallets plus one standard long pallet, decor not split. The layout study fits the ceiling halves (20 mm over 1219) and lays out each pallet. | Packing and Assembly Engineer (D-80) | PM | Pallet layout chosen. | DECIDED | 2026-10-31
ISS-058 | WALL, CEILING (backer to frame screws) | undefined | The 'vít sắt' (steel screws) that fix the plywood (plan VT02) to the 20x20 frame (plan VT10) are undefined: type (self-drilling?), size, spacing, and how they hold in a thin tube wall. Factory joint. | Build plan rule 5 ('VT02 được bắn cố định vào khung VT10 bằng vít sắt'). | None: D-17 removes the plywood, so these screws are gone. The ACP-to-frame joint is ISS-016. | Hardware Engineer | PM | Joint register entry with SKU and pitch. | CLOSED | 2026-10-31
ISS-059 | FRONT (decor ACP forming) | undefined | The decor skin is ACP 'cut with grooves and folded' to the faceted shape, but the process is undefined: groove profile, skin left at the fold, fold angles, corner backing, and which ACP core allows it. The faceted shapes must match v1's decor. | Build plan section VI ('VT01 sẽ được cắt rãnh và bẻ góc'); v1 decor-frame-assembly p13-p16 (panels 'Ghép mí 45°'). | Write the ACP routing and folding spec with the maker's data; rebuild the decor facets from the v1 STEP. | FRONT engineer; Hardware Engineer | PM | Forming spec and flat patterns checked against the v1 facets. | OPEN | 2026-10-31
ISS-060 | ELECTRICAL (in-house modules) | undefined | Spaceship reuses two in-house modules: the Desk Pro AI sensor hub (CO2, presence, air quality, sound level) and the Lamp electronics (mic array, speakers, computer). Their supply voltage and current, size, mounting, data link and placement rules aren't in the repo, and there's no public data. | Product owner's update passed on by the Lead, 2026-10-31; requirements.md REQ-ELE-02. | Use the module facts the PM passed on (2026-10-31; part details kept out of this public repo): the hub measures CO2, presence, air quality and sound level; the Lamp electronics are a mic array, speakers and a computer on 12 V 5 A. List them as in-house parts, and carry what's still unknown (size, mounting, current draw) as assumptions. | ELECTRICAL Engineer (D-80); Hardware Engineer | PM | The hardware selection (PR #11) lists both modules with sources; the PM logs any remaining gap as an assumption. | OPEN | 2026-10-31
ISS-061 | ELECTRICAL (plan VT07 switch) | undefined | Plan VT07 pairs a one-way switch with the socket, but nothing says what the switch controls. With mains going only to the outlets (REQ-ELE-01) and the lights on 12 V, a mains switch for the lights no longer fits. | Build plan VT07 and rule 8; requirements.md REQ-ELE-01. | Decide the light control: a 12 V switch, or the sensor hub with presence. Keep the plan's socket as the mains outlet. The lights are now a light shelf with scenes, including a 'call' scene (D-70). | ELECTRICAL Engineer (D-80) | PM | Light control decided and drawn on the wiring diagram. | OPEN | 2026-10-31
ISS-062 | ELECTRICAL (12 V DC bus) | undefined | The 12 V DC bus (REQ-ELE-01) needs a design: the supply's rating (at least 150 W by the first budget, REQ-ELE-03), fuses for each branch, wire sizes for voltage drop over the run to the roof, where the supply sits and how its heat leaves, and plug connectors at the panel joints. The four fans are on it too (D-51), on two signals, one per pair, balanced for equal flow (D-61), and the hub's fan output has to suit PWM fans (HOLD in the hardware selection, electrical scope). | requirements.md REQ-ELE-01, REQ-ELE-03, calculation C8. | Draw the DC distribution with the load table, fusing and wire sizes; place the supply in the back wall band; confirm the hub's PWM fan output. | ELECTRICAL Engineer (D-80) | PM | Wiring diagram and load table checked; connectors chosen with SKU. | OPEN | 2026-10-31
ISS-063 | POD (quiet target and weight cap) | decision | Decided (D-02, numbers replaced by D-27, D-37, D-53, D-54 and D-71): 300 kg stays the goal; the build is estimated at about 429.3 kg, open against the 420 kg cap (D-71, ISS-080; the 0.4 mm tray cost 1 dB, so it stayed at 0.5 mm), with the wall sample deciding the sound. It replaces PLAN.md's '300 kg or less' and 'at least as quiet as v1, aim 30 dB' (300 kg stays the goal where quiet allows). With the felt's own published data (D-48) the decided build calculates at about 19.3 dB (range 14.6-21.7), about 24 dB at best (D-53), and no weight goes back in until the wall sample is measured. PLAN.md carries the sound and air numbers since PR #18; its 418 kg predates D-54, and ISS-080 sends PLAN.md to its owner. | Lead's messages of 2026-10-31; PLAN.md Targets 1 and 5 and the 'Better by' scorecard. | Work to the ruling (requirements.md REQ-LGT-01, REQ-SND-01, REQ-SND-03). | Control pack | PM | Wall sample (down to 100 Hz), factory sample and lab results recorded; the PM logs the figure. | DECIDED | 2026-10-31
ISS-064 | WALL, CEILING, FRONT, LINING (assembly method) | decision | Decided (D-08): tool-free connectors, captive bolts, factory-made subassemblies and pre-fitted felt. This changes build plan rule 5 (felt stuck on with hook-and-loop after assembly): the felt now arrives on each panel, so its edges at panel joints must be detailed so the joints still seal and can still be bolted. D-63 replaces the tool-free seam clips with captive M6 socket-head bolts at every seam and corner. | Lead's message of 2026-10-31; build plan rule 5. | Requirements REQ-ASM-03, REQ-ASM-05, REQ-ASM-10, REQ-ASM-11; joint register entries show the connector or captive bolt per joint. | Hardware Engineer; panel engineers (Milestone 2) | PM | Joint register shows the connector or captive bolt for every site joint, and the panel drawings show the felt at the joints. | DECIDED | 2026-10-31
ISS-065 | v1 POD (sound claim) | conflict | v1 is marketed at about 30 dB speech reduction, but the calculation gives v1 about 15 dB as built. Nobody has tested v1 in a lab to ISO 23351-1. | v2/research/market-study.md (FocusPod v1 row: about 30 dB, 'preliminary'); the calculation reported by the Lead on 2026-10-31 from the sound and air check (v2/05-Engineering/acoustics-air/, merged in PR #11). | Test v1 in a lab to ISO 23351-1, in the same lab as v2. Until then, don't quote 30 dB for v1 or use it as a v2 baseline. | Hardware Engineer (sound check); product owner (claim) | PM | The PM logs what v1 may claim, with the lab result as evidence. | OPEN | 2026-10-31
ISS-066 | POD (units in STEP files) | conflict | Decision D-13 lets STEP files stay in cm when the file declares it (drawings and DXF stay in mm). AGENTS.md still says 'Use mm everywhere', and the guideline (3.1) asks for mm with a unit check after every import or export. | decision-log.md D-13; AGENTS.md 'Rules that matter most'; guideline 3.1. | Done: AGENTS.md on main (ba0aefe) now carries the exception for Fusion STEP files. After any STEP import or export, check the declared unit and measure a known size. | Control pack | PM | AGENTS.md updated or D-13 replaced. | CLOSED | 2026-10-31
ISS-067 | CEILING, PACKAGING (20 kg rule) | conflict | With the final stack, a ceiling half's outer panel (1212 x 1500 mm) weighs about 21 kg with its 100 mm fill in it, over the 20 kg rule (D-03). | The sound and air check in PR #11, part weights. | Resolved by D-24: the fill rides on its ceiling cassette (the PM's ruling in the layout study), so the outer panel stays at 20 kg or less. | Layout study | PM | Decision D-24 logged; the layout study's part list shows every ceiling part at 20 kg or less. | CLOSED | 2026-10-31
ISS-068 | FRONT (fallback front vs weight cap) | conflict | D-07's fallback front, 4+4 acoustic laminated glass, gives 24.6 dB but brings the pod to about 416 kg, over D-02's 400 kg cap, unless the ceiling drops to a 40 mm stack (23.8 dB at 400 kg). | The sound and air check in PR #11, section on the decided build. | Resolved by D-27: laminated glass is the baseline, at about 400 kg with the 40 mm ceiling, so D-25's 420 kg exception is no longer needed. | Hardware Engineer | PM | D-27 logged. D-37 later set the cap at 420 kg for the 0.5 mm tray; the pod is about 418 kg. | CLOSED | 2026-10-31
ISS-069 | ELECTRICAL, LINING (cables in the cassette gap) | undefined | The 25 mm gap inside each lining cassette is both the acoustic gap and the spare cable path (voice cockpit, lights). A cable or box fixed to both the cassette and the frame would bridge the floating cassette and leak sound. | The sound and air check in PR #11, cable path and sound notes; requirements.md REQ-VCK-03. | Design rule (D-26): cables clip only to the cassette, never across the gap to the frame. Show it on the wiring drawing, with slack and soft grommets wherever a cable has to leave the cassette. | ELECTRICAL engineer | PM | Routing rule on the wiring drawing and in the joint register. | DECIDED | 2026-10-31
ISS-070 | AIR, FRONT (silencer boxes) | decision | D-27 moved the silencers out of the ceiling into separate boxes, and asked where they sit. | decision-log.md D-27, D-33, D-36, D-51, D-59; PR #11 report section 7b. PR #26 sections 7d and 7e. | Decided (D-60 and D-61, replacing the placement of D-51 and D-59): one cartridge part for both paths, 173 x 314 x 1750 mm, two 80 mm passages between three 50 mm layers in a 2 mm aluminium casing; the supply cartridge stands in the 217 x 360 x 2105 air column (on skeleton P04) and the exhaust cartridge lies along the 360 x 220 soffit, both serviced from inside, and a cartridge may split in two with a sealed slip joint (D-59). Draw them there, with the outside unchanged and every part at 20 kg or less. | Air Engineer; CEILING Engineer (column, soffit); FRONT Engineer (riser and fan pair in DR) | PM | Cartridges, fan boxes, column, soffit and intake riser drawn, with the free area and noise checked (CAD fit, ISS-078). | DECIDED | 2026-10-31
ISS-071 | CEILING, ELECTRICAL (cable path across the roof) | undefined | D-27's 53 mm ceiling had no 25 mm air gap, so the voice cockpit and light cables couldn't use the ceiling as the cable path that REQ-VCK-03 first assumed. D-42 puts the ceiling back on the 81 mm stack with the gap. | decision-log.md D-27; requirements.md REQ-VCK-03, REQ-BLD-02. | Decided (D-41, D-42): the ceiling takes the wall stack with its 25 mm gap; light and sensor cables run in it, clipped to the cassette only, entering at the back-wall top corner and never crossing the roof frame. | ELECTRICAL engineer | PM | D-41 logged; the wiring drawing shows the route. | DECIDED | 2026-10-31
ISS-072 | AIR (PLAN.md fresh-air line) | conflict | PLAN.md on main still says fan noise is 25 dB(A) or less at full flow (70 l/s). D-33 sets 25 dB(A) or less at the 53 l/s normal flow, and about 31 dB(A) at the 70 l/s boost. | PLAN.md scorecard and Target 4; decision-log.md D-33. | Done: PLAN.md carries D-33's numbers since PR #13 (merged). | PM | PM | PLAN.md on main matches D-33 (PR #13). | CLOSED | 2026-10-31
ISS-073 | AIR, FRONT (silencer absorption) | undefined | The cartridges (D-61: two 80 mm passages between three 50 mm layers) use published data for their layers, but their attenuation (Sabine formula, derated) and the breakout through the 2 mm casing are calculated, not measured: 25.3 dB(A) at 53 l/s and 29.7 at the 65 l/s boost against D-52's 26 and 30 (D-62); on AIR's build with BASE's intake, 25.2 and 29.6 dB(A), the boost reaching 66.2 l/s at 30 dB(A) (calculation, PR #115). D-121 corrects them to 25.4 to 25.6 and 29.8 to 30.0 dB(A), the boost reaching 65.0 to 65.5 l/s at 30 dB(A), with the fan box linings only where they fit (the calculation had lined every wall): at the limit (ISS-090). D-124's 3 mm fan box casings then give about 29.5 dB(A) at 65 l/s and a 66.6 l/s reach. The air report then gives 25.1 and 29.6 dB(A), the boost reaching 66.3 l/s (PR #199). With DR as built (PR #105) the boost came to about 37.8 dB(A) at 65 l/s (33.3 at 53); D-130's sealed intake boot and gaskets give 25.0 and 29.5, the boost reaching 66.7 l/s (calculation, the Air Engineer); the air report then gives 25.2 and 29.6, the boost reaching 66.2 l/s (PR #254). | decision-log.md D-38, D-51, D-52; PR #11 report sections 7b and 10. PR #26 section 7d. | Build a mock-up of one cartridge with its fans at the factory and measure the insertion loss, the breakout into the pod and the fan noise at 53 and 65 l/s (the same rig as the fan-sample test, ISS-077). | Hardware Engineer; factory (mock-up) | PM | Mock-up result recorded; the PM logs whether D-52 and D-61 hold. | OPEN | 2026-10-31
ISS-074 | FRONT (glass product) | hold | HOLD (D-56): the 4+4 laminated glass product isn't named. The build is decided (D-27, D-46): toughened, heat-soaked panes, 8.76 mm, grey, frameless as in v1. None of the acoustic laminates cited in PR #11 is shown offered with toughened panes. | Hardware selection, summary (Front) and supplier question 5. | Put the question on the factory's list (agents don't contact suppliers): a grey 4+4 laminate of toughened, heat-soaked panes, with an acoustic interlayer if it comes toughened, its Rw, the heat-soak certificate, edge work and hole data for the hinges, lock and pull. Match the tint on the sample. | Hardware Engineer (question list); factory (supplier answer) | PM | Product named with its data in the hardware selection and fitted on the door sample; the PM lifts the HOLD. | OPEN | 2026-10-31
ISS-075 | LINING (felt emission certificate) | hold | HOLD (D-56): the factory's 9 mm PET felt (D-31) has no emission certificate (PLAN Target 6, REQ-MAT-01). | Hardware selection, summary (Felt) and supplier question 7; PR #11 report section 9. | Ask through the factory's list for the felt's emission certificate and its ISO 354 data from 100 Hz on a 25 mm gap. If it has none, use a certified felt such as Autex Cube (D-31). | Hardware Engineer; factory (supplier answer) | PM | Certificate on file with its standard and number; the PM lifts the HOLD. | OPEN | 2026-10-31
ISS-076 | LINING (cassette clips, ceiling catch) | hold | HOLD (D-56): the captive clip and the ceiling safety catch (D-47) have no part with a rated load. Needed per clip (calculation, safety factor 3 as an assumption): 7.7 kg in shear for a wall cassette (4 clips), 8.0 kg in pull-out for a ceiling cassette (6 clips), and 48 kg for each of 2 catch lanyards. The candidate, Häfele KEKU EH, has no stated rating basis, pull-out rating, captive lock or fixing to a 0.5 mm steel tray. | Hardware selection A8, supplier question 10 and sample test 4. | Name a clip and a catch with their rated loads and their fixing to the tray return; pull-test the clip on a real cassette return and drop-test the catch. D-81 drops the rails, so the clips carry the cassettes alone, at about 40 g a clip (assumption) until one is named. | Hardware Engineer; Layout Engineer (clip study) | PM | Clip and catch SKUs with rated loads in the hardware selection, and the pull and drop tests recorded; the PM lifts the HOLD. | OPEN | 2026-10-31
ISS-077 | AIR (12 V fan sound) | hold | HOLD (D-56): the 12 V fans (D-51) have no published octave data. The calculation reads the maker's 41.3 dB(A) as sound pressure at 1 m and uses the TD-500's spectrum shape, and the fan curve is a straight line between two maker points. A 5 dB tone at 250 Hz would give 29.0 dB(A) at 53 l/s, over the 26 dB(A) limit (D-52). | PR #11 report section 7b (risks) and section 10; hardware selection, sample test 3 and supplier question 6. | Fan-sample test: one fan pair in its lined box on a cartridge, measuring flow against pressure, octave sound power at 53 l/s and at boost (65-70 l/s), and any tone at 125-250 Hz; ask the maker for octave data. If it tests loud: 1 mm steel casings (about +13 kg for about 1 dB) or a third fan per path running slower. | Hardware Engineer (air); factory (sample) | PM | Test result recorded against D-52's limits; the PM logs whether the fans stand and lifts the HOLD. | OPEN | 2026-10-31
ISS-078 | AIR, FRONT, CEILING, BASE (CAD fit and recirculation) | hold | HOLD (D-56): the D-60 layout as sized (D-61) isn't checked in CAD: the air column, the soffit and the cartridges in them, the intake riser and the supply fan pair high in DR, the opening from DR into the column, the mesh band piece under DR with its closing plate (D-62), and the roof slot. Nothing checks yet that exhaust air isn't drawn back into the intake. | PR #26 sections 7e to 7i; the Reviewer finding on PR #26 (P04's band closed the old intake); decision-log.md D-58 to D-62. | Model them on skeleton P04 (the sample package's H07): CEILING the column, soffit and roof slot; FRONT the riser, the fan pair and DR's underside; BASE the mesh band piece, the block's support and the closing plate. Check the clearances, the service path into the pod and the airtight ducts. On the fan sample, check recirculation: at boost, the inlet stays within 0.5 K of the room (D-58). | CEILING Engineer; FRONT Engineer; BASE Engineer; Air Engineer; factory (fan sample) | PM | Fit and service path shown in the CAD with a clearance check, and the fan sample showing the inlet within 0.5 K of the room at boost; the PM lifts the HOLD. | OPEN | 2026-10-31
ISS-079 | POD (other groups' numbers) | conflict | Files outside the control pack still carry numbers the decision log has replaced: the layout study's B1 list gives the decor 230-235 mm (D-49: 205) and the back and ceiling panels 1169 wide (D-55: about 1207, linings 1169); PR #11's part weights use 1500 x 1145 side panels and 1212 x 1500 ceiling halves (skeleton P03: 1495 x 1145 and 1207 x 1495, slightly smaller, so those weights are on the safe side); the hardware selection fixes the ceiling safety catch to a 20 x 100 ceiling member (D-42: 20 x 40). The air report (PRs #26 and #30) draws the roof slot at Y -630 to -336; D-61 moved it 10 mm back, to Y -620 to -326. | layout-study/report.md; acoustics-air/report.md section 1; hardware/selection.md A8; skeleton BUILD-RECORD.md. | Each owner corrects its file or notes the decision that replaces the number. The decision log wins meanwhile. The layout study's update to tonight's rulings is ISS-081. | Layout Engineer; Hardware Engineer | PM | The files agree with D-42, D-49 and D-55, or carry a note pointing to them. | OPEN | 2026-10-31
ISS-080 | POD (weight) | conflict | The layout study's live count (PR #42) was 422.8 kg as shipped, 2.8 kg over the 420 kg cap, with D-81's savings and the voice kit's 4.0 kg reserve outside the cap. D-85 adopts five more (budgets for the light shelf and ledge, 1.0 mm inner wall studs, 2 back-panel studs, a hollow kick strip, poplar-core floor ply if BASE's tests pass): 412.2 kg as shipped, 7.8 kg under the cap and 2.2 kg over the 410 kg target, with the ceiling's cross members kept at 1.2 mm (calculation, PR #50). Re-run on the updated skeleton P04 with D-86's glide load blocks and D-87's joined air pieces: 412.5 kg as shipped, 7.5 kg under the cap and 2.5 kg over the target (calculation, PR #61). With ELECTRICAL's P01 parts (4.94 kg against a 3.05 kg allowance): 415.4 kg as shipped, 4.6 kg under the cap and 5.4 kg over the target (calculation, PR #66). With the LED strip counted once: 415.2 kg as shipped, 4.8 kg under the cap and 5.2 kg over the target (calculation, PR #68). With BASE's sample and FRONT's fixed glass read from their merged parts lists: 412.9 kg as shipped, 7.1 kg under the cap and 2.9 kg over the target (calculation, PRs #124, #126). With the joints' made hardware and BASE's follow-ups: 413.4 kg as shipped, 6.6 kg under the cap and 3.4 kg over the target (calculation, PR #141). With WALL's four side panels and their cassettes from their merged lists: 412.7 kg as shipped, 7.3 kg under the cap and 2.7 kg over the target (calculation, PR #154). With CEILING's panels and cassettes from their me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 | PR #11 report, result 3 (418 kg, calculation); the layout study's own list as recounted by the Layout Engineer (427 kg, calculation, not yet in a merged file); the PM's ruling of 2026-10-31 (D-54). the air report section 7f (+11.8 kg, PRs #26 and #30); the WALL and BASE rulings (+3.4 kg, -12.6 kg); decision-log.md D-71. The P04 roll-up, layout-study/weight-rollup.md (PR #38); decision-log.md D-81. The savings ranking, PR #50; decision-log.md D-85. | The wall sample settles it (D-54, D-81): weigh a real cassette with its clips and bond lines, and confirm the 24 kg/m3 fill in T02. BASE checks the 1.5 mm band wall and runs the caster and 1000 N edge tests for the poplar-core ply (D-85). Then recount from the master BOM (v2/04-BOM/). | Layout Engineer; Hardware Engineer; factory (wall sample) | PM | The wall sample's weights and fill comparison recorded, the pod recounted from one current parts list, and the weight against the cap logged by the PM; the control pack updated to it (PLAN.md by its owner). | OPEN | 2026-10-31
ISS-081 | POD, PACKAGING (layout study update) | conflict | The layout study (PR #20) predates tonight's rulings, so its 426.7 kg and part list aren't current: it still carries PR #11's two cartridges and riser (45.0 kg, pieces up to 17.7 kg) instead of D-61's 61.8 kg of air parts (column, soffit, one cartridge part per path, fan boxes, intake riser); ceiling cassettes about 1414 long instead of 1045, in the 1051 mm space behind the soffit (D-69, D-77); 81 mm stacks and 1207 or 1169 panel widths instead of skeleton P04's 84 mm, 1200.61, 1492.74 x 1142.74 and 1118.61 (D-66); the old corner tubes instead of 40 x 40 (+1.3 kg, D-63); trays without lips (+3.4 kg, D-69); 15 mm floor panels instead of 9 mm plywood (-12.6 kg, D-72); and a seal mat with no mass instead of the 3 mm foam (+2.1 kg, D-76). Its 20 kg-per-piece check can't see the new air parts. Update: PR #38 recounted the weight on skeleton P04 (436.3 kg) with tonight's CAD masses and rulings; the pallets and the assembly steps are still on P03. | The air report sections 7e and 7f (air parts 61.8 kg, cassettes 1051; PRs #26 and #30); skeleton P04 build record (PR #24); joints register (PR #23); the Mechanical Checker's F-010 note; decision-log.md D-61, D-63, D-66, D-69, D-71, D-72. | Done for the weight in PR #38. Still to do: the pallets and the assembly steps on P04, with every new piece checked against 20 kg (D-03) and the pallets (D-04). | Layout Engineer | PM | The layout study's pallets and assembly steps on P04, matching D-61, D-63, D-66, D-69, D-72 and D-76; the control pack's REQ-LGT-01 and ISS-080 follow its numbers. | OPEN | 2026-10-31
ISS-082 | CEILING, POD (US rules: sprinklers) | hold | HOLD (US rules phase, D-14): the pod's floor is about 45.7 sq ft (4.25 m2, calculation C1), over the usual 24 sq ft size below which pods may go without sprinklers, so a US version needs a sprinkler strategy: a head inside, a roof that opens on an alarm, or a listed alternative. Which code sets the 24 sq ft (likely NFPA 13) and its exact wording are unverified. | The go-to-market research of 2026-10-31 (private, kept out of this repo); footprint 2.5 x 1.7 m; ISS-052 (the reserved ceiling zone); D-14. | In the US rules phase, read the code text and its local adoption, and pick the strategy; until then keep ISS-052's ceiling zone and a fire-alarm wiring point free. | Product Manager | PM | The code text checked and the sprinkler strategy logged by the PM with its source; ISS-052's zone drawn to suit. | OPEN | 2026-10-31
ISS-083 | ELECTRICAL, POD (US rules: UL 962) | hold | HOLD (US rules phase, D-14): UL 962 (household and commercial furnishings) now covers booths and pods with electrical parts, so a US version with its lights, fans, outlets and 12 V bus will likely need a UL 962 listing. Which edition and clauses apply, and what they ask of the structure, wiring and materials, are unverified. | The go-to-market research of 2026-10-31 (private, kept out of this repo); D-10 (12 V bus, mains to the outlets only); D-14. | In the US rules phase, read UL 962's current edition and list what it asks of Spaceship (wiring, the 12 V supply, materials, stability, marking); keep the 12 V bus and mains only at the outlets, so the change stays on the supply side. | Product Manager | PM | UL 962's edition and clauses checked, and the US plan for them (listing path and any design changes) logged by the PM. | OPEN | 2026-10-31
ISS-084 | BASE, FRONT (US rules: ADA threshold) | decision | US rules phase, flagged by the go-to-market research: the 20 mm threshold (D-18) was over the US accessibility limit for a door threshold, 1/2 inch (13 mm), with any part above 1/4 inch (6.4 mm) bevelled no steeper than 1:2 (2010 ADA Standards 404.2.5 and 303.3; unverified until the text is read). Designed in (D-72): a 13 mm aluminium profile with a 6 mm upright and a 1:2 bevel, on a floor of 9 mm plywood over a 3 mm foam mat (D-76), top at 12 mm. | The go-to-market research of 2026-10-31 (private, kept out of this repo); the BASE Engineer's check; decision-log.md D-72; ISS-053. | BASE draws the threshold detail; FRONT moves the kick strip's bottom to Z 20 to keep its 7 mm gap; the skeleton takes floor_t 9 and thresh_h 13. In the US rules phase, check the profile against the ADA text. | Product Manager; BASE Engineer (threshold detail) | PM | Threshold detail drawn at 13 mm with the bevel, and the ADA text checked in the US rules phase; the PM logs it. Met (the PM, 2026-11-01): D-132 takes out the floor and the threshold, so there is no step at the door. | CLOSED | 2026-10-31
ISS-085 | BASE (floor mat) | hold | HOLD (D-72, D-76): the firm 3 mm mat under the 9 mm plywood floor panels has no named product. It is a closed-cell foam (cross-linked PE or EPDM), about 200 kg/m3 (assumption), about 2.1 kg under the whole floor; a solid rubber mat would weigh about 13.6 kg and cancel the 12.6 kg the thinner panels save. It has to be firm, because a thinner panel on a soft mat feels springy under chair castors (BASE Engineer). | The BASE Engineer's floor check and mat correction, and the PM's rulings in the BASE group, 2026-10-31; decision-log.md D-72, D-76. | Name a foam with its data (thickness, density, compression, fire class, emissions) and test it on a sample: a chair castor rolled over a panel edge, and 1000 N at a panel edge with 1 mm or less deflection (D-76, assumption until tested). The same tests decide the poplar-core 9 mm ply (D-85). D-86 adopts the poplar-core ply with a hard face veneer; the sample tests a panel edge and the half-lap seam. | BASE Engineer | PM | Foam product named with its data in the BASE parts list, and the castor and 1000 N edge tests recorded; the PM lifts the HOLD. Met (the PM, 2026-11-01): D-132 takes the floor out, so there is no mat to name or test. | CLOSED | 2026-10-31
ISS-086 | POD (skeleton update) | finding | Several rulings wait on the next skeleton update, after the shared drawing start: floor_t 9 and thresh_h 13 (D-72), the fixed glass free edge parallel to the door at 4.0 mm (D-74, F-014), and the bolt-pattern rule with the bay parameters for every bolted edge between teams, starting with base_bolt_edge, n_base_bolt and the spigot inset for wall to band (D-75). Until then, skeleton P04 carries the old floor, threshold and glass edge, and WALL and BASE can't merge their bolt patterns. | PM rulings in the sample-set, BASE and WALL groups, 2026-10-31; the Mechanical Checker's F-014 and the wall-to-band pitch finding; decision-log.md D-72, D-74, D-75. Skeleton update in place, PR #58 (merged 99424fd). | Done in the skeleton: PR #58 updated P04 in place (two versions of the same cloud file, so linked parts aren't cut): floor_t 9 and thresh_h 13 (the kick strip Z 20 to 105), glass_gap 4.0 for the fixed glass edge (F-014), the 220 mm bolt rule and spigot inset on every edge, and the closing seams with a 5.5 mm gap and 1198.99 mm frames. Still to do: WALL and BASE relink their bolt patterns to it, the Mechanical Checker's run shows them lining up, and the PM rules the wall-to-ceiling bolt counts (4 per side wall, 3 per back panel, WALL's assumption). D-132 (2026-11-01) then takes out the floor and the threshold, so floor_t and thresh_h go. | Fusion Engineer 2; WALL Engineer (bay rules) | PM | The next skeleton revision merged with D-132's no floor and no threshold (in place of D-72's floor_t 9 and thresh_h 13), D-74's edge and D-75's bay parameters, and the WALL and BASE bolt patterns linked to them; the Mechanical Checker's run shows them lining up. | DECIDED | 2026-10-31
ISS-087 | FRONT (DR mass) | finding | D-108 sets DR at 19.0 kg or less as shipped with its fitted glass channels. FRONT's latest estimate meets it: DR about 18.3 kg, 18.9 kg as shipped with its channels (ACP corrected to 3.5 kg/m2 by D-107, two redundant tubes dropped, the band behind the soffit kept), after D-106's lightening had left it at about 19.4. The target is met on the estimate; this stays open only until DR's CAD confirms it. | D-106, D-107, D-108; FRONT's estimate passed on by the Lead; the FAI plan's K-D02; Reviewer 6's check of main 02cfe83. Closed on FRONT's CAD: v2/01-CAD-Native/front/BUILD-RECORD.md (PR #105); Reviewer 6's #105 review. | FRONT gives DR's mass as shipped with its fitted channels from its CAD, in its parts list. | FRONT engineer | PM | DR's CAD mass as shipped with its fitted glass channels is 19.0 kg or less, in FRONT's parts list, or the PM logs a new target. Met (the PM, 2026-11-01): DR's CAD mass is 18.32 kg, 18.87 kg as shipped with its right and diagonal glass channels (FRONT's build record, PR #105), under D-108's 19.0 kg. | CLOSED | 2026-11-01
ISS-088 | CEILING (lining fill density) | finding | CEILING's parts list (PR #32) gives the ceiling cassette's three fill bays (513301 to 513303) as PET fill 25 kg/m3, with masses to match. D-81 set the pod's fill at 24 kg/m3, the grade the wall sample's T02 tests, and WALL's lists use 24. The roll-up already scales CEILING's fill to 24 (PR #158), so the pod's weight is right; only the list's material and masses still say 25, about 0.09 kg more per pod (calculation). | D-81; CEILING's parts list 410000 on main (c72ea57); the roll-up's note in PR #158; the FAI plan's K-P05 and K-L09. | CEILING sets the fill bays to 24 kg/m3 in its parts list and its model, and re-exports the masses. | CEILING engineer | PM | CEILING's parts list gives the ceiling fill as 24 kg/m3 with masses to match, or the PM logs a different grade for the ceiling. | OPEN | 2026-11-01
ISS-089 | AIR (exhaust short-circuit) | finding | In AIR's exhaust fan box the fans' discharge has a path back to their own intake inside the soffit, so part of the exhaust flow short-circuits. D-121 moves the exhaust fans to the top on a sealed bulkhead, which closes that path; the change comes in CEILING's AIR follow-up, not merged yet. | D-121; the Air Engineer's fan box layout; AIR P01 (PR #91); the air report models the exhaust fans at the top on the sealed bulkhead (PR #199). | CEILING's AIR follow-up puts the exhaust fans at the top on a sealed bulkhead. | CEILING engineer (builds AIR, D-80) | PM | CEILING's AIR follow-up merges with the exhaust fans on the sealed bulkhead, and the air report shows no short-circuit path. | OPEN | 2026-11-01
ISS-090 | AIR (fan noise margin) | finding | D-121 corrects the fan noise to 25.4 to 25.6 dB(A) at 53 l/s and 29.8 to 30.0 at 65 l/s, with the boost reaching 65.0 to 65.5 l/s at 30 dB(A): the boost sits at D-52's 30 dB(A) limit with no margin, because only about a third of the lining the calculation assumed fits in the fan boxes. D-124 then takes both fan box casings to 3 mm: about 29.5 dB(A) at 65 l/s and a 66.6 l/s reach (calculation, the Air Engineer), about 0.5 dB(A) of margin, still a calculation until the fan sample measures it. The air report then gives 25.1 dB(A) at 53 l/s and 29.6 at 65 l/s, the boost reaching 66.3 l/s at 30 dB(A) (PR #199): 0.4 dB(A) of margin, still a calculation until the fan sample measures it; with 2 mm casings it would be 30.1 at 65 l/s. With DR as built (PR #105) the fans' inlet noise filled DR's bare cavity, so the boost came to about 37.8 dB(A) at 65 l/s (33.3 at 53), and the cartridges' open slide-out gaps cost about 5 dB more; D-130's sealed intake boot and gaskets give 29.5 dB(A) at 65 l/s, a 66.7 l/s reach at 30 dB(A) and 25.0 at 53: 0.5 dB(A) of margin, still a calculation until the fan sample measures it (the Air Engineer, D-130). The air report then gives 25.2 dB(A) at 53 l/s and 29.6 at 65 l/s, the boost reaching 66.2 l/s at 30 dB(A) (PR #254): 0.4 dB(A) of margin, still a calculation until the fan sample measures it. | D-121; D-52; REQ-AIR-02, REQ-AIR-05; the FAI plan's F-04; the fan sample's T04. | The fan sample measures the noise at 53 and 65 l/s at seated ear height; if the boost goes over 30 dB(A), the PM rules on the fix. | CEILING engineer (builds AIR, D-80) | PM | The fan sample measures 26 dB(A) or less at 53 l/s and 30 dB(A) or less at 65 l/s, or the PM logs a new limit or flow. | OPEN | 2026-11-01
ISS-091 | WALL, CEILING, FRONT (ACP fire class) | finding | Parked risk, for the certification phase later (D-134; no work now): the 3 mm ACP has a plastic core with no published fire class. A fire-rated, mineral-core ACP comes in 4 to 5 mm and adds about 45 to 55 kg (assumption: the US review's estimate; the hardware selection said about 30 kg), and it takes DR to about 23.6 kg (assumption: the US review's estimate), over D-108's 19.0 kg target and D-03's 20 kg limit. So it is a design change, not just a test. | The design review the PM relayed, 2026-11-01; the US review's figures, relayed by the PM the same day; the hardware selection; D-134 (certification work later). | In the certification phase: name the skins' fire class; if they need the mineral-core sheet, plan it as a design change: the 84 mm stack, the bond, DR's weight back under 20 kg, and the pod's weight against the cap. No work now. | PM | PM | The certification phase names the skins' fire class and the PM rules on the sheet. | OPEN | 2026-11-01
