autonomous-ai/spaceship/v2/02-Drawings/joints/831001_P01_HARDWARE-LOCATING-SPIGOT_DWG.pdf

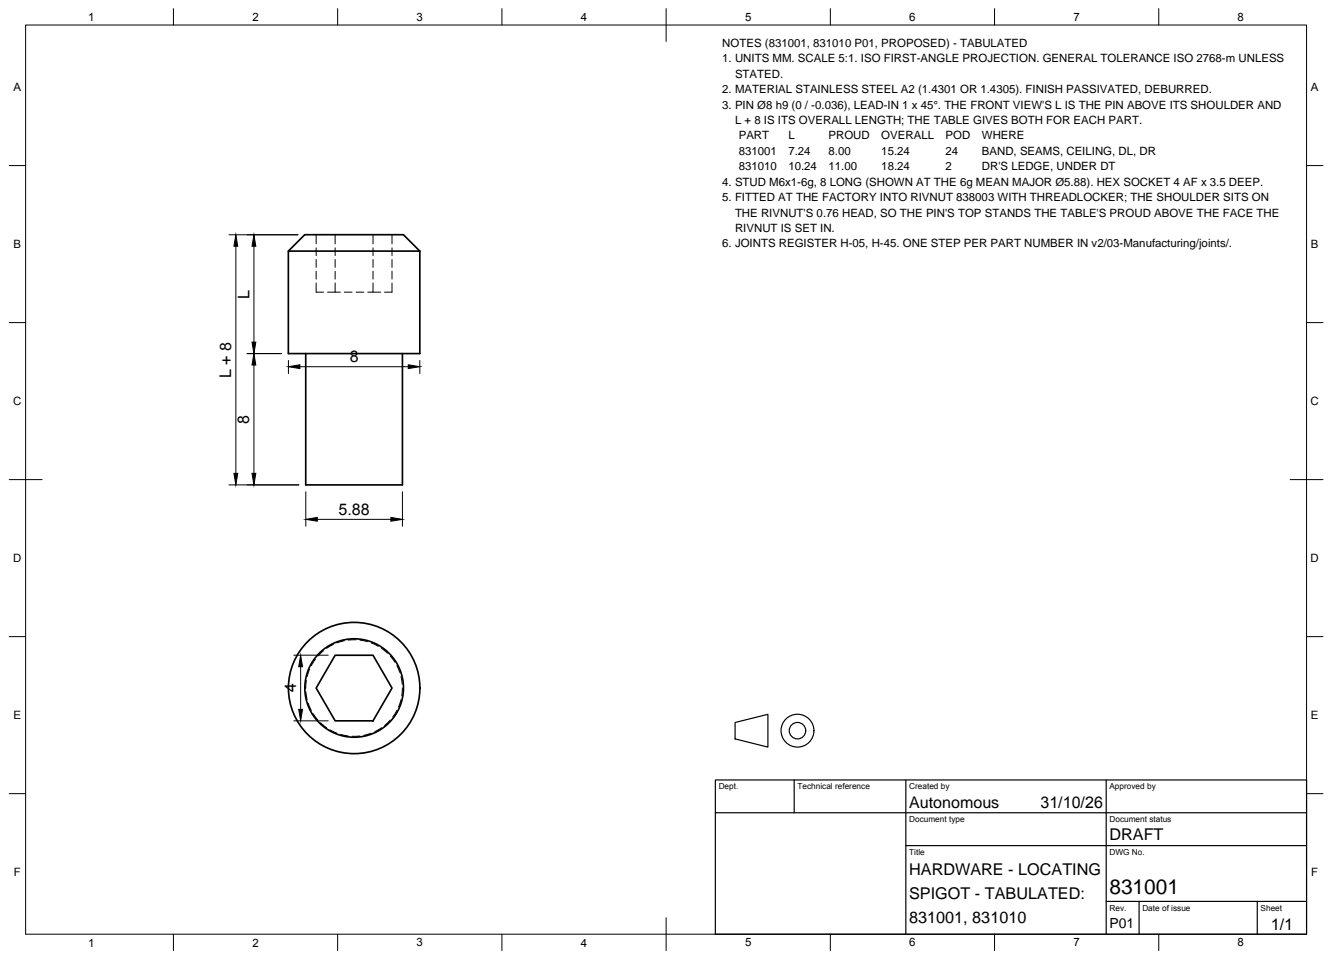
[picture p112: page 1]
Title; DWG No.; Rev.; Date of issue; Sheet; HARDWARE - LOCATING SPIGOT - TABULATED: 831001, 831010; PART; PROUD OVERALL POD WHERE; BAND, SEAMS, CEILING, DL, DR; DR'S LEDGE, UNDER DT

NOTES (831001, 831010 P01, PROPOSED) - TABULATED
1. UNITS MM. SCALE 5:1. ISO FIRST-ANGLE PROJECTION. GENERAL TOLERANCE ISO 2768-m UNLESS
STATED.
2. MATERIAL STAINLESS STEEL A2 (1.4301 OR 1.4305). FINISH PASSIVATED, DEBURRED.
3. PIN Ø8 h9 (0 / -0.036), LEAD-IN 1 x 45°. THE FRONT VIEW'S L IS THE PIN ABOVE ITS SHOULDER AND
L + 8 IS ITS OVERALL LENGTH; THE TABLE GIVES BOTH FOR EACH PART.
4. STUD M6x1-6g, 8 LONG (SHOWN AT THE 6g MEAN MAJOR Ø5.88). HEX SOCKET 4 AF x 3.5 DEEP.
5. FITTED AT THE FACTORY INTO RIVNUT 838003 WITH THREADLOCKER; THE SHOULDER SITS ON
THE RIVNUT'S 0.76 HEAD, SO THE PIN'S TOP STANDS THE TABLE'S PROUD ABOVE THE FACE THE
RIVNUT IS SET IN.
6. JOINTS REGISTER H-05, H-45. ONE STEP PER PART NUMBER IN v2/03-Manufacturing/joints/.

Dept. | Technical reference | Created by Autonomous 31/10/26 | Approved by

Document type | Document status DRAFT
