autonomous-ai/spaceship/sources/v1/drawings/decor-frame-assembly.pdf

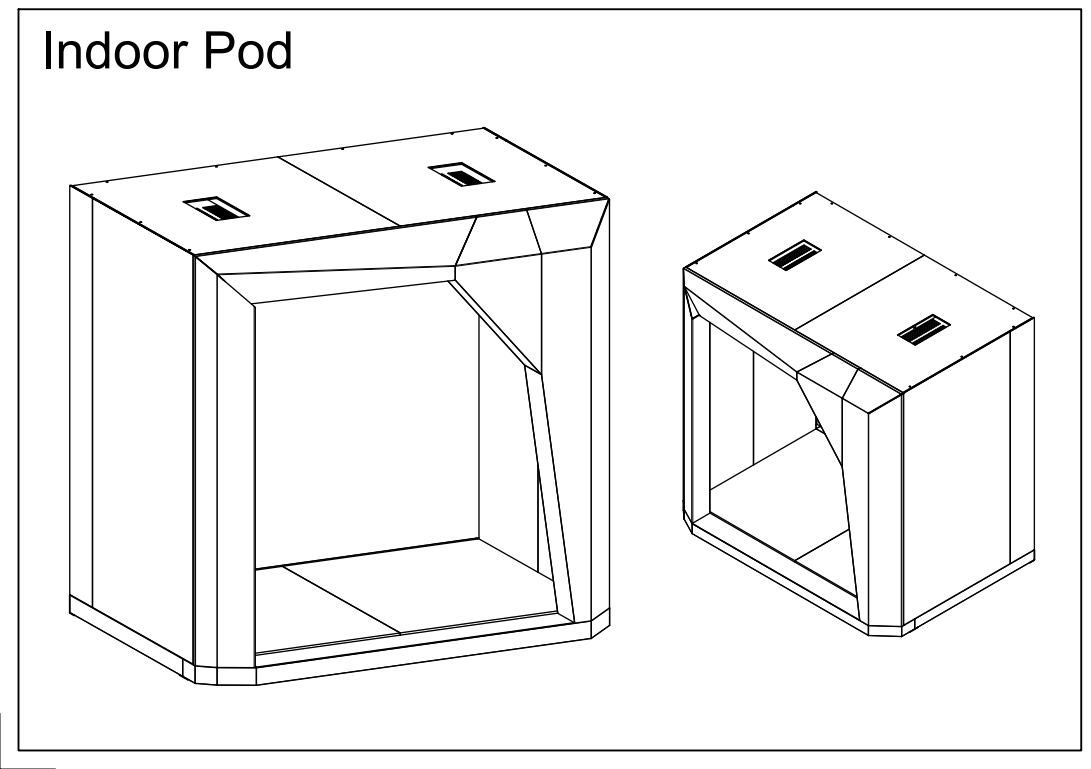
[picture p113: page 1]
Indoor Pod

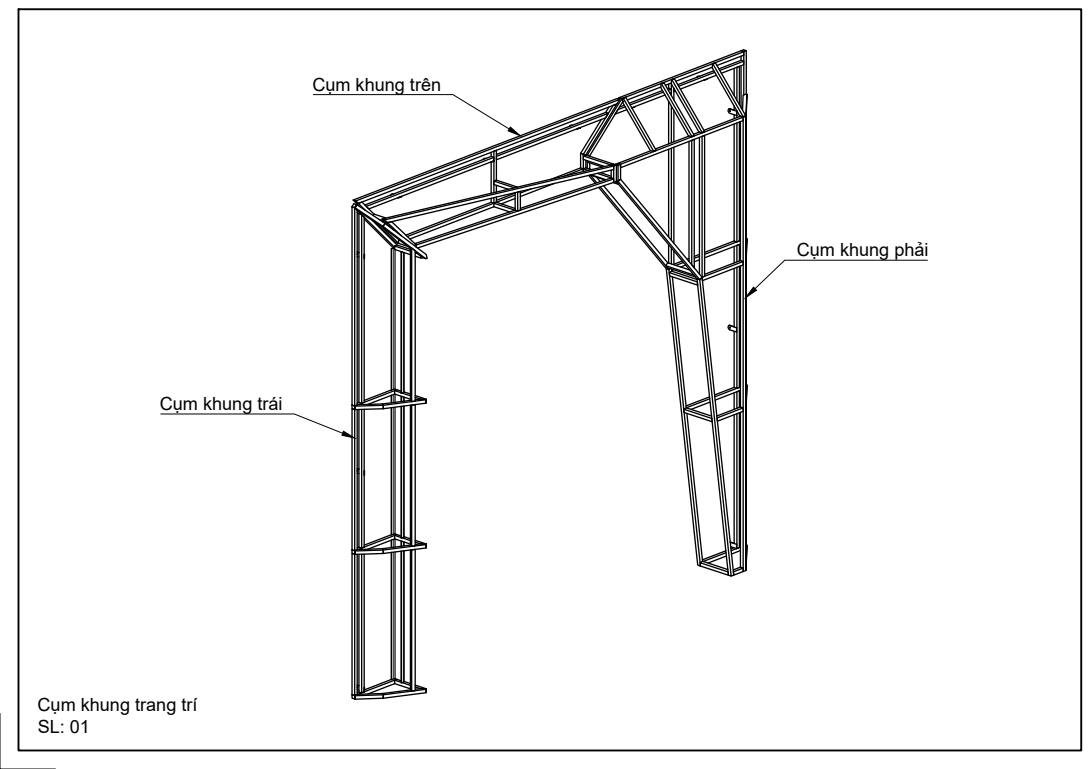
[picture p114: page 2]

Cụm khung trên

Cụm khung phải

Cụm khung trái

Cụm khung trang trí

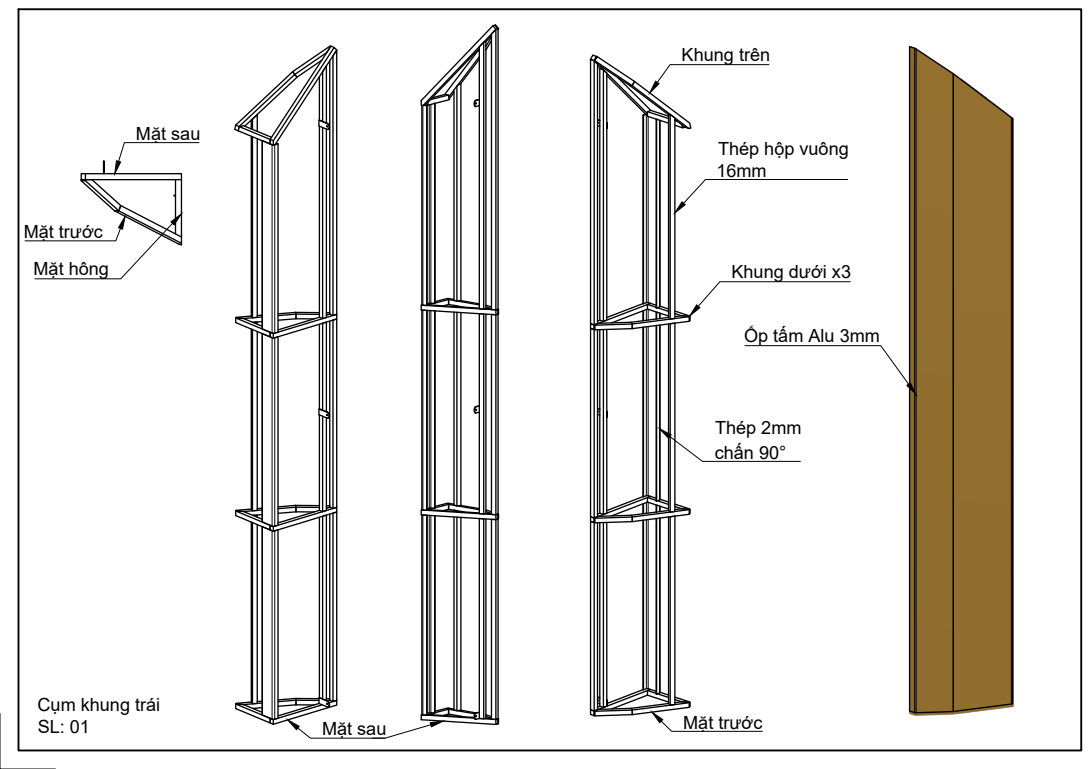
[picture p115: page 3]
Thép 2mm chấn 90°; Khung trên; Khung dưới x3; Mặt sau; Mặt trước; Mặt hông

Thép hộp vuông

Ốp tấm Alu 3mm

Cụm khung trái

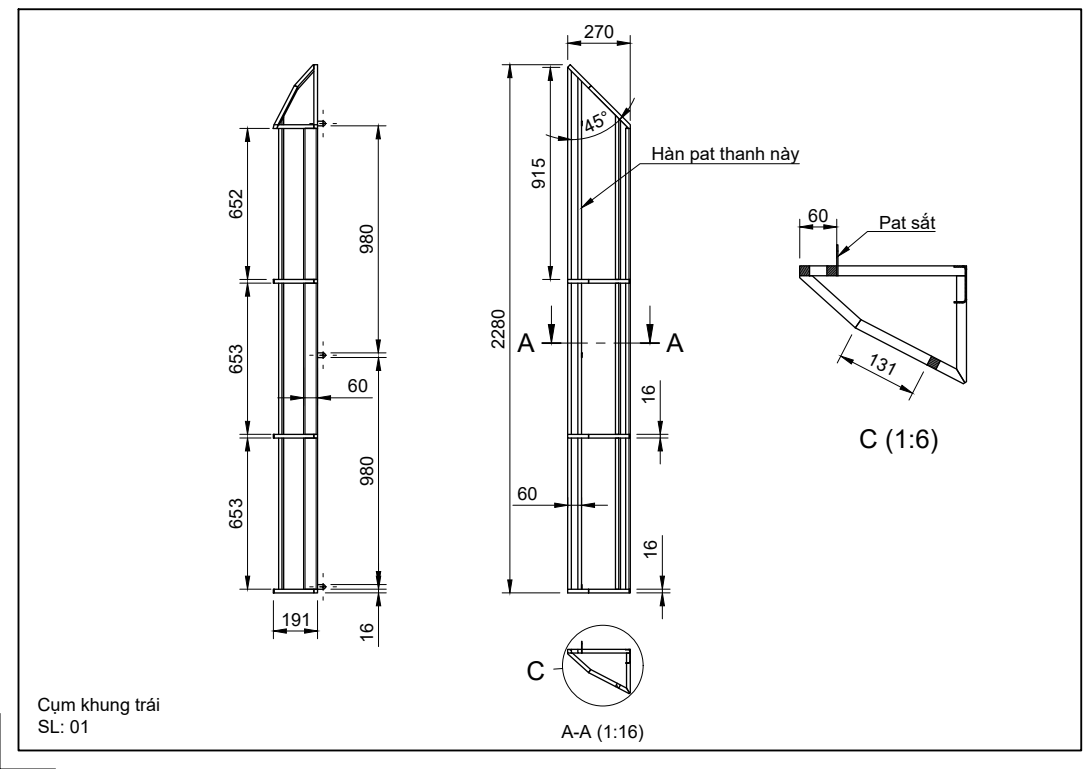
[picture p116: page 4]
Pat sắt 60

Hàn pat thanh này

Cụm khung trái

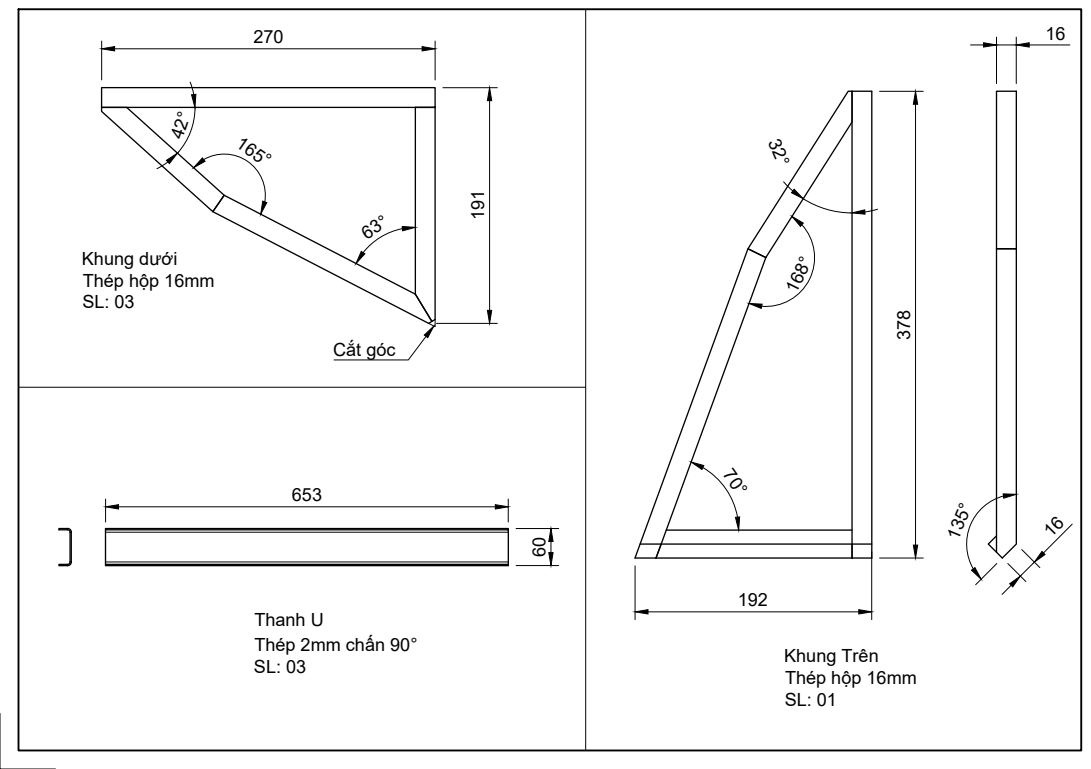
[picture p117: page 5]
Cắt góc; Khung Trên Thép hộp 16mm SL: 01; Khung dưới Thép hộp 16mm SL: 03; Thanh U Thép 2mm chấn 90° SL: 03

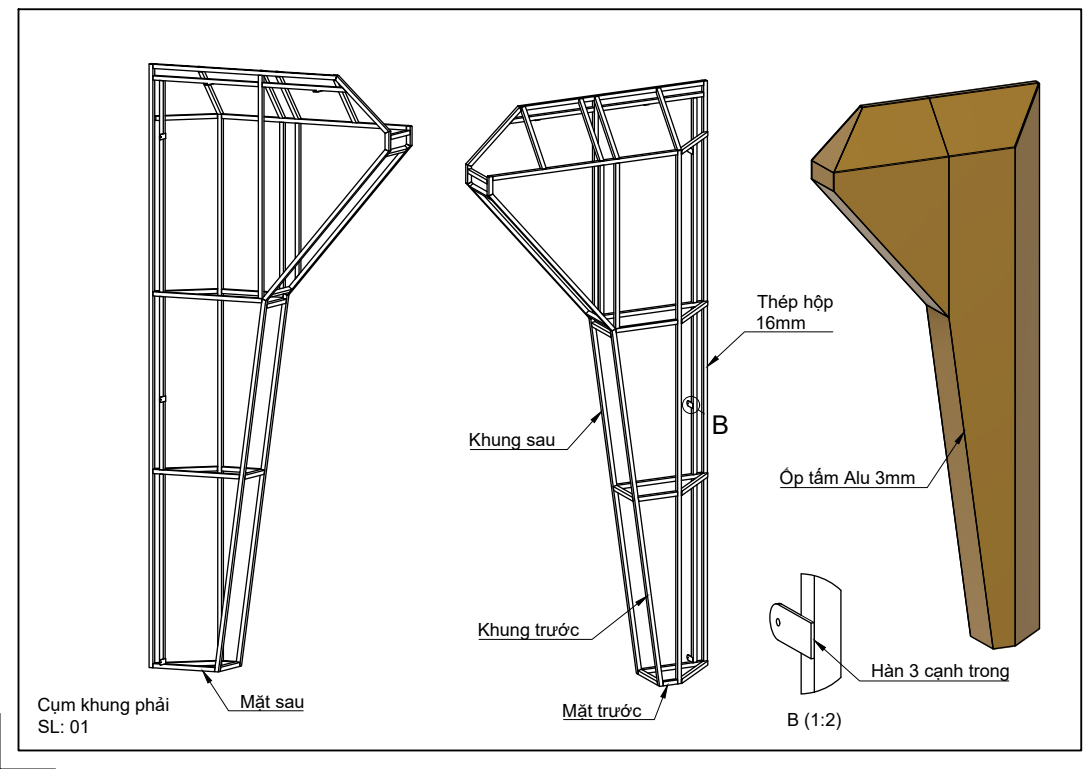
[picture p118: page 6]
Thép hộp; Khung sau; Khung trước; Mặt sau; Mặt trước

Ốp tấm Alu 3mm

Hàn 3 cạnh trong

Cụm khung phải

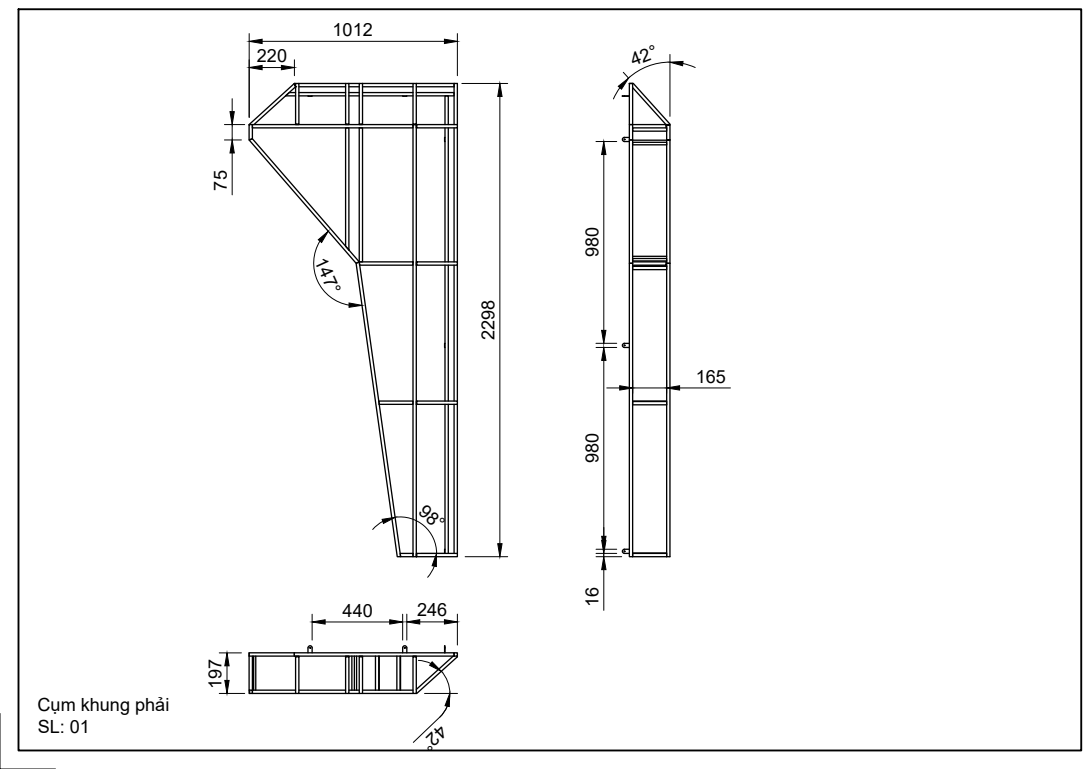
[picture p119: page 7]

Cụm khung phải

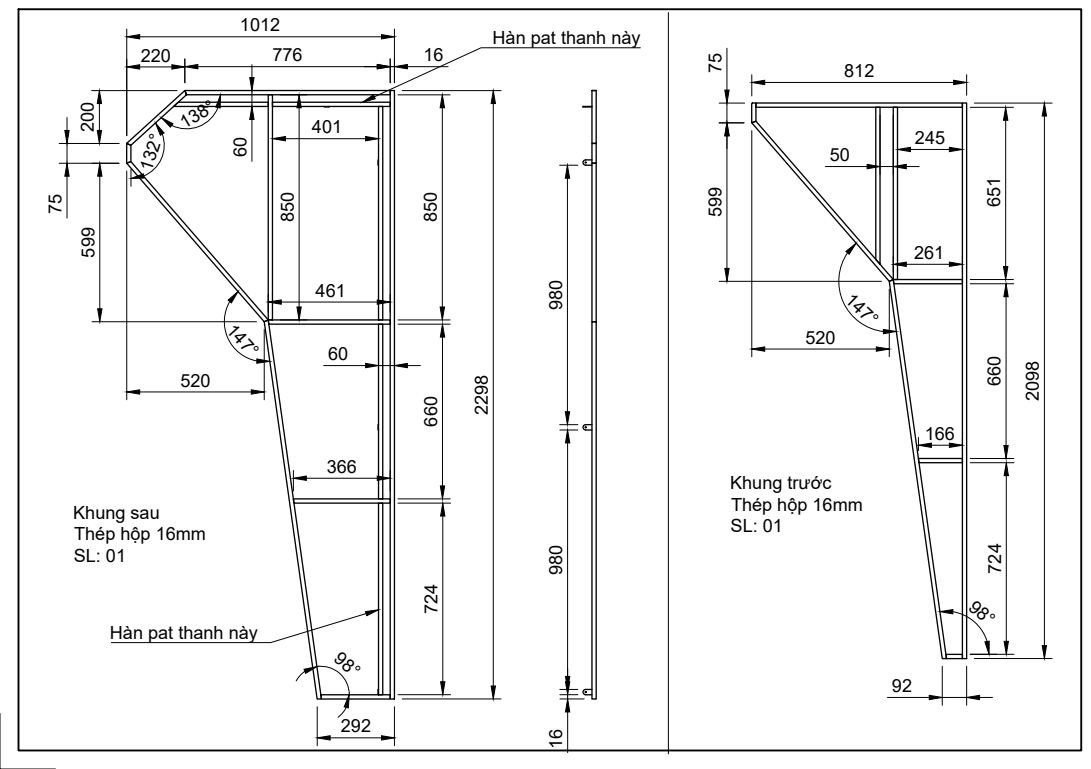
[picture p120: page 8]
Khung sau Thép hộp 16mm SL: 01; Khung trước Thép hộp 16mm SL: 01; Hàn pat thanh này

Hàn pat thanh này 60 132°

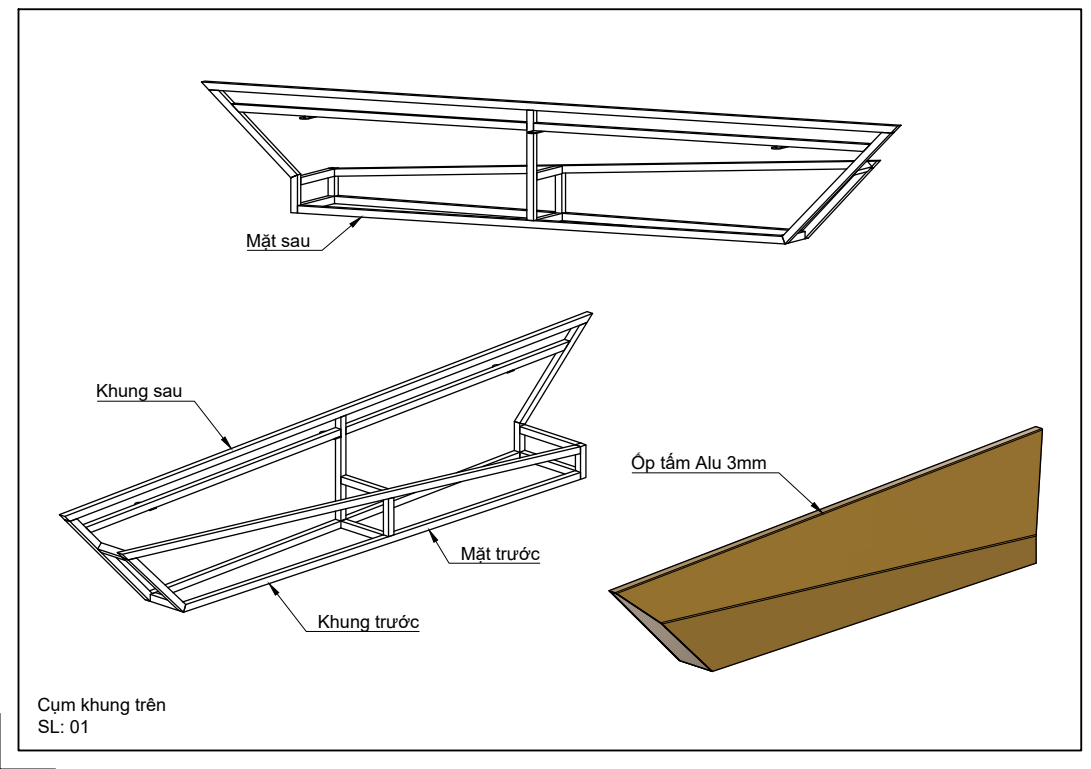
[picture p121: page 9]
Khung sau; Khung trước; Mặt sau; Mặt trước

Ốp tấm Alu 3mm

Cụm khung trên

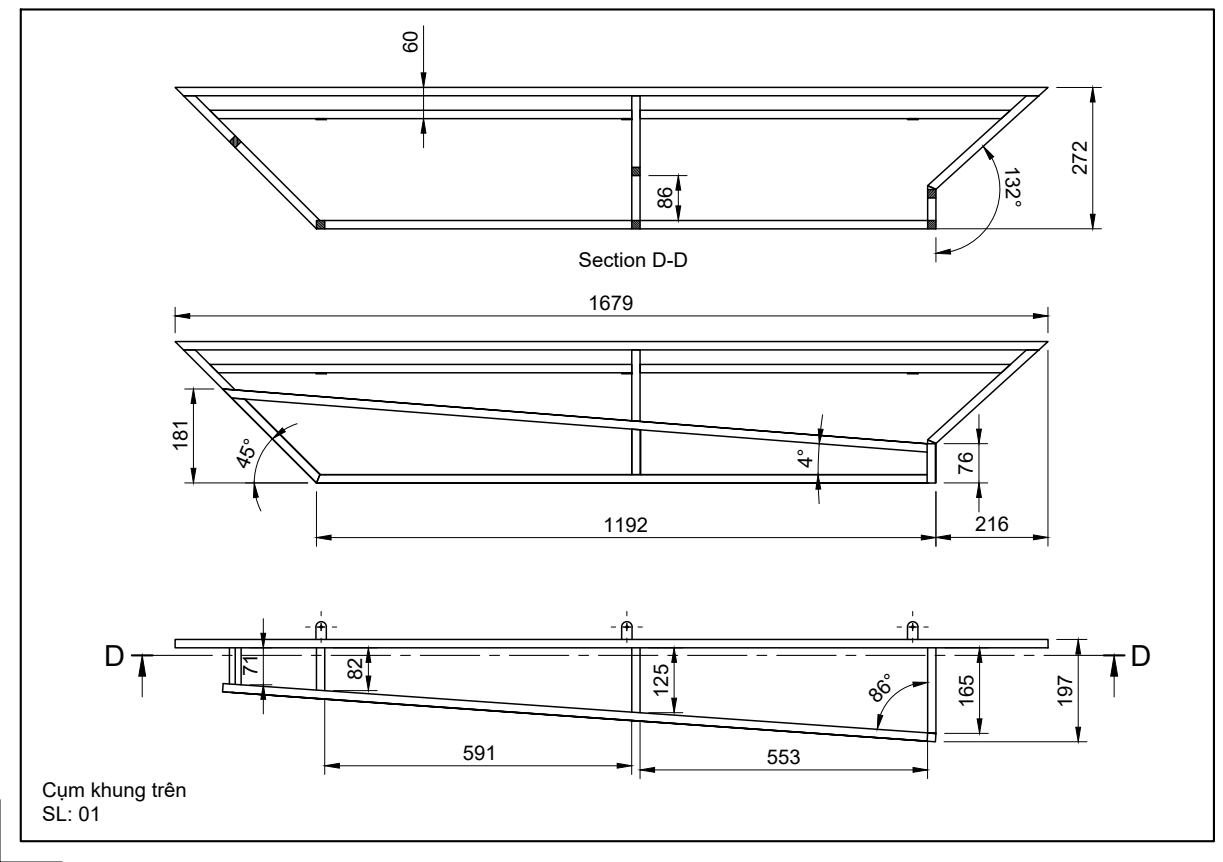
[picture p122: page 10]
Section D-D 60

Cụm khung trên

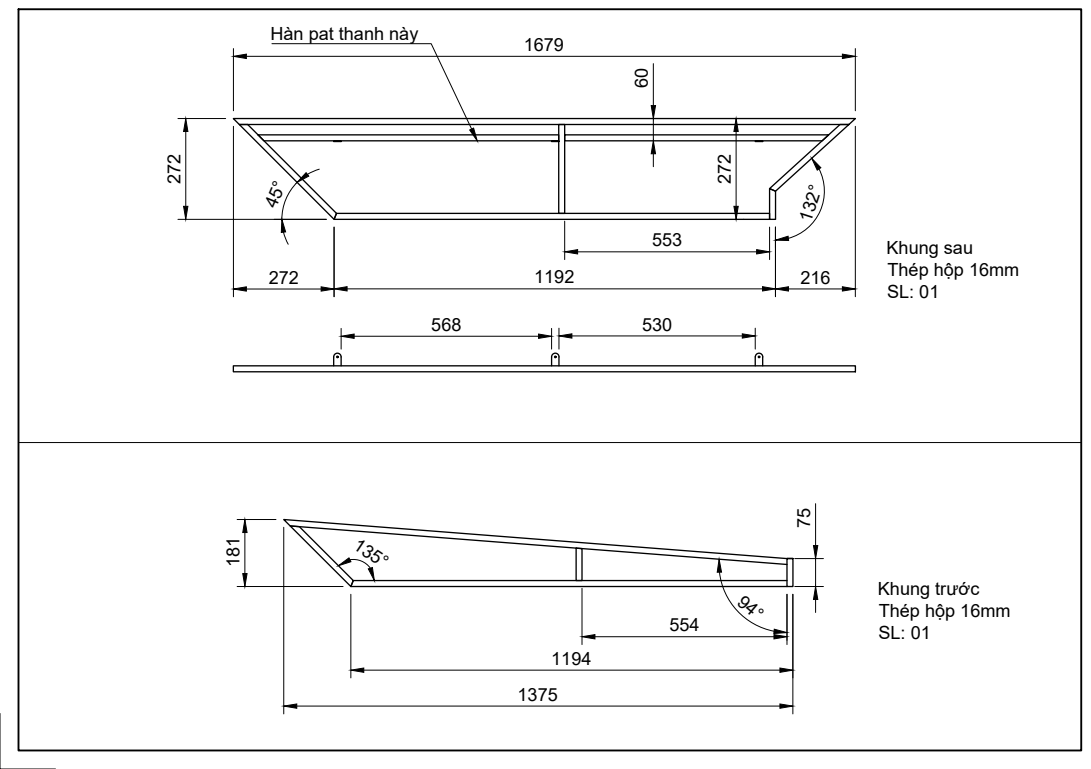
[picture p123: page 11]
Khung sau Thép hộp 16mm SL: 01; Khung trước Thép hộp 16mm SL: 01

Hàn pat thanh này

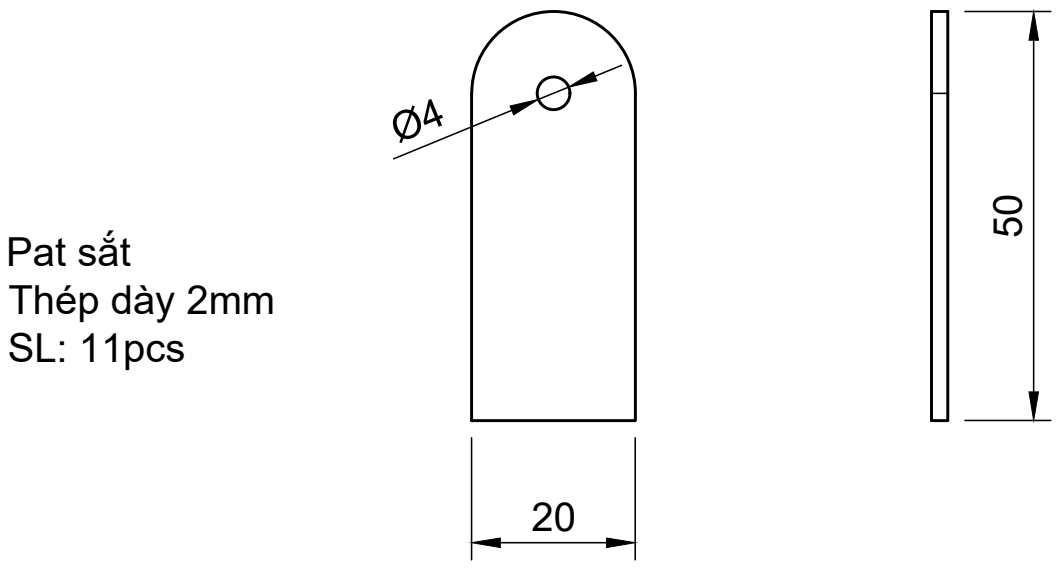
[picture p124: page 12]
Pat sắt Thép dày 2mm SL: 11pcs

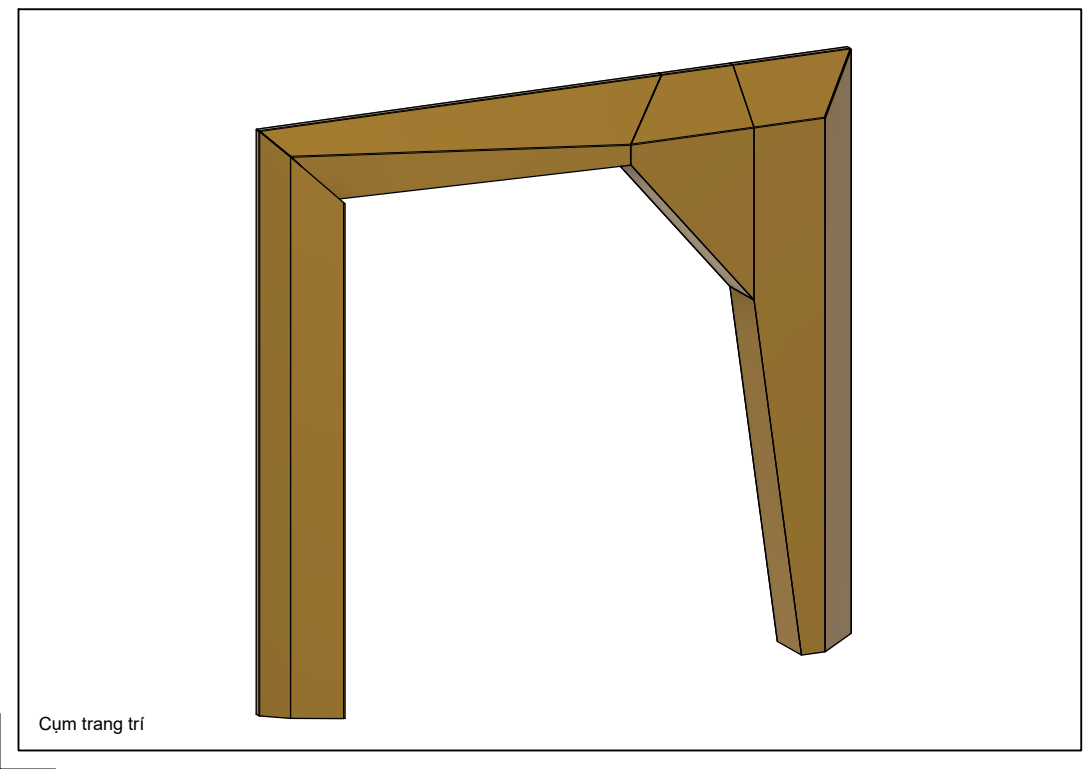
[picture p125: page 13]

Cụm trang trí

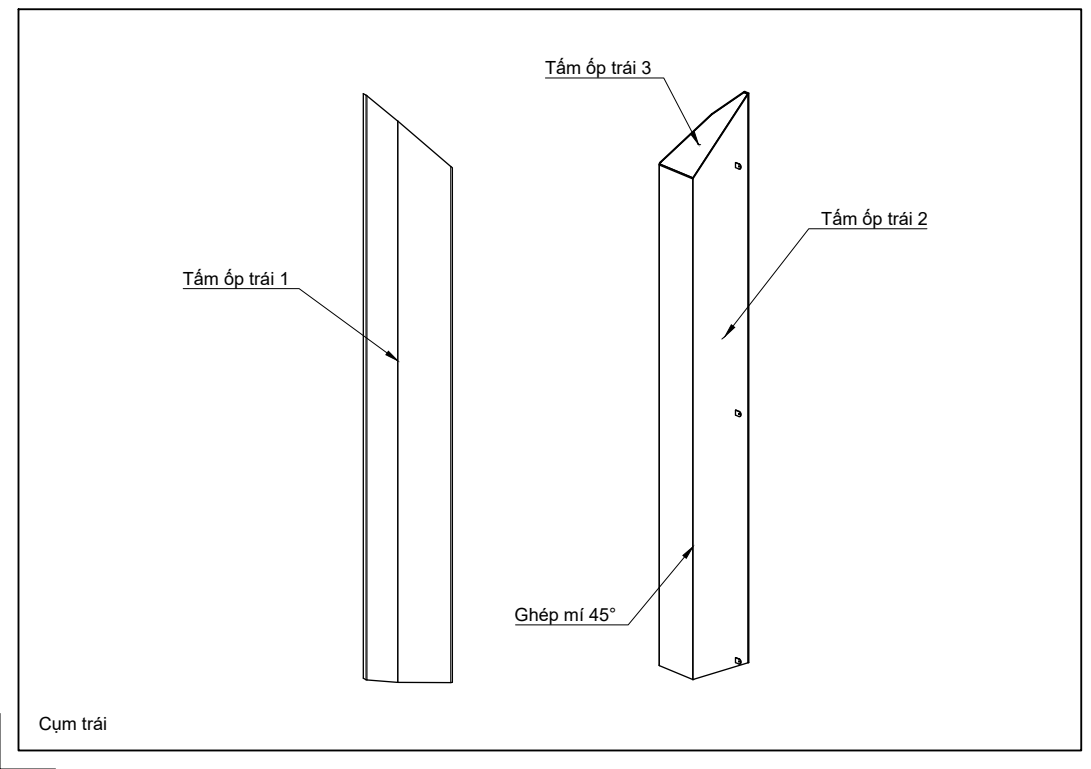
[picture p126: page 14]
Cụm trái; Ghép mí 45°

Tấm ốp trái 3

Tấm ốp trái 2

Tấm ốp trái 1

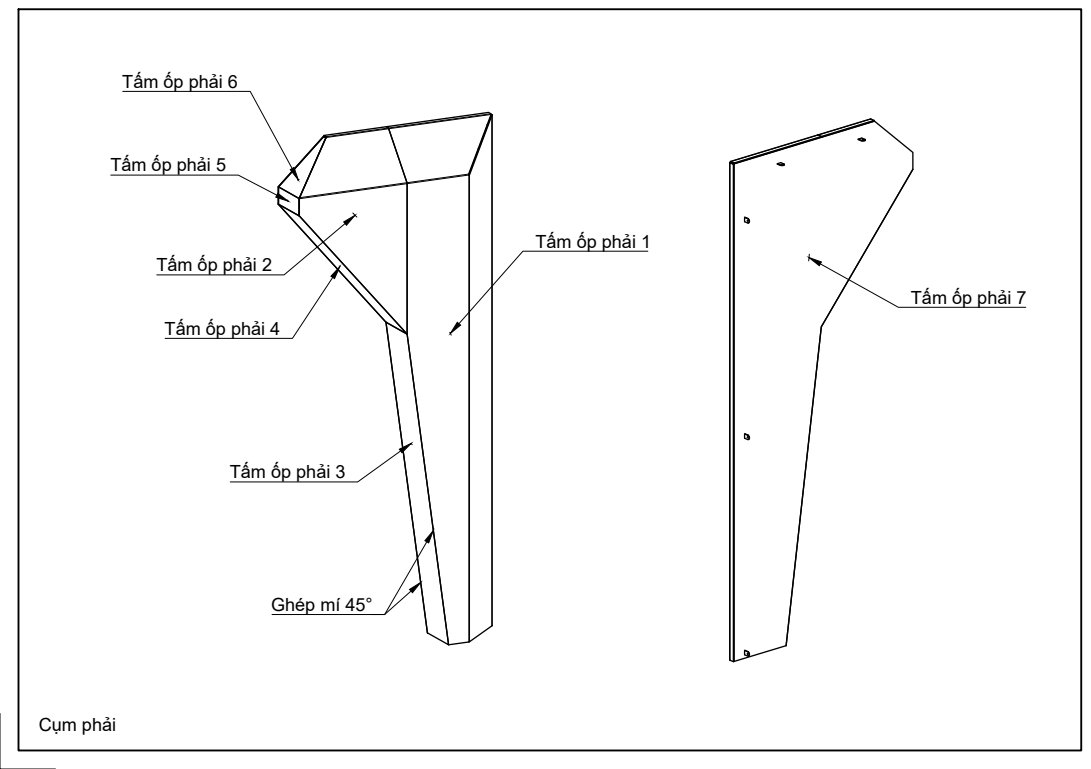
[picture p127: page 15]
Cụm phải; Ghép mí 45°

Tấm ốp phải 6

Tấm ốp phải 5

Tấm ốp phải 1

Tấm ốp phải 2

Tấm ốp phải 7

Tấm ốp phải 4

Tấm ốp phải 3

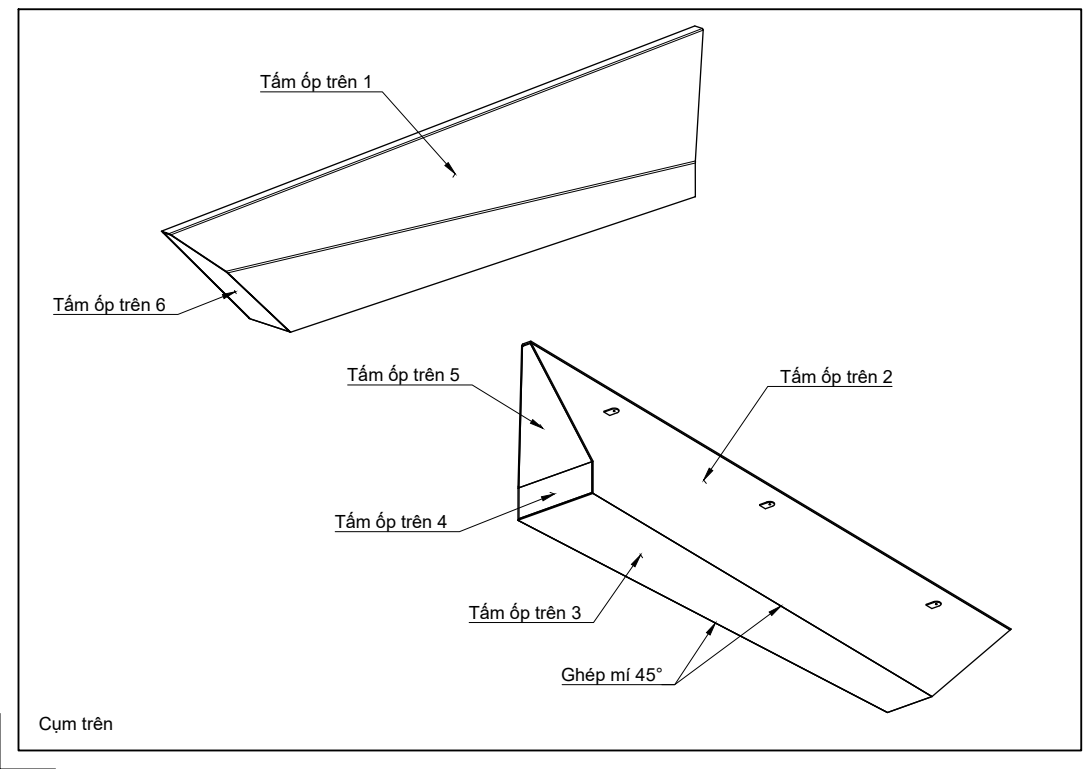
[picture p128: page 16]
Cụm trên; Ghép mí 45°

Tấm ốp trên 1

Tấm ốp trên 6

Tấm ốp trên 5

Tấm ốp trên 2

Tấm ốp trên 4

Tấm ốp trên 3
