autonomous-ai/spaceship/tools/checks/tests/fixtures/fusion-export-831001.pdf

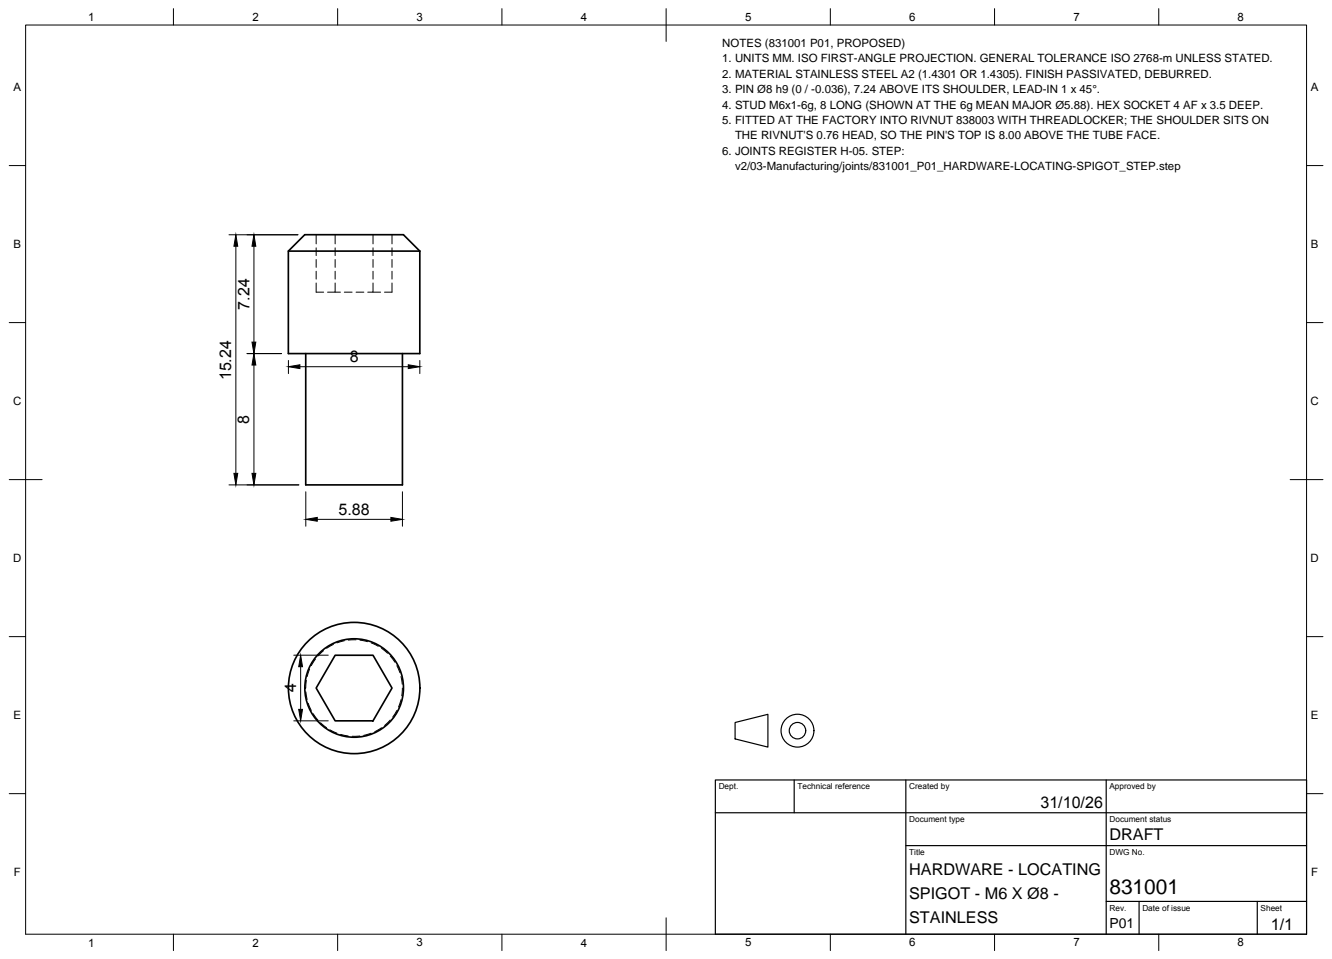
[picture p129: page 1]
Title; DWG No.; Rev.; Date of issue; Sheet; HARDWARE - LOCATING SPIGOT - M6 X Ø8 -

NOTES (831001 P01, PROPOSED)
1. UNITS MM. ISO FIRST-ANGLE PROJECTION. GENERAL TOLERANCE ISO 2768-m UNLESS STATED.
2. MATERIAL STAINLESS STEEL A2 (1.4301 OR 1.4305). FINISH PASSIVATED, DEBURRED.
3. PIN Ø8 h9 (0 / -0.036), 7.24 ABOVE ITS SHOULDER, LEAD-IN 1 x 45°.
4. STUD M6x1-6g, 8 LONG (SHOWN AT THE 6g MEAN MAJOR Ø5.88). HEX SOCKET 4 AF x 3.5 DEEP.
5. FITTED AT THE FACTORY INTO RIVNUT 838003 WITH THREADLOCKER; THE SHOULDER SITS ON
THE RIVNUT'S 0.76 HEAD, SO THE PIN'S TOP IS 8.00 ABOVE THE TUBE FACE.
6. JOINTS REGISTER H-05. STEP:
v2/03-Manufacturing/joints/831001_P01_HARDWARE-LOCATING-SPIGOT_STEP.step

Dept. | Technical reference | Created by 31/10/26 | Approved by

Document type | Document status DRAFT
