autonomous-ai/spaceship/v2/02-Drawings/interior/811101_P01_INTERIOR-LEDGE-TOP_DWG.pdf

D

D

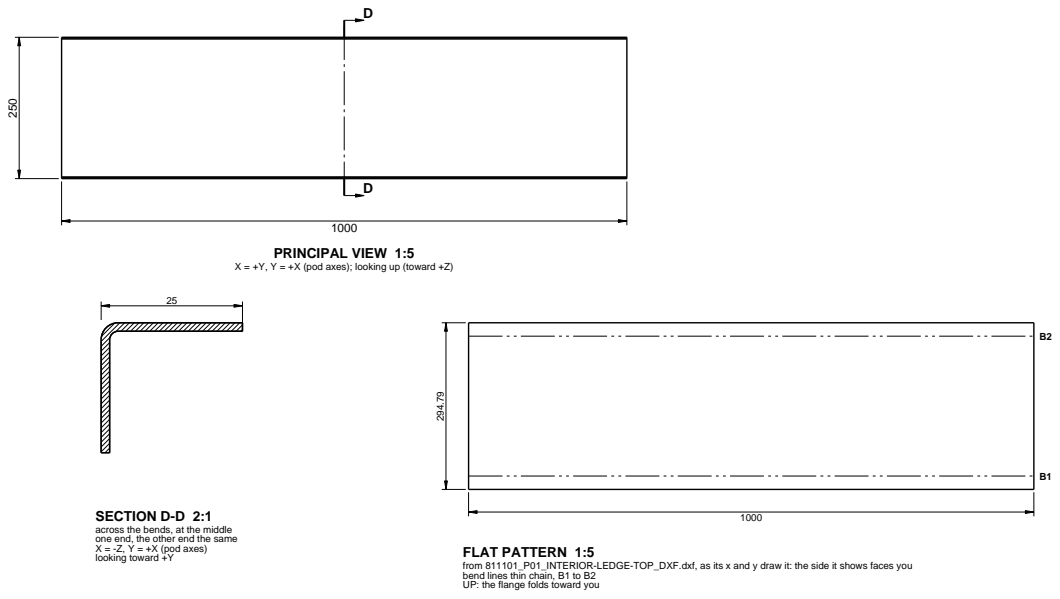
[picture p130: page 1]
PRINCIPAL VIEW 1:5; TAG; LINE IN THE FLAT (mm); DIRECTION; ANGLE; INSIDE RADIUS; BEND ALLOWANCE (mm); y 23.7 from the lower edge; y 271.09 from the lower edge; STATUS DRAFT; DATE 2026-11-01; SHEET 1/2; TITLE; PART NUMBER; REV P01; SIZE A1; UNITS UNITS: mm; MASS 1.195 kg (calculation); APPROVED not released

BENDS B1-B2: 811101_P01_INTERIOR-LEDGE-TOP_DXF.dxf
UP: the flange folds toward the viewer of the flat pattern as drawn; K-factor 0.44, inside radius from the model

X = +Y, Y = +X (pod axes); looking up (toward +Z)

SECTION D-D 2:1
across the bends, at the middle
one end, the other end the same
X = -Z, Y = +X (pod axes)
looking toward +Y

FLAT PATTERN 1:5
from 811101_P01_INTERIOR-LEDGE-TOP_DXF.dxf, as its x and y draw it: the side it shows faces you
bend lines thin chain, B1 to B2
UP: the flange folds toward you

PROJECT
Spaceship (FocusPod v2)
INTERIOR - LEDGE - TOP
Mặt bàn tựa nhôm gấp 1.5

DRAWING NUMBER (FILE)
811101_P01_INTERIOR-LEDGE-TOP_DWG

MATERIAL
MATERIAL: Aluminium 5052-H32 sheet (alloy HOLD)
FINISH
FINISH: powder coat, charcoal to match the felt (RAL HOLD)
SCALE
1:5 (sections D-D 2:1)
CREATED BY
Autonomous
PROJECTION

TOLERANCES
TOLERANCE: see the notes; not ISO 2768

ISO first angle (ISO 5456-2)

## GENERAL NOTES

1. UNITS: mm. Do not scale the drawing. ISO first-angle projection (ISO 5456-2), symbol in the title block. Dimensions to ISO 129-1. Sheet 1: views, sections and hole tables; sheet 2: these general notes.
2. Views: the principal view looks up (toward +Z) (X = +Y, Y = +X (pod axes); looking up (toward +Z)); every view's title gives its own X and Y and how they map to the pod axes (conventions section 4). On every view X runs right and Y up.
3. 1.5 mm aluminium sheet, 5052-H32 (alloy HOLD; D-85): the work wall ledge's top, front lip and back flange.
4. Folds: two folds to 90°, inside radius equal to the sheet, real folds in the model, flat blank from its DXF at K 0.44 (D-159; K is an assumption until the factory's bend table).
5. Powder coat charcoal (RAL HOLD) after folding, edges deburred first.
6. Bent from the flat pattern v2/03-Manufacturing/interior/811101_P01_INTERIOR-LEDGE-TOP_DXF.dxf (sha256 dd049e839499): its CUT outline, its BEND lines the bend centre lines. Inside radius R1.5 from the model; K-factor 0.44 (calculation: the DXF's bend lines and flat size against the model's flanges at that radius, every bend within 0.05). Flange lengths are outside sizes, to each fold's outside sharp; the bend table gives each bend's direction, angle and allowance.
7. TOLERANCES (PROPOSED until the shop confirms; not ISO 2768): cut ±0.5 and bent ±0.5 (the INTERIOR parts list, assumption); fold angles 90° ±1° (assumption); folded sizes are outside sizes.
8. Source: v2/03-Manufacturing/interior/810000_P01_INTERIOR_STEP.step (sha256 8ac133c7eb90; declared unit cm, read in mm and checked against tools/checks/stepfile.py, worst box difference 0 mm); parts list v2/03-Manufacturing/interior/810000_P01_INTERIOR-PARTS-LIST_BOM.csv. From that STEP: regenerate it, never edit the PDF.

## ISOMETRIC VIEW 1:5

for identification only

PROJECT
Spaceship (FocusPod v2)

STATUS

### DRAFT

DATE
2026-11-01

SHEET
2/2

TITLE

## INTERIOR - LEDGE - TOP

Mặt bàn tựa nhôm gấp 1.5

PART NUMBER
811101

REV
P01

DRAWING NUMBER (FILE)
811101_P01_INTERIOR-LEDGE-TOP_DWG

MATERIAL
MATERIAL: Aluminium 5052-H32 sheet (alloy HOLD)

FINISH
FINISH: powder coat, charcoal to match the felt (RAL HOLD)

SCALE
1:5 (sections D-D 2:1)

SIZE
A1

UNITS
UNITS: mm

MASS
1.195 kg (calculation)

CREATED BY
Autonomous

APPROVED
not released

TOLERANCES
TOLERANCE: see the notes; not ISO 2768

PROJECTION
ISO first angle (ISO 5456-2)

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
