autonomous-ai/spaceship/v2/02-Drawings/interior/811201_P01_INTERIOR-LIGHT-SHELF-BACK_DWG.pdf

D

D

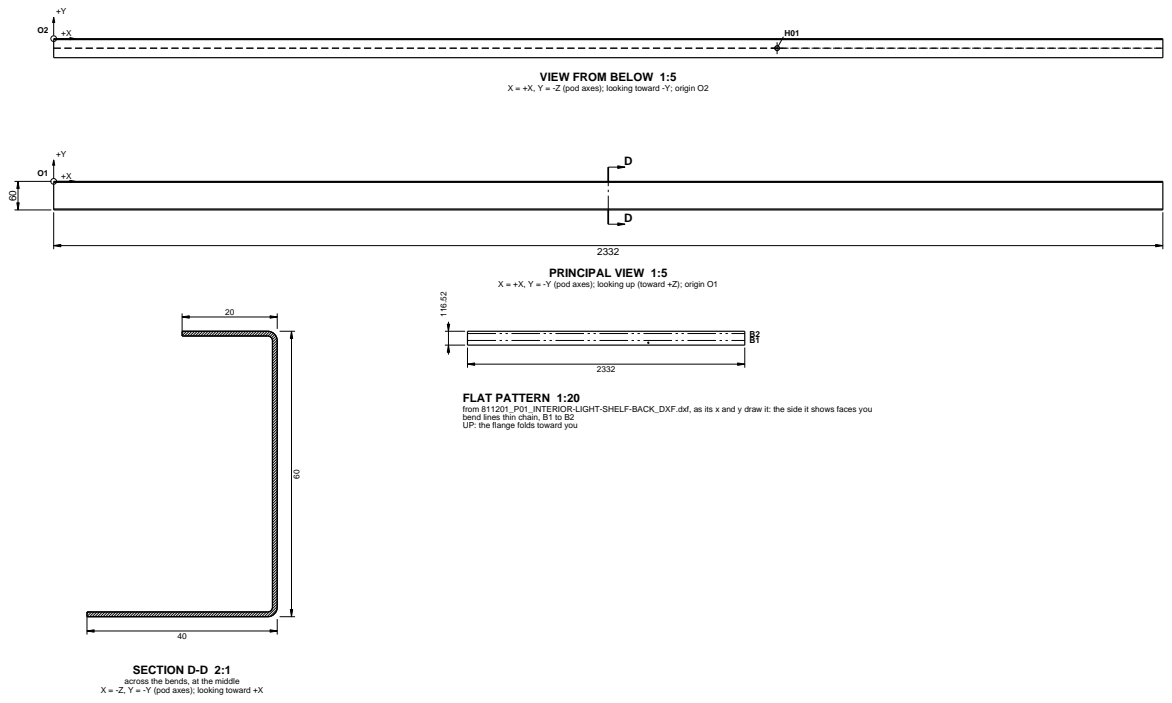
[picture p131: page 1]
PRINCIPAL VIEW 1:5; TAG; SIZE; DEPTH; FEATURE (register) AND FITS; THRU 1 WALL (1); F-8102-06 Cable holes Ø10; LINE IN THE FLAT (mm); DIRECTION; ANGLE; INSIDE RADIUS; BEND ALLOWANCE (mm); y 39.13 from the lower edge; DOWN; y 97.39 from the lower edge; STATUS DRAFT; DATE 2026-11-01; SHEET 1/2; TITLE; PART NUMBER; REV P01; SIZE A1; UNITS UNITS: mm; MASS 0.735 kg (calculation); APPROVED not released

HOLE H01: LIGHT SHELF BACK, back face
seen in the view from below; origin O2; +X right, +Y up; drilled from this face

BENDS B1-B2: 811201_P01_INTERIOR-LIGHT-SHELF-BACK_DXF.dxf
UP: the flange folds toward the viewer of the flat pattern as drawn; K-factor 0.44, inside radius from the model

VIEW FROM BELOW 1:5

X = +X, Y = -Z (pod axes); looking toward -Y; origin O2

X = +X, Y = -Y (pod axes); looking up (toward +Z); origin O1

FLAT PATTERN 1:20
from 811201_P01_INTERIOR-LIGHT-SHELF-BACK_DXF.dxf, as its x and y draw it: the side it shows faces you
bend lines thin chain, B1 to B2
UP: the flange folds toward you

SECTION D-D 2:1
across the bends, at the middle
X = -Z, Y = -Y (pod axes); looking toward +X

PROJECT
Spaceship (FocusPod v2)
INTERIOR - LIGHT SHELF - BACK
Kệ đèn - vách sau

DRAWING NUMBER (FILE)
811201_P01_INTERIOR-LIGHT-SHELF-BACK_DWG

MATERIAL
MATERIAL: Aluminium 5052-H32 sheet (alloy HOLD)
FINISH
FINISH: powder coat, charcoal (RAL HOLD)
SCALE
1:5 (sections D-D 2:1) (flat pattern
CREATED BY
Autonomous
PROJECTION

TOLERANCES
TOLERANCE: see the notes; not ISO 2768

ISO first angle (ISO 5456-2)

## GENERAL NOTES

1. UNITS: mm. Do not scale the drawing. ISO first-angle projection (ISO 5456-2), symbol in the title block. Dimensions to ISO 129-1. Sheet 1: views, sections and hole tables; sheet 2: these general notes.
2. Views: the principal view looks up (toward +Z) (X = +X, Y = -Y (pod axes); looking up (toward +Z)); every view's title gives its own X and Y and how they map to the pod axes (conventions section 4). On every view X runs right and Y up.
3. Origin O = the part's corner shown; O1, O2... are O seen in each view. Hole positions in the tables are from O.
4. 1.0 mm aluminium sheet, 5052-H32 (alloy HOLD; D-85): the light shelf's back run; the Ø10 cable hole is ELECTRICAL's feed.
5. Folds: two folds to 90°, inside radius equal to the sheet, real folds in the model, flat blank from its DXF at K 0.44 (D-159; K is an assumption until the factory's bend table).
6. Powder coat charcoal (RAL HOLD) after folding, edges deburred first.
7. Holes go THRU 1 WALL of the member unless the table says otherwise; deburr both sides.
8. Bent from the flat pattern v2/03-Manufacturing/interior/811201_P01_INTERIOR-LIGHT-SHELF-BACK_DXF.dxf (sha256 5afd21360aae): its CUT outline, its BEND lines the bend centre lines. Inside radius R1 from the model; K-factor 0.44 (calculation: the DXF's bend lines and flat size against the model's flanges at that radius, every bend within 0.05). Flange lengths are outside sizes, to each fold's outside sharp; the bend table gives each bend's direction, angle and allowance.
9. TOLERANCES (PROPOSED until the shop confirms; not ISO 2768): cut ±0.5 and bent ±0.5 (the INTERIOR parts list, assumption); fold angles 90° ±1° (assumption); folded sizes are outside sizes. The Ø10 cable hole +0.2/0, its centre ±0.5 from the blank's edges (assumption: a cable pass, not a fit).
10. Source: v2/03-Manufacturing/interior/810000_P01_INTERIOR_STEP.step (sha256 8ac133c7eb90; declared unit cm, read in mm and checked against tools/checks/stepfile.py, worst box difference 0 mm); parts list v2/03-Manufacturing/interior/810000_P01_INTERIOR-PARTS-LIST_BOM.csv; feature rationale v2/02-Drawings/interior/FEATURE-RATIONALE.md. From that STEP: regenerate it, never edit the PDF.

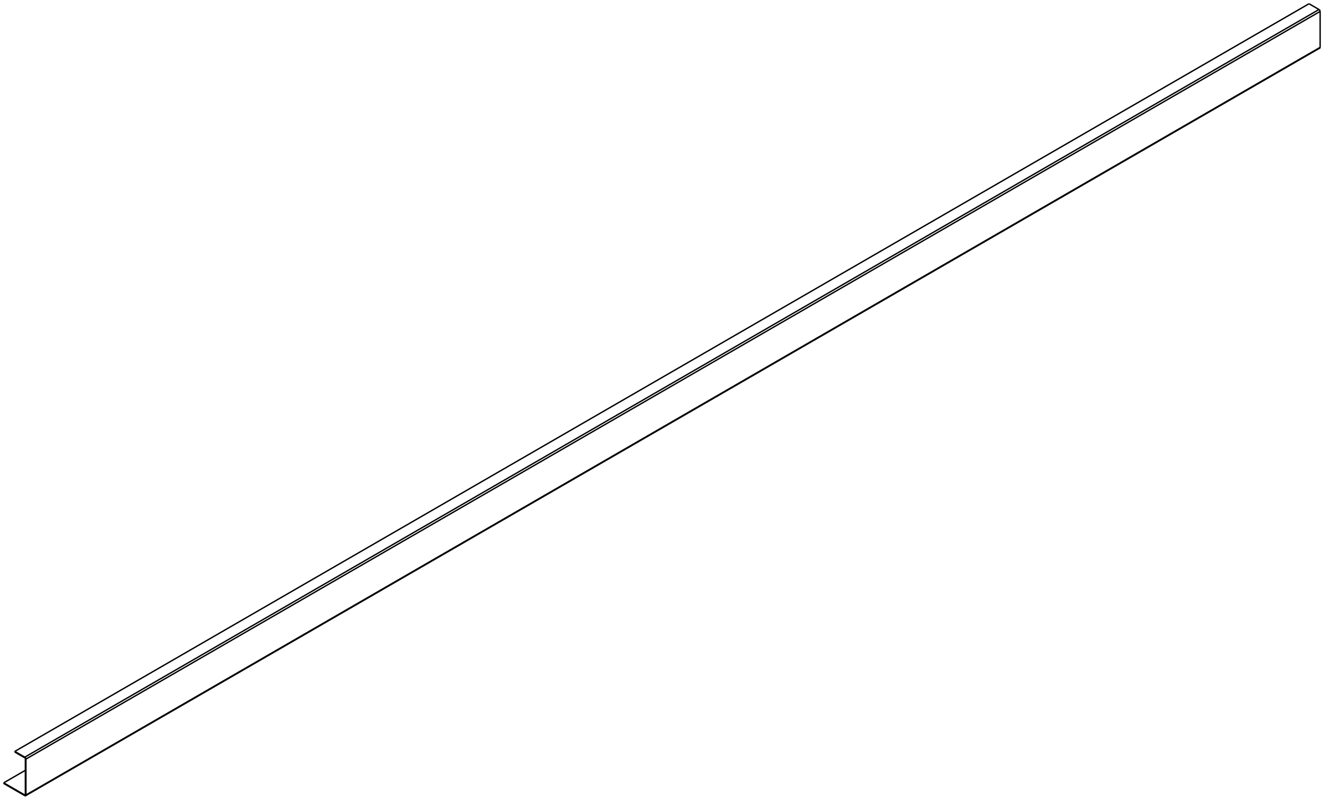
[picture p132: figure]

## ISOMETRIC VIEW 1:5

for identification only

PROJECT
Spaceship (FocusPod v2)

STATUS

### DRAFT

DATE
2026-11-01

SHEET
2/2

TITLE

## INTERIOR - LIGHT SHELF - BACK

Kệ đèn - vách sau

PART NUMBER
811201

REV
P01

DRAWING NUMBER (FILE)
811201_P01_INTERIOR-LIGHT-SHELF-BACK_DWG

MATERIAL
MATERIAL: Aluminium 5052-H32 sheet (alloy HOLD)

FINISH
FINISH: powder coat, charcoal (RAL HOLD)

SCALE
1:5 (sections D-D 2:1) (flat pattern
1:20)

SIZE
A1

UNITS
UNITS: mm

MASS
0.735 kg (calculation)

CREATED BY
Autonomous

APPROVED
not released

TOLERANCES
TOLERANCE: see the notes; not ISO 2768

PROJECTION
ISO first angle (ISO 5456-2)

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
A | A
B | B
C | C
D | D
E | E
F | F
G | G
H | H
J | J
K | K
L | L
M | M
