autonomous-ai/spaceship/v2/02-Drawings/joints/111211_P01_BASE-CORNER-KEY-TABULATED_DWG.pdf

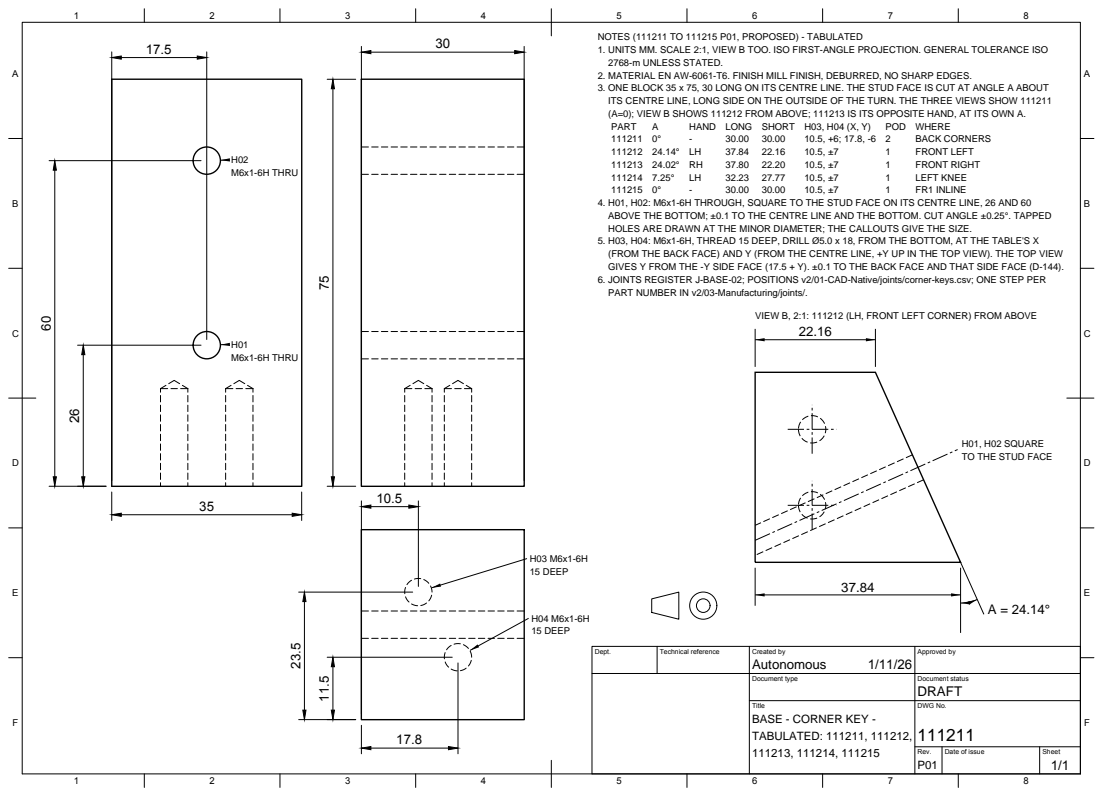
[picture p133: page 1]
Title; DWG No.; Rev.; Date of issue; Sheet; BASE - CORNER KEY - TABULATED: 111211, 111212, 111213, 111214, 111215; PART; HAND LONG SHORT H03, H04 (X, Y); POD WHERE; BACK CORNERS; FRONT LEFT; FRONT RIGHT; LEFT KNEE; FR1 INLINE; M6x1-6H THRU; H03 M6x1-6H 15 DEEP; H04 M6x1-6H 15 DEEP

NOTES (111211 TO 111215 P01, PROPOSED) - TABULATED
1. UNITS MM. SCALE 2:1, VIEW B TOO. ISO FIRST-ANGLE PROJECTION. GENERAL TOLERANCE ISO
2768-m UNLESS STATED.
2. MATERIAL EN AW-6061-T6. FINISH MILL FINISH, DEBURRED, NO SHARP EDGES.
3. ONE BLOCK 35 x 75, 30 LONG ON ITS CENTRE LINE. THE STUD FACE IS CUT AT ANGLE A ABOUT
ITS CENTRE LINE, LONG SIDE ON THE OUTSIDE OF THE TURN. THE THREE VIEWS SHOW 111211
(A=0); VIEW B SHOWS 111212 FROM ABOVE; 111213 IS ITS OPPOSITE HAND, AT ITS OWN A.
4. H01, H02: M6x1-6H THROUGH, SQUARE TO THE STUD FACE ON ITS CENTRE LINE, 26 AND 60
ABOVE THE BOTTOM; ±0.1 TO THE CENTRE LINE AND THE BOTTOM. CUT ANGLE ±0.25°. TAPPED
HOLES ARE DRAWN AT THE MINOR DIAMETER; THE CALLOUTS GIVE THE SIZE.
5. H03, H04: M6x1-6H, THREAD 15 DEEP, DRILL Ø5.0 x 18, FROM THE BOTTOM, AT THE TABLE'S X
(FROM THE BACK FACE) AND Y (FROM THE CENTRE LINE, +Y UP IN THE TOP VIEW). THE TOP VIEW
GIVES Y FROM THE -Y SIDE FACE (17.5 + Y). ±0.1 TO THE BACK FACE AND THAT SIDE FACE (D-144).
6. JOINTS REGISTER J-BASE-02; POSITIONS v2/01-CAD-Native/joints/corner-keys.csv; ONE STEP PER
PART NUMBER IN v2/03-Manufacturing/joints/.

VIEW B, 2:1: 111212 (LH, FRONT LEFT CORNER) FROM ABOVE

H01, H02 SQUARE
TO THE STUD FACE

Dept. | Technical reference | Created by Autonomous 1/11/26 | Approved by

Document type | Document status DRAFT
