autonomous-ai/spaceship/v2/02-Drawings/electrical/711001_P01_ELECTRICAL-POWER-UNIT-ENCLOSURE-BODY_DWG.pdf

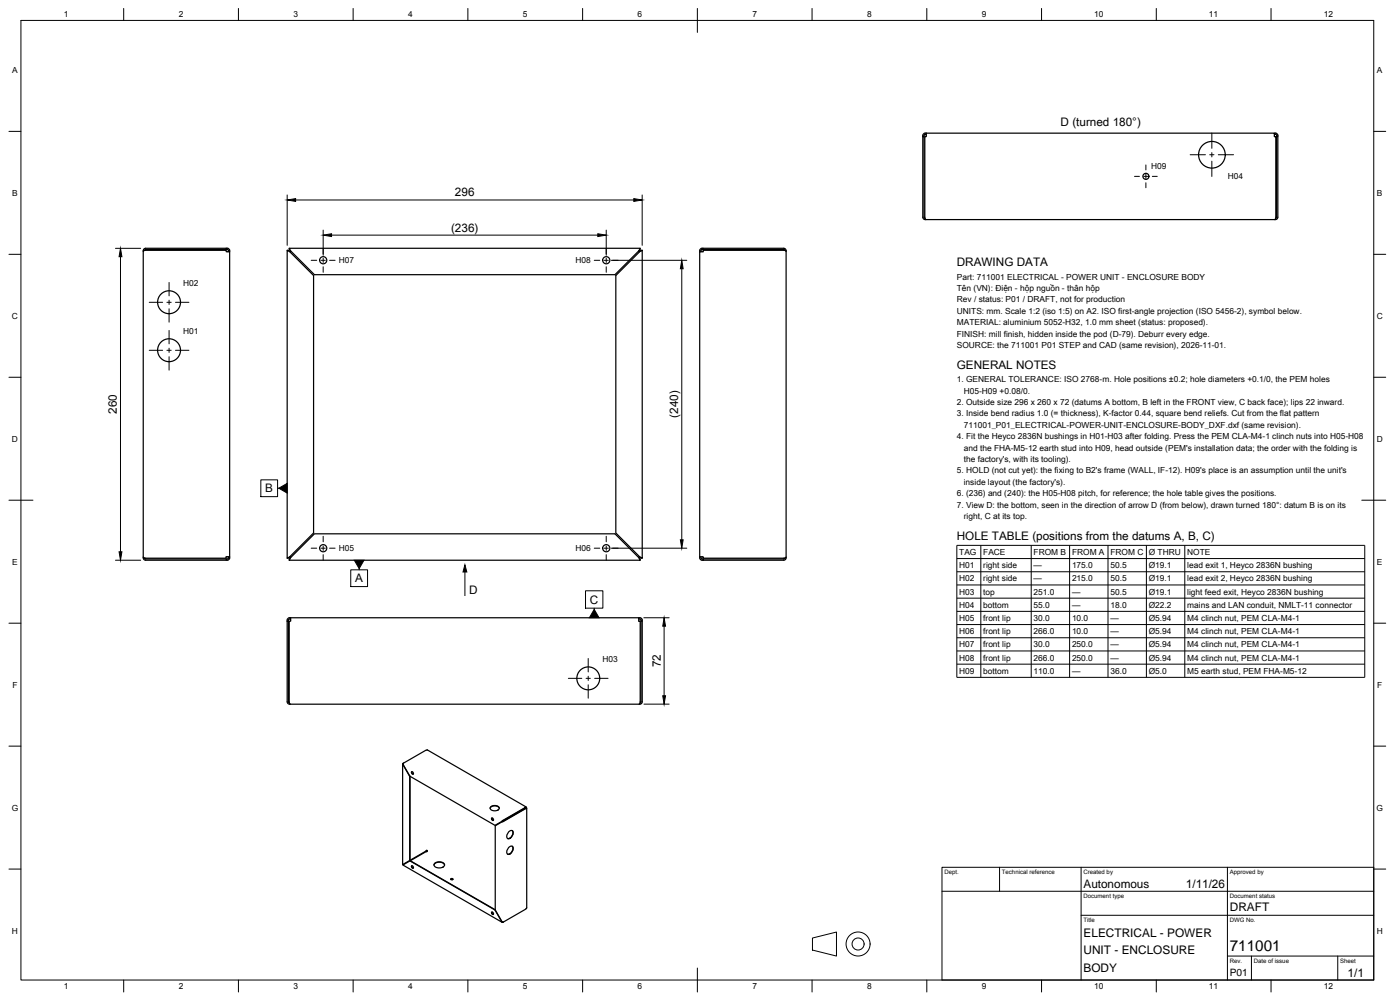
[picture p134: page 1]
12 BACDEFGH; BACDEFGH; D (turned 180°)

DRAWING DATA
Part: 711001 ELECTRICAL - POWER UNIT - ENCLOSURE BODY
Tên (VN): Điện - hộp nguồn - thân hộp
Rev / status: P01 / DRAFT, not for production
UNITS: mm. Scale 1:2 (iso 1:5) on A2. ISO first-angle projection (ISO 5456-2), symbol below.
MATERIAL: aluminium 5052-H32, 1.0 mm sheet (status: proposed).
FINISH: mill finish, hidden inside the pod (D-79). Deburr every edge.
SOURCE: the 711001 P01 STEP and CAD (same revision), 2026-11-01.
GENERAL NOTES
1. GENERAL TOLERANCE: ISO 2768-m. Hole positions ±0.2; hole diameters +0.1/0, the PEM holes
2. Outside size 296 x 260 x 72 (datums A bottom, B left in the FRONT view, C back face); lips 22 inward.
3. Inside bend radius 1.0 (= thickness), K-factor 0.44, square bend reliefs. Cut from the flat pattern
711001_P01_ELECTRICAL-POWER-UNIT-ENCLOSURE-BODY_DXF.dxf (same revision).
4. Fit the Heyco 2836N bushings in H01-H03 after folding. Press the PEM CLA-M4-1 clinch nuts into H05-H08
and the FHA-M5-12 earth stud into H09, head outside (PEM's installation data; the order with the folding is
the factory's, with its tooling).
5. HOLD (not cut yet): the fixing to B2's frame (WALL, IF-12). H09's place is an assumption until the unit's
inside layout (the factory's).
6. (236) and (240): the H05-H08 pitch, for reference; the hole table gives the positions.
7. View D: the bottom, seen in the direction of arrow D (from below), drawn turned 180°: datum B is on its
right, C at its top.
HOLE TABLE (positions from the datums A, B, C)

TAG | FACE | FROM B | FROM A | FROM C | Ø THRU | NOTE
H01 | right side | — | 175.0 | 50.5 | Ø19.1 | lead exit 1, Heyco 2836N bushing
H02 | right side | — | 215.0 | 50.5 | Ø19.1 | lead exit 2, Heyco 2836N bushing
H03 | top | 251.0 | — | 50.5 | Ø19.1 | light feed exit, Heyco 2836N bushing
H04 | bottom | 55.0 | — | 18.0 | Ø22.2 | mains and LAN conduit, NMLT-11 connector
H05 | front lip | 30.0 | 10.0 | — | Ø5.94 | M4 clinch nut, PEM CLA-M4-1
H06 | front lip | 266.0 | 10.0 | — | Ø5.94 | M4 clinch nut, PEM CLA-M4-1
H07 | front lip | 30.0 | 250.0 | — | Ø5.94 | M4 clinch nut, PEM CLA-M4-1
H08 | front lip | 266.0 | 250.0 | — | Ø5.94 | M4 clinch nut, PEM CLA-M4-1
H09 | bottom | 110.0 | — | 36.0 | Ø5.0 | M5 earth stud, PEM FHA-M5-12

Dept. | Technical reference | Created by Autonomous 1/11/26 | Approved by

Document type | Document status DRAFT

Title ELECTRICAL - POWER UNIT - ENCLOSURE BODY | DWG No. 711001

Rev. P01 | Date of issue | Sheet
