autonomous-ai/spaceship/v2/02-Drawings/base/111106_P01_BASE-BAND-TUBE-FRONT-FIXED-GLASS_DWG.pdf

## VIEW FROM BELOW 1:2

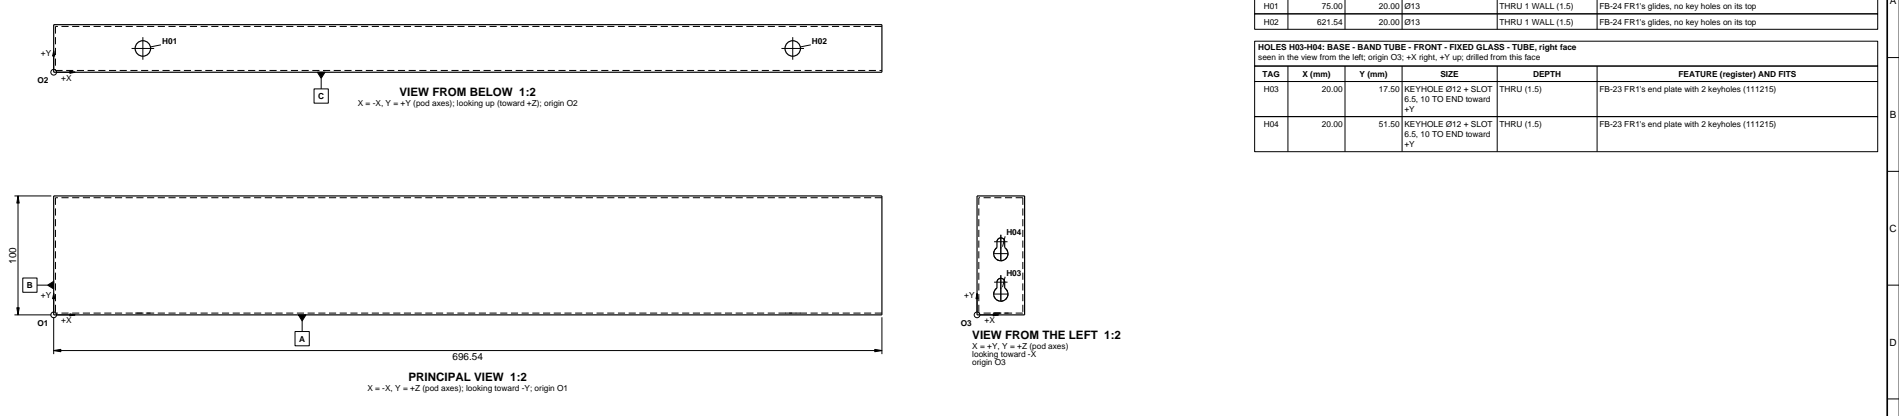
[picture p135: page 1]
PRINCIPAL VIEW 1:2; TAG; SIZE; DEPTH; FEATURE (register) AND FITS; THRU 1 WALL (1.5); FB-24 FR1's glides, no key holes on its top; KEYHOLE Ø12 + SLOT; THRU (1.5); FB-23 FR1's end plate with 2 keyholes (111215); STATUS DRAFT; DATE 2026-11-01; SHEET 1/2; TITLE; PART NUMBER; REV P01; SIZE A1; UNITS UNITS: mm; MASS 0.7851 kg (calculation); APPROVED not released

HOLES H01-H02: BASE - BAND TUBE - FRONT - FIXED GLASS - TUBE, bottom face
seen in the view from below; origin O2; +X right, +Y up; drilled from this face

HOLES H03-H04: BASE - BAND TUBE - FRONT - FIXED GLASS - TUBE, right face
seen in the view from the left; origin O3; +X right, +Y up; drilled from this face

6.5, 10 TO END toward

X = -X, Y = +Y (pod axes); looking up (toward +Z); origin O2

VIEW FROM THE LEFT 1:2
X = +Y, Y = +Z (pod axes)
looking toward -X
origin O3

X = -X, Y = +Z (pod axes); looking toward -Y; origin O1

PROJECT
Spaceship (FocusPod v2)
BASE - BAND TUBE - FRONT - FIXED GLASS
Viền chân trước - dưới kính cố định

DRAWING NUMBER (FILE)
111106_P01_BASE-BAND-TUBE-FRONT-FIXED-GLASS_DWG

MATERIAL
MATERIAL: aluminium 6063-T6 rectangular tube 100 x 40 x 1.5 with a welded 1.5 mm end plate (alloy:
assumption)
FINISH
FINISH: black anodised, matte, 20 um (class AA20, EN ISO 7599)
SCALE
CREATED BY
Autonomous
PROJECTION

TOLERANCES
TOLERANCE: see the notes; not ISO 2768

ISO first angle (ISO 5456-2)

## GENERAL NOTES

1. UNITS: mm. Do not scale the drawing. ISO first-angle projection (ISO 5456-2), symbol in the title block. Dimensions to ISO 129-1. Sheet 1: views, sections and hole tables; sheet 2: these general notes.
2. Views: the principal view looks toward -Y (X = -X, Y = +Z (pod axes); looking toward -Y); every view's title gives its own X and Y and how they map to the pod axes (conventions section 4). On every view X runs right and Y up.
3. Datums (ISO 5459): A = the bottom face (Z 10, on its glides); B = the keyed end plate's outer face (X 915, on the intake piece's end, J-BASE-02); C = the outer face (Y -850, the band's front line). Origin O = the corner where A, B and C meet; O1, O2... are O seen in each view. Hole positions in the tables are theoretically exact from O.
4. Door end (X 218.5): square and open, closed by the flat end cap 118003, in view at the door opening (D-132). Keyed end (X 915): square, closed by a 1.5 end plate welded in flush, with the 2 keyholes for the intake's inline key 111215 (joints register J-BASE-02, D-144).
5. No holes in the top wall: it is in view in front of the glass, so the 2 glides are levelled by turning their base (BASE feature rationale FB-24).
6. Holes go THRU 1 WALL of the member unless the table says otherwise; deburr both sides.
7. TOLERANCES (PROPOSED until the shop confirms; not ISO 2768): hole positions ±0.2 from B along the band and from C across it (joints register R-J6); keyhole seats ±0.2 from A (they set the band's height on the key's studs; assumption); keyhole slots 6.5 +0.1/0, entries Ø12 +0.2/0 (assumption); glide nut holes Ø13 +0.10/0 (HOLD with the nut); cut length +0/-0.5, square ends (BASE cut list, assumption). Not ISO 2768 on the anodised faces.
8. Source: v2/03-Manufacturing/base/111106_P01_BASE-BAND-TUBE-FRONT-FIXED-GLASS_STEP.step (sha256 c95eee2efb55; declared unit cm, read in mm and checked against tools/checks/stepfile.py, worst box difference 0 mm); parts list v2/03-Manufacturing/base/110000_P01_BASE_BOM.csv; feature rationale v2/02-Drawings/base/FEATURE-RATIONALE.md. From that STEP: regenerate it, never edit the PDF.

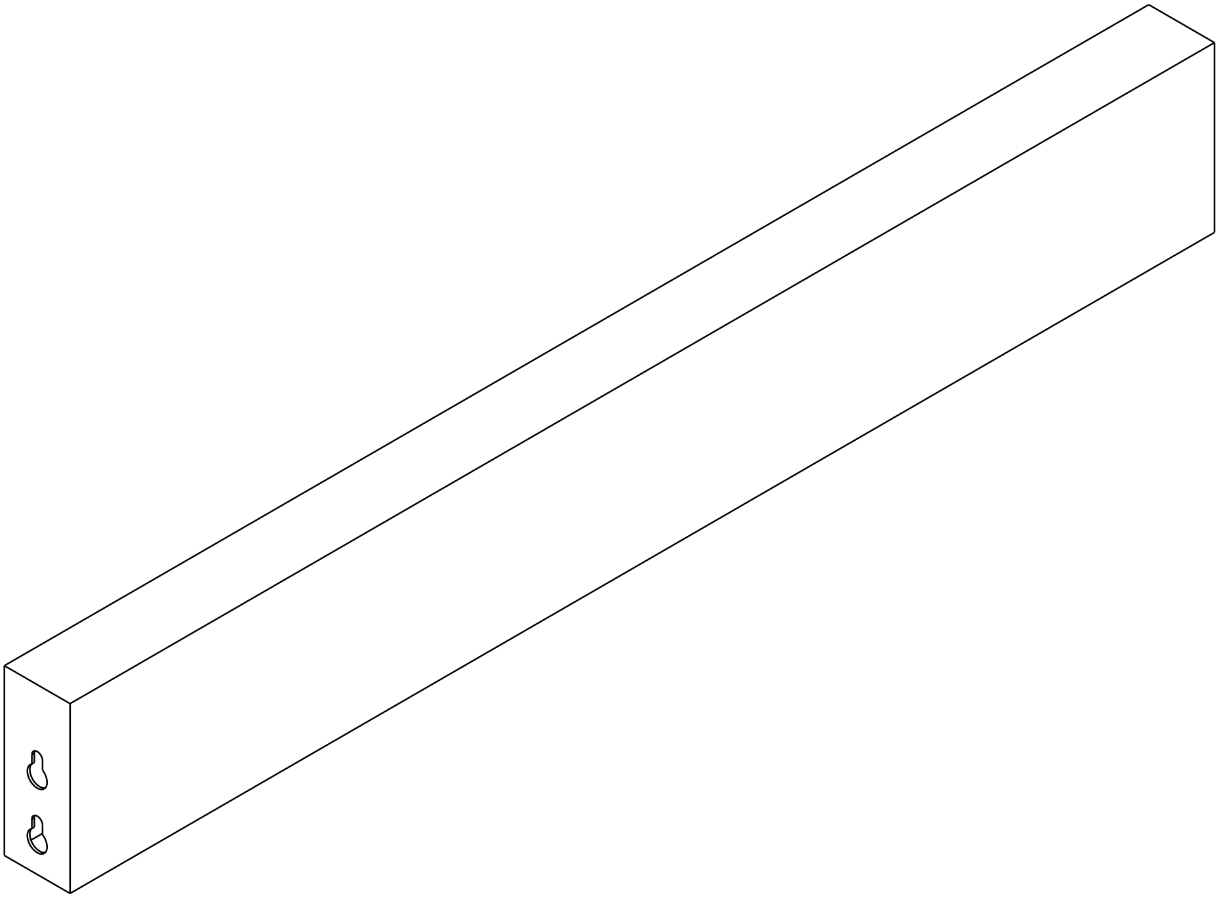
[picture p136: figure]

## ISOMETRIC VIEW 1:2

for identification only

PROJECT
Spaceship (FocusPod v2)

STATUS

### DRAFT

DATE
2026-11-01

SHEET
2/2

TITLE

## BASE - BAND TUBE - FRONT - FIXED GLASS

Viền chân trước - dưới kính cố định

PART NUMBER
111106

REV
P01

DRAWING NUMBER (FILE)
111106_P01_BASE-BAND-TUBE-FRONT-FIXED-GLASS_DWG

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

FINISH
FINISH: black anodised, matte, 20 um (class AA20, EN ISO 7599)

SCALE
1:2

SIZE
A1

UNITS
UNITS: mm

MASS
0.7851 kg (calculation)

CREATED BY
Autonomous

APPROVED
not released

TOLERANCES
TOLERANCE: see the notes; not ISO 2768

PROJECTION
ISO first angle (ISO 5456-2)

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
A | A
B | B
C | C
D | D
E | E
F | F
G | G
H | H
J | J
K | K
L | L
M | M
