autonomous-ai/spaceship/v2/02-Drawings/proof/V2-SWL-00_P01_WALL-PANEL-ASSY-SIDE-LOWER-LH_DWG.pdf

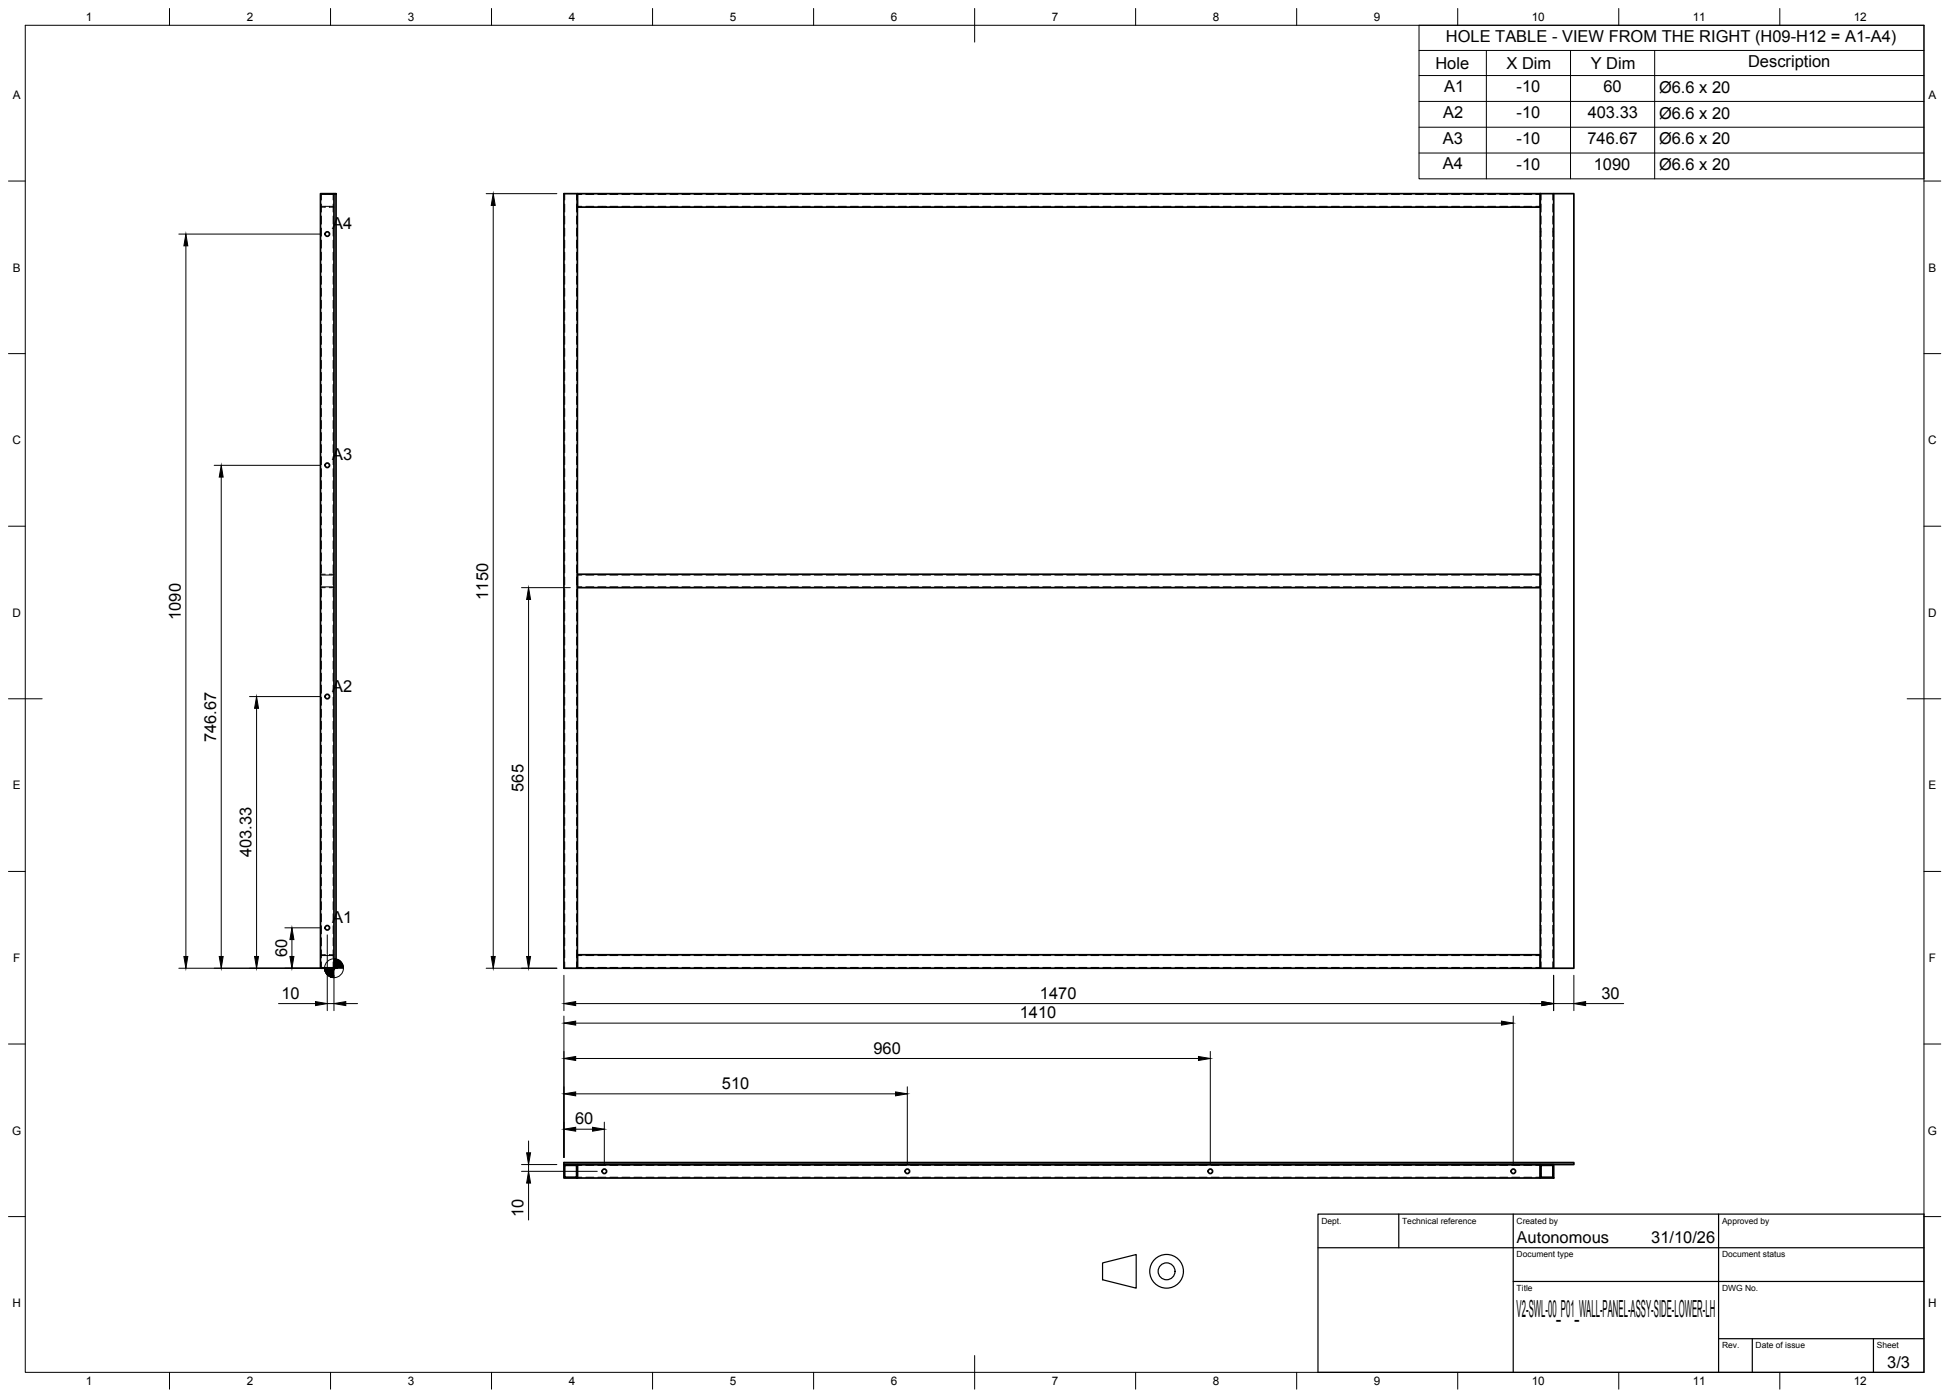
[picture p137: page 1]

HOLE TABLE - VIEW FROM THE RIGHT (H09-H12 = A1-A4)

Hole | X Dim | Y Dim | Description
A1 | -10 | 60 | Ø6.6 x 20
A2 | -10 | 403.33 | Ø6.6 x 20
A3 | -10 | 746.67 | Ø6.6 x 20
A4 | -10 | 1090 | Ø6.6 x 20

Dept. | Technical reference | Created by Autonomous 31/10/26 | Approved by

Document type | Document status

Title V2-SWL-00_P01_WALL-PANEL-ASSY-SIDE-LOWER-LH | DWG No.

Rev. | Date of issue | Sheet 3/3
