autonomous-ai/spaceship/(commit log)

2026-10-31 Add FocusPod v1 source files (Indoor Pod V3) (#1)
    STEP assembly, materials BOM, wood / floor frame / decor frame drawings,
    the modeling plan and the engineering guideline, as sent by the hardware
    team on 2026-10-31. Reference only; v2 work links back here.
    [indoor-pod-v3-assembly.step, indoor-pod-v3-bom-v5-2026-10-29.xlsx]
2026-10-31 Working name: Spaceship; reserve hooks for the voice cockpit (#4)
    Dee named v2 Spaceship: it looks like one, and inside you command your
    agents by voice. The prototype keeps its structure goals but reserves
    mounting points, cable paths and power for a later cockpit kit.
2026-10-31 Big-brand scorecard; refine the 10x targets (#5)
    Install 2 person-hours (stretch 1), every piece hand-carried, CO2
    sensor driving the fans with the reading shown, fan noise <= 25 dB(A)
    published, sound stretch 33 dB with a lab report. 10x is real on
    install, handling, lead time and moving; 1.2-3x on weight, sound, price.
2026-10-31 Sync PLAN.md and AGENTS.md with the decision log (#9)
    Quiet build at about 385 kg / 24 dB (D-02) replaces the 300 kg / 30 dB
    targets; the decision log wins where the plan disagrees. AGENTS.md notes
    the STEP-in-cm exception (D-13).
2026-10-31 PLAN.md: latest decided numbers (418 kg, 24 dB, 53/70 l/s) (#13)
2026-10-31 Layout study: weight, pallets and 2-person assembly (#10)
    [parts-option-A.csv, parts-option-B1-final-stack.csv, parts-option-B1.csv, parts-option-B2.csv, parts-option-C.csv, parts-weights-light.csv, parts-weights-plan.csv, v1-bom-lines.csv]
2026-10-31 Spaceship control pack: requirements, assembly tree, registers, conventions, decision log (#8)
    [document-register.csv, issue-register.csv]
2026-10-31 Control pack follow-up: CO2 control with a 26 l/s floor, PR #11 rule rows (#14)
    [document-register.csv, issue-register.csv]
2026-10-31 v2 Phase 0: Fusion proof part, edit test, exports and drawing (#6)
    [V2-SWL-00_P01_WALL-PANEL-ASSY-SIDE-LOWER-LH_CAD.f3d, V2-SWL-00_P01_WALL-PANEL-ASSY-SIDE-LOWER-LH_STEP.step]
2026-10-31 v2 M2: native Fusion skeleton of the whole pod, stage A (#15)
    [100000_P01_POD-SKELETON-PARAMETERS.csv, 100000_P01_POD-SKELETON_CAD.f3d, 100000_P01_POD-SKELETON_STEP.step, document-register.csv]
2026-10-31 v2 M2: skeleton stage B, the measured faceted front (#16)
    Rebased onto main after #15's squash merge; tree identical to the reviewed head dff4176.
    [100000_P02_POD-SKELETON-PARAMETERS.csv, 100000_P02_POD-SKELETON_CAD.f3d, 100000_P02_POD-SKELETON_STEP.step]
2026-10-31 v2 M2: skeleton P03, wall depth 1495, v1 top joint, floating linings (#17)
    [100000_P01_POD-SKELETON-PARAMETERS.csv, 100000_P01_POD-SKELETON_CAD.f3d, 100000_P01_POD-SKELETON_STEP.step, 100000_P02_POD-SKELETON_CAD.f3d, 100000_P02_POD-SKELETON_STEP.step, 100000_P03_POD-SKELETON-PARAMETERS.csv, 100000_P03_POD-SKELETON_CAD.f3d, 100000_P03_POD-SKELETON_STEP.step]
2026-10-31 Control pack: Milestone 1 results and skeleton rulings, D-49 to D-59 (#19)
    [document-register.csv, issue-register.csv]
2026-10-31 Layout study refresh to the decided design, 426.7 kg open against the 420 cap (#20)
    [parts-option-A.csv, parts-option-B1-final-stack.csv, parts-option-B1.csv, parts-option-B2.csv, parts-option-C.csv, parts-weights-light.csv, parts-weights-plan.csv]
2026-10-31 Wall and door sample package: build list, parts, 13 tests, HOLDs, drawings; D-60 air layout (#21)
    [document-register.csv]
2026-10-31 Skeleton P04: rulings, 2.26 mm seams, 46 mm outer panel, closed shell (#24)
    [100000_P03_POD-SKELETON-PARAMETERS.csv, 100000_P03_POD-SKELETON_CAD.f3d, 100000_P03_POD-SKELETON_STEP.step, 100000_P04_POD-SKELETON-PARAMETERS.csv, 100000_P04_POD-SKELETON_CAD.f3d, 100000_P04_POD-SKELETON_STEP.step]
2026-10-31 Air path recheck after D-58 and D-59: D-60 layout, sizes, weight, recirculation (#26)
    * Air path recheck after D-58 and D-59: D-60 layout, sizes, weight, recirculation
    The right decor block follows the fixed glass (skeleton P03): 145-343 mm wide
    below Z 1521 and a 27 mm flat top, so PR #11's 960 mm wide air path doesn't
    fit. calc.py now builds each air path from parts on the block's real shape:
    every layout kept inside the decor gives 39-46 dB(A) at 53 l/s or can't reach
    it. D-60 puts one 173 x 314 x 1750 cartridge (two 80 mm passages, 50 mm
    Pyrotek layers) in a 220 x 360 air column and one in a 360 x 220 soffit:
    25.1 dB(A) at 53 l/s, 29.6 at 65 l/s, 66 l/s at 30 dB(A). Adds the size
    table,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
2026-10-31 D-60 re-check: section 1 parts rows on skeleton P04 (#30)
    Reviewer re-check on 6cc386f (P3): the section 1 parts table still had the
    P03 column (220 x 360) and soffit (2338); now 217 x 360 and 2332 at 10.0 kg
    each. The riser row's 0.5 kg is relabelled as its foot and the mesh band
    piece's extra, since the intake mesh is now the band piece. --verify passes.
2026-10-31 Sample package: air rows to D-60 and the Air Engineer's sizes (#29)
    * Sample package: air rows to D-60 and the Air Engineer's sizes
    One-time exception from the PM: README, build list (S5, R3, R4), D08 and D09,
    P15 to P20 with the fill and felt quantities they change, T04, T12, the
    pending line in the test plan, and H07 now follow D-60: one 173 x 314 x 1750
    cartridge for both paths, the 220 x 360 air column, the 360 x 220 soffit, the
    intake riser and the fan boxes (sizes from the D-60 recheck, PR #26).
    check_package.py and check_control_pack.py pass.
    * Sample package air rows: skeleton P04 sizes and the mesh band intake
    Follows the D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
2026-10-31 Sample package: S3 is the real ceiling cassette from CEILING PR #32 (#34)
    S3 moves from skeleton P03's 1169 x 1414 envelope to the one-part ceiling
    cassette in PR #32: tray outline 1163 x 1048 x 34 in its current build (1160 x
    1045 on skeleton P04), 12 mm lips holding the felt, 2 ribs, flat blank
    1251.53 x 1136.52 x 0.5, about 9.8 kg with its fill. The rows that follow it
    change too: the steel, felt, fill and gasket quantities (P03, P08, P09, P14),
    drawing D06, rig R2's clip and catch positions, and the README. T07 and T08
    keep ISS-076's 16 kg until T10. check_package.py and check_control_pack.py
    pass.
2026-10-31 Control pack: tonight's rulings D-61 to D-78, requirements, issues and register (#35)
    * Decision log: tonight's PM rulings, D-61 to D-72
    D-60 as sized, the mesh band intake, fasteners, seams and closing
    seams, skeleton P04, the band and kick strip finish, the front, the
    linings, the interior, the weight (about 429.5 kg) and the 13 mm
    threshold. D-59 gets its slip-joint line; replaced rows get pointers.
    * Requirements and issue register to D-61 to D-72
    Requirements follow tonight's rulings: the air path inside the pod
    with the mesh band intake, the joints and fasteners, skeleton P04,
    the front, linings, interior, weight and the 13 mm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
    [document-register.csv, issue-register.csv]
2026-10-31 Control pack: folder row for v2/04-Checks/ (D-78) (#37)
    The mechanical check group's PR #25 hands its register row to the control
    pack, as D-78 says. Control pack check: all 6 met, alone and merged with #25.
    [document-register.csv]
2026-10-31 Mechanical checks: tooling, findings register, first run on main (#25)
    * Mechanical checks: offline tooling, findings register F-001 to F-007
    tools/checks/: STEP reader (units, products, assembly placement, holes,
    bends), checks C01 (outer shell closure), C02 (gap rules and worst-case
    stacks), C04 (weight, doorway, pallet), C05 (drawing completeness), C06
    (BOM completeness), C07 (fastener schedule), C08 (hole alignment), C09
    (edge distance, bend radius, hole-to-bend), C10 (mixed metals), C11
    (material grade and finish); the findings register and 18 offline tests.
    v2/04-Checks/: findings register (rendered from findings.json), the gap,
    sheet-metal and stack rule files, the first run on main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
    [bolt-joints.step, clash-allow.csv, contributors.csv, door-swing.csv, fastener-schedule.csv, gap-rules.csv, hole-rules.csv, mass-adjustments.csv]
2026-10-31 Layout study: P04 weight roll-up with tonight's CAD masses and five savings (#38)
    ISS-081 / F-010. scripts/rollup.py recounts the decided build on skeleton P04:
    the teams' CAD masses (CEILING PR #32, FRONT PRs #27 and #28, WALL's L1), D-60's
    air parts from the air report (61.8 kg with fans), the wall trays' lips (D-69),
    the 9 mm floor and its 3 mm foam (D-72, D-76), the corner tubes and bond (D-63,
    D-71), and this study's model at P04 sizes for the rest. The pod comes to
    436.3 kg, 16.3 kg over the 420 kg cap; five ranked savings keep the look and
    the sound targets (19.7 kg from the first four). run_all.py writes
    weight-rollup.md and out/parts-decided-P04.csv; --check and the six tests
    pass,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
    [parts-decided-P04.csv]
2026-10-31 Mechanical checks: P04 weight roll-up, decision-log sources, register runs (#39)
    * Mechanical checks: run on main 1073fb5: nothing new, 4 open, 0 severe
    * Mechanical checks: pod total from the P04 roll-up (436.3 kg) without double-counting; 20 kg rule on it; skeleton P03 kept as a fixed test model; runs on main 1073fb5 and e4cc460
    The layout study's P04 roll-up (#38) already holds the air parts, the tray
    lips and the 9 mm floor, so the owners' adjustments now name the list they
    apply to and only the older B1 list gets them. F-010 reads 436.3 kg, 16.3 kg
    over the cap. The P03 skeleton STEP left main with P04, so the tests keep a
    copy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
    [mass-adjustments.csv, skeleton-P03.step]
2026-10-31 Master BOM script and check; D-79 to D-81; register rows (#36)
    * Register: folder rows for ELECTRICAL and Packing and Assembly
    v2/01-CAD-Native, 02-Drawings, 03-Manufacturing and 05-Engineering
    electrical folders, v2/07-Packaging and the assembly instructions
    folder under 02-Drawings (D-78).
    * Master BOM script and check; D-79 to D-81; BOM folder row
    v2/04-BOM/build_master_bom.py reads every team's parts lists and the
    joints register's hardware (from the working tree or from git refs),
    writes the master BOM, made parts by process, bought parts with their
    status, and BOM-CHECK.md, and fails on a part with no number, a
    duplicate numbe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
    [100000_P01_POD-BOUGHT-PARTS_BOM.csv, 100000_P01_POD-MADE-PARTS-BY-PROCESS_BOM.csv, 100000_P01_POD-MASTER_BOM.csv, document-register.csv, issue-register.csv]
2026-10-31 Mechanical checks: master BOM reading, voice kit outside the cap, register runs (#40)
    * Mechanical checks: the voice cockpit kit's 4.0 kg sits outside the cap (PM weight ruling); run on main 2e90127
    * Mechanical checks: read the master BOM right (heading rows, summed family masses, source_file), drawings only for assemblies in CAD, minor row gaps folded per file; run on main fbdfc73
    ---------
2026-10-31 v2 M2: joints register, ACP bond spec, feature-rationale inputs (#23)
    * v2 M2: joints register draft (site joints, hardware, HOLDs, feature-rationale inputs)
    * Joints register: PM rulings R-J1 to R-J4, seam gap 2.26 mm for F-001, M6 x 16 from Sherex data
    * v2 M2: ACP-to-aluminium bond spec; register aligned to the refreshed layout study
    * Document register: rows for the joints register and the ACP bond spec (PM-approved exception)
    * Joints register v3 and package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
    [document-register.csv]
2026-10-31 PLAN.md to D-81; master BOM family rows named and sourced (#44)
    PLAN.md: weight (P04 roll-up 436.3 kg, 432.3 kg with the voice kit
    outside the cap, 422.8 kg live as shipped, cap 420, target 410), the
    D-60 air layout inside the pod with its calculated noise, the 9 mm
    floor on 3 mm foam and the 13 mm threshold, one bolt and 2.26 mm
    seams, about 19 dB calculated (no 30 dB aim), the teams (D-80) and a
    done / in review / open table. The PM decides and logs (D-32). The
    owner's goals and the look rule are unchanged.
    Master BOM: the POD and family rows take their Vietnamese names and
    sources from the assembly tree's node table; families 83 and 84 from
    conventions section 6. 20 tests.
    Co-authored-b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
    [100000_P01_POD-MASTER_BOM.csv]
2026-10-31 Joints register: numbers for WALL's bond set (108002), hook-and-loop (848011) and cassette edge gasket (848012) (#46)
2026-10-31 Layout study: live weight count with the PM's adopted savings, 422.8 kg as shipped (#42)
    Applies the PM's weight ruling after PR #38 (S40): clip-only cassette
    fixing, 24 kg/m3 cavity fill (provisional on T02), a 1.5 mm base band
    (provisional on BASE's check), and the voice kit's 4.0 kg reserve outside
    the 420 kg cap as its own line. Adds allowances (assumption) for the light
    shelf and the work-wall ledge (D-70) and for the named clips; the two
    ceiling lights go. The intake riser and the supply fan box ship loose, so
    the right block ships at 18.1 kg (D-03). Each applied saving is priced by
    switching it off in the same list, so the table can't drift. The CSV is
    the pod as shipped, which the me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
    [parts-decided-P04.csv]
2026-10-31 Mechanical checks: joints register merged (F-009, F-013 closed); chain stacks on its closing seam; parts lists with cut-length members, total-only masses and unnumbered hardware read right; runs to m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
    - F-009 closed: R-J6 puts Ø7.0 holes at ±0.2 from the spigot hole in the
    register; ST-03 passes with 0.05 mm. F-013 closed: the sample package
    buys M6 x 16 ISO 4762 and the 1.5 mm stop washer.
    - ST-02 and ST-04 follow R-J16: closing-seam frames 1198.99, frame gap 5.5
    inside 4.0 to 7.0; with perfect frames 5.24 to 5.76.
    - Parts lists: cut-length frame members need no part number of their own;
    a row with only a total mass is read from it; rows with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
    [contributors.csv, stacks.csv]
2026-10-31 Joints register: FRONT's family-36 bought items (368001-368007, 368101-368103), cassette edge seal at near-zero squeeze (R-J18), 2.11 corner rows (bolts set the gap) (#47)
2026-10-31 D-82 to D-84, 24 kg/m3 fill, register-aware BOM duplicate rule, PLAN weight (#48)
    * BOM check: a register number must match the register's item
    A part-list line that uses a joints-register number is compared with
    the register's item: size groups must agree (M6 x 16 is not M6 x 25),
    most numbered tokens must match, and at least one word. Wording, word
    order and ID tags may differ. Four new tests (24 in all).
    * D-82 to D-84; 24 kg/m3 fill; PLAN.md weight from the live count
    D-82: the fixed glass stays 4+4 (3+3 bends 58 mm). D-83: no closing
    load on the fixed glass edge: a 35 N magnetic catch in DT, a magnetic
    seal pair, hinges that ho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
    [100000_P01_POD-MASTER_BOM.csv, issue-register.csv]
2026-10-31 Mechanical checks: D-84 screen-lock rule, fastener rows by kind, register run (#49)
    * Mechanical checks: run on main 95d9ed3: F-010 reads the live roll-up, 422.8 kg as shipped, 2.8 kg over the cap
    * Mechanical checks: missing drawings follow the screen lock (D-84); fastener rows asked only for what their kind needs; SEALS family names; made hardware needs a drawing, not a maker
    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
    [policy.csv]
2026-10-31 Mechanical checks: the master BOM's register-only and copied rows are checked where they live (joints register, team parts lists), not twice; fastener metal read from the name when the row has no mat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
    The master BOM now carries 'register only' rows (hardware in the joints
    register, not yet in a parts list) and rows copied from team parts lists.
    Checking them again in the master BOM gave 62 repeated findings; their own
    lists and the register carry them.
    [fastener-schedule.csv]
2026-10-31 v2 M3: packing plan on two pallets and the 2-person assembly guide (#52)
    * Packing plan (2 pallets) and 2-person assembly guide, generated from one piece list
    v2/07-Packaging/pack.py reads the layout study's P04 roll-up (the PM's mass
    source, 422.8 kg as shipped) and its pallet and time inputs, and writes the
    packing list, the packing plan, two pallet diagrams and the numbered assembly
    guide in v2/02-Drawings/30-Assembly-Instructions/. Eleven checks run on every
    build: roll-up accounted once, 20 kg, doorway, both pallet footprints and
    heights, the glass crate, the guide's 82 bolts against the joints register
    joint by joint, the REQ-ASM-01 time limit, first-out order, labels.
    Pallet 1 (48 x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
    [910000_P01_PACKING-LIST_BOM.csv]
2026-10-31 D-85 weight savings; BOM reader: branch-changed files only, packing lists (#54)
    * D-85 weight savings; BOM reader: branch files and packing lists
    D-85: budgets for the light shelf (0.4 kg/m) and a 1.5 mm folded
    ledge, 1.0 mm inner studs in the wall panels (perimeters and the
    ceiling's cross members stay 1.2 mm), 2 back-panel studs at 393 mm,
    a hollow kick strip, poplar-core floor ply if BASE's tests pass:
    about 411.8 kg as shipped (PR #50). PLAN.md's Done row and weight.
    BOM reader: a later --ref adds only the files its branch changed
    since its merge-base, so an old untouched joints register on a team
    branch no longer hides main's; from v2/07-Packaging only family-91
    packaging items are BO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
    [100000_P01_POD-MASTER_BOM.csv, issue-register.csv]
2026-10-31 Layout study: D-85 applied, 412.2 kg as shipped (7.8 under the cap, 2.2 over 410); 24 kg/m3 fill rows (#50)
    * Layout study: cite D-81, keep the voice kit line in the CSV (the check leaves it out of the cap), fixed glass 3+3 out, nine ranked candidates toward 410 kg
    The mechanical check (PR #40) leaves the voice kit's line out of F-010 by
    its name, so the CSV keeps every line again. D-81 now logs the weight
    ruling; the fill stays at 24 kg/m3 as the PM's brief says (D-81's text
    says 25). The fixed glass stays 4+4 (3+3 bends 58 mm, PM). Nine
    candidates toward the 410 kg target, each with kg, risk and owner, for
    the PM to decide; lighter column and soffit faces lose the fan noise
    targets (air m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
    [parts-decided-P04.csv]
2026-10-31 Mechanical checks: run on main fc6192e: F-010 closed, the pod is 412.2 kg as shipped (layout study's live roll-up, D-85), 7.8 kg under the 420 kg cap (#56)
2026-10-31 D-86, D-87; weight 412.2 kg from #50; BOM register match: product names (#57)
    D-86 (BASE): 1.5 mm band with a load block at each glide and a
    1.5 mm rivnut coupon; poplar-core 9 mm ply with a hard face veneer;
    the base seal at the floor's edge against the band's inner face.
    D-87: assembly time cuts (factory-fitted air pieces, preset glides
    and hook-in corner keys, bonded floor foam, tested harness with a hub
    self-test), film peeling inside the clock, about 126 minutes for two.
    PLAN.md, requirements, issues and README: 412.2 kg as shipped (PR #50),
    7.8 kg under the cap, 2.2 kg over 410; the 126-minute count.
    BOM: a register item named by its requirement ('base seal, gap 10
    +/-5') now matches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
    [issue-register.csv]
2026-10-31 Skeleton P04 updated in place: floor 9, threshold 13, glass edge 4.0, bolt rules, frame vs skin widths (#58)
    * WIP skeleton update in place: floor 9, threshold 13, F-014 glass edge, wall-to-band bolt rule (P04 new version)
    * WIP skeleton update in place: floor 9, threshold 13, F-014 glass edge, wall-to-band bolt rule (P04 new version)
    * Skeleton P04 updated in place: floor 9, threshold 13, glass edge 4.0, bolt rules, frame vs skin widths
    New: skeleton_update.py changes the skeleton without cutting linked parts.
    It opens the cloud file, adds missing parameters and syncs every e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
    [100000_P04_POD-SKELETON-PARAMETERS.csv, 100000_P04_POD-SKELETON_CAD.f3d, 100000_P04_POD-SKELETON_STEP.step]
2026-10-31 Assembly guide: D-87 applied, 2-person clock 168 to 127 min (#59)
    * Assembly guide: the five biggest time sinks, each fix priced with the time model
    pack.py gets a what-if layer: each fix changes a copy of the steps and the
    outside fixings and the same model prices it. Five fixes (air parts
    factory-fitted and hooked, fewer loose pieces with parts staged at their
    place, preset glides and hook-in corner keys, a hub self-test, film and
    cleaning after the clock) save 11.4, 10.7, 11.8, 8.1 and 5.8 minutes alone,
    about 47 together: 168 to about 121 minutes. None is decided; the PM
    decides. The guide's section 6 carries the table.
    * Packing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
    [910000_P01_PACKING-LIST_BOM.csv]
2026-10-31 Layout study: re-run on the updated skeleton P04 with D-86 and D-87, 412.5 kg as shipped; item names the packing plan reads restored (#61)
    Skeleton P04 was updated in place (PR #58): the back panels' frames are
    1198.99 mm under their 1200.61 mm skins (a few grams); the 9 mm floor was
    already in. D-86 settles the 1.5 mm band and the poplar-core floor and
    adds an aluminium load block at each glide (+0.4 kg); D-87 joins the
    riser to the supply fan box (14.9 kg with its fans) and fits the exhaust
    fan box in the soffit (13.9 kg), both under 20 kg. The pod comes to
    412.5 kg as shipped: 7.5 kg under the cap, 2.5 kg over the 410 kg target.
    PR #50 renamed three lines (back panels, floor, door unit)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
    [parts-decided-P04.csv]
2026-10-31 Packing plan on the live roll-up: 412.5 kg as shipped, glide load blocks, step-picture prep (#62)
    * Assembly guide: door catch 368007 and strike 368102 (D-83), base seal at the floor edge (D-86), one time-sink list
    * Step pictures: label-to-skeleton-body map, check K12, step-bodies data for the Fusion picture run
    * Packing plan: D-85 to D-87 masses, 412.5 kg as shipped; glide load blocks on the band pieces
    - The roll-up's new D-86 line (glide load blocks, one inside the band at
    each glide) rides on the four band pieces that carry the glides, split
    by glide count: back 3, s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
    [910000_P01_PACKING-LIST_BOM.csv]
2026-10-31 Control pack: skeleton P04 updated in place (PR #58) (#60)
    ISS-086 decided: the skeleton carries floor_t 9, thresh_h 13 (kick
    strip Z 20 to 105), glass_gap 4.0, the 220 mm bolt rule and the
    closing seams (5.5 mm gap, 1198.99 mm frames); WALL and BASE relink
    next, and the wall-to-ceiling bolt counts wait on the PM. Notes on
    D-65, D-72, D-74 and D-75; REQ-BLD-01, -06 and -08 read the skeleton;
    PLAN.md's Done row.
    [issue-register.csv]
2026-10-31 Packing list: B2 ships with the power unit 710001, 11.56 kg (ELECTRICAL PR #64) (#65)
    The power unit (2.804 kg, ELECTRICAL's calculation) is fitted, wired and
    tested in B2 at the factory, so B2 ships at 11.56 kg instead of 8.76. Its
    face stands 38 mm proud of B2's frame (felt plane Y 766, frame Y 804), so
    B2's stack thickness goes to 84 mm (pallet 1 stack 904 of 1016 mm) and a
    foam block protects the face. Pallet 1 is 228 kg gross. Not in the roll-up
    yet: when ELECTRICAL's list reaches it, check K1 flags the new line and
    the mass moves there.
    [910000_P01_PACKING-LIST_BOM.csv]
2026-10-31 Roll-up and air report: ELECTRICAL's mass and heat; 415.4 kg as shipped, two people at 4.0 K over the room at 53 l/s (#66)
    ELECTRICAL P01 (PR #64) is 4.94 kg as shipped against the 3.05 kg
    allowance: the roll-up's electrical line takes it, and the pod comes to
    415.4 kg, 4.6 kg under the cap and 5.4 kg over the 410 kg target. The
    light shelf budget may hold the same LED strip, about 0.2 kg, noted.
    The air report's heat model takes ELECTRICAL's loads: the light shelf
    26.6 W and call light 2.7 W (replacing D-20's 21 W of lights), the hub
    3 W (already in as the controller), the supplies' losses 9.9 W and the
    supply fans by the cube law on the model's speed (5.2 W at 53 l/s), with
    12 W of supply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
    [parts-decided-P04.csv]
2026-10-31 Air report: the voice kit at D-88's 40 W average holds 4 K at 64 l/s (29.4 dB(A)); roll-up: the LED strip counted once, 415.2 kg (#68)
    D-88 gives the voice kit a 40 W average power budget (the 60 W peak
    stays on the hook). With about 8 W of supply loss at that average
    (ELECTRICAL's 12 W at 60 W, scaled), two people and the kit hold 4 K at
    64 l/s, about 29.4 dB(A), inside the 30 dB(A) boost; at the 65 l/s boost
    the inside is 3.94 K over the room.
    The light shelf's budget no longer carries its LED strip (0.22 kg), which
    ELECTRICAL's line holds. The pod comes to 415.2 kg as shipped, 4.8 kg
    under the cap and 5.2 kg over the 410 kg target.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
    [parts-decided-P04.csv]
2026-10-31 Joints register: hook-in base corner keys (J-BASE-02, 111211-111214), DL/DR on spigots and DT to the ceiling (J-FRONT-02/03), BASE's glide, nut and end cap rows, D-86 base seal, ceiling bolt lines co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
2026-10-31 Assembly guide: every site fixing from the joints register (86 bolts); B2's power unit from ELECTRICAL's line (#70)
    * Assembly guide: step-picture script for the Fusion runner (not run yet: screen locked)
    step_pictures.py opens skeleton P04's STEP as its own document, shows the
    bodies fitted up to each step (new ones solid, earlier ones faded), turns
    the camera per step and saves one PNG per step; pack.py then puts each
    picture under its step. UNVERIFIED until the first run on an unlocked
    screen. Test: the script compiles and its views match the step data.
    * Assembly guide on the joints register's 86 site bolts (#69); B2's power unit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
    [910000_P01_PACKING-LIST_BOM.csv]
2026-10-31 Release checklist (script-built, per-team totals) and draft FAI plan; D-88; weight 415.2 kg (#73)
    * WIP (task moved): draft FAI plan and release checklist script
    Draft v2/06-Verification/fai-plan.md: 44 part characteristics and 10
    functional checks, all PLANNED, each with its source and status.
    v2/00-Control/build_release_checklist.py: reads the parts lists, the
    joints register, the files by part number, the FAI plan and the test
    plans (working tree or git refs), and writes the per-team checklist.
    Not done: register rows for 06-Verification and the new files (the
    control pack check fails until then), the generated checklist, tests.
    *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
    [document-register.csv, issue-register.csv]
2026-10-31 Mechanical checks: D-89 drawing rule; BOM-to-CAD match per team; shared hardware drawings to the Joints Engineer (#75)
    * Mechanical checks: a team's parts list is matched against the CAD only once that team has STEP files, and the master BOM not at all; shared hardware drawings (83, 84) go to the Joints Engineer; run on main 3e23e4b: 0 findings
    * Mechanical checks: D-89 in the drawing check: a number listed in a tabulated drawing counts as drawn; a plain felt or fill rectangle passes on a cut-list row with size, material, tolerance and part number
    ---------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
2026-10-31 Mechanical checks: D-89 tuned (parts list as cut list, pockets need a drawing); duplicate names ignore hyphens; run on main 40ccd24 (#76)
    * Mechanical checks: duplicate numbers: the same words in the same order are one name (hyphens and case ignored)
    * Mechanical checks: D-89: a parts-list row with size, material and tolerance serves as the cut list; felt or fill with pockets (more than a block's 6 faces) is not a plain rectangle
    * Mechanical checks: run on main 40ccd24: 0 findings
    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
2026-10-31 D-89: tabulated drawings and felt/fill cut lists count as drawn; PLAN Target 1 leads with 415.2 kg (#77)
    - D-89 logged: a part on a tabulated drawing (identical or mirrored shapes on
    one drawing that says TABULATED and lists every number) counts as drawn; a
    plain knife-cut felt or fill rectangle needs no drawing when a cut list
    gives its number, size, material and tolerance. Pointer in D-84; REQ-DOC-01.
    - The release checklist reads D-89 the way the mechanical check does (PR #75):
    a drawing whose text says TABULATED covers the other numbers of its family
    and kind; a cut list is a .csv with "cut" in its name; a felt or fill row
    that names pockets, notches or holes keeps its drawin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
    [document-register.csv]
2026-10-31 Mechanical checks: glide doubler ruling as an exception; D-89 as logged; D-80 owners (#78)
    * Mechanical checks: the glide doubler ruling as an edge-distance exception; D-80 team owners (ELECTRICAL, CEILING's AIR and INTERIOR, Packing and Assembly); a part's owner from the STEP or list holding it; D-89 as logged (a cut list has CUT in its name; rows naming pockets keep the drawing)
    * Mechanical checks: run on main deeecf9: 0 findings
    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
    [edge-exceptions.csv]
2026-10-31 D-89 part (3): soft goods by DXF or a full cut-list line; the checklist reads it as the mechanical check does (#79)
    - D-89 gains part (3), the PM's ruling: soft goods cut from sheet or roll (foam,
    gaskets, seals, tape) need no drawing when a DXF gives their outline (any
    shape, holes included) or, for plain strips and rectangles, a cut-list line
    gives size, thickness, material, tolerance and part number. A parts-list row
    that gives the same serves as a cut list. REQ-DOC-01 follows.
    - The release checklist classifies soft goods by the name's head noun, as
    tools/checks/common.py does (a test compares the two), reads parts-list rows
    as cut lists (as #76 does), and adds the DXF and th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
2026-10-31 Mechanical checks: D-89 per the PM ruling (parts-list row as cut list; soft goods by DXF or full row); run on main 58a05e3 (#80)
    * Mechanical checks: D-89 per the PM ruling: a parts-list row serves as the cut list again; part (3): other soft goods by a DXF or a full row with thickness
    * Mechanical checks: run on main 58a05e3: 0 findings
    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
2026-10-31 Register: folder rows for the Joints Engineer's made hardware (CAD, drawings, manufacturing) (#81)
    - V2-CAD-JNT, V2-DWG-JNT and V2-MFG-JNT for v2/01-CAD-Native/joints/,
    v2/02-Drawings/joints/ and v2/03-Manufacturing/joints/: the locating spigot
    831001, the stop washer 831002 and the base corner and inline keys 111211 to
    111214, PLANNED.
    - The release checklist files a part found only in a joints folder under
    JOINTS, the team name the master BOM gives that folder; one test.
    [document-register.csv]
2026-10-31 Mechanical checks: F-017/F-018 on the base corner key (bolts past the threads, heads near the floor); run on main b35fe8f (#82)
    * Mechanical checks: F-017 (severe) and F-018 (major) on the joints register's base corner key: its M6 x 16 bolts reach past the 12 mm tapped holes, and their heads hang 7.6 mm under the band on 10 mm glides; joints hardware folders to the Joints Engineer; run on main b35fe8f
    * Mechanical checks: F-017 and F-018 posted to the Joints group
    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
2026-10-31 D-89 part (4): flat sheet parts by DXF and a full parts-list row; the checklist reads it (#83)
    - D-89 gains part (4), the PM's ruling: a flat part cut from sheet (laser,
    waterjet or CNC router) with no bends and no machined features needs no
    drawing when its DXF gives the full outline and every hole, and its
    parts-list row gives material, thickness, finish, a general tolerance
    (ISO 2768-m) and any critical hole note; folded, machined, welded or bonded
    parts and every assembly keep drawings. REQ-DOC-01 follows.
    - The release checklist counts such a part as drawn when it has its own DXF
    and a row whose process names laser, waterjet or router and no bend, fold,
    groove, lap, machin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
2026-10-31 Packing list: the fixed glass's bottom U-channel ships fitted on BASE's sill (PM ruling); channel masses ride in the parts that hold them (#84)
    - The sill (2-07) carries the bottom U-channel and its seal, fitted at the
    factory with 4 M3 countersunk screws; DR carries the right and diagonal
    channels, DT the top one (D-68). Their masses move off the glass by
    FRONT's parts-list lengths (745, 1446 + 804, 303 mm of 0.798 kg); the
    glass piece keeps the pane and its 180 seal.
    - Steps 2 and 10 say the channel is already on the sill; the glass drops
    into it. No site step fits a channel.
    - Removes a compiled cache file that #70 carried in by mistake, and
    ignores __pycache__ in the guide fo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
    [910000_P01_PACKING-LIST_BOM.csv]
2026-10-31 Mechanical checks: D-89 part 4 (flat sheet parts on their DXF and row, read as the release checklist reads it, with its test cases; a BEND-layer line, a STEP that isn't flat or a DXF missing a hole k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
2026-10-31 Release checklist: a DXF with any BEND-layer line keeps the drawing (D-89 part 4) (#87)
    - D-89 (4) can't be fooled by a process word: a part whose DXF has any entity
    on the BEND layer (the guideline's CUT, BEND and MARK layers, section 9)
    keeps its drawing, whatever its row's process says. A DXF that can't be read
    (empty or binary) can't show the part flat either. Only the ENTITIES and
    BLOCKS sections count, so the layer table naming BEND doesn't.
    - Tests: the layer reading, and a folded tray whose row says only "laser"
    (36 in all). On the teams' real DXFs the trays, ribs and WALL's skin read
    as bent; CEILING's skin and BASE's floor as flat.
    - release-checklist.md re-run on main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
2026-10-31 Mechanical checks: D-89 part 4: only CUT and MARK layers in a flat part's DXF; run on main fbecb5d (#88)
    * Mechanical checks: D-89 part 4: a folded or machined part's finding says only what keeps its drawing
    * Mechanical checks: D-89 part 4: only the CUT and MARK layers in a flat part's DXF (block records are not lines; an unreadable DXF can't show a part flat); run on main fbecb5d
    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
2026-10-31 D-89 part (4): only the CUT and MARK layers pass; the checklist reads every drawn layer (#89)
    - PM ruling: for D-89 part (4) a DXF may draw only on the CUT and MARK layers;
    a line on any other layer (BEND, a pocket, an engraving, a half-lap) keeps
    the drawing. Added to D-89's text and REQ-DOC-01.
    - The release checklist lists the layers a DXF draws on: its ENTITIES, plus a
    block's content only where an INSERT places it (so the arrow-head blocks a
    DXF library writes, never inserted, don't count). Any layer other than CUT
    and MARK, or an unreadable DXF, keeps the drawing; the drawing column names
    the layers. Tests: the layer reading, blocks and inserts, the folded tray,
    BASE's ha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
2026-10-31 Release checklist: read DXF layers exactly as the mechanical check does (#88) (#90)
    - D-89 (4)'s layer reading now matches tools/checks/c_drawings.py
    (dxf_summary, PR #88): every entity in the ENTITIES and BLOCKS sections
    counts, except the records BLOCK, ENDBLK, VERTEX and SEQEND, so a block
    header on layer 0 isn't a line. It replaces #89's "blocks only where
    inserted" reading.
    - Tests: block records and a polyline's records don't count, a line inside a
    block does, and the reading equals the check's own function on five sample
    DXFs (40 tests).
    - On BASE's floor DXF both tools now list POCKET-HALF-DEPTH and 0: the 0 is
    three shapes inside arrow-head blocks the DXF library write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
2026-10-31 Mechanical checks: D-89 part 4 reads DXF layers with the release checklist's own reader: only drawn entities count, and a stored block only where an INSERT places it (no false layer 0 from unused arr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
2026-10-31 Skeleton P04 follow-up, updated in place: back pitches on the frame, bolt lines, counts, floor mat (#94)
    PM rulings and Reviewer 5's notes on #58 (one in-place update, P04 version 4):
    - Back-panel bolt pitches on the frame: back_base_pitch and ceil_back_pitch
    from half_fw (253.00); "panel end" means the frame end (P2).
    - Wall to ceiling: n_ceil_side_bolt 4, n_ceil_back_bolt 4 (DECIDED).
    - Each bolted edge's start and pitch from the joints register: ceil_side_y0
    -645 along the ceiling with ceil_side_pitch 351.67; ceil_back_x0,
    base_side_y0, base_back_x0.
    - D-72 floor mat: mat_t 3 under the 9 mm ply; F1, F2 now Z 3 to 12 and
    F1-MAT, F2-MAT Z 0 to 3, built in place; floor_top 12. Thresh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
    [100000_P04_POD-SKELETON-PARAMETERS.csv, 100000_P04_POD-SKELETON_CAD.f3d, 100000_P04_POD-SKELETON_STEP.step]
2026-10-31 One shared DXF layer reader for the release checklist and the mechanical check (D-89 part 4) (#96)
    * Release checklist: a stored DXF block counts only where an INSERT places it (PM ruling)
    - PM ruling: both tools count a stored block only where the drawing places it
    (an INSERT), so arrow-head blocks a DXF library writes and never places
    don't hold a flat part back. The block records (BLOCK, ENDBLK, VERTEX,
    SEQEND) never count. Logged in D-89's text.
    - The checklist reads every entity in ENTITIES, and an INSERT adds its
    block's shapes, nested inserts included; shapes on layer 0 take the
    INSERT's layer. Tests: unplaced arrow-head blocks, a placed block with a
    bend line, layer-0 sh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
2026-10-31 Packing plan: panel sizes from the skeleton's named values (v4, #94); floor mats mapped for the pictures (#97)
    - pack.py reads the skeleton parameter file's values: outer panels from
    side_l, side_h, half_pw, back_ph and outer_t; the ceiling halves from
    wall_depth and half_pw; the floor from wall_depth - band_t and
    floor_t + mat_t; B2's power-unit face from cav_gap + cass_t; every
    lining from cass_t. The lining lengths aren't named in the skeleton and
    stay as its build record gives them.
    - Skeleton v4 models the floor mats (F1-MAT, F2-MAT): they map to the
    floor panels they ship bonded under (check K12).
    - Test: the sizes follow the skeleton.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
    [910000_P01_PACKING-LIST_BOM.csv]
2026-10-31 Layout study: the roll-up reads skeleton P04's named values (v4, PR #94); no change in mass, 415.2 kg (#98)
    The panel sizes now come from the skeleton's parameter table by name
    (side_l, side_h, back_ph, half_pw, half_fw, wall_depth, frame_t,
    stack_t, floor_t) instead of copies, as the PM asked of every design.
    Skeleton v4 changes none of them, so the part list is unchanged and the
    packing plan needs no regeneration. The linings and floor panels, not
    named in the skeleton, stay from its build record.
2026-10-31 Mechanical checks: door swing moves the whole door unit; seam rules skip ELECTRICAL's reserved spaces; DXF layers from the shared reader; run on main a35af8f (#95)
    * Mechanical checks: the door swing moves everything in the door unit's file but the hinges (its glazing U-seal was left standing and showed as a false hit at 0.5 degrees); run on main 8aa50c0
    * Mechanical checks: the seam rules leave out ELECTRICAL's 71xxxx reserved spaces (routes, pockets, grommets named with position codes)
    * Mechanical checks: the DXF summary reads only units and circles; layers come from the sha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
    [door-swing.csv, gap-rules.csv]
2026-10-31 WALL sample P01: L1 panel and cassette (native Fusion, STEP, DXF, parts list) (#41)
    * WALL sample: build script for the side panel and its lining cassette
    wall_side_panel.py builds one side wall panel (frame, ACP skin, PET fill)
    or its lining cassette (tray, felt, HOLD clip zones) as a native,
    parameter-driven Fusion design in pod coordinates. Pod sizes come from
    skeleton P03's own PARAMS (parsed from pod_skeleton.py, never copied).
    test_wall_offline.py checks the parameter values and part numbers
    without Fusion.
    * WALL sample: L1 panel and cassette built, exported and edit-tested
    Native .f3d and STEP (cm, declared; D-13) for 210101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
    [210101_P01_WALL-PANEL-ASSY-SIDE-LOWER-LH_BOM.csv, 210101_P01_WALL-PANEL-ASSY-SIDE-LOWER-LH_CAD.f3d, 210101_P01_WALL-PANEL-ASSY-SIDE-LOWER-LH_STEP.step, 211101_P01_WALL-PANEL-FRAME-SIDE-LOWER-LH_CAD.f3d, 211101_P01_WALL-PANEL-FRAME-SIDE-LOWER-LH_STEP.step, 211301_P01_WALL-SKIN-SIDE-LOWER-LH_CAD.f3d, 211301_P01_WALL-SKIN-SIDE-LOWER-LH_DXF.dxf, 211301_P01_WALL-SKIN-SIDE-LOWER-LH_STEP.step]
2026-10-31 Joints register: front corner keys, keyhole fix, soffit and air column hooks, M3 glass channel fixings (#99)
    * Joints register: front corner keys, keyhole fix, soffit and air column hooks, M3 glass channel fixings
    - J-BASE-02: one machined key block for all six band joints, in four cuts:
    111211 square (both back corners and the FR1 inline joint, 3 per pod),
    111212 FL corner 24.14 deg, 111213 FR corner 24.02 deg, 111214 left knee
    7.25 deg. Block 35 x 75 x 25, studs 26 and 60 above its bottom (Z 37.5
    and 71.5). HOLD-14 closed with BASE's front geometry.
    - Keyhole fix: the moving piece goes down onto the studs, so the Ø12 entry
    sits 10 below the stud's seat and the slot runs up (the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
    [corner-keys.csv]
2026-10-31 Assembly guide: the soffit's 2 lock screws (J-AIR-01), 88 site bolts (#102)
    sits 10 below the stud's seat and the slot runs up (the old note had it
    upside down).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
2026-10-31 Decision log: D-90 to D-92 (HOLD-18 studs, drawings while starts are paused, ELECTRICAL's reserved spaces) (#103)
    - D-90: HOLD-18 closed: the soffit's hanger studs stay M6 x 16 socket heads
    (838001); AIR gives at least 7.5 mm of head room, with the soffit's
    underside kept at Z 2120 (Joints group, PR #99).
    - D-91: while the drawing starts are paused, a model that passes every other
    check merges; its missing drawings stay severe and open and follow on a new
    branch. Pointer in D-84.
    - D-92: ELECTRICAL's 71xxxx route bodies are reserved spaces, not panels; the
    seam rules skip them (ELECTRICAL's report on PR #64; the check, PR #95).
    - PLAN.md's decision range moves to D-92.
    Co-authored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
2026-10-31 Mechanical checks: shared hardware drawings stay with the Joints Engineer; run on main 94d217d (#100)
    * Mechanical checks: a shared hardware drawing (83, 84) stays with the Joints Engineer when a team models the part; run on main 94d217d
    * Mechanical checks: run on main 6ccbfac (WALL #41 merged): F-019 to F-024 WALL drawings, F-025 and F-026 the Joints Engineer's spigot and stop washer drawings
    * Mechanical checks: F-019 to F-026 posted to their groups
    * Mechanical checks: F-017 and F-018 closed by the joints register's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
    [fastener-schedule.csv]
2026-10-31 Roll-up: WALL L1's CAD masses read from its merged parts list (PR #41), 415.1 kg as shipped; packing outputs regenerated (#106)
    The roll-up now reads WALL's parts list 210101/510101 on main: L1 and
    R1's outer panels are the frame (its mid stiles at 1.0 mm), skin, fill
    at 24 kg/m3 and bond set, 11.16 kg each; the side lower cassettes are
    the tray with lips, felt and seals, 10.35 kg each. The hardware stays in
    the fixings kit's line and the clips in the named clips' line. Every
    line now says its basis (CAD on main, CAD in an open PR, or estimate),
    and the page lists each swap with the estimate, the CAD value and the
    difference (-0.08 kg in all). pack.py was rerun and its outputs carry
    the new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
    [910000_P01_PACKING-LIST_BOM.csv, parts-decided-P04.csv]
2026-10-31 Assembly guide: a picture from the Fusion model under each step with parts (13 steps) (#108)
    step_pictures.py ran through the Fusion runner on skeleton P04's cloud
    design (version 4), opened by itself, never saved and closed without
    saving; it refuses when the design is already open, and skips unreadable
    folder entries as the runner does since #86. Each picture shows the
    step's new part envelopes solid and the parts fitted before faded: from
    behind for the shell, from the front for DL, the glass, DR, the door and
    DT, from above with the ceiling and front hidden for the linings. pack.py
    puts each picture under its step. Pictures of the real parts replace the
    envelopes as each part's CAD merge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
2026-10-31 FRONT door unit P01: native model, STEP, DXF, parts list (drawings to follow) (#27)
    * FRONT door unit P01: native model, STEP, DXF, parts list, edit test
    360001 FRONT - DOOR UNIT built by script on skeleton P03's own parameter
    list: the 4+4 leaf on the skeleton trapezoid running 25 mm into an 85 mm
    zone kick strip (78 mm H-section over a 7 mm floor gap), the athmer GSA
    drop seal, the Bohle silicone U-seal, and HOLD spaces for three hinges,
    the lock and the pull (no holes in the glass until they are named).
    Build: 10 bodies, 0 unhealthy, 0 loose sketches, 4 listed clashes. STEP in
    cm as declared (D-13), box MATCH. Edit test PASS on a copy. Drawings wait
    for the no-click drawing start.
    Co-A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
    [360001_P01_FRONT-DOOR-UNIT_BOM.csv, 360001_P01_FRONT-DOOR-UNIT_CAD.f3d, 360001_P01_FRONT-DOOR-UNIT_STEP.step, 361001_P01_FRONT-DOOR-LEAF-4-4-LAMINATED_DXF.dxf, 361002_P01_FRONT-DOOR-KICK-STRIP_DXF.dxf]
2026-10-31 Air report against AIR #91 and BASE's intake: 25.6 / 30.05 dB(A) at 53 / 65 l/s (calculation); roll-up 415.0 kg; packing regenerated (#110)
    Every air-path size the report uses, checked against AIR's build (PR #91,
    read from its own model) and BASE's intake at X 920. The model now uses
    them: the column 212 wide and 5 mm off the lining, which puts the supply
    cartridge 6 mm further left and leaves 21 mm of fill at the column's left
    face (27 sized here); AIR's perforated grilles; D-61's roof Y; BASE's
    0.0297 m2 intake (set through the intake options, so it sticks). Fan
    noise: 25.6 dB(A) at 53 l/s and 30.05 at 65 l/s, so the boost at 30 dB(A)
    or less reaches 64.9 l/s; with 27 mm of fill it would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
    [910000_P01_PACKING-LIST_BOM.csv, parts-decided-P04.csv]
2026-10-31 Roll-up: FRONT's door unit from its merged parts list (PR #27), 414.5 kg as shipped; packing outputs regenerated (#111)
    The door unit is now read from FRONT's parts list 360001 on main: 48.59 kg
    with the hollow kick strip (1.218 kg, D-85), the strike and magnetic seal
    half that replace the lock (D-83), and the hinges and pull still HOLD.
    That is 0.49 kg under the estimate the roll-up carried (its first list
    with D-85's 1.0 kg strip budget). The swap table lists it; pack.py was
    rerun and its outputs carry the new mass.
    [910000_P01_PACKING-LIST_BOM.csv, parts-decided-P04.csv]
2026-10-31 Mechanical checks: full door sweep with soft seals; Fusion script clean under check_api; run on main c53b1eb (#109)
    * Mechanical checks: whole_pod_check.py passes tools/fusion/check_api.py (the result dict typed); run on main c53b1eb (roll-up on WALL's merged list, 415.1 kg)
    * Mechanical checks: the door swing sweeps all 90 degrees and records every hit; a seal it hits is soft (the door touches or wipes it), a finding only past 100 mm3
    * Mechanical checks: Fusion run on skeleton v4 (main a35af8f): 36 bodies, 0 clashes, all 10 gap rules pass (seams 2.26, kick 7.0, lining 4.0, gl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
    [door-swing.csv]
2026-10-31 Air report: AIR's supply cartridge back at X 988 to 1161 (#91 at 3b891cf): 25.2 / 29.6 dB(A) at 53 / 65 l/s (calculation) (#115)
    AIR moved the supply cartridge 6 mm right, so the column's left face has
    27 mm of fill again. With BASE's 0.0297 m2 intake the fan noise is 25.2
    dB(A) at 53 l/s and 29.6 at 65 l/s, and the boost at 30 dB(A) or less
    reaches 66.2 l/s (calculation). Heat doesn't move; with the voice kit 4 K
    holds at 62 l/s, 28.5 dB(A). Section 7j records the change. The air parts'
    masses don't change, so the roll-up and the packing plan stay as they are.
2026-10-31 Decision log: D-93 to D-99, D-91 reworded; the checklist follows D-93, D-95 and D-99 (#114)
    - D-93: 710000 is drawn by sheet 3 of its wiring diagram (item 2).
    - D-94: edge-distance exception for the glazing U-profile 368004; the rule
    applies to free edges only (item 3).
    - D-95: the corner and inline keys 111211 to 111214 have one source, the
    Joints Engineer; BASE places them by reference (item 4).
    - D-96: the inline base joint moves from X 947 to X 920 so the intake mesh
    stays fully open (about 0.0297 m2 against the 0.028 target); FR1 27 mm
    shorter (item 5).
    - D-97: drawing starts resumed with PR #101; D-91's merge rule stands without
    the pause, whatever the screen state; D-91 rewo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
    [document-register.csv]
2026-10-31 D-100 (flat ACP under D-89 part 4) and the air figures from #115 (#116)
    - D-100: a flat ACP part counts under D-89 part (4) when its DXF draws only
    on CUT and MARK and its row is full; a routed-and-folded ACP part keeps its
    drawing through its groove and fold layers. Pointer in D-89; REQ-DOC-01.
    The release checklist reads it (a test for a flat and a folded ACP skin).
    - Item 6: REQ-AIR-02, REQ-AIR-05, REQ-VCK-04, C4, PLAN, the control README,
    the decision log's headline and ISS-073 now give the air report on main
    (PR #115): 25.2 dB(A) at 53 l/s, 29.6 at 65 l/s, the boost reaching 66.2 l/s
    at 30 dB(A), 28.5 dB(A) at the voice kit's 62 l/s (calculation).
    - Ranges to D-100.
    Co-auth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
    [document-register.csv, issue-register.csv]
2026-10-31 Sample package check: accept three-digit decision numbers (D-100 onward) (#117)
    The decision log reached D-100; check_package.py matched D-\d\d only, so
    it would skip a D-1xx citation and fail a test row citing only one.
2026-10-31 Mechanical checks: D-93, D-95, D-97, D-99, D-100 (drawings severe, part 4 for metal and ACP, register names, base keys to Joints) (#118)
    * Mechanical checks: D-93 (wiring diagram draws 710000), D-95 (base keys are the Joints Engineer's), D-97 (missing drawings severe whatever the screen), D-99 (part 4 for metal sheet only; hardware names from the joints register); run on main a58e9e8
    * Mechanical checks: D-100: a flat ACP part counts under D-89 part 4, as the checklist reads it
    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
    [policy.csv]
2026-10-31 FAI plan: a line for every made part (FRONT's DR block first) with its sample; the checklist flags any made part without one (#119)
    - 12 new lines for FRONT's DR decor block (PR #105): the assembly's shape on
    its spigots and the mass as it ships, the ACP skin, the welded frame and its
    holes, the back plate's 6 critical rivnut holes, the access panel, the inner
    panel and its felt, the air supply assembly, the riser and the fan box.
    Limits only from FRONT's parts list, the joints register, the air table and
    the decisions; the rest say "pending: set on the drawing (HOLD)", with the
    reason (the critical holes' position, the fan box's finish, clips, gasket).
    - Every FAI line now gives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
2026-10-31 Register INTERIOR's bought ledge bracket 818101 and screen rail 818102 (names as INTERIOR's list, product HOLD; D-99) (#120)
2026-10-31 BASE P01 sample: back-left corner and F1 (CAD, part designs, STEP, parts list, cut files) (#55)
    * BASE P01 sample: build script for the back-left corner and F1
    Native Fusion build of 110000 BASE, sample scope: left side band (mitred
    to DL's outer facet), back band, corner bracket BL, glides, J-BASE-01
    rivnut and locating-pin holes, floor panel F1 with its seal mat. Sizes
    come from skeleton P03's parameter list at run time; BASE parameters
    carry a status and source. Steps 1-9 run clean in Fusion: 26 sketches
    fully constrained, 123 timeline items healthy, boxes match the skeleton.
    * BASE P01 sample: native CAD and STEP from the saved c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
    [110000_P01_BASE-TUBE-CUT-LIST_SPEC.csv, 110000_P01_BASE_BOM.csv, 110000_P01_BASE_CAD.f3d, 110000_P01_BASE_STEP.step, 111101_P01_BASE-BAND-TUBE-SIDE-LH_CAD.f3d, 111101_P01_BASE-BAND-TUBE-SIDE-LH_STEP.step, 111103_P01_BASE-BAND-TUBE-BACK_CAD.f3d, 111103_P01_BASE-BAND-TUBE-BACK_STEP.step]
2026-10-31 After BASE #55: BOM names from the register, FAI for the glide doubler, D-101 and D-102 (#122)
    * After BASE #55: master BOM with the register's seal name, FAI for the glide doubler, D-101 and D-102
    - Master BOM regenerated on main dc61ad9: 118001 is now "BASE - BASE SEAL -
    FLOOR EDGE - FIXED 4 GAP", as the joints register and BASE's list name it
    (it showed the old GAP 10 +-5 while only the register listed it).
    - FAI plan: K-B09 for BASE's glide doubler 111601 (52 x 36 x 3, the
    critical Ø13 +0.10/0 hole centred +-0.2, from BASE's row; drawn by its DXF
    and row, D-89 part 4). Every made number has an FAI line.
    - D-101: no cloud Save Copy As inside a Fusion run (item 10).
    - D-102: the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
    [100000_P01_POD-BOUGHT-PARTS_BOM.csv, 100000_P01_POD-MADE-PARTS-BY-PROCESS_BOM.csv, 100000_P01_POD-MASTER_BOM.csv, document-register.csv]
2026-10-31 Mechanical checks: run on main dc61ad9 (BASE merged): doubler passes as ruled, names by words, stale master BOM name to PM (#123)
    * Mechanical checks: run on main dc61ad9 (BASE #55 merged): F-033 to F-047; a plate's top and bottom edge count as one edge for the doubler ruling (F-036 closed), names compare by their words (F-038 closed), a stale master BOM name goes to the PM (F-034); Fusion wait 2 h
    * Mechanical checks: F-033 to F-047 posted to their groups
    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
    [fastener-schedule.csv]
2026-10-31 FRONT fixed glass unit P01: native model, STEP, DXF, parts list (drawings to follow) (#28)
    for the no-click drawing start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
    [360002_P01_FRONT-FIXED-GLASS-UNIT_BOM.csv, 360002_P01_FRONT-FIXED-GLASS-UNIT_CAD.f3d, 360002_P01_FRONT-FIXED-GLASS-UNIT_STEP.step, 361003_P01_FRONT-FIXED-GLASS-4-4-LAMINATED_DXF.dxf]
2026-10-31 Roll-up: BASE's sample from its merged parts list (PR #55), 412.9 kg as shipped; packing outputs regenerated (#124)
    The roll-up now reads BASE's parts list 110000 on main for the parts its
    P01 sample models: the back and side band tubes at 1.5 mm (the right side
    as the left's mirror), the two back corner keys, the glide doublers that
    D-86's load blocks became (8 x 0.014 kg against 0.4 kg), the HOLD
    levelling glides, floor panel F1 in poplar-core ply (F2 as its mirror) and
    its foam mat. The front bands and front keys stay estimates until BASE
    P02; BASE's hardware stays in the fixings kit's line. -1.65 kg in all; the
    swap table lists each line, and the corner key line is marked part CAD.
    pack.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
    [910000_P01_PACKING-LIST_BOM.csv, parts-decided-P04.csv]
2026-10-31 Mechanical checks: D-94 exception (368004); master BOM views not parts lists; run on main 284dae7 (#125)
    * Mechanical checks: D-94 exception for the glazing U-profile 368004; the master BOM's source suffix and its generated views no longer read as parts lists (F-048 to F-090 were the check's own, closed unposted); run on main 284dae7 (BASE, FRONT #28 merged): F-034 closed
    * Mechanical checks: F-095 to F-097 posted to FRONT
    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
    [edge-exceptions.csv, fastener-schedule.csv]
2026-10-31 Roll-up: FRONT's fixed glass unit from its merged parts list (PR #28); 412.9 kg as shipped; packing outputs regenerated (#126)
    The fixed glass unit is now read from FRONT's parts list 360002 on main:
    29.54 kg (the 4+4 pane 28.59, the U-profile and U-seal, and one half of
    the magnetic seal that D-83 puts on the glass edges), 0.04 kg under the
    estimate from its first list. The swap table lists it, the 3+3 rejection
    uses the CAD pane, and pack.py's outputs carry the new mass.
    [910000_P01_PACKING-LIST_BOM.csv, parts-decided-P04.csv]
2026-10-31 Joints register: corner keys 30 long, fixing holes 10.5 from the key's edges, inline joint at X 915; key positions regenerated for BASE (#127)
    - J-BASE-02: the key block is 30 long on its centre line (was 25), so the
    carrier's Ø7.0 fixing holes sit at least 2 x 7 from its cut end: 14.9 on
    the front corners, 18.5 at the knee, 19.5 on the square keys (PM note).
    Its fixing holes are 10.5 from its back face and 7.0 either side of its
    centre line (10.5 from its sides: over 2 x the hole, mechanical check C09).
    - The inline joint moves to X 915 (BASE: from X 947 to 920 for the open
    intake mesh, then to 915, a 32 mm stub, for the 30 mm key); FR1 runs X 218
    to 915; the glass channel over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
    [corner-keys.csv]
2026-10-31 After FRONT #28: master BOM, the corner keys' FAI at 30 mm, D-103, the live weight 412.9 kg (#128)
    - Master BOM regenerated on main 2f7a851 (FRONT's fixed glass unit list on
    main). BOM check OK.
    - D-103 (item 12): the corner keys grow from 25 to 30 mm so the key and band
    holes both keep 2 diameters (band holes 14.9 to 19.5 mm from the cut ends),
    and the FR1 to intake joint moves to X 915 (a 32 mm stub) to keep the
    longer key clear of the mesh; amends D-96 and D-102 (pointers added).
    - FAI plan: K-B08 now gives the key family at 30 x 35 x 75; K-B10 the band
    holes 14.9 to 19.5 mm from the cut ends. Every made number has a line.
    - Weight to the live count, 412.9 kg as shipped (7.1 und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
    [100000_P01_POD-BOUGHT-PARTS_BOM.csv, 100000_P01_POD-MADE-PARTS-BY-PROCESS_BOM.csv, 100000_P01_POD-MASTER_BOM.csv, document-register.csv, issue-register.csv]
2026-10-31 FAI plan: FRONT's DT decor block (K-D13 to K-D17); checklist re-run (#129)
    - Five lines for the top decor block DT in FRONT's open PR #105: the
    assembly (205 deep, on its spigots, the J-FRONT-03 bolts; mass within
    20 kg), the ACP skin, the welded 20 x 20 x 1.5 frame per its cut list, the
    ACP back plate and the door top stop (gap 2 to 6, hardware selection C3).
    Limits only from FRONT's list, the register and the decisions; the rest
    pending on the drawing (HOLD). The back plate's row lacks a tolerance and
    a finish, and it is bonded to its frame: HOLD for FRONT and the PM.
    - Every made number has an FAI line again (82 made lines). The master BOM
    is unchanged on main 97a1aeb.
    Co-a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
2026-10-31 D-104 (ENVELOPE stand-ins), and a bonded part keeps its drawing in the checklist (#130)
    * Decision log: D-104, HOLD hardware stand-ins named ENVELOPE are reserved spaces for the clash check (item 13)
    * Checklist: the flat-part rule reads a type column and the note; a bonded part keeps its drawing
    - FRONT's lists give the cut in their type column, so D-89 part (4) now
    reads the process from a process or type column, and refuses a part whose
    process or note names bonding (or any other worked feature): a bonded part
    shows its bond area and surface prep on its drawing (PM, 2026-11-01).
    FRONT's DR back plate, access panel and inne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
    [document-register.csv]
2026-10-31 Master BOM: a file with CUT-LIST in its name is a cut list, not a parts list (#131)
    AIR's open PR #91 carries 610000_P01_AIR-FLAT-CUT-LIST_BOM.csv with a
    part_number column, so the reader took it for a second parts list: its cut
    pieces have no mass (5 failures) and would count the parts twice. A file
    named *CUT-LIST* is now skipped and named in the report, like a cut list
    without a part-number column. On main plus AIR's branch the BOM check now
    passes. One test (28); README.
2026-10-31 Mechanical checks: D-104: a hardware stand-in (a bought number with ENVELOPE in its name) may overlap the part it clamps in its own assembly file; run on main 433bc95 (#132)
    [clash-allow.csv]
2026-10-31 Mechanical checks: reserved spaces (config/reserved-spaces.csv): FRONT's DR air transitions 351403 and 351405 are listed open under AIR, with no drawing finding and no seam rules until AIR designs th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
    [reserved-spaces.csv]
2026-10-31 Mechanical checks: the DR air spaces 351402 to 351405 are all reserved (AIR designs the parts under its own numbers): no drawing, no seam rules, no parts-list row checks; run on main 5824c50 (#134)
    [reserved-spaces.csv]
2026-10-31 Reserved air spaces (D-105): the master BOM and checklist skip them; the riser and fan box FAI lines move to AIR's numbers (#135)
    - D-105 (item 14): every air part is an AIR number in AIR's tree; in DR,
    FRONT's 351402 to 351405 become reserved air spaces (no mass, no drawing,
    not counted); the riser 611501, the supply fan box 610401 and the riser
    transition 618103 stay in AIR's supply-box assembly, its own pallet piece.
    It replaces the earlier word that 351403 and 351405 keep FRONT numbers.
    - Master BOM: a row typed "reserved air space" is not counted, and the
    report lists it in its own section; so the checklist drops it too. A test
    (29); README.
    - FAI plan: K-D11 and K-D12 (FRON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
    [document-register.csv]
2026-10-31 Joints made hardware P01: corner key family 111211-111214, spigot 831001, stop washer 831002 (native Fusion, STEP, DXF, rows) (#139)
    * Joints made hardware: build script, manufacturing rows, drawing script with its offline test (models follow from the Fusion run)
    * J-FRONT-04: the glass channel overhangs FR1's new end by 45 mm onto the intake stub; its M3 screws stay on FR1
    * Spigot 831001: finish passivated, deburred (C11 reads a finish)
    * Joints build: holes as hole features placed from the block's edges (the fixing-ho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
    [111211_P01_BASE-CORNER-KEY-SQUARE-COMMON_STEP.step, 111211_P01_BASE-CORNER-KEY-TABULATED_CAD.f3d, 111212_P01_BASE-CORNER-KEY-FRONT-LH_STEP.step, 111213_P01_BASE-CORNER-KEY-FRONT-RH_STEP.step, 111214_P01_BASE-CORNER-KEY-KNEE-LH_STEP.step, 831001_P01_HARDWARE-LOCATING-SPIGOT_CAD.f3d, 831001_P01_HARDWARE-LOCATING-SPIGOT_STEP.step, 831002_P01_HARDWARE-STOP-WASHER_CAD.f3d]
2026-10-31 BASE follow-ups to #55: doubler 54, foam and register names, 30 mm corner keys, subassembly designs (#138)
    - Glide doubler 54 long (ends 27 from the hole, clear of the 2-diameter line); its DXF and row.
    - Foam renamed BASE - FLOOR FOAM - F1 - CLOSED-CELL 3 MM (D-89 part 3 reads the FOAM function).
    - Register names for the glide 118002, glide nut 838006 (with its finish) and end cap 118003.
    - Corner keys 30 long, fixing holes 10.5 from the key's back face (joints register #127); part
    designs 111101 and 111103 rebuilt with them (they now rebuild with every saved assembly).
    - Subassembly designs 110101 and 110401 for the assembly drawings, by rebuilding and trimming
    (no cloud Save Copy As);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
    [110000_P01_BASE-TUBE-CUT-LIST_SPEC.csv, 110000_P01_BASE_BOM.csv, 110000_P01_BASE_CAD.f3d, 110000_P01_BASE_STEP.step, 111101_P01_BASE-BAND-TUBE-SIDE-LH_CAD.f3d, 111101_P01_BASE-BAND-TUBE-SIDE-LH_STEP.step, 111103_P01_BASE-BAND-TUBE-BACK_CAD.f3d, 111103_P01_BASE-BAND-TUBE-BACK_STEP.step]
2026-10-31 Roll-up: the 30 mm corner key family, spigots and stop washers (joints #139) and BASE's 54 mm doubler (#138); 413.4 kg as shipped; packing regenerated (#141)
    All six corner keys now come from the joints' made hardware list on main
    (111211 to 111214, 30 mm thick, 0.207 kg each against this study's 0.15),
    the glide doublers from BASE's updated list (54 x 36 x 3, 0.0147 kg), and
    the fixings kit adds the joints' 30 spigots and 76 stop washers (0.19 kg)
    that this study's kit didn't count; its bolts, rivnuts, cam connectors and
    gaskets stay the model's until the register gives masses, so the line is
    marked part CAD. +0.5 kg in all. pack.py's outputs carry the new masses.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
    [910000_P01_PACKING-LIST_BOM.csv, parts-decided-P04.csv]
2026-10-31 Mechanical checks: D-105 typed rows; duplicate names to the list that's off; run on main 8c3aca4 (key holes closed) (#136)
    * Mechanical checks: D-105: a parts-list row typed reserved air space counts as a reserved space, as the master BOM and the checklist read it; run on main 22a7955
    * Mechanical checks: a duplicate name goes to the list that's off (register, the Joints Engineer's list for the keys, or the team lists' agreed name; a master-BOM-only difference is a rebuild for the PM); run on main 8c3aca4 (Joints hardware, BASE follow-ups): F-026, F-033, F-035, F-037 closed, F-098 to F-102 new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
    [fastener-schedule.csv]
2026-10-31 BASE drawings, batch 1: 111103, 111401, 110401 (#142)
    * BASE drawings: 111103 back band tube and 111401 floor panel F1 (PDF, PNG checked by eye); tube annotations without the view-from-below dimensions; notes font with Vietnamese letters, inside the frame; own-document cleanup for redos
    * BASE drawings: 110401 F1 assembly; notes on the right where the views fill the bottom left; corner lookup falls back to the nearest line end (mitred ends)
    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
2026-10-31 Mechanical checks: Fusion assembly on main (door swings free; strike F-103); screws in tapped keys; control files to Control (#143)
    * Mechanical checks: the control pack's files go to Control (F-099); screws in the base keys' tapped holes are their thread (up to a thread's overlap); Fusion assembly run on main 97a1aeb recorded: F-103 the door strike's body overlaps the glass (severe until it carries ENVELOPE, D-104); run on main e54dce6: F-042, F-044, F-046 closed
    * Mechanical checks: F-103 posted to FRONT
    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
    [clash-allow.csv]
2026-10-31 WIP batch after the Joints and BASE merges (#144)
    [100000_P01_POD-BOUGHT-PARTS_BOM.csv, 100000_P01_POD-MADE-PARTS-BY-PROCESS_BOM.csv, 100000_P01_POD-MASTER_BOM.csv, document-register.csv, issue-register.csv]
2026-10-31 FRONT door and glass rebuilt: hardware names from the joints register in the CAD (D-99), the strike as FRONT - DOOR STRIKE - ENVELOPE (D-104, clears F-103); same geometry, edit tests PASS; parts list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
    [360001_P01_FRONT-DOOR-UNIT_BOM.csv, 360001_P01_FRONT-DOOR-UNIT_CAD.f3d, 360001_P01_FRONT-DOOR-UNIT_STEP.step, 360002_P01_FRONT-FIXED-GLASS-UNIT_BOM.csv, 360002_P01_FRONT-FIXED-GLASS-UNIT_CAD.f3d, 360002_P01_FRONT-FIXED-GLASS-UNIT_STEP.step]
2026-10-31 Joints drawings: the spigot 831001 (A3, 2 views, 6 dimensions, notes as PDF text); drawing record; the key sheet's top view dimensions from the corner (#147)
2026-10-31 After FRONT #145: master BOM with the register names, D-109 (stop only your own processes, by number) (#148)
    - Master BOM regenerated on main 11d9b51: FRONT's door and glass lists now
    carry the joints register's hardware names and their process and finish
    columns. BOM check OK. Every made number has an FAI line.
    - D-109 (item 18): stop only the processes you started yourself, by the exact
    process number recorded when you started them; never by a name or a
    pattern. A cleanup by name stopped another team's queued Fusion run.
    - Release checklist re-run; ranges to D-109.
    [100000_P01_POD-MADE-PARTS-BY-PROCESS_BOM.csv, 100000_P01_POD-MASTER_BOM.csv, document-register.csv]
2026-10-31 Joints register: FRONT's spigot update (PM-approved): DL on the band centre line, DR on BASE's closing angle, DT on DR's ledge (#150)
    - J-FRONT-02: DL stands on 2 spigots on the band's centre line, 100 in from
    its bottom ends: slot on FL1 at (-1167.32, -716.90), round hole on FL2 at
    (-1060.94, -779.40) (calculation from BASE's points). DR stands on 2
    spigots in rivnuts in the top flange of BASE's closing angle (2 mm, along
    Y -645) at (1050, -656) round and (1147, -656) slot.
    - J-FRONT-03: both DT spigots on DR's DT ledge, 140 apart; none under DL
    (its top is a 45 degree slope); the 4 ceiling bolts hold DT's DL end; DT's
    back plate 2 mm with 4 rivnuts on stop washers at Z 2374 (me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
2026-10-31 Reviewer 6's items: ISS-087 for DR's 0.4 kg, REQ-LGT-04 at 97 kg/m², weight-risk note for FRONT #105 (#149)
    * Reviewer 6's three items: ISS-087 for DR's 0.4 kg, REQ-LGT-04 at 97 kg/m2, the weight-risk note for FRONT #105
    - ISS-087 (OPEN, FRONT): DR is about 19.4 kg after D-106 against D-108's
    19.0 kg target with its glass channels; FRONT still has to find about
    0.4 kg. The FAI plan's K-D02 points to it.
    - REQ-LGT-04: 413.4 / 4.25 = 97.3, so about 97 kg/m2 (it said 98).
    - Weight-risk note in REQ-LGT-01, PLAN Target 1 and ISS-080: the live count
    still uses the layout study's decor block masses (35.1 kg); FRONT's blocks
    in #105 weigh about 39.3 kg after D-106, so expect up to about 4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
    [issue-register.csv]
2026-10-31 Joints register: FRONT's exact spigot positions for DL, DR and DT (replace #150's) (#151)
    - DL, on its bottom ring tube's centre line 13 in from the outer faces (BASE's
    spigots 13 in from the band's outer face): round (-1176.7, -718.0) on FL1,
    slot (-1073.9, -780.6) on FL2 (checked: 12.9 and 13.0 in from the outer
    face, 86.7 and 87.9 along FL1 and FL2).
    - DR on BASE's closing angle: round (1050, -656.5), slot (1147, -656.5).
    - DT on DR's ledge: (270, -657.9) and (410, -657.9).
2026-10-31 WALL side walls P01: R1, L2, R2 with ELECTRICAL's felt openings (native Fusion, STEP, DXF, parts lists) (#104)
    * WALL R1 (side lower right): panel 210102, frame 211102, cassette 510102; parts list, DXF, rationale
    - panel 210102 (new, batch run): hardware bodies, 0 unhealthy, 0 clashes, STEP box exact, edit test PASS
    - frame 211102 and cassette 510102 rebuilt: descriptions held through the save, Front saved for drawings
    - the R1 skin and tray take the tabulated L1 drawings (D-89); their DXFs: 211302 blank (fold on the right),
    511102 flat pattern
    - master BOM check passes
    * WALL edit test: the design family comes from the .f3d file n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
    [210102_P01_WALL-PANEL-ASSY-SIDE-LOWER-RH_BOM.csv, 210102_P01_WALL-PANEL-ASSY-SIDE-LOWER-RH_CAD.f3d, 210102_P01_WALL-PANEL-ASSY-SIDE-LOWER-RH_STEP.step, 210103_P01_WALL-PANEL-ASSY-SIDE-UPPER-LH_BOM.csv, 210103_P01_WALL-PANEL-ASSY-SIDE-UPPER-LH_CAD.f3d, 210103_P01_WALL-PANEL-ASSY-SIDE-UPPER-LH_STEP.step, 210104_P01_WALL-PANEL-ASSY-SIDE-UPPER-RH_BOM.csv, 210104_P01_WALL-PANEL-ASSY-SIDE-UPPER-RH_CAD.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]
2026-10-31 After WALL #104: master BOM with WALL's side walls, checklist totals (#153)
    - Master BOM regenerated on main 87586c1: WALL's lists for R1, L2 and R2
    (with ELECTRICAL's felt openings) join L1. BOM check OK.
    - Every made number has an FAI line; WALL's new frames, skins, fill,
    cassettes and felt fall under the plan's WALL and LINING lines.
    - Release checklist re-run: made 39 done, 91 open, 0 blocked; bought
    10 / 2 / 88 (main plus the open PRs).
    [100000_P01_POD-BOUGHT-PARTS_BOM.csv, 100000_P01_POD-MADE-PARTS-BY-PROCESS_BOM.csv, 100000_P01_POD-MASTER_BOM.csv]
2026-10-31 Roll-up: WALL's four side panels and their cassettes from the merged parts lists (PR #104); 412.7 kg as shipped; packing regenerated (#154)
    L1, R1, L2 and R2 and their lining cassettes are now read from WALL's
    parts lists 210101 to 210104 on main (R1 and R2 no longer taken as
    mirrors, L2 and R2 no longer the model): the lower panels 11.16 kg, the
    upper 11.29 (their 40 x 40 tops), the lower cassettes 10.34, the upper
    9.91. The corner tube and bond lines now leave out what all four side
    panels carry in their CAD, so nothing is counted twice: -0.7 kg in all.
    The swap table lists each line; pack.py's outputs carry the new masses.
    [910000_P01_PACKING-LIST_BOM.csv, parts-decided-P04.csv]
2026-10-31 Weight to the live count, 412.7 kg as shipped (PR #154) (#155)
    The roll-up now reads WALL's four side panels and their cassettes from
    their merged lists (-0.7 kg): 412.7 kg as shipped, 7.3 kg under the cap and
    2.7 kg over the target. PLAN, the requirements (REQ-LGT-01, -04, REQ-SND-03,
    C6 at 97.1 kg/m2), the control README, the log's headline and ISS-080.
    [issue-register.csv]
2026-10-31 run_script: before each script, drop cached modules another run loaded from another folder, so each run imports its own files (#156)
    Fusion keeps Python modules between runs. Live 2026-10-31 a CEILING run
    imported an older module an AIR run had loaded from another worktree under
    the same name, and built from the wrong code. The wrapper now removes from
    sys.modules every module whose file lies in another run's folders (the
    folder holding all worktrees, or /tmp where agents' scratch folders live)
    and not in this run's repo or script folder, and prints which. Fusion's and
    Python's own modules are never touched.
    Test: two worktrees with a module of the same name, run one after the other
    through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
2026-10-31 Mechanical checks: Fusion assembly clean on main (F-103 closed); WALL side walls; edge distance for rigid parts (#146)
    * Mechanical checks: run on main 02cfe83 (master BOM rebuilt): F-099 and F-047 closed
    * Mechanical checks: run on main 11d9b51 (FRONT rebuilt with the register's names): F-027, F-028, F-095 closed
    * Mechanical checks: run on main b033321 (the spigot drawing): F-025 closed
    * Mechanical checks: edge-distance rules for rigid parts only (owner's rule 9 is for sheet parts; F-105 on a felt access hole closed);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
    [fastener-schedule.csv]
2026-10-31 CEILING P01: panels (frames with the joint holes, skins), lining cassette; drawings to follow (#32)
    * CEILING P01 work in progress: layout model, Fusion build, offline tests, exports, edit test
    Ceiling halves C1/C2 (20 x 40 x 1.2 frames, 3 cross members, 2.26 mm seam gaps)
    and the ceiling cassette as one part for both halves: sheet-metal tray with
    12 mm lips under the felt, 2 ribs, felt with light holes, fill strips in the
    frame bays, light plates, clip and catch HOLD envelopes. Parameters load from
    the skeleton's own CSV at build time.
    * Keep Python cache files out of the ceiling folder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
    [410000_P01_CEILING-PARTS-LIST_BOM.csv, 410000_P01_CEILING-TUBE-CUT-LIST_BOM.csv, 410000_P01_CEILING_CAD.f3d, 410000_P01_CEILING_STEP.step, 411301_P01_CEILING-SKIN-C1_DXF.dxf, 411302_P01_CEILING-SKIN-C2_DXF.dxf, 513101_P01_LINING-TRAY-CEILING_DXF.dxf, 513102_P01_LINING-RIB-CEILING_DXF.dxf]
2026-10-31 Roll-up: CEILING's panels and cassettes from the merged parts list (PR #32); 412.3 kg as shipped; packing regenerated (#158)
    C1 and C2 and the common ceiling cassette are now read from CEILING's
    parts list 410000 on main: the panels' frames, skins and bond sets (10.05
    kg on average), and the cassette's tray, ribs, felt and fill bays, its
    25 kg/m3 fill scaled to the 24 the pod now uses (9.46 kg); the clips and
    catches stay in the named clips' line and the hardware and seals in the
    fixings kit's. The corner tube and bond lines now also leave out the
    ceiling halves' 40 x 40 back members and bond sets: -0.4 kg in all. The
    swap table lists both lines; pack.py's outputs carry the new masses.
    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
    [910000_P01_PACKING-LIST_BOM.csv, parts-decided-P04.csv]
2026-10-31 Mechanical checks: CEILING checked (wall-to-ceiling bolts match); shell waits for the whole pod (#159)
    * Mechanical checks: the assembled shell waits for every shell assembly (BASE, WALL, FRONT decor and door, CEILING), and an L of thin strips reports as its strips; run on main c72ea57 (CEILING #32): wall-to-ceiling bolts match, F-138 to F-148 drawings; F-126 to F-137 closed unposted
    * Mechanical checks: F-138 to F-148 posted to CEILING
    * Mechanical checks: run on main 1f70c90 (roll-up 412.3 kg with CEILING)
    C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
    [fastener-schedule.csv]
2026-10-31 ELECTRICAL P01: power unit, 12 V Class 2 bus, routes, harness list, electrical BOM (#64)
    * ELECTRICAL P01: power unit, 12 V Class 2 bus, routes, harness, BOM (WIP)
    - Route model (electrical_model.py): 37 reserved spaces (routes, connector
    pockets, bushings, slots, the power unit, the inlet, the hub zone) on
    skeleton P04 parameters; Fusion build derives them from the skeleton,
    checks clashes against its real bodies, saves, and exports unlinked.
    - Parts list for the master BOM (master BOM check: OK, 0 failures),
    harness list (31 segments), load table, calculation results (every 12 V
    path under 3 %), wiring diagram (2 A3 sheets), compliance note
    (UL 962 / NEC Class 2), design repor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
    [710000_P01_ELECTRICAL-HARNESS-LIST_SPEC.csv, 710000_P01_ELECTRICAL-LOAD-TABLE_CALC.csv, 710000_P01_ELECTRICAL-PARTS-LIST_BOM.csv, 710000_P01_ELECTRICAL_CAD.f3d, 710000_P01_ELECTRICAL_STEP.step, 711001_P01_ELECTRICAL-POWER-UNIT-ENCLOSURE-BODY_CAD.f3d, 711001_P01_ELECTRICAL-POWER-UNIT-ENCLOSURE-BODY_DXF.dxf, 711001_P01_ELECTRICAL-POWER-UNIT-ENCLOSURE-BODY_STEP.step]
2026-10-31 INTERIOR P01: light shelf, work wall ledge, screen rail (D-70, D-85) (#92)
    * Keep Python cache files out of the ceiling folder
    * CEILING P01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
    [810000_P01_INTERIOR-PARTS-LIST_BOM.csv, 810000_P01_INTERIOR_CAD.f3d, 810000_P01_INTERIOR_STEP.step, 811101_P01_INTERIOR-LEDGE-TOP_DXF.dxf, 811201_P01_INTERIOR-LIGHT-SHELF-BACK_DXF.dxf, 811202_P01_INTERIOR-LIGHT-SHELF-SIDE-LH_DXF.dxf, 811203_P01_INTERIOR-LIGHT-SHELF-SIDE-RH_DXF.dxf, 811204_P01_INTERIOR-LIGHT-SHELF-DOWN-CHANNEL-RH_DXF.dxf]
2026-10-31 Mechanical checks: shell face by face; ELECTRICAL checked; BASE's end cap missing from the CAD (F-136) (#160)
    * Mechanical checks: the assembled shell face by face, each once the parts that cover it are on main (scope per face); an opening goes to the team whose parts border it; run on main e06fa22 (ELECTRICAL #64): F-136 (BASE's end cap not in the CAD), F-149 (711001 drawing)
    * Mechanical checks: F-136 and F-149 posted
    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
    [fastener-schedule.csv]
2026-10-31 Roll-up: ELECTRICAL from its merged parts list (PR #64); 412.6 kg as shipped; packing regenerated (#161)
    ELECTRICAL is now read from its parts list 710000 on main: 5.17 kg as
    shipped (the power unit in B2 2.89, the hub and controls zone, the cord
    set, harnesses, cables and connectors, the LED strips and the call light),
    0.23 kg over the figure relayed before it merged. The light shelf's
    budget now leaves out its strip at ELECTRICAL's 20 g/m (0.09 kg instead of
    the 0.22 kg share the estimate took): +0.13 kg. +0.36 kg in all; the swap
    table lists both, and pack.py's outputs carry the new masses.
    [910000_P01_PACKING-LIST_BOM.csv, parts-decided-P04.csv]
2026-10-31 Mechanical checks: INTERIOR checked; a STEP's top part number must match its file (F-159) (#162)
    * Mechanical checks: a STEP whose top component carries another number than its file name is reported (it also stays out of the assembled checks); run on main d4454f3 (INTERIOR #92): F-151 to F-159 for CEILING
    * Mechanical checks: F-151 to F-159 posted to CEILING
    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
2026-10-31 Roll-up: INTERIOR's ledge, light shelf and screen rail from the merged parts list (PR #92); 412.6 kg as shipped; packing regenerated (#164)
    The light shelf and the work-wall ledge are now read from INTERIOR's parts
    list 810000 on main instead of D-85's budgets: the shelf 1.56 kg (its LED
    strips stay in ELECTRICAL's line), the ledge 1.40 kg, and the screen rail
    on HOLD (0.50 kg), which the estimate didn't have, carried on the ledge's
    line as the packing plan ships them together. Net about 0.0 kg: the
    shelf's -0.52 against the screen rail's +0.50. The swap table lists all
    three; pack.py's outputs carry the new masses.
    [910000_P01_PACKING-LIST_BOM.csv, parts-decided-P04.csv]
2026-10-31 After CEILING #32, ELECTRICAL #64 and INTERIOR #92: master BOM, FAI lines for their parts, 412.6 kg as shipped; checklist reads main over a stacked branch's old copies (#165)
    - Master BOM regenerated from main with CEILING's, ELECTRICAL's and INTERIOR's merged parts lists (0 failures).
    - FAI plan: CEILING's roof slot in skin C2 (K-P06, ±0.5 critical), its frames (K-P07), tray, ribs, felt,
    fill bays and cassette (K-L06 to K-L10); ELECTRICAL's enclosure body, front plate and hub cover
    (K-E02 to K-E04, the plates added to the anodise line K-F06); INTERIOR's ledge and light shelf parts
    (K-I02 to K-I05); WALL's back-wall families (2112xx, 2114xx, 2116xx, 5112xx, 5114xx, open PR #152) added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
    [100000_P01_POD-BOUGHT-PARTS_BOM.csv, 100000_P01_POD-MADE-PARTS-BY-PROCESS_BOM.csv, 100000_P01_POD-MASTER_BOM.csv, issue-register.csv]
2026-10-31 Packing list: B2's power-unit share from ELECTRICAL's parts list (#163)
    * Packing list: B2's power-unit share read from ELECTRICAL's parts list (2.888 of 5.170 kg), not typed
    pack.py had split ELECTRICAL's roll-up line with a fixed 2.80/4.94 share
    from before ELECTRICAL's CAD merged; with the roll-up now at 5.170 kg
    (#161), B2 read 0.04 kg heavy. The share is now the power unit 710001's
    mass in ELECTRICAL's parts list over the roll-up line's mass, read on
    every run. Test added.
    * Packing list: part numbers from the master BOM; ledge carton no longer counts the screen rail twice
    - Fill the numbers that are now merged: WALL R1, L2, R2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
    [910000_P01_PACKING-LIST_BOM.csv]
2026-10-31 FRONT fixed glass: last channel hole at X 905, clear of BASE's FR1 (PM ruling); drawings to follow (#169)
    * Fixed glass: the bottom channel's last M3 hole at X 905, clear of BASE's FR1 joint; the first three stay at X 269.4, 484.3, 699.2 over BASE's sill rivnuts (PM ruling 2026-11-01); built in the next run with the drawings
    * FRONT records: the glass channel's last hole at X 905 (PM ruling 2026-11-01)
    * FRONT scripts: drawing_specs loaded by full path under a FRONT-only name (Fusion keeps modules loaded between runs: an import by name could return another team's), and every he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
    [360002_P01_FRONT-FIXED-GLASS-UNIT_BOM.csv, 360002_P01_FRONT-FIXED-GLASS-UNIT_CAD.f3d, 360002_P01_FRONT-FIXED-GLASS-UNIT_STEP.step]
2026-10-31 D-110 (BOM and roll-up PRs rerun pack.py) and D-111 (the fixed glass's last channel hole at X 905); master BOM after FRONT #169 (#170)
    - D-110: any PR that changes the master BOM or the weight roll-up reruns v2/07-Packaging/pack.py and commits
    what it regenerates, because pack.py reads both (the BOM since #163). PM rule, posted in the control pack group.
    - D-111: the bottom channel's last M3 hole moves from X 914.1 to X 905, 10 mm short of BASE's FR1 joint at X 915;
    the first three stay over BASE's sill rivnuts. PM ruling in FRONT's group, built in #169.
    - Decision ranges to D-111 in the README, PLAN, the requirements and the document register.
    - Master BOM regenerated after #169 (the U-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
    [100000_P01_POD-MASTER_BOM.csv, document-register.csv]
2026-10-31 Mechanical checks: the STEP reader reads a solid with a sealed void (BREP_WITH_VOIDS) by its outer shell, never crashes on it, and notes the void in the run's inputs; run on main 5cf7aef (#171)
    [fastener-schedule.csv]
2026-10-31 Joints register: glass channel's last hole at X 905 (D-111); build loads the shared folder check by full path (#172)
    * Joints build: load the shared safe-to-create check by full path from this checkout and print it (Fusion keeps modules between runs)
    * J-FRONT-04: the glass channel's last hole at X 905, settled by D-111 (FRONT #169); no longer open
    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
2026-10-31 Mechanical checks: a bolt into its own file's rivnut isn't paired across files; free edges read from the faces, not the box (FRONT #105) (#174)
    - C08 bolt patterns: a clearance hole and a rivnut in two parts of one file, on one
    axis, are matched there and left out of the cross-file pairing. On #105 (bc3f023)
    DR's access panel holes sit 0.00 mm off DR's own back-ring rivnut holes; the three
    severe "hole-unmatched" findings against WALL R1 are gone.
    - C09 edge distance: an edge is free where the part ends, read from the faces across
    it: a wide wall (tube corner, channel wall), a bend, or a chamfer on the way to the
    next wall is not a free edge; a sheet's edge, a tube's end ring and a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
2026-11-01 D-112: plain tube cut parts, flat plates and sheet brackets get their drawings from the STEP-driven generator (tools/drawgen) (#175)
    - D-112: tools/drawgen draws those parts from each part's STEP of the same revision (exact projections, hidden
    lines, true circles, X/Y hole tables per guideline 3.3, the project title block). Fusion keeps the general
    arrangement, assemblies, bent parts, the door, the glass, the decor and any part the generator can't dimension.
    Reason: one shared Fusion queue makes about 100 drawings take 15+ hours; guideline 6.1 allows another tool
    that draws true edges and annotation from checked geometry and updates from its source.
    - Decision ranges to D-112 in the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
    [document-register.csv]
2026-11-01 Mechanical checks: generated part drawings (D-112) count by the same rules; findings on them go to the Drawing Generator (#176)
    - C05 counts a part drawing made from STEP by tools/drawgen exactly like a Fusion
    drawing: the same file name, revision and content rules (units, material, finish,
    tolerance, hole tags or an X (mm) / Y (mm) hole table; D-89 table drawings).
    - A generated drawing names drawgen in its PDF's Creator or Producer field (read with
    PyMuPDF, or pdfinfo without it). A finding on it (revision, content, holes, a table
    drawing behind a part's STEP) goes to the Drawing Generator, with a fix that says to
    fix the generator and regenerate.
    - Test: a complete generated dra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
2026-11-01 Reviewer 6's three items: the last two 412.7 lines, a printed list of files read from main over a PR's edit, tests for the author-time and cut-list faults (#177)
    - PLAN's done row and the requirements' decision-log row now say 412.6 kg as shipped, 7.4 kg under the cap and
    2.6 kg over the target (PRs #158, #161, #164), like every other current line.
    - When a PR edits a file that main changed later, main's copy is read until the PR rebases. Each such file is now
    recorded (build_master_bom.FELL_BACK) and printed: the checklist adds a line under "Read from" naming each file
    and its PR, BOM-CHECK.md lists them in --ref runs, and both print them. None fall back on tonight's open PRs.
    - Tests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
2026-11-01 D-113: D-112's drawing generator settled (D-89 decides which flat plates need a drawing; sections for holes through both tube walls; bent parts stay in Fusion) (#178)
    - D-113, one row naming D-112, as the PM posted it after Reviewer 6's review of #175: (1) D-89 still decides
    which flat plates need a drawing at all and drawgen draws only those; its parts are never counted as blocked by
    a locked screen. (2) Drawgen draws a section or the opposite view wherever holes pass through both walls of a
    tube or a hidden feature needs one (guideline 6.1, 6.2), hatched per ISO 128-50; a part it can't do that for
    goes to Fusion. (3) Bent parts always go to Fusion, brackets included; "sheet bracket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
    [document-register.csv]
2026-11-01 Mechanical checks: D-113 on generated drawings (a labelled section for holes through both walls; no bent parts); a part's holes counted over all its bodies (#179)
    - C05, on drawings made by tools/drawgen (D-113): where the part's STEP has a hole
    axis through two walls of one body, the drawing must label a section (SECTION A-A,
    or A-A) or the opposite view (VIEW B, VIEW FROM): "no-section", major. A part with
    bends in its STEP stays in Fusion: "generated-bent-part", major. Both go to the
    Drawing Generator.
    - The run gave C05 only the first body's holes of each part number, so a frame of 7
    members showed 4 or 5 of its 11 to 15 hole axes (WALL 211101-211104, CEILING
    411101/411102).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
2026-11-01 Roll-up: a 2.4 kg allowance for the frame cleats (D-115); 415.0 kg as shipped; packing regenerated (#180)
    D-115 adds internal aluminium cleats to the WALL and CEILING frames, about
    120 joints at up to 20 g each. The roll-up carries 2.4 kg for them as an
    assumption until the Joints Engineer's cleat models land. It rides on the
    fixings kit's line, which the packing plan already ships, so the packing
    check stays green; the line's status says the cleats are an assumption.
    The pod comes to 415.0 kg as shipped, 5.0 kg under the cap and 5.0 kg over
    the 410 kg target. pack.py's outputs carry the new mass.
    [parts-decided-P04.csv]
2026-11-01 D-114 (a Reviewer's visual pass on every drawing PDF) and D-115 (H11 closes: cleated, crimped and bonded frame joints); Reviewer 6's two report items (#182)
    - D-114: every PR that adds or changes a drawing PDF gets a Reviewer's visual pass at print size against guideline
    3.2, 3.3, 6 and the section 10 checklist, one line per drawing (pass, or the fix), before the PM merges it. The
    Checker's automatic check and the PDF read-back still run.
    - D-115: H11 closes. WALL and CEILING frame members join with internal corner and T cleats, crimped, with
    structural adhesive; cleats 20 g or less, a roll-up allowance until they're in CAD, a 5-piece cleated-corner
    bending test in the sample plan. F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
    [document-register.csv]
2026-11-01 D-116 (four weight savings adopted, about 6.4 kg) and the weight at the live 415.0 kg as shipped (PR #180) (#184)
    - D-116: from the Air Engineer's study, the fixings recount (38 cam connectors that don't exist; gasket 7.6 g/m,
    not 60), cartridge casings at 1.8 mm after #91 with the fan sample at 30 dB(A) or below at boost, cleats at
    12 g subject to the strength check, and cartridge layers at 32 kg/m3 subject to AIR's grade. Rejected: 18 kg/m3
    fill, 0.45 mm trays, lighter felt. Reason: a safe margin under the 420 kg cap after FRONT's decor.
    - Weight to the live 415.0 kg as shipped (5.0 under the cap, 5.0 over the target; D-115's 2.4 kg cleat
    allowance, PR #180) in PLAN, the requiremen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
    [document-register.csv, issue-register.csv]
2026-11-01 Roll-up: D-116 fixings recount and 32 kg/m3 cartridge layers; 411.4 kg as shipped; packing regenerated (#185)
    (1) The fixings kit line now counts the site fixings by the joints
    register (94 M6 x 16 and 12 M6 x 25 bolts, 122 rivnuts, 88 washers, 76
    retainers, 26.9 m of joint gasket, 3.73 m of closing-seam seal) at the
    parts lists' masses, 1.75 kg, in place of this study's old model (78
    bolts, 38 cam connectors that no longer exist, gasket at 60 g/m): -2.93
    kg. The spigots, stop washers and the D-115 cleat allowance stay.
    (4) The air report's cartridges take their layers at 32 kg/m3, the grade
    CEILING confirmed and the absorption data is for: 10.8 kg a cartridge,
    -0.71 kg in all; the fan boxes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
    [910000_P01_PACKING-LIST_BOM.csv, parts-decided-P04.csv]
2026-11-01 Weight to the live 411.4 kg as shipped (PR #185: D-116's fixings recount and 32 kg/m3 cartridge layers) (#186)
    - 411.4 kg as shipped, 8.6 kg under the cap and 1.4 kg over the target, in PLAN, the requirements (the log row,
    REQ-LGT-01, REQ-LGT-04, REQ-SND-03, C6), the README, the log's headline and ISS-080; per m2 96.8 (about 97).
    - The risk note now expects about 414 kg once FRONT #105 lands, and about 412 kg once D-116's other two savings
    (the 1.8 mm casings and the 12 g cleats, about 2.8 kg) are in the live count.
    [issue-register.csv]
2026-11-01 Air report and roll-up: the fan boxes' linings at 32 kg/m3 (CEILING confirmed); 411.0 kg as shipped; packing regenerated (#188)
    CEILING confirms the D-60 fan boxes' 50 mm linings are the same
    Sorberpoly 2D at 32 kg/m3 as the cartridge layers, so the air report's
    fan box masses drop 0.41 kg (the supply box 4.8 kg, the exhaust box 3.3).
    The PR #11 layouts kept for the record keep their 40 kg/m3 lining. The
    sound numbers don't change. The roll-up reads the air report, so the pod
    comes to 411.0 kg as shipped; pack.py's outputs carry the new masses.
    [910000_P01_PACKING-LIST_BOM.csv, parts-decided-P04.csv]
2026-11-01 D-118 (do it right; speed is not important, the owner's rule) and the weight at the live 411.0 kg as shipped (PR #188) (#190)
    - D-118: never skip a check to go faster, prove a method on a sample before using it at scale, and take another
    Fusion run or another day if that's what doing it right needs. Source: the owner, 2026-11-01, now in AGENTS.md
    (PR #189). D-117 is not used yet (asked the PM).
    - Weight to the live 411.0 kg as shipped, 9.0 kg under the cap and 1.0 kg over the target (the fan boxes'
    linings at 32 kg/m3, PR #188), in PLAN, the requirements, the README, the log's headline and ISS-080; per m2
    96.7 (about 97). The risk note now expects about 414 kg after FRONT #105 and ab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
    [document-register.csv, issue-register.csv]
2026-11-01 D-117 (provisional: mitred corners with 12 g cleats, 9 g plug cleats in the T joints), D-119 (the build plan is the main guide) and D-120 (every part its own component) (#191)
    - D-117, PROVISIONAL until the owner's frame materials answer: the 40 frame corners mitred with hollow corner
    cleats of 12 g (16 g if the bending test shows the glue too close), plug cleats of about 9 g in the 52 T joints,
    about 1 kg per pod; Fusion frame and cleat runs wait. Reason: the Joints Engineer's joint count and strength
    check. PM ruling in the Joints group.
    - D-119: the v2 build plan is the main guide, the engineering guideline a reference to check, and the build plan
    wins where they conflict (the own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
    [document-register.csv]
2026-11-01 Mechanical checks: D-120, every part its own component (build plan rule 2); register on main 4969faf: F-160 to F-172 for WALL and CEILING (#192)
    - C06 bodies-not-components (major, D-120 / BP-04): a component (one product
    definition in a STEP) holding several bodies. Copies of one part should be one
    component placed several times; different pieces (a frame's members, D-115; a
    fill's bay pieces) each their own component with its own number, the part an
    assembly of them. One finding per part number and team; the owner is the team
    whose file it is (WALL placed the Joints Engineer's washers, so WALL fixes it).
    - Left out as ruled: ELECTRICAL's route components (7100xx, D-92), HOLD spac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
2026-11-01 D-120 numbers: the master BOM gives out 51 frame-member and fill-piece numbers (number-allocation.csv), with a check (#193)
    - v2/04-BOM/number-allocation.csv, kept by hand and append-only: 41 frame members (CEILING C1 and C2, WALL's four
    side frames, back frames B1 and B2 from #152) and 10 WALL fill pieces, each with its name, Vietnamese name, the
    part it belongs to, quantities and its basis from the team's own list. Members 2xxx block (212FMM, 412FMM);
    fill pieces after the panel numbers (2115PJ, 2116PJ). One number per member per frame (the lists give no holes,
    LH and RH mirror); CEILING's plain cross members X2/X3 share one COMMON number.
    - build_master_bom.py: reads it; a number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
    [100000_P01_POD-MASTER_BOM.csv, number-allocation.csv]
2026-11-01 D-121 (casings 2.0 mm, noise at the limit), D-122 (the owner keeps v2's construction; D-117 confirmed), D-123 (frame and fill numbers), ISS-089, ISS-090 (#194)
    * D-121 (casings stay 2.0 mm, fan box linings where they fit, noise corrected to the 30 dB(A) limit), D-122 (frames keep their numbers, panel fill numbers cancelled on split), ISS-089 and ISS-090
    - D-121: D-116 item (2) withdrawn, the cartridge casings stay at 2.0 mm; the fan box linings go only where they
    fit and the exhaust fans move to the top on a sealed bulkhead, closing the short-circuit path; the noise is
    25.4 to 25.6 dB(A) at 53 l/s and 29.8 to 30.0 at 65 l/s, the boost 65.0 to 65.5 l/s: at the limit, an open
    risk until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
    [document-register.csv, issue-register.csv]
2026-11-01 Roll-up: D-117's frame cleats at 1.2 kg with their glue (was D-115's 2.4 kg allowance); 409.8 kg as shipped; packing regenerated (#195)
    The owner kept v2's construction, so D-117 stands: 14.9 g corner cleats at the
    mitred frame corners and 6.7 g T plugs, about 1.2 kg per pod with glue (the PM,
    2026-11-01). The fixings kit line carries 1.2 kg (assumption, S49) until the
    Joints Engineer's cleat models land. Pod as shipped: 409.8 kg, 10.2 under the
    420 kg cap and 0.2 under the 410 kg target. pack.py rerun for its outputs.
    [parts-decided-P04.csv]
2026-11-01 D-124 (3 mm fan box casings), CEILING's SIDE and X1 merged onto one number each, 3 allocation test rows, and the weight at the live 409.8 kg (#195) (#196)
    - D-124: both fan box casings to 3 mm aluminium, about 29.5 dB(A) at 65 l/s and a 66.6 l/s reach, about +1.4 kg;
    the cartridge casings stay 2.0 mm (D-121). Every current noise line, ISS-073/ISS-090's history, REQ-AIR-02,
    REQ-AIR-05, the FAI plan's F-04 and K-A05 follow; D-121 points to it.
    - Allocation: CEILING confirmed C2's SIDE member and X1 are C1's turned over; the cut list agrees on section,
    length, ends and holes. 412101 and 412105 now serve both frames (COMMON); 412201 and 412205 are CANCELLED.
    - Tests for Reviewer 6's three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
    [100000_P01_POD-MASTER_BOM.csv, document-register.csv, issue-register.csv, number-allocation.csv]
2026-11-01 Risk note: about 414 kg once FRONT #105 and D-124's 3 mm fan box casings are in (about 413 kg with #105 alone) (#197)
    The note now leads with the figure that includes D-124's +1.4 kg and says what the 413 kg figure leaves out, in
    REQ-LGT-01, ISS-080 and PLAN.
    [issue-register.csv]
2026-11-01 WALL's 15 fill-piece forms numbered from WALL's FILL-PIECES list; the earlier size-only fill numbers re-pointed or cancelled (#198)
    - One number per form (size and pocket layout), 28 bays in all: L1/R1 F01-F04 (211511, 211513, 211514, 211512),
    L2/R2 F05-F08 (211531, 211533, 211534, 211532), B1/B2 F09-F10 (211611, 211612), B1's F11 (211613), B2's F12
    with ELECTRICAL's cut-outs (211621), B3/B4 F13-F14 (211631, 211632), B3's F15 (211633).
    - Re-pointed to their forms: 211511, 211512, 211531, 211532, 211611, 211621. Cancelled, never reused: 211521,
    211522, 211541, 211542 (R1 and R2 share L1's and L2's pieces; they are not handed).
    - A form two panels share takes the first panel's block; the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
    [100000_P01_POD-MASTER_BOM.csv, number-allocation.csv]
2026-11-01 Air report, roll-up: D-121 and D-124 fan boxes (linings where they fit, exhaust fans at the top, 3 mm casings); 25.1 / 29.6 dB(A), boost 66.3 l/s; 408.9 kg as shipped; packing regenerated (#199)
    Each D-60 fan box is now the room its fans face (the supply plenum above its
    fans, the exhaust plenum under its fans at the top on a sealed bulkhead), with
    50 mm linings only where they fit (0.046 and 0.103 m2, D-121), bare walls at
    5%, and its open face letting sound into the cartridge (only what the far
    grille reflects comes back). Casings 3 mm aluminium (D-124). Calculation:
    25.1 dB(A) at 53 l/s, 29.6 at 65, boost 66.3 l/s at 30 dB(A); with 2 mm
    casings 30.1 at 65 and 64.8 l/s (ISS-090). Fan box m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
    [910000_P01_PACKING-LIST_BOM.csv, parts-decided-P04.csv]
2026-11-01 WALL back walls P01: back builder with ELECTRICAL's features, B1 and B2 (old structure until the D-120 rework) (#152)
    * WALL back walls: ELECTRICAL's features in B2-CASS (plain power unit cut-out, joint bushing hole, corner slot), B4-CASS (joint bushing hole, felt holes for the shelf feed and the ceiling route) and panel B2 (inlet and LAN holes, fill cut-outs); B2-CASS and B4-CASS built clean
    B2-CASS and B4-CASS: 0 unhealthy, every sketch fully constrained, 0 clashes, STEP box exact, edit test PASS
    (pod_w 2300, back_ph 1080; the joint holes follow the row seam, FX-CEIL follows the pod width, no hole through
    a lip).
    * WALL runs print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
    [210101_P01_WALL-PANEL-ASSY-SIDE-LOWER-LH_BOM.csv, 210102_P01_WALL-PANEL-ASSY-SIDE-LOWER-RH_BOM.csv, 210103_P01_WALL-PANEL-ASSY-SIDE-UPPER-LH_BOM.csv, 210104_P01_WALL-PANEL-ASSY-SIDE-UPPER-RH_BOM.csv, 210201_P01_WALL-PANEL-ASSY-BACK-LOWER-B1_BOM.csv, 210201_P01_WALL-PANEL-ASSY-BACK-LOWER-B1_CAD.f3d, 210201_P01_WALL-PANEL-ASSY-BACK-LOWER-B1_STEP.step, 210202_P01_WALL-PANEL-ASSY-BACK-LOWER-B2_BOM.csv]
2026-11-01 Weight and noise from the roll-up and air report (#199): 408.9 kg; 25.1 / 29.6 dB(A), boost 66.3 l/s; risk note about 412 kg (#201)
    * Weight and noise from the roll-up and the air report (#199): 408.9 kg as shipped; 25.1 / 29.6 dB(A), boost 66.3 l/s; risk note about 412 kg
    - Weight: 408.9 kg as shipped, 11.1 kg under the cap and 1.1 kg under the target (D-121 and D-124's fan boxes in
    the roll-up, PR #199), per m2 96.2, in PLAN, the requirements, the README, the log's headline and ISS-080. The
    risk note now reads about 412 kg once FRONT #105 lands, per the roll-up.
    - Noise: 25.1 dB(A) at 53 l/s and 29.6 at 65 l/s, the boost reaching 66.3 l/s at 30 dB(A) (the air report,
    PR #199; D-124)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
    [100000_P01_POD-BOUGHT-PARTS_BOM.csv, 100000_P01_POD-MADE-PARTS-BY-PROCESS_BOM.csv, 100000_P01_POD-MASTER_BOM.csv, issue-register.csv]
2026-11-01 Findings register: run on main 2f76545 (WALL B1/B2: F-173 to F-187 new, F-104 closed); D-120 findings marked posted (#200)
    * Findings register: F-160 to F-172 (D-120) posted to WALL and CEILING
    * Findings register: run on main 68c1a4d (no change: 76 open, 32 severe); D-120 findings marked posted
    The merges since 4969faf were control, BOM allocation and roll-up only; the run
    finds the same 76 findings. F-160 to F-172 are marked posted (WALL and CEILING
    groups, 2026-11-01).
    * Findings register: run on main 2f76545 after WALL's back walls B1 and B2 (#152): F-173 to F-187 new, F-1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
    [fastener-schedule.csv]
2026-11-01 Roll-up: WALL's B1 and B2 back panels and their cassettes from CAD (PR #152); 407.6 kg as shipped; packing regenerated (#205)
    B1 and B2 (210201, 210202) come in from WALL's merged parts lists: frame,
    skin, fill and bond set per panel (8.58 and 8.47 kg; hardware stays in the
    fixings kit's line). The "B1 to B4" line keeps pack.py's item text and takes
    the mean of the two CAD panels and two model panels for B3 and B4 (8.76 kg
    each), so its basis is part CAD. The lower back cassettes (510201, 510202)
    come from CAD: tray, felt, hook-and-loop and seals (8.01 kg each against the
    model's 8.41; clips stay in the named clips' line). The bond-over allowance
    drops B1's and B2's share, which their CAD no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
    [910000_P01_PACKING-LIST_BOM.csv, parts-decided-P04.csv]
2026-11-01 Mechanical checks: D-125, a plain strip or sheet passes on a full parts-list row; F-158 (811205) closed (#206)
    * Findings register: F-173 to F-187 (WALL B1 and B2) posted to WALL
    * Mechanical checks: D-125, a plain straight-cut strip or sheet passes on a full parts-list row; register on main a8d75f6: F-158 (811205) closed
    - C05 (D-125, extending D-89): a part with no drawing passes when its STEP shows one
    shape, a plain rectangular block (six flat faces in three square pairs, no holes,
    no bends) that is a strip or sheet (at most 25 mm and half its width thick), and a
    parts-list row gives the material with its grade (a grade on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
    [fastener-schedule.csv]
2026-11-01 Packing list: B1 and B2 back panels and their cassettes numbered from the master BOM (WALL #152) (#207)
    WALL names the back panels by position (B1, B2), not LH and RH, so the packing list's
    names didn't match the master BOM and the four pieces stayed TBD after #152 and #205.
    - 1-03 B1 210201, 1-04 B2 210202, 1-17 B1's cassette 510201, 1-18 B2's cassette 510202,
    with WALL's names; check K13 confirms each number carries the BOM's name.
    - B3 and B4 and their cassettes take WALL's names from its CAD files (210203, 210204,
    510203, 510204), so their numbers fill in by name as soon as WALL's lists merge.
    - 24 of 42 pieces numbered; still TBD: WALL 4, BASE 5, AIR 5, FRONT 3, ELECTRICAL 1.
    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
    [910000_P01_PACKING-LIST_BOM.csv]
2026-11-01 Mechanical checks: D-125's tolerance covers both cut sizes (PM ruling); register on main 0d355cd: F-158 (811205) reopened (#209)
    - A D-125 line's tolerance must cover the length and the width: one general tolerance
    (ISO 2768, a ± on the cut sizes, or a ± naming no size) or one for each; "width as
    supplied" anywhere in the line covers a bought strip's width. A ± on the thickness,
    bends, angles, holes or flatness covers neither; the thickness takes the sheet's own
    tolerance. One-sided forms (+0/-0.5, +0.10/0) count. A grade on HOLD still counts;
    the part stays HOLD until the grade is named.
    - tolerance_cover is new; strip_row_lacks, cuboid_sides and is_strip keep their names
    and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
2026-11-01 D-125 (plain straight-cut strips and sheets need no drawing) with the checklist rule; weight at the live 407.6 kg; re-pointing rule (#208)
    * D-125 (a plain straight-cut strip or sheet needs no drawing when its line is complete) with the checklist rule; the weight at the live 407.6 kg (#205); the allocation re-pointing rule
    - D-125, extending D-89: no drawing for a plain straight-cut strip or sheet whose parts-list line gives the
    material and grade, thickness, length and width, finish and tolerance, and names no hole, bend, notch or other
    feature. Reason: a drawing adds nothing a full cut-list line doesn't carry (Reviewer 5, on 811205).
    - Release checklist: plain_lacks() counts such a li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
    [document-register.csv, issue-register.csv]
2026-11-01 D-126 (bought LED profile replaces 811204/811205), D-125's rulings in its row, C05's D-125 tests, checklist on main (#211)
    * D-126 (a bought LED profile replaces 811204 and 811205), D-125's rulings in its row, C05's D-125 tests copied, the checklist regenerated on main
    - D-126: the light shelf's down-light uses a bought aluminium LED profile, about 30 x 12, with a clip-in opal
    diffuser, end caps and clips, in place of the folded channel 811204 and the cut diffuser 811205; both numbers
    cancelled (D-123) and marked so in the allocation list once INTERIOR's list drops them; the profile parts get
    bought lines, product on HOLD until ELECTRICAL names it. Fallback: 5 mm return lips and a 27.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
    [document-register.csv]
2026-11-01 fusion_folder: read the folder with ONE listing per pass (DataFiles.asArray), not count + item(i), which fetched the whole listing again for every entry (#213)
    Live 2026-11-01, Fusion's log: every DataFiles.item(i) on a new collection fetched
    the folder's contents again (about 2 s each), so a pass over the 86-entry team
    folder took about 3 minutes, and runs that read the folder a few times looked
    hung (WALL batch 2: 444 fetches in 15 minutes). Read-only sample on the real
    folder, before the change (owner's rule):
    asArray: 86 entries in 2.5 s, 1 fetch;
    count + item(i) on a new collection each time: 10 entries in 22.3 s, 12 fetches;
    count + item(i) on one kept collection: 10 entries in 1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
2026-11-01 D-126's LED profile parts numbered in ELECTRICAL's family: 718101 to 718104 (#212)
    * D-126's LED profile parts numbered in ELECTRICAL's family: 718101 profile, 718102 opal cover, 718103 end caps, 718104 mounting clips
    - Bought (PI) allocations in ELECTRICAL's 8000-8999 block, clear of its own 718001 to 718068: ELECTRICAL lists them,
    CEILING places them in the interior model (the PM, 2026-11-01). CEILING's pick, a Tech-Light P13-2 type profile with
    its C15 opal cover, is in the basis; the products stay on HOLD until ELECTRICAL names them. Family 71 parts need no
    joints-register row.
    - D-126's row names the numbers; the BOM README says bought parts take their family's 8000-8999 block. T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
    [100000_P01_POD-MASTER_BOM.csv, number-allocation.csv]
2026-11-01 ELECTRICAL (D-126): the light shelf's down-light profile parts 718101-718104 listed under INTERIOR's shelf 810201 (Tech-Light P13-2 type 23 x 12.5 with its C15 opal cover, end caps, clips; HOLD); dow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
    [710000_P01_ELECTRICAL-HARNESS-LIST_SPEC.csv, 710000_P01_ELECTRICAL-LOAD-TABLE_CALC.csv, 710000_P01_ELECTRICAL-PARTS-LIST_BOM.csv]
2026-11-01 HOLD as a whole word in the checklist and the BOM; tests for another part's row and the real run's D-125 list (Reviewer 6, #211) (#217)
    - A made part's own material, grade or status, the joints register's product status, and the BOM's HOLD flag read
    HOLD as a whole word: "holds", "holder" and "threshold" no longer count. Case is as before (the checklist any case,
    so "on hold" counts; the BOM capitals). No reading changes on main or the open PRs today.
    - New test: a bracket's row with 211199 in its parent cell reaches 211199's rows and isn't read. The old case never
    reached the filter (no cell was 211199), so it passed with the filter removed.
    - New test: main() passes the D-125 list to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
2026-11-01 Mechanical checks: Fusion run on main 3d6c2af (F-188 tray x draw wire); bolts found by register names; route bodies skip gap rules (#218)
    * Mechanical checks: Fusion run on main 3d6c2af: F-188 (CEILING tray x ELECTRICAL draw wire); bolts found by their register names; route bodies skip the gap rules
    - Fusion whole-pod run on main 3d6c2af (356 bodies, 17 STEP files): 13 clashes, 12
    allowed; F-188, severe, CEILING; ELECTRICAL: the ceiling lining tray 513101 (right
    cassette) and the draw wire 710031 overlap by 69.7 mm3. The tray's Ø19.10 holes in
    both returns sit at X 583, Z 2337.5; ELECTRICAL's front grommet matches, its back
    grommet G-CEIL-B is at Z 2330.0, 7.5 mm lower, so the wire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
2026-11-01 drawgen (D-112, D-113): part drawings from each part's STEP, outside Fusion; sample of five (#202)
    * drawgen (D-112, D-113): part drawings from each part's STEP, outside Fusion; sample of five
    tools/drawgen: exact OCC hidden-line projection (HLRBRep_Algo) to an ISO first-angle PDF:
    true arcs, a view of every drilled face, removed sections through two-wall holes
    (ISO 128-50), one hole table per face with X (mm) / Y (mm) from a named origin,
    datums, mitre angles, cut lists, the project title block, Creator drawgen, and the
    sources with their hashes in the PDF. Read-back checks every STEP hole against the
    tables and the drawn circles with the repo's own STEP reader. Never overwrites a
    drawing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
2026-11-01 fusion_folder: a listing shorter than the collection's count can't lose a file; the missing slots count as unreadable, are read again, and are refused if they never appear (Reviewer 5, P2 on #213) (#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
2026-11-01 ELECTRICAL (D-127): 718102 is the satin cover passing at least 86 % (HOLD), renamed in the parts list and its allocation row together (Control's names); light figures 350 to 364 lx on the ledge when 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
    [100000_P01_POD-BOUGHT-PARTS_BOM.csv, 100000_P01_POD-MASTER_BOM.csv, 710000_P01_ELECTRICAL-LOAD-TABLE_CALC.csv, 710000_P01_ELECTRICAL-PARTS-LIST_BOM.csv, number-allocation.csv]
2026-11-01 D-127 (satin cover), FAI K-I06/K-I07 for the bought down-light; tabulated drawings cover parts with no BOM row (111212-111214) (#221)
    * WIP: tabulated drawings cover parts with no BOM row; master BOM after #216
    * D-127 (satin cover for the light shelf's LED profile), FAI K-I06/K-I07 and section H for 718101-718104; tabulated drawings cover parts with no BOM row
    - D-127 logged as the PM ruled it, with its reason; D-126's notes say its opal cover is replaced. 718102's rename
    goes with ELECTRICAL's #219 (script and allocation row together, the PM).
    - FAI plan: K-I06 (at least 350 lx on the ledge, on the sample, D-127), K-I07 (the boug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
2026-11-01 ELECTRICAL (F-188): drift test for the ceiling route's crossing heights (Z 2330 into CEILING's tray back return, Z 2337.5 out of its front return), read from the skeleton CSV's numbers; fails if they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
2026-11-01 fusion_drawing.py: shared drawing helpers for every team, given to each script by the runner like fusion_folder: pictures scaled to their real width, the first-angle symbol in two sketches, the view 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
    PM 2026-11-01, after CEILING's first drawing showed four traps that sit in every
    team's drawing scripts. insert_image (58.02 mm at scale 1 on A1/A2/A3; unmeasured
    sizes refused), first_angle_symbol (outline one closed chain in its own sketch,
    circles in another), base_view (style and scale set again on the made view, then
    checked), DimensionSet (each linear dimension once, same points and the same
    measured direction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
2026-11-01 drawgen: 111103 back band tube with the side band's datum scheme; replaces BASE's Fusion drawing (PM ruling on #202) (#225)
    * drawgen: 111103 (BASE back band) with the side band's datum scheme; a long part keeps a legible scale
    - specs: BASE_BACK_BAND. Datum B is the spigot rivnut under B1's round spigot hole, by the closing seam
    (X -102.75: BASE feature rationale FB-05, WALL 211201 F03), so B2's round spigot is within ±0.1 of it (joints
    register 2.11, ST-02, ST-04); A the top face, C the outer face (Y 850); the other holes Ø0.4 to A|B|C (R-J6).
    PM ruling on #202: both band tubes read the same, and this drawing replaces BASE's Fusion one.
    - spigot_origin: spigot_near picks the round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
2026-11-01 Drawing title blocks: fill DWG No., Rev., status and title from the file name and the master BOM in the shared finish step (#222)
    * Drawing title blocks: pdf_title_block.py fills DWG No., Rev., Document status and Title (from the file name and the master BOM, 2.5 mm letters or more); pdf_clear_field.py runs it, so every team's finish step fills the block; offline tests
    * pdf_title_block: measure one-line values with the font's own widths (fitz.get_text_length undercounts ±, ° and Ø)
    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
2026-11-01 Corner key family 111211 to 111214: TABULATED drawing, drawn again with every dimension linked (#215)
    * Corner key family 111211 to 111214: the TABULATED drawing, drawn again with every dimension linked to the model (the top view's fixing holes at 10.5 and 24.5, not the unlinked 28)
    * pdf_title_block: measure one-line values with the font's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
2026-11-01 drawgen: three layout fixes from the frame dry runs; 111101's mitre value off its arc (#228)
    * drawgen: removed sections start under every view's title; member balloons keep clear of tags
    Found on WALL's upper frames (211103, 211104; dry run, not registered): with no view under the principal, the
    row of removed sections sat in the principal's title band (a section callout ran into the title), and a member
    balloon's leader ran through a tag. The row now starts under every view's title; a balloon takes its usual place
    when that is clear, else the next of other offsets, the other side, other points along the member. Both upper
    frames now read back clean; the #202 sample and 111103 are unchange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
2026-11-01 Roll-up: D-126's LED profile parts counted (with the shelf, less the replaced channel and diffuser); ELECTRICAL strip 6.38 m; pack.py rerun (#230)
    * Roll-up: ELECTRICAL's strip text from its current list (6.38 m); the light shelf's line carries ELECTRICAL's down-light profile parts 718101-718104 listed under 810201 (0.210 kg) and leaves out the channel and diffuser 811204/811205 that D-126 replaced (0.189 kg) while INTERIOR's list still has them (S51); pack.py rerun (D-110); pod still 407.6 kg
    * Remove a committed Python cache file; root .gitignore for __pycache__/ and *.pyc (PM's ask on #230)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
    [910000_P01_PACKING-LIST_BOM.csv, parts-decided-P04.csv]
2026-11-01 FRONT's D-120 member numbers: 48 tube parts for DL's, DT's and DR's 63 frame tubes (352101-352116, 352201-352211, 352301-352321) and DL's stop pieces 351105-351107 (#232)
    From FRONT's corrected member list (via the PM). Repeats share a number only where the block STEP on #105
    (5033e10) maps one tube onto the other corner for corner and hole for hole by a turn, never a mirror: DR's
    facet (3) and chamfer (2) tubes, DT's chamfer cross tubes (3), DL's ring tubes (4 + 4 + 3 + 3). DR's F06 and
    B07 differ (lower ends 41.0 and 62.0 degrees from square); DL's R1O and R1F keep their own for the spigot hole
    and slot. The stop: ST2 and ST3 are one shape (614.5), so 3 numbers. Names in English and Vietna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
    [100000_P01_POD-MASTER_BOM.csv, number-allocation.csv]
2026-11-01 Mechanical checks: D-128 (felt and fill on their DXF and row), D-113 severity for drawgen parts, holes from a part's own STEP; register on main f3013d7: 11 closed (#233)
    - C05, D-128 (extends D-89 part 3): a felt or fill piece cut from sheet or roll,
    with through-openings or edge notches only, needs no drawing when its DXF gives
    the full outline with every opening and its row gives material, density or grade,
    thickness, tolerance and part number. Read from the files: the STEP shape is cut
    straight through (two flat faces at the sheet's levels, every other face square to
    them: prism_shapes); the DXF draws the same number of closed shapes as the STEP's
    sheet face, its outline the S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
2026-11-01 9 AIR-family numbers for CEILING's AIR follow-up (fan box bulkheads 611403/611404, linings 611405-611407, D-120 splits 611109-611111 and 611211); D-123's row: 351103 cancelled once FRONT splits the s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
    Next free numbers in AIR's own series on #91 (fan boxes 6114xx, column 6111xx, soffit 6112xx); free on main and
    every open PR, and clean against AIR's list on #91. The old numbers keep the first shape (611103 the two front
    9 x 20 angles, 611104 and 611105 the front pieces, 611203 the under piece). Master BOM regenerated; pack.py rerun.
    [100000_P01_POD-MASTER_BOM.csv, number-allocation.csv]
2026-11-01 FRONT decor blocks DL, DT, DR (350001-350003): skins, tube frames, DR air parts (#105)
    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
    [100000_P01_POD-BOUGHT-PARTS_BOM.csv, 100000_P01_POD-MADE-PARTS-BY-PROCESS_BOM.csv, 100000_P01_POD-MASTER_BOM.csv, 350001_P01_FRONT-DECOR-BLOCK-ASSY-DL_BOM.csv, 350001_P01_FRONT-DECOR-BLOCK-ASSY-DL_CAD.f3d, 350001_P01_FRONT-DECOR-BLOCK-ASSY-DL_STEP.step, 350002_P01_FRONT-DECOR-BLOCK-ASSY-DT_BOM.csv, 350002_P01_FRONT-DECOR-BLOCK-ASSY-DT_CAD.f3d]
2026-11-01 fusion_drawing: the first-angle symbol keeps 6 mm clear of the frame and the title block, and a symbol closer than that is refused (FRONT and CEILING 2026-11-01: an edge on the border's line printed 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
2026-11-01 Packing list: DL, DT and DR numbered from FRONT's merged lists (350001 to 350003); seals allowance wording after #105 (#237)
    - DL 350001, DT 350002, DR 350003 with FRONT's names ("FRONT - DECOR BLOCK ASSY - ...") and
    Vietnamese names; check K13 confirms each against the master BOM.
    - The seals allowance now reads "Base seal and cable grommets, fitted on the band and the
    panels": the door edge seals are in FRONT's parts since #105.
    - The open item on TBD numbers lists its owners from the pieces still TBD (AIR, BASE,
    ELECTRICAL, WALL); a stale comment on ELECTRICAL's line no longer quotes a fixed share.
    - The fill-by-name test uses the air column (still TBD) with a test-only number.
    27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
    [910000_P01_PACKING-LIST_BOM.csv]
2026-11-01 run_script --doc: a design listed twice just after it was made is read again for up to 30 s before the open refuses (CEILING's C1 sample: the cloud lists a new design twice for about 10 s) (#238)
2026-11-01 J-BASE-02 for D-129: the back corners' keys on the side bands, against their inner walls; the back band's end caps take them in open slots (it drops in between both side bands); held down by its weig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
    [corner-keys.csv]
2026-11-01 Mechanical checks: a part's copies must match its own STEP (F-189 WALL's spigots); register after FRONT #105 (#239)
    * Comments: BASE's copy of key 111211 is the key turned 180 degrees, not an older version
    * Mechanical checks: a part's copy in another team's STEP must be the part its own STEP holds; register on main d79cd8c: F-189 (WALL's spigots 2 mm longer)
    - C06 copy-differs: a part copied into another team's STEP (a key, spigot or washer in
    a band or panel) must have its own STEP's hole layout, however the copy is turned
    (hole centres about their centroid, all 24 quarter turns tried, hole sizes within
    0.15 mm: a tapped hole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
2026-11-01 Mechanical checks: the assembled shell's left, right and top faces are checked once their parts are on main (#242)
    - The shell faces' part names never matched the real assembly: its top components are
    the files' hyphenated names (210101_P01_WALL-PANEL-ASSY-SIDE-LOWER-LH_CAD,
    350001_P01_FRONT-DECOR-BLOCK-ASSY-DL_CAD) and the back panels are B1 to B4, so only
    left-base was ever checked. Words now match across spaces or hyphens, DL/DR/DT/C1/C2
    may run into the file name's _CAD, and B1-B4 count as the back panels.
    - A side face also needs its side band (its bottom seam closes on it), so the right
    face waits for BASE's right band.
    - A strip no wider than the decided seam along a face's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
2026-11-01 D-128 in the checklist (C05's functions); the live 410.0 kg after #105; ISS-087 closed, K-D04 24 tubes; D-129 with its addition (#240)
    * WIP: D-128 in the checklist through C05's functions; drawgen list from C05's reader
    * D-128 in the checklist through C05's functions; the live 410.0 kg after #105; ISS-087 closed, K-D02/K-D04 from DR's CAD; D-129 logged with its addition, FAI K-B08/K-B11
    - Checklist: a felt or fill piece whose DXF and row C05's prism_shapes and felt_dxf_lacks pass shows "DXF and row
    (D-128)", after D-89's cut-list route, as C05 orders them; drawgen's list from C05's shared reader. CEILING's ceiling
    fills 513301-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
    [100000_P01_POD-MASTER_BOM.csv, issue-register.csv, number-allocation.csv]
2026-11-01 J-BASE-02 for D-129, BASE's fit check: the back band's end-cap slots open at the bottom edge and run up to 2 above the upper stud (a lowered cap meets the studs with its bottom edge), and a 12 x 9 no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
    [corner-keys.csv]
2026-11-01 Packing: every piece's size from its own CAD (check K14); pallet 2 re-planned on the real parts; D-129 keys on the side bands (#247)
    FRONT's decor blocks (#105) came out bigger than the boxes pallet 2 was planned on, so the
    plan now takes each piece's size from its merged CAD and checks it.
    - K14: each piece's planned size must hold the box of its own CAD as it ships (what the CAD
    shows fitted to it, less what ships elsewhere), read from the 21 STEP files under
    v2/03-Manufacturing with the mechanical checks' reader (2 s). Bundles and cartons are
    checked part by part. 29 pieces checked; 13 have no CAD yet and keep planned sizes.
    - Sizes from CAD: DL 2292 x 308 x 199 (hinge-side stops),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
    [910000_P01_PACKING-LIST_BOM.csv]
2026-11-01 Mechanical checks: the PM's drawing traps in C05 (ELECTRICAL's PDF read-back); register F-211 to F-226 (#248)
    * pdf_traps.py: read a drawing PDF back for the PM's four drawing traps (letter height, triangle symbol, hidden lines by view, a dimension printed twice), for the Checker to fold into C05; tests on layered synthetic sheets and a real Fusion export
    * Mechanical checks: the PM's drawing traps in C05 (ELECTRICAL's PDF read-back); hidden-lines allow list; register on main e8ae80b: F-211 to F-226
    - C05 reads every drawing PDF back with ELECTRICAL's pdf_traps.py: text under 2.5 mm
    capital height (title-block labels under 1.8) and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
    [hidden-lines-allow.csv]
2026-11-01 Assembly guide step 2: nobody lifts or stands on the back band until step 4; #246's slots; the front pieces in J-BASE-02's order (#249)
    - Caution in step 2 (Joints' register asks for it): nobody lifts the back band or stands on
    it until B1 and B2 bolt through its top wall in step 4; only its weight holds it on the
    studs until then. Steps can now carry a "Caution" line.
    - The back band goes straight down between the side bands and the slots in its end caps take
    the studs from below (#246: slots open at the bottom edge, notches for the heads).
    - The front pieces in J-BASE-02's order: FL1, FL2 at the knee, the intake support rail with
    the mesh piece, and FR1 last onto the rail; each off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
    [910000_P01_PACKING-LIST_BOM.csv]
2026-11-01 BASE sheets 111401 and 110401: notes at 2.5 mm letters, 80 KB instead of 15 MB; the finish script leaves the generator's band tubes alone (#250)
    * BASE sheets 111401 and 110401: notes at 2.5 mm letters (were 1.3 to 1.5 mm); finish script refuses the generator's band tubes
    ELECTRICAL's PDF check found the notes on 111401 printing under the 2.5 mm
    minimum. finish_pdfs.py now sets the notes' font size to 3.5 mm, so capitals
    are 2.5 mm tall (ISO 3098), and sizes the notes box from the wrapped rows,
    with the right-side box 24 mm in from the sheet edge so it stays inside the
    frame. If the notes don't fit the box, the script now stops instead of
    saving a sheet without them (PyMuPDF writes nothing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
2026-11-01 D-130 logged with the noise lines; 611502/611303 for CEILING's D-130 parts; D-129's open-slot wording (#246); C05's DXF pick in the checklist (#251)
    * WIP: D-130 logged; noise lines and FAI F-04/K-A05 at D-130's figures
    * D-130 logged; noise lines and FAI F-04/K-A05 at D-130's figures; D-129 says open slots, with #246's final slot words; 611502 and 611303 for CEILING's D-130 parts; the checklist takes C05's own DXF pick (Reviewer 6, #240)
    - D-130 (sealed intake boot and gaskets): 25.0 / 29.5 dB(A), 66.7 l/s (the Air Engineer), 0.5 under the limit;
    ISS-090 open. README, the log's headline, REQ-AIR-02/REQ-SND-03, ISS-074, ISS-090, FA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
    [100000_P01_POD-MASTER_BOM.csv, issue-register.csv, number-allocation.csv]
2026-11-01 D-130's notes: DR's access and inner panel gasket is 848013 SEALS - ACCESS PANEL SEAL - 1.0 THICK - SOFT FOAM PSA, product HOLD (848012 can't take the 62% squeeze, Joints); its row goes in the joints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
2026-11-01 Joints register: the access-panel seal 848013 (H-34) for DR's access and inner panels on their 0.76 stops, in place of 848012, product HOLD-19 (D-130's notes; number from Control) (#255)
2026-11-01 WALL's B3/B4 upper top rail 212701 and B3/B4 frame parents for B1/B2's shared members; FRONT's DR seam bar 351307 (#256)
    * WALL's B3/B4 upper top rail 212701 (shared, turned end for end) and B3's/B4's frames 211203/211204 as parents of B1's/B2's shared members; FRONT's DR seam bar 351307
    - 212701 WALL - FRAME RAIL TOP - BACK UPPER - B3 AND B4: one part in both frames, with the ceiling bolt holes in place
    of the rivnuts; F 7 in WALL's 212FMM band, after B1's 5 and B2's 6.
    - B3's frame 211203 takes B1's 212501, 212503, 212504, 212505 and B4's 211204 takes B2's 212601, 212603, 212604,
    212605 under the same-part rule (per pod doubled); WALL confirms with the whole-solid check once built.
    -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
    [100000_P01_POD-MASTER_BOM.csv, number-allocation.csv]
2026-11-01 848013 re-specified to the 400 mm pair (PM ruling): a very soft 4.0 strip on 838004 stops (panels 2.36 off DR's frame), about 25 screws instead of 52; HOLD-19's question; T06 gets 5 coupons in DR's 2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
2026-11-01 Joints register: H-14 says "see H-34" for DR's panels instead of naming 848013, so the BOM reader maps 848013 to H-34, not to the cassette edge seal (#258)
2026-11-01 AIR P01: air column, soffit, cartridges, fan boxes, riser, roof sleeve (D-60 to D-62, D-87) (#91)
    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
    [100000_P01_POD-BOUGHT-PARTS_BOM.csv, 100000_P01_POD-MADE-PARTS-BY-PROCESS_BOM.csv, 100000_P01_POD-MASTER_BOM.csv, 610000_P01_AIR-PARTS-LIST_BOM.csv, 610000_P01_AIR_CAD.f3d, 610000_P01_AIR_STEP.step, 611101_P01_AIR-COLUMN-FACE-FRONT_DXF.dxf, 611102_P01_AIR-COLUMN-FACE-LEFT_DXF.dxf]
2026-11-01 BOM register reader: a number a set row only mentions, while its own part-number row carries another H-id, isn't that row's (848013 was read as H-14's cassette edge seal); 351307 cancelled before use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
    - parse_register first notes each number's own ID from the part-number tables, then skips such a number in a hardware
    set row of another ID. On main's register only 848013 changes: H-34, SEALS - ACCESS PANEL SEAL - 4.0 THICK - VERY
    SOFT FOAM PSA. The new test fails on main's old reader.
    - 351307 CANCELLED, never reused; D-130's notes give the one-panel change (the PM).
    - Master BOM, checklist and packing regenerated.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
    [100000_P01_POD-MASTER_BOM.csv, number-allocation.csv]
2026-11-01 Roll-up: D-126 profile source gets its own label S52 (S51 was used twice); test for repeated source labels; pod total unchanged (#244)
    * Roll-up sources: D-126's profile source gets its own label S52 (it shared S51 with FRONT's decor blocks, so the second entry hid it); test that every source label and input name is written once; outputs rerun, pod still 410.0 kg
    * Roll-up sources: the D-126 profile takes S53, since CEILING's #91 gives AIR's source S52; outputs rerun, pod still 410.0 kg
    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
    [parts-decided-P04.csv]
2026-11-01 Air report: D-130 (DR's cavity, intake boot, gaskets) and the DR sizes FRONT and AIR share; 25.2 / 29.6 dB(A), boost 66.2 l/s; 410.4 kg (#254)
    * Air report: D-130 (DR's cavity, the sealed intake boot, gaskets) and the DR sizes FRONT and AIR share; 25.2 / 29.6 dB(A), boost 66.2 l/s; 409.9 kg as shipped; packing regenerated
    FRONT's DR (PR #105) is bare inside with its base open to the intake and the
    riser's foot inside it, so the supply fans' unsilenced inlet noise would fill
    DR's cavity: about 37.8 dB(A) at 65 l/s (estimate). D-130's sealed boot from
    the mesh to the riser's foot, gaskets on DR's inner and access panels and on
    each cartridge's inlet end fix it. calc.py now feeds DR's cavity w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
    [910000_P01_PACKING-LIST_BOM.csv, parts-decided-P04.csv]
2026-11-01 Packing: AIR's CAD (#91) in the size check; air parts numbered and sized from it (#260)
    - K14 now covers the five air pieces from AIR 610000 P01 STEP: the soffit 610201 with its
    exhaust fan box (the exhaust cartridge ships on its own), the column 610101 (without the
    supply cartridge), the supply fan box 610401 joined with the riser, both transitions and its
    fans, and the cartridge 610301 for each path. 33 pieces checked; 9 have no CAD yet.
    - Sizes from CAD: soffit 2322 x 359 x 280 with the roof sleeve standing on its fan box (the
    roll-up puts the sleeve in the soffit; AIR to confirm), column 2108 x 359 x 212, supply fan
    box 2005 x 516 x 203 (was 1845 x 460 x 199). C2 is 48 thick wi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
    [910000_P01_PACKING-LIST_BOM.csv]
2026-11-01 After #254: the noise lines and FAI F-04 at the air report's 25.2 / 29.6 dB(A) and 66.2 l/s (0.4 under the limit); the weight at the live 409.0 kg; requirements' DL row D-01 to D-130 (Reviewer 6) (#2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
    - Noise: README, the log's headline and D-130's notes, REQ-AIR-02/REQ-SND-03, ISS-074, ISS-090 (open), FAI F-04 and
    PLAN now quote the air report (PR #254); the Air Engineer's first D-130 figures (25.0 / 29.5, 66.7 l/s) stay as history.
    - Weight: 410.0 kg (PR #105), 408.5 kg with AIR's parts from CAD (PR #91), 409.0 kg as shipped with D-130's boot and
    gaskets (PR #254): 11.0 under the cap, 1.0 under the target; C6 96.2 kg/m2; FAI F-09.
    - Checklist regenerated on main and the open PRs.
    Co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
    [issue-register.csv]
2026-11-01 Roll-up: the roof sleeve ships with the roof grille and C2, not on the exhaust fan box; packing regenerated; pod total unchanged (#263)
    The sleeve 611601 fills C2's roof slot (285 x 294), so it can't stand on the
    exhaust fan box while the soffit is lifted and slid 24 mm onto its studs;
    AIR's parts tree has it beside the soffit too. It moves from the exhaust fan
    box's line to the roof grille's (both AIR lines, item starts unchanged for
    pack.py), so the packing plan ships it with C2: C2's piece +0.62 kg, the
    soffit's -0.62 kg. Pod as shipped still 409.0 kg. pack.py rerun; its notes on
    the sleeve riding in the soffit are Packing's to update.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
    [910000_P01_PACKING-LIST_BOM.csv, parts-decided-P04.csv]
2026-11-01 D-130's notes: DR's one removable panel 351305; 351303 cancelled once FRONT drops it; felt 351304 on 351305; FAI K-D07 to K-D09 (#264)
    * D-130's notes: DR's one removable panel is 351305 (DR removable inner face panel); 351303 cancelled once FRONT's list drops it; the felt 351304 glued to 351305 (the PM); FAI K-D07/K-D08/K-D09 follow
    * K-D09's datum is 351305's edge, the one panel the felt is glued to (Reviewer 6, #264)
    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
2026-11-01 Roof sleeve and grille ship loose with C2 and go on after the soffit hangs (#263): new guide step 18 (#265)
    - C2 carries the roof sleeve 611601 seated loose in its roof slot (taped) and the grille 611602
    taped over it: 70 thick in K14 and in pallet 1's stack (960 of 1016 mm). Both come off at
    unpacking.
    - The soffit no longer carries the sleeve: back to its CAD size 2322 x 359 x 233; its note
    says the sleeve's gasket is on the fan box's top. Step 17 hangs the fan box under C2's roof
    slot, and its check asks for the gasket square under the slot.
    - New step 18, "Roof sleeve and grille": from a step stool outside the front right corner, drop
    the sleeve through the slot onto its gasket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
    [910000_P01_PACKING-LIST_BOM.csv]
2026-11-01 Mechanical checks: D-131 and D-132 (cancelled cleats, floor parts and threshold; the base seal lip required; pod cap 460 kg) (#266)
    - C06 cancelled-by-decision (major): a team parts-list row or CAD part that a decision
    cancelled (config/cancelled-items.csv): D-131's cleats (the frames are welded
    galvanized steel), D-132's floor panels, foam and threshold (the pod has no floor).
    - C06 required-by-decision (major): an item a decision added that no list or CAD part
    in its team's folder names yet (config/required-items.csv): D-132's base seal lip.
    - C04: the pod cap comes from config/policy.csv, 460 kg (D-131, provisional until the
    wall sample's recount; it was 420).
    - C10's bare-steel f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
    [cancelled-items.csv, policy.csv, required-items.csv]
2026-11-01 Findings register: run on main 5fa198d (AIR F-227 to F-268; D-132 F-269 to F-272); BASE's letter-height findings closed (#252)
    * Findings register: run on main 75b3f86 after BASE's redone floor panel sheets (#250): F-211 and F-216 (letter height) closed; 116 open
    * Findings register: run on main 5966c3e after AIR P01 (#91): F-227 to F-268 for CEILING (AIR); 158 open (50 severe)
    * Findings register: F-227 to F-268 (AIR) posted to CEILING
    * Findings register: run on main 5fa198d with D-131/D-132's rules (#266): F-269 to F-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
    [fastener-schedule.csv]
2026-11-01 AIR's parts list: the roof grille's fixings (M6 bolts, washers, rivnuts in the sleeve's flange); roll-up counts AIR's register hardware once (#267)
    * AIR's parts list: the roof grille's fixings (4 M6 x 16 bolts, washers, rivnuts in the sleeve's flange); roll-up counts AIR's register hardware once; packing regenerated
    The roof grille goes on from the roof after the soffit hangs, over the roof
    sleeve's top flange, with the pod's one 5 mm key (R-J2): 4 x 838001 M6 x 16
    socket head bolts and 4 x 838004 washers into 4 x 838003 M6 rivnuts the
    factory sets in the sleeve's flange, one near each corner (Packing's open
    item from #265). air_model.HARDWARE carries them and air_exports.py writes
    every h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
    [100000_P01_POD-BOUGHT-PARTS_BOM.csv, 100000_P01_POD-MASTER_BOM.csv, 610000_P01_AIR-PARTS-LIST_BOM.csv, 910000_P01_PACKING-LIST_BOM.csv, parts-decided-P04.csv]
2026-11-01 D-131 (steel frames), D-132 (no floor), D-133 (US 120 V mains), D-134 (designed for US use; certifications later), D-135 (ACP flex limit) logged; requirements, headline, FAI and plan in line (#268)
    * D-131 (welded galvanized steel frames), D-132 (no floor), D-133 (US 120 V mains) and D-134 (ACP flex limit) logged; the requirements, headline, FAI plan and plan in line (the PM)
    - D-131: wall, ceiling and decor-core frames to welded galvanized steel box tube with the same outside sections; cleats
    cancelled; gauges from the Joints check; cap 460 kg as shipped, provisional until the sample panel's recount.
    - D-132: no floor; the base seal becomes a soft lip on the band's inner face on the room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
    [issue-register.csv]
2026-11-01 Mechanical checks: D-135, every wall bay under the ACP 275 mm clear or less; F-273 to F-278 for WALL (#270)
    * Mechanical checks: D-135, every wall bay under the ACP skin 275 mm clear or less; register on main 5c8f25a: F-273 to F-278 for WALL
    - C09 acp-bay (major): each wall panel frame's bays (its outline less every member,
    in the frame's own plane, read from the CAD) must be 275 mm clear or less across
    the short span: WALL's span table (ACP-SPANS.md on wall-studs: plate simply
    supported on 4 edges, 3 mm ACP with 0.21 mm skins) gives 1.99 mm under the 100 N
    push for 274.8 mm, against D-135's 2 mm. Read from geometry, so studs in either
    direction and cross members count.
    - On main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
    [fastener-schedule.csv]
2026-11-01 Assembly guide: glass stays and setting packers in the kit, panes tilted up on their long edge; first install sheet (design review) (#271)
    Design review items for the guide (the Lead, 2026-11-01):
    1. Step 10: the fixed glass stands on 2 clamp-on glass stays (new in the kit) once it is in
    its sill channel, so both people carry DR (2.3 m) and slide it in; nobody holds the glass
    by hand meanwhile (a caution line). The stays come off after DR's bolts.
    2. Step 11: 2 setting packers (7 mm, new in the kit) stand the door at hinge height while its
    hinge halves go on; they slide out before the door swings.
    3. Both panes are tilted up in the crate on their padded long edge, both lifters at th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
    [910000_P01_PACKING-LIST_BOM.csv]
2026-11-01 Install sheet: the elevator and door rule (check K15); packing: ISPM 15 heat-treated, stamped export wood (US review) (#274)
    1. Delivery: new check K15 leans each piece, as carried (in its wrap; the panes out of the crate
    on their suction lifters), into an elevator car through its door: one face across the door
    with 20 mm a side for hands, the lower end sliding on the car floor toward the door while the
    front stays inside, failing on the car's ceiling or the door head.
    - A typical passenger car (2032 x 1295 mm, 8 ft, 36 in door) takes every piece but DR: DR's
    1030 mm face (in its wrap) can't go across a 914 mm door, and on edge it hits the ceiling.
    - The install sheet's r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
2026-11-01 Control batch after #268: review fixes; WALL's D-131 fill numbers (#198's 15 cancelled); frame steel with Z100; D-136 kit feeds; D-137 Sikaflex-252 bond; floor seal test T15; ISS-091; PLAN's delivery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
    * Control batch after #268: review fixes, WALL's D-131 fill numbers, frame steel spec, D-136 kit feeds, floor seal test, parked fire risk
    * Master BOM, BOM check and release checklist rebuilt on main 5bfe9e5 (packing outputs current)
    * D-136: plainer wording of what it affects
    * Lead's review edits: D-136's 48 W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
    [100000_P01_POD-MASTER_BOM.csv, issue-register.csv, number-allocation.csv]
2026-11-01 Air report: D-131's steel frames and D-132's removed floor in the mass inputs; sound holds at 19.3 dB; fan noise 25.1 / 29.6 dB(A); model weight 459 kg (#277)
    * Air report: D-131's steel frames and D-132's removed floor in the mass inputs; sound holds at 19.3 dB; fan noise 25.1 / 29.6 dB(A), boost 66.3 l/s; model weight 453 kg
    Frames: the Joints Engineer's gauges (1.0 mm for perimeters, 40 x 40s and
    members with a fixing; 0.8 mm for studs; Z100 zinc) put about 46 kg more on
    the 10 wall and ceiling frames (source); spread over the model's 16.0 m2 of
    wall and ceiling, the 20 x 40 frames go from 1.87 to 4.75 kg/m2 and every v2
    frame in the search takes the same steel-to-aluminium ratio (calcul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
2026-11-01 Register: base seal 118001 renamed for D-132 (a soft lip on the room floor, T15); DR's one inner face panel and its seal cut round the washers on the 20 mm tubes; DR's panel-screw rivnuts in 0.8 mm s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
    - H-06 and 118001: BASE's name "BASE - BASE SEAL - LIP - ROOM FLOOR - HOLD", a soft lip bonded along each band
    piece's inner face, 21.5 below the band, touching the room floor over glide settings 8.5 to 18.5, none across
    the door; J-BASE-01, J-T4 (taken by the package's T15) and HOLD-06 follow.
    - 848013 paragraph, H-34 and HOLD-19: DR's one removable inner face panel 351305 (D-130's PM ruling); on the 20 mm
    tubes the seal is cut round each washer, foam ends a little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
2026-11-01 J-FRAME-01: welded galvanized steel frames (D-131), steel rivnut, roof grille joint J-AIR-03 (#275)
    * J-FRAME-01: welded galvanized steel frames (D-131); steel rivnut; roof grille joint J-AIR-03
    - J-FRAME-01 (new 3.17): gauges 1.0 mm for perimeters, 40 x 40 and site-joint members, 0.8 mm for studs
    and the ceiling's cross members 2 and 3; steel yield 280 MPa or more, Z100, walls 95% of nominal or more;
    mitred corners with a 2 mm plate in each mitre (a plain mitre is about 0.66 of the tube, 137% on L2's
    corner lift); welded all round in a jig, MIG brazing preferred; no hot-dip after welding, no vent holes;
    every joint hole and rivnut after welding; seam faces flat to 0.5; isolation; c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
    [parts-decided-P04.csv]
2026-11-01 Assembly guide step 18 takes J-AIR-03's 4 roof grille bolts (stacked on #275 at 65d0a36) (#276)
    every joint hole and rivnut after welding; seam faces flat to 0.5; isolation; cance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
    [100000_P01_POD-MASTER_BOM.csv, 910000_P01_PACKING-LIST_BOM.csv]
2026-11-01 Mechanical checks: renamed register parts name every file and team (838003 steel CAH2, D-131); register on main 9e0dcd1: F-279 (#280)
    * Mechanical checks: a renamed register part names every file and team still on the old name, major when the maker code or material changed (838003 now the steel CAH2, D-131); mitre plates out of the fastener list; register on main 9e0dcd1: F-279
    * Findings register: F-279 posted to its five owner groups
    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
2026-11-01 Control batch after #273: D-131 sample package and FAI (T06 to T09 on steel, T16 welds, S1 steel L1), master BOM takes the register's hardware names (838003), bond spec row (D-137), D-138 door hinges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
    * Master BOM: a number the joints register owns takes the register's name (D-99); a team row with the old wording is that team's to-do (838003's steel re-spec); 2 tests
    * D-131 sample package and FAI from the joints register's J-FRAME-01: T06 to T09 on galvanized steel, T16 the welded joints (J-T7), S1 a welded steel L1, R2 and their parts rows (P02, P02A, P02C, P02F, P02S, P04, P05, P27, P28), H11 closed,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
    [100000_P01_POD-BOUGHT-PARTS_BOM.csv, 100000_P01_POD-MASTER_BOM.csv, document-register.csv, issue-register.csv, number-allocation.csv]
2026-11-01 Air report: the upper transition's loss counted, through the full-depth passage beside the fan box with turning vanes; box at X 673 to 973, 25 mm back (PM rulings); 25.4 / 29.8 dB(A), 65.5 l/s at the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
    FRONT's fan box points turned up a gap: the model counted no loss where the supply air leaves the box's top
    and turns across to the opening into the column, and both DR models tied the passage beside the box to the
    box's back face (about 50 mm deep, 25 after the move), which the supply fans couldn't push 53 l/s through.
    PM rulings 2026-11-01: FRONT keeps the passage clear for the full depth beside the box (Y -822 to DR's back,
    Z 1895 to 2110), AIR adds turning vanes, a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
2026-11-01 F-279: rivnut 838003 named as the joints register now gives it (the zinc-plated steel Sherex CAH2-610-4.2, D-131) in CEILING's and AIR's parts lists and sources: name, material, finish, SKU, and the 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
    [100000_P01_POD-BOUGHT-PARTS_BOM.csv, 100000_P01_POD-MASTER_BOM.csv, 410000_P01_CEILING-PARTS-LIST_BOM.csv, 610000_P01_AIR-PARTS-LIST_BOM.csv]
2026-11-01 Guide: the riser step before the wall linings and R1's and R2's cassettes off before DR's inner face (the PM's ruling); riser assembly 169 deep (#286)
    1. The Air Engineer's joined riser and supply fan box is now 169 mm deep plus D-130's intake
    boot (was 189): the piece's note and PK-05 say so.
    2. The PM's ruling: DR's inner face can't come off past R1's and R2's cassettes.
    - Take-down: R1's and R2's cassettes come off their clips first, then DR's inner face.
    - Assembly had the same clash: the wall linings (step 14) went on before the riser step,
    which takes DR's inner face off and on. The riser step now comes first (14) and the
    linings follow (15), still before the air col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
    [910000_P01_PACKING-LIST_BOM.csv]
2026-11-01 Mechanical checks: Fusion run on main 9e0dcd1, 30 clashes and 2 stub bolts (F-280 to F-311); the converter's own faults fixed first (#281)
    * Mechanical checks: Fusion run on main 9e0dcd1, 30 clashes (AIR with ELECTRICAL's harness and zone, AIR with FRONT's DR and the fixed glass, DR's access panel with the RH linings) and 2 stub bolts (F-280 to F-311); the converter's own faults fixed first
    - a reserved space takes its owner's parts (AIR in FRONT's DR air spaces, D-105), no one else's
    - a bolt is never blocked by its own bodies; a factory-fitted one (config/factory-fitted.csv: the base keys'
    screws and studs, J-BASE-02) only by its own band piece
    - a tapped hole is a thread (the allow lis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
    [clash-allow.csv, door-swing.csv, factory-fitted.csv, policy.csv]
2026-11-01 Control batch after #279: 352322 for DR's F09, the guideline as a reference (D-119), the bond spec row points at D-137 (#287)
    * 352322 for FRONT's new DR member F09 (front ring cross over the fan box); the guideline is a reference to check and the build plan the main guide (D-119) in the README and document register; the bond spec's row points at D-137 until it's reissued
    * Master BOM, BOM check and release checklist rebuilt on main 6553bc7 (352322 listed; 838003's old name left in 3 team lists)
    * Document register: the guideline row's scope note says secondary reference for v2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
    [100000_P01_POD-MASTER_BOM.csv, document-register.csv, number-allocation.csv]
2026-11-01 Mechanical checks: D-131's frame check, steel and gauge on every frame member from the Joints Engineer's table; register on main c22880b: F-312 to F-323 (#288)
    * Mechanical checks: D-131's frame check, steel callouts and gauges on every member of J-FRAME-01's 10 frames, from the lists and the CAD, against the Joints Engineer's own table
    The frames come from J-FRAME-01's Parts row and every gauge from v2/01-CAD-Native/joints/frame_steel_check.py
    (FRAMES, gauge(), ACCEPTED), loaded by its path: nothing copied. frame-steel (major): steel, an accepted grade or
    280 MPa, Z100, and the zinc-rich weld touch-up; frame-gauge (severe thin, minor thick or unknown role): each steel
    member row against it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
    [fastener-schedule.csv, steel-frames.csv]
2026-11-01 drawgen: key orientation notes on 111101 and 111103 from Joints' key positions (checked in the read-back); fill sheet dropped (D-128) (#243)
    * drawgen: the fill sheet is dropped (D-128): WALL's fill pieces go on their own DXFs
    The PM ruled (D-128) that a felt or fill piece with through-openings or edge notches only needs no drawing when its
    DXF gives the full outline and its row is full; WALL's fills are that case (their 60 x 60 x 40 pockets go through
    the 40 mm batt), so each piece goes on its own DXF in WALL's D-123 split and the tabulated fill sheet (211501 to
    211504, never on main) is dropped. The tabulated sheet code had no other part, so it goes too: tabulated.py and
    the read-back's t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
2026-11-01 Mechanical checks: a 'made by' in a drawing's notes isn't its Created by field; register on main a8cd10a: F-325 and F-326 closed (drawgen reads Autonomous) (#292)
    * Mechanical checks: a 'made by' inside a sentence of the notes isn't the Created by field (drawgen's sheet 2 after #291): a label starts its row or a new cell
    * Findings register: run on main a8cd10a (#291): F-325 and F-326 closed, drawgen's band tube drawings read Autonomous as Created by and author
    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
2026-11-01 Mitre plates 831007-831009 (J-FRAME-01, H-40 to H-42): native model, one STEP and one DXF per number; J-AIR-03 takes CEILING's flange layout (#294)
    - joints_hardware_build.py --arg only=plates: one tabulated design (tube_a, tube_b -> plate_len), fully
    constrained outline (the API's rectangle joins corners only, so each edge gets its own constraint), extruded
    2.0 symmetric on the mitre plane; each STEP carries its own part number; edit test PASS; a failed plate run
    closes its own unsaved design. Built 2026-11-01 07:05 UTC; step_check MATCH on all three (0.0005 mm or less).
    - V2-MFG-JNT-01 rows, BUILD-RECORD and the CAD README placement; the register's H-40 to H-42 note the build.
    - J-AI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
    [831007_P01_HARDWARE-MITRE-PLATE-20X40-45DEG_DXF.dxf, 831007_P01_HARDWARE-MITRE-PLATE-20X40-45DEG_STEP.step, 831007_P01_HARDWARE-MITRE-PLATE-TABULATED_CAD.f3d, 831008_P01_HARDWARE-MITRE-PLATE-20X40-TO-40X40_DXF.dxf, 831008_P01_HARDWARE-MITRE-PLATE-20X40-TO-40X40_STEP.step, 831009_P01_HARDWARE-MITRE-PLATE-40X40-45DEG_DXF.dxf, 831009_P01_HARDWARE-MITRE-PLATE-40X40-45DEG_STEP.step, V2-MFG-JNT-01_P01_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]
2026-11-01 start_drawing: retry each dialog press while Fusion still shows that dialog's command (#295)
    Fusion reports the Create Drawing or Base View command a moment before its Qt dialog shows up to
    accessibility, and the dialog's buttons can be rebuilt while it settles. One try then found "none"
    (Base View's Cancel, FE2 07:06; CEILING's tray and cassette 4 times) or "Invalid index" on OK
    (FE2 06:36), and the start failed although the cleanup found the dialog a second later.
    press() tries "none" or an accessibility error again every poll for up to 10 s, but only while
    Fusion still shows the same command, so a retry never presses in another dialog; when Fusion moves
    off the command after a failed try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
2026-11-01 drawgen: a lettered view square to an angled face (item 4); blind holes with drill points; THRU in solids (#296)
    - Holes square to a face no principal view looks at straight get a view square to that face (ISO 128-30:
    "VIEW D", an arrow in a drawn view that shows the face edge on, the letter by its tail), with its own origin
    and hole table, placed with the removed sections and details; it keeps the principal view's up where it can.
    A drawing stops (rather than guessing) when such a face is hidden by the part or no view shows it edge on.
    - A through hole drilled square to one face and leaving another at an angle is read from the square face.
    - Blind holes: a cone on the hole's axis at i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
2026-11-01 drawgen: D-131 weld notes for WALL's frames (J-FRAME-01) with a material guard; cut list names the list's material (#293)
    * drawgen: D-131's weld notes for WALL's frames (J-FRAME-01), with a material guard; the cut list names the list's material
    - WALL's frame entry: the cancelled cleat note goes; J-FRAME-01's welding (mitre plates 831007 to 831009, every
    joint welded all round, MIG brazing CuSi3 preferred or MAG G3Si1 after J-T7, jig and order, beads ground flush),
    finish (pre-galvanized Z100, no hot-dip, no vent holes, zinc-rich touch-up) and hole order (after welding,
    rivnuts after the touch-up) as general notes; the tolerance note takes its flatness and diagonals (seam faces
    0.5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
2026-11-01 Decision log: D-139 to D-144 (every part drawing from the generator; Autonomous as the drawings' creator; no cloud deletes in Fusion; DR's inner panel screws and washers; the generator's scope; the b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
    [document-register.csv]
2026-11-01 drawgen: layout and read-back fixes from real parts (BASE's 111101; FRONT's 352201, 352211) (#297)
    * drawgen: a mitre's angle value is placed after the mitre's length dimensions (BASE's D-129 111101 case)
    On BASE's D-129 111101 the 24.14° value sat on the 1502.07 dimension's extension line: the value was placed
    before the length dimensions along the mitred member's faces, whose extension lines then crossed it. The values
    now wait until every mitre dimension is drawn, then take the first clear place out along their arc. On main's
    111101 the value keeps its place (only the order of the text in the file changes; not regenerated here).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
2026-11-01 Mechanical checks: a hole must go all the way round in its own place on its axis; a slot's half-round end isn't a hole even when another sits on the same line (BASE's D-129 back band: its two end pla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
    The STEP reader grouped coaxial concave cylinders before splitting them into runs along the axis, and summed the
    group's arc. It now splits first and asks each run for 359 degrees. Same findings on main 3ddc362 (192); on BASE's
    branch 8ff8f08 the 4 C08 hole-offset and 2 C09 edge-distance findings on the slot ends go, nothing else changes;
    on that branch's 111103 STEP main's reader found 20 holes (2 false Ø6.5), the fixed one 18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
2026-11-01 INTERIOR: D-126/D-127 LED profile, root part number 810000, rebuilt with edit test PASS (#285)
    * INTERIOR (D-125): the diffuser strip 811205's parts-list line is its spec, no drawing: grade HOLD as stated, width +/-0.3 and thickness 1.5 +/-0.15 added to the length +/-1 (assumptions until the diffuser is picked)
    * INTERIOR (D-126): the down-light is a bought LED profile set in ELECTRICAL's family (718101 profile, 718102 opal cover, 718103 end caps, 718104 clips; listed by ELECTRICAL): the profile modelled under 718101, 23 x 12.5, 20 inside for the two 8 mm strips, under the right run for the run's own 991 (Reviewer 6: nothing shows pas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
    [100000_P01_POD-MADE-PARTS-BY-PROCESS_BOM.csv, 100000_P01_POD-MASTER_BOM.csv, 810000_P01_INTERIOR-PARTS-LIST_BOM.csv, 810000_P01_INTERIOR_CAD.f3d, 810000_P01_INTERIOR_STEP.step, 811204_P01_INTERIOR-LIGHT-SHELF-DOWN-CHANNEL-RH_DXF.dxf, parts-decided-P04.csv]
2026-11-01 drawgen: Reviewer 5's notes on #296 (an angled face's own origin; THRU on solid parts) and a tapped-hole guard (#304)
    - An angled-face view (VIEW D) gets its own origin: on the face that holds its holes, the face's centre line
    across the view at its bottom edge, so X reads from the face's middle and Y from its bottom (as Joints' key
    sheet measures: "on its centre line, 26 and 60 above the bottom"). The title says so; the tables, the origin
    mark and the PDF's data use it; the read-back checks each view against its own origin.
    - The general note says "THRU 1 WALL of the member" only when a hole is one wall of a hollow member; a solid
    part's note says "THRU the part".
    - Tapped holes wai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
2026-11-01 Mechanical checks: notes carry no maker line either (the Lead's ruling); register on main d86ddcb: F-336, F-337 closed, F-325, F-326 reopened (#302)
    * Mechanical checks: a 'Made by ...' sentence in a drawing's notes isn't its Created by field even when it starts a line (BASE's notes); a label is upper case, ends in a colon, or stands alone on its row
    * Findings register: run on main 084217c (#290's re-stamp): F-324, F-327, F-336 and F-337 closed, those drawings read Autonomous as Created by and author; ELECTRICAL's 8 sheets still print 'ELECTRICAL Engineer' in their BY field
    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
2026-11-01 Decision log: D-145 to D-149 and D-144's layout (#300); 111215 allocated (#311)
    * Decision log: D-145 to D-149 (DR's panel edge exception; mitre plates as blanks; drawing notes, GA thin layers and superseded drawings; the assembly-time rulings; DR's inner panel ships loose) and D-144's layout from Joints' #300; 111215 allocated; the pack's decision counts to D-149
    * D-149 keeps FRONT's basis: DR about 18.7 kg with the panel loose in D-131's steel, under D-108's 19.0 kg cap (13.0 was the aluminium-frame CAD); the wall sample's P28 takes D-146's blanks (Reviewer 6's P2)
    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
    [100000_P01_POD-MASTER_BOM.csv, document-register.csv, number-allocation.csv]
2026-11-01 D-144: corner key 111211's fixing holes for the back corners; FR1's key becomes 111215; positions file and register (#300)
    * D-144: corner key 111211's fixing holes for the back corners (6.0 either side, at 10.5 and 17.8); FR1's key becomes 111215 with today's holes; positions file, register and roll-up count
    - corner_keys.py: a hole layout per part number, with the PM's rules checked in code (each 7.0 carrier hole
    at least 14 from the carrier's cut end, the screws at least 14 apart, every tapped hole 2 x 5.03 from the
    key's faces); refused the stepped layout at FR1 (12.2) and today's at the back corners (13.0) in a test.
    - corner-keys.csv regenerated: back corners (-1231, 836) and (-12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
    [V2-MFG-JNT-01_P01_JOINTS-MADE-HARDWARE_SPEC.csv, corner-keys.csv, parts-decided-P04.csv]
2026-11-01 CEILING: the cassette clip's HOLD (HOLD-08, 518001) also asks for a clip that latches when pushed home, so each ceiling cassette holds itself overhead before its two safety catches go on (Packing's a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
    [410000_P01_CEILING-PARTS-LIST_BOM.csv]
2026-11-01 ELECTRICAL sheets at 2.5 mm letters: wiring diagram on A1, assembly sheets on A2, shared sheet checks; stale down-light length fixed (#235)
    * ELECTRICAL sheets at 2.5 mm letters (PM's drawing check item 1; guideline: never shrink a font to fit): wiring diagram on A1 (the schematic and route views drawn twice the size, the harness list as a wrapping table), the 7 assembly sheets on A2; sheet_kit.py (capital heights, wrapping, tables that never cut a value, overlap and line-through-text checks, labels placed clear of lines); the light shelf box's stale 2 x 1.03 m now from the parts data (2 x 0.975 m); offline read-back tests of all 10 sheets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
    [100000_P01_POD-BOUGHT-PARTS_BOM.csv, 100000_P01_POD-MADE-PARTS-BY-PROCESS_BOM.csv, 100000_P01_POD-MASTER_BOM.csv, 710000_P01_ELECTRICAL-HARNESS-LIST_SPEC.csv, 710000_P01_ELECTRICAL-PARTS-LIST_BOM.csv, 711002_P01_ELECTRICAL-POWER-UNIT-FRONT-PLATE_CAD.f3d, 711002_P01_ELECTRICAL-POWER-UNIT-FRONT-PLATE_DXF.dxf, 711002_P01_ELECTRICAL-POWER-UNIT-FRONT-PLATE_STEP.step]
2026-11-01 drawgen: BASE's D-129 back band: open-ended slots sized from the edge, end notches in a detail, 1 x 45° chamfers; a guard for flat features it can't size (#314)
    The Lead's item 3 (BASE's 111103 from its D-129 STEP), and the plan the Lead approved for the part's other features.
    - Open-ended slot (FB-14): recognised from its half-round end; sized from the edge it opens on in its face's view:
    the mouth at the edge, the taper's length, the width, R and the end's centre from the edge. A long part's ends
    get their own lettered views at their own scale (1:1 on 111103), measured from the member's bottom left corner,
    so the table reads the slot at X 20, Y 63.5, as the view sizes it. Its table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
2026-11-01 Mechanical checks: D-143 (3), a bought profile we mitre and drill needs one table drawing; register on main 2774e80: F-339 (FRONT's 368004, held) (#312)
    * Mechanical checks: D-143 (3), a bought profile we cut into mitred lengths with holes is a made part with one table drawing (FRONT's 368004, held until the generator reads profiles: major)
    * Findings register: run on main 2774e80 with D-143 (3): F-339, FRONT's 368004 glazing U-profile, cut into 4 mitred pieces with holes, needs one table drawing (held until the generator reads profiles)
    * Findings register: F-339 posted to FRO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
2026-11-01 Mitre plates 831007-831009: blanks shortened so each square end sits 0.5 inside the frame's faces (26.5, 41.5, 54.8) (#308)
    * Mitre plates 831007-831009: blanks shortened so each square end sits 0.5 inside the frame's faces (the Lead's steer after WALL's L1 clash): 26.5, 41.5, 54.8 long from X 1.75, 3.15, 1.75; frame check checks every corner; register, README (831008's angle fixed), spec rows
    * Mitre plates: version 2 of the plate design (the trimmed blanks) with its STEPs and DXFs, each checked: STEP boxes X 1.75..28.25, 3.15..44.65, 1.75..56.55 (MATCH), DXFs 26.5, 41.5, 54.8 x 40; frame_steel_check.py now checks every plate's STEP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
    [831007_P01_HARDWARE-MITRE-PLATE-20X40-45DEG_DXF.dxf, 831007_P01_HARDWARE-MITRE-PLATE-20X40-45DEG_STEP.step, 831007_P01_HARDWARE-MITRE-PLATE-TABULATED_CAD.f3d, 831008_P01_HARDWARE-MITRE-PLATE-20X40-TO-40X40_DXF.dxf, 831008_P01_HARDWARE-MITRE-PLATE-20X40-TO-40X40_STEP.step, 831009_P01_HARDWARE-MITRE-PLATE-40X40-45DEG_DXF.dxf, 831009_P01_HARDWARE-MITRE-PLATE-40X40-45DEG_STEP.step, V2-MFG-JNT-01_P01_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]
2026-11-01 Decision log: D-150 to D-152 (floor seal at the fixed glass's door end, kick strip on the band's bottom line, hands-free overhead lifts); 368008 for the kick strip's end brush seal (#317)
    * Decision log: D-150 (the floor seal closed at the fixed glass's door end; 368008 for the kick strip's end brush seal), D-151 (the kick strip's bottom on the band's bottom line), D-152 (hands-free overhead lifts); D-149 calls 19.0 kg D-108's target; counts to D-152
    * D-152: the seam prop is its own 45 x 45 packing timber, about 2354 mm (CEILING to confirm), labelled and marked in pallet 2's tier 3; the tier-separator battens are only 1.22 m (Packing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
    [document-register.csv]
2026-11-01 Mechanical checks: --ref-rows, a pre-check keeps the rule rows a team's PR adds (an edge exception, a clash allowance its ruling asks for); register runs on main keep the current rules as before (#31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
    FRONT's #313 adds D-145's edge exception to v2/04-Checks/config/edge-exceptions.csv. A pre-check replaced the PR's
    rule files with the current ones, so DR's 10 panel screw holes showed as 10 severe findings that won't exist after
    the merge; with --ref-rows they pass (10 before, 0 after, on 3acf5e4). Main ec36450: the same 179 offline findings.
2026-11-01 Mechanical checks: D-151, the kick strip over the room floor (Z 10); register on main 6f2bff3: F-342 (FRONT's kick strip at 20 mm) (#321)
    * Mechanical checks: D-151, the kick strip over the room floor: KICK-OVER-FLOOR (bottom at glide_h, Z 10, within 0.5) replaces KICK-OVER-THRESHOLD (D-132: no threshold); the room floor is the plane Z 0 for gap rules that name it; the door's KICK STRIP only, not AIR's kick grille; the assembly only
    * Findings register: run on main 6f2bff3 with D-151's rule: F-342, the door's kick strip sits 20.0 mm over the room floor, D-151 wants the band's bottom line (Z 10)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
    [gap-rules.csv]
2026-11-01 Register: 368008, the kick strip's end seal (D-150, H-43, HOLD-23); the plain M6 ISO 7089 washer under DR's inner panel screws (D-142, H-44, 21, number from Control); J-FRONT-03 for D-152: DT's DL en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
    [100000_P01_POD-MASTER_BOM.csv]
2026-11-01 drawgen: refuse a profile section it can't size; extrusions judged as profiles; a short tube stub is not a fold (#323)
    The sweep's correctness gap and two misreads (the Lead's fix 1):
    - A straight member's section must be a solid convex outline (a bar, or a block with an angled side face as the
    corner keys) or a rectangular tube, at some station clear of its holes. Anything else (an angle, a channel, a
    custom extrusion, a tube with a bevel along a corner) is refused as a profile: drawgen sized only its outside,
    so FRONT's kick strip 361002 "passed" with its 1175 x 85 envelope and no section sizes (D-139 keeps a profile's
    dimensioned section with Fusion until the profile reading lands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
2026-11-01 838011 for the plain M6 ISO 7089 washer, zinc 200 HV (D-142, the register's H-44); D-152 changed the same day: DT bears on DL's slope skin to skin, no bearing strip (848014 not used); 352321 (DR's C1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
    [100000_P01_POD-MASTER_BOM.csv, number-allocation.csv]
2026-11-01 Mechanical checks: the Lead's three fixes for WALL's L1 sample: a fill piece is fill wherever the size sits in the name; Fusion's wrapped STEP strings are joined; the team's own row gives the materia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
2026-11-01 Register: J-FRONT-03 back to DT bearing on DL's slope skin to skin (the Lead's ruling after FRONT measured no gap: no strip, no new seam), slip sheet in the assembly step, HOLD-24 closed by FRONT's c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
    [100000_P01_POD-MASTER_BOM.csv]
2026-11-01 Allocation list: 352321's note in one pair of quotes (it spilled into a 12th column at 'axis, from its two pairs'); every row now has the header's 11 columns (#328)
    [number-allocation.csv]
2026-11-01 drawgen: rivet hole sizes pass the tapped-hole guard; the maker check is the mechanical check's own; the doubler test reads BASE's list (#315)
    * drawgen: an entry can list rivet hole sizes, so the tapped-hole guard passes them and the table names the rivet
    The Lead's ask (BASE's D-130 boot takes blind rivets; Reviewer 5: 3.3, 4.2 and about 5.0 are rivet hole sizes as
    well as tap drills'). A team entry's `rivet_holes` maps a hole size to its rivet, e.g. {4.2: "blind rivet, Ø4
    (D-130)"}: holes of that size (within 0.01) no longer count as tap drills, and their table rows say "rivet hole:"
    and the rivet. A parts-list row that says tapped or threaded is still refused. Test: a bar with two Ø4.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
2026-11-01 Allocation list: 211518 is F04 214 x 1102.7 and 211538 F08 214 x 1082.7 (the side frames 3 mm shorter, back face at Y 844, PM ruling in WALL's group); numbers kept; master BOM rebuilt (#333)
    [100000_P01_POD-MASTER_BOM.csv, number-allocation.csv]
2026-11-01 drawgen: every end cut shown in profile with its angle at its end; the read-back fails any end cut it doesn't print (#329)
    Reviewer 7's P1 on FRONT's #320 (the Lead's ruling): 8 of 49 tube sheets printed no end-cut angle (352202, 352207,
    352209, 352210, 352105, 352106, 352302, 352310): each had one view, which saw its mitres face on, as bands.
    - The view plan now shows every end cut in profile (edge on, the member's axis across the view): where no planned
    view does, it adds the one that does. A cut no plain view shows in profile (a compound cut) is refused.
    - The read-back finds every end cut in the STEP with the repo's own reader (a flat face 1.1° to 88.9° from square to
    the member's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
2026-11-01 Mechanical checks: openings take a web rule, not 2 diameters (fan bulkheads); every bonded skin sits bond_t off its frame (D-137); register on main cf96ecc: F-343 to F-345 (#334)
    * Mechanical checks: C09 openings (the Lead's ruling on CEILING's fan bulkheads): a round cut over Ø20, or one its part row names as an opening, takes a web rule, at least 2 x the sheet and 3 mm of material to any edge and to the next hole, instead of the 2-diameter rule, which stays for fastener holes
    * Mechanical checks: C02 bond-line (the Lead's ask, D-137): every bonded skin sits the skeleton's bond_t (3 mm) off its frame, read from the CAD: a panel's fa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
2026-11-01 drawgen: text widths from the built-in Helvetica's own metrics (Ø and µ were under-measured) (#330)
    The Air Engineer's read-back found it: fitz.get_text_length(fontname='helv') under-measures Ø and µ ('Ø9.53' 7.55
    mm against 9.48 printed at 2.5 mm letters; 'µm' 1.94 against 4.84), so every Ø label's free-space box was about 2 mm
    short and a wrapped cell could run into its column line. text_width now measures Windows-1252 text with
    fitz.Font('helv' / 'hebo').text_length, which matches the PDF's own span boxes (° and × were right either way).
    Test: test_text_width_matches_the_printed_text (Ø9.53, µm, 45°, 1 x 45°, a hole callout; regular and bold; each
    within 0.05 mm of the print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
2026-11-01 drawgen: assembly sheets from the team STEP (assembly.py) with a read-back; samples 110101, 410101, 610101 (#332)
    * drawgen: assembly sheets from the team STEP (assembly.py), with a read-back; samples 110101, 410101, 610101
    A new module draws an assembly's sheet outside Fusion from its team's assembly STEP and parts list: first-angle
    views of its own parts (exact hidden-line projection), sections where parts hide (hatched per part, reference
    parts in phantom), a balloon per part number with its leader on that part (an arrowhead on a free edge, else a dot
    on its face), the parts table word for word from the list's rows under the assembly (* for rows the STEP doesn't
    model), the overall sizes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
2026-11-01 Mechanical checks: KICK-OVER-FLOOR measures to the room floor, the plane Z 0, and nothing named for it (BASE's lip seals 'BASE SEAL - LIP - ROOM FLOOR' had taken its place: a false severe on #303, th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
    [gap-rules.csv]
2026-11-01 Findings register: run on main 5a996ab (#332's assembly sheets): F-040, F-139 and F-255 closed (110101, 410101 and 610101 drawn by the generator, passing every drawing rule); the fastener schedule's 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
    [fastener-schedule.csv]
2026-11-01 Register: 368008 fitted on site as a self-adhesive brush strip, in the door's kit bag (the Lead's ruling), HOLD-23 asks for the adhesive and lowest fitting temperature on its own data sheet; the kick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
    [100000_P01_POD-BOUGHT-PARTS_BOM.csv, 100000_P01_POD-MASTER_BOM.csv]
2026-11-01 ELECTRICAL: 711001 enclosure body drawing (Fusion, A2), redrawn for Reviewer 7's Hold (#173)
    * ELECTRICAL: drawing scripts for the enclosure body 711001 (views from the room-side Front, dimensions on edge lines past the corner reliefs, datums with leader points, text block and hole list in the PDF, offline test); Fusion scripts load their helpers by full path and print them (PM heads-up); failure cleanups use a snapshot of the open documents
    * ELECTRICAL drawings folder: ignore Python caches (removed the two committed by mistake)
    * 711001 drawing: the PM's four drawing traps (C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
2026-11-01 drawgen: CEILING's frame bevels called out; a tube's 45° bevel along a corner is a chamfer, not a profile (#331)
    * drawgen: CEILING's frame bevels called out; a tube's 45° bevel along a corner is a chamfer, not a profile
    The Lead's fix 2 after the sweep. CEILING's frames C1 and C2 (411101, 411102) carry two bevels: the back member's
    1 x 45° end bevel, which no view looks along, and a 1 x 45° bevel along the seam member's whole length (#323
    refused that one as a profile, rightly, as no view sized it).
    - A narrow face at 45° along a tube's outer corner, legs equal and 5 or less, is a chamfer along the member: the
    profile check accepts the tube's outline with that corner cut, and the be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
2026-11-01 drawgen assembly test: the entry's parts drawn whole in sections must include the spigots and glide stems, not equal them, so BASE's #303 can add its corner key's hook studs and screws (ISO 128-50) (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
2026-11-01 BASE P02: right band and FR1, D-129 back corners, D-132 no floor (lip seal, skeleton updates 4 and 5), 5 mm load blocks (#303)
    * BASE P02 work in progress: batch 1 parts (right band, FR1 with its sill, F2, threshold, locator spigot) and D-129's back corners in the build (not yet run in Fusion)
    D-129 (joints register J-BASE-02, FR-15, corner-keys.csv): the side bands carry the back corner keys
    111211 in their back ends (2 x Ø7.0 stud bolt holes in the inner wall, 2 x Ø7.0 fixing holes in the
    bottom wall), run to the back face and close with a flat 2 mm end cap 118003 (now modelled); the back
    band has welded 1.5 end plates with slots open at the bottom edge, head notches in its bottom wall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
    [100000_P01_POD-BOUGHT-PARTS_BOM.csv, 100000_P01_POD-MADE-PARTS-BY-PROCESS_BOM.csv, 100000_P01_POD-MASTER_BOM.csv, 100000_P04_POD-SKELETON-PARAMETERS.csv, 100000_P04_POD-SKELETON_CAD.f3d, 100000_P04_POD-SKELETON_STEP.step, 110000_P01_BASE-TUBE-CUT-LIST_SPEC.csv, 110000_P01_BASE_BOM.csv]
2026-11-01 D-132 and BASE P02 batch 1 in the roll-up, packing plan and assembly guide (stacked on #303) (#305)
    band has welded 1.5 end plates with slots open at the bottom edge, head notches in its bottom wall and
    bevels; step 9 checks t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
    [910000_P01_PACKING-LIST_BOM.csv, parts-decided-P04.csv]
2026-11-01 Findings register: run on main d50a0a0 (#303, #305): 14 closed; F-043 reopened, F-347 to F-353 new (BASE) (#349)
    * Findings register: run on main d50a0a0 (#303, #305): 14 closed (the floor panels gone, the lip in, the maker lines, the left-base shell, 118001's name, 111211's number); F-043 reopened and F-347 to F-353 new for BASE (drawings of 111101, 111102, 111301, 110102, 110106; the back key holes 13.0 from the end)
    Open 207: 88 severe, 117 major, 2 minor.
    * Findings register: F-043 and F-347 to F-353 posted to BASE's group
    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
    [fastener-schedule.csv]
2026-11-01 drawgen assembly read-back: a sub-assembly's number owns every solid under it in the STEP (CEILING's D-120 welded frame 411101, whose bodies sit in its member parts), as drawing takes it as one item;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
2026-11-01 Numbers (sill members, B3/B4 linings; 831010 and 368009 for the register), decision log D-153 to D-161, FAI K-J18 and K-P08, checklist: D-120 members and all-digit maker numbers (#345)
    * Numbers 111302, 111303 (the welded sill's members) and WALL's B3/B4 linings 510203/510204, 511203/511204, 511403/511404; decision log D-153 to D-161 (831010 and 368009 in their rows, register hardware, D-63); FAI K-J18 for every D-120 frame member and K-P08 for the ACP test fold
    * Release checklist: D-120 members take CAD and STEP from their frame (its own list, or a cut list's member_part); an all-digit maker number counts when the row names its make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
    [100000_P01_POD-MASTER_BOM.csv, 910000_P01_PACKING-LIST_BOM.csv, document-register.csv, number-allocation.csv]
2026-11-01 wip: 711001 holes before the main merge (#353)
    [100000_P01_POD-BOUGHT-PARTS_BOM.csv, 100000_P01_POD-MADE-PARTS-BY-PROCESS_BOM.csv, 100000_P01_POD-MASTER_BOM.csv, 710000_P01_ELECTRICAL-PARTS-LIST_BOM.csv, 710000_P01_ELECTRICAL-TRAY-TIE-HOLES_CALC.csv, 711001_P01_ELECTRICAL-POWER-UNIT-ENCLOSURE-BODY_CAD.f3d, 711001_P01_ELECTRICAL-POWER-UNIT-ENCLOSURE-BODY_DXF.dxf, 711001_P01_ELECTRICAL-POWER-UNIT-ENCLOSURE-BODY_STEP.step]
2026-11-01 Mechanical checks: the floor seal line traced as closed rings (C01 seal-gap, the Lead's ask); register on main 2767495: F-354 to F-365 (#352)
    The assembly is cut level from the room floor to the band's top (glide_h + band_h, Z 110) at every
    height where a part's outline can change, each part's outline exact from its STEP faces. A cut is
    sealed when parts that touch, or come within 1 mm, ring the pod's inside; otherwise the gaps are
    added shortest first, and every gap on the first ring they close (the narrowest ring) wider than
    1 mm is an opening, reported with its width, place, parts, height range and open area (width x
    height, summed over the cuts), with the total in results/latest.md for t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
    [seal-travel.csv]
2026-11-01 D-162 to D-165 (weldment members' drawings, CAL2 rivnuts, BASE's made glide 111602 and end cap 111111); checklist: a member's cut list row as its drawing, alternatives aren't a named product (#354)
    * D-162 (a weldment member's drawing is its frame's cut list row), D-163 (rivnuts to Sherex CAL2 in round holes), D-164 and D-165 (BASE's made glide 111602 and end cap 111111 replace 118002 and 118003); checklist: a member's full cut list row is its drawing, and maker or SKU cells naming alternatives don't count (Reviewer 6's 848011 note), 6 tests
    * Master BOM, BOM check and release checklist rebuilt on main e158d88 (111111 and 111602 liste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
    [100000_P01_POD-MASTER_BOM.csv, document-register.csv, number-allocation.csv]
2026-11-01 Mechanical checks: an M6 rivnut hole is D-163's Ø10.00 +0.10 as well as CAH2's Ø9.53 (Reviewer 10): the clearance-hole-facing-a-rivnut rule, the bolt-pattern check and the frame check's site joints (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
    Ø9.53 stays until the last old part is rebuilt. Tests at Ø9.53, Ø10.00 and Ø10.10 in each; on main's old code the
    two new sizes fail all three, as Reviewer 10 found. Main's findings don't change.
2026-11-01 drawgen: a section's letter takes the first clear place by its arrow (WALL's L1 frame: section E's letter sat on a stud) (#360)
    The letter by each cutting-plane arrow went at one fixed place, with no look at what was there. On WALL's L1 frame
    in welded steel (#343, its studs) the upper letter of section E landed on a stud's outline, so its frame test
    failed the read-back and #343 couldn't merge. The usual place stays first (every sheet whose letter was clear is
    unchanged, byte for byte: BASE's 111101/111103, FRONT's 45 tube sheets); where it touches a line or a text, the
    letter tries places farther along the cutting line, along the arrow, just behind it, then on the inner side.
    WALL's frame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
2026-11-01 Locating spigot 831010 (11 proud) for DT's spigots on DR's ledge: STEP, tabulated sheet, register and J-FRONT-03 (D-157); hinge brush 368009 (#346)
    * Locating spigot 831010, 11 proud, for DT's two spigots on DR's ledge (the Lead's ruling, D-157): the spigot model's pin_proud 11 exported as its own STEP, a tabulated spigot sheet (finish step only), the register row next to H-05, J-FRONT-03 (DT's tube now 6 above the ledge; the pins clear everything inside it), 831001 to 28 a pod, the roll-up counting both; also the hinge-end brush's number 368009 (D-154) and the joints CAD README's rebuild note follows D-141 (rename, never delete)
    * Sp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
    [100000_P01_POD-BOUGHT-PARTS_BOM.csv, 100000_P01_POD-MASTER_BOM.csv, 831010_P01_HARDWARE-LOCATING-SPIGOT-11-PROUD_STEP.step, V2-MFG-JNT-01_P01_JOINTS-MADE-HARDWARE_SPEC.csv, parts-decided-P04.csv]
2026-11-01 Document register: a folder row for v2/02-Drawings/00-General-Assembly (the GA sheets, sections A-A and B-B, notes, drawing index and scripts), ahead of PR #366, so the control pack's register check 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
    [document-register.csv]
2026-11-01 fusion_drawing.base_view: accept a view scale within 1e-5 of the scale asked, and print the read-back in full (#351)
    * fusion_drawing.base_view: a scale counts as set within 1e-6 of it (Fusion keeps view scales in single precision)
    Live 2026-11-01, GA sheet 1: the isometric view at 0.0375 was refused with "the view's scale
    stays 0.0375 after setting 0.0375": Fusion reads the scale back in single precision, 1.5e-9 off,
    and the check allowed 1e-9. 1:20 (0.05) passed only because its single-precision value is 7.5e-10
    off; 1:10 (0.1) and 1:5 (0.2) would have been refused the same way (1.5e-9 and 3e-9 off).
    scale_is() allows 1e-6 of the scale asked, so a real difference is still an error. Tests: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
2026-11-01 Mechanical checks: C05 takes a welded frame member's cut-list row as its drawing (the Lead's ruling, D-162), in step with the release checklist (#357)
    * Mechanical checks: C05 takes a welded frame member's row in its frame's cut list, on the frame's drawing (the Lead's ruling for D-131 frames, D-120 members)
    A member needs a sheet of its own only for work done before welding or an end cut a cut list can't state:
    its cut-list row naming work before welding, or a cope, notch, saddle, fish-mouth or profile cut, or its
    STEP showing an end cut by two or more planes. Members are read from the frames' cut lists (a member-part
    column beside the frame's number); the frame's drawing must carry the me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
2026-11-01 Checklist: a member's cut list row read as C05 reads it ('deg' and 'degrees', one angle for both ends, square ends), tests on CEILING's and WALL's rows (#362)
    * Checklist: a member's cut list row states its end angles in 'deg' or 'degrees' as well as '°', one angle for both ends ('both ends mitred 45 deg', 'bottom and top ends both mitred 45.00°') or square ends, read word for word as C05 reads it (the Checker's #357; Reviewer 6 and the Lead's rulings); tests on CEILING's #348 rows (412101 to 412105, 412202 to 412204) and WALL's #343 rows (212101 to 212105), and one holding the checklist to C05's answer on every row once #357 is on main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
2026-11-01 Checklist: tube words tried before sheet words, so D-131's galvanized steel tubes (and FRONT's 'GLASS EDGE' tubes) take their cut list row instead of wanting a DXF; 12 lines on the open PRs, all tube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
2026-11-01 Corner keys after D-144: key design version 3, five STEPs (111212 and 111214 at their exact mitres), the tabulated sheet redrawn (#324)
    * D-144 key model and sheet: version 3 of the key design (111211's stepped holes, 111215 added), five STEPs (111212 and 111214 at their exact mitres, -24.1446 and -7.2546, for BASE); the tabulated sheet redrawn in Fusion (old ones renamed, D-141) with my visual pass's fixes; corner_keys.py writes the cut to 4 decimals and checks the build script's angles against the mitres; drawing test checks dimensions sit inside the frame
    * Key sheet, Reviewer 6's pass on #324: H03 and H04 tags match the table (a t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
    [111211_P01_BASE-CORNER-KEY-SQUARE-COMMON_STEP.step, 111211_P01_BASE-CORNER-KEY-TABULATED_CAD.f3d, 111212_P01_BASE-CORNER-KEY-FRONT-LH_STEP.step, 111213_P01_BASE-CORNER-KEY-FRONT-RH_STEP.step, 111214_P01_BASE-CORNER-KEY-KNEE-LH_STEP.step, 111215_P01_BASE-CORNER-KEY-SQUARE-INLINE_STEP.step, V2-MFG-JNT-01_P01_JOINTS-MADE-HARDWARE_SPEC.csv, corner-keys.csv]
2026-11-01 drawgen assembly: the seven lining cassette sheets (510301, WALL's 510101 to 510104, 510201, 510202) with datums, fixing order and build-ups (#350)
    * drawgen assembly (WIP, rollout): each assembly's own STEP first; level and one-assembly list layouts; deep solids for sub-assembly balloons; bodies as pieces
    * drawgen assembly (WIP, rollout): a part the list puts in an assembly but the STEP nests deeper is lifted out as its own item (AIR's cartridges on 610000)
    * drawgen assembly (WIP, rollout): cassette features: named datums with a read-back, rib centre lines, held envelopes as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
2026-11-01 drawgen: bent sheet's cut-outs and slots, sized and checked against the model both ways (WALL's 511202), stacked on #335 (#355)
    * drawgen: bent and folded sheet drawn from its STEP and its DXF, matched bend for bend (flat pattern, bend table, K-factor)
    The Lead's ruling (2026-11-01): bent parts come from the generator, Fusion the fallback. A team's entry marks a
    part `bent` (with the inside radius when its model folds sharp).
    - sheetmetal.py: the folds are read from the model's own section across the bends (two skins joined by an end cap at
    each free end): each flange's outside length, each fold's angle, its inside radius where the model has one, and
    which skin is its inside. The flat f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
2026-11-01 D-166 to D-171 (closed-end rivets, 4.78 gasket, 24 V kit and lights, DL's pins, the wall cassette ledge, the GA's outline sections); 23 numbers; FAI lines; D-168 in the requirements (#384)
    * WIP: D-166 to D-171, new numbers, FAI lines, D-168 in the requirements (generated files and checks next)
    * D-169 as amended: pins along the pull for DL only; DR and DT keep their base locators and seal with a pre-compressed expanding foam tape; 831010 stays
    * Numbers: AIR's latch bracket 611215, soffit fill pieces 611216 and 611217, fan box mount angle 611409 and strap pad 618107 (the Lead'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
    [100000_P01_POD-MASTER_BOM.csv, document-register.csv, number-allocation.csv]
2026-11-01 drawgen assembly: balloons must be in sight (read-back), and the GA's hooks (kind, sources, extra step, a prebuilt assembly); stacked on #350 (#394)
    * drawgen assembly (WIP, rollout): cassette features: named datums with a read-back, rib centre lines, held envelopes a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
2026-11-01 AIR's fan box assembly sheets 610401 (supply) and 610402 (exhaust) from the generator's assembly mode (D-158), stacked on #350 (#392)
    * drawgen assembly (WIP, rollout): cassette features: named datums with a read-back, rib centre lines, held envelopes as their part, i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
2026-11-01 INTERIOR: real folds (R = t) on the ledge and light shelf, the shelf DXFs' cable holes where the models put them, and the four bent sheets from the generator (#356)
    * INTERIOR folds (the Lead's ruling 2026-11-01 on #335): each fold of the ledge top 811101 and the light shelf 811201 to 811203 gets a fillet feature on its inside corner edge (radius sh_r / lg_r = the sheet) and its outside one (that plus the sheet), found by place on the extruded section, so the model, its STEP and its DXF (K 0.44) agree; the ledge brackets' envelopes get a 45 deg relief of 2 x lg_t on their top back edge, clear of the ledge's inside fold; the build and the edit test check every fold face's radius, and the edit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
    [100000_P01_POD-MADE-PARTS-BY-PROCESS_BOM.csv, 100000_P01_POD-MASTER_BOM.csv, 810000_P01_INTERIOR-PARTS-LIST_BOM.csv, 810000_P01_INTERIOR_CAD.f3d, 810000_P01_INTERIOR_STEP.step, 811201_P01_INTERIOR-LIGHT-SHELF-BACK_DXF.dxf, 811203_P01_INTERIOR-LIGHT-SHELF-SIDE-RH_DXF.dxf, 910000_P01_PACKING-LIST_BOM.csv]
2026-11-01 drawgen assembly: a count in sets is counted as pieces are (the Lead's ruling, 2026-11-01): WALL's #343 lists its cassette clips as 518003, '4 set', so the one placement holding the four clip zones s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
2026-11-01 GA sheet 1 from the drawing generator: the whole pod from the teams' STEPs, sections A-A and B-B hatched (D-158) (#377)
    * drawgen assembly (WIP, rollout): cassette features: named datums with a read-back, rib centre lines, held envelopes as their part, interfaces oppo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
2026-11-01 start_drawing nudges an idle open too; the nudger waits for a check in flight (70 s); tests pin its stop before the timeout checks (Reviewer 5's P3s on #402) (#410)
    - start_drawing.py gets the same OpenNudger, with --nudge-after and --nudge-every: today's
    15-minute stall was a drawing open (the Lead: the start_drawing wiring first). It starts
    after the lock is taken and the unhealthy check passes, and stops before the timeout path's
    busy wait and open guard, and before the lock goes back.
    - OpenNudger.stop() waits for a check in flight through both its calls (initialize and the
    script, up to NUDGE_CALL_S each) and its look at the log: 70 s, not 35. If one still runs
    after that, it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
2026-11-01 drawgen weldment hooks (D-120, D-162): a frame drawn from its members, its cut list from the team CSV (#365)
    * drawgen weldment hooks (D-120, D-162), agreed with the generator's owner: a frame with no body of its own takes its members' bodies, each named by its member (found, loaded and read back the same way; its quantity its own placements'); an entry's cut_list names its team's cut list CSV, one row per member number, counted against the bodies both ways, welded-in plates from their parts-list rows; bought parts under a frame refused; ends printed as written, 'square-cut ends' only for a square cut with no angle; tests incl. CEILING's 411101/411102 once #348 lands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
2026-11-01 ELECTRICAL: the voice kit on one 24 V Class 2 feed and the lights at 24 V (D-168): three supplies (#319)
    * ELECTRICAL: the voice kit's 60 W peak on two Class 2 supplies, each at 80 % or less (D-136, PM ruling 2026-11-01)
    - PS4 added (a fourth Mean Well LPV-60-12, Class 2): the kit outlet carries feed A (PS1, F1 5 A) and feed B (PS4, F4 5 A), never joined, up to 48 W each; the kit splits its 60 W peak over them.
    - W30 becomes 4 x 16 AWG (one pair per feed, 2.4 % drop at 4 A), with 16 AWG Mini-Fit Jr terminals: cable 718055, female 718056, male 718057 (new, HOLD).
    - Load table: w_total_max gives each row's part of the pod's maximum, so the column adds up to 132.4 W (the kit counted once at it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
    [100000_P01_POD-BOUGHT-PARTS_BOM.csv, 100000_P01_POD-MASTER_BOM.csv, 710000_P01_ELECTRICAL-HARNESS-LIST_SPEC.csv, 710000_P01_ELECTRICAL-LOAD-TABLE_CALC.csv, 710000_P01_ELECTRICAL-PARTS-LIST_BOM.csv, 910000_P01_PACKING-LIST_BOM.csv, parts-decided-P04.csv]
2026-11-01 D-170's ledge sizes, D-166's reason, a note under D-131, and B2's four new frame members (#406)
    * D-170: the ledge angle's sizes from WALL's model, 21.8 tall outside by 28 out (was 21 up), in the log, 211701's and 211801's rows and the master BOM (the WALL Engineer's note)
    * D-166's reason: 838012 is the smallest head under the Ø7 countersink land (Reviewer 12's wording point; the 1.7 was the earlier dome head's); a note under D-131: FRONT's decor cores go to steel in its rebuild right after #313, without waiting for L1's sample review (the Lead's ruling in FRONT's group)
    * Nu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
    [100000_P01_POD-MASTER_BOM.csv, number-allocation.csv]
2026-11-01 Joints register: D-167 gasket 4.78, D-166 closed-end rivets, the lining clips and catch, WALL's ledge pad and the stacked-joint strip (#373)
    * Joints register: D-167 (joint gasket 848001 at Rogers' standard 4.78: squeeze 44-60%, at least 37% between bolts, 0.60 kN a bolt; back-end slots 8.5 x 16, panels held 3.4 out, walls lean 3.4), D-166 (closed-end blind rivets wherever the tail is hidden: WALL's ledge ISO 15976 St/St 4 x 8, BASE's sill ISO 15973 Al/St 4.8 x 9.5, the clip males' rivets), the lining clips (ceiling 518001 PC-SF1 + PC-SVMX, walls MC-F10 + MC-SM5) and catch (518002 Gripple Loop No.3), WALL's ledge pad, and 848012 re-specified as the stacked-joint strip; sources; HOLD-08 narro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
    [100000_P01_POD-BOUGHT-PARTS_BOM.csv, 100000_P01_POD-MASTER_BOM.csv]
2026-11-02 AIR follow-up on FRONT's rebuilt DR (#313): supply fan box at X 680, riser to Z 1386 with its chamfer, the transitions' 24 rivet holes, rebuilt (#378)
    * CEILING P01: edit test can run part of its list (edits=...), so each run stays short
    * CEILING P01: part builds open existing designs only unless create=1 (PM ruling 2026-11-01, until the runner's folder fix)
    * Part builds open existing designs only unless create=1 (PM ruling 2026-11-01)
    * AIR P01: drawing specs (D-89 parts 1 to 4: 18 drawings, views laid out from each p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
    [100000_P01_POD-BOUGHT-PARTS_BOM.csv, 100000_P01_POD-MADE-PARTS-BY-PROCESS_BOM.csv, 100000_P01_POD-MASTER_BOM.csv, 350001_P01_FRONT-DECOR-BLOCK-ASSY-DL_BOM.csv, 350001_P01_FRONT-DECOR-BLOCK-ASSY-DL_CAD.f3d, 350001_P01_FRONT-DECOR-BLOCK-ASSY-DL_STEP.step, 350002_P01_FRONT-DECOR-BLOCK-ASSY-DT_BOM.csv, 350002_P01_FRONT-DECOR-BLOCK-ASSY-DT_CAD.f3d]
2026-11-02 AIR transitions: the riser and supply transitions as made parts (610403, 610404 and 611701 to 611804), in place of 618102 and 618103 (#395)
    * AIR transitions: the folded sheet kernel, a flat check from the STEP alone, and the lower transition's two halves (in place of 618103)
    - sheetmetal.py: walls given by their outer skin and folds between them build an exact folded solid (OCC: flat
    parts and cylindrical fold sectors, inside radius r, fused) and its developed flat (each fold's zone its bend
    allowance at K, the neutral fibre at K t from the inside), STEP (mm, empty author and organisation) and DXF
    (CUT outline and holes, BEND centre lines, MARK zone edges; $INSUNITS 4).
    - check_flat.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
    [610403_P01_AIR-RISER-TRANSITION_STEP.step, 610404_P01_AIR-SUPPLY-TRANSITION_STEP.step, 611701_P01_AIR-RISER-TRANSITION-LEFT-WRAPPER_DXF.dxf, 611701_P01_AIR-RISER-TRANSITION-LEFT-WRAPPER_FOLDS.csv, 611701_P01_AIR-RISER-TRANSITION-LEFT-WRAPPER_STEP.step, 611702_P01_AIR-RISER-TRANSITION-RIGHT-WRAPPER_DXF.dxf, 611702_P01_AIR-RISER-TRANSITION-RIGHT-WRAPPER_FOLDS.csv, 611702_P01_AIR-RISER-TRANSITION-RI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]
2026-11-02 Joints register: D-169 as amended (DL on pins along the pull; DR and DT keep their spigots and seal with a pre-compressed tape), 848013 for AIR, the brush HOLDs closed (#382)
    * Joints register: D-167 (joint gasket 848001 at Rogers' standard 4.78: squeeze 44-60%, at least 37% between bolts, 0.60 kN a bolt; back-end slots 8.5 x 16, panels held 3.4 out, walls lean 3.4), D-166 (closed-end blind rivets wherever the tail is hidden: WALL's ledge ISO 15976 St/St 4 x 8, BASE's sill ISO 15973 Al/St 4.8 x 9.5, the clip males' rivets), the lining clips (ceiling 518001 PC-SF1 + PC-SVMX, walls MC-F10 + MC-SM5) and catch (518002 Gripple Loop No.3), WALL's ledge pad, and 848012 re-specified as the stacked-j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
    [100000_P01_POD-MASTER_BOM.csv, parts-decided-P04.csv]
2026-11-02 GA sheet 1 checkpoint redraw after #313 and #378; printed source = the skeleton's STEP; the GA's drawing record (D-141 renames) (#440)
    * GA: the printed source is the skeleton's STEP and the date the newest export day in the team STEPs (Reviewer 15 via the Lead); the GA's drawing record with the D-141 renames
    - PodAssy.step (what assembly.make() prints as the sheet's source) was the newest team STEP by
    its header time, so it moved with every export (BASE's, then INTERIOR's after #356). It is the
    pod's own STEP now, the skeleton's, and the sheet's date is the newest export day written in
    the team STEPs' headers: no file times, no checkout paths, so any Mac draws the same sheet from
    t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
2026-11-02 drawgen weldment: FRONT's cut lists (end angles from their two columns, parts-list names) (#404)
    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
2026-11-02 CEILING frames in D-131 welded steel: members as parts (D-120), mitre plates, D-163 holes, DT bolts, rib folds, D-177 roof holes; build v13 + edit test (#348)
    * CEILING drawings: part designs use the shared folder check (tools/fusion/fusion_folder.py) instead of their own; finish_drawings.py strips the name field and renders a PNG for ceiling, AIR and INTERIOR drawings
    * CEILING part designs: set the root part number again after the save that makes a new design (Fusion can put back the design's own number)
    * CEILING: cassette fill at D-81's 24 kg/m3 (ISS-088): model, drawing no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
    [100000_P01_POD-BOUGHT-PARTS_BOM.csv, 100000_P01_POD-MADE-PARTS-BY-PROCESS_BOM.csv, 100000_P01_POD-MASTER_BOM.csv, 410000_P01_CEILING-PARTS-LIST_BOM.csv, 410000_P01_CEILING-TUBE-CUT-LIST_BOM.csv, 410000_P01_CEILING_CAD.f3d, 410000_P01_CEILING_STEP.step, 411302_P01_CEILING-SKIN-C2_DXF.dxf]
2026-11-02 Mechanical checks: an edge-exception row with a place covers that hole's short edges at a corner (the PM, 2026-11-02)
    edge-exceptions.csv gains a place column (the hole's centre in part coordinates). A row
    with a place covers that hole alone, and its short edges may meet at a corner (a notch or a
    bend relief); a row without one keeps the old rule (parallel edges only). Only edges the
    row counts are covered: a row allowing one edge still leaves a two-edge corner flagged.
    On ELECTRICAL's 711001 (its lan-mains branch), H04's relief corner reads as three edge
    lines (30.29, and 31.19 to the corner along two sides): max 3 with its place clears it;
    the same row without the place, or at another plac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
    [edge-exceptions.csv]
2026-11-02 Edge exceptions: a place must pick out exactly one hole of the part, and an unreadable place accepts nothing (Reviewer 21's P2 on #448)
    A row's place now excuses a hole only when no other hole of that part matches it ('X 10'
    with two corner holes on X 10 excuses neither). A non-empty place that doesn't read whole
    (no coordinates, an axis twice, leftover words) accepts nothing; a written + sign reads.
    Regression with two real corner holes sharing the given X. ELECTRICAL's H04 row (cap 3,
    'X 32 Z 14') still clears it on 711001's real STEP, and caps 1/2 or no place keep it.
    166 tests pass.
2026-11-02 Edge exceptions: a place must pick out one hole across all of the part's solids, not just one (Reviewer 21 on #448 at 6696214)
    The candidates are the holes of every distinct solid the part number has in the file
    (a solid placed twice counts once). Regression: two solids under one number with corner
    holes at (10, 11) and (10, 111); 'X 10' excuses neither, 'X 10 Y 11' only the first. It
    fails on 6696214's matcher. H04 still clears with its row. 167 tests pass.
