autonomous-ai/spaceship/(notices)

Notices in the files:
v2/00-Control/decision-log.md:
D-143 | 2026-11-01 | **The drawing generator's scope: (1) we keep our own generator; from draftwright (AGPL-3.0) we take ideas only, no code: repeated-hole counts and pitch chains as reference dimensions only (or grouped hole-table rows), so no position is controlled twice; counterbore and countersi
